roman885-85/moto_battery_reader/README.md

# 🔋 Motorola IMPRES Battery Reader / Programmer (ESP32)

Пристрій на **ESP32** для **зчитування, аналізу, редагування, відновлення та
програмування** чипів акумуляторів Motorola IMPRES — через веб-інтерфейс
Wi-Fi, USB-клієнт (браузер **або** нативний `.exe`) і OLED/LCD-дисплей з
кнопковим меню.

Інтерфейс українською, заставка з емблемою **Національної Гвардії України**.

Всередині акумулятора IMPRES два 1-Wire чипи:
- **DS2433** — EEPROM 512 байт: модель, крива розряду, історія ємності,
  лічильники, блок автентифікації.
- **DS2438** — монітор батареї: напруга, струм, температура, лічильники
  заряду/розряду (ICA/CCA/DCA), калібрування.

> ⚠️ **Family codes для ЦЬОГО заліза — `DS2433_ID = 0xA3`, `DS2438_ID = 0xA6`**
> (перевірено осцилографом, у `battery_reader.h`). Це **не** стандартні
> 0x23/0x26 з даташита. Заміна ламає зчитування — **не чіпати**.

---

## ✨ Можливості

- 📟 **Дисплей + меню-список** з кнопками: чотири сторінки показань (заряд,
  модель/серійний, дані DS2438, стан/цикли) і **список усіх функцій** із
  групами та стрибком по групах — замість плоского кільця дій.
- 🌐 **Веб-інтерфейс** (Wi-Fi AP) з captive-portal (сторінка відкривається сама).
- 🔌 **USB-клієнт** — той самий функціонал по COM-порту, працює **паралельно**
  з Wi-Fi. Три варіанти: браузер (Web Serial), **нативний `.exe` (Tkinter GUI,
  без браузера)** і веб-міст у будь-якому браузері.
- 🆕 **Новий акумулятор** — ініціалізація порожнього/стертого чипа «як новий»
  з вшитого genuine-еталона моделі + ручна ємність у мА·год.
- 🛠️ **Відновити еталон (verbatim)** — ремонт «з нуля» на порожній/битій
  мікросхемі: пише genuine-еталон **байт-у-байт** зі всією навченою калібровкою
  (нічого не обнуляє). Найнадійніший робочий результат, зокрема для **4409B**.
- 🧙 **Майстер відновлення** — автоматичне відновлення «однією кнопкою»:
  аналіз стану → перелік проблем → пропозиції → покрокове виконання. Кожна
  знайдена проблема або має крок, або **вголос каже, чому кроку не буде**.
  Уміє й **сам полагодити побитий лічильник розряду** в моніторі, узявши
  значення з історії того самого пакета. Спільний двигун (`recovery.h`) +
  чиста, перевірювана на хості база правил (`wizard_rules.h`) для **всіх**
  поверхонь (екран, веб-вкладка
  «🧙 Майстер», USB, GUI). Багатоетапні сценарії з IMPRES-ЗП не перериваються:
  стан зберігається в журналі ESP32 за серійником АКБ і продовжується після
  повернення з зарядки (Майстер порівнює знімок CCA/DCA/ICA/health «до/після»).
  Збережені відновлення можна **переглянути** (серійник, модель, прогрес,
  заплановані дії) і **видалити** — панель «🗂 Збережені відновлення».
- 🔋 **Керований ЗАРЯД** — силового заліза два, і обирає його `DEVICE_VARIANT`:
  **готова плата DC/DC на TL494** (enable + аналогова уставка, вимір із DS2438
  всередині пакета) або **власний понижувач** (ШІМ на свій ключ, свій шунт,
  свій подільник, контроль +14 В). Верхній рівень у них спільний: профіль
  струму за відсотком заряду, розумний CC/CV від ємності пакета, ціль у
  відсотках або мілівольтах. Аварійні відсічки за напругою, перегрівом, часом
  і зависанням циклу — в обох; пік струму, контроль живлення й свідок
  насичення клеми — там, де є власні давачі. ⚠️ Стелю струму задає силова
  частина: у понижувача — тепловий бюджет ЙОГО ключа (див. §8), у плати TL494
  ключ розпаяв виробник.
  На екземплярах, зібраних **без силової частини**, заряд вимикається на
  самому приладі — утриманням кнопки «OK» **п'ять секунд**. Разом із
  ним зникають група ЗАРЯД у меню та контроль живлення +14 В: там, де силової
  частини немає, немає й що міряти. Стан переживає перезавантаження.
- 🪫 **Керований РОЗРЯД** навантаженням (MOSFET + резистор) з обмеженням струму
  ШІМом: приймальний контроль після перепайки — рахує РЕАЛЬНУ ємність нових
  банок; заразом підштовхує ЗП у цикл калібрування, коли вона вперлась.
- 💾 Зчитування обох чипів, **резервні копії** `.bin`, запис/відновлення.
- ♻️ **Скидання** лічильників/зносу для рекалібрування на IMPRES-ЗП. Обнуляє
  **обидва боки** — монітор DS2438 і наробіток, записаний у самому пакеті
  (DS2433): станція вважає оригіналом пакет і після кожного сеансу
  пересинхронізовує з нього монітор, тож скидання «тільки монітора» першою ж
  зарядкою відкочувалось назад.
- 🛠 **Ремонт цілісності** (контрольні суми + дзеркало калібрування).
- 🧹 **Очистка** (стерти все, крім ідентичності/калібрування).
- 🔥 **Повне стирання DS2433** (крайній випадок).
- 🪪 **Ручний запис моделі** (part number) з перевіркою довжини/символів.
- ✏️ **Редактор байтів** із **лінійкою адрес і ASCII-колонкою** (як у HxD),
  зміна **ємності в мА·год** і **зносу %**.
- 🔁 **Перезавантаження ESP32** з веб/USB/меню дисплея.
- 🛡 **Модельно-залежна перевірка справжності** (формати 2017 та 2014/4409A).
- 🎨 Підтримка багатьох дисплеїв (I2C/SPI): 6 монохромних OLED/LCD **+
  кольорові TFT ST7789 будь-якої роздільності** (240×240, 240×280, 240×320,
  135×240, 170×320, 172×320, власна) з кольоровим меню й кастомною заставкою.
- 🖼️ **Плавні ефекти дисплея** (кольорові ST7789): плавна поява/згасання
  заставки через ШІМ підсвітки, **плавучий градієнт** заповнення батареї на
  головній сторінці (швидкість/плавність — у `settings.h`), і **без блимання**
  під час операцій (статус оновлюється лише в футері).
- 🟥 **Червоний «світлофільтр» при помилці** — увесь екран стає червоного
  відтінку на час оповіщення (замість блимання).
- 💡 Неблокуюча **індикація**: світлодіоди (окремі візерунки для читання,
  запису, заряду й розряду), **підсвітка кнопок** як індикатор роботи і
  **звуковий буззер** — усе необов'язкове. 🔊 Звук **увімкнено**: справжній
  синус через апаратний ЦАП на GPIO25 (вимикається одним рядком у
  `settings.h`).
- 🧠 **Розумний профіль CC/CV для 2S** — струми рахуються від паспортної
  ємності самого пакета (0.5C / 0.1C / 0.05C), заряд закінчується **за
  струмом**, а не за дотиком до цільової напруги; плюс **ручні уставки**
  (струм заряду, ціль у вольтах, струм розряду) і **оцінка «≈ лишилось»** — у
  меню пристрою і в усіх трьох клієнтах.
- 🔓 **Без пароля** — керування прямим фізичним/локальним доступом (пароль
  прибрано з веб-API та USB).
- 🔬 Задокументований **реверс формату IMPRES** (контрольні суми, дзеркало,
  прив'язка до моделі, а не до серійника).
- 📼 **Архів реальних дампів** — [`dumps/`](dumps/): **58** акумуляторів, 66 дампів
  (два зняті двічі — до і після зарядної станції): робочі,
  «невідомі» для рації, після заміни елементів, після рекалібрування, копія — з
  описом стану **словами власника**. На цих даних побудовані шаблони й правила
  Майстра; вони ж — база для звірки «робочий проти зіпсованого».

---

## Зміст

1. [Обладнання та підключення](#1-обладнання-та-підключення)
2. [Вибір дисплея](#2-вибір-дисплея)
3. [Збірка і прошивка](#3-збірка-і-прошивка)
4. [Веб-інтерфейс](#4-веб-інтерфейс)
5. [USB-клієнт (браузер / нативний .exe)](#5-usb-клієнт)
6. [Керування на пристрої](#6-керування-на-пристрої)
7. [Індикація (світлодіоди, звук, підсвітка кнопок)](#7-індикація-світлодіоди-звук-підсвітка-кнопок)
8. [Операції з АКБ](#8-операції-з-акб)
9. [Одиниці вимірювання](#9-одиниці-вимірювання)
10. [Формат прошивки IMPRES](#10-формат-прошивки-impres)
11. [Типові сценарії відновлення](#11-типові-сценарії-відновлення)
12. [Структура проєкту](#12-структура-проєкту)
13. [Застереження](#13-застереження)

---

## 1. Обладнання та підключення

**Плата:** будь-яка ESP32. **Бібліотеки** (Arduino Library Manager):
`U8g2`, `OneWire`, `ArduinoJson`.

| Сигнал | GPIO | Константа | Примітка |
|---|---|---|---|
| 1-Wire дані (DS2433/DS2438) | **13** | `DS_PIN` | до контакту даних АКБ |
| Керування підтяжкою 1-Wire | **12** | `PULLUP_PIN` | сильний pull-up + enable пакета |
| LED зелений | **14** | `LED_GREEN_PIN` | через ~330 Ом на GND |
| LED червоний | **27** | `LED_RED_PIN` | через ~330 Ом на GND |
| Три кнопки на одному піні | **33** | `MENU_BTN_ADC_PIN` | аналогова драбинка, **лише ADC1** (32–39) |

Дисплей **ST7789 240×240 (GMT130-V1.0)**, SPI: `SCK=18`, `MOSI=23`, `CS=5`
(`DISPLAY_CS_PIN`), `DC=17` (`DISPLAY_DC_PIN`), `RST=16` (`DISPLAY_RST_PIN`),
`BLK=4` (`DISPLAY_BLK_PIN`). Режим SPI **3**, частота **24 МГц**
(`DISPLAY_ST7789_SPI_MODE` / `DISPLAY_ST7789_SPI_HZ`) — ✅ перевірено на
залізі.

> ⚑ **Режим SPI 3, а не 0 — саме через відсутність CS. Це й був чорний
> екран** (підтверджено на цьому пристрої). CS припаяний до землі, контролер
> вибраний **завжди** і межу посилки визначає за станом тактового сигналу в
> спокої, а він у режимів 0 і 3 різний. З режимом 0 панель приймає біти зі
> зсувом, жодної команди не впізнає й не показує **нічого** — виглядає як
> несправність, хоча припаяно все правильно.
>
> Обидва параметри (`DISPLAY_ST7789_SPI_MODE`, `DISPLAY_ST7789_SPI_HZ`)
> раніше не налаштовувались узагалі: `tft.init()` кликався без них і мовчки
> брав зашите в бібліотеку. Через це причину довго шукали в проводці й у CS —
> а її там не було.

> ⚑ **На модулях 240×240 виводу CS фізично немає** — на гребінку виходять лише
> `GND / VCC / SCL / SDA / RES / DC / BLK`, контролер вибраний постійно, і
> GPIO5 нікуди не підключений. І попри це `DISPLAY_CS_PIN` **заданий**: так
> безпечніше. Прошивка просто смикає непід'єднаний пін — електрично це нічого
> не робить, — а от передати бібліотеці «CS немає» (`-1`) означає покластись
> на її внутрішню гілку для цього випадку, реалізовану в різних версіях
> `Adafruit_SPITFT` по-різному. Заданий реальний пін працює на будь-якій
> версії й на будь-якому модулі.
>
> Режим без CS підтримується й лишається: закоментуйте рядок — в Adafruit піде
> `-1`, в U8g2 `U8X8_PIN_NONE`. Має сенс, якщо GPIO5 потрібен під щось інше.
> Ціна — шину SPI більше не можна ділити ні з чим: без CS панель слухає її
> **завжди**, тож чужий трафік на `SCK/MOSI` піде їй як команди. Окрема
> перевірка стежить, щоб `GPIO18/23` не опинилися зайняті чимось іншим.

> 📐 **Уся схема одним аркушем** — [`SCHEMATIC.html`](SCHEMATIC.html): п'ять листів
> (структура, каскад заряду, вимірювальні кола, 1-Wire, розряд), карта пінів і
> перелік доопрацювань плати. Відкривається просто у браузері.

**Силова частина** (заряд і розряд — обидва необов'язкові, вимикаються
коментуванням пінів).

> ⚡ **ЗАРЯДНОГО ЗАЛІЗА ДВА, І ВОНО РІЗНЕ.** Один і той самий код обслуговує
> два пристрої, а вибір робиться однією константою `CHARGE_TOPOLOGY` у
> `settings.h`:
>
> | | `CHARGE_TOP_BUCK` | `CHARGE_TOP_TL494` |
> |---|---|---|
> | що це | понижувач, зібраний тут | готова плата DC/DC на TL494 |
> | чим керуємо | **шпаруватістю** ШІМ на власний ключ | **вихідною напругою**: enable + аналогова уставка |
> | звідки струм і напруга | **власні** шунт і подільник | **DS2438 усередині пакета** |
> | контроль +14 В | є (`CHARGE_PSU_PIN`) | немає — давача не існує |
> | пік струму, свідок насичення клеми | є | немає — міряти нічим |
> | примусове пробудження | є | **заборонено**: усі три його запобіжники — це власні виміри |
> | як обрати | `#define DEVICE_VARIANT DEVICE_BUCK` | `#define DEVICE_VARIANT DEVICE_TL494` |
>
> Верхній рівень (профілі, фази, відсічки, ETA) у них СПІЛЬНИЙ і написаний у
> термінах «шпаруватості». Для понижувача це відліки ШІМ; для TL494 один
> «відлік» — це **один мілівольт цільової вихідної напруги**, а переклад
> «мВ → напруга керування» робить калібрувальна таблиця в найнижчій точці.
> Так зроблено не заради краси: крива керування TL494 різко нелінійна, і крок
> регулятора в «сирих» одиницях мав би зовсім різний ефект на різних ділянках.

**Варіант 1 — власний понижувач** (`CHARGE_TOPOLOGY CHARGE_TOP_BUCK`):

| Сигнал | GPIO | Константа | Примітка |
|---|---|---|---|
| Затвор MOSFET розряду | **19** | `LOAD_PIN` | + резистор 10 кОм затвор→GND (обов'язково) |
| ШІМ заряду (на базу NPN) | **26** | `CHARGE_PWM_PIN` | **390 Ом** пін→база NPN + резистор 10 кОм база→GND (обов'язково) |
| Вимір струму заряду | **35** | `CHARGE_ISENSE_PIN` | шунт 0.5 Ом у мінусі → **1 кОм** → пін; **лише ADC1** |
| Вимір напруги заряду | **34** | `CHARGE_VSENSE_PIN` | подільник **20к/10к** → **1 кОм** → пін; **лише ADC1** |
| Контроль живлення +14 В | **39** | `CHARGE_PSU_PIN` | подільник **68к/10к** → **1 кОм** → пін; **лише ADC1**; поправка тракту — `CHARGE_PSU_CAL_X1000` |

**Варіант 2 — готова плата DC/DC на TL494** (`CHARGE_TOPOLOGY CHARGE_TOP_TL494`):

| Сигнал | GPIO | Константа | Примітка |
|---|---|---|---|
| Затвор MOSFET розряду | **19** | `LOAD_PIN` | той самий, що й у варіанті 1 |
| Enable силового каскаду | **32** | `CHARGE_TL_EN_PIN` | **LOW = безпечно.** Плата пропускає вхід на вихід (~14 В) БЕЗ керування, тож це єдиний запобіжник — і скетч опускає пін найпершим рядком `setup()` |
| Аналогове керування напругою | **26** | `CHARGE_TL_CTRL_PIN` | ШІМ 20 кГц / 11 біт → RC на платі; калібрування — `CHARGE_CAL_CTRL_MV` / `CHARGE_CAL_OUT_MV` |

> Вимірювальних пінів у варіанті 2 немає **жодного**, і це не прогалина: той
> самий струмовимірювальний резистор DS2438 стоїть усередині пакета
> послідовно з банками, тож вимірювач уже є — і він точніший за будь-який
> зовнішній. Звідси й повільний регулятор: показання приходять по 1-Wire раз
> на секунду, тож уставка йде маленьким сталим кроком `CHARGE_TL_STEP_MV`, а
> не ривками. Те, чого без власних давачів бути не може (контроль +14 В,
> пікова відсічка, свідок насичення клеми, пробудження), прошивка **чесно
> оголошує недоступним**, а не імітує.

> ⚠️ Резистор **1 кОм послідовно** перед КОЖНИМ вимірювальним піном (і струму, і напруги) — струмообмеження входу АЦП. На показання він **не впливає**: вхід АЦП високоомний, струму через резистор немає, отже немає й падіння на ньому. У жодну формулу перерахунку він тому й не входить — не «виправляйте» це.

**Необов'язкові** піни:

| Сигнал | Приклад | Константа | Примітка |
|---|---|---|---|
| Підсвітка кнопок | 15 | `BTN_LED_PIN` | індикатор роботи (+`BTN_LED_ACTIVE_LOW`) |
| Підсвітка дисплея (ST7789) | 4 | `DISPLAY_BLK_PIN` | плавні заставка/переходи |
| Буззер (синус на ЦАП) | 25 | `BUZZER_DAC_PIN` | **увімкнено**; ЦАП є лише на GPIO 25/26, а 26 зайнято ШІМ заряду |
| Буззер (пасивний п'єзо, резерв) | 32 | `BUZZER_PIN` | ШІМ замість ЦАП; **не** 34/35/36/39 |

> 🔊 **Звук увімкнено** — `BUZZER_DAC_PIN 25` у `settings.h`. З двох ЦАП-пінів
> ESP32 вільний рівно один: GPIO26 забрав ШІМ заряду, лишився GPIO25.
> ⚠️ Перед п'єзо потрібен **розділовий конденсатор 1–10 мкФ**: ЦАП видає
> 0…3.3 В із постійною складовою, а не змінний сигнал навколо нуля.
> Щоб вимкнути — закоментуйте рядок: `buzzer.h` має повноцінну «тиху» гілку,
> налаштування й перелік сигналів усе одно віддаються в API.
>
> ⚠️ **Виправлено давню неточність.** Тут (і в `settings.h`, і в
> `INSTRUCTION.md`) стояло, що GPIO25 «віддано заряду». Це було неправдою:
> заряд сидить на GPIO26, а 25-й просто лежав у резерві після того, як звук
> вимкнули. Заразом полагоджено вартового, який мав ловити збіг піна звуку з
> силовими: три його рядки порівнювались із макросами, визначеними НИЖЧЕ за
> сам вартовий, тож `defined()` давав 0 і перевірка не могла спрацювати
> ніколи. Порівняння перенесено в кінець `settings.h`, де всі піни вже є.

1-Wire потребує **двох** резисторів на +3.3 В, і обидва обов'язкові:

* **GPIO13 (дані) → 2.2…4.7 кОм.** DS2433 і DS2438 живляться паразитно з цієї
  ж лінії, і внутрішня підтяжка ESP32 (~45 кОм) їх не витягне — чипи просто не
  відповідають, і виглядає це як «акумулятор не зчитується».
* **GPIO12 (enable) → 4.7 кОм — НЕ обов'язковий.** Стоїть на платі, поставлений
  власником для попереднього налагодження; прошивка веде цю лінію активно в
  обидва боки, тож підтяжка тут не умова роботи. Раніше тут було написано
  «обов'язковий» — це виправлено. Не плутати з підтяжкою лінії даних вище: ота
  справді обов'язкова. Далі — про strapping, бо це стосується усі чотири
  функції: читання, запис, заряд і розряд. Цією лінією активується сам пакет, і
  рівень на ній має бути визначеним навіть тоді, коли пін не веде її активно.

> ⚠️ GPIO12 — strapping-пін MTDI: підтяжка вгору на ньому при скиданні вибирає
> флеш 1.8 В. Раз ця плата з резистором стартує — eFuse напруги флеша вже
> пропалено або флеш справді 1.8 В. На іншому модулі це перше, що треба
> перевірити. Усі піни
змінюються у `settings.h`. Конфлікти пінів і ВХІД-ТІЛЬКИ піни для виходів
ловляться на компіляції (`#error` з підказкою).

---

## 2. Вибір дисплея

У `settings.h`, **КРОК 1** — розкоментуйте **рівно один** рядок:

```c
#define DISPLAY_SSD1306_I2C        // 0.96" 128x64 I2C (GME12864) — за замовч.
// #define DISPLAY_SH1106_I2C      // 1.3"  128x64 I2C
// #define DISPLAY_SH1107_128_I2C  // GME128128-02, 128x128 I2C (SH1107)
// #define DISPLAY_SSD1327_128_I2C // GME128128-02, 128x128 I2C (SSD1327)
// #define DISPLAY_ST7567_SPI      // Open-Smart 1.8" 128x64 SPI
// #define DISPLAY_PCD8544_SPI     // Nokia 5110 (PCD8544) 84x48 SPI
// --- КОЛЬОРОВІ TFT на ST7789 (SPI) — кольорове меню + кольорова заставка ---
// #define DISPLAY_ST7789_SPI
//   #define DISPLAY_ST7789_240X240 // ST7789VW 240x240
//   #define DISPLAY_ST7789_240X280 // ST7789V3 240x280
```

Роздільність, розкладка меню і шрифти підставляються автоматично.

> ℹ️ У **поставленому** `settings.h` типово увімкнено кольоровий **ST7789
> 240×280** (з BLK=4, 3-ю кнопкою=33, буззером=2, підсвіткою кнопок=15). Під
> інше залізо просто перевиберіть дисплей і піни. Також при старті дисплей
> **чистий** — дані АКБ з'являються лише після зчитування (повернути показ
> останнього дампа: `#define LOAD_SAVED_DUMPS_ON_BOOT`).

- **I2C** (КРОК 2a): `SDA=21`, `SCL=22`, адреса `0x3C`.
  `#define DISPLAY_HW_I2C` — апаратний I2C. Якщо він не відповідає — прошивка
  **сама переходить** на програмний I2C (у Serial: `HW I2C OK` / `SW I2C
  fallback`). Часта причина відмови — слабкі підтяжки: зовнішні **4.7 кОм**.
  `DISPLAY_I2C_KHZ 0` = авто (SSD1327 тримає лише 100 кГц).
- **SPI** (КРОК 2b): `SCK=18`, `MOSI=23`, `CS=5`, `DC=17`, `RST=16`.
  ST7567: зсув `DISPLAY_ST7567_XOFF` (0…4); контраст `DISPLAY_CONTRAST`.

### 🎨 Кольорові TFT на ST7789 (будь-яка роздільність)

Розкоментуйте `DISPLAY_ST7789_SPI` **і один** пресет розміру. Меню, заставка й
індикатори — **кольорові** (заряд: зелений/жовтий/червоний; небезпечні дії —
червоним; заставка НГУ синьо-жовта). Уся кирилиця збережена, верстка й шрифти
підлаштовуються під роздільність.

**Пресети** (у `settings.h`):

| Макрос | Панель | Роздільність |
|---|---|---|
| `DISPLAY_ST7789_240X240` | 1.3"/1.54" ST7789VW | 240×240 |
| `DISPLAY_ST7789_240X280` | 1.69" ST7789V3 | 240×280 |
| `DISPLAY_ST7789_240X320` | 2.0"/2.4" | 240×320 |
| `DISPLAY_ST7789_135X240` | 1.14" | 135×240 |
| `DISPLAY_ST7789_170X320` | 1.9" | 170×320 |
| `DISPLAY_ST7789_172X320` | 1.47" | 172×320 |

**Власна панель:** `#define DISPLAY_ST7789_W 240` + `#define DISPLAY_ST7789_H 320`
(портретні розміри, макс. 240×320). За замовчуванням оффсети пам'яті бере
бібліотека Adafruit. Якщо **картинка зсунута** — увімкніть ручні оффсети:
`#define DISPLAY_ST7789_MANUAL_OFFSET` (візьме значення пресету) або задайте
свої `DISPLAY_ST7789_XOFF` / `DISPLAY_ST7789_YOFF`.

- **Потрібні бібліотеки** (Менеджер бібліотек Arduino): `Adafruit GFX Library`,
  `Adafruit ST7735 and ST7789 Library`, `Adafruit BusIO`, `U8g2_for_Adafruit_GFX`.
- **Піни SPI:** `SCK=18`, `MOSI(SDA)=23`, `CS=5`, `DC(RS)=17`, `RST=16`
  (спільні з КРОК 2b). Підсвітка — необов'язково: `#define DISPLAY_BLK_PIN 4`.
- **Орієнтація/інверсія:** `DISPLAY_ST7789_ROT 0…3` (0/2 — портрет, 1/3 —
  ландшафт), `DISPLAY_ST7789_INVERT` (для панелей-«негативів»).
- **Заокруглені кути** (ST7789V3 1.69" 240×280 зазвичай скруглений): увімкніть
  `#define DISPLAY_ST7789_ROUND` — інтерфейс додасть безпечний відступ від кутів
  (радіус — `#define DISPLAY_ST7789_CORNER 22`).
- **Підсвітка (BLK)** — необов'язково: `#define DISPLAY_BLK_PIN 4`. Якщо задано,
  заставка **плавно з'являється/згасає** через ШІМ підсвітки, а переходи між
  сторінками — з коротким «дипом» яскравості. Без BLK — миттєвий показ.

**🌊 Плавучий градієнт заповнення батареї** (головна сторінка). На головній —
великий **% ліворуч**, а праворуч — трохи коротша батарея, чиє заповнення
плавно «переливається» рухомим градієнтом. Тонке налаштування у `settings.h`
(усі під `#ifndef`, тож можна не чіпати):

| Параметр | Що робить | Типово |
|---|---|---|
| `ANIM_GRADIENT_SPEED` | швидкість течії (крок фази за кадр) | `1` |
| `ANIM_GRADIENT_MS` | період кадру, мс (плавність руху) | `90` |
| `ANIM_GRADIENT_WAVELEN` | довжина хвилі, px (плавність градієнта) | `96` |
| `ANIM_GRADIENT_MINLVL` | мін. яскравість смуги 0..255 (контраст) | `70` |

Вимкнути анімацію повністю — `#define DISABLE_BATTERY_ANIM`.

**Кастомна кольорова заставка.** Згенеруйте картинку у файл `custom_splash.h`
і покладіть у папку скетчу:

```bash
python tools/make_color_splash.py logo.png -W 240 -H 280   # під свою роздільність
# --fit cover    заповнити весь екран (з обрізанням); за замовч. contain
# --bg 001B3A     колір фону (HEX RRGGBB)
```

Потім у `settings.h` — `#define DISPLAY_SPLASH_CUSTOM`. Заставка малюється по
центру як RGB565 (≈ W×H×2 байт у флеші).

Реалізація — окремий файл `display_color.h`; монохромний u8g2-шлях не
зачіпається (обидва варіанти взаємовиключні).
- **SSD1327**: якщо екран пустий/спотворений — панелі бувають з різним
  контролером-remap: у `settings.h` спробуйте `SSD1327_WS` / `SSD1327_EA` /
  `SSD1327_ZJY` (за замовч. MIDAS).

Активний дисплей і частоту шини видно в Serial (115200) при старті.

---

## 3. Збірка і прошивка

1. Оберіть плату ESP32 і порт.
2. **Оберіть схему розділів: *Tools → Partition Scheme → Huge APP
   (3MB No OTA/1MB SPIFFS)*.** Це умова збірки, а не порада: у типовій
   «Default 4MB with spiffs» під програму лишається 1 310 720 байтів, а
   прошивка займає ~1.31 МБ і не влазить —
   `Sketch too big; text section exceeds available space in board`.
   З «Huge APP» вона займає ~42 % від 3 МБ, а SPIFFS у 1 МБ вистачає з запасом.
   ⚠️ Разом зі стеком **Bluetooth** (типово увімкнений; режим зв'язку
   перемикається в меню приладу, група «ЗВ'ЯЗОК») ця вимога стає жорсткішою:
   у «Default 4MB with spiffs» така прошивка не влізе точно. Не потрібен
   Bluetooth — закоментуйте `BT_ON` у `settings.h`, і звичайна схема розділів
   знову підійде.
3. Скомпілюйте та завантажте `motorola-battery-reader-web.ino`.
4. **Нічого більше заливати не треба.** Сторінка вшита в саму прошивку
   (`page_index.h`, стиснута gzip), тож веб-інтерфейс працює одразу.
   Раніше її возили окремим кроком у SPIFFS — і саме на цьому найчастіше
   спотикались: у Arduino IDE 2.x пункту *ESP32 Sketch Data Upload* немає
   зовсім, а зміна схеми розділів робить старий образ немонтовним, після чого
   він мовчки форматується.
   *(Для розробки сторінку все ще можна перекрити файлом `/index.html.gz` у
   SPIFFS — пристрій скаже про це в Serial при старті.)*
   - Помилка `No port specified` = не вибрано порт або відкритий Serial Monitor.

---

## 4. Веб-інтерфейс

Підключіться до Wi-Fi **`BatteryReader_moto`** (пароль `12345678`). **Captive-
portal** сам запропонує відкрити сторінку; інакше — `http://192.168.4.1`.
Пароль на операції **прибрано** — керування прямим локальним доступом.

- **Огляд** — заряд %, залишок мА·год, напруга, температура, модель, знос,
  цикли, справжність, цілісність.
- **Дані** — модель/серійний, DS2438 (струм, ICA/CCA/DCA в мА·год і циклах),
  повні hex-дампи.
- **🧙 Майстер** — автоматичне відновлення: аналіз → проблеми → план → крок;
  панель **🗂 Збережені відновлення** (перегляд/видалення журналів за серійником).
- **Прошивка** — згруповано за рівнем ризику: **Резервна копія** →
  **Обслуговування** (безпечно для ідентичності) → **Небезпечна зона**
  (незворотні операції). Тут же **ручний запис моделі**, **🆕 Новий акумулятор**,
  **📤 Відновити еталон**, **редактор байтів** із лінійкою адрес і ASCII-колонкою
  (як у HxD), а також **🔁 Перезавантаження**. Див. [розділ 8](#8-операції-з-акб).

Оформлення — військовий стиль (хакі/олива/«краповий») з емблемою НГУ.

> 🪪 **Серійний номер** — це апаратний лазерний ROM чипа DS2438: він унікальний,
> незмінний і **фізично не перезаписується**. Записується лише **модель**
> (part number). Для власного інвентарного ID використайте редактор байтів.

---

## 5. USB-клієнт

Той самий функціонал по кабелю, працює **паралельно** з Wi-Fi. Три варіанти —
оберіть зручний:

### 5.1. Браузерний (`client_usb.html`)

Відкрийте `client_usb.html` у **Chrome/Edge** (потрібен Web Serial API),
натисніть «Підключити», оберіть COM-порт ESP32.

> Якщо Web Serial недоступний з `file://` — запустіть `python -m http.server`
> у теці й відкрийте `http://localhost:8000/client_usb.html`.

### 5.2. Нативний `.exe` (GUI, без браузера) — рекомендовано

Тека **`usb_client/`**, файл **`moto_gui.py`** — самостійне вікно на Tkinter
(входить у стандартний Python), відкриває COM-порт напряму (`pyserial`), **не
потребує браузера/Web Serial**. Вкладки Огляд / **🧙 Майстер** / Дані / 🔧 Ремонт /
**Редактор (HxD-стиль: Offset │ HEX │ ASCII)** / Журнал. Оформлення — мілітарна
тема НГУ (оливково-хакі + акцент «краповий»), спільна для веб-клієнтів і `.exe`.

**Масштаб вмісту.** Вікно вільно тягнеться й розгортається на весь екран, і весь
вміст росте разом із ним — шрифти, кнопки, вкладки, поля й панель моніторингу
розряду. Типово стоїть **«авто»**: масштаб рахується з розміру вікна (по меншій
зі сторін, щоб широке й низьке вікно не роздувало текст) у межах 80–220 %.
Ручне керування — кнопки `−` / `+` на рядку стану, `Ctrl` + коліщатко,
`Ctrl` + `+` / `−`, `Ctrl` + `0` (рівно 100 %); `F11` — на весь екран, `Esc` —
назад. Будь-яке ручне налаштування вимикає «авто», прапорець вмикає його знову.
Якщо вміст не влазить — вкладки прокручуються, нічого не губиться.

```bat
cd usb_client
build.bat            REM -> dist\moto_usb.exe (з іконкою, без консолі)
```

Зібраний `moto_usb.exe` **не потребує** ні Python, ні браузера у користувача.
Запуск із коду: `python moto_gui.py`. Іконка — `icon.ico` (генерується
`make_icon.py`, потрібен Pillow).

### 5.3. Веб-міст (`moto_bridge.py`)

Показує той самий `client_usb.html` у **будь-якому** браузері, а COM-порт
обробляє Python (Web Serial не потрібен). Збірка — `build_bridge.bat`.

Деталі обох `.exe` — `usb_client/README.md`.

### Протокол (`serial_api.h`, 115200 бод, відповідь одним рядком `#R#{json}`)

| Команда | Дія |
|---|---|
| `PING` / `READ` / `INFO` | ідентифікація / зчитати / усі дані |
| `GET33` / `GET38` | сирий дамп (hex) |
| `WRITE33` / `WRITEFIX33` / `WRITE38` | запис дампа (raw / +автосуми / DS2438) |
| `RESET` / `REPAIR` / `CLEAN` | скидання / ремонт / очистка |
| `WIPE33` / `WIPE38` | повне стирання DS2433 / DS2438 |
| `RECAL` | підготовка до рекалібрування (перевірений рецепт після заміни елементів) |
| `DISCHARGE [мВ]` / `DISCHARGE STOP` / `DISCHARGE ?` | керований розряд / зупинити / стан |
| `DISCHARGE MA=<мА>` / `DISCHARGE SMART` / `DISCHARGE AUTO` | ручний струм розряду (0 = автомат) / розумний профіль 0.2C / заводський |
| `CHARGE [%]` / `CHARGE MA=<мА>` / `CHARGE STOP` / `CHARGE ?` | керований заряд до відсотка / ручний струм / зупинити / стан |
| `CHARGE MV=<мВ>` / `CHARGE SMART` / `CHARGE AUTO` | ручна ціль у вольтах (0 = ціль за відсотком) / розумний профіль CC/CV / заводський |
| `CHARGE WAKE` | **примусове пробудження** пакета, що не читається після заміни елементів (зупиняється тим самим `CHARGE STOP`) |
| `SETCAP <%>` / `SETMAH <мА·год>` | знос % / залишкова ємність |
| `SETCHG <%>` | заряд у % (ICA); при застряглому паливомірі — за напругою |
| `SETMODEL <NAME>` | ручний запис моделі (3..9 символів `A–Z 0–9`) |
| `SETETM <сек>` | ETM (наробіток) → «дата першого користування» у рації |
| `SETHEALTH <1..100>` | знос/здоров'я, % — пише `CTS` у зашифрований блок `RECOND` |
| `CLOCK [РРРРММДД]` | системна дата пристрою: без аргументу — прочитати, з аргументом — завести |
| `TEMPLATES` | список вшитих моделей для ініціалізації |
| `INITBAT <MODEL> <мАг>` | ініціалізувати порожній чип як новий АКБ моделі |
| `RESTORE <MODEL> [VERBATIM] [FIXES=…] [RATED=…] [RSENSE=…\|RSMODEL=…] [MFG=…] [HEALTH=…] [USE=…] [CAL=…] [CYC=…] [NONIMP=…] [TAIL=FRESH\|ERASE]` | відновити еталон (порожній/битий чіп → робочий); `FIXES` — які правки під цей пакет застосувати; `RSENSE`/`RSMODEL` — задати шунт вручну або з бібліотеки еталонів |
| `RESTOREPLAN <MODEL> [NOREAD] [FIXES=…]` | що саме буде виправлено в еталоні під цей пакет (нічого не пише) |
| `FIXES <MODEL> [FIXES=…] [RATED=…] [RSENSE=…\|RSMODEL=…] [MFG=…] [HEALTH=…] [USE=…] [CAL=…] [CYC=…] [NONIMP=…]` | записати **лише правки** до того, що вже в чипах; еталон і навчена калібровка не чіпаються |
| `WIZARD` | **Майстер відновлення**: зчитати + аналіз/проблеми/план (JSON) |
| `WIZSTEP <idx> [MODEL]` | Майстер: виконати крок плану (`MODEL` — лише для відновлення) |
| `WIZRESET` | Майстер: скинути журнал продовження |
| `WIZLIST` / `WIZDEL <serial>` | список / видалення збережених журналів відновлення |
| `SOUND` | налаштування звуку: поточні значення, межі повзунків, перелік сигналів |
| `SOUND SET k=v …` | `en` `clk` `vol` `tempo` `glide` `atk` `rel` `st` (+ `test=<сигнал>`); незгадані поля не чіпаються |
| `SOUND TEST <сигнал>` | прослухати `hello` / `click` / `start` / `ok` / `err` |
| `SOUND RESET` | повернути заводські значення звуку |
| `AUTH` | *(історична)* завжди «ОК» — пароль прибрано |
| `REBOOT` | перезавантаження ESP32 |

> 🔓 **Пароль прибрано** — і в USB, і у веб-API операції доступні напряму
> (керування локальним/фізичним доступом). `AUTH` лишено для сумісності — воно
> просто повертає «ОК».
>
> 📦 Великі команди запису (`WRITE33` ~1 КБ) клієнт надсилає **частинами по
> ~200 Б** із мікропаузами, тож типового UART-буфера ESP32 достатньо і жодного
> втручання в ініціалізацію прошивки не потрібно.

---

## 6. Керування на пристрої

### Два роди екранів, а не одне кільце з усього

Раніше всі вісім сторінок лежали в **одному кільці**: показання, потім два
hex-дампи, потім «Дії», потім «Майстер». Через це щоденні показання доводилось
шукати між сторінками, куди заглядають раз на місяць, а сама сторінка «Дії»
була **ще одним кільцем усередині першого** — на три десятки пунктів, які
гортались **лише вперед**: до останнього — 31 натискання, назад — ніяк.

Тепер:

**Кільце показань** — те, на що дивляться постійно. Чотири сторінки, гортаються
«‹»/«›» по колу: 1) головна (заряд, напруга, IP), 2) модель/серійний,
3) дані DS2438, 4) стан/цикли. Перехід — із плавним «дипом» яскравості.

**Меню** — один **список усього**, що пристрій уміє. Відкривається «OK» із
будь-якої сторінки показань. Пункти зібрані в **групи** за призначенням, групи
йдуть за ходом ремонту, а найнебезпечніше — в самому кінці, окремо:

| Група | Що всередині |
|---|---|
| *(без назви)* | **‹ Показання** — вихід із меню |
| **РЕМОНТ** | заміна елементів → глибока чистка → ремонт цілісності |
| **ЗАРЯД** | заряд, його ціль, ручна ціль у вольтах, ручний струм, профіль, пробудження |
| **РОЗРЯД** | розряд, його ціль, ручний струм, профіль |
| **ЛІЧИЛЬНИКИ** | заряд із напруги, скидання лічильників, очистка історії |
| **МОДЕЛЬ** | «Модель \<X\>» — по одній на вшитий шаблон |
| **НОВИЙ ЧІП** | «Новий \<X\>» — порожній чіп у робочий АКБ (незворотнє) |
| **ДАНІ** | дампи DS2438 / DS2433 (відкривають сторінку) |
| **СИСТЕМА** | Майстер відновлення, перезавантаження |
| **НЕБЕЗПЕЧНО** | СТЕРТИ 2433 / СТЕРТИ 2438 |

Перемикач цілі стоїть **одразу після своєї дії** («Заряд ШІМ 100%» →
«Ціль заряду 100%»), а за ними — ручні уставки й профіль тієї самої машини:
все, що стосується заряду, лежить підряд, і нічого чужого між ними немає. У рядку видно кілька сусідніх
пунктів, ліворуч — кольорова смужка небезпеки, праворуч — смужка прокрутки,
під списком — опис обраного, куди він пише (DS2433 / DS2438) і що зробить
натискання.

**Службові сторінки** (дампи, Майстер) у кільце показань **не входять** — їх
відкриває меню, а «‹» з них повертає назад у меню.

### Одне правило на всі екрани

Раніше «OK» означав п'ять різних речей залежно від сторінки, а на сторінці
«Дії» взагалі **не був вибором** — він гортав список. Тепер напрям і дія
розділені:

| | Кільце показань | Меню | Дампи / Майстер |
|---|---|---|---|
| **«›» коротко** | наступна сторінка | наступний пункт | інший дамп |
| **«›» довго** | — | **наступна група** | — |
| **«‹» коротко** | попередня сторінка | попередній пункт | назад у меню |
| **«‹» довго** | на головну | **попередня група** | до показань |
| **«OK» коротко** | **відкрити меню** | відкрити сторінку / перемкнути ціль | Майстер: аналіз |
| **«OK» довго** | перечитати АКБ | **ВИКОНАТИ** операцію | Майстер: наступний крок |

> ⚑ **Довге «OK» лишилось бар'єром рівно там, де є наслідок.** Операції, що
> пишуть у чип, і незворотні стирання виконуються тільки утриманням; а
> «Ціль заряду», яка нічого не пише й існує рівно для того, щоб її натискали по
> колу, тепер перемикається **коротким** натисканням. Раніше бар'єр був за
> родом сторінки, тепер — за рівнем небезпеки самої операції (`OPD_*`).

> ⚑ **Стрибок по групах — це і є швидка навігація.** Пунктів разом із
> шаблонами **41**, і гортати їх по одному було б не краще за старе кільце.
> Довге «‹»/«›» перестрибує на сусідню групу: до найдальшого пункту тепер **не
> більше 14 натискань замість 36**, і в обидва боки. Числа рахує
> `tools/menu_check.cpp` і друкує при кожному запуску — тобто вони не можуть
> тихо застаріти після додавання пунктів.

**Дві кнопки замість трьох** (`MENU_BTN3_PIN` закоментовано): те саме правило,
лише рух назад дістається довгому натисканню — «›» рухає, «‹» вибирає й
виконує. Підказка керування внизу списку підлаштовується під режим.

---

## 7. Індикація (світлодіоди, звук, підсвітка кнопок)

**Світлодіоди** (`LED_GREEN_PIN`, `LED_RED_PIN`):

| Стан | Сигнал |
|---|---|
| Очікування | короткий зелений пульс раз на 3 с |
| Читання | зелений блимає |
| Запис | зелений/червоний **почергово** (не відключати!) |
| Успіх / Помилка | зелений ~1.2 с / 4 червоних блимання |
| Фатальний збій старту | постійний червоний |

На **кольоровому** дисплеї помилка додатково вмикає **червоний «світлофільтр»** —
увесь екран стає червоного відтінку на час оповіщення (без блимання).

**Перша інформаційна панель** показує, крім заряду й показань DS2438, усе
потрібне для під'єднання: **IP-адресу, назву точки доступу і пароль** (беруться
з `AP_SSID`/`AP_PASSWORD`). Підказка по кнопках стоїть **унизу екрана й тим
самим шрифтом**, що показання.

> На вузьких і низьких панелях (320×170, 240×135) місця на все не вистачає. Там
> рядки не накладаються, як раніше, а **викидаються за пріоритетом**: IP, SSID і
> пароль лишаються завжди, далі йдуть заряд у мА·год і рядок напруги/струму (він
> має власну сторінку), а на найкоротших панелях місцем жертвує й підказка.
> Розкладку всіх шести підтримуваних панелей перевіряє окремий тест-рендер.

**🔊 Звук — справжній синус через апаратний ЦАП** (`BUZZER_DAC_PIN`, GPIO 25,
необов'язково):

> 🔊 **ЗВУК УВІМКНЕНО** — `BUZZER_DAC_PIN 25` у `settings.h`. Заряд GPIO25
> не займає (він на 26/34/35/39), тож із двох ЦАП-пінів ESP32 звуку лишається
> рівно один — 25-й. Щоб вимкнути — закоментуйте рядок: `buzzer.h` має
> повноцінну «тиху» гілку, налаштування й перелік сигналів усе одно
> віддаються в API, просто нічого не звучить.

> 🎵 **Перехід із ШІМ на ЦАП.** Раніше буззер вів меандр через LEDC-ШІМ
> (`ledcWriteTone`) — механічний, «плоский» писк. Тепер (коли GPIO 25/26
> звільнились після переходу кнопок меню на один ADC-пін, див. розділ нижче)
> вихідний каскад — DDS-синтез справжнього синуса: 256-крокова таблиця +
> фазовий акумулятор рахуються в ISR апаратного таймера на 16 кГц і йдуть на
> `dacWrite()`. Домішана тиха 2-а гармоніка (¼ гучності) дає «дзвіночковий»
> тембр замість голого тону, а повільне вібрато (~5 Гц, ±0.6 % частоти) —
> «живий», переливчастий характер, як в оповіщеннях побутової техніки. Уся
> логіка фраз/портаменто/огинаючої (нижче) не змінилась — новий лише
> останній каскад виводу.
>
> Стара схема (пасивний п'єзо на будь-якому вільному GPIO через ШІМ) лишилась
> як **резервний варіант** — розкоментуйте `BUZZER_PIN` замість
> `BUZZER_DAC_PIN` у `settings.h`, якщо GPIO 25/26 зайняті чимось іншим або
> ядро Arduino-ESP32 старіше за 3.x (нова таймерна API `timerBegin()` — лише
> в 3.x; на старішому ядрі збірка з `BUZZER_DAC_PIN` не пройде компіляцію,
> перевіряється `#error`).
>
> ⚠️ ЦАП ESP32 — **лише GPIO 25 і 26**, і видає сигнал 0…3.3 В відносно
> землі (не змінний струм навколо нуля), тож перед п'єзо/динаміком потрібен
> розділовий конденсатор (~1–10 мкФ) — без нього постійна складова просто
> зміщує робочу точку п'єзо, не шкодячи йому, але й не звучачи голосніше.

> 🐞 **Виправлена помилка.** Бліп при перегортанні меню не звучав узагалі:
> `displayFlip()` запускав фразу, а потім блокував `loop()` на весь час плавного
> переходу й перемальовки по SPI (~100 мс). Фразу веде `buzzTask()` із `loop()`,
> тож за цей час у ШІМ не йшло **жодного** оновлення, і перший тік після
> повернення просто гасив вихід. Тепер звук запускається **після** блокуючої
> роботи.

| Сигнал | Ключ в API | Мелодія |
|---|---|---|
| Вітання при вмиканні | `hello` | E5→B5 |
| Перегортання меню | `click` | короткий блiп B5→E6 (76 мс) |
| Початок операції | `start` | висхідна кварта E5→A5 |
| Успіх | `ok` | мажорне тризвуччя G5→B5→D6 |
| Помилка | `err` | повільне низхідне ковзання A4→E4 |

Звук навмисно **перетікаючий**, у стилі оповіщень побутової техніки. Різкість
дає не гучність, а **розриви**, і всі три їхні джерела прибрано: між нотами йде
**портаменто** (частота перетікає геометрично, `f = f₀·(f₁/f₀)^t`), гучність веде
**огинаюча всієї фрази** косинусом (плавний вхід і згасання), а пауз між нотами
немає взагалі. Відтворення неблокуюче — loop і веб не гальмуються.

**Налаштування звуку правляться на ходу** — у вебі, USB-клієнті та ехе-клієнті
(вкладка «Ремонт» → «🔊 Налаштування звуку»). Це налаштування **пристрою**, в
акумулятор воно нічого не пише; зберігається у SPIFFS (`/sound.cfg`) і переживає
перезавантаження:

| Ручка | Межі | Що робить |
|---|---|---|
| Звук увімкнено | так/ні | глушить усе, включно зі стартовим вітанням |
| Блiп меню | так/ні | глушить окремо найчастіший сигнал |
| Гучність | 0…255 | амплітуда синуса на ЦАП (шпаруватість ШІМ на резервній схемі) |
| Швидкість | 25…400 % | розтягує **і ноти, і перетікання** разом, тож повільна фраза лишається злитою |
| Перетікання нот | 0…300 % | 0 — ноти перемикаються стрибком, 300 % — довге ковзання |
| Наростання / Згасання | 0…200 / 0…400 мс | огинаюча фрази |
| Висота тону | −12…+12 півтонів | зсуває всю мелодію |

Останнє потрібне найчастіше: **у кожного п'єзо свій резонанс** (звичайно 2–4 кГц),
і те, що на одному екземплярі звучить м'яко, на іншому ледь чутно. Підніміть
висоту на кілька півтонів і знайдіть резонанс на слух — поруч із повзунками є
кнопки «прослухати» для кожного сигналу.

Заводські значення — `BUZZER_VOLUME`, `BUZZ_ATTACK_MS`, `BUZZ_RELEASE_MS` у
`settings.h`; кнопка «↩️ Заводські значення» повертає саме їх.

> ⚠️ Лише **пасивний п'єзо** можна вмикати прямо на GPIO. **Динамік** (4–8 Ом) —
> лише через транзистор + ~100 Ом. І не беріть **GPIO 34/35/36/39** — вони
> ВХІД-ТІЛЬКИ й не виводять сигнал (збірка це перевіряє й попереджає).

**💡 Підсвітка кнопок як індикатор роботи** (`BTN_LED_PIN`, необов'язково):
спокій/готовий — рівне світіння; читання — блимає в такт; запис — швидко блимає
(«не відключати»); успіх — рівне; помилка — тривожне блимання. `BTN_LED_ACTIVE_LOW`
— для модулів із загальним анодом. Якщо сумарний струм підсвіток > ~20 мА —
керуйте через транзистор.

---

## 8. Операції з АКБ

> Пароль прибрано (керування прямим доступом). Незворотні операції потребують
> **свідомого підтвердження** (довге утримання / вибір у меню). **Спочатку
> резервна копія.**

**Обслуговування (безпечно для ідентичності):**
- **♻️ Скидання** — обнуляє лічильники заряд/розряд і знос (→100 %),
  калібрування зберігається; далі — рекалібрування на IMPRES-ЗП.
- **🛠 Ремонт цілісності** — перерахунок контрольних сум (заголовок Σ≡0x41,
  записи Σ≡0x5A) + відновлення дзеркала з уцілілого DS2438.
- **🔋 Заряд у мА·год** — регістр ICA DS2438. **🩺 Знос %** — запис 0x17.
- **🪪 Запис моделі** — ручний запис part number у DS2433. Модель зберігається
  у **двох** місцях: запис `0x0B` (9 байт, Σ≡0x5A) **і** ASCII-заголовок `0x23`
  (формати 4488/4493, Σ≡0x41) — оновлюються **обидві копії**, інакше рація читає
  стару. Пишуться **лише зачеплені 32-байтові сторінки**, а не весь чіп. Перевірка
  довжини **3..9** і символів **`A–Z 0–9`**. Змінює модель лише там, де вже **є**
  запис; для порожнього чипа — «Новий акумулятор» нижче. Серійний номер
  (лазерний ROM DS2438) — **read-only**.

- **🆕 Новий акумулятор** — ініціалізація **порожнього/стертого/невідомого** чипа
  «як новий». Обираєте модель зі **списку вшитих еталонів** (`templates.h`), вводите
  **ємність у мА·год** — прошивка пише повний genuine-еталон (DS2433 **і** DS2438:
  ідентичність, калібрування, автентифікація, дзеркало), обнуляє історію/лічильники,
  ставить здоров'я 100%, а вказану ємність — у ICA (поточний заряд). Вшиті шаблони:
  **PMNN4488A**, **PMNN4493A**, **PMNN4409A**, **PMNN4409B**, а також **R7**:
  **PMNN4809A**, **APLI4810C** (формат 2021; у APLI4810C дамп DS2438 знято «порожнім»,
  тож після запису калібруйте на R7-ЗП). Додати модель — вставити
  genuine-дамп у `templates.h`). Ту саму дію продубльовано в **меню дисплея**
  («Дії» → «Новий <модель>») з паспортною ємністю за замовчуванням.
  Серійник не потрібен: прошивка прив'язана до моделі. ⚠️ ADC-калібрування DS2438
  береться від донора тієї ж моделі — тонке підстроювання робіть на IMPRES-ЗП.

**Небезпечна зона (незворотні):**
- **🧹 Очистка** — стирає ВСІ дані використання/історії/статистики,
  зберігаючи модель, серійний/ID, криву калібрування, автентифікацію, дзеркало.
- **📤 Відновлення DS2433** — запис завідомо справного дампа тієї ж моделі
  (оживляє стерту АКБ).
- **🔥 Повне стирання DS2433** — весь чіп у `0xFF` (модель/ID/калібрування теж).
  АКБ не працює до запису еталона. DS2438 не чіпається.
- **✏️ Редактор байтів** — правка будь-яких байт з автовиправленням сум.
  У вебі та в нативному GUI — **HxD-стиль**: колонка зсувів, HEX (16 байт, розбито
  по 8) і синхронна **ASCII-колонка**, зручно шукати ASCII-моделі та TLV-записи.

> 🛡 **Перевірка справжності — модельно-залежна.** Блок автентифікації
> `MOTOROLA` і калібрувальний підпис `0x1B-0x1E` є лише у формату 2017
> (4488A/4493A). У **4409A** (формат 2014) їх штатно немає — тому їх відсутність
> **не** вважається підробкою. Червоні прапори для будь-якої моделі: побитий
> заголовок (Σ≠0x41), відсутній запис моделі, переповнений CCA (0xFFFF).

---

## 9. Одиниці вимірювання

- **Лічильники заряду — у мА·год:** `мА·год = регістр × 0.4882 / Rsense`.
  `settings.h → DS2438_RSENSE_OHM` (за замовч. 0.025 Ом) — підберіть під АКБ.
- **Цикли:** 1 цикл = сумарний заряд (розряд) = одна повна ємність.
  `settings.h → BATTERY_RATED_MAH` (2500; PMNN4409 — 2500, PMNN4493 — 3000,
  R7/PMNN4808A — ~2450).
- **Заряд %:** пріоритет ICA (DS2438), інакше — оцінка за напругою.
- **Дата першого користування** НЕ зберігається в АКБ — рація рахує її як
  `поточний час рації − ETM`, де **ETM** = лічильник наробітку DS2438 (`[8..11]`,
  сек). Перевірено діффом однієї АКБ до/після калібрування: дата не змінилась, а
  ETM виріс рівно на тривалість циклу (~7 год). Тому дата **не впливає** на
  «оригінальність» (це похідне поле), а змінюється записом ETM = `сьогодні −
  бажана дата` (клієнт рахує це сам; поле «📅 Дата» у веб/USB/GUI). ESP32 без RTC
  показує лише **наробіток** (вік), а календарну дату обчислює клієнт.

---

## 10. Формат прошивки IMPRES

Розбір дампів (PMNN4488A / 4493A / 4409A / 4409B, PT-клон, стертий) встановив:

- **Заголовок DS2433:** `сума байт 0x00..0x1F ≡ 0x41` (байт 0x1F — контрольний).
- **TLV-записи:** сума байт запису разом з контрольним байтом `≡ 0x5A`
  (довжина запису = значення байта-тега: `0x0B`=11, `0x0D`=13, `0x16`=22, `0x17`=23).
- **Дзеркало калібрування:** `DS2438[24:50] == DS2433[1:27]` — однакове для
  всіх батарей однієї моделі (4488A і 4493A збігаються; 4409A інше).
- **Модель:** запис `0x0B` (`0x0B` + літера) у другій половині + ASCII-заголовок
  `0x23` (лише формати 4488/4493). CCA/DCA дзеркаляться у записі `0x0D`.

**Прошивка прив'язана до МОДЕЛІ, а не до серійного номера чипа** — перевірено
на дампах 3 незалежними тестами:
1. **Калібрувальний блок однаковий при різних серійниках.** Два PMNN4493A з
   різними ROM-серійниками (`A6964F…` / `A6CCB5…`) мають **побайтово ідентичний**
   блок `DS2433[0x01:0x1A]`. Прив'язки до серійника тут немає.
2. **Байтів серійника немає в пам'яті.** Унікальні 6 байт ROM (без family `A6`
   і CRC) **не зустрічаються** ні в DS2433, ні в DS2438 — ні прямо, ні реверсом.
3. **Емпірично:** повне стирання DS2433 + «Ремонт» — рація все одно опізнає
   модель (ROM DS2438 не чіпається). Отже перехресної перевірки «підпис DS2433 ↔
   серійник DS2438» немає.

Тому відновлення можливе з еталона тієї ж моделі, без підбору серійника.

> ⚠️ Автопідбір/«розлочка» без еталона неможливі: калібрувальні дані унікальні
> для моделі й не виводяться математично — потрібен заведомо робочий донор
> тієї ж моделі.

### Блокування після заміни елементів (IMPRES «обучення»)

IMPRES — **обучаєма** система. Крім моделі-калібрування, у DS2433 є **learned-
дані**: лічильники `0x0D` (CCA/DCA), крива `0x17`, телеметрія в кінці (запис
`0x0B` — виміряні за життя імпеданси/просадки; у двох 4493A вони починаються
однаково `6D 80 … 84 BD … 72` і різняться лише у виміряних байтах, тобто це НЕ
хеш серійника). Рація в реальному часі звіряє струм/напругу елементів із цими
learned-даними + кривою розряду.

Після **заміни елементів** нові банки мають іншу ємність/імпеданс, DS2438
рахує «поверх» старих даних → рассогласування → рація помічає пакет як
**«невідомий»** і вимикає гейдж. Це захист IMPRES, а не поломка прошивки.

- **Стирання** → рація не бачить IMPRES-даних, робить грубий вольтметр-гейдж;
  ЗП не опізнає пакет → калібрування не запускає.
- **Стирання + Ремонт** → структура валідна, модель опізнається, гейдж працює,
  рація просить «відновити» (стан **прийнято, але не відкалібровано**). Це
  найближчий досяжний прошивкою стан.
- **«Новий АКБ» з донора** → у чіп потрапляють learned-дані **донора**; на нових
  банках вони не сходяться → миттєвий reject («невідомий»). Гірше за чистий
  стан.

> 🔑 **Обійти фізичну калібрування неможливо:** зарядний пристрій IMPRES має сам
> провести цикл (повний розряд-заряд), виміряти **реальну** ємність нових банок
> і перезаписати learned-дані. Прошивка може лише привести пакет у стан
> «валідний, не відкалібрований», далі — калібрування на IMPRES-ЗП.

**Що саме пише ЗП (перевірено діффом однієї АКБ ДО/ПІСЛЯ калібрування):**
у стерту (0xFF) зону DS2433 з'являється запис **`0A` (learned-калібрування,
Σ≡0x5A)** — виміряні ємність/імпеданс РЕАЛЬНИХ банок — плюс запис статусу `0D`;
оновлюються кінець кривої розряду, лічильники `0x0D` CCA/DCA і кінцева
телеметрія. Тобто «learned» дані ЗП **вимірює** — підробити під нові банки не
можна. Але щоб пакет ПРИЙНЯВСЯ і ЗП ВЗЯВ його на калібрування, треба **стерти
старий запис `0A`** (він суперечить новим банкам) і обнулити лічильники — це й
робить «🔧 Ремонт після заміни елементів». Саме тому «Новий АКБ» раніше давав
«невідома»: лишав learned-`0A` донора; тепер він теж стирає його автоматично.

### 🩺 Пакет не читається ВЗАГАЛІ після заміни елементів — примусове пробудження

Усе вище стосується пакета, який **читається**. Але після заміни банок часто
трапляється інше: пристрій не бачить ні DS2438, ні DS2433, ніби пакета немає.
Пам'ять при цьому ціла — просто **контролер захисту всередині пакета
заблокований**. Глибокий розряд перед заміною або звичайне знеструмлення на час
паяння лишають його в стані, з якого він виходить лише за однією ознакою: коли
на клемах з'явиться **зовнішня зарядна напруга**. Поки він мовчить, він тримає
клеми розімкненими, тож мовчать і обидва чипи.

Виходить замкнене коло: **щоб зарядити — треба прочитати** (без DS2438 немає
температури, а заряд наосліп заборонено), **а щоб прочитати — треба подати
напругу**. Розриває його окремий режим — **примусове пробудження**.

**Що робить.** Коротко тримає на клемах напругу зарядника (`CHARGE_WAKE_MV`,
типово 8.00 В = 4.0 В на банку) з обмеженням струму (`CHARGE_WAKE_MA`, 150 мА) і
раз на кілька секунд закриває ключ і пробує гукнути монітор. Щойно той
відповів — режим **сам зупиняється** й каже, що пакет живий. Далі — звичайне
читання й звичайний заряд.

**Чому це безпечно без датчика температури.** Заборона заряджати наосліп
лишається чинною й нікуди не дівається; дозвіл тут спирається не на послаблення
правила, а на **енергію**. Режим фізично не здатен віддати більше за
`CHARGE_WAKE_MAH_MAX` (8 мА·год — 0.3 % ємності пакета) і живе не довше за
`CHARGE_WAKE_MAX_S` (120 с). Це менше, ніж пакет втрачає на власний саморозряд
за годину; нагріти його такою енергією неможливо в принципі. Заберіть будь-яку
з цих меж — і обґрунтування зникне разом із нею, тому **кожна перевіряється на
компіляції** (`#error` у `settings.h`), а не «мається на увазі».

**Головне інженерне рішення: це джерело НАПРУГИ, а не струму.** Штатний заряд
тримає струм, бо пакет у колі є й він цей струм бере. Тут пакет із кола
вимкнений власним ключем — струму немає й бути не може. Струмовий регулятор,
не бачачи струму, підіймав би шпаруватість, поки не впреться в заводську стелю
85 %, тобто виклав би на клеми **≈11.9 В**; і рівно тієї миті, коли контролер
прокинеться й замкне ключ, ці 11.9 В опинилися б на банках 2S. Тому режим
регулює напругу — через **стелю шпаруватості**, — а струм лишається верхнім
обмеженням. Стеля живе в `chargeSetDuty()`, у найнижчій точці, тож діє на
будь-який шлях; заводська межа `CHARGE_DUTY_MAX` лишається другим рядком
оборони. Це єдиний запобіжник, який працює навіть тоді, коли **вимір струму
бреше** (обрив шунта читається як «струму немає» — і струмовий контур на це
відповів би підняттям шпаруватості).

**Що ще лишається чинним:** контроль живлення +14 В, пікова відсічка струму,
апаратний сторож, заборона одночасного заряду/розряду.

**Дві мети режиму.** Контролер захисту буває заблокований по-різному, і ознака
успіху від цього залежить:

| мета | коли обирається | успіх | температура |
|---|---|---|---|
| `WAKE_GOAL_CHIP` | монітор **мовчить** | монітор заговорив | немає — режим сліпий |
| `WAKE_GOAL_RAIL` | монітор **говорить**, а на клемі нуль | на клемі з'явилась напруга | **є** — і режим за нею стежить |

> ⚑ **Друга мета — це заблокований пакет, який читається.** Захист розмикає
> **силовий** ключ, а 1-Wire сидить **до нього**: монітор говорить, поки клеми
> розімкнуті. Раніше це був глухий кут — штатний заряд відмовляв через нуль на
> клемі, пробудження відмовляло через те, що пакет читається (3.36).

> ⚑ **Мета визначається РАЗ на старті.** У меті RAIL монітор відповідає з
> першої ж проби, тож ознака успіху «монітор відповів» оголосила б перемогу,
> **не зробивши нічого**.

> ⚑ **Невдача в двох метах означає різне.** У меті CHIP — «монітор так і
> мовчить». У меті RAIL монітор говорив увесь сеанс, тож невдача означає **або
> захист не відпускає, або обірвано лінію `CHARGE_VSENSE_PIN`**. Відрізнити їх
> вимірюванням неможливо — картина однакова, — але дія в обох випадках та сама
> й обмежена, тож режим просто **розв'язує** неоднозначність: з'явилась напруга
> — був захист, не з'явилась — лінія.

**Коли режим ВІДМОВИТЬ (і це навмисно):**

| Відмова | Чому |
|---|---|
| **пакет читається І на клемі є напруга** | там доступний звичайний заряд, і він безпечніший. Це головна відмова: без неї режим тихо перетворився б на «заряд без датчика». Умова саме подвійна — сама лише читаність підставою не є |
| на клемі вже є напруга ≥ `CHARGE_WAKE_MV`, а монітор мовчить | контролер не заблокований; причину мовчання шукайте в лінії даних і підтяжці 4.7 кОм |
| на закритому ключі є струм або напруга живлення | ключ пробитий — спершу перевірте силову частину |
| живлення +14 В поза допуском | те саме, що й для звичайного заряду |
| іде заряд або розряд | один ключ на всіх |

**Як запустити:** веб — вкладка «Заряд», блок «🩺 Пакет не читається після
заміни елементів»; USB — команда `CHARGE WAKE` або кнопка в клієнті; на самому
пристрої — пункт меню «Пробудження».

> ⚠️ Режим **нічого не пише в пам'ять** і ні на що в ній не спирається — він
> взагалі для випадку, коли пам'яті не видно. Якщо після пробудження пакет
> почав читатись, далі йдіть звичайним шляхом: «🔧 Ремонт після заміни
> елементів» → калібрування на IMPRES-ЗП.

> ⚠️ Якщо пробудження не допомогло за відведений час, дивіться, ЩО саме воно
> написало. «Монітор так і мовчить» — причина не в блокуванні контролера:
> перевіряйте підтяжку 4.7 кОм на лінії даних, сигнал enable, контакт клем і
> цілісність внутрішньої плати пакета. «Клема так і лишилась мертвою» — або
> захист не відпускає, або обірвано лінію `CHARGE_VSENSE_PIN`: зміряйте
> напругу мультиметром просто на клемах пакета, і якщо вона там є, а подільник
> показує нуль — обрив у подільнику.

> 🔍 **«АВАРІЯ: піковий струм вище межі» під час пробудження — найімовірніше
> УСПІХ.** Найгостріша мить режиму — та, коли контролер замикає ключ і на місці
> розімкненого кола раптом з'являються розряджені банки. Струм тоді дорівнює
> (`CHARGE_WAKE_MV` − напруга банок) / опір контуру: **2.6 А з польовим ключем**
> і **3.3 А з біполярним** (у нього немає `RDS(on)`, тож опір контуру менший, а
> струм більший — цю різницю знайшов хостовий тест, коли його прогнали в обох
> конфігураціях `CHARGE_SWITCH_TYPE`). У другому випадку стрибок законно
> перевищує відсічку `CHARGE_PEAK_MA_MAX` = 3 А, і вона закриває ключ — тобто
> робить рівно те, для чого існує. Тому найгірший сценарій режиму — не «щось
> згорить», а «пробудження зупинилось із піковою аварією саме тієї миті, коли
> пакет ожив». Ціна — рівно один крок циклу, і саме тому крок дрібний:
> `CHARGE_WAKE_POLL_MS` = 25 мс проти секунди у штатного заряду, тобто в 40
> разів менша експозиція для шунта (5.6 Вт × 25 мс = 0.14 Дж на резисторі 2 Вт —
> у межах одиничного імпульсу). Повідомлення про цю аварію прямо каже перевірити,
> чи пакет тепер читається.

---

## 11. Типові сценарії відновлення

- **АКБ «невідома», але чіп читається** → «🛠 Ремонт цілісності». Якщо суми і
  дзеркало в нормі — проблема не в прошивці, а в елементах або треба
  калібрування на IMPRES-ЗП.
- **Порожній / стертий / зовсім новий чіп** → «🆕 Новий акумулятор»: оберіть
  модель + впишіть ємність — запишеться повний робочий еталон (DS2433+DS2438),
  але з обнуленою історією (health 100 %, лічильники 0).
- **Ремонт «з нуля» на порожній/битій мікросхемі, максимальна сумісність** →
  «🛠 Відновити еталон» (веб/USB/GUI) або `RESTORE <MODEL>`. Пише вшитий
  **genuine**-еталон **байт-у-байт**, зі всією навченою калібровкою (гістограма
  `0x17`, крива `0x16`, CCA/DCA/ETM/ICA) — **нічого не обнуляє**. Результат —
  бітово точна копія робочого АКБ, яку приймають і рація, і IMPRES-ЗП. Кожен
  чіп пишеться незалежно, тож навіть відсутній/битий DS2438 не блокує
  відновлення DS2433. Для **PMNN4409B** (найкраще вивчений еталон) — це
  найнадійніший шлях до робочого, каліброваного пакета.
  Звірити результат із еталоном: `python tools/decode_dump.py ref_33.bin ref_38.bin --diff clone33.bin clone38.bin`.
- **DS2433 пошкоджений/стертий** → «📤 Відновлення DS2433» (еталон тієї ж
  моделі) + «🛠 Ремонт» (синхронізація дзеркала з DS2438).
- **Чіп остаточно «зіпсований»** → «🔥 Повне стирання DS2433» → запис еталона.
- **Прибрати історію/знос, лишити робочою** → «🧹 Очистка».
- **Після заміни елементів** (рація пише «невідома» / не бере на калібрування) →
  **«🔧 Ремонт після заміни елементів»** (веб/USB/меню «Дії» → «Рекалібр.»).

  Причина відмови — **навчена калібровка від ІНШИХ банок** у блоці `0x18A–0x1FF`.
  Рація й ЗП відкидають **чужу** навчену калібровку, але приймають її
  **відсутність**: порожній блок читається як «пакет фірмовий, не калібрований».
  Повний розбір із доказами по 49 дампах — [`docs/FIRMWARE_ANALYSIS.md`](docs/FIRMWARE_ANALYSIS.md).

  - **DS2433**: **скидає** навчений хвіст **`0x18A–0x1FF`** у «чистий» вигляд —
    скелет записів і сталі моделі лишаються, навчені значення обнуляються, суми
    перераховуються. Ідентичність (`0x000–0x065`), розрядна крива, `COPYRIGHT`,
    заводська таблиця й **запис моделі** (`0x148`) не чіпаються.
    ⚠️ Хвіст саме **скидається, а не стирається в `0xFF`**: на стертому хвості ЗП
    не може записати навчену калібровку (вона пише за фіксованими адресами й
    структуру заново не створює), і цикл щоразу завершується помилкою.
  - **DS2438**: обнуляє лише **лічильники** (ETM/CCA/DCA). Конфіг (`0x0F`), поріг
    (`0x40`), апаратне калібрування АЦП струму (`0x0D–0x0E`) і дзеркало
    зберігаються; паливомір виставляється за напругою за шкалою
    `BATTERY_EMPTY_MV`..`BATTERY_FULL_MV` (див. §7).

  Результат: **фірмовий, рівень заряду адекватний, усі функції ЗП працюють, але
  потребує калібрування**. Далі — **повний цикл на IMPRES-ЗП**. Стирання хвоста
  виконується для всіх форматів, включно з 2021 (R7). Обійти фізичну калібровку
  прошивкою неможливо (див. розділ 10).

  **🧹 Глибока чистка** (`RECAL DEEP`, прапорець у вебі) додатково стирає навчені
  записи ємності `0x153–0x189` і журнал використання — якщо після звичайного
  ремонту ЗП тримається за стару ємність.

- **🪫 Розряд перед калібруванням** (потрібен MOSFET + резистор, див. `settings.h`).
  Зарядна станція **не бере АКБ на калібрування, поки бачить його зарядженим** —
  світить зеленим і просто тримає. Керований розряд до **7.20 В** знімає цю
  невизначеність: пакет свідомо не повний, і станція йде в повний цикл.
  Заразом рахується **реальна ємність** нових банок: струм проходить через
  вимірювальний резистор DS2438 **усередині пакета**, тож мА·год рахуються за
  фактом, без окремого шунта.

  Схема — N-канальний MOSFET у нижньому ключі, затвор на `LOAD_PIN` (типово
  GPIO 19), навантаження 5 Ом / 25 Вт із радіатором.
  **Резистор 10 кОм із затвора на землю обов'язковий**: під час скидання ESP32
  піни у високоімпедансному стані, і без підтяжки MOSFET може лишитися
  відкритим та посадити пакет у нуль — програмними засобами це не перекрити.
  Бажаний ще один — **100 Ом послідовно в затвор**: ключ керується ШІМом, і цей
  резистор бере на себе кидок струму перезаряду затвора.

  **Струм обмежується ШІМом** і веде за напругою лінійно:

  | напруга пакета | струм розряду |
  |---|---|
  | 8.25 В (`DISCHARGE_RAMP_HI_MV`, повний заряд) | 1000 мА |
  | 7.73 В (середина лінійки) | 650 мА |
  | 7.20 В (ціль за замовчуванням) | 300 мА |

  Без обмеження на 5 Ом текло б 1.4–1.7 А — це і 0.8C для пакета 2150 мА·год, і
  зайві 14 Вт на резисторі. Головне ж інше: під великим струмом просадка на
  внутрішньому опорі **передчасно продавлює напругу до цілі**, і розряд
  обривається, не добравши ємності, — тим сильніше, чим розрядженіший пакет.
  Малий струм у кінці прибирає цей ефект.

  Як тримається уставка: раз на 5 с ключ на 80 мс **повністю закривається** —
  знімаємо напругу без просадки, — потім на 80 мс **повністю відкривається** —
  знімаємо **пік** струму. DS2438 віддає миттєвий струм останнього перетворення
  і про ШІМ нічого не знає, тож міряти під шпаруватістю немає сенсу; а з піка
  все рахується однозначно: шпаруватість = уставка / пік, середній струм =
  пік × шпаруватість. Апаратний лічильник DCA самого DS2438 інтегрує розряд
  незалежно й лишається перехресною перевіркою. Якщо каналу LEDC не знайшлося,
  розряд іде **без обмеження** — це видно в усіх інтерфейсах як `БЕЗ ШІМ`.

  **Моніторинг** — у всіх трьох інтерфейсах (веб, USB-клієнт у браузері,
  десктопний клієнт) однакова панель процесу, яка **оновлюється сама**, без
  кнопок: пульсуючий індикатор стану, смуга прогресу з «течією» (єдина ознака,
  що процес живий — між опитуваннями пристрою числа стоять на місці), графік
  напруги **за весь сеанс** із пунктиром цільової напруги, коридор уставки
  струму, шпаруватість ключа й плитки показань зі спалахом на зміні. Стан
  тягнеться раз на 2–3 с під час розряду й раз на 20–30 с у спокої — щоб
  побачити розряд, **запущений кнопкою на самому пристрої**. Оцінка «лишилось ≈»
  рахується з фактичного темпу за сеанс.

  Запобіжники: аварійна зупинка за напругою нижче **6.00 В**, перегрівом
  (**45 °C** за DS2438), стелею часу (**6 год** — на малому струмі повний цикл
  пакета 3000 мА·год займає ~4 год) і кількома невдалими читаннями
  монітора поспіль — розряд «наосліп» заборонено. Під час розряду індикатор
  **плавно дихає помаранчевим** — згасанням керує сам ШІМ-контролер (`ledcFade`),
  тож хвиля не рветься, поки процесор зайнятий циклом вимірювання; дисплей
  переходить у **режим моніторингу**
  (напруга, струм, уставка й шпаруватість, віддані мА·год, температура, час,
  прогрес до цілі), показання оновлюються раз на 5 с. Довге натискання на
  пристрої — негайна зупинка.

- **🔋 Керований заряд** — силового заліза два, і обирає його `CHARGE_TOPOLOGY`
  (таблиця й піни — у розділі про підключення вище). Нижче описано **власний
  понижувач** (`CHARGE_TOP_BUCK`): біполярний PNP (B772M) у верхньому ключі,
  після нього діод на землю й дросель на вихід (потрібні `CHARGE_PWM_PIN`,
  `CHARGE_ISENSE_PIN`, `CHARGE_VSENSE_PIN`).
  Другий варіант — **готова плата DC/DC на TL494** (`CHARGE_TOP_TL494`,
  `CHARGE_TL_EN_PIN` + `CHARGE_TL_CTRL_PIN`): там немає ні цього ключа, ні
  дроселя, ні власних давачів, тож усе, що нижче сказано про шунт, подільник,
  пульсації дроселя й тепловий бюджет ключа, до неї **не стосується**. Спільними
  лишаються профіль струму, фази, завершення за ціллю, перегрів і стеля часу.

  ```
     +Uживл ─────┬────[ R_запір 1к ]──────┬─── E  PNP B772M
       (~14 В)   │                        │
                 └────────────────────────┴─── B ──┐
                                                   │
     CHARGE_PWM_PIN ──[ 390 ]── B  NPN             │
                                C ──[ R_бази 120 ]─┘
                                E ── GND
                       B ──[ 10к ]── GND   <-- ОБОВ'ЯЗКОВО

                       C ─┬────[ L 104мкГн ]────> +клема АКБ
                          │
                    (катод) VD Шотткі
                          │
                         GND

     +Uживл ──[ 68к ]──┬──[ 1к ]── CHARGE_PSU_PIN (39)
                       │
                     [ 10к ]
                       │
                      GND
  ```

  | Пін | Роль |
  |---|---|
  | `CHARGE_PWM_PIN` (26) | **ШІМ** на базу керуючого NPN, який уже відкриває силовий PNP |
  | `CHARGE_ISENSE_PIN` (35) | АЦП: спад на **шунті 0.5 Ом** у мінусовому проводі, через **1 кОм** |
  | `CHARGE_VSENSE_PIN` (34) | АЦП: напруга плюсової клеми через **подільник 20к/10к** і **1 кОм** |
  | `CHARGE_PSU_PIN` (39) | АЦП: напруга **живлення +14 В** через **подільник 68к/10к** і **1 кОм** |

  **Логіка не інвертована** — два інвертування взаємно скасовуються:
  GPIO HIGH → NPN відкритий → струм витікає з бази PNP → ключ **відкритий**;
  GPIO LOW → база підтягнута до емітера → **закритий**. Шпаруватість 0 % — безпечний
  стан, виставляється найпершим рядком `setup()`.

  > ⚠️ **Резистор 10 кОм із бази NPN на землю обов'язковий** — під час
  > скидання ESP32 піни у високоімпедансному стані, база «висить», і
  > програмно це не перекрити.

  ### Що змінює дросель (і чому це не «просто ключ»)

  **1. `Uвих ≈ D × Uживл`, і струм залежить від `D` НЕ лінійно.** Точка
  `D = Uпакета/Uживл` (≈0.59 при 8.25 В від 14 В) — це **межа режимів**, а не
  «нульовий струм»: наростання струму у відкритій фазі там рівно дорівнює
  спаду в закритій, тож середній струм дорівнює **половині розмаху
  пульсацій** — при 104 мкГн і 25 кГц це **652 мА**. Нижче цієї точки
  перетворювач у **переривчастому** режимі, де струм росте як `D²`; вище —
  у неперервному, де лінійно.

  Тому старт іде з `chargeStartDuty(Uпакета, уставка)`, яка цілиться саме в
  потрібний струм, рахуючи по тій гілці, у якій перетворювач зараз працює:

  | уставка | режим | duty (з 2047) |
  |---|---|---|
  | 100 мА | переривчастий | 472 |
  | 200 мА | переривчастий | 668 |
  | 400 мА | переривчастий | 945 |
  | 700 мА | неперервний | 1267 |
  | 1000 мА | неперервний | 1293 |

  Розгін «з нуля крок за кроком» тут безглуздий: до робочої точки — сотні
  відліків, тобто хвилини при секундному опитуванні.

  **2. Струм не рветься.** У простому ключі пік обмежували б лише різниця
  напруг і опір кола; тут наростання обмежене індуктивністю, і через шунт
  тече майже неперервний струм дроселя з трикутними пульсаціями. Тому «пік»
  на шунті — це **вершина пульсацій** (`Iсер + ΔI/2`), а не кидок. Відсічка
  `CHARGE_PEAK_MA_MAX` лишається, але стереже вона поломки, за яких дроселя
  фактично немає в колі (обрив, насичення, пробитий ключ, замкнений діод).

  **3. Частота ШІМ мусить бути високою.** `ΔI = (Uживл − Uвих) × D / (L × f)`:
  на 1 кГц зі 104 мкГн це десятки ампер, тобто глибоко переривчастий режим.
  Тому **25 кГц**, а не 1 кГц, як у розрядного ключа (той на резистор, йому
  дросель ні до чого). При 14 В → 8.25 В і L = 104 мкГн виходить
  ΔI ≈ 1.30 А при уставці 1.5 А — прийнятно, але **впритул**: більший
  дросель або вища частота дали б помітно чистіший струм.

  **4. Ключ БІПОЛЯРНИЙ (B772M), і це обмежує частоту зверху.** Біполярник —
  не «інша деталь у тій самій ролі», а інший принцип:

  - керується **струмом бази**, і насичення мусить триматись на **вершині
    пульсацій**, інакше ключ виходить із насичення на кожному горбі;
  - **вимикається повільно**: заряд бази треба розсмоктати, це мікросекунди
    проти наносекунд у MOSFET — тож перемикальні втрати домінують і ростуть
    прямо з частотою;
  - у насиченні на ньому лишається `Uке_нас ≈ 0.5 В`, а не мілівольти опору
    каналу — є ще й помітні провідні втрати.

  Тепловий бюджет при 25 кГц і Pc = 1.25 Вт:

  | Iк | провідні | перемикальні | разом | |
  |---|---|---|---|---|
  | 0.5 А | 0.15 Вт | 0.26 Вт | 0.41 Вт | ок |
  | 1.0 А | 0.29 Вт | 0.53 Вт | **0.82 Вт** | робоча точка |
  | 1.5 А | 0.44 Вт | 0.79 Вт | 1.23 Вт | на межі Pc |

  > ⚠️ **Тому стелю профілю струму задає НЕ пакет, а ключ.** `CHARGE_MA_80`
  > знижено з 1500 до **1000 мА**: 1500 мА дають 1.23 Вт при Pc 1.25 Вт, ще й
  > це паспортне значення для корпусу при 25 °C. **Радіатор потрібен у
  > будь-якому разі.**

  > ⚠️ **Струм бази й обв'язка.** Для насичення на піку 1651 мА потрібно
  > `Iб ≥ 83 мА` (β_форс = 20). Рахувати треба **не на номінальні 14 В, а на
  > нижню межу допуску живлення** (12.5 В): струм бази падає разом із
  > живленням, а пік струму дроселя від нього майже не залежить. Звідси
  > `R_бази = 120 Ом` (94 мА при 12.5 В, 106 мА при 14 В), а не 150 Ом —
  > ті дають при 12.5 В лише 75 мА, тобто **просілий, але ще допустимий блок
  > живлення виводив би ключ із насичення**.
  > Дві вимоги, яких у MOSFET немає взагалі: резистор розсіює
  > `Iб²·R·D ≈ 0.83 Вт` — брати **2 Вт**; і NPN мусить пропускати ці 106 мА
  > (при 16 В — 123 мА) — BC547 (100 мА максимум) **не годиться**, потрібен
  > **2N2222 / BC337 / S8050**.
  >
  > Якщо 120 Ом дістати важко — 150 Ом лишається придатним, якщо знизити
  > `CHARGE_MA_80` до **700 мА** (пік 1351 мА → потрібно 67 мА). Це на 40 %
  > довший заряд; перевірки приймуть обидва варіанти.

  > 🔴 **НА ПЛАТІ ЗАРАЗ 1 кОм — ЦЕ ТРЕБА ЗАМІНИТИ НА 120 Ом.** Причина не в
  > запасі: з 1 кОм струм бази лише **12 мА** (враховуючи 0.9 мА, які
  > відбирає запираюча підтяжка). При β_форс 20 це стеля колектора 240 мА, а
  > з пульсаціями дроселя середній струм заряду вийшов би **~22 мА** — пакет
  > 2150 мА·год заряджався б **чотири доби**. А якщо всупереч цьому виставити
  > більший струм, ключ не насититься й згорить. Збірка не пройде, доки
  > номінал не відповідає профілю.

  **Запираючий резистор база-емітер — 1 кОм.** Тримає ключ закритим у спокої
  й прискорює розсмоктування заряду при вимиканні. Він же відбирає частину
  струму драйвера (`Uбе/R` = 0.9 мА з 86 — 1 %), і це враховано у формулі
  струму бази; на дрібнішій підтяжці витік став би відчутним, тому є окрема
  перевірка «підтяжка не з'їдає понад 20 % драйвера».

  **5. Драйверний каскад: пін НЕ керує ключем напряму.** Між ними окремий
  керуючий NPN, і в нього свої вимоги — він теж біполярний, і відмова тут
  **каскадна**:

  `R_драйв` (пін → база NPN) задає струм бази самого NPN:
  `Iб = (3.3 − Uбе)/R`. Замалий струм → NPN не в насиченні → на ньому падає
  вольт замість 0.2 В → струм бази PNP просідає нижче потрібного →
  **з насичення виходить уже силовий ключ** і згорає.

  Найгірший випадок тут **дзеркальний** до силового ключа: не нижня межа
  живлення, а **верхня**. Чим вище напруга живлення, тим більший струм
  драйвера мусить пропустити колектор NPN — при 16 В і `R_бази` 120 Ом це
  124 мА, тобто 6.2 мА в базу при β_форс 20.

  | `R_драйв` | Iб NPN | β_форс на 124 мА | насичення |
  |---|---|---|---|
  | 20 кОм | 0.13 мА | 955 | **не насититься** ← *стоїть на платі* |
  | 2.2 кОм | 1.2 мА | 105 | не насититься |
  | 1 кОм | 2.6 мА | 48 | не насититься |
  | 470 Ом | 5.5 мА | 22 | вистачає лише до 14 В |
  | **390 Ом** | **6.7 мА** | **19** | **надійне на всьому діапазоні** |

  > 🔴 **НА ПЛАТІ ЗАРАЗ 20 кОм — ЦЕ ТРЕБА ЗАМІНИТИ НА 390 Ом.** 20 кОм —
  > типовий номінал, коли NPN просто вмикає світлодіод або реле; тут через
  > його колектор тече весь струм бази силового ключа. 0.13 мА дають стелю
  > колектора 2.6 мА — керуючий каскад не здатен віддати навіть тих 12.9 мА,
  > що тече через нинішній 1 кОм, не кажучи вже про 106 мА після заміни.
  >
  > **Це друга з двох замін, і поодинці жодна не працює:** замінити тільки
  > `R_бази` означає попросити в NPN 106 мА, яких він при 20 кОм віддати не
  > може, і ключ однаково лишиться поза насиченням.

  > 🐞 470 Ом, які тут стояли раніше, — теж не з плати, а мій розрахунок, і
  > він виявився **порахованим лише на номінальні 14 В**. Щойно з'явився
  > контроль живлення з допуском до 16 В, перевірка на компіляції це й
  > зловила. Струм із піна при 390 Ом — 6.7 мА, третина від рекомендованих
  > для ESP32 20 мА. Обидві межі діапазону живлення перевіряються на
  > компіляції.

  **6. Контроль напруги живлення +14 В.** Уся арифметика вище будується на
  `Uживл` — стартова шпаруватість `D ≈ Uпак/Uживл`, розмах пульсацій, струм
  бази ключа, стеля шпаруватості. Доки це була **константа** `CHARGE_SUPPLY_MV`,
  вона лишалась припущенням: прошивка не могла знати, що припущення хибне, і
  просто мовчки регулювала не туди.

  | Що сталось | Як це виглядало БЕЗ контролю | Що робить прошивка тепер |
  |---|---|---|
  | блок живлення не під'єднано | заряд «іде» зі шпаруватістю в стелю й нульовим струмом — схоже на несправний пакет | старт відхиляється, індикація несправності |
  | блок на 12 В замість 14 | струму бази менше, стелі `D` не вистачає дотягнутись до цілі → впирається в стелю часу через 6 годин | `⛔ напруга занижена — блок не той` |
  | блок на 19 В від ноутбука | ключ і пакет отримують більше, ніж закладено в усі перевірки | `⛔ напруга завищена — блок не той` |

  Тому напруга живлення тепер **вимірюється** на `CHARGE_PSU_PIN` (GPIO39,
  подільник 68к/10к і 1 кОм у пін), а константа лишилась тільки для
  компіляційних перевірок і як запасне значення для плат без подільника.
  Розрахунок іде на **живому вимірі**: із просілим блоком стартова оцінка за
  формулою на 14 В занижена на чверть, і контур витрачав би десятки опитувань,
  щоб це надолужити.

  > ⚖️ **Поправка тракту — `CHARGE_PSU_CAL_X1000`** (тисячні, `1000` вимикає).
  > Заміри на живій платі: блок 14.3 В показувався як 12.4 В, при цьому
  > мультиметр на самому GPIO39 давав 1.81 В при блоці 14.4 В — тобто
  > подільник справний і 1 кОм нічого не роняє, а губиться воно вже в АЦП.
  > Причина не в поломці: пряма модель «відлік × 3300/4095» не описує АЦП
  > ESP32 на 11 дБ — у нього і власна нелінійність, і розкид опорної напруги
  > між чипами. Множник (тут `1153` = 14300/12400) зводить показання з
  > дійсністю, **не чіпаючи номіналів подільника**: на них тримаються
  > перевірки діапазону й струму в захисний діод, і підганяти їх під
  > показання не можна.
  >
  > ⚠️ Виправлено **лише канал живлення**. Похибка АЦП майже напевно спільна
  > для всіх трьох каналів, але канал пакета працює в іншій точці шкали
  > (2.75 В проти 1.8 В), а крива гнеться — переносити той самий множник туди
  > навмання не можна: на ньому тримаються ціль заряду й аварійна відсічка за
  > перенапругою.
  >
  > Перерахувати під свою плату: подати відомий блок, подивитись `psuMv` у
  > `http://<адреса>/api/charge` (там мілівольти) і взяти
  > `CAL = 1000 × справжня / psuMv`. Значення поза 700…1400 відхиляє `#error`:
  > така поправка означає вже не калібрування, а несправність тракту.

  Пороги: `< 6 В` — живлення немає, `< 12.5 В` — занижено, `> 16 В` —
  завищено. Гістерезис 200 мВ (несправність піднімається за чистим порогом, а
  знімається лише при поверненні в діапазон із запасом) — інакше блок, що
  стоїть рівно на 12.5 В, блимав би «помилка/норма» кожні дві секунди.

  > ⚠️ Поріг «немає живлення» — **6 В, а не нуль**, і це не запас на око.
  > Якщо пакет під'єднано, а блок вимкнено, пакет підживлює шину живлення
  > **через перехід база-колектор силового PNP** (база притягнута до емітера
  > запираючим резистором, на колекторі — напруга пакета через дросель). На
  > шині опиняється `Uпак` мінус діодне падіння, і нуля там не буде.

  **Індикація** — чотири поверхні одночасно й скрізь із блиманням, бо
  несправність живлення треба помітити ще **до** натискання «заряд»:
  * **екран пристрою** — сторінка помилки з'являється **сама**: червоне тло,
    великий **блимаючий** напис, виміряна напруга, потрібний діапазон і що
    робити. Знімається будь-якою кнопкою — читати й правити пам'ять пакета
    можна й без блока живлення, тож тримати сторінку намертво означало б
    зробити непридатним увесь прилад. Після зняття лишаються «`!`» перед
    номером сторінки на **будь-якій** сторінці й код на світлодіоді; зміниться
    несправність на іншу — сторінка з'явиться знову;
  * **світлодіод** — окремий постійний код `LED_FAULT`: **два червоних спалахи
    й пауза**. Саме код несправності, а не рівне блимання: рівне вже означає
    невдалу операцію (`LED_ERROR`) і минає за 1.6 с;
  * **веб-інтерфейс** — блимаюча червона смуга вгорі **будь-якої** вкладки;
  * **USB-клієнт** (HTML і Python) — така сама блимаюча смуга над вкладками.

  Блимає **плашка** (тло й рамка), а текст усередині стоїть нерухомо й
  читається в обидві фази.

  > 🐞 Спершу було навпаки — блимав сам напис, і півперіоду на екрані висіла
  > порожня червона смуга. Тобто рівно тоді, коли користувач дивиться на
  > екран, він міг побачити «щось червоне» без жодного слова про причину.
  > Аварійне повідомлення, яке пів часу нічого не повідомляє, гірше за
  > статичне. На монохромному екрані те саме зроблено інверсією заливки:
  > у прямій фазі чорний текст на білій плашці, у зворотній — білий на чорній.

  Сам рух потрібен: статичну червону смугу за хвилину перестаєш помічати, а
  рухома лишається видимою боковим зором — це та сама причина, з якої аварійна
  індикація в техніці завжди рухома. Період — `DISPLAY_PSU_BLINK_MS` (типово
  500 мс); у браузері блимання вимикається системним «зменшити рух».

  Текст називає **саме причину**, а не просто «помилка»: «ЗАВИЩЕНА НАПРУГА
  БЛОКА ЖИВЛЕННЯ», «ЗАНИЖЕНА НАПРУГА БЛОКА ЖИВЛЕННЯ», «НЕМАЄ ЖИВЛЕННЯ».

  Поруч — **виміряно** і **треба**, причому «треба» — це **номінал** блока
  (`CHARGE_SUPPLY_MV`, тобто 14 В), а допуск 12.5…16.0 йде в дужках:

  ```
  виміряно 19.20 В — треба 14 В (допуск 12.5…16.0)
  ```

  Різниця не косметична. Допуск відповідає на питання «чому цей блок
  відхилено», а користувачеві потрібна відповідь на «який тоді під'єднати» —
  і «потрібно 12.5…16.0 В» на неї не відповідає. Номінал береться з
  налаштувань, а не зашитий у текст: поміняєте живлення — повідомлення
  зміниться саме.

  Усі чотири поверхні малюються з ОДНИХ І ТИХ САМИХ полів `/api/charge`
  (`psuSensed`, `psuOk`, `psuMv`, `psuMinMv`, `psuMaxMv`, `psuHead`, `psuText`),
  тож розійтись у показаннях вони не можуть.

  У спокої живлення опитується раз на 2 с (`chargePsuIdleTask()` у `loop()`),
  під час заряду — кожне опитування, на коротко закритому ключі разом із
  напругою пакета (під струмом на шині є просадка, і поріг довелося б
  розмазувати). Заряд зупиняється після `CHARGE_PSU_BAD_POLLS` = 3 поганих
  вимірів поспіль — одиничний провал це просадка на кидку струму, а не аварія.

  **7. Відсічка «ключ не тягне».** Дзеркало пікової відсічки й з тією ж метою
  — врятувати силовий ключ. Якщо шпаруватість уперлась у стелю, а струм усе
  одно нижчий за половину уставки, і так п'ять опитувань поспіль — заряд
  зупиняється (`CHGR_NODRIVE`).

  Навіщо зупинятись, коли струму **мало**, а не багато: реакція регулятора на
  брак струму — піднімати шпаруватість, тобто збільшувати час, який транзистор
  проводить під навантаженням. Якщо причина браку — замалий струм бази (ключ
  поза насиченням), це рівно те, що його й палить. Стеля часу спрацювала б
  через шість годин, коли палити вже нічого.

  Це і є запобіжник на випадок, якщо прошивку заллють на **не доопрацьовану**
  плату: з нинішніми 1 кОм і 20 кОм ключ насичується щонайбільше до ~34 мА
  проти уставки 200 мА, і заряд спиниться сам приблизно за 5 секунд. Ті самі
  симптоми дають обрив дроселя, поганий контакт і просілий блок живлення —
  всі вони теж заслуговують на зупинку, а не на шість годин удавання роботи.

  ### Власні вимірювання

  Раніше струм і напругу заряд брав із монітора пакета DS2438 по 1-Wire.
  Тепер у пристрою свої давачі, а DS2438 потрібен рівно для **температури**
  (свого датчика немає) і як незалежна перехресна перевірка за CCA.

  Три виміри рознесені в часі, бо кожен має свою причину:

  - **Струм** міряємо **не зупиняючи ключ**: через шунт і так тече неперервний
    струм дроселя. Серія `CHARGE_ADC_SAMPLES` (128) усереднює пульсації;
    заразом запам'ятовуємо найбільший відлік — вершину.
  - **Напругу** — на коротко закритому ключі (`CHARGE_VSENSE_SETTLE_MS`,
    10 мс). Сама напруга згладжена дроселем, але під струмом до неї додається
    падіння на дротах і внутрішньому опорі пакета; так вимір лишається
    однаковим від початку до кінця заряду.
  - **DS2438** — **рідко** (`CHARGE_TEMP_EVERY_N`, раз на 10 опитувань) і теж
    на закритому ключі. Шунт стоїть у **мінусовому** проводі, тож під струмом
    «мінус» пакета піднятий над землею ESP32 на `I × R_шунт` (при 1.5 А це
    750 мВ) — для 1-Wire це зсув опорної землі на чверть логічного рівня.
    Транзакція коштує сотні мілісекунд, і робити її щосекунди означало б
    віддавати п'яту частину часу заряду й щоразу перезапускати струм дроселя
    з нуля. Температура ж міняється хвилинами.

  **Подільник напруги — 20к / 10к**, коефіцієнт 1:3. У штатній роботі на
  клемі стоїть напруга ПАКЕТА, і вона лягає з великим запасом: 8.25 В →
  2.75 В при робочій стелі АЦП 3.1 В. Крок АЦП на боці пакета — **2.4 мВ**,
  точність надлишкова.

  > ⚠️ Є один **нештатний** випадок: якщо пакет від'єднати посеред заряду, на
  > клемі лишиться напруга живлення (дроселю нікуди віддавати струм), і
  > подільник дасть 14/3 ≈ 4.67 В — вище абсолютної межі входу 3.6 В. Пін це
  > переживає: власний опір подільника (20к∥10к = 6.7 кОм) плюс послідовний
  > 1 кОм обмежують струм у захисний діод до **139 мкА**. Саме тому
  > послідовний резистор тут не косметика.

  > 🐞 **Виправлена порада.** Раніше тут стояло «подільник 10к/10к небезпечний,
  > поставте знизу 2.7к». Це було **помилкою**: я виходив із того, що зверху
  > 10к (тоді коефіцієнт був би 1:2 і пакет 8.4 В дав би 4.2 В на піні). З
  > реальними **20к зверху** міняти нічого не треба — 20к/10к і точніші
  > (2.4 мВ проти 3.8), і безпечні.

  Подільник висить на пакеті **постійно** й тихо його розряджає: 8.25 В /
  30 кОм ≈ 275 мкА, тобто ~0.2 А·год за місяць. Прийнятно, але подільник на
  кілоомах садив би пакет за тижні — це теж перевіряється на компіляції.

  > ⚠️ **Потужність шунта:** `I²R` — при 1.5 А на 0.5 Ом це 1.1 Вт, потрібен
  > резистор від 2 Вт. Він же з'їдає 0.75 В із бюджету напруги, і це враховано
  > в розрахунку стелі шпаруватості.

  **Чому ADC1, а не будь-який пін.** `CHARGE_ISENSE_PIN`/`CHARGE_VSENSE_PIN`
  мусять бути GPIO32–39: ADC2 (0, 2, 4, 12–15, 25–27) не читається при
  увімкненому Wi-Fi, а точка доступу тут піднята завжди. Обрані 34 і 35 ще й
  **вхід-тільки** — вимірювальну лінію фізично неможливо продавити назовні.

  **Третій сигнал — enable САМОГО ПАКЕТА** (`PULLUP_PIN`): пакет фізично не
  прийме струм, доки не піднято той самий сигнал, що й для читання/запису
  пам'яті. `chargeStart()` піднімає його одразу й тримає весь час заряду.

  **Регулятор** — струмове регулювання прямо в шпаруватості: щоопитування
  порівнюємо виміряний середній струм з уставкою профілю й зсуваємо
  шпаруватість у потрібний бік кроком, **пропорційним похибці** (від
  `CHARGE_DUTY_STEP` = 2 до `CHARGE_DUTY_STEP_MAX` = 64). Пропорційність тут
  не заради швидкості: стартова оцінка спирається на індуктивність і сумарний
  опір, а обидва відомі приблизно — і саме змінний крок робить контур
  байдужим до цієї похибки (промах закривається за ~13 опитувань замість
  сотень).
  Стеля — `CHARGE_DUTY_MAX_PCT` (85 %), затиснута в найнижчій точці
  (`chargeSetDuty()`), тож навіть прямий виклик повз регулятор її не
  перевищить. Стеля розрахована так, щоб `D × Uживл` дотягувалось до цілі
  плюс падіння на шунті — це теж перевіряється на компіляції.

  **Профіль струму** — за відсотком заряду (шкала напруги `BATTERY_EMPTY_MV`
  `..BATTERY_FULL_MV`, та сама, що й скрізь у прошивці), при цілі **100 %**:

  | заряд | струм |
  |---|---|
  | 0 % | 200 мА |
  | 10 % | 400 мА (лінійно від 0 %) |
  | 50 % | 700 мА (лінійно від 10 %) |
  | 80 % | 1000 мА (лінійно від 50 %) |
  | 80–90 % | тримається на 1000 мА (плато) |
  | 90 % | **ступінчасто** (не лінійно) падає до 100 мА — дозаряд малим струмом до самої цілі |
  | 95–100 % | тримається на 100 мА до цілі |

  > ⚠️ **Стелю цієї таблиці задає КЛЮЧ, а не пакет.** Раніше тут стояло
  > 1500 мА — від схеми на MOSFET. Для B772M це 1.23 Вт при `Pc` 1.25 Вт, тобто
  > рівно на межі (див. тепловий бюджет вище). Змінюєте `CHARGE_MA_80` —
  > перевірка на компіляції перерахує розсіювання й не пропустить непосильне.

  **Ціль заряду обирається у відсотках** (50–100 %, крок 5) — не завжди
  повний пакет потрібен, а обривати струм на плато (1000 мА) замість
  плавного спаду шкідливо для банок. Тому точки перегину профілю (10/50/80/
  95 %) при обраній цілі T < 100 % масштабуються ПРОПОРЦІЙНО (`10·T/100`,
  `50·T/100`, `80·T/100`, `95·T/100` — з захистом від виродження, коли сусідні
  точки збігаються), зберігаючи форму кривої (розгін → плато → плавний
  спад): наприклад, ціль 80 % дає перегини на 8/40/64/76 % ЗАРЯДУ пакета, і
  заряд так само закінчується спадом струму перед самою ціллю, а не
  обривом. Мінімальна ціль — `CHARGE_TARGET_PCT_MIN` (типово 50 %) — нижче
  вже виродженим стає сам профіль. Логіка перерахунку —
  `chargeSetpointMaForPct(pct, targetPct)` у `charge.h`, перевірена на хості
  (`tools/charge_logic_check.cpp`) для декількох цілей окремо.

  Ціль сеансу переводиться у мілівольти лінійною шкалою (`impresMvFromPercent()`
  у `impres_format.h`, обернена до `impresPercentFromMv()`), не вище
  **8.2 В** (`CHARGE_TARGET_MV` — від верху шкали `BATTERY_FULL_MV` = 8.25 В
  віднині ВІДЧЕПЛЕНО навмисно; наприкінці заряду паливомір покаже ~97 %, і це
  норма, а не недозаряд — межа «100 %» на шкалі
  паливоміра). Аварійна зупинка — тепер відносна до ЦІЄЇ цілі, а не завжди
  до повного пакета: `targetMv + CHARGE_HARD_MAX_HEADROOM_MV` (типово
  +100 мВ понад обрану ціль) — заряд до 80 % зупиниться аварійно біля 80 %+
  100 мВ, а не десь під повним пакетом. Інші запобіжники — той самий набір,
  що й розряд: перегрів (45 °C), стеля часу (6 год), кілька невдалих читань
  монітора поспіль, сторожовий таймер (програмний + апаратний Task WDT),
  **піковий струм** (`CHARGE_PEAK_MA_MAX` — вершина пульсацій; злітає, коли
  дросель фактично випав із кола) і стеля шпаруватості `CHARGE_DUTY_MAX_PCT`, затиснута в
  найнижчій точці — `chargeSetDuty()`, тобто навіть прямий виклик повз
  регулятор її не перевищить. Заряд і розряд
  **не можуть іти одночасно** — старт одного перевіряє, що інший не
  виконується.

  **Якщо каналу LEDC не знайшлося** (`ledcAttachChannel()` не отримав
  вільний апаратний таймер) — заряд поводиться **інакше, ніж розряд**. Розряд
  у цьому разі відкочується на `digitalWrite`: ключ відкритий повністю,
  струм лише зростає, але розрядний резистор жорстко його обмежує, тож це
  безпечніше за мовчазну відмову. Для заряду такого відкату немає: понижувач
  без ШІМ вироджується у **пряме з'єднання живлення з пакетом** — 14 В на
  пакет 8 В через дросель, який на постійному струмі нічого не обмежує. Тому
  `chargeStart()` при `!chargePwmOk()` **відмовляє в старті** з чіткою
  помилкою. Діагноз видно
  одразу в `Serial`-логу при старті пристрою (`CHARGE: ... attach=OK` чи
  `FAIL`, з підказкою про ймовірну причину).

  Індикація: до `CHARGE_LED_TAPER_PCT` (типово 90 %) — плавне **зелене**
  дихання (`LED_CHARGE`, той самий механізм LEDC-дихання, що й розряд, лише
  без червоного — колір відрізняє процеси, а не малюнок); на фінальному
  відрізку — часте зелене блимання 2 Гц (`LED_CHARGE_TAPER`, «майже готово»).

  **Вибір цілі — на кожному клієнті окремо**, той самий принцип, що й ціль
  розряду: у вебі (`index.html`) і десктопному `.exe` (`usb_client/moto_gui.py`)
  — пресети 100/95/90/85/80 % кнопками + власне поле; на самому пристрої
  (де немає поля вводу) — окремий пункт меню «Ціль заряду», що йде по колу
  тими самими пресетами (`chargeCycleTarget()`, `OP_CHARGE_TGT` у
  `operations.h`) незалежно від клієнтських полів.

  API: `GET /api/charge` (стан, включно з `targetMv`/`targetPct`/
  `targetPctMin`/`hardMaxMv`), `POST /api/charge/start` (форм-поле `target`,
  0 або відсутнє = 100 %), `POST /api/charge/stop`; по USB — `CHARGE [%]`
  (старт, до обраного відсотка), `CHARGE STOP`, `CHARGE ?` (стан). Картка в
  вебі — «🔌 Калібрування» разом із розрядом.

  > ⚑ **Поточний обсяг.** Керування, запобіжники, API, картка в веб-інтерфейсі,
  > USB-сторінка, `.exe`-клієнт і сторінка на самому дисплеї — готові й
  > перевірені (`tools/charge_logic_check.cpp` — профіль струму, регулятор,
  > стартова точка понижувача, відсічки; `tools/session_guard_check.cpp` —
  > що виклики з `web_server.h` нікуди не поділись). Сам ESP32-код
  > (`web_server.h`/`charge.h`/`discharge.h`) на хості не компілюється, як і
  > решта Arduino-обв'язки, — реальною платою це підтверджує власник.

- **🧠 Два профілі й ручні уставки** — і в заряду, і в розряду. Перемикач стоїть
  у всіх трьох клієнтах і в меню пристрою.

  **Заводський** профіль — той, що описаний вище: струм за відсотком заряду,
  однаковий для будь-якого пакета.

  **Розумний (CC/CV для 2S)** рахує все від **паспортної ємності самого
  пакета** — вона береться з дампа монітора, а не задається наосліп:

  | фаза | коли | струм |
  |---|---|---|
  | **передзаряд** | нижче 6.00 В (`CHARGE_SMART_PRE_MV`) | 0.1C |
  | **CC** | до `ціль − 250 мВ` | 0.5C, але не вище стелі заліза |
  | **CV** | останні 250 мВ до цілі | лінійно спадає від 0.5C до 0.05C |
  | **готово** | струм ≤ 0.05C п'ять опитувань поспіль | — |

  Для пакета 2500 мА·год це 250 / 1000 / 125 мА, для 1300 — 130 / 650 / 65 мА.

  > ⚑ **Чому «постійна напруга» зроблена струмом.** Залізо керує **струмом**,
  > напруги воно не тримає. Тому в останніх 250 мВ уставка струму лінійно
  > спадає й **рівно на цілі дорівнює порогу завершення**: що ближче напруга до
  > цілі, то менший струм у неї йде — напруга сама впирається в ціль і стоїть.
  > Підлога уставки й поріг завершення — навмисно **одне й те саме число**:
  > якби підлога була вищою, струм ніколи не впав би нижче порога й режим не
  > завершився б **ніколи**.

  > ⚑ **Заряд закінчується за СТРУМОМ, а не за напругою.** «Напруга торкнулась
  > 8.2 В» — це не кінець заряду літію, а початок його останньої фази: у цю
  > мить у пакеті ~70…80 % ємності. Тому розумний профіль після дотику цілі
  > **не зупиняється**, а дозаряджає на постійній напрузі. На моделі пакета
  > 2500 мА·год повний цикл від 6.50 В: **2.5 год, 2175 мА·год**, ціль не
  > перевищена жодного разу.

  **Температура.** Вікно 0…45 °C, і рахується воно в **десятих градуса** — цілі
  ховають −0.1 °C, і заряд на морозі пішов би як штатний. Нижче +10 °C струм
  зменшується вдвічі: на холоді літій приймає заряд гірше.

  **Розумний розряд** — дзеркало того самого: 0.2C від паспортної ємності,
  плавний спад в останніх 300 мВ до цілі, своє температурне вікно
  (−10…45 °C).

  **Ручні уставки** — окремий шар **над** профілем, а не замість нього: струм
  заряду, ціль у вольтах і струм розряду. `0` завжди означає «віддати рішення
  автомату». Межі рахує `settings.h` (ручна ціль **не може** бути вищою за
  заводську — аварійна межа сеансу рахується від неї).

  > ⚑ **Ручне не може ПІДНЯТИ струм наприкінці.** У фазі дозаряду/спаду
  > береться **менше з двох** — ручного й автоматичного. Інакше ручні 1000 мА
  > тримали б повний струм рівно там, де його треба прибирати.

  API: `POST /api/charge/mv` (`mv`), `POST /api/charge/profile` (`p` = 0/1),
  `POST /api/discharge/ma` (`ma`), `POST /api/discharge/profile`; старт обох
  приймає `mv`/`ma`/`profile` полем. По USB — `CHARGE MV=<мВ>`,
  `CHARGE SMART|AUTO`, `DISCHARGE MA=<мА>`, `DISCHARGE SMART|AUTO`.
  Перевірено `tools/smart_check.cpp` (75 перевірок + повний цикл на моделі).

- **⏳ Скільки ще лишилось** — рахує **пристрій**, один раз, і віддає всім трьом
  клієнтам: інакше кожен рахував би по-своєму й показував інше число. Формула
  чесно проста — залишок ємності поділити на струм, який іде **зараз**; у фазі
  CV оцінка подвоюється, бо струм там спадає сам.

  > ⚑ **Нуль означає «не знаю», а не «зараз закінчиться».** Оцінка підписана
  > «≈», а неправдоподібно велика (більша за стелю часу сеансу) не показується
  > **взагалі**: вигадане число гірше за відсутнє — на нього почнуть
  > розраховувати.

  Заряд, розряд і пробудження показані **однаковим каркасом** — і на дисплеї
  (обидва драйвери), і у вебі, і на USB-сторінці, і в `.exe`: ті самі вісім
  величин на тих самих місцях, крива напруги за сеанс, коридор уставки струму
  з рискою, час однією парою «минуло / ≈ лишилось».

  У пробудженні три останні плитки **міняють підпис**, а не ховаються: DS2438
  там мовчить, тож замість лічильника, температури й паливоміра стоять «проб
  монітора», прочерк і «межа ШІМ».

  > ⚑ **Чому підпис, а не приховування.** Сітка, що перебудовується, змушує
  > щоразу шукати величину заново — а дивляться на неї годинами. З тієї ж
  > причини порожньої плитки немає ніде: порожнеча в спільній сітці читається
  > як «дані не дійшли», тому у слоті «фаза» під час пробудження стоїть слово
  > `ПРОБУДЖЕННЯ`.

  Каркас **спільний у коді**, а не «схожий на вигляд»: у вебі це
  `opTiles()`/`opTileHead()`/`opBand()`/`opSpark()`, в `.exe` — один клас
  `OpMonitor`. Склад і порядок плиток звіряє між **трьома** клієнтами
  `tools/client_audit.py`.

- **🩺 Примусове пробудження пакета, що НЕ ЧИТАЄТЬСЯ** — другий режим тієї ж
  машини заряду, для випадку «після заміни елементів пристрій не бачить ні
  DS2438, ні DS2433». Контролер захисту всередині пакета лишається
  заблокованим і не відпускає клеми, доки не побачить зовнішню зарядну
  напругу; поки він мовчить — мовчать і обидва чипи, а звичайний заряд
  відмовляє, бо без DS2438 немає температури. Повний опис — у §10,
  «Блокування після заміни елементів».

  **Це джерело НАПРУГИ, а не струму** — головна відмінність від штатного
  заряду. Пакет із кола вимкнений власним ключем, струму немає й бути не може,
  і струмовий регулятор, не бачачи струму, вигнав би шпаруватість у заводську
  стелю 85 % — тобто виклав би на клеми ≈11.9 В, які опинилися б на банках 2S
  тієї ж миті, коли контролер замкне ключ. Тому напругу задає **стеля
  шпаруватості** (`chargeSetDutyCap()` у `charge.h`), і живе вона в
  `chargeSetDuty()` — у найнижчій точці, тож діє на будь-який шлях, включно з
  прямим викликом повз регулятор. Заводська межа лишається другим рядком
  оборони. Це єдиний запобіжник, що працює навіть коли вимір струму бреше.

  **Дозвіл працювати без датчика температури тримається на енергії, а не на
  обережності**: `CHARGE_WAKE_MAH_MAX` (8 мА·год = 0.3 % ємності пакета) і
  `CHARGE_WAKE_MAX_S` (120 с). Обидві межі, а також співвідношення між ними,
  перевіряються `#error` у `settings.h`. Крок машини — `CHARGE_WAKE_POLL_MS`
  (50 мс, у 20 разів частіший за штатний): увесь ризик режиму зосереджений в
  одній миті, коли контролер замикає ключ і на місці розімкненого кола
  з'являється навантаження; найгірший стрибок (розряджені вщент банки під
  8.0 В через 0.78 Ом) — 2.6 А, і 50 мс лишають на шунті 0.16 Дж замість
  3.3 Дж на штатній секунді.

  **Режим відмовляється запускатись, якщо пакет ЧИТАЄТЬСЯ** — це головна
  відмова з усіх: без неї «пробудження» тихо перетворилося б на «заряд без
  контролю температури». Решта відмов — пробитий ключ (струм або напруга
  живлення на закритому ключі), несправне живлення, вже присутня напруга на
  клемі, зайнятий ключ.

  API: `POST /api/charge/wake` (без параметрів — усі межі задає `settings.h`),
  зупинка — тим самим `POST /api/charge/stop`; по USB — `CHARGE WAKE`; на
  пристрої — пункт меню «Пробудження». Стан їде в тому ж `/api/charge`
  (`wake`, `wakeMv`, `wakeMa`, `wakeMaxS`, `wakeMahMax`, `wakeProbes`,
  `dutyCap`), і всі три поверхні ховають поля, джерелом яких є мовчазний
  DS2438: «CCA 0» і «темп. 0.0 °C» — це не дані, а їхня відсутність.

- **🕹 Три кнопки на одному ADC-піні** — звільняє GPIO25/26 (наприклад, під
  DAC для схеми заряду вище). За замовчуванням (`MENU_BTN_ADC_PIN` у
  `settings.h`) — аналогова драбинка на GPIO33 (ADC1, безпечний з увімкненим
  Wi-Fi, на відміну від ADC2): підтяжка 10 кОм до +3.3В, кнопки на землю —
  «Ввід/OK» напряму (0 Ом), «Вліво» через 5 кОм, «Вправо» через **20 кОм**
  (немає такого номіналу під рукою — увімкніть два 10 кОм послідовно).
  Номінали підібрані так, щоб усі чотири рівні лягали РІВНОМІРНО (0 / 1100 /
  2200 / 3300 мВ) — це дає однаковий запас **±550 мВ на кожному порозі**,
  а не лише на крайніх. Пороги розпізнавання (`MENU_BTN_ADC_TH_*`) рахуються
  з номіналів автоматично.
  Стара схема (три окремі GPIO) лишається в коментарі в `settings.h` —
  розкоментуйте її замість драбинки, якщо повертаєтесь до дискретних кнопок.
  Уся логіка меню (навігація, довге/коротке натискання, режим розряду)
  працює **без змін** — драбинка лише підміняє, ЯК зчитується «натиснуто»
  (`btn1Raw/btn2Raw/btn3Raw` у `display.h`/`display_color.h`), а не саму
  поведінку кнопок.

  > 🐞 **Виправлена помилка.** На частині безіменних/клон-плат у eFuse не
  > прошита заводська калібровка ADC (ні Two-Point, ні Vref). Використаний
  > спершу `analogReadMilliVolts()` апаратно залежить від цієї калібровки:
  > без неї ESP-IDF на КОЖНОМУ виклику (тобто на кожен прохід `loop()`) валив
  > у Serial `adc_cali: adc_cali_create_scheme_line_fitting(): default vref
  > didn't set` і повертав невалідні мВ — саме це й давало «кнопки не
  > працюють» і самовільне перемикання сторінок одразу при старті. Замінено
  > на `analogRead()` (сирий 12-бітний відлік, без жодної апаратної
  > калібровки) з лінійним перерахунком у мВ самотужки (0..4095 → 0..3300):
  > при запасі ±550 мВ на кожному порозі похибка нелінійності ADC (десятки
  > мВ) не має значення.

- **🎵 Звук — квазі-меандр на ЦАП замість ШІМ** — використала звільнений
  GPIO25 під `BUZZER_DAC_PIN`. DDS-синтез
  (256-крокова таблиця + фазовий акумулятор в ISR апаратного таймера на
  16 кГц, `dacWrite()`) замість `ledcWriteTone()`. Повільне вібрато (~5 Гц,
  ±0.6 % частоти, «живий» перелив) рахується окремо в `buzzTask()`. Уся
  логіка фраз/портаменто/огинаючої (§7) лишилась без змін.

  > 🐞 **Виправлена помилка.** Перша версія грала чистий синус (+ тиха 2-а
  > гармоніка) — власник підтвердив залізом: звук ледь чутний на пасивному
  > п'єзо. Причина фізична: п'єзоелемент — механічний резонатор, і його
  > збуджує швидка ЗМІНА напруги (dV/dt), а не сама напруга; синус на
  > звукових частотах змінюється значно повільніше меандра, тож при тій
  > самій цифровій амплітуді звучить помітно тихіше. Таблицю замінено на
  > «квазі-меандр» — зрізаний ряд Фур'є (1-а + 1/3 3-ої + 1/5 5-ої
  > гармоніки, той самий принцип, яким зі синусоїд будують square-wave):
  > суттєво більше «крутих» фронтів і енергії саме в діапазоні типового
  > резонансу п'єзо (2–4 кГц), де сигнал і так найкраще перетворюється у
  > звук — але сигнал лишається безрозривним, не голим меандром (який і
  > був причиною різкості до переходу на ЦАП). Мало й далі — піднімайте
  > повзунком «Гучність» у веб-інтерфейсі (до 255): це живе налаштування,
  > заводський `BUZZER_VOLUME` (150) навмисно НЕ підняли — вищий дефолт
  > збільшує й абсолютний крок огинаючої що 5 мс (дрібні сходинки чутні на
  > ШІМ-варіанті).

  Стара ШІМ-схема на будь-якому вільному GPIO лишається резервним варіантом
  (`BUZZER_PIN` замість `BUZZER_DAC_PIN` у `settings.h`) — вона й лишається
  найгучнішою (справжній меандр на повний розмах), якщо квазі-меандра
  все одно не вистачає, а звільняти GPIO25/26 непринципово.

  Перевірено на хості (без апаратного ЦАП немає, тож перевіряється сама
  логіка): `tools/buzzer_dac_check.cpp` крутить СПРАВЖНІЙ `buzzTask()`+
  `buzzIsr()` у модельному часі, звіряє видану DDS-частоту з очікуваною
  (заміром переходів через центр шкали) і рендерить WAV, щоб послухати.
  `tools/buzzer_ledc_check.cpp` — той самий прогін для резервної ШІМ-схеми
  (примусово вмикає `BUZZER_PIN`, незалежно від того, що зараз обрано в
  `settings.h`), лишений для регресії старого шляху.

- **⚠️ «Відновлення еталона»**: за замовчуванням переносить **лише модельну
  частину** шаблону, лишаючи навчений хвіст стертим. Шаблони в `templates.h` —
  побайтові копії конкретних АКБ, і побайтовий запис віддає новому пакету **чужу**
  навчену калібровку (`dumps/08-nova-batareya` — саме такий випадок: рація сказала
  «невідомий акумулятор»). Побайтовий режим лишився для аналізу:
  `RESTORE <МОДЕЛЬ> VERBATIM` / `verbatim=1`.

### Правки еталона під конкретний пакет

Модельна частина шаблону однакова в усіх екземплярів моделі — її переносити
треба. Але разом із нею шаблон несе й числа **донора**, з якого знято копію:
його рівень заряду, його шунт, його калібрування нуля АЦП. Записати їх у чужий
пакет — значить збрехати рації й зарядній станції.

Тому перед записом пристрій складає **план правок** (`restore_plan.h`) і показує
його таблицею «еталон / цей пакет / буде записано» — у вебі, USB-клієнті та
`.exe`. Галочку з будь-якої правки можна зняти:

| Правка | Ключ | Типово | Звідки береться |
|---|---|---|---|
| Рівень заряду (паливомір) | `charge` | ✅ | з **виміряної зараз напруги** пакета |
| Шунт вимірювача струму | `rsense` | ✅ | `DS2438[56..57]` самого пакета — **або вручну / з бібліотеки еталонів** |
| OFFSET АЦП струму | `adcoff` | ✅ | `DS2438[0x0D..0x0E]` самого пакета |
| Наробіток (дата 1-го користування) | `etm` | ❌ | `DS2438[8..11]`; вимкнено — лічильник із нуля |
| Паспортна ємність | `rated` | ❌ | `DS2433[0x008]`, якщо пакет каже інше — **або вписана вручну** |
| Дати, лічильники й знос під ROM цього чипа | `crypt` | ✅ | перешифрування зашифрованих блоків DS2433; дату виготовлення, дату запуску, знос і калібрування можна вписати вручну |
| Лічильники циклів | `hist` | ❌ | цикли IMPRES (гістограма) і не-IMPRES — без шифрування |

> 🐞 **Виправлена помилка.** Раніше рівень заряду рахувався **після** того, як
> шаблон затирав буфер монітора, тож у пакет писалась напруга донора. На парі
> «еталон PMNN4409B + реальний пакет» це давало **100 % замість 77 %**: у
> розряджений акумулятор записувалось «повний».
>
> Заряд і шунт рахуються **узгоджено**: якщо галочку шунта зняти, паливомір
> перерахується під шунт еталона — інакше число записалось би за одним шунтом,
> а читалось за іншим.

**Поставили банки іншої ємності?** У рядку «Паспортна ємність» є поле для
ручного введення. Взяти нову ємність нізвідки — ні з монітора, ні з битого
DS2433, — тож її вписують. Число округлюється до кроку 25 мА·год (байт `0x008`
зберігає саме `мА·год / 25`) і затискається в 1000–6000. Головне: **за новою
ємністю одразу перераховується паливомір** — 77 % від 3000 мА·год це вже інший
ICA, ніж 77 % від 2150. Порожнє поле — лишити як є.

**У пакеті немає шунта?** Так буває, коли монітор «чистий»: `DS2438[56..57]`
нулі, і типовій правці «взяти зі свого пакета» брати нічого — а без шунта не
рахуються ні струм, ні залишок, ні знос. Тому в рядку «Шунт вимірювача струму»
є два способи задати його самому:

* **з бібліотеки еталонів** — список моделей із їхнім опором
  (`PMNN4488A — 24.90 мОм`, `PMNN4409B — 45.65 мОм`, …). Шунт розпаяний на
  платі й однаковий у всіх екземплярів моделі, тож це найточніше, що можна
  зробити без вимірювання;
* **вручну, у мОм** — коли опір зміряли міліомметром або він відомий із плати.
  Затискається в 1–200 мОм (у чипі це `Ом × 100000`).

Два поля **гасять одне одного**: обраний зі списку еталон стирає введене число
і навпаки — інакше на екрані було б одне, а в чип пішло б інше. Заданий шунт
вмикає правку одразу (це вже свідома дія) і **головніший за будь-який
запасний варіант**: якщо власник обрав опір сам, автоматичне доливання з
еталона моделі не спрацьовує.

> Заданий шунт одразу перераховує **паливомір**: ICA — це заряд, поділений на
> опір шунта, тож 77 % при 25 мОм і при 46 мОм — різні числа в чипі.

API: `&rsense=<мОм×100>` або `&rsmodel=<МОДЕЛЬ>`; по USB — `RSENSE=4565` /
`RSMODEL=PMNN4488A`. Бібліотеку клієнт отримує в плані полем `rsLib`.

### Перешифрування під ROM цього чипа

Частина полів DS2433 **зашифрована**, і ключ береться з ROM-ID самого чипа:
`key1 = ROM[1]`, `key2 = ROM[6]` (значущі лише нижній нібл першого й верхній
нібл другого). Зашифровані три блоки: `DATE` — дати виготовлення й першого
користування, `CYCLE` — лічильники й дні заряду, `RECOND` — калібрування,
потенційна ємність і знос.

Еталон у `templates.h` знято з **чужого** акумулятора, тож його зашифровані
поля зашифровані ROM'ом донора. Рація, читаючи такий пакет, розшифрує їх
**своїм** (правильним для неї) ключем і отримає сміття. На реальному пакеті
власника (`dumps/16-verbatim-4409a-chuzhyi-kliuch`, ROM DS2433 =
`A3427C17010050A6`) це виглядало так:

| Поле | Що читає рація | Що там насправді |
|---|---|---|
| Дата виготовлення | `2107-13-21` — **тринадцятий місяць** | `2014-05-22` |
| Перше користування | `0000-00-00` | `2014-11-11` |
| Цикли | 3548 | 725 |
| Знос | 76 % | 34 % |

Цикли з гістограми — **не шифровані** — 1097. Значення 3548 їх перевищує, тобто
фізично неможливе: це й є ознака чужого ключа.

Шифрування **повністю оборотне** (перевірено кругово: всі 256 ключів, цілі — 0
помилок, дати — 0 помилок із 2 146 560 комбінацій). Правка `crypt` розшифровує
поля ключем, яким вони зашифровані **зараз**, і шифрує назад ключем **цього**
чипа. Числа не міняються — міняється лише те, хто здатен їх прочитати.

* Ключ вмісту визначається підбором (`impresBmsFindKey`), і перевірки в ньому
  спираються **лише на незашифровані дані** — гістограму циклів, ETM, CCA,
  паспортну ємність. Підробити результат неможливо.
* Правка доступна **тільки на живому чипі**: для дампа з файлу ROM невідомий, а
  без нього перешифровувати нема під що.
* Якщо ключ вмісту вже збігається з ROM чипа — правку не пропонуємо.
* 🐞 **Виправлено.** Коли ключ вмісту не визначається взагалі — а саме так
  виглядають поламані пакети (`dumps/06,07,08,15`: блоки на місці, вміст ні з
  чим не узгоджений), — правка ставала недоступною **назавжди**, і вписана
  вручну дата теж нічого не міняла. Колонка «що бачить рація» при цьому мовчала,
  хоча для неї потрібен лише ROM чипа. Тепер: колонка рахується завжди, правка
  доступна, і в цьому режимі вона пише **лише вписану дату** — лічильники, яких
  ми не змогли розшифрувати, лишаються недоторканими.
* Поле **дати виготовлення** дозволяє вписати її вручну: на «свіжому» хвості
  (після звичайного відновлення блоки обнулені) взяти її нізвідки, а нулі
  розшифровуються у безглузде `1999-10-00`.
* Поле **зносу (здоров'я)** — те саме для стану банок.

#### Запис зносу / здоров'я

Знос лежить у тому ж зашифрованому блоці `RECOND` — це байт `CTS`, потенційна
ємність пакета в одиницях ICA. Рація рахує його так:

```
мА·год = 0.48828125 · CTS / шунт
знос %  = 100 · мА·год / паспортна ємність
```

Зворотне перетворення точне — звірено на реальному пакеті: знос 34 %, ємність
2150 мА·год, шунт 0.04517 Ом дають `CTS = 68`, і саме `68` лежало в чипі.
Кругова перевірка 5…100 % — **похибка округлення 0 %**.

> ⚠️ Знос залежить і від **шунта**, і від **паспортної ємності**. Тому `CTS`
> рахується тими значеннями, які РЕАЛЬНО опиняться в чипі після всіх правок —
> інакше вписані 80 % прочитались би як інше число. Перевірено: 80 % при шунті
> 45.17 мОм це `CTS 159`, при 24.98 мОм — `CTS 88`, і рація в обох випадках
> читає 80 %.

Після заміни елементів реальний знос знає лише той, хто ставив банки, — тому це
поле для ручного введення (1…100 %). Якщо блок `RECOND` прочитати не вдалося,
разом із `CTS` записується й «ємність при першому використанні» (та сама): пакет
із новими елементами саме такий і є.

API: `&health=80`; по USB — `HEALTH=80`.

#### Дата першого запуску й калібрування

У тому ж зашифрованому блоці лежать ще два поля:

* **Дата першого запуску** — у чипі це не дата, а **скільки діб минуло від
  виготовлення**. Тому вона рахується від тієї дати виготовлення, яка реально
  піде в чип: правити їх окремо не можна. Разом із нею пишеться й
  поле-близнюк за зсувом `+5..+6`: у 40 дампах із 43 воно побайтово дорівнює
  основному, тож лишати їх розбіжними було б неправдою.
* **Калібрувань пройдено** — блок `RECOND`. Нуль тут повноцінне значення
  («жодного»), саме воно й потрібне після заміни елементів.

API: `&use=20210901&cal=0`; по USB — `USE=20210901 CAL=0`.

#### ⚠️ Зарядна станція переписує наробіток

Правка наробітку тримається рівно до **першого циклу на ЗП**: станція пише в
`ETM` своє число. Це видно в корпусі:

| Дамп | Наробіток до | Наробіток після циклу на ЗП |
|---|---|---|
| `dumps/13-dozaryadka-na-stantsii` | 234 с (щойно обнулили) | 79 773 372 с = **923 доби** |
| `dumps/06-pislya-rekalibruvannya` | — | 1 575 798 054 с = **49 років** |

Тому **наробіток правлять ПІСЛЯ калібрування, а не до нього.** Попередження
про це стоїть просто в картці DS2438: воно спрацьовує, коли наробіток більший
за вік пакета, і називає обидві можливі причини — чужий монітор або цикл на ЗП.

Заодно тепер перевіряється й **сам запис**: сторінку 1 (`ETM`) читаємо назад із
допуском у 30 с (чіп крутить лічильник далі). Доти невдалий запис `ETM` не
помічав ніхто — він виявлявся аж на рації, неправильною «датою першого
користування».

#### Наробіток: автоматично з дати першого запуску

Записаної в `DS2433` дати мало. **Рація не читає її для рядка «дата першого
користування»** — вона показує `зараз − ETM`, де `ETM` — лічильник наробітку в
`DS2438[8..11]` (секунди). Тож поки наробіток лишається старим, рація показує
одну дату, а фірмове ПЗ (яке читає `DS2433`) — іншу, і два вікна суперечать
одне одному.

Тепер наробіток рахується сам:

```
ETM = (сьогодні − дата першого запуску) × 86400
```

Дата першого запуску береться вписана вручну, а якщо її не вписували — та, що
вже лежить у чипі. Вписана дата **одразу** переводить наробіток на себе:
інакше людина ввела б дату й нічого б не змінилось. Повернути власний
наробіток пакета можна списком «звідки брати» в рядку правки; зняти правку
зовсім — означає почати лічильник з нуля (пакет із новими елементами — новий).

##### Звідки береться «сьогодні»

Джерело один — **системний годинник пристрою** (`time()`), і саме з нього дату
бере вся прошивка: і веб, і USB, і меню самого приладу. Заводить його клієнт.

Інакше не виходить: RTC в ESP32 немає, а NTP тут недосяжний **за побудовою** —
пристрій сам є точкою доступу (`WiFi.softAP`), інтернету за ним немає. Зате
браузер і ПК дату знають завжди, тож кожен запит плану чи запису несе
`today=РРРРММДД`, і перший такий запит ставить годинник.

| Джерело (`todaySrc`) | Що це означає |
|---|---|
| `client` | дату щойно повідомив клієнт — точна |
| `saved` | відновлена з SPIFFS після перезавантаження — **відстає** рівно на час, поки пристрій був без живлення; перший клієнт її виправляє |
| `none` | годинник не заведено: клієнт ще не приходив, файлу немає. Наробіток із дати тоді не рахується взагалі — правка пропонує лише власний наробіток пакета |

Дата зберігається в `/clock.cfg` і піднімається при старті (`deviceClockLoad()`
у `setup()`), щоб пристрій не лишався зовсім без неї. Час ставимо на **полудень**,
а не на північ: тоді ані дрейф кварцу, ані різні часові пояси клієнта й
пристрою не здатні зсунути ДАТУ на добу — перевірено на ±11 годин.

> 🆘 Якщо сторінка не відкривається — відкрийте **`http://192.168.4.1/lite`**:
> це аварійна сторінка на 1.7 КБ, вона доходить майже завжди й одразу показує
> відбиток збірки (чи та прошивка в пристрої), стан пам'яті та головні
> показники АКБ.
>
> 🔍 Те саме числами — `http://192.168.4.1/api/fs`:
> там видно, що лежить у SPIFFS і скільки місця зайнято. Сама сторінка вшита в
> прошивку й від файлової системи не залежить; файл `/index.html.gz` у SPIFFS
> лише ПЕРЕКРИВАЄ її. Звідки взято сторінку, пристрій друкує в Serial при старті.

Прочитати чи виставити її окремо: `GET /api/clock`, `POST /api/clock?today=…`;
по USB — `CLOCK` і `CLOCK 20260803`.

> ⚑ «Кожен запит плану» — це справді кожен. Синхронізація дзеркала була
> винятком: дати вона не несла й тому мовчки лишалась без перевірки віку
> пакета — а «попередження немає» читається як «усе гаразд». Тепер `today=`
> приймають `/api/mirror`, `/api/mirror/edit`, `/api/mirror/apply` і команда
> `MIRROR … TODAY=`. Нова дата оновлює лише свідчення про наробіток, а план не
> перебудовує: галочки розставила людина, і настання нової доби не сміє їх
> скинути.

> Саме тому наробіток рахується й там, де клієнта немає взагалі: у **меню
> самого приладу** й у Майстрі, запущеному з екрана. Раніше такий шлях просто
> не мав що покласти в «сьогодні».
>
> Дата в майбутньому дає **нуль**, а не від'ємне число; наробіток понад 20
> років вважається сміттям і не рахується. Правка доступна лише тоді, коли
> `DS2438` прочитано: писати наробіток більше нікуди.

API: `&today=РРРРММДД&etmsrc=1` (`1` — рахувати з дати запуску, `0` — лишити
власний); по USB — `TODAY=20260803 ETMSRC=USE|PACK`.

#### Лічильники циклів (без шифрування)

Окрема правка `hist`, бо ці два числа **ключа не потребують** — саме тому
фірмове ПЗ показує їх завжди:

| Поле | Де лежить |
|---|---|
| Циклів заряду **IMPRES** | гістограма доданого заряду (блок `ADDED`): нульовий кошик несе саму суму, решта дев'ять — розподіл |
| Циклів **не-IMPRES** | блок `NONSMART`, зсув `+7`, звичайне 16-бітне число |

Читання гістограми: якщо нульовий кошик ≥ суми решти, він і є відповіддю. Отже
щоб записати N, досить покласти туди N — але поки решта не більша за N. Якщо
більша, розподіл **масштабується зі збереженням форми**, інакше формула
повернула б суму всіх кошиків замість N. Перевірено кругово: **0…3000 циклів
читаються назад точно**.

Нуль в обох полях — «пакет як новий». Правка вимкнена за замовчуванням:
скидати чи ні «вік» пакета — вибір власника.

API: `&cyc=0&nonimp=0`; по USB — `CYC=0 NONIMP=0`.

#### Знос окремою карткою

Правка зносу є і в плані «Ремонту», але після заміни елементів міняти доводиться
саме її, тож вона винесена й окремою карткою **«🩺 Знос / здоров'я»** поруч із
«Ємність» і «Дата». Рахунок і запис — **тим самим кодом** (`restore_plan.h`),
щоб два входи не розійшлися: знос залежить і від шунта, і від паспортної
ємності, і власна копія формули одного дня дала б інший `CTS`.

Старий байт заводської таблиці `0x129`, який раніше займав цю картку, згорнуто
в «для аналізу»: він однаковий у всіх екземплярів моделі, тож показань рації
не міняє — про що картка чесно й писала.

API: `POST /api/sethealth?pct=80`; по USB — `SETHEALTH 80`.

> 🐞 **Виправлена помилка: на здоровому пакеті знос не записувався.** Правка
> «дати й лічильники» пропонувалась лише коли ключ **чужий** або не
> визначається — тобто коли є що лагодити. Але записати знос теж можна лише
> через перешифрування, тож на пакеті зі СВОЇМ правильним ключем вписане число
> мовчки нікуди не йшло, хоча картка обіцяла «поля нижче все одно можна вписати
> вручну». Тепер правка доступна й тоді, коли лагодити нічого, а вписати —
> є що (`crypt_check`, розділ 12).

#### Підстановка з прочитаного акумулятора

Вводити наосліп те, що прилад уже прочитав, немає сенсу, тож під полями є дві
кнопки:

* **📥 Узяти з акумулятора** — заповнює всі шість полів тим, що ЗАРАЗ у пакеті:
  дата виготовлення, дата першого запуску, знос, калібрування, цикли IMPRES і
  не-IMPRES. Далі будь-яке з них можна виправити руками.
* **✖ Очистити поля** — повертає всі поля в «лишити як є».

> ⚠️ Підставляється **лише те, що справді відоме**. Якщо ключ вмісту не
> визначається, зашифровані числа — сміття: заповнити ними поля означало б
> записати це сміття назад, уже під ПРАВИЛЬНИМ ключем, і воно перестало б
> виглядати помилкою. Тому в цьому випадку підставляються тільки лічильники
> циклів (їм ключ не потрібен), а решта полів лишається порожньою — про це
> сказано просто в картці.

API: `&mfg=РРРРММДД`; по USB — `MFG=20140522`. Правка пише в DS2433 і йде
**останньою**: вона лагодить суми своїх блоків, і будь-яка правка після неї ці
суми знову зламала б.

> 🐞 **Виправлена помилка: рація не бачила АКБ після відновлення.** Еталон
> `DS2438` у `templates.h` — теж побайтова копія одного пакета. Відновлення
> заміняло ним монітор робочого акумулятора цілком і повертало назад лише шунт
> та OFFSET АЦП. Решта — байти `0x10–0x17`, `0x32–0x35`, `0x3A–0x3B`, значення
> яких ми не розбирали, — ставала донорською: на реальній парі **20 чужих байтів
> із 64**. Ідентичність при цьому правильна, а монітор — від іншого екземпляра;
> саме так і виглядала скарга «нова рація не бачить АКБ, стара бачить, але
> рівень заряду неадекватний».
>
> Тепер шаблон монітора беруть **лише** тоді, коли свого немає: чіп не
> читається або порожній (усе `0x00` чи все `0xFF`). Інакше
> монітор пакета лишається своїм, а операція робить рівно те, що обіцяє —
> обнуляє лічильники й виставляє паливомір. Після виправлення в моніторі
> змінюються тільки навмисні поля: ETM, ICA, CCA, DCA.
>
> ⚠️ **Перша спроба цього виправлення не спрацювала** саме на тому пакеті, з
> якого почалась скарга. «Свій монітор» тоді визначався як «є заводський шунт»,
> а в тому пакеті шунт був **занулений** — тож монітор вважався чужим і його
> знову заміняли еталоном цілком (`dumps/15-pislya-etalona-ne-vyznaietsya`).
> Тепер «свій» — це просто «не порожній», а відсутній шунт доливається
> **окремо**, одним полем, із гучним попередженням у Serial. І, головне,
> задати шунт можна самому (див. вище) — тоді ніякого доливання не буде.

### Станція сама починає добудову стертого DS2433

Скарга: «якщо вставити пакет зі стертим DS2433 у зарядний WPLN4226A —
прописується невелика частина пам'яті». Розбір наданого дампа:

```
DS2433[0x01..0x1A]  ==  DS2438[0x18..0x31]     26 із 26 байт — дзеркало на місці
DS2433[0x00]        =   0xFF                   не чіпано
Σ(0x00..0x1F)        =   0x00                   а треба 0x41 — суму станція НЕ виправила
DS2433[0x020..0x1FF] =   усе 0xFF                профілю, моделі, блоків немає
```

Тобто станція сама виконує **перший крок** нашого власного ремонту (дзеркало
→ заголовок) і на цьому зупиняється: сума лишається невірною, а решта чипа —
стертою. Це не «звичайний побитий заголовок» (там дзеркало або відсутнє, або
розходиться з DS2433) — тут дзеркало вже правильне.

Майстер тепер розрізняє цей стан окремо (`ISS_CHARGER_PARTIAL`, а не
загальний `ISS_HDR_BAD`) і пропонує **окремий перший крок «Добудувати
заголовок»**: копіює ті самі 26 байт (якщо ще не скопійовані) і виправляє
суму — не більше. Профіль і модель цим не відновлюються, тому крок чесно каже,
що робити далі: «Відновити еталон» (модель відома) або режим копії (ні).

Кнопка є і поза Майстром — у картці «🛠 Ремонт цілісності» всіх трьох
клієнтів. API: `POST /api/hdrfix`; по USB — `HDRFIX`.

Перевірено `tools/hdrfix_check.cpp` на дампі власника
(`dumps/19-stantsiya-dobudova`) і на всьому корпусі: детектор не плутає цей
стан ані зі звичайним побитим заголовком (дзеркало розійшлось, а не збіглось),
ані з повністю стертим чипом, і на 55 дампах корпусу спрацьовує **рівно
один раз** — на щойно доданому випадку.

### APLI4493C — сторонній аналог PMNN4493A

Модель додано у бібліотеку відновлення за дампом власника
(`dumps/18-apli4493c`). Розбір: заголовок Σ=0x41, профіль Σ=0x00, паспортна
ємність **3100 мА·год**, запис моделі `APLI4493C`, KIT-рядок у заголовку —
`PMNN4493A` (та сама платформа), 23 блоки, з них 19 із Σ=0x5A.

> ⚑ **Шунт свій — 22.12 мОм** проти 24.90 у PMNN4493A. Тому брати еталон
> 4493A для цієї моделі не можна: струм, залишок і знос вийшли б неправильні.
> Саме заради цього модель додано окремо, а не псевдонімом.

У `templates.h` лежить **очищена** версія: навчені значення донора в блоках
хвоста обнулені, суми перераховані (`TPL_APLI4493C_33` + `TPL_APLI4493C_FRESH`).
Чистить `tools/mktpl.cpp` — тим самим `impresBmsVector()`, яким блоки шукає
прошивка: наївний обчислювач адрес розходився з ним і чистив не ті блоки.
Сирий дамп «як прийшов» збережено в `dumps/`.

### Відновлення за зразком китайської копії — крайній засіб

Коли жодна інша спроба не вдалася, лишається шлях, яким ідуть самі копії.

**Чому це працює.** Сторінки 3–6 монітора — це **дзеркало заголовка DS2433**:
`DS2438[0x18..0x32]` побайтово дорівнює `DS2433[0x01..0x1B]` (звірено на рідній
парі 4409B — 27 із 27 байт; останні п'ять байтів заголовка в дзеркало не входять
і в кожного чипа свої). Серед збіжних — **байт паспортної ємності** `0x008`.
Тому копія з **порожнім DS2433** усе одно повідомляє рації свою ємність, а разом
із шунтом (`DS2438[56..57]`) і OFFSET це все, що їй потрібно.

Що робить операція:

1. пише монітор зі зразка копії;
2. обнуляє лічильники — наробіток, `CCA`, `DCA`;
3. паливомір бере з **реальної напруги** цього пакета, а не з чисел копії;
4. вписану вручну паспортну ємність кладе **в дзеркало** — саме звідти рація її й читає;
5. шунт бере з дампа або зі списку типових (45.65 / 24.90 / 25.00 мОм), якщо невідомий;
6. **DS2433 стирає** — як у копії.

> ⚗️ **Запис ідентичності в DS2433 — окремий, ЕКСПЕРИМЕНТАЛЬНИЙ крок** за
> бажанням власника: у справжньої копії цього немає взагалі. Каркас береться з
> еталона **родини 4409** (саме її шунт несуть монітори копій), а модель, дати
> й знос шифруються ключем із ROM-ID **цього** чипа.

> 🔎 **Уточнення про дзеркало.** Скільки байтів заголовка справді
> віддзеркалено — залежить від екземпляра: на рідній парі 4409B це 27 байт, на
> APLI4493C — 26, а на частині пакетів дзеркало взагалі не є копією заголовка.
> Тому код не покладається на довжину: несуче тут одне — **байт паспортної
> ємності** за зсувом +7, який збігається з `DS2433[0x008]` у **46 із 47** пар
> корпусу, де дзеркало є (виняток — `01-katalog-pershyi/10`, той самий
> екземпляр із нульовим заголовком, що його власник позначив як можливу копію).

**Вбудований зразок.** Дамп монітора реальної копії вшито в прошивку, щоб не
носити файл із собою: `CLONE_SAMPLES` в `impres_clone.h` — 8.02 В, шунт
45.65 мОм, OFFSET `0x0018`, дзеркало з ємністю 2150 мА·год. Свій файл або hex
теж можна: у клієнтах є і те, і те. Тест звіряє вшитий зразок із оригіналом
байт у байт — якщо він колись розійдеться, режим почне писати не те, що
перевірено.

**Скидання лічильників — окремим прапорцем.** Наробіток, `CCA` і `DCA` типово
обнуляються: числа копії до ваших банок стосунку не мають. Але це вибір
власника, тож прапорець є — інакше скидання було б прихованим побічним ефектом
запису, про який ніде не сказано.

**Корекція заряду після запису.** Паливомір рахується з напруги, виміряної
**до** запису — а вимірював її чіп, у якому ще стояли шунт і OFFSET копії.
Після запису шунт уже ваш, і той самий АЦП дає інше число. Тому монітор
перечитується, відсоток рахується ще раз за новими константами, і `ICA`
переписується, якщо змінився. Вимикається прапорцем.

API: `POST /api/clone?hex38=…&rated=…&rsense=…&model=…&mfg=…&use=…&health=…&id33=1&zero=0&recheck=0`,
`GET /api/clone/samples`; по USB — `CLONE <hex128> [RATED=] [RSENSE=] [MODEL=]
[MFG=] [USE=] [HEALTH=] [ID33=1] [ZERO=0] [RECHECK=0]` і `SAMPLES`.
Картка «🧬 Відновлення за зразком копії» — у «Небезпечній зоні» всіх трьох клієнтів.

Перевірено `tools/clone_check.cpp` на дампі копії власника й на рідній парі
4409B: зсув дзеркала 27/27, ємність із дзеркала збігається з ємністю з DS2433
(2150), лічильники обнуляються, ручні значення лягають куди слід, порожній
монітор чесно розпізнається як такий, що дзеркала не несе.

### 🐞 Вбудований зразок копії не з'являвся у списку (USB-міст)

Скарга: у картці «🧬 Відновлення за зразком копії» випадаючий список
«Вбудований зразок» лишався порожнім (лише «— свій файл або hex —») при
роботі через USB-міст (`moto_bridge.py` + `client_usb.html`).

Причина — `ReferenceError: esc is not defined`. `clLoadSamples()` у
`client_usb.html` викликала `esc(s.name)`, а функція екранування в цьому
файлі називається `wesc()` (`esc()` є лише в `index.html`) — копіпаст із
веб-клієнта без перейменування. Виняток кидався всередині `await
clLoadSamples()`, а той стоїть у ланцюжку `await refresh(); await
loadTemplates(); await sndLoad(); await clLoadSamples(); await disTick();`
одразу після підключення — тож обривався не лише список зразків, а й усе,
що йде за ним (`disTick()`).

Другий, окремий пропуск — саме в `moto_bridge.py`: інжектований `toggleConn`
(міст підмінює Web Serial на локальний HTTP, бо той працює лише в
Chrome/Edge) після вдалого підключення кликав тільки `refresh()` і
`loadTemplates()` — виклики `sndLoad()`, `clLoadSamples()`, `disTick()`, які
є в рідному обробнику `client_usb.html`, туди просто не потрапили при
написанні моста. Через первісну помилку `esc` це не було помітно — обидва
дефекти маскували один одного, поки `esc` не виправили.

Перевірено вручну: піднятий `moto_bridge.py` з підміненим (без реального
COM-порту) серійним шаром і Playwright-клієнтом, що клацає «Підключити» й
звіряє список `#clSample` — до фіксу підключення взагалі падало з тим самим
`esc is not defined`, після фіксу список наповнюється вбудованим зразком, а
вибір пункту показує примітку й ємність.

### Майстер перевіряє ЗМІСТ, а не лише структуру

Досі Майстер дивився на структуру: суми заголовка, запис моделі, дзеркало,
навчений хвіст. Але найчастіша скарга — «рація пише невідомий акумулятор» —
народжується не з поламаної структури, а зі **змісту**. Структурно бездоганний
дамп може бути повністю неробочим, і Майстер про нього мовчав.

Перевірка живе в `impres_audit.h` — чиста арифметика без вводу-виводу, щоб той
самий код ганявся і в прошивці, і в тестах на корпусі дампів.

| Знахідка | Що це означає | Що робить Майстер |
|---|---|---|
| `ISS_CRYPT_WRONG` | поля зашифровані ключем **чужого** чипа — рація читає сміття | крок «Перешифрувати під ROM чипа» |
| `ISS_CRYPT_UNKNOWN` | ключ не визначається взагалі: вміст ні з чим не узгоджений | вписати дату й знос вручну, далі перешифрувати |
| `ISS_BLOCK_SUM` | побита сума блока з датами чи лічильниками | «Ремонт цілісності» — тепер лагодить і блоки BMS |
| `ISS_DATE_INSANE` | неправдоподібна дата виготовлення | вписати вручну в «Ремонті» |
| `ISS_ETM_FOREIGN` | наробіток більший за вік пакета | перечитати монітор; після ЗП — правити наробіток **після** калібрування |
| `ISS_USE_BEFORE_CHG` | пакет «вмикали», але жодного разу не заряджали | перешифрування приводить поля до несуперечливого стану |
| `ISS_DCA_INSANE` | у моніторі розряду в рази більше, ніж заряду — побитий регістр | крок «Полагодити лічильник розряду»: значення береться з історії пакета |
| `ISS_MONITOR_ZEROED` | монітор обнулено, а історія в DS2433 ціла — DS2438 заміняли або скидали | синхронізація дзеркала (крок не нав'язується: обнулення могло бути свідомим) |

**Ремонт цілісності навчився бачити блоки BMS.** Він ішов ланцюгом записів від
`0x120`, а більшість блоків лежить **нижче** — до них ланцюг не доходив узагалі.
Тепер їхні суми правляться точково: адреса відома з таблиці векторів, довжина —
перший байт блока, тож угадувати нічого не треба.

Крок перешифрування ставиться **після** ремонту структури (він може полагодити
суми) і **до** калібрування: на станцію має їхати пакет, чиї поля рація вже
читає правильно. Після «Відновити еталон» окремий крок не потрібен — воно
робить це саме.

Перевірено `audit_check` на всьому корпусі: `dumps/16` дає «чужий ключ», після
перешифрування — чисто; побита сума виявляється й лагодиться; суперечність
«вмикали без заряду» виявляється й знімається перезаписом. На 53 дампах —
**5 знахідок побитих сум, і всі п'ять у теках, які власник позначив як
проблемні** (`09`, `10`, `11`, `13`×2); на робочих пакетах жодної хибної
тривоги.

### 🐞 Дата виготовлення ставала прочерком після запису

Скарга: у «Ремонті» записали знос 100 %, калібрувань 0, вигот. `2023-02-15`,
запуск `2026-07-27` — а після перечитування картка правок показує прочерк, хоча
на вкладці «Дані» все на місці. Дві незалежні причини, обидві виправлені.

**1. Ми писали внутрішньо неможливий стан.** Пакет, який уже вмикали, не міг
жодного разу заряджатися: `dayLastCharge` не може бути меншим за
`dayInitialUse`. А ми лишали його нульовим — і власний же підбір ключа згодом
вважав такий вміст сміттям. Тепер `impresCryptNormalize()` приводить поля до
несуперечливого стану **перед** записом, тож жоден писар такого стану не
створить. Заодно послаблено й сам фільтр: `dayLastCharge == 0` («ще не
заряджали») — законний стан, а не суперечність.

**2. Картка гадала ключ, хоча ROM чипа вже відомий.** Підбір вимагає, щоб
кандидат лишився **рівно один**, і відкидає варіанти за узгодженістю
лічильників. На щойно записаному пакеті лічильники нульові, а `CCA` монітора —
ні, тож не проходив жоден кандидат. Тепер, коли ROM відомий, його ключ
перевіряється **прямо**: питання ж не «який ключ підійде», а «чи не зашифровано
вміст чужим ключем», і його вирішує сама дата — правильний ключ дає
правдоподібну, чужий дає `2107-13-21`. Ремонт чужого ключа (`dumps/16`) від
цього не постраждав: там ROM дає безглузду дату, і код чесно переходить до
підбору.

Регресія закрита `crypt_check`, розділ 14: після запису картка правок і вкладка
«Дані» зобов'язані показувати те саме.

### 🐞 Кеш ROM переживав заміну пакета

`ROM-ID` — не просто серійник для показу: з нього беруться **ключі шифрування**.
Драйвер кешує ROM обох чипів, бо `Search ROM` на цій шині нестабільний, — але
кеш **ніколи не скидався**. Поставили інший пакет, його `DS2433` не знайшовся
пошуком, спрацював запасний варіант — і дані нового пакета зашифрувалися б
ключем **попереднього**.

Тепер кеш скидається у двох випадках: коли `ROM` знайденого чипа не збігається з
кешованим (обидва чипи живуть в одному пакеті, тож зміна будь-якого означає
інший пакет) і коли на шині немає presence-pulse (пакет зняли). Дзеркало на
рівні застосунку (`chipSN2433`) теж отримало гілку `else` — раніше серійник
лишався від попереднього пакета, якщо цей не визначився.

### Аудит клієнтів

`tools/client_audit.py` перевіряє те, що очима не вловиш: кожен `onclick` має
існуючу функцію, кожен `$('id')` — існуючий елемент, кожен виклик `/api/…` —
маршрут у прошивці, кожна USB-команда — гілку в `serial_api.h`. Так знайдено,
що `/api/clock` і команда `CLOCK` **не були доступні з жодного клієнта**: дата
пристрою заводилась неявно, але побачити чи виправити її було нічим. Тепер на
сторінці «Налаштування» кожного клієнта є картка **«🕐 Дата пристрою»** з
джерелом дати (`client` / `saved` / `none`) і кнопкою синхронізації.

### Новий АКБ: ідентичність генерується з ROM чипа

Вшитий еталон — побайтова копія **одного** реального пакета, і його зашифровані
блоки (дати, знос, калібрування) зашифровані ROM-ом **донора**. Записати їх на
порожній чип означає віддати новому пакету числа, які рація розшифрує **своїм**
ключем — і побачить безглуздя. Це рівно той збій, що в
`dumps/16-verbatim-4409a-chuzhyi-kliuch`: на еталоні 4409A рація читала дату
виготовлення `2107-13-21`.

Тому ідентичність тепер не копіюється, а **генерується**
(`impresIdentityWrite()` в `impres_crypt.h`):

| Що | Звідки береться |
|---|---|
| ключі шифрування | ROM-ID **цього** чипа: `key1 = ROM[1]`, `key2 = ROM[6]` |
| дата виготовлення | системний годинник пристрою (рік 0 — блок `DATE` не чіпаємо взагалі) |
| дата першого запуску | «ще не вмикали»: `dayInitialUse = 0` |
| знос | 100 % від паспортної ємності моделі (`CTS`) |
| калібрування, цикли, повернення | нулі |
| модель, крива, автентифікація | з еталона — це і є те єдине, що від моделі |

Окремого поля-серійника в пам'яті DS2433 немає: **ROM-ID і є серійним номером**
пакета, тож «згенерувати за номером» = вивести з нього ключі й підписати вміст.
Два різні чипи з одного еталона отримують **різну шифровку**, але кожен читає
своїм ключем ту саму дату — це й перевіряє `crypt_check`, розділ 13.

Спрацьовує у двох місцях: у «🆕 Новий акумулятор» і при «Відновити еталон»,
якщо чип **до того був порожній** (усе `0xFF` або все `0x00`). На пакеті з
даними так робити не можна — це знищило б його справжню історію, тож умова
строга.

> Якщо ROM-ID невідомий (чип не прочитано, дамп із файлу), генерувати нема з
> чого — і тоді операція **прямо про це каже**, а не мовчить: у пам'яті
> лишилась шифровка донора, і рація прочитає її як сміття.

### Перше читання показувало не все

Скарга: «при зчитуванні відображається не вся інформація, повне відображення
лише після повторного натискання». Причина — у шині, а не в інтерфейсі. Після
кожної операції підтяжка гаситься (`pullupOff`), тож обидва чипи
знеструмлюються і **кожен пошук — холодний старт**. `findDevices()` піднімав
підтяжку й одразу йшов у `Search ROM`: чип, який прокидається повільніше
(зазвичай DS2438 — у нього ще й аналогова частина), у пошук не потрапляв.
З другого натискання все працювало, бо його ROM уже лежав у кеші.

Тепер після підняття підтяжки є пауза `DS_BUS_SETTLE_MS` (5 мс), а сам пошук
повторюється до `DS_SEARCH_TRIES` (3) разів — поки не знайдено **обидва** чипи.
Спроба коштує одиниці мілісекунд; віддати нагору половину даних коштує дорожче.

### 🐞 Сильна розбалансировка банок: DS2433 читався не повністю

Скарга: якщо банки акумулятора сильно розбалансовані, він не заряджається й
видає помилку, а при зчитуванні `DS2433` вичитується лише **початок**
мікросхеми — решта дампа порожня чи сміттєва.

Причина — у живленні, а не в даних. `DS2433` (на відміну від `DS2438`) не має
окремого виводу живлення: він живиться **паразитно, від самого пакета**, через
ту саму 1-Wire шину. Стара `readBattery()` читала всі 512 байт **однією
безперервною транзакцією** й безумовно повертала `true`. Якщо пакет із сильно
розбалансованими банками просідав під навантаженням посеред цієї транзакції —
чіп втрачав живлення, і `read()` після цього моменту повертав не дані, а
плаваючу лінію (як правило суцільні `0xFF`). Функція про це не дізнавалась
узагалі: дірка в буфері йшла нагору як **успішне** читання — рівно те, що
виглядало як «вичитує тільки початок».

Тепер читання — постранкове (32 Б, як і при записі), і кожна сторінка — окрема
транзакція: `Reset` + `Match ROM` + `Read Memory` зі своєю адресою.
`reset()` заразом є перевіркою presence-pulse: якщо пакет просів і чіп не
відповів, це видно відразу на тій сторінці, де сталось, а не постфактум по
сотнях байтів сміття. Дається `DS_READ_RECOVER_MS` (30 мс) на відновлення
напруги, і сторінка повторюється до `DS_READ_PAGE_TRIES` (4) разів. Якщо й
після цього сторінка недоступна — `readBattery()` чесно повертає `false`
замість вдаваного успіху з діркою в даних; `readAllChips()` (`web_server.h`)
на `false` і так не комітить дамп у пам'ять, тож жодних правок клієнтів не
знадобилось.

Перевірено `tools/battery_read_check.cpp` на симульованій шині з керованим
«просіданням» (`tools/fake/OneWire.h`) — здорове читання, тимчасове просідання
з відновленням у межах ретраїв, непоправне просідання (має чесно провалитись),
просідання рівно на межі сторінки (сусідні сторінки не постраждали) і
просідання на другій сторінці (той самий сценарій «вичитано тільки початок»).

### Як влаштоване меню

Сторінка «🔧 Ремонт» була на 18 карток в один скрол (6868 px) — знайти потрібну
можна було лише прокруткою. Тепер вона розкладена на **під-вкладки**, а те, що
до ремонту не належить, винесено на окрему сторінку:

| Під-вкладка | Що всередині |
|---|---|
| 🩹 Ремонт | резервна копія, ремонт після заміни елементів, ремонт цілісності |
| 🔌 Калібрування | розряд перед калібруванням, процедура на IMPRES-ЗП, скидання для рекалібрування |
| 🎚 Значення | ємність, рівень заряду, дата першого використання, знос, очистка |
| 🪪 Еталон і модель | запис моделі, відновлення з еталона (з планом правок), новий АКБ |
| 🧪 Експерт | редактор байтів, запис DS2433 і DS2438 з файлу |
| ⛔ Небезпечно | повне стирання |

Окрема вкладка **⚙️ Налаштування** — звук і перезавантаження пристрою (у бріджі
там же журнал обміну). У акумулятор ці операції не пишуть узагалі, і в розділі
ремонту їм було не місце.

Перша під-вкладка тепер **1079 px** замість 6868. Так само розкладено брідж
(`client_usb.html`) і `.exe` — там це вкладений `ttk.Notebook` із тими самими
шістьма розділами плюс «Налаштування».

> Окремий тест `nav_check.js` стежить, щоб при перестановці **жодна картка не
> загубилась і не з'явилася у двох місцях одночасно**: він обходить усі
> під-вкладки, збирає видимі картки й звіряє зі списком того, що було до
> перебудови.

### Режим навченого хвоста

Хвіст `0x18A..0x1FF` — те, що зарядна станція вважає «історією» пакета. При
відновленні його можна залишити у двох формах, і вибір справді має значення:

| Режим | Що робить | Ціна |
|---|---|---|
| `fresh` (типово) | скелет записів на місці, навчені значення обнулені, суми правильні | ЗП бачить валідний навчений блок; саме в цій формі вона світила зеленим і не заряджала (`dumps/06,07,08,15`) |
| `erase` | `0x18A..0x1FF` лишається `0xFF` | єдина форма, у якій ЗП власника **починала заряджати** й переходити в калібрування — тричі незалежно (`dumps/11,12,13`). Але в `dumps/13` після повного циклу ЗП дописала лише два байти, а байт довжини лишився `0xFF` — навчений блок так і не став валідним, тож калібрування може не завершуватись |

API: `&tail=erase`; по USB — `TAIL=ERASE`. Модельна частина `0x000..0x189`,
заголовок і запис моделі в обох режимах не змінюються.

> Розбір симптому «ЗП світить зеленим і не заряджає» по всьому корпусу —
> `dumps/17-zelenyi-indykator-ne-zaryadzhaie`. Там же — дві гіпотези, які
> **не** підтвердились (прапорці ЗП і паливомір), щоб їх не перевіряли вдруге.

### Записати ЛИШЕ правки

Коли ідентичність пакета ціла, а збився тільки паливомір, шунт, OFFSET, дата чи
паспортна ємність, перезаписувати весь еталон немає за що. Кнопка **«💾 Записати
лише правки»** (поруч із «Перечитати акумулятор») міняє в чипах **рівно обрані
поля** й не чіпає ні модельну частину, ні навчену калібровку, ні лічильники
CCA/DCA. Вимкнена правка в цьому режимі лишає поле **як є** (а не обнуляє його —
тут нікому було б відновити).

API: `POST /api/restore/fixes?model=…&fixes=…[&rated=…][&rsense=…|&rsmodel=…][&mfg=…][&health=…][&use=…][&cal=…][&cyc=…][&nonimp=…][&today=…][&etmsrc=…]`,
команда `FIXES <MODEL> [FIXES=…] [RATED=…] [RSENSE=…|RSMODEL=…] [MFG=…] [HEALTH=…] [TODAY=…] [ETMSRC=USE|PACK]` по USB.

> Майстер відновлення бере **ті самі** правки: `/api/wizard/step` і `WIZSTEP`
> приймають `fixes`/`rated`/`rsense`/`rsmodel`/`mfg`/`today`/`etmsrc`, і всі три входи (веб, USB,
> Майстер) проходять через один `restorePlanOverride()` — щоб галочка означала
> те саме, звідки б її не натиснули. Раніше крок Майстра завжди йшов із типовим набором,
> тож поставлена в таблиці галочка (наприклад, наробіток) для нього нічого не
> значила.

Правки застосовуються **після** скидання монітора (воно обнуляє наробіток і
паливомір) і не чіпають модельну частину DS2433. У режимі `VERBATIM` правок
немає за визначенням. Той самий набір діє й тоді, коли відновлення запускають
з **меню пристрою** або з **Майстра** — просто без запитання, з типовими
галочками.

---

## 12. Структура проєкту

| Файл | Призначення |
|---|---|
| `motorola-battery-reader-web.ino` | головний скетч (setup/loop) |
| `settings.h` | усі налаштування (піни, дисплей, звук, підсвітка кнопок, анімація) |
| `impres_format.h` | **структура прошивки IMPRES** — записи, регіони, DS2438, ємності за моделлю |
| `operations.h` | **єдиний каталог операцій**: склад, порядок і тексти для екрана, веба, USB-клієнта |
| `discharge.h` | керований розряд навантаженням (MOSFET) із запобіжниками |
| `charge.h` | керований заряд, **обидві топології в одному файлі** (`CHARGE_TOPOLOGY`): понижувач на власному ключі з власними вимірами й тепловим бюджетом — або готова плата DC/DC на TL494 (enable + калібрувальна таблиця «мВ виходу → напруга керування», вимір із DS2438 пакета). Тут же **примусове пробудження** пакета, що не читається — і чесна відмова від нього там, де власних вимірів немає |
| `battery_reader.h/.cpp` | протокол 1-Wire, читання/запис DS2433/DS2438 |
| `display.h` | монохромні дисплеї (u8g2), меню, декодування, справжність |
| `display_color.h` | кольорові TFT ST7789: меню, заставка, градієнт, червоний фільтр помилки |
| `web_server.h` | веб-сервер, API, операції з АКБ, ініціалізація нового АКБ |
| `serial_api.h` | USB-Serial протокол для клієнтів |
| `recovery.h` | двигун **Майстра відновлення** + база правил + журнали за серійником |
| `templates.h` | вшиті genuine-еталони моделей для «Новий акумулятор» / «Відновити» |
| `device_clock.h` | системний годинник пристрою: єдине джерело «сьогодні» для всієї прошивки; RTC/NTP тут немає, дату приносить клієнт, вона живе в SPIFFS |
| `restore_plan.h` | правки еталона під конкретний пакет: заряд/шунт/OFFSET/наробіток замість чисел донора; шунт, ємність і дату можна задати вручну, а наробіток — порахувати з дати першого запуску |
| `edit_plan.h` | **ручний редактор**: усі значення пакета одним списком — назви, одиниці, межі й правила узгодженості в одному місці; сюди ж винесено заборону неможливих наборів (дата в майбутньому, запуск раніший за виготовлення, «вмикали, але не заряджали») |
| `snapshot_diff.h` | **знімок «до станції» і побайтова різниця з ним**: показує, які саме байти змінила зарядна станція, зокрема ті, про призначення яких ми нічого не знаємо |
| `impres_crypt.h` | перешифрування дат і лічильників під ROM цього чипа (ключ = `ROM[1]`/`ROM[6]`) |
| `leds.h` | неблокуюча індикація (світлодіоди + підсвітка кнопок) |
| `buzzer.h` | звуковий буззер: DDS-синус на ЦАП (або ШІМ резервно), фрази з портаменто + налаштування, що правляться на ходу |
| `index.html` | веб-інтерфейс (у `data/` для SPIFFS) |
| `client_usb.html` | USB-клієнт (Web Serial, Chrome/Edge) |
| `usb_client/moto_gui.py` | **нативний GUI-клієнт** (Tkinter) → `moto_usb.exe` |
| `usb_client/moto_bridge.py` | веб-міст (pyserial) → `client_usb.html` у будь-якому браузері |
| `usb_client/make_icon.py`, `icon.ico` | іконка застосунку (акумулятор) |
| `usb_client/build.bat`, `build_bridge.bat` | збірка `.exe` (PyInstaller) |
| `dumps/` | **архів реальних дампів** (робочі/несправні/експерименти) з описами власника |
| `tools/decode_dump.py` | анотований декодер дампа (+`--template`, `--diff` genuine/клон) |
| `tools/make_color_splash.py`, `make_splash.py` | генератор кастомної заставки |
| `page_index.h` | **веб-сторінка, вшита в прошивку** (gzip, ~89 КБ). Генерується з `index.html`: `python3 tools/mk_page_header.py`. Пристрій віддає її з `Content-Encoding: gzip` |
| `data/` | необов'язкова тека для SPIFFS. Сторінки там більше немає; файл `/index.html.gz`, покладений туди вручну, ПЕРЕКРИВАЄ вшиту — зручно правити без перепрошивки |
| `INSTRUCTION.md` | докладна інструкція (те саме, розгорнуто) |

---

## 13. Застереження

- 🔧 Інструмент для **обслуговування власних/довірених** акумуляторів
  (рекалібрування, відновлення прошивки після заміни елементів).
- 💾 **Перед будь-яким записом — резервна копія.** Невірний дамп або чуже
  калібрування можуть зробити АКБ невизначеною. Незворотні операції потребують
  свідомого підтвердження (довге утримання / вибір у меню).
- 🧪 Поведінку на реальному зарядному пристрої/рації перевіряйте на
  «жертовній» батареї.
- ⚠️ **Family codes `0xA3/0xA6` не чіпати** (див. вгорі).

---

<div align="center">

**Слава Україні! 🇺🇦**

</div>
