roman885-85/moto_battery_reader/battery_reader_china_chr/ЗМІНИ.md

# `battery_reader_china_chr` — робоча копія проєкту

Повна копія Motorola IMPRES Battery Reader з виправленими дефектами й
переробленою схемою заряду. Далі працюємо саме тут; коренева тека репозиторію
лишається такою, якою була до розгалуження.

Копія самодостатня: прошивка, веб-інтерфейс (`index.html`), USB-клієнт
(`client_usb.html`, `usb_client/`), файли SPIFFS (`data/`), архів дампів
(`dumps/`) і хостові тести (`tools/`).

```bash
mkdir -p build                       # запускати З КОРЕНЯ ЦІЄЇ ТЕКИ:
for f in tools/*_check.cpp; do       # тести читають dumps/ за відносним шляхом
  n=$(basename "$f" _check.cpp)
  g++ -std=c++17 -I. -Itools/fake -o "build/$n" "$f" && "./build/$n" || echo "ЗБІЙ: $n"
done
```

**Усі 8 тестів проходять.**

---

# Частина 1. ПОТОЧНИЙ СТАН ЗАЛІЗА

Це те, під що налаштована прошивка **зараз**. Історія змін — у частині 3;
якщо вам потрібно зібрати й запустити пристрій, читайте тільки цю частину.

## Розподіл пінів

| Сигнал | GPIO | Константа |
|---|---|---|
| 1-Wire дані | 13 | `DS_PIN` |
| Підтяжка 1-Wire + enable пакета | 12 | `PULLUP_PIN` |
| LED зелений / червоний | 14 / 27 | `LED_GREEN_PIN` / `LED_RED_PIN` |
| Три кнопки на аналоговій драбинці | 33 | `MENU_BTN_ADC_PIN` (лише ADC1) |
| Підсвітка кнопок | 15 | `BTN_LED_PIN` |
| Дисплей ST7789 240x240 (GMT130-V1.0), SPI | 18/23/5/17/16/4 | SCK/MOSI/CS/DC/RST/BLK — виводу CS на модулі немає, але пін заданий (див. нижче). Режим SPI 3, 24 МГц |
| Затвор MOSFET **розряду** | 19 | `LOAD_PIN` |
| ШІМ **заряду** → керуючий NPN → силовий ключ | 26 | `CHARGE_PWM_PIN` (тип ключа — `CHARGE_SWITCH_TYPE`) |
| Вимір струму заряду | 35 | `CHARGE_ISENSE_PIN` — шунт → 1 кОм → пін (лише ADC1) |
| Вимір напруги заряду | 34 | `CHARGE_VSENSE_PIN` — подільник 20к/10к → 1 кОм → пін (лише ADC1) |
| Контроль живлення +14 В | 39 | `CHARGE_PSU_PIN` — подільник 68к/10к → 1 кОм → пін (лише ADC1) |
| Звук | 25 | `BUZZER_DAC_PIN` — **вимкнено**, пін вільний |

> ⚠️ Резистор **1 кОм послідовно** перед КОЖНИМ вимірювальним піном (і струму, і напруги) — струмообмеження входу АЦП. На показання він **не впливає**: вхід АЦП високоомний, струму через резистор немає, отже немає й падіння на ньому. У жодну формулу перерахунку він тому й не входить — не «виправляйте» це.

34, 35 і 39 обрані не випадково: **вхід-тільки** (вимірювальну лінію фізично
неможливо продавити назовні) і **ADC1** — ADC2 не читається при увімкненому
Wi-Fi, а точка доступу тут піднята завжди.

Що лишилось вільного з ADC1: **GPIO36/VP** (вхід-тільки) — а от **GPIO32**
зайнятий умовно (див. нижче про спадковий enable) і
**GPIO36/VP** (теж вхід-тільки). GPIO37/38 на більшості модулів WROOM не
виведені на гребінку — на них розраховувати не можна. Для контролю живлення
взято 39, а не 32, саме тому, що 39 годиться **виключно** як аналоговий вхід:
витрачати на вимір єдиний універсальний пін, що лишився, нема сенсу.
GPIO25 (звільнений від звуку) у резерві.

**GPIO32 — спадковий enable старої схеми заряду, і його знову утримують.**
До переробки на ньому сидів `CHARGE_PIN` — enable силового каскаду готової
TL494-плати, і скетч найпершим рядком `setup()` опускав його в LOW. Переробка
пін прибрала — і разом із ним прибрала й те, що його хтось узагалі налаштовує:
він лишився висіти ВХОДОМ, тоді як на платі до нього цілком може бути
припаяний той самий ланцюг. Невизначений рівень на вході чужої схеми — це
рівно той клас несправності, що з'являється «після переробки» й виглядає як
щось стороннє. Тепер він знову опускається в LOW при старті
(`CHARGE_LEGACY_EN_PIN`): нічого не припаяно — дія безкоштовна, припаяно —
відновлено дореформений стан. Закоментувати, коли доріжку буде зрізано.

**GPIO5 міг би звільнитись, але лишається за дисплеєм.** Панель тут — GMT130
240x240: на гребінку виходять лише `GND/VCC/SCL/SDA/RES/DC/BLK`, виводу CS
немає фізично, і GPIO5 нікуди не підключений. Підтримку режиму «CS немає»
зроблено (`-1` в Adafruit, `U8X8_PIN_NONE` в U8g2 — див. `ST7789_CS_ARG`), але
ТИПОВО пін усе одно заданий: смикати непід'єднаний пін електрично безкоштовно,
а `-1` спирається на внутрішню гілку бібліотеки, реалізовану в різних версіях
`Adafruit_SPITFT` по-різному (де через `csPinMask=0`, де через
`digitalWrite(-1)`). Заданий реальний пін працює на будь-якій версії й на
будь-якому модулі — з виводом CS і без.
Закоментувати рядок можна, якщо GPIO5 знадобиться під щось інше; тоді єдина
умова — шина SPI має бути тільки під дисплеєм: без CS панель слухає її
постійно, і будь-який чужий трафік на SCK/MOSI піде їй як команди.
Заразом вимкнено `DISPLAY_ST7789_ROUND`: GMT130 квадратний, із гострими
кутами, і заокруглення з'їдало б по 22 px з кожного боку ні за що.

**Лінія enable/підтяжки (GPIO12) тепер перевіряється прошивкою.** На ESP32
вхідний буфер вихідного піна лишається увімкненим (`OUTPUT` там визначено як
`0x03`, тобто разом із бітом `INPUT`), тож `digitalRead()` на ньому дає
РЕАЛЬНИЙ стан виводу, а не те, що ми записали. Це й дозволяє відрізнити
несправну обв'язку від відсутнього пакета — раніше обидва випадки виглядали як
«нема чіпа», тобто прошивка звинувачувала пакет, не перевіривши себе.
**Між GPIO12 та +3.3 В стоїть резистор 4.7 кОм — але він НЕ обов'язковий.**
Власник поставив його для попереднього налагодження функцій; прошивка веде цю
лінію активно в обидва боки, тож підтяжка тут не умова роботи.
⚠️ Не плутати з підтяжкою **лінії даних** (GPIO13) — ОТА обов'язкова: чипи
DS2433/DS2438 живляться з неї паразитно, і внутрішніх ~45 кОм їм не вистачає.

Окремо варто знати, чому підтяжка вгору на цьому піні взагалі можлива: GPIO12 — strapping-пін MTDI,
рівнем на ньому при скиданні ESP32 вибирає напругу флеш-пам'яті (HIGH = 1.8 В),
і зазвичай зовнішню підтяжку вгору на ньому називають забороненою. Тут вона
працює, бо на цьому модулі напруга флеш зафіксована в eFuse
(`espefuse.py set_flash_voltage 3.3V`) або флеш справді 1.8-вольтова —
інакше пристрій не завантажувався б із уже припаяним резистором.
Раніше в цьому файлі стояло «підтяжки вгору бути не може взагалі» — це було
переписано з даташита, а не знято з ЦІЄЇ плати.

**Чорний екран був не через CS, а через РЕЖИМ SPI** — підтверджено на пристрої.
`tft.init()` кликався без режиму й частоти, тобто мовчки брав зашитий у
бібліотеку режим 0; панелі без виводу CS вимагають режим 3. Повчальна частина:
поки параметра немає в налаштуваннях, його «немає» і в голові — причину шукали
в проводці, у номіналі CS, у пресеті панелі, тобто скрізь, крім того місця, де
вона була. Тепер обидва числа задаються явно й друкуються в журналі при старті:
`SPI mode=3 24.0 МГц`.

## Силова частина заряду: понижувач (buck), ключ на вибір

**Верхній ключ можна зібрати на двох різних приладах**, і обв'язка в них
СПІЛЬНА. Вибір — однією константою в `settings.h`:

```c
#define CHARGE_SWITCH_TYPE CHARGE_SW_PMOS      // P-канальний MOSFET (NTD2955G) — ЗАРАЗ
// #define CHARGE_SWITCH_TYPE CHARGE_SW_BJT_PNP  // біполярний PNP (B772M)
```

Це не косметика. Прилади керуються **різними величинами**, і майже кожна
перевірка силової частини розгалужується за цією константою:

| | біполярний PNP (B772M) | P-MOSFET (NTD2955G) |
|---|---|---|
| керується | **струмом** бази | **напругою** на затворі |
| що задає `R_drive` | струм бази `Iб = (U−Uбе−Uке)/R` | верхнє плече **дільника**, який задає `Uзатв` |
| провідні втрати | `Uке_нас × I × D` — ростуть **лінійно** | `I² × RDS(on) × D` — ростуть **квадратично** |
| час перемикання | розсмоктування заряду бази, ~3000 нс | перезаряд `Qg` **нашим** драйвером, ~2100 нс |
| витрати драйвера | **1505 мВт** постійно | **172 мВт** (наскрізний струм дільника) |
| розсіювання на ключі | 819 мВт при `Pc` 1250 мВт — **тісно** | 473 мВт при `Pd` 55 000 мВт — **із запасом** |

```
   +Uживл (~14 В) ─┬────[ R_підт 1к ]───────┬─── E (витік)   PNP B772M
                   │                        │                або P-MOSFET
                   └────────────────────────┴─── B (затвор) ─┐   NTD2955G
                                                             │
   CHARGE_PWM_PIN ──[ 390 ]── B  NPN                         │
                              C ──[ R_drive 120 Ом ]─────────┘
                              E ── GND
                 B ──[ R_вниз 10к ]── GND       <-- ОБОВ'ЯЗКОВО

                              C ─┬───[ L 104 мкГн ]───> +клема АКБ
                                 │
                           (катод) VD  діод Шотткі
                                 │
                                GND

   −клема ──┬──[ R_шунт 0.5 Ом / 2 Вт ]── GND
            └──[ 1 кОм ]── CHARGE_ISENSE_PIN

   +клема ──[ 20к ]──┬──[ 1 кОм ]── CHARGE_VSENSE_PIN
                [ 10к ]
                     └── GND

   +Uживл ──[ 68к ]──┬──[ 1 кОм ]── CHARGE_PSU_PIN
                [ 10к ]
                     └── GND
```

Логіка **не інвертована**: два інвертування (NPN + PNP) взаємно скасовуються,
тож шпаруватість на піні = шпаруватість ключа, **0 % = безпечно**.

## ⚠️ Що обов'язково перевірити перед першим запуском

| Елемент | Вимога | Чому |
|---|---|---|
| `R_вниз` з бази NPN на землю | **10 кОм, обов'язково** | під час скидання ESP32 піни у високоімпедансному стані; програмно це не перекрити |
| `R_драйв` пін→база NPN | **390 Ом** 🔴 на платі **20 кОм** | 0.13 мА замість потрібних 0.7 — NPN не насититься. **Обов'язково для ОБОХ типів ключа** |
| `R_drive` колектор NPN→база/затвор | **120 Ом, 2 Вт** 🔴 на платі **1 кОм** | PNP: струм бази лише 12 мА → заряд ~22 мА, тобто 4 доби. **MOSFET: 1 кОм дає \|VGS\| 6.9 В — ключ уже відкривається**, але не до паспортної точки RDS(on) |
| NPN | **2N2222 / BC337 / S8050** | PNP: має пропускати 106 мА (при 16 В — 123 мА). MOSFET: лише 12.3 мА наскрізного струму дільника. BC547 годиться **тільки** з польовим ключем |
| `R_підт` затвор/база → +Uживл | **1 кОм** (як є) | PNP: запираюча підтяжка, відбирає 0.9 мА зі 106. **MOSFET: нижнє плече дільника — саме вона задає \|VGS\| і час запирання**, міняти не можна не перерахувавши |
| Подільник напруги пакета | **20к / 10к** (як є) | 8.25 В → 2.75 В на АЦП; міняти не треба |
| Подільник живлення | **68к / 10к** + 1 кОм — **новий** | 14 В → 1.79 В; діапазон до 20 В, щоб помилковий блок 19 В читався числом |
| Шунт | 0.5 Ом, **від 2 Вт** | при 1.5 А розсіює 1.1 Вт |
| Радіатор | PNP: **потрібен** (0.82 Вт при Pc 1.25 Вт) · MOSFET: **не потрібен** (0.47 Вт при Pd 55 Вт) | паспорт дано для корпусу при 25 °C |
| Блок живлення | **12.5…16 В** | PNP: нижче — струму бази не вистачить на насичення. MOSFET: нижче — просідає \|VGS\|, вище — наближається межа затвора (14.1 В при дозволених 20) |

### 🔴 Заміни, які треба зробити ДО першого заряду

**Із біполярним PNP їх дві, і поодинці жодна не працює**: замінити тільки
`R_drive` означає попросити в NPN 106 мА, яких він при 20 кОм у базі віддати
не може, і ключ однаково лишиться поза насиченням. Наслідок в обох випадках
однаковий — B772M у **лінійному режимі** під 14 В, тобто згорілий ключ за
секунди.

**Із польовим ключем обов'язкова лишається одна — 20 кОм → 390 Ом.** І це не
послаблення вимоги, а зміна її причини: керуючий NPN мусить пропустити
наскрізний струм дільника затвора (12.3 мА на номіналі, 14.1 мА при 16 В), а
при 20 кОм у базі він дає щонайбільше 2.6 мА. Затвор просто не притягується.

А ось `R_drive` 1 кОм → 120 Ом із польовим ключем **бажана, але не
смертельна**. Дільник 1 к/1 к дає |VGS| = 6.9 В при порозі 4 В — ключ
відкривається. Просто не до 10 В, при яких паспорт нормує RDS(on) 0.18 Ом,
тож опір каналу (а з ним і нагрів) буде вищий за розрахунковий. Прошивка це
знає й друкує обома числами при старті.

Чому саме 120 і 390, а не 150 і 470, як було в попередній редакції: рахувати
треба **на межі допуску живлення**, а не на номінальні 14 В. Для силового
ключа найгірша межа **нижня** (при 12.5 В струм бази падає до 75 мА при
потрібних 82), для керуючого NPN — **верхня** (при 16 В струм драйвера росте
до 124 мА, і 470 Ом уже не дають потрібних 6.2 мА в базу). Обидві помилки
знайшли не на столі, а `#error`-перевірки, щойно з'явився контроль живлення.

Номінали, що стоять на платі, записані в `settings.h` окремо
(`CHARGE_BASE_DRIVE_ASBUILT_OHM`, `CHARGE_NPN_BASE_ASBUILT_OHM`), тому
прошивка **збереться** й із ними — але при старті надрукує попередження з
числами, а заряд зупинить сама відсічкою «ключ не тягне» приблизно за
5 секунд. Це запобіжник, а не дозвіл працювати без заміни.

Прошивка **не збереться**, якщо подільники, струм бази на ОБОХ межах допуску
живлення, розсіювання ключа, пікові струми чи частота ШІМ виходять за межі:
`#error`-перевірки в `settings.h` рахують усе за вашими номіналами й
підказують, що саме поправити. Кожну з них перевірено на свідомо зламаній
конфігурації — тобто доведено, що вона справді спрацьовує, а не просто
написана.

## Робоча точка

| Величина | Значення |
|---|---|
| Частота ШІМ / роздільність | 25 кГц / 11 біт (2048 кроків) |
| Розмах пульсацій дроселя ΔI | ~1303 мА |
| Межа неперервного режиму (ΔI/2) | 651 мА |
| Крейсерський струм (`CHARGE_MA_80`) | 1000 мА |
| Піковий струм (крейсер + ΔI/2) | 1651 мА |

**Далі — те, що залежить від типу ключа:**

| Величина | PNP B772M | P-MOSFET NTD2955G |
|---|---|---|
| Паспортна межа струму | 3000 мА (`Ic`) | 12 000 мА (`Id`) |
| Керування | струм бази 106 мА (треба ≥ 82) | \|VGS\| 12 322 мВ (поріг 4000, паспорт RDS(on) при 10 000, межа 20 000) |
| \|VGS\| на краях допуску живлення | — | 10 983 мВ при 12.5 В … 14 108 мВ при 16 В |
| Час перемикання | 3000 нс (розсмоктування бази) | 2098 нс = 260 вмик + 1838 вимик (**5 % періоду**) |
| Провідні втрати | 294 мВт (`Uке_нас × I × D`) | 106 мВт (`I²R`) |
| Перемикальні втрати | 525 мВт | 367 мВт |
| **Разом на ключі** | **819 мВт** при `Pc` 1250 | **473 мВт** при `Pd` 55 000 |
| Втрати драйвера | 1505 мВт | 172 мВт |

Ці ж числа пристрій друкує в `Serial` при старті — рядки `CHARGE: buck L=…`,
`CHARGE: ключ P-MOSFET, RDS(on)…` і `CHARGE: перемикання… розсіювання…`.
Помітка «ПОТРІБЕН РАДІАТОР» з'являється, лише коли розсіювання переходить
половину паспортної межі — з польовим ключем вона не з'являється.

⚠️ **Вимикання повільніше за вмикання, і це властивість схеми, а не дефект.**
Униз затвор тягнуть обидва плеча дільника (107 Ом), а вгору — лише підтяжка
(1 кОм). Тому саме `R_підт` задає перемикальні втрати, і зменшувати її можна
лише разом із перерахунком нагріву: через неї тече весь наскрізний струм.

## Профіль струму заряду

| заряд | струм |
|---|---|
| 0 % | 200 мА |
| 10 % | 400 мА |
| 50 % | 700 мА |
| 80 % | 1000 мА |
| 80–90 % | плато 1000 мА |
| **90–100 %** | **100 мА — дозаряд малим струмом** (`CHARGE_TAPER_PCT`) |

Кінець повного заряду — **8.2 В** (`CHARGE_TARGET_MV`), а не 8.25.

Точки перегину масштабуються під обрану ціль, тож заряд завжди закінчується
дозарядом малим струмом, хай яку ціль обрано.

⚠️ **Наприкінці успішного заряду паливомір покаже ~97 %, а не 100 %** — 8200 мВ
на шкалі 6350…8250 це саме 97 %. Це не недозаряд і не збій: зупинка нижче
верхньої межі шкали зроблена навмисно (див. 3.6).

---

# Частина 2. ЧОМУ ЦЕ ПРАЦЮЄ САМЕ ТАК

Три нетривіальні наслідки топології, які легко порушити при правках.

## Дросель робить залежність струму від шпаруватості нелінійною

`Uвих ≈ D × Uживл`. Точка `D = Uпакета/Uживл` (≈0.59) — це **межа режимів**, а
не «нульовий струм»: середній струм у ній дорівнює половині розмаху пульсацій,
тобто ~650 мА. Нижче межі перетворювач у **переривчастому** режимі (струм
росте як `D²`), вище — у неперервному (лінійно).

Тому старт іде з `chargeStartDuty(Uпакета, уставка)`, яка цілиться в потрібний
струм по відповідній гілці:

| уставка | режим | duty (з 2047) |
|---|---|---|
| 100 мА | переривчастий | 472 |
| 200 мА | переривчастий | 668 |
| 400 мА | переривчастий | 945 |
| 700 мА | неперервний | 1267 |
| 1000 мА | неперервний | 1293 |

Розгін «з нуля крок за кроком» тут коштував би хвилин.

## Біполярний ключ обмежує частоту зверху, а дросель — знизу

Це не «інша деталь у тій самій ролі», а інший принцип:

* **керується струмом бази**, і насичення мусить триматись на **вершині
  пульсацій**, інакше ключ виходить із насичення на кожному горбі;
* **вимикається повільно** — розсмоктування заряду бази це мікросекунди проти
  наносекунд у MOSFET, тож перемикальні втрати домінують і ростуть прямо з
  частотою;
* **гріється**: у насиченні лишається `Uке_нас ≈ 0.5 В`, а не мілівольти опору
  каналу.

Тепловий бюджет при 25 кГц (Pc = 1.25 Вт):

| Iк | провідні | перемикальні | разом | |
|---|---|---|---|---|
| 0.5 А | 0.15 Вт | 0.26 Вт | 0.41 Вт | ок |
| **1.0 А** | 0.29 Вт | 0.53 Вт | **0.82 Вт** | робоча точка |
| 1.5 А | 0.44 Вт | 0.79 Вт | 1.23 Вт | на межі Pc |

Звідси й `CHARGE_MA_80 = 1000`: **стелю профілю задає ключ, а не пакет.**

## Три виміри рознесені в часі, і кожен зі своєї причини

| Що | Коли | Чому саме так |
|---|---|---|
| Струм | не зупиняючи ключ | через шунт тече неперервний струм дроселя; серія зі 128 відліків усереднює пульсації й окремо дає їх вершину |
| Напруга | ключ закрито на 10 мс | під струмом до напруги пакета додається падіння на дротах і внутрішньому опорі |
| Температура (DS2438) | раз на 10 опитувань, ключ закрито | шунт у **мінусовому** проводі підіймає «мінус» пакета над землею ESP32 на `I×R` (при 1.5 А — 750 мВ), і по зсунутій землі 1-Wire не відповідає. Транзакція коштує сотні мілісекунд — читати щосекунди означало б віддавати п'яту частину часу заряду |

DS2438 потрібен лише для **температури** й як незалежна перехресна перевірка за
лічильником CCA. Струм і напругу пристрій міряє власними давачами.

---

# Частина 3. ЩО БУЛО ВИПРАВЛЕНО

## 3.1. Дефекти, знайдені аудитом вихідного коду

Опис проєкту в `README.md` описував задум, а не поведінку коду. Усі сім
розбіжностей перевірені на корпусі `dumps/` і хостовими тестами.

**1. Заряд ніколи не оновлював екран.** `charge.h` справно виставляв прапорець
`chargeMarkDirty()`, `drawPageCharge()` була намальована в обох драйверах
дисплея — але **`chargeConsumeDirty()` не викликався ніде в проєкті**: у
`loop()` стояв лише рядок для розряду. Сторінка заряду не з'являлась, а коли
з'являлась — цифри стояли мертві до натискання кнопки.
*→ `motorola-battery-reader-web.ino`: додано симетричний блок.*

**2. Зупинка однієї операції ламала іншу, що саме йшла.** `dischargeStop()` і
`chargeStop()` згорталися повністю незалежно від того, чи їхня операція йшла, а
зупинку кличуть ззовні беззастережно (кнопка, `/api/*/stop`, USB). Два ресурси
спільні, тож «холоста» зупинка розряду під час заряду знімала з апаратного
сторожа таск `loop()` і опускала `PULLUP_PIN` — заряд лишався **без захисту від
зависання** і **переставав давати струм, продовжуючи звітувати «іде»**.
*→ `discharge.h`, `charge.h`: ключ гаситься завжди, решта згортання — лише коли
своя операція справді йшла.*

**3. Незнятий підсумок розряду перекривав сторінку заряду.** «Екран активний» ≠
«операція йде»: підсумок висить, доки його не приберуть кнопкою, і ламав
інваріант «активний екран рівно один».
*→ `web_server.h`: старт кожної операції знімає підсумок протилежної.*

**4. Перевірка в `settings.h`, яка не могла спрацювати.**
```c
#if (DISCHARGE_RAMP_HI_MV <= DISCHARGE_RAMP_LO_MV)
```
`DISCHARGE_RAMP_LO_MV` **у проєкті не існує** — низ лінійки поїхав за обрану
ціль, а старий `#define` прибрали. Невідомий ідентифікатор у `#if` препроцесор
мовчки вважає нулем, тож умова читалась як `8250 <= 0`.
*→ перевіряється справжній інваріант плюс дві сусідні межі.*

**5. `impres_clone.h` і `impres_audit.h` не збиралися окремо** — брали
`DS2438_MEM_SIZE` і `DUMP_SIZE` із заголовків, яких не включають, попри
заявлену в шапці самодостатність.
*→ перейшли на власні `IMPRES_38_SIZE` / `IMPRES_33_SIZE`.*

**6. `impresCyclesWrite()` міг зіпсувати гістограму циклів.** Вимагалася
довжина блока `ADDED` 21 байт замість 22, і на такому блоці контрольна сума
лягала б на молодший байт останнього кошика. У всіх 44 дампах, де блок є,
довжина рівно 22.

**7. `wizSerialHex()` — запис на байт за межу буфера.** `sprintf` кладе дві
цифри плюс нуль-термінатор, а умова резервувала лише дві.

## 3.2. Переробка заряду

Заряд переписано **тричі**, бо схему уточнювали поетапно. Нижче — лише те, що
кожне уточнення реально змінило; підсумковий стан описано в частині 1.

| Етап | Що було | Що змінилось |
|---|---|---|
| Вихідний | Готова плата DC/DC на TL494: цифровий enable + аналогове керування через ШІМ+RC, керування за калібрувальною таблицею | — |
| «Просто ключ» | ШІМ на P-MOSFET через NPN, власні вимір струму й напруги замість DS2438 | Прибрано калібрувальну таблицю й окремий enable; DS2438 лишився тільки для температури |
| «Є діод і дросель» | Це понижувач (buck), а не ключ | Частота 1 кГц → 25 кГц (пульсації дроселя); стеля скважності 60 % → 85 % (`Uвих ≈ D×Uживл`); «пік» переосмислено як вершину пульсацій; старт із розрахованої точки замість нуля |
| «Ключ — PNP B772M» | Не MOSFET, а біполярник | Модель ключа замінено на струмову (`R_бази`, β_форс, `Uке_нас`, час розсмоктування); профіль знижено 1500 → 1000 мА під тепловий бюджет |
| «У базі NPN 20 кОм» | Драйверний каскад узагалі не тягне | Записано фактичні номінали плати окремо від розрахункових; додано рантайм-відсічку «ключ не тягне» |
| «Контроль живлення» | `Uживл` була константою-припущенням | Напруга живлення вимірюється (GPIO39); розрахунок іде на живому вимірі; перевірки насичення переїхали з номіналу на **обидві межі допуску**, через що `R_бази` 150 → 120 Ом і `R_драйв` 470 → 390 Ом |
| «Між enable і +3.3 В треба резистор 4.7 кОм» | у документації й на схемі його не було; на GPIO12 узагалі стояла заборона підтяжки вгору через strapping | Резистор нанесено на схему й у документацію. ⚠️ **Спершу я записав його як ОБОВ'ЯЗКОВИЙ — це виправлено:** власник уточнив, що резистор поставлений для попереднього налагодження і обов'язковим не є. Помилка була в тому, що я вивів «обов'язковість» із самого факту наявності. Заборону підтяжки скасовано з поясненням: GPIO12 справді MTDI, але плата з резистором стартує — отже eFuse напруги флеша пропалено або флеш 1.8 В |
| «Заряд не вмикається; у програмі пишеться про плату на TL494» | **два дефекти.** (1) `CHARGE_LEDC_CH` = 7 — це ПАРА до `LOAD_LEDC_CH` = 6, тобто ТОЙ САМИЙ таймер LEDC, а частоти різні (1 кГц/10 біт проти 25 кГц/11 біт). Розряд займає таймер першим, `ledcAttachChannel()` для заряду повертає false, і старт відхиляється. Правило про попарні таймери записане в цьому ж файлі — за кількасот рядків вище. (2) Усі чотири клієнти й далі описували стару схему на TL494 | Канал заряду 7 → 4 (таймер 2, вільний). Додано `#error` на спільний таймер із розрядом і з ШІМ-зумером; `BUZZER_LEDC_CH` перенесено в `settings.h`, інакше вартовий його не бачив. Тексти в усіх клієнтах переписано під понижувач на PNP B772M |
| «Лінії без підтяжок, використовують функціонал самого контролера (D12, D13)» | внутрішню підтяжку не вмикав ніхто: конструктор OneWire робить `pinMode(pin, INPUT)`, що на ESP32 її ЗНІМАЄ | `dsIdle()` вмикає її ЯВНО після конструктора. Заразом виправлено щойно доданий `busLineCheck()`: він ставив `pinMode(INPUT)` і тим самим сам вимикав підтяжку |
| «Підтяжка в оригіналі потрібна була точно» | я зробив із цього хибний висновок, ніби внутрішньої ДОСИТЬ, і так і записав у документацію | Виправлено: зовнішній резистор 2.2…4.7 кОм **обов'язковий**, бо DS2433/DS2438 живляться ПАРАЗИТНО з лінії даних, а 45 кОм не дають їм струму. Внутрішня лишається другорядним запобіжником. `busLineCheck()` перероблено: перша редакція читала «лінія висока без нашої підтяжки» як НЕСПРАВНІСТЬ — тобто лаялась на правильну плату й мовчала на тій, де резистора немає |
| «До переробок заряду з D12/D13 усе працювало» | переробка прибрала `CHARGE_PIN` (GPIO32), і пін лишився ВИСІТИ ВХОДОМ, хоча раніше його опускали в LOW найпершим рядком | Повернуто утримання в LOW (`CHARGE_LEGACY_EN_PIN`). Плюс перевірка ЛІНІЇ ДАНИХ, а не лише керуючого піна: `busLineCheck()` бачить випадок «пін справний, а підтяжка до шини не доходить» — обрив резистора, немає контакту або **немає спільної землі з пакетом** (а її й зачіпає шунт у мінусовому проводі, доданий разом із зарядом) |
| «Перевір роботу D12: при читанні помилка, немає pull up» | лінія enable/підтяжки ніяк не перевірялась — прошивка піднімала пін і йшла далі | Додано `enableLineCheck()`: підняти, прочитати рівень назад, опустити, прочитати ще раз. Несправність тепер названа («ПОМИЛКА: підтяжка (GPIO12)») замість «нема чіпа», що звинувачувало пакет. Задокументовано, що GPIO12 — strapping-пін MTDI |
| «Виправити: треба 14 В» | у повідомленні стояв лише допуск «потрібно 12.5…16.0 В» | Головним числом став НОМІНАЛ: «треба 14 В (допуск 12.5…16.0)». Допуск пояснює, чому блок відхилено, але не каже, який під'єднати. Номінал береться з `CHARGE_SUPPLY_MV` (поле `psuNomMv` для клієнтів), а не зашитий у текст |
| «Блимати має плашка з текстом, а не текст» | блимав сам напис — півперіоду порожня червона смуга без причини | Блимає тло й рамка, текст стоїть нерухомо (на монохромному — інверсія заливки). Формулювання назвали причину: «ЗАВИЩЕНА/ЗАНИЖЕНА НАПРУГА БЛОКА ЖИВЛЕННЯ» окремим полем `psuHead` для всіх клієнтів |
| «Помилка живлення має бути на екрані й у клієнтах, із блиманням» | було лише «!» у шапці й рядок на сторінці заряду | Окрема сторінка помилки, що з'являється САМА (обидва екрани), із блимаючим написом; блимаючі смуги у вебі, HTML- і Python-клієнті. Сторінка знімається кнопкою — без блока живлення прилад лишається придатним для читання й правки пам'яті |
| «Зображення не з'явилось» ✅ **вирішено** | режим і частота SPI не налаштовувались: `tft.init()` кликався без них | Обидва винесено в `settings.h`. Для панелей без CS типово режим **3**: CS припаяний до землі, контролер вибраний завжди й межу посилки визначає за станом такту в спокої — з «не тим» режимом біти приймаються зі зсувом і екран лишається чорним. Частота теж явна (24 МГц) — типова бібліотечна на перемичках дає «сніг» або чорноту |
| «На дисплеї немає CS» | `DISPLAY_CS_PIN` вважався обов'язковим | CS став необов'язковим (`-1` / `U8X8_PIN_NONE`); вартові з ним обгорнуто в `defined()`, інакше його відсутність читалась би як GPIO0; додано перевірку, що шину SPI ніхто не ділить. Типовим лишили ЗАДАНИЙ пін: смикати непід'єднаний GPIO безкоштовно, а `-1` залежить від версії Adafruit_SPITFT |

## 3.3. Чотири помилки, яких я припустився по дорозі

Вони варті окремої згадки: усі чотири пройшли б непоміченими, якби кожну
`#error`-перевірку не прогнати на **навмисно порушеній** конфігурації.

**«Точка нульового струму».** Я написав, що `D = Uпакета/Uживл` дає нульовий
струм і з неї безпечно стартувати. Насправді це межа режимів, і середній струм
там — половина розмаху пульсацій, тобто ~650 мА. Виявив, підставляючи уточнену
індуктивність 104 мкГн.

**Критерій переривчастого режиму вдвічі суворіший.** Порівнював уставку з
**повним** розмахом пульсацій замість **половини**. Перевірка хибно спрацювала,
щойно профіль знизили під тепловий бюджет ключа.

**Той самий дефект №4 — власноруч.** Перевірка струму бази не спрацювала, хоча
умова була порушена: макрос `CHARGE_RIPPLE_MA_EST` визначався **нижче** за
`#if`, який його згадує. Виправлено: усі розрахункові макроси винесено на
початок блока перевірок, із коментарем, чому порядок тут не косметика.

**І він же — вдруге, тим самим способом.** Додаючи перевірки живлення, я
поставив їх у файлі **вище** за `CHARGE_NPN_IB_UA`, і препроцесор знову
прочитав макрос як нуль — перевірка спрацювала хибно на цілком справній
конфігурації. Тобто коментар «порядок тут не косметика» я написав сам і сам
же його порушив за кілька правок. `CHARGE_NPN_IB_UA` теж переїхав нагору.
Мораль та сама, але тепер із доказом: у C-препроцесорі невідомий ідентифікатор
у `#if` — це **мовчазний нуль**, і жодного попередження не буде.

**Резистори, пораховані на одну точку замість діапазону.** `R_бази` 150 Ом і
`R_драйв` 470 Ом я порахував на номінальні 14 В — і обидва не витримали, щойно
з'явився допуск живлення 12.5…16 В: перший не насичує ключ на нижній межі,
другий не насичує NPN на верхній. Знайшли це не вимірювання, а самі
`#error`-перевірки при першій же збірці. Звідси й правило, яке тепер записане
в `settings.h`: обв'язку рахують на **межах** допуску, а не в його середині.

---

## 3.4. Дві скарги з випробувань на залізі

Обидві виглядали як несправність заряду, а виявились дефектами прошивки —
причому такими, де прошивка **сама створювала аварію** або **сама ставила
неправильний діагноз**.

### «Під час заряду або розряду пристрій періодично перезавантажується»

Перезавантажував **сторожовий таймер**, і робив це на цілком справному
пристрої. У налаштуванні Task WDT стояло:

```c
esp_task_wdt_config_t cfg = { CHARGE_WDT_SEC * 1000U,
                              (uint32_t)(1 << portNUM_PROCESSORS) - 1, true };
//                             ^^^^^^^^^^^^^^^^^^^^^^^^^^^^^^^^^^^^^ = 0b11
```

Друге поле — `idle_core_mask`, перелік **бездіяльних** задач, які теж мусять
відмічатися у сторожа. `0b11` означає «обидва ядра». На вигляд — «хай стежить
за всім, гірше не буде».

Гірше стало. Скетч Arduino крутиться в задачі `loopTask` із пріоритетом 1,
прибитій до ядра 1. `IDLE1` має пріоритет 0 і отримує процесор **лише** тоді,
коли `loopTask` заблокується. А наш `loop()` не блокувався ніде — суцільне
неблокуюче опитування, чим цей проєкт, власне, й пишався. Отже `IDLE1` не
виконувалась, сторожа не годувала, і рівно через `CHARGE_WDT_SEC` (10 с) або
`DISCHARGE_WDT_SEC` (30 с) прошивка падала в паніку `Task watchdog got
triggered … IDLE1`.

Саме тому arduino-esp32 у своїй типовій конфігурації вмикає перевірку `IDLE0`
і **не** вмикає `IDLE1`: автори знають, що цикл Arduino окупує ядро 1. Наш
виклик `esp_task_wdt_init()` мовчки скасовував це рішення.

«Періодично», а не «завжди» — бо зрідка цикл усе ж блокувався: звернення
веб-клієнта, робота зі SPIFFS, `Serial.flush()`, плавні згасання підсвітки.
Кожна така пауза давала `IDLE1` шанс відмітитись і відсувала падіння. Тиха
зарядка без під'єднаного клієнта падала найшвидше.

Виправлено трьома правками:

1. **Маска — жорсткий нуль.** Сторож стежить за тією однією задачею, яка
   справді керує ключем. Це не послаблення: саме її зависання ми й ловимо.
2. **`loop()` віддає квант часу** — `delay(1)` наприкінці. Бездіяльна задача
   мусить виконуватись і без сторожа: саме вона звільняє пам'ять видалених
   задач FreeRTOS, а без цього купа повільно тане — інший клас «раптових
   перезавантажень».
3. **На зупинці більше не викликається `esp_task_wdt_deinit()`.** Сторожа на
   цьому пристрої створюємо не ми — arduino-esp32 піднімає його ще до
   `setup()`. Наш `deinit` зносив увесь механізм, і після першого ж заряду
   пристрій до кінця сеансу лишався взагалі без Task WDT, тобто **справжнє**
   зависання циклу вже ніхто не ловив. Тепер відновлюються завантажувальні
   налаштування.

Окремо: код сторожа був **скопійований** у `charge.h` і `discharge.h` двома
майже однаковими копіями, тож і помилка була однакова, і ловити її довелось
двічі. Механізм переїхав у спільний `wdt.h`; тест стежить, щоб копії не
з'явились знову.

### «При досягненні максимального заряду: напруга 9.9 В, аварійна зупинка, перенапруга»

Тут неправдою було **все повідомлення цілком**.

9.9 В — це не виміряна напруга. Це рівно те число, яке видає ланцюжок
перерахунку, коли АЦП уперся в стелю:

```
chargeAdcMv()  = 4095 × CHARGE_ADC_FULL_MV / CHARGE_ADC_MAX_RAW = 4095 × 3300 / 4095 = 3300 мВ
chargePackMv() = 3300 × (R_TOP + R_BOT) / R_BOT                 = 3300 × 30000 / 10000 = 9900 мВ
```

Тобто «9.9 В» — підпис відліку 4095, а не напруга на клемі. Про саме залипання
в `settings.h` написано прямо (біля `CHARGE_ADC_MAX_MV`), але прошивка все одно
брала залиплу цифру за напругу пакета. Перенапруги теж не було: 6-елементний
пакет IMPRES фізично не буває під 9.9 В — повний це 8.25 В.

Що впертий у стелю вхід означає насправді: на плюсовій клемі стоїть **напруга
живлення**, а не напруга пакета. Пакета в колі немає. Причини за спаданням
імовірності: втрачено контакт клем; знято `enable` (немає обов'язкового
рівень просів або обірвано лінію); пакет від'єднався власним
внутрішнім захистом.

Іронія в тому, що цей самий сценарій у `settings.h` уже описаний — перевіркою
(2) «якщо пакет від'єднати посеред заряду, на клемі лишиться напруга
живлення». Вона стежила, щоб **пін це пережив**, і нікому не спало на думку,
що прошивка при цьому **неправильно назве** побачене.

Виправлено:

* нова причина зупинки `CHGR_NOPACK` із чесним текстом і підказкою, що
  перевіряти;
* відсічка `chargeNoPackTrip()` перевіряється **раніше** за перенапругу —
  залипле показання підходить під обидві умови, і порядок вирішує діагноз;
* поріг `CHARGE_VSENSE_SAT_MV` **обчислюється** з номіналів подільника
  (9300 мВ), а не пишеться числом, і дві нові `#error`-перевірки тримають його
  між аварійною межею (8350) і максимально можливим показанням (9900): нижче —
  з'їдав би справжню перенапругу, вище — не спрацював би ніколи;
* напруга з монітора DS2438 **більше не викидається**. Раніше вона йшла у
  змінну на ім'я `dummy` — а це єдиний у прошивці незалежний вимір напруги,
  зроблений **ізсередини** пакета. Тепер вона зберігається, друкується в
  кожному рядку журналу поруч із виміром на клемі й входить в аварійне
  повідомлення: коли клема пішла в стелю, а чип показує 8 В, діагноз
  однозначний.

## 3.5. Заміна ключа на P-канальний MOSFET — і чому це не «просто інший корпус»

Власник поставив замість B772M польовий **NTD2955G**. У коді з'явився вибір
типу ключа (`CHARGE_SWITCH_TYPE`), і це не перейменування блока: обв'язка
СПІЛЬНА, а фізика різна настільки, що майже кожна перевірка силової частини
мусила розгалузитись.

**Ті самі резистори означають тепер зовсім інше.** У біполярника `R_drive`
задавав **струм бази**. У польового затвор струму не споживає, і `R_drive`
разом із запираючою підтяжкою утворює звичайний **дільник напруги**:

```
Uзатв = Uке_нас(npn) + (Uживл − Uке_нас) × R_drive/(R_drive + R_підт)
      = 0.2 + 13.8 × 120/1120 = 1.68 В   →   |VGS| = 14 − 1.68 = 12.3 В
```

Резистори ті самі, фізичний зміст — інший. Підставити в стару формулу нові
номінали означало б отримати зручне, але неправильне число саме там, де воно
вирішує долю ключа.

**Що змінилось у перевірках:**

| Було (біполярний) | Стало (польовий) |
|---|---|
| `Iб ≥ Iк/β_форс` на нижній межі живлення | `\|VGS\| ≥ 1.5×VGS(th)` на нижній межі живлення |
| — | `\|VGS\| ≤ 0.8×VGS(max)` на **верхній** межі (пробій затвора — відмова назавжди) |
| — | `Uживл ≤ 0.8×Vds(max)` |
| — | перемикання ≤ 10 % періоду ШІМ (інакше ключ — резистор під 14 В) |
| NPN пропускає струм **бази** | NPN пропускає наскрізний струм **дільника** |
| підтяжка не з'їдає понад 20 % драйвера | підтяжка не розсіює понад 0.25 Вт |
| `P = Uке_нас × I × D` (лінійно) | `P = I²×RDS(on) × D` (**квадратично**) |
| `tsw` з даташита | `tsw` з `Qg` і струму **нашого** драйвера |

Останній рядок варто прочитати двічі: у польового час перемикання задає не
паспорт приладу, а те, скільки струму дає в затвор наша обв'язка. Паспортні
45 нс — це те, що прилад показав би з нормальним драйвером; у нас вимикання
триває 1838 нс, бо вгору затвор тягне сама лише підтяжка 1 кОм.

**Що це дало по числах.** Розсіювання на ключі 473 мВт замість 819, і головне
— проти `Pd` 55 Вт замість `Pc` 1.25 Вт, тобто радіатор більше не потрібен.
Драйвер палить 172 мВт замість 1505: ват, який біполярник спалював просто на
відкривання, зник разом із струмом бази.

**І одна вимога до заліза ослабла, а одна — ні.** Заміна 20 кОм → 390 Ом у
базі NPN лишається обов'язковою (причина інша — тепер це наскрізний струм
дільника, а не струм бази). А `R_drive` 1 кОм → 120 Ом стала бажаною замість
смертельної: 1 кОм дає |VGS| 6.9 В при порозі 4 В, ключ відкривається — просто
з опором каналу вище паспортного. Прошивка друкує обидва числа при старті й
називає, яка заміна критична, а яка ні.

**Перевірено в обидва боки.** Увесь набір із 8 тестів зібрано й прогнано
двічі — з `CHARGE_SW_PMOS` і з `CHARGE_SW_BJT_PNP`:

```bash
# бойова конфігурація
for f in tools/*_check.cpp; do g++ -std=c++17 -I. -Itools/fake -o /tmp/t "$f" && /tmp/t; done
# і та сама з біполярним ключем — опція мусить лишатись робочою
mkdir -p /tmp/bjt && sed 's/CHARGE_SWITCH_TYPE CHARGE_SW_PMOS/CHARGE_SWITCH_TYPE CHARGE_SW_BJT_PNP/' \
  settings.h > /tmp/bjt/settings.h
for f in tools/*_check.cpp; do g++ -std=c++17 -I/tmp/bjt -I. -Itools/fake -o /tmp/t "$f" && /tmp/t; done
```

Усі сім нових `#error`-перевірок прогнано на навмисно зламаній конфігурації —
кожна спрацювала.

## 3.6. Дозаряд малим струмом від 90 % і кінець заряду на 8.2 В

Дві зміни на вимогу власника, обидві про ресурс пакета, а не про швидкість.

**Поріг переходу на малий струм: 95 % → 90 %** (`CHARGE_TAPER_PCT`). Останні
відсотки набираються при напрузі, близькій до кінцевої, і саме там струм
найшкідливіший: він піднімає напругу на внутрішньому опорі пакета, тож банки
бачать більше, ніж показує клема, і заряд фактично заходить за межу. Що раніше
перейти на 100 мА, то ближче виміряна напруга до справжньої напруги банок.
Ціна — час: відрізок 90…100 % тепер іде на 100 мА замість 1000.

Поріг перестав бути числом у коді: раніше `95` було зашите просто в
`chargeSetpointMaForPct()`, тепер це константа, яку читає ще й перевірка в
`settings.h`. Два джерела однієї величини рано чи пізно розходяться — у цьому
проєкті таке вже траплялось.

Заразом поріг збігся з `CHARGE_LED_TAPER_PCT`, і це чесніше, ніж було:
індикатор перемикається рівно тоді, коли режим справді змінюється. Раніше він
показував «майже готово» на 90 %, тоді як струм падав лише на 95 %. Нова
перевірка не дасть їм розійтись у ІНШИЙ бік (індикатор пізніше за спад) — це
означало б, що пристрій показує крейсерський заряд, уже дозаряджаючи.

**Кінець повного заряду: 8.25 В → 8.2 В** (`CHARGE_TARGET_MV`). Тут головне —
що саме розчеплено. Було `CHARGE_TARGET_MV = BATTERY_FULL_MV`, тобто одне
число служило двом різним ролям:

* `BATTERY_FULL_MV` (8250) — «100 %» **шкали паливоміра**. За нею рахуються
  відсотки скрізь: головний екран, розряд, записи в пам'ять пакета;
* `CHARGE_TARGET_MV` (8200) — те, **до чого ми заряджаємо**.

Змішувати їх не можна: опустити шкалу означало б переписати відсотки в усьому
пристрої, включно з уже збереженими даними.

⚠️ **Наслідок, який легко прийняти за дефект:** наприкінці успішного заряду
паливомір покаже **~97 %**. Це арифметика шкали (8200 на 6350…8250 = 97 %), а
не недозаряд. Тримати банки біля самої стелі — головна причина прискореної
деградації; 50 мВ недобору коштують кількох відсотків ємності й віддають
помітно більший ресурс. Тест фіксує це число явно, щоб воно не було
несподіванкою.

Якщо колись знадобиться рівно 100 % наприкінці заряду — міняти треба
`BATTERY_FULL_MV`, тобто всю шкалу разом із розрядом, а не ціль заряду.

**Нових `#error`-перевірок шість**, і всі прогнано на зламаній конфігурації:
поріг дозаряду всередині 80…100 %; індикатор не пізніший за спад струму;
дозарядний струм щонайменше втричі менший за крейсерський; ціль заряду не вище
верху шкали, не нижче порожнього пакета і вище за ціль розряду.

## 3.7. Заставка через SPIFFS, enable перед стартом заряду

### Кольорова заставка без перепрошивання

Раніше кастомна заставка означала повний цикл: `make_color_splash.py` робив
`custom_splash.h` із C-масивом, файл клався в теку скетчу, далі Arduino IDE,
компіляція, прошивання. Помінялась картинка — усе спочатку.

Тепер її можна просто **завантажити у SPIFFS** через веб («Заставка екрана»).
Прошивка лишається та сама.

**Підтримуються ДВА формати, і тип визначається за МАГІЄЮ файла**, а не за
розширенням (розширення бреше, перші байти — ні):

| | JPEG | сирий `.bin` |
|---|---|---|
| що вантажити | звичайний JPEG/JPG із телефона чи редактора | підготовлений RGB565 |
| місце у SPIFFS (240×240) | **10…30 КБ** | 113 КБ |
| перетворення | не потрібне — пристрій розкодує сам | браузер або `--bin` |
| залежність | бібліотека **TJpg_Decoder** | жодної |

⚑ **Спершу тут свідомо підтримувався лише сирий RGB565**, і аргумент був такий:
декодер тягне бібліотеку, пам'ять під розпакування і новий клас падінь на
кривому файлі — заради картинки, яку показують півтори секунди. Власник
попросив вантажити просто JPEG, і в аргументу виявився другий бік, який
переважує: у файловій системі вже лежить `index.html` на 226 КБ, і різниця в
сотню кілобайтів там відчутна. Обидва формати лишились; JPEG вимикається
одним рядком (`DISPLAY_SPLASH_JPEG`), і тоді залежностей немає взагалі.

**Формат сирого файла — RGB565 із 8-байтовим заголовком** (`splash.h`):

```
0..3  'M','B','S','1'
4..5  ширина, пікселів (LE)
6..7  висота,  пікселів (LE)
8..   w*h*2 байтів RGB565, СТАРШИЙ БАЙТ ПЕРШИМ, рядками зверху вниз
```

Чому не PNG: декодер у прошивці — це бібліотека, пам'ять під розпакування і
новий клас падінь на кривому файлі заради картинки, яку показують півтори
секунди. Сирий RGB565 не декодується взагалі. Перетворення робить **браузер**
(canvas і так уміє відкрити будь-що) або `make_color_splash.py --bin`.

Big-endian — не примха: саме в цьому порядку байти йдуть у шину ST7789, тож
`writePixels(..., bigEndian=true)` віддає буфер напряму, без перевертання
кожного пікселя.

Заголовок потрібен рівно для одного: **чужий файл ПОТРІБНОЇ довжини**. Без
магії будь-що завдовжки 115 208 байтів пройшло б як картинка й вивалилось на
екран шумом. Тест перевіряє саме цей випадок, і ще — що магія читається
**раніше** за розміри, інакше на PNG повідомлення було б «довжина не
збігається», тобто вело б шукати не туди.

Ще дві речі, які легко зробити неправильно:

* **Малюємо потоком**, а не цілим буфером: 240×240 RGB565 — це 115 200 байтів,
  і виділяти їх на старті (одночасно з підняттям Wi-Fi) заради півтори
  секунди — марно. Читаємо рядок і одразу віддаємо в шину, буфер — 480 байтів.
* **Приймаємо у тимчасовий файл.** Приймання може обірватись, і затерти робочу
  заставку недописаним шматком означало б зламати те, що працювало, — при
  спробі, яка навіть не дійшла до кінця. Бойовий файл підміняється лише після
  перевірки. Стелю розміру теж перевіряємо **на ходу**, інакше завеликий файл
  спершу заповнив би SPIFFS (витіснивши `index.html`) і лише потім був би
  відхилений.

Порядок джерел у `displaySplash()`: **JPEG → сирий `.bin` → `custom_splash.h`
→ типова НГУ**. Перевага JPEG не довільна: приймальник, зберігаючи один
формат, **видаляє інший**, тож два файли поруч не лежать, і «поточна заставка»
не залежить від порядку перевірок.
Загалом: Файл перекриває вкомпільовану картинку навмисно: це вибір,
зроблений пізніше за прошивання.

⚑ Приймальник і дисплей розбирають файл **тим самим** `splashParse()`. Два
окремі розбори рано чи пізно розійдуться, і приймальник почне пропускати те,
чого дисплей не покаже.

### Enable піднімається ПЕРШИМ, а не останнім

Пакет IMPRES під'єднує клеми до зовнішнього кола за сигналом enable. Поки він
не піднятий, на клемі немає напруги **пакета** — там або нічого, або напруга
нашого ж живлення через ключ.

А `chargeStart()` піднімав enable **у самому кінці** — після того, як зміряно
напругу, струм і температуру, і навіть після `chargeSetDuty()`, тобто струм
подавався раніше за під'єднання пакета. Коментар поруч при цьому стверджував
«enable ще ДО подачі струму»; порядок був зворотний.

Тепер enable піднімається найпершим, далі пауза `CHARGE_ENABLE_LEAD_MS`
(100 мс) — і лише потім усі виміри й перевірки. Це, серед іншого, прибирає
одне з джерел хибної «перенапруги 9.9 В» з розділу 3.4: вимір на розімкненій
клемі давав стелю подільника.

⚑ Тіло після підйому enable винесене в лямбду **не для краси**: у нього сім
різних виходів «не можна почати», і при кожному enable треба зняти назад. Сім
однакових рядків перед сімома `return` — це шість шансів забути один і лишити
пакет під'єднаним після невдалого старту. Тепер точка згортання одна.

### Заразом виправлено

Резистор 4.7 кОм між GPIO12 (enable) і +3.3 В **більше не називається
обов'язковим**. Власник уточнив: він стоїть на платі, але поставлений для
попереднього налагодження функцій. Я вивів «обов'язковість» із самого факту
наявності — це було припущення, а не факт із цієї плати. Виправлено в
`settings.h`, `README.md`, `INSTRUCTION.md`, `СХЕМА.html` і в тексті аварійного
повідомлення «пакет від'єднано», яке відправляло перевіряти саме цей резистор.
⚠️ Не плутати з підтяжкою **лінії даних** (GPIO13) — ота обов'язкова: чипи
живляться з неї паразитно.

## 3.8. Bluetooth: ті самі клієнти без кабелю

> 🔴 **ЗАРАЗ ВИМКНЕНО (`BT_ENABLED` закоментовано).** На залізі з увімкненим
> Bluetooth пристрій перестав під'єднуватись по Wi-Fi. Причина майже напевно в
> пам'яті: стек Bluedroid забирає десятки кілобайтів купи, а точці доступу
> разом із веб-сервером, SPIFFS і буферами дисплея й так лишалось небагато.
> Друга складова — спільне радіо: Wi-Fi і класичний BT діляться ефіром, і
> навіть коли обидва піднялись, з'єднання стає хитким.
>
> Wi-Fi тут **головний** канал (веб-інтерфейс, завантаження заставки,
> оновлення), а Bluetooth — зручність поверх нього; втрачати головне заради
> зручності не можна. Увесь код лишився на місці й перевірений — вмикається
> одним рядком. Рядок «Вільна купа: …» у журналі при старті показує, чи
> вистачає пам'яті на конкретній збірці.

Командний протокол (`serial_api.h`) віддається ще й по **Bluetooth SPP** —
послідовному порту поверх радіо.

**Вибір SPP, а не BLE, вирішує тут майже все.** На комп'ютері SPP виглядає
ЗВИЧАЙНИМ COM-портом, тож `moto_gui.py` (pyserial), `moto_bridge.py` і
`client_usb.html` (Web Serial) працюють **без жодних змін** — треба лише обрати
інший порт зі списку. BLE довелося б обгортати власним GATT-сервісом і
переписувати транспорт у кожному клієнті; Web Bluetooth уміє тільки BLE, зате
Web Serial уміє COM-порт — тобто браузерний клієнт і так дістає радіо через SPP.

Протокол виявився майже готовим до цього: у `serial_api.h` було рівно **п'ять**
згадок `Serial`. Тепер вивід іде через `Stream *`, і обидва канали обслуговує
спільний `serialPump()`.

Два місця, де легко зробити мовчазний дефект:

* **Відповідь мусить іти туди, звідки прийшла команда.** Якби `sResp()` і далі
  писав у `Serial`, клієнт по Bluetooth не бачив би ЖОДНОЇ відповіді, а чужі
  відповіді сипались би в USB-консоль. На столі це виглядає як «пристрій не
  відповідає». `g_serOut` перемикається на час виконання й повертається назад.
* **Накопичувачі входу окремі.** Один спільний означав би, що дві команди, які
  прийшли одночасно різними каналами, склеяться в одну — рідко,
  недетерміновано й дуже неприємно для пошуку.

### Чому по радіо запис вимагає пароль

По USB протокол відкритий повністю, і це виправдано: щоб щось надіслати, треба
фізично встромити кабель. `AUTH` там лише звіряє пароль і підсвічує статус —
команди запису працюють і без нього.

По Bluetooth такого захисту немає. У радіусі дії опиняється будь-хто, а серед
команд є `WIPE33`, `WRITE33`, `CLEAN` — повне стирання пам'яті акумулятора.
Мовчки винести цей перелік в ефір означало б зробити з «хтось поруч» справу
однієї команди.

Тому по BT читати можна вільно (щоб клієнт знайшов пристрій і показав стан), а
змінювати — лише після `AUTH <пароль>`. По USB поведінка **не змінилась**.

⚑ Перелік «безпечних» команд узято **закритим і білим**: усе, чого в ньому
немає, вважається записом. Забути дописати нову команду в перелік дозволених —
це відмова в бік «попросить пароль». Чорний перелік при тій самій
забудькуватості пустив би її в ефір без пароля.

### Що доведеться зробити при збірці

| | |
|---|---|
| Схема розділів | **Huge APP (3MB No OTA/1MB SPIFFS)** — інакше прошивка зі стеком BT не влізе |
| Плата | лише **звичайний ESP32**: на S3/C3/C6 класичного BT немає фізично |
| Пароль | змініть `ADMIN_PASSWORD` — стандартний «admin123» по радіо майже те саме, що без пароля |

Перевірити схему розділів на компіляції неможливо (вона задається в IDE), тому
пристрій друкує вільну купу при старті, а `BluetoothSerial` просто не
запуститься, якщо місця немає — і скаже про це прямо.

### Збірка на ядрі 3.3.11: `setPin()` змінив сигнатуру

Перша збірка на залізі впала:

```
error: no matching function for call to 'BluetoothSerial::setPin(const char [5])'
note: candidate: 'bool BluetoothSerial::setPin(const char*, uint8_t)'
```

У arduino-esp32 **2.x** метод був `setPin(const char *pin)`, у **3.x** став
`setPin(const char *pin, uint8_t pin_code_len)`. Виправлено гілкою за
`ESP_ARDUINO_VERSION_MAJOR` — тим самим способом, що вже застосований у
`wdt.h`, разом із захисним `#error` на випадок, коли макрос невідомий (інакше
препроцесор мовчки прочитав би його як нуль і пішов гілкою для 2.x, тобто
впав би на тій самій помилці).

Довжина береться з самого літерала — `sizeof(BT_PIN) - 1`, а не пишеться
числом: інакше зміна `BT_PIN` тихо розійшлася б із переданою довжиною, і PIN
або обрізався б, або читався за межами рядка.

Обидві гілки перевірено збіркою проти **змодельованих заголовків** обох ядер
(заглушка `BluetoothSerial` із відповідною сигнатурою), а не «на око».

Довжини імені й PIN перевіряються `static_assert`-ами, а не `#if`: препроцесор
не вміє `sizeof`, і спроба написати `#if (sizeof(BT_NAME) - 1) > 26` дає
«missing binary operator before token "("». Заразом `constexpr`-перевірка
ловить літери в PIN — legacy pairing їх не приймає, і виявилось би це аж на
спарюванні.

## 3.9. Завелику заставку тепер зменшують, а не відхиляють

Було: JPEG більший за екран відхилявся з проханням зменшити самому. Знімок із
телефона майже завжди більший, тож це означало похід у редактор заради того,
що можна зробити автоматично.

**Зменшення в ДВОХ місцях, і вони різні за призначенням:**

* **У браузері — основний шлях.** Картинку і так вписують у розмір панелі зі
  збереженням пропорцій (той самий `contain`/`cover`); тепер готовий кадр
  зберігається назад у JPEG. Якість підбирається згори вниз (0.92 → 0.45),
  поки файл не влізе у стелю: краще трохи гірша картинка, ніж відмова.
* **На пристрої — запобіжник** для файлів, що потрапили у SPIFFS іншим шляхом.
  `splashJpegScaleFor()` обирає коефіцієнт 1/2/4/8.

⚑ **Чому на пристрої лише кратно двом.** TJpgDec зменшує в 1, 2, 4 або 8 разів —
це властивість формату, а не обмеження бібліотеки: JPEG зберігається блоками
8×8, і кратне зменшення робиться прямо під час зворотного перетворення, майже
безкоштовно. Довільний коефіцієнт вимагав би повного розкодування в пам'ять і
власного ресемплера — тобто рівно тих витрат, яких ми уникали, обираючи JPEG.
Саме тому основне масштабування лишається за браузером: 400×300 він дає рівно
240×180, а пристрій дав би 200×150 — «майже влізло» із зайвими полями.

**Пропорції зберігаються самі собою**, бо коефіцієнт ОДИН на обидві осі. Тест
перевіряє це не «на око», а числом: `dw × h` проти `dh × w` із допуском на
заокруглення блоків.

⚠️ Заокруглення — **вгору**: декодер видає `ceil(w/n)` пікселів. Округливши
вниз, ми вирішили б, що картинка влізла, і останній стовпчик поїхав би за край.
Через це 481 px при `/2` дає 241 — на піксель більше за екран, — і береться
`/4`. Це теж у тесті.

Відмова лишилась там, де не рятує навіть `/8`: ширший за екран понад увосьмеро
(для 240 px це 1921 px і більше). Краще сказати прямо, ніж показати обрізок.

## 3.10. Анімація шкали батареї більше не «скидається» на кожному опитуванні

Скарга: під час заряду/розряду анімована шкала раз на секунду смикається —
видно спалах рівного кольору замість плавного градієнта, що біжить.

**Причина була не в анімації, а в тому, що її щоразу стирали.** Сторінка
заряду на кожному опитуванні робила так:

```c
tft.fillRect(0, by - 2, TFT_W, bh + 4, C_BG);   // затерти смугу у фон
drawBatteryBar(...);                            // намалювати РІВНУ заливку
```

Далі `displayAnimTick()` (~9 к/с) знову клав градієнт поверх. Тобто кожної
секунди картинка на мить поверталась до рівного кольору — рівно те, що
читається як «скинулось».

**І перемальовувати було ні до чого.** Напруга змінюється щосекунди, а
ГРАФІЧНИЙ рівень — ні. Тепер рішення «малювати чи ні» ухвалюється за тим, що
видно на екрані: ширина заповнення **в пікселях**, колір і геометрія.
Збіглося все — не чіпаємо жодного пікселя, і градієнт біжить безперервно.

Три речі, без яких це не працювало б:

* **Порівнюємо ширину в пікселях, а не відсоток.** Порівняння за відсотком
  лишило б той самий дефект, просто рідше.
* **Шкала чистить власний слід сама** — і лише коли справді малює. Затирання
  на боці сторінки прибрано; заразом воно звузилось із «смуга на всю ширину»
  до footprint самої шкали, інакше на головній сторінці з'їдало б цифри
  відсотка поруч.
* **«Покоління» екрана.** Після `fillScreen()` кеш «уже намальовано» брехав би:
  стан той самий, а пікселів немає. Тому кожне повне очищення (заставка,
  перемальовка, зміна червоного відтінку, очищення тіла сторінки) оголошує
  нове покоління, і шкала малюється заново.

Заразом прибрано **друге джерело тих самих чисел**: `displayAnimTick()` рахував
ширину заповнення власною формулою з `batteryPercent()`. Поки вона збігалася з
тим, що намалювала сторінка, все виглядало гаразд; варто було б їм розійтися на
піксель — і градієнт малювався б іншої довжини, ніж рамка. Тепер анімація бере
`fw` і колір із намальованого стану.

### Що це дало, числом

Тест проганяє реальний хід напруги 7.40 → 8.20 В по одному мілівольту:

```
801 опитування -> 43 перемальовки замість 801
```

⚠️ **Одне моє припущення тест спростував.** Я записав, що «сусідні відсотки
часто дають однакову ширину, тому й економія». На шкалі 200 px це неправда:
194 px на 101 значення — кожен відсоток рухає щонайменше піксель. Збіги
з'являються на вузькій шкалі (60 px — майже половина відсотків не рухає
нічого), а на широкій економія береться з іншого місця: із квантування
«мілівольти → відсоток». Твердження було вигадане, а не виміряне; у тесті тепер
перевіряються обидві ширини.

**Монохромний шлях (`display.h`) не чіпав:** там U8g2 із повним буфером кадру,
сторінка й так перемальовується цілком, а сама анімація перебудовує іконку
щокадру — це її спосіб працювати, а не дефект.

## 3.11. Перезавантаження під час заряду/розряду: чорний ящик і фрагментація

Скарга повернулась після виправлення сторожа (3.4). Отже причина інша — і
головна проблема була не в ній, а в тому, що **після скидання від події не
лишалось нічого**. Кожна спроба закрити скаргу була здогадкою: сторож,
пам'ять, живлення, ШІМ.

### Чорний ящик (`postmortem.h`)

Раз на опитування пристрій записує кілька чисел у **RTC-пам'ять, яка переживає
скидання** (`RTC_NOINIT_ATTR` — завантажувач її не чіпає). Після
перезавантаження вони друкуються в журнал **і показуються у веб-клієнті** на
картці заряду:

```
RESET REASON: TASK WDT — головний цикл (loop) завис (код 6)
ПЕРЕД СКИДАННЯМ: ЗАРЯД, 2847 с роботи, опитування 2841, duty 1180, 940 мА, 8104 мВ
ПЕРЕД СКИДАННЯМ: купа 41216 Б (найбільший блок 9472 Б), запас стека loop() 2104 Б
⚠ КУПА СИЛЬНО ФРАГМЕНТОВАНА — вільної пам'яті вистачає, а суцільного шматка вже немає.
```

Три записані числа — це **три різні підозрювані**, і кожен має свою підказку:

| Число | Що воно ловить |
|---|---|
| запас стека `loop()` | переповнення стека — ззовні не відрізнити від зависання |
| вільна купа vs найбільший блок | фрагментацію: пам'яті «вистачає», а суцільного шматка немає |
| режим, час, шпаруватість | чи прив'язана подія до конкретного місця профілю |

Показуємо лише **ненормальні** причини: подача живлення, кнопка RESET і
навмисний перезапуск — штатні події, і банер про них висів би завжди, а на
такий банер перестають зважати.

### Знайдена й усунена причина: фрагментація купи

`/api/charge` і `/api/discharge` будуються **десятками `j += ...`** і
викликаються **кожну секунду**, поки клієнт дивиться на операцію. Рядок Arduino
росте блоками по 16 байтів, тож кожна відповідь — це десятки
`realloc` (malloc + memcpy + free) плюс тимчасовий `String` на кожне число.

Само по собі це не помилка. Але за години заряду виходять **сотні тисяч
розподілів різного розміру**, а це фрагментація: вільної пам'яті начебто
вистачає, а суцільного шматка під буфер Wi-Fi/TCP уже немає — і черговий
розподіл падає. Виглядає це рівно як «під час заряду пристрій періодично
перезавантажується»: у спокої цього не відбувається, бо ніхто не опитує статус
щосекунди.

Виправлено `reserve()` — один розподіл замість десятків. Якщо не влізе, рядок
доростає як раніше, тобто гірше не стане.

⚠️ **І цю версію журнал спростував.** Чорний ящик спрацював із першого разу:

```
RESET REASON: ПАНІКА/виключення — крах прошивки (код 4)
ПЕРЕД СКИДАННЯМ: ЗАРЯД, 127 с роботи, опитування 10, duty 1387, 490 мА, 8043 мВ
ПЕРЕД СКИДАННЯМ: купа 184192 Б (найбільший блок 110580 Б), запас стека loop() 4304 Б
```

Купа **184 КБ вільно, найбільший блок 110 КБ** — фрагментації немає й близько.
Стек — 4304 байти запасу. Сторож не спрацьовував, живлення не просідало. Це
**справжнє виключення**, і три головні підозрювані відпали одразу.

`reserve()` лишається як розумна оптимізація (сотні тисяч зайвих розподілів —
це зайві розподіли), але **причиною скидань вона не була**. Записую це прямо,
щоб наступний, хто читатиме, не пішов хибним слідом.

### Що каже число «опитування 10»

`CHARGE_TEMP_EVERY_N` = **10**. Тобто саме на цьому опитуванні під час заряду
**вперше** виконується читання DS2438 по 1-Wire — найдовша й найскладніша
операція опитування, на шині, яка на цій платі читається нестабільно (у тому ж
журналі — «нестабільне читання» на кожній сторінці DS2433).

Збіг виключений, але «десь у читанні» — це ще не адреса. Тому додано **позначку
етапу**: опитування розмічене на кроки (вимір струму, напруга, живлення,
DS2438, регулятор, журнал), і номер поточного лежить у тій самій RTC-пам'яті.
Наступне скидання назве не «під час заряду», а:

```
ПЕРЕД СКИДАННЯМ: ЗАРЯД, ЕТАП «читання DS2438 по 1-Wire», ...
```

Що перевірено в цьому шляху й виявилось справним: `dischargeSample()` захищає
ділення на нуль (`rs <= 0` -> константа), `chargeCcaMah()` теж, `pullupOff()`
поважає `_holdEnable` — тобто читання під час заряду **не** знімає enable,
хоча спершу виглядало саме так. Кеш ROM у `findDevices()` перевіряє
presence-pulse перед підстановкою. Джерела паніки читанням коду поки не
знайдено — потрібен блок `Guru Meditation` із backtrace, який панічний
обробник друкує безпосередньо перед перезавантаженням.

### Ще одна ознака від власника: до заряду скидань не було

Це звужує пошук сильніше за все інше. Читання DS2438 по 1-Wire саме по собі
працювало роками — отже падає не воно, а **воно в обставинах заряду**. Що саме
тримає заряд у момент читання й чого немає при звичайному читанні:

| Що додає заряд | Стан під час читання DS2438 |
|---|---|
| ШІМ на GPIO26 через LEDC | канал прикріплений, шпаруватість 0 (ключ закритий) |
| `holdEnable(true)` | PULLUP_PIN тримається HIGH **постійно**, `pullupOff()` стає пустишкою |
| Task WDT | підписаний на задачу циклу, поріг 10 с |
| АЦП | 128 відліків струму + 16 живлення щосекунди |
| Екран | сторінка заряду перемальовується щосекунди + анімація ~9 к/с |

⚠️ **Другий рядок — найцікавіший.** При звичайному читанні кожна транзакція
закінчується `pullupOff()`, тобто обидва чипи знеструмлюються й наступний
пошук іде «з холодного старту» (це прямо описано в `findDevices()`). Під час
заряду цього не відбувається **жодного разу** — лінія тримається піднятою
годинами. Тобто читання під час заряду йде в режимі, у якому воно поза зарядом
не буває ніколи. Це не доказ, але це саме та відмінність, яку варто перевіряти
першою.

### Заразом

* `dischargeSettle()` годував **лише сторож розряду**, хоча його кличе й
  `chargeTask()` — витримка перед виміром напруги. Зараз пауза коротка (10 мс) і
  до порога не дотягує, але це збіг обставин, а не властивість коду: варто
  підняти `CHARGE_VSENSE_SETTLE_MS` — і пристрій почав би перезавантажуватись
  саме на вимірі. Тепер годуються обидва.
* У щосекундний рядок журналу заряду й розряду додано **купу й запас стека**.
  Разові числа нічого не кажуть; потрібен тренд — саме він показує витік і
  фрагментацію ще до падіння.

### Що перевірено й НЕ підтвердилось

Щоб не лишати хибних слідів у документації, перелічую те, що я перевірив і
відкинув:

* **`ledcWrite(канал)` замість `ledcWrite(пін)`.** В arduino-esp32 3.x цей
  виклик приймає ПІН, і помилка тут була б катастрофічною: `LOAD_LEDC_CH` = 6,
  а GPIO6 — це лінія SPI-флеша, звернення до неї валить чип миттєво. Перевірено:
  у проєкті **скрізь передається пін**, помилки немає.
* **Спільний таймер LEDC із зумером.** Заряд (канал 4) і зумер (канал 5) справді
  ділять таймер 2 — але звук вимкнено, `buzzTask()` порожній, конфлікту немає.
* **`LED_CHARGE_TAPER` не в переліку «дихаючих» режимів** у `ledSet()`. Виглядало
  як пропуск, який давав би відчеплення ШІМ посеред апаратного згасання. Ні:
  цей режим і не дихає, він блимає через `digitalWrite`, тож перелік правильний.

## 3.12. ПРИЧИНУ ЗНАЙДЕНО: відчеплення каналу LEDC посеред згасання

Другий журнал із пристрою містив те, чого бракувало — блок паніки:

```
E (64046) task_wdt: esp_task_wdt_init(517): TWDT already initialized
=== Charge started: 7944 mV (83%) -> ціль 8200 mV (100%) ...
charge: ... (89%) ... set 1000 ... 5s
charge: ... (91%) ... set 100  ... 6s
charge: ... (90%) ... set 100  ... 7s
charge: ... (89%) ... set 1000 ... 8s
charge: ... (90%) ... set 100  ... 9s
charge: ... (89%) ... set 1000 ... 10s
Guru Meditation Error: Core 1 panic'ed (LoadProhibited)
PC : 0x4008d029   EXCVADDR: 0x00000141   EXCCAUSE: 0x1c
Backtrace: 0x4008d026:0x3ffc0b2c |<-CORRUPTED
```

### Три факти, які разом дають відповідь

1. **`PC` у IRAM (`0x4008xxxx`), backtrace «CORRUPTED», `EXCVADDR` біля нуля.**
   Це підпис падіння **в обробнику переривання**, а не в звичайному коді.
2. **Відсоток гуляє 89–91–90–89–90–89.** Отже `ledSet()` перемикався між
   `LED_CHARGE` (дихає) і `LED_CHARGE_TAPER` (блимає) **щосекунди**.
3. **`ledSet()` на кожен «не дихаючий» режим кликав `ledPwmDetach()` →
   `ledcDetach()`.** А в «дихаючих» яскравість веде **апаратне згасання**
   `ledcFade()` тривалістю 1.5 с.

Тобто канал LEDC відчіплювався **посеред згасання, що триває**, — і так
десятки разів поспіль. Служба згасання лишалась із обірваним контекстом, і її
обробник переривання падав на читанні за майже нульовою адресою.

**Це пояснює й головну ознаку: «до впровадження заряду перезавантажень не
було».** Заряд — ЄДИНИЙ режим, який регулярно перемикається між дихаючим і
недихаючим станом. Розряд тримає `LED_DISCHARGE` рівно, читання не дихає
взагалі.

### Виправлено з двох боків

**Причина (leds.h): відчеплення прибрано як клас.** Канали LEDC лишаються
прикріпленими, а рівні 0/max виставляються через `ledcWrite()` — це дає ту
саму «цифрову» поведінку, що й `digitalWrite`, без жодного відчеплення.

**Привід (charge.h): гістерезис на порозі дозаряду.** Відсоток рахується з
напруги, а вона на межі природно гуляє на десятки мілівольт (пакет релаксує
після закриття ключа), тож 8046…8079 мВ дають то 89 %, то 91 %. Тепер у
дозаряд входимо на `CHARGE_TAPER_PCT`, а виходимо лише на
`CHARGE_TAPER_HYST_PCT` нижче. Тест на реальній послідовності зі скарги:
**5 перемикань було, 1 стало.**

Заразом це прибирає й самі гойдалки струму: уставка стрибала **1000 ↔ 100 мА
щосекунди**, а слідом метався регулятор шпаруватості (1455 → 1411 → 1360 →
1401 → 1353 → 1395). Десятикратні коливання струму на пакеті й на ключі — це
було погано саме по собі, незалежно від паніки.

Індикатор тепер теж іде за станом `g_chg.inTaper`, а не за власним порівнянням
із порогом: інакше він брязкав би окремо від струму.

### І ще один мій дефект, який журнал показав прямо

```
E (64046) task_wdt: esp_task_wdt_init(517): TWDT already initialized
```

`esp_task_wdt_init()` працює **лише один раз**. Сторож піднімає arduino-esp32
ще до `setup()`, тож наш виклик повертав `ESP_ERR_INVALID_STATE` і **нічого не
міняв**. Мовчки. Тобто вся настройка сторожа з розділу 3.4 — і поріг, і
нульова маска IDLE — **не застосовувалась жодного разу**; підписка
`esp_task_wdt_add()` далі відпрацьовувала успішно, і зовні все здавалось
налаштованим.

Для зміни налаштувань уже піднятого сторожа є окремий виклик —
`esp_task_wdt_reconfigure()`. Тепер пробуємо `init`, а на `INVALID_STATE`
переходимо на `reconfigure`, і про невдачу пишемо в журнал замість мовчання.

---

## 3.13. Пакет закривається сам на 8.2 В — це кінець заряду, а не аварія

Спостереження власника після того, як перезавантаження пішли:

> по досягненні напруги 8.2 вольта, акумулятор сам відключається від зарядки,
> а наше устройство цього не розуміє і намагається зарядити, а при відсутності
> навантаження підвищується напруга до 9.90 В, після чого спрацьовує захист
> по перенапрузі.

Опис точний до останньої деталі, і кожна з них указує на окрему помилку.

### Чому 9.90 В — знову не напруга

Це те саме число, що й у розділі 3.4: підпис відліку АЦП 4095, а не вимір.
Пакет розімкнув свій внутрішній ключ, навантаження зникло, на клемі лишилась
шина живлення — подільник уперся в стелю. Ніякої перенапруги не було.

### Чому «захист по перенапрузі» все одно спрацьовував

Відсічку «пакета немає» ще в 3.4 поставили ПЕРЕД перевіркою аварійної межі —
і цього виявилось замало. Річ у витримці:

| перевірка | витримка |
|---|---|
| «пакет від'єднано» | `CHARGE_NOPACK_POLLS` = **2** опитування |
| аварійна межа | спрацьовує з **першого** відліку |

На першому ж насиченому проході перша перевірка чесно поверталась «ще рано»,
керування спокійно проходило повз неї вниз — і 9900 мВ, формально «вище
8300 мВ», давало `CHGR_HARD_MAX`. Порядок перевірок такого не рятує в принципі.

Рятує інше правило, і воно тепер записане прямо в коді: **насичений відлік не
подається на порівняння з напругою взагалі** — він не є виміром напруги.

```c
if (satMv) return;      // до порівнянь із межами діло не доходить
```

### Чому це взагалі мало вважатися успіхом

Головна ж помилка була не в діагнозі, а в самій постановці питання. На «клема
в стелі» прошивка знала одну відповідь — «пакета немає, аварія». А відповідей
чотири, і розрізняє їх свідок, який у схемі вже був: **монітор DS2438 сидить
усередині пакета**, живиться від банок і має власну лінію даних, тож силовий
ключ пакета його не глушить.

| монітор каже | що це насправді | результат |
|---|---|---|
| мовчить | пакета в колі фізично немає | `CHGR_NOPACK` — аварія |
| ≈ ціль (±`CHARGE_PACKFULL_TOL_MV`) | пакет повний, закрив себе сам | **`CHGR_PACKFULL` — ЗАВЕРШЕНО** |
| помітно нижче цілі | захист спрацював не за напругою | `CHGR_PACKOPEN` — аварія |
| вище аварійної межі | справжня перенапруга, вперше зсередини | `CHGR_HARD_MAX` — аварія |

Свідчення збираються за ВЕСЬ епізод, а не за останній прохід: 1-Wire на цій
платі читається нестабільно, і якби рішення бралось за останньою транзакцією,
одна невдача перетворювала б «повний» на «пакета немає» через раз.

### І перегони, які ми програвали

Пакет вимикає себе за власним виміром банок, а ми зупинялись за своїм — через
подільник із його похибкою і через дроти з їхнім падінням. Досить було
занизити на пів відсотка, щоб пакет щоразу встигав першим — і штатне
завершення заряду приходило до нас у вигляді розімкненого кола.

Тому додано другий, незалежний критерій завершення: **`chipMv >= targetMv`**.
Монітор міряє ті самі банки, що й захист пакета, тож заряд закінчується ДО
того, як захисту буде що робити. Помилитись цей критерій може лише в
безпечний бік — зупинити зарано, не запізно. Щоб він устигав, у кінці заряду
(за `CHARGE_CHIP_WATCH_MV` до цілі) монітор читається КОЖНЕ опитування, а не
раз на `CHARGE_TEMP_EVERY_N`: інакше рішення бралось би за показом, зробленим
іще до події.

### Дрібниця, яка була б наступною скаргою

Поки триває витримка на з'ясування, регулятор бачив нульовий струм — і
відповідав на нього єдиним доступним йому способом: піднімав шпаруватість.
У розімкненому колі це безглуздо й шкідливо. Тепер при насиченні привід ключа
знімається того ж проходу, а регулятор мовчить.

### Перевірено

* `chargeSatVerdict()` — усі чотири результати й обидві межі допуску з
  точністю до мілівольта (`charge_logic_check`, розділ 18);
* збій 1-Wire посеред епізоду НЕ перетворює «повний» на «пакета немає»;
* `chargeReasonIsDone()` — «завершено» стало множиною з двох причин, і
  питається вона в одному місці, а не порівнянням у кожному;
* два нових `#error` у `settings.h` — обидва звірені на порушеній
  конфігурації;
* п'ять охоронців у `session_guard_check` (розділ 21), кожен звірений
  «від протилежного»;
* і окремо — **сценарій власника прогнаний через СПРАВЖНІЙ `chargeTask()`**.
  Функція вирізається з `web_server.h` і збирається проти заглушок; цим же
  прогоном перевірено, що вона взагалі компілюється (`-Wformat` увімкнено).
  Стенд лежить поза деревом проєкту — щоб не тримати в репозиторії копію
  функції, яка тихо застаріє. Відтворюється так:

  ```bash
  sed -n '/^inline void chargeTask/,/^}/p' web_server.h > /tmp/chargeTask_body.inc
  # + невелика обгортка із заглушками dischargeSample/pmStep/ESP (див. нижче)
  ```

  Результат: пакет, що закрився сам на 8.2 В, дає «заряд завершено»; вийнятий
  пакет — «пакета в колі немає»; пакет, що розімкнувся на 7.0 В, — «захист
  спрацював не за напругою»; заряд завершується за монітором ДО того, як
  пакет закриє себе сам; штатні 7.9 В не будять нічого з цього.

---

## 3.14. Індикатор поверх попередження і текст за межами банера

Дві скарги про той самий екран.

### Індикатор заряду малювався поверх попередження

Сторінка помилки живлення виводиться ПОВЗ звичайний перемикач сторінок:

```c
if (chargePsuScreenActive()) { drawPagePsuFault(); return; }
```

а `g_displayPage` при цьому лишається нулем — тобто «головна». Анімація шкали
батареї дивилась саме на нього, бачила «головна», брала ЗАПАМ'ЯТОВАНІ
координати шкали й ~9 разів на секунду клала градієнт просто поверх червоної
плашки з попередженням.

Перелічувати в анімації сторінки-перехоплювачі — програшна гра: наступна така
сторінка знову про це не знатиме. Тому питання ставиться інакше й однозначно:
**чи та шкала, координати якої ми пам'ятаємо, намальована на ЦЬОМУ екрані.**
Кожне очищення екрана піднімає лічильник поколінь, `drawBatteryBar()`
запам'ятовує покоління, у якому малював, і анімація працює лише поки вони
збігаються. Одна умова закриває всі сторінки-перехоплювачі одразу.

### Текст вилазив за межі банера

Причина арифметична й перевірна наперед:

| напис | гліфів | шрифтом 9x15 | плашка | панель |
|---|---|---|---|---|
| `блок живлення просів або не той` | 31 | **279 px** | 236 px | 240 px |

Напис не вміщався навіть в екран. А центрування `(TFT_W - ширина) / 2` при
задовгому рядку дає **від'ємний** x, тож текст їхав ще й за лівий край.

Такі речі не ловляться оглядом коду: у UTF-8 кирилична літера це два байти,
тож `strlen()` тут бреше рівно вдвічі, і «на око» ніхто не порахує.

Виправлено трьома незалежними речами, бо однієї мало:

1. **Механізм переносу** (`textwrap.h`) — рахує ГЛІФИ, ламає по словах, довге
   слово ріже. Усі шрифти проєкту моноширинні, тож гліфи × ширина комірки — це
   точна ширина в пікселях, однакова на хості й на ESP32.
2. **Центрування в межах ПЛАШКИ**, а не всього екрана, і ширина спершу
   обмежується, а вже потім центрується те, що точно влізе.
3. **Ширина комірки шрифту стоїть поруч із іменем шрифта** (`FONT_BODY_W` біля
   `FONT_BODY`) — інакше одного дня перемкнуть шрифт і забудуть про ширину.

Написи заодно скорочено: слово «живлення» вже стоїть і в шапці сторінки, і в
заголовку плашки, тож утретє нічого не додавало.

Тест знайшов і те, чого скарга не називала: рядок `треба 14 В (12.6…15.6)` — 22
гліфи — не вміщався на 135-піксельній панелі й на будь-якій зі скругленими
кутами. Розбито на номінал і допуск окремими рядками: 12 і 11 гліфів,
вміщається скрізь.

### Перевірено

* новий `display_fit_check`: механізм переносу + усі написи банера на **шести**
  підтримуваних панелях, зі скругленими кутами й без;
* резерв рядків рахується з реальної ширини плашки, а не вгадується за шириною
  панелі — на цьому вже провалилась перша спроба (240 зі скругленням дає 21
  гліф, а найдовше пояснення — 22);
* правлені функції `display_color.h` **зібрані проти заглушок**: плашка 114 px,
  усі три рядки пояснень під нею лишаються вище смуги статусу (168/185/202 при
  межі 208);
* охоронці в `session_guard_check` (розділи 22–23), кожен звірений «від
  протилежного».

---

## 3.15. Скидання лічильників робило пакет «невідомим». Доказ із корпусу

Скарга власника:

> повністю робочий акумулятор після обнулення лічильників, напрацювання,
> вироблення перестає бачитись як оригінальний акумулятор.

### Що робило скидання

Обнуляло лічильники **тільки в DS2438**: ETM, CCA, DCA. DS2433 лишався як був —
із датою першого користування, з гістограмою на сотні циклів, із лічильником
калібрувань. Пакет після цього розповідав про себе дві несумісні речі одночасно:

```
DS2433:  «мене вмикали тоді-то, я пройшов 1097 циклів»
DS2438:  «я не пропрацював жодної секунди й не прийняв жодного мА·год»
```

### Доказ, а не гіпотеза

Такого пакета не буває — і це видно на корпусі `dumps/`. Із **52** цілих
фірмових пакетів напрацювання дорівнює нулю рівно у **двох**:

| дамп | ETM | циклів | CCA |
|---|---|---|---|
| `08-nova-batareya/01_PMNN4409A` | **0** | 1097 | 0 |
| `08-nova-batareya/02` | **0** | 1097 | 0 |

У решти 50 напрацювання — сотні мільйонів секунд. А `08-nova-batareya` — це
рівно той випадок, про який у цьому ж файлі й у коді написано: **«невідомий
акумулятор», ЗП лише світить зеленим.**

Досі провал 08 списували на чужий навчений хвіст. Це теж правда, але дефекту
там **два**, і другий — оцей. Хвіст ми полагодили давно; обнулений монітор
проти повного історії DS2433 лишався, і його продовжувало створювати наше ж
скидання. На корпусі стара поведінка ламала **47 пакетів із 47**, у яких була
історія.

### Виправлено

**Скидання узгоджене між двома чипами.** `impresHistoryZero()` (impres_crypt.h)
обнуляє історію в DS2433 під ключем ЦЬОГО чипа: цикли, повернення, дозаряди,
калібрування, день першого користування, день останнього заряду. Далі
обнуляються лічильники монітора. Або обидва боки, або жоден.

**Дата виготовлення НЕ чіпається.** Різниця з «новим акумулятором»
принципова: там чип порожній і дату взяти нізвідки, тому пишеться сьогоднішня.
Тут пакет робочий, і його дата — справжня й одна-єдина. Затерти її означало б
знищити останній достовірний факт про походження пакета, ще й зробивши його
«виготовленим» пізніше за власні записи.

**Без ROM-ID не робимо нічого.** Історія в DS2433 зашифрована ключем із
ROM-ID чипа; без нього її не переписати. Тоді скидання **відмовляється** і не
чіпає навіть монітор — пакет зі старими лічильниками нікому не шкодить, а пакет
із розсинхронізованими чипами рація відкидає. Обидва обробники повертають
пояснення, а не мовчазний успіх.

**Звітуємо за результатом.** `impresCyclesWrite()` відмовляється працювати з
блоком гістограми не тієї довжини — на п'яти пакетах корпусу вона саме так і
робить. Тому `impresHistoryZero()` перечитує результат тим самим кодом, яким
його читатиме аудит, і повертає false, якщо гістограма лишилась ненульовою.

**Аудит навчився називати цей стан.** Нова знахідка `AUD_MONITOR_ZEROED` —
«монітор обнулено, а історія лишилась». Вона питає лише про НЕзашифровану
гістограму циклів і тому працює навіть там, де ключ не підібрано. Свіжий пакет
під неї не потрапляє: у нього нулі з обох боків.

### Перевірено

* новий `reset_consistency_check` на всьому корпусі `dumps/` (55 пар):
  дзеркало, суми заголовка й TLV-записів, оборотність перешифрування, запис
  нуля в гістограму;
* доказ із корпусу оформлено як перевірку: ETM = 0 буває **рівно** в
  `08-nova-batareya` і **рівно** там, де DS2433 суперечить монітору;
* стара поведінка створювала суперечність у 47 пакетах із 47 — нова в жодному;
* дата виготовлення переживає скидання незмінною на всьому корпусі;
* `resetBatteryData()` **зібрана проти заглушок** і перевірена поведінково: без
  ROM-ID відмовляється і не чіпає жодного байта монітора;
* охоронці в `session_guard_check` (розділ 24), звірені «від протилежного».

---

## 3.16. Ручне регулювання струму заряду

Побажання власника. Профіль за відсотком — це «як правильно за замовчуванням»,
але бувають випадки, коли струм треба задати руками: перевірка ключа на малому
струмі, щадний режим для пакета з підозрілими банками, однаковий струм для
порівняння двох пакетів між собою.

`0` — автомат, як було. Будь-яке інше значення — уставка користувача.

### Три рішення, які тут важать

**Дозаряд ручний режим НЕ скасовує.** Це головне. Дозаряд малим струмом від
`CHARGE_TAPER_PCT` — не зручність, а те, що не дає добивати майже повний пакет
великим струмом; через його межу ми нещодавно ловили і брязкіт уставки, і
паніку на світлодіоді (3.12). Тож у зоні дозаряду ручне значення бере участь
**лише якщо воно менше** за автоматичне: зменшити струм користувач має право
завжди, збільшити — не в кінці заряду.

**Стеля ручного режиму дорівнює стелі профілю.** Увесь тепловий розрахунок
силової частини в `settings.h` — розсіювання на ключі, запас шунта, вибір
дроселя — зроблено для `CHARGE_MA_80`. Дозволити руками більше означало б
одним полем у формі обійти всі теплові перевірки файлу. Окремий `#error`
стежить, щоб `CHARGE_MANUAL_MA_MAX` не переріс `CHARGE_MA_80`.

**Уставка живе окремо від стану сеансу.** `chargeStop()` обнуляє `ChargeState`
цілком; ручний струм — не стан сеансу, а налаштування користувача. Поклавши
його в структуру, ми отримали б поле, яке мовчки скидається в автомат на
кожній зупинці.

Врахована вже **на старті**, а не з другого опитування: інакше
`chargeStartDuty()` цілився б у автоматичний струм, і перший прохід ішов би
«сходинкою» — рівно те, задля усунення чого розрахунок стартової точки й
робився.

Доступно з усіх трьох поверхонь: веб (`/api/charge/ma`), USB-клієнт і програма
`.exe` (`CHARGE MA=<мА>`). Межі клієнти беруть **із відповіді пристрою**
(`manMinMa`/`manMaxMa`), а не з власних констант.

---

## 3.17. Клієнт .exe: прокрутка, залиплий зразок і копія сторінки

### Прокрутка у вкладці «Дані»

Скарга власника. Із шести вкладок скрол мали лише «Майстер», «Ремонт»,
«Редактор» і «Журнал». «Дані» й «Огляд» вкладались просто у фрейм вкладки:
поки вікно велике — непомітно, щойно менше за вміст — нижні рядки зникають, і
дістати їх нічим. Про «Огляд» не повідомляли лише тому, що вміст там менший.

Заодно виправлено сам механізм прокрутки. Обробник колеса вішався на полотно
через `<Enter>`/`<Leave>`, але вміст лежить у полотні через `create_window`,
тобто це його **дочірні** віджети — і щойно курсор заходив на них, полотно
отримувало `<Leave>` і колесо знімалось. Тобто прокрутка гасла рівно тоді,
коли курсор над тим, що треба крутити. Тепер обробник висить і на полотні, і
на внутрішньому фреймі.

### Залиплий зразок копії

```python
i = self.cbClSample.current() - 1     # 0 = «свій файл»
if i < 0 or i >= len(subs):
    return                            # ← _cloneHex лишається старим
```

Повернення до «свій файл» не скидало раніше обраний вбудований зразок.
Користувач бачив у списку «свій файл», натискав «Відновити» — і в пакет ішов
зовсім інший монітор. Ані повідомлення, ані сліду в журналі.

### Запис ЛИШЕ монітора

Дві операції, які легко сплутати, тепер стоять поруч і названі різно:

| дія | що робить із DS2433 |
|---|---|
| 🧬 Відновити за зразком копії | **СТИРАЄ** (або пише експериментальну ідентичність) |
| 🔬 Записати лише DS2438 | **не чіпає взагалі** |

Це має пряме відношення до скарги «китайський еталон 2438 після запису не
працює». Повний режим копії — не «запис монітора», а перехід пакета в стан
китайської копії, і DS2433 після нього порожній. Монітор при цьому записано
правильно, а рація пакет не впізнає. Тепер записати сам монітор, не чіпаючи
ідентичність, можна однією кнопкою.

> Чесно про решту цієї скарги: різниці **в коді** між `.exe` і мостом на шляху
> запису DS2438 знайти не вдалось. Команда однакова (`WRITE38 <128 hex>`),
> обидва клієнти ріжуть довгі команди на частини (міст по 200 Б, `.exe` по 96),
> обидва не роблять після запису нічого, крім читання `INFO`. Словник команд
> `.exe` звірено з прошивкою й веб-клієнтом — розбіжностей немає. Тож
> найімовірніше в мосту й у `.exe` виконувались **різні операції**, і кнопка
> вище прибирає саме цю пастку.

### Копія сторінки в SPIFFS

Знайдено попутно й варте окремої згадки. `index.html` лежить у проєкті **двічі**:
як вихідний файл і як `data/index.html`, який заливають у SPIFFS. Пристрій
віддає `/index.html` **із SPIFFS** — тобто працює копія. Правка в кореневому
файлі, не перенесена в `data/`, збирається, проходить усі тести й просто не
доїжджає до користувача.

До цієї сесії копії були побайтово однакові; поле ручного струму заряду мало
не стало першою розбіжністю. Тепер їхню тотожність перевіряє окремий охоронець.

### Перевірено

* усі 10 хостових тестів у конфігураціях PMOS і BJT_PNP;
* логіка ручного струму — розділ 19 `charge_logic_check`: накладання, затиск на
  обох межах, і те, що в дозаряді ручні 800 мА **не** піднімають струм;
* охоронці (розділи 25–27), кожен звірений «від протилежного» — зокрема один
  довелось посилити: перевірка «`chargeApplyManual` є у файлі» лишалась зеленою
  після прибирання виклику з регулятора, бо другий виклик є на старті;
* `pyflakes` по `moto_gui.py` і `moto_bridge.py` — чисто;
* `chargeTask()` вирізано з `web_server.h` і зібрано проти заглушок.

---

## 3.18. Відсоток заряду для 2S: крива замість прямої

Прохання власника — перерахувати показання заряду для 2S-пакета, **не
оглядаючись на початкові граничні значення**, і взяти межі з заводських
параметрів 2S li-ion.

### Що було

```c
p = (mv - 6350) * 100 / (8250 - 6350);
```

Пряма між двома підібраними числами. Для літію це неправильно не «на кілька
відсотків», а принципово: крива напруги спокою — полога сходинка з довгим
плато посередині й крутими краями.

| напруга | В/банку | було (пряма) | стало (крива) | різниця |
|---|---|---|---|---|
| 6.60 В | 3.30 | 13 % | **4 %** | −9 |
| 6.80 В | 3.40 | 23 % | **6 %** | −17 |
| 7.00 В | 3.50 | 34 % | **11 %** | −23 |
| 7.20 В | 3.60 | 44 % | **20 %** | −24 |
| 7.40 В | 3.70 | 55 % | **43 %** | −12 |
| 8.00 В | 4.00 | 86 % | **80 %** | −6 |
| 8.20 В | 4.10 | 97 % | **90 %** | −7 |

Помилка була найбільша саме там, де вона найдорожча: пристрій показував
«третину заряду» на пакеті, якому лишалось близько восьми відсотків. Причина
проста — 7.20…7.36 В це цілих 20 % заряду на 160 мВ, а пряма розтягувала ці
160 мВ на вісім відсотків.

### Що стало

Таблична крива напруги спокою **на банку** (`soc.h`), межі — з паспорта:

* **0 %** = 3.00 В/банку = **6.00 В** на пакеті (нижче працює захист пакета);
* **100 %** = 4.20 В/банку = **8.40 В** на пакеті.

Крива зберігається побанково й множиться на `SOC_CELLS`, тож та сама таблиця
годиться і для 3S. Межі — окремі літерали, а не `SOC_CURVE[0].cellMv`: їх
читає ще й препроцесор, а він не вміє індексувати масив. Розійтися з таблицею
їм не дає `static_assert`.

### Наслідок, про який треба сказати прямо

Заряд до 8.20 В — це 4.10 В на банку, а це за кривою **рівно 90 %**. Тобто
після «повного» заряду шкала показуватиме 90 %, і це не недозаряд, а чесне
число: зупинка на 4.10 В свідомо недобирає останню десяту частину заради
ресурсу банок. Раніше та сама зупинка показувала 97 % — тільки тому, що шкала
була лінійна, а верх у неї стояв на 8.25 В.

Щоб бачити 100 %, треба міняти не шкалу, а ціль: підняти `CHARGE_TARGET_MV`
до 8400 мВ.

### Що ще довелося поправити

**Дозаряд ледь не зник.** Ціль у відсотках вибирає користувач, а напруга цілі
затискається до `CHARGE_TARGET_MV`. Поки шкала була лінійна, 100 % і збігались
із 8.2 В. З правильною кривою 100 % — це 8.4 В, і якби `targetPct` лишався
100, поріг дозаряду (90 % від цілі) припав би рівно на кінець заряду:
дозарядна ділянка виродилась би в нуль, а пакет добивався б повним струмом до
самого кінця. Тепер `chargeStart()` **перераховує** `targetPct` із затиснутої
напруги, і всі точки перегину профілю стискаються під досяжну ціль. Ділянка
дозаряду вийшла 180 мВ (8.02…8.20 В).

**Друга копія шкали.** Екран мав власну лінійну формулу просто в
`batteryPercent()`. Поки обидві були прямими, вони випадково збігались; після
переходу на криву екран показував би зовсім інше число, ніж веб і USB-клієнт.
Копію прибрано, лишилась одна функція на всі поверхні.

**Верх розрядної лінійки** (`DISCHARGE_RAMP_HI_MV`) стояв окремим числом 8250
і після зміни шкали розійшовся б із нею мовчки — тепер це `SOC_FULL_MV`.
Запасні значення тієї ж лінійки у трьох клієнтах теж підтягнуто.

**Порядок підключення.** `soc.h` включається найпершим рядком `settings.h`:
на його константи спираються `#if`-перевірки, а невідомий ідентифікатор
препроцесор мовчки вважає нулем. Перевірено від протилежного — перенесення
включення нижче валить збірку на `DISCHARGE_RAMP_HI_MV`.

### Про що варто пам'ятати

OCV — це напруга **спокою**. Під навантаженням вона просідає, під зарядом
завищена, тож відсоток за напругою правдивий лише на відпочилому пакеті. Саме
тому і заряд, і розряд міряють напругу на закритому ключі з витримкою, а там,
де є справний лічильник ICA всередині пакета, показ береться з нього.

І окремо: на плато (7.20…7.60 В) кілька мілівольт шуму АЦП — це кілька
відсотків показу. Це властивість самої хімії, а не дефект; згладжує її саме
ICA.

### Перевірено

* новий `soc_curve_check`: паспортні межі, монотонність кривої **й самої
  функції** на всьому діапазоні з кроком 5 мВ, точність у всіх 21 вузлах,
  оборотність «% → В → %» без похибки, і числова таблиця «пряма проти кривої»;
* окремо перевірено, що дозаряд не виродився, паливомір у мА·год лишився
  лінійним за ємністю, а ціль розряду 7.20 В — це рівно 20 %;
* охоронці розділу 28 у `session_guard_check`, кожен звірений «від
  протилежного» — включно з поверненням старих меж, зламом монотонності,
  поверненням лінійної формули й перенесенням `#include` нижче за перевірки.

---

## 3.19. Синхронізація дзеркала DS2438 → DS2433 з правкою перед записом

Прохання власника: «є дані з 2438, які дублюються в 2433. Потрібна функція
синхронізації цих даних з 2438, а також правка даних перед синхронізацією.
Часткова правка вже реалізована в проєкті».

### Що дублюється

Рівно **26 байтів**: `DS2433[0x01–0x1A]` ≡ `DS2438[0x18–0x31]`. Це ідентичність
пакета — те, за чим рація й станція його впізнають. Копія в моніторі не
випадкова: завдяки їй пакет зі стертим DS2433 ще можна відновити, і саме це
робить станція WPLN4226A, переписуючи ці байти назад.

### Чому наявної синхронізації не вистачало

Вона в проєкті була (`impresSyncMirror`, «добудова заголовка»), але **сліпа**:
копіює всі 26 байтів і виправляє суму. Це правильно рівно в одному випадку —
коли монітор точно свій. А він буває чужий, і тоді сліпе копіювання не лікує,
а **закріплює чужу ідентичність**.

### Що зроблено

`mirror_plan.h` — план, а не дія:

* побайтова різниця «що зараз / що прийде / що буде записано»;
* галочка на кожен байт — зняти те, що треба лишити старим;
* окремо розібране поле, яке ми вміємо назвати, — **паспортна ємність**
  (`DS2433[0x008]`), з ручним введенням, округленням до кроку 25 мА·год і
  затиском у 1000…6000;
* типово переносяться **лише РІЗНІ** байти й лише з придатного джерела.
  Однакові не переписуються: це зайвий цикл запису EEPROM без користі;
* ручне значення ємності **сильніше** за монітор — його вписують саме тоді,
  коли монітору не довіряють (після заміни банок);
* сума заголовка виправляється **завжди**, навіть коли жоден байт не змінився:
  заради неї операцію часто й запускають після станції.

Доступно з усіх трьох поверхонь: `/api/mirror`, `/api/mirror/edit`,
`/api/mirror/apply` і команда `MIRROR [APPLY|TAKE=|BYTE=|RATED=]` по USB.

### Попутно прибрані дві копії

**Зсуви дзеркала.** «1 +» і «24 +» стояли літералами щонайменше в п'яти
місцях. Тепер це `IMPRES_MIRROR_D33_AT` / `IMPRES_MIRROR_D38_AT` /
`IMPRES_MIRROR_LEN`.

**Назва силового ключа.** Усі три клієнти тримали рядок «PNP B772M» у себе — і
після заміни на P-MOSFET дружно почали підписувати чуже залізо. Тепер назву
повідомляє пристрій (`swName` з `CHARGE_SW_NAME`), а клієнти її лише показують.

### Липка шапка

Прохання: «при скролінгу меню верхня шапка залишається зверху фіксовано для
швидкого переходу по закладках». Сторінки тут довгі — у «Ремонті» півтора
десятка карток, — і щоб перейти на сусідню вкладку, доводилось прокручувати
весь екран назад угору.

Смуга вкладок тепер `position:sticky` з непрозорим тлом і `z-index` (без нього
картки з власним тлом проїжджали б поверх). Підвкладки липнуть **під** нею, а
не за нею. У програмі `.exe` смуга вкладок і так поза областю прокрутки — там
нічого міняти не довелось.

### Перевірено

* новий `mirror_plan_check`: логіка плану на синтетиці (зняття байтів, ручна
  ємність, непридатне джерело) і прогін по всьому корпусу `dumps/` — жодному
  цілому пакету не стає гірше, заголовок після операції **завжди** цілий,
  повторна синхронізація нічого не змінює (ідемпотентність);
* охоронці 29–30, кожен звірений «від протилежного»: перенесення однакових
  байтів, скасування пріоритету ручної ємності, прибирання виправлення суми,
  зняття липкості, повернення жорсткої назви заліза й повернення чисел замість
  імен зсувів — усе валить тести.

---

## 3.20. «Sketch too big»: помилка була в нашій інструкції, а не в установці

Повідомлення власника:

```
Sketch uses 1313447 bytes (100%) of program storage space. Maximum is 1310720 bytes.
Sketch too big; text section exceeds available space in board
```

### Що це за число

**1 310 720** — це не «розмір флеша». Це розділ під програму у схемі
**Default 4MB with spiffs**. Тобто справа не в тому, що прошивка роздулась
непристойно, а в тому, що обрано схему розділів, у якій програмі виділено
1.25 МБ із чотирьох мегабайтів. Решта віддана під SPIFFS (1.5 МБ), якого нам
стільки не треба: уся тека `data/` — 670 КБ.

Перевищення при цьому мізерне: **2727 байтів, 0.21 %**.

### Чому це наша помилка

`INSTRUCTION.md` прямо казала:

> | **як зараз** (Bluetooth вимкнено) | за замовчуванням («Default 4MB with spiffs»), прошивка ~80 % флеша |

Це було правдою, коли писалось. Після кривої заряду 2S, ручного струму,
синхронізації дзеркала, переносу тексту й чорного ящика — уже ні. Власник
зробив рівно те, що написано в інструкції, і отримав помилку збірки.

### Виправлено

**Схема — «Huge APP (3MB No OTA/1MB SPIFFS)», завжди.** Той самий скетч у ній
займає **41.8 %** від 3 МБ. Перевірено, що «No OTA» нічого не ламає: оновлення
прошивки по повітрю в проєкті немає взагалі (ні `ArduinoOTA`, ні `Update.h`), а
SPIFFS у 1 МБ вистачає з запасом на 670 КБ теки `data/`.

Виправлено в трьох місцях, бо шукають у різних: `INSTRUCTION.md` (таблиця
схем), `README.md` (швидкий старт — тепер це окремий пункт 2, до компіляції) і
`settings.h` (там схема була подана як потрібна «лише під Bluetooth»).

**І пристрій тепер каже це вголос.** Після прошивки в журнал іде реальний
розмір розділу:

```
Флеш під програму: 1313447 з 3145728 байтів (41%), розділ «app0»
```

а при заповненні від 90 % — попередження з назвою потрібної схеми. Схема
задається в IDE, а не в коді, тож перевірити її на компіляції неможливо; але
мовчати про неї не варто. Наступний, хто впреться в стелю, побачить це
**заздалегідь**, а не у вигляді `text section exceeds available space`.

### Перевірено

* охоронці розділу 31: інструкція називає потрібну схему й **не** обіцяє, що
  типової досить; README теж; `settings.h` більше не подає її як «лише для BT»;
  пристрій друкує розмір розділу й попереджає завчасно;
* усі три звірені «від протилежного» — повернення старої обіцянки в таблицю,
  прибирання звіту й прибирання попередження валять тест;
* блок звіту вирізано зі скетча й **зібрано проти заглушок**: на 3 МБ дає
  «41 %, без попередження», на 1.25 МБ — «100 %, попередження».

> ⚑ Побічний висновок для перевірок. Для цієї перевірки довелось додати
> `fileHasText()`: наявний `fileCalls()` свідомо пропускає рядки, що
> починаються з «//», — і на документації в коментарях був сліпий. Помітили це
> одразу, бо перевірка «від протилежного» червоніла там, де мала зеленіти.

---

## 3.21. Синхронізація: «а цей монітор узагалі від цього пакета?»

Прохання власника — дослівно взяти попередження з картки даних і поставити його
в синхронізацію:

> Напрацювання ETM (6397 діб) більше за вік пакета (15 діб від 2026-08-03). Або
> монітор не від цього АКБ (перечитайте DS2438 — доти струм, залишок і знос
> неправильні), або пакет пройшов цикл на станції: ЗП переписує ETM своїм
> числом. Тому наробіток правлять ПІСЛЯ калібрування, а не до нього.

Прохання точне, і місце для нього обрано правильно. Синхронізація переносить
ідентичність **з монітора** в пам'ять пакета. Якщо монітор чужий, вона не
лікує пакет, а **приписує йому чужу особу** — і робить це «за планом», з
галочками, тобто впевнено. На картці даних це просто спостереження; тут — умова
операції.

### Правило одне на весь проєкт

Порівняння винесено в `impresEtmForeign(etmDays, ageDays)` (`impres_audit.h`) —
там, де вже жив допуск `AUD_ETM_SLACK_D` = 180 діб. Аудит і план тепер питають
**одну** функцію. Допуск потрібен тому, що лічильник стартує ДО того, як у чип
запишуть дату: на 31 рідній парі з `dumps/` перевищення не було більше за 44
доби.

План (`mirror_plan.h`) везе свідчення числами — `etmDays`, `ageDays`,
`haveAge`, `etmForeign`, — а текст лишається в клієнтах: довгі пояснення у
прошивці коштували б флеша, а він щойно закінчився (3.20). У кожному клієнті
формулювання **одне** на два місця (`etmForeignHtml` у браузерах,
`etm_foreign_text()` у `.exe`) — друга копія розійшлася б із першою рівно тоді,
коли людина за нею вирішує.

### Три зауваги з натури, які прийшли слідом

**«Шапка налазить на верхню панель статусу».** У `client_usb.html` шапка вже
була `position:sticky; top:0`, і смуга вкладок стала туди ж. Два елементи з
`top:0` **не діляться місцем**: у кого `z-index` більший, той просто закриває
іншого. Тепер висота шапки — змінна `--hdrH`, вкладки липнуть на `top:var(--hdrH)`,
підвкладки — ще на 54 px нижче, а `z-index` шапки найвищий.

**«Bridge/web — не вибираються пункти плану».** Причина не в клієнтах: галочка
жила лише в рядка, де байти **різні**. А на цілих пакетах дзеркало здебільшого
вже збігається — у корпусі `dumps/` це 46 із 52, — тож у натурі жодна галочка
не натискалась. Типовий вибір лишився звуженим до різних байтів (зайвий запис
EEPROM ні до чого), але коли людина вказує байт **пальцем**, заборона знята.
Єдина умова лишилась: щоб було звідки брати (`srcUsable`).

**«Відсутня синхронізація дати в планувальнику».** Годинника реального часу в
пристрої немає (`device_clock.h`): дату приносить клієнт, і за домовленістю
**кожен запит плану** несе `today=РРРРММДД`. Синхронізація дзеркала була єдиним
планом, який дати не ніс, — і мовчки лишалась без перевірки віку: свідчення
просто не рахувалось, а «попередження немає» читається як «усе гаразд».

Тепер `today=` приймають усі три обробники (`/api/mirror`, `/api/mirror/edit`,
`/api/mirror/apply`) і команда `MIRROR … TODAY=`, а всі три клієнти її шлють.

> ⚑ Дата оновлює **лише свідчення**, а не перебудовує план. Вона приходить уже
> після того, як людина розставила галочки; перебудова тихо скинула б їх —
> достатньо було б настання нової доби, — і записалось би не те, що показано.
> Для цього побудову плану й розрахунок свідчення розведено в дві функції
> (`mirrorPlanRefresh()` / `mirrorPlanEtmRefresh()`).

Коли перевірити вік не вдалося, картка каже це **окремим рядком**, а не замість
іншого пояснення: «нема чого переносити» й «не змогли перевірити монітор» —
різні речі, і жодна не скасовує другу.

### Перевірено

* `mirror_plan_check` секції 7–8: свідчення на числах зі скарги (6397 проти
  15), мовчання без дати, збіг із аудитом на сітці 25×13 пар «вік × наробіток»
  (а не на числі 180 — власна копія правила розійшлася б саме на межі), поява
  дати не скидає розставлених галочок, однаковий байт відмічається вручну й
  **не** відмічається без придатного джерела;
* охоронець 32 — 16 перевірок: одне правило, одне формулювання на клієнта,
  дата в усіх трьох обробниках і в усіх трьох клієнтах, галочки, липка шапка;
* усе звірено **від протилежного**: 20 навмисних поломок, кожна валить саме
  «свою» перевірку. Дві перевірки довелось на цьому підсилити — `fileCalls()`
  по імені лишався зеленим, коли ім'я є ще й у коментарі поруч із `#include`,
  а «дату приймає обробник» мовчав, коли її прибрали лише з показу плану
  (додано `fileCountText()` — рахує копії, а не наявність);
* один тест виявився **порожнім**: перед приходом дати в ньому не стояло жодної
  галочки, тож «нічого не скинулось» виходило саме по собі. Фікстуру
  виправлено — тепер поломка ловиться;
* розбір `TODAY=` у `MIRROR` прогнано окремою хостовою чернеткою на всіх формах
  команди (`APPLY`, `TAKE=`, `BYTE=… ON=…`, `RATED=`, дата спереду й ззаду,
  без дати, `TODAY=0`); у репозиторій вона не внесена навмисно — це була б
  друга копія розбору, а `serial_api.h` на хості не збирається.

---

## 3.22. Розходяться не байти, а ЧИСЛА — і винен був запис у монітор

Скарга власника: «дані розходяться, потрібна можливість синхронізувати і ці
розбіжності — саме через них синхронізація й задумувалась». Далі, після спроби
полагодити: «скинув наробіток, поставив у зарядку, і вона знову прописала дату
й лічильники. Може, ми не туди пишемо і не звідти читаємо?»

Питання виявилось точним, і відповідь на нього — головне в цьому розділі.

### Що показали дампи

Власник надіслав той самий пакет (PMNN4409B) двічі: до зарядної станції й
після. Розбір **нашим же кодом** (`impres_bms.h` + ROM-ID з чипа, ключ не
підбирався):

| | до станції | після станції |
|---|---|---|
| дата виготовлення | 2026-08-03 | **2025-11-04** |
| перше користування | 2026-08-18 | **2026-04-29** |
| цикли IMPRES | 1 | **31** |
| наробіток ETM | 6397 діб | 6397 діб (цокає далі) |
| CCA / DCA | 195 / 238 | **195 / 238 — байт-у-байт ті самі** |

Три висновки, кожен перевірений:

1. **Байтове дзеркало в цьому пакеті збігалося ПОВНІСТЮ.** Тобто синхронізація
   в старому вигляді сказала б «усе гаразд» і не полагодила нічого. Розходились
   не байти ідентичності, а числа.

2. **Станція не чіпає DS2438 узагалі** — CCA і DCA байт-у-байт ті самі. Зате
   лічильник циклів у DS2433 вона переписала числом **31**, а CCA=195 при
   ємності 2150 мА·год і шунті 45.65 мОм дає рівно **31** еквівалентний цикл.
   Тобто станція вважає монітор першоджерелом і відновлює лічильники пакета
   з нього. Правити самий лише DS2433 — марна праця.

3. **Наш запис у монітор до чипа не доїжджав.** ETM лишився 6397 діб і рівно
   цокав далі, лічильники не змінились. Причина — в даташиті DS2438: ICA, CCA
   і DCA це не пам'ять, а **регістри накопичувача заряду**; поки в статусі
   стоїть біт IAD, чіп оновлює їх сам приблизно кожні 27 мс і затирає щойно
   записане. Ми ж писали сторінку 0 (де цей біт) **першою**, з увімкненим
   IAD, а сторінку 7 (CCA/DCA) не звіряв ніхто — тож збій був **невидимий**.

### Чи правильно ми читаємо

Перевірено окремо, бо це половина питання власника:

* ключ береться з ROM-ID чипа (не підбирається), суми блоків сходяться, а
  дата, яку записала **станція**, розшифровується в осмислене 2025-11-04 —
  випадковий зсув давав би сміття, а не правдоподібну дату;
* у `dumps/` є пакети з записаним показом **рації**. На здорових пакетах
  (`03-do-kalibruvannya`) наша дата першого користування збігається з тим, що
  показала рація, з точністю до доби;
* а перебір **усіх 16** можливих обертань блока дат показав: жодне з них не
  дає дати рації для пакетів із роздутим ETM. Тобто рація бере не збережену
  дату, а рахує «сьогодні − ETM» — саме те, що записано в `impres_format.h`.
  Звідси й уся плутанина: **поки ETM бреше, рація показує чужий вік і чужий
  знос, хоч у пам'яті пакета дати правильні**.

### Що зроблено

**Запис у DS2438** (`battery_reader.cpp`):

* на час запису знімаються біти IAD і CA, а сторінка 0 (конфігурація)
  пишеться **останньою** — щоб вимір струму повертався вже після того, як
  лічильники лягли;
* додано звірку сторінки 7 (CCA/DCA) — раніше її не робив ніхто;
* додано звірку, що конфігурація **повернулась**: інакше монітор лишився б із
  вимкненим вимірюванням, а це мертвий паливомір до наступного запису;
* усе це перевіряє новий хостовий тест `ds2438_write_check` на моделі чипа з
  «живими» регістрами — зокрема сценарій від протилежного: та сама
  послідовність без зняття IAD лишає в чипі **старі** числа, як у дампі.

**Значеннєвий бік плану синхронізації** (`mirror_plan.h`) — три рядки, кожен
із власною галочкою й полем правки:

| рядок | пакет (DS2433) | монітор (DS2438) |
|---|---|---|
| наробіток ETM | від дати першого вмикання до сьогодні | лічильник секунд |
| заряджено (CCA) | цикли IMPRES + не-IMPRES | накопичені мА·год ÷ ємність |
| розряджено (DCA) | ті самі цикли (окремого лічильника пакет не веде) | накопичені мА·год ÷ ємність |

Напрямок тут **зворотний** до байтового: ідентичність беремо з монітора, а
лічильники — з пакета, бо саме монітор станція вважає першоджерелом. Типово
обрані лише ті рядки, що справді розходяться; для наробітку — з допуском в
одну добу (пакетна сторона рахується цілими добами, а лічильник іде
безперервно). Цикли перераховуються в сирі одиниці шунтом **із чипа**: якщо
шунта в чипі немає, рядки циклів не пропонуються взагалі — з чужим шунтом
число було б вигадкою.

### Порядок ремонту, який із цього випливає

1. спершу **монітор**: наробіток і лічильники заряду/розряду;
2. потім **DS2433**: дати, знос, лічильники циклів;
3. і аж тоді станція — вона перерахує пакет із монітора, а монітор уже каже правду.

### Перевірено

* `mirror_plan_check` секції 9–11: числа з дампа власника (ETM 6397 → 0,
  CCA 31 → 6, DCA 37 → 6 при raw 38/38), повторний прохід нічого не змінює,
  недоступність рядків без шунта/монітора/дати, затиски ручних чисел і
  **стійкість перерахунку циклів** на всіх 50 парах «ємність × шунт» із
  `dumps/` (20 050 перевірок «цикли → сирі → цикли»);
* `ds2438_write_check` — див. вище;
* охоронці 33–34, звірені від протилежного 12 навмисними поломками;
* усі 13 хостових тестів зелені в обох конфігураціях силового ключа.

---

# Частина 4. ПЕРЕВІРКИ

## `#error`-перевірки у `settings.h`

Кожна звірена на порушеній конфігурації — усі спрацьовують. Це не формальність:
дві з них (обидві межі допуску живлення) знайшли реальну помилку в номіналах,
які я перед тим записав у документацію як правильні.

| Перевірка | Ловить |
|---|---|
| `Iб` vs `Iпік/β_форс` | ключ не увійде в насичення й згорить |
| **`Iб` на `CHARGE_PSU_MIN_MV`** | просілий, але допустимий блок виводить ключ із насичення |
| **струм драйвера на `CHARGE_PSU_MAX_MV`** | на верхній межі живлення не насичується керуючий NPN |
| **струм драйвера vs `Ic max` NPN** | у драйвері стоїть завслабкий транзистор (BC547) |
| `Iб(NPN)` vs струм драйвера / β_форс | каскадна відмова драйвера |
| `Iб(NPN)` vs безпечний струм піна | перевантаження виходу ESP32 |
| розсіювання vs 80 % `Pc` | перегрів ключа |
| `Iпік` vs `Ic max` | перевищення струму ключа |
| `ΔI/2` vs крейсерська уставка | переривчастий режим на крейсері |
| вершина пульсацій vs `CHARGE_PEAK_MA_MAX` | відсічка ловила б штатний режим |
| `CHARGE_PWM_FREQ` vs `2^bits` | недосяжна для LEDC частота |
| `D×Uживл` vs ціль + падіння на шунті | стеля скважності не дотягується до цілі |
| подільник пакета vs робоча межа АЦП | вигорання входу ESP32 |
| **подільник живлення vs межа АЦП** | помилковий блок 19 В «залипав» би на 4095 замість числа |
| **струм у захисний діод `CHARGE_PSU_PIN`** | вигорання входу при вдвічі завищеному живленні |
| **порядок порогів живлення** | «немає» вище за «занижено», порожній робочий діапазон |
| **`CHARGE_SUPPLY_MV` у власному допуску** | прошивка відхиляла б штатний блок живлення |
| **`CHARGE_PSU_PIN`: ADC1 і не дублює зайняте** | вимір не читався б при увімкненому Wi-Fi |
| **`GPIO18`/`GPIO23` не зайняті нічим, крім SPI** | чужий трафік на шині дисплея; без CS панель слухає її постійно |
| **канали LEDC не діляться таймером** | заряд і розряд на одному таймері з різними частотами — ШІМ не прикріпиться, і ключ лишиться некерованим |

## Три рантайм-відсічки, яких не було

Компіляційні перевірки рахують **номінали**, а не те, що справді припаяне. Три
відсічки в самому циклі заряду закривають цю щілину:

| Відсічка | Умова | Що рятує |
|---|---|---|
| `CHGR_PSU` | живлення поза 12.5…16 В, 3 опитування поспіль | заряд «наосліп» на не тому блоці живлення |
| `CHGR_NODRIVE` | шпаруватість у стелі, струм < 50 % уставки, 5 опитувань поспіль | силовий ключ, який працює поза насиченням (саме це дає не доопрацьована плата) |
| `CHGR_NOPACK` | показання на клемі ≥ 9300 мВ, 2 опитування поспіль | правильний діагноз замість хибної «перенапруги»: на клемі стоїть живлення, тобто пакета в колі немає (див. 3.4) |

Логіка всіх трьох винесена в `charge.h` окремими функціями (`chargePsuTrip()`,
`chargeNoDriveTrip()`, `chargeNoPackTrip()`) **навмисно**: `web_server.h` на хості не збирається
взагалі (WebServer, SPIFFS, U8g2, ArduinoJson), тож усе написане всередині
`chargeTask()` не покриває жоден тест. Тепер рішення «зупинятись чи ні»
ухвалюють функції, які тест викликає напряму, а `chargeTask()` лишився тонким
викликачем. Окремо перевірено, що він їх **справді викликає** — сканером по
тексту `web_server.h`: «функція правильна» і «функцію хтось кличе» — різні
твердження, і саме на другому цей проєкт уже горів (дефект №1 нижче).

## Тринадцять хостових тестів

| Тест | Що перевіряє |
|---|---|
| `battery_read_check` | посторінкове читання DS2433 на справжньому `readBattery()` проти симульованої шини з просіданням і шумом |
| `audit_check` | аудит змісту (чужий ключ шифрування, побиті суми) на всьому корпусі `dumps/` |
| `hdrfix_check` | добудова заголовка з дзеркала DS2438, без хибних спрацювань на 55 дампах |
| `clone_check` | відновлення за зразком китайської копії |
| `charge_logic_check` | профіль струму, регулятор, стартова шпаруватість, вимір струму/напруги, тепловий бюджет ключа, **класифікація й гістерезис живлення, усі три рантайм-відсічки, нульова маска IDLE у сторожа** — на **справжньому** `charge.h`. Відсічку «пакет від'єднано» перевірено **наскрізь**: фальшивий АЦП ставиться у стелю (4095), і тест дивиться, що `chargePackMv()` видає рівно ті 9900 мВ зі скарги |
| `session_guard_check` | взаємний захист заряду й розряду на **справжніх** `charge.h`/`discharge.h`; **і те, що `chargeTask()` справді викликає всі три відсічки**; що маска IDLE у сторожа ніде не збирається з `portNUM_PROCESSORS`, а `loop()` віддає квант часу; а конструктори дисплеїв беруть CS через макрос, а не напряму |
| `buzzer_dac_check` / `buzzer_ledc_check` | синтез звуку (вмикають звук явно, незалежно від `settings.h`) |
| `reset_consistency_check` | скидання лічильників не ламає оригінальність — на всьому корпусі `dumps/` (3.15) |
| `soc_curve_check` | шкала заряду за напругою для 2S: паспортні межі, монотонність, оборотність «% → В → %» (3.18) |
| `display_fit_check` | текст не вилазить за плашку на жодній підтримуваній панелі (3.14) |
| `mirror_plan_check` | план синхронізації дзеркала з правкою, свідчення про наробіток, значеннєві рядки й прогін по `dumps/` (3.19, 3.21, 3.22) |
| `ds2438_write_check` | лічильники в DS2438 справді доїжджають до чипа: зняття IAD на час запису й звірка сторінки 7 (3.22) |

Докладний перелік того, що перевіряє кожен, — у `tools/README.md`; там же
команди запуску.

Два тести, що раніше тримали **власну копію** перевірюваної логіки, переписано
на справжні заголовки: копія лишалася б зеленою після зміни схеми, гоняючи код,
якого в проєкті вже немає. `session_guard_check` звірено в обидва боки — на
виправленому коді проходить, на коді до виправлень падає з 7 помилками.

---

# Частина 5. ЩО ВАРТО УТОЧНИТИ

Числа, які я взяв з обережної оцінки, а не з вимірювання. Усі винесені в
`settings.h` окремими константами — поправте, і перевірки перерахують решту.

| Константа | Зараз | Звідки взято |
|---|---|---|
| `CHARGE_BJT_TSW_NS` | 3000 | обережна оцінка часу розсмоктування; у даташиті B772M його немає. Від неї прямо залежить розрахунковий потолок струму |
| `CHARGE_SUPPLY_MV` | 14000 | ✅ **підтверджено власником**; і тепер це вже не єдине джерело — напруга живлення вимірюється на `CHARGE_PSU_PIN`, а константа лишилась для компіляційних перевірок і як запасне значення |
| `CHARGE_PSU_MAX_MV` | 16000 | ✅ **підтверджено власником**. Саме цей поріг вимагає 390 Ом замість 470: при 16 В струм драйвера росте до 124 мА (на 15 В вистачило б і 470 Ом, але вибір зроблено на користь ширшого допуску) |
| `CHARGE_L_UH` | 104 | «предположительно» |
| `CHARGE_SERIES_MOHM` | 600 | шунт 500 + оцінка дротів і внутрішнього опору пакета |
| `CHARGE_BJT_VCE_SAT_MV` | 500 | типове для B772M при робочому струмі |

Похибка в них **не ламає роботу**: стартова шпаруватість — це лише оцінка, далі
все веде замкнутий контур за реальним струмом, а крок регулятора пропорційний
похибці. Але від них залежать `#error`-межі, тож уточнені числа дадуть чесніший
тепловий бюджет.

**Окремо:** пульсації 1303 мА при уставці 1000 мА — це багато (ток гуляє від
349 до 1651 мА). Працювати буде, але чистіше було б підняти індуктивність.
Частоту піднімати не можна: перемикальні втрати біполярника ростуть прямо з
нею, і на 40 кГц перевірка розсіювання вже не проходить.
