roman885-85/moto_battery_reader/SCHEMATIC.html

Принципова схема · повна конфігурація

# IMPRES Tool

Читач і зарядний пристрій акумуляторів Motorola IMPRES на ESP32. Схема відповідає чинній конфігурації settings.h — усе, що тут намальовано, зібрано з констант прошивки, а не з пам'яті.

КонтролерESP32-WROOM

Живлення+14 В (12.5…16)

ЕкранST7789 GMT130

Ключ зарядуP-MOSFET NTD2955G

Листів5

силове коло вимірювання (АЦП) потребує заміни логіка / керування

ЛИСТ 1

## Загальна структура

Що до чого під'єднано і якими пінами. Деталі кожного вузла — на листах 2–5.

Один контролер, три силові кола: заряд, розряд і вимірювання — усі замикаються на спільну землю.

ЛИСТ 2

## Каскад заряду — понижувач, ключ на вибір

Головний лист. Верхній ключ — P-канальний MOSFET NTD2955G (обв'язка спільна з варіантом на біполярному PNP B772M; вибір — константою CHARGE_SWITCH_TYPE). Номінал, позначений червоним, на платі інший — 390 Ом у базі NPN обов'язкові для обох варіантів. Номінал, позначений жовтим, критичний лише для біполярного: з польовим ключем 1 кОм дає |VGS| 6.9 В при порозі 4 В, тобто ключ відкривається, просто з опором каналу вище паспортного. Логіка не інвертована: два інвертування взаємно скасовуються, тож 0 % на піні = ключ закритий = безпечно.

З польовим ключем ті самі два резистори означають інше. Затвор струму не споживає, тож R_drive 120 Ом і підтяжка 1 кОм — це дільник напруги: Uзатв = 0.2 + 13.8 × 120/1120 = 1.68 В, тобто |VGS| = 12.3 В. Вимикання повільніше за вмикання (вгору затвор тягне сама лише підтяжка): 1838 нс проти 260, разом 5 % періоду.

Пін не керує ключем напряму: між ними керуючий NPN, і насичення обох ланок мусить триматись на вершині пульсацій дроселя.

### Два резистори, які треба перепаяти

20 кОм → 390 Ом (пін 26 → база NPN) і 1 кОм → 120 Ом, 2 Вт (колектор NPN → база PNP). Поодинці жодна заміна не працює: замінити тільки другий означає попросити в NPN 106 мА, яких він при 20 кОм віддати не може.

Номінали пораховані на межі допуску живлення, а не на номінал: для силового ключа найгірша межа нижня (при 12.5 В струм бази падає), для керуючого NPN — верхня (при 16 В струм драйвера росте до 124 мА). Прошивка з нинішніми номіналами збереться, попередить у журналі й зупинить заряд сама відсічкою «ключ не тягне» приблизно за 5 секунд — але це запобіжник, а не дозвіл працювати без заміни.

ЛИСТ 3

## Вимірювальні кола

Три входи, усі на ADC1 — ADC2 не читається при увімкненому Wi-Fi, а точка доступу тут піднята завжди. Резистор 1 кОм перед кожним піном — струмообмеження входу; на показання він не впливає (вхід високоомний) і в перерахунок не входить.

Кожен вимір має власний подільник під свій діапазон: 20 В для живлення, 9 В для пакета, 1.5 В повної шкали для струму.

ЛИСТ 4

## 1-Wire і enable пакета

На лінії ДАНИХ резистор 2.2…4.7 кОм на +3.3 В обов'язковий і не є рекомендацією: чипи DS2433/DS2438 живляться з цієї лінії паразитно, і внутрішніх ~45 кОм ESP32 їм не вистачає. Резистор 4.7 кОм на лінії enable стоїть на платі, але обов'язковим не є — його поставив власник для попереднього налагодження функцій; прошивка веде цю лінію активно в обидва боки.

Шина живиться паразитно з лінії даних, а земля пакета відділена від землі ESP32 шунтом струму заряду.

### GPIO12: підтяжка потрібна, але це strapping-пін

Резистор 4.7 кОм із enable на +3.3 В обов'язковий: цією лінією активується сам пакет, і рівень на ній має бути визначеним навіть тоді, коли пін не веде її активно. Прошивка лише притискає лінію вниз, коли пакет має бути неактивним.

Водночас GPIO12 — це MTDI: рівнем на ньому в момент скидання ESP32 вибирає напругу флеш-пам'яті, і HIGH означає «флеш 1.8 В». Те, що ця плата з резистором стартує, означає, що eFuse напруги флеша вже пропалено (espefuse.py set_flash_voltage 3.3V) або флеш там справді 1.8 В. При переносі на інший модуль перше, що треба перевірити, — чи він узагалі завантажується.

### Внутрішня підтяжка зовнішню НЕ замінює

DS2433 і DS2438 живляться паразитно — струм на власну роботу беруть із тієї самої лінії даних у паузах між бітами. Внутрішня підтяжка ESP32 (~45 кОм) дає десятки мікроамперів: чипу не вистачає навіть утримати внутрішнє живлення, і він не відповідає взагалі. Виглядає це як «акумулятор не зчитується» при цілком справному коді.

Внутрішня все одно ввімкнена як другорядний запобіжник — від «лінія висить у повітрі» в паузах між операціями. Тут своя пастка: її знімає будь-який pinMode(pin, INPUT) (в arduino-esp32 INPUT = 0x01 без біта PULLUP = 0x04), а конструктор OneWire робить рівно це. Прошивка вмикає її явно після конструктора (dsIdle()).

GPIO12 — strapping-пін MTDI. Рівнем на ньому в момент скидання ESP32 вибирає напругу флеш-пам'яті: зовнішньої підтяжки вгору на ньому бути не може взагалі, інакше плата не завантажиться.

ЛИСТ 5

## Розряд і периферія

Резистор 10 кОм із затвора на землю не опційний: під час скидання ESP32 пін висить, і без нього ключ може лишитись відкритим.

ДОДАТОК A

## Карта пінів

GPIO | Призначення | Обв'язка | Примітка
4 | Підсвітка екрана (BLK) | — | ШІМ, плавна поява заставки
5 | Екран CS | — | На GMT130 виводу CS немає; пін заданий і нікуди не підключений
12 | 1-Wire enable пакета | 4.7к на 3.3 В | не обов'язковий — стоїть для налагодження. GPIO12 — strapping MTDI: підтяжка працює, бо eFuse флеша пропалено
13 | 1-Wire дані | 4.7к на 3.3 В | Зовнішня підтяжка обов'язкова — чипи живляться паразитно
14 | Світлодіод зелений | ~330 Ом | ШІМ для «дихання»
15 | Підсвітка кнопок | — | Необов'язково
16 | Екран RST | —
17 | Екран DC | —
18 | SPI SCK | — | Апаратний VSPI, ділити шину не можна
19 | Затвор MOSFET розряду | 100 Ом + 10к на GND | Він же VSPI MISO — порядок ініціалізації значущий
23 | SPI MOSI (SDA екрана) | —
25 | Звук: ЦАП → п'єзо | 1–10 мкФ послідовно | DAC1. Розділовий конденсатор обов'язковий: ЦАП видає 0…3.3 В із постійною складовою
26 | ШІМ заряду → база NPN | 390 Ом | на платі 20к
27 | Світлодіод червоний | ~330 Ом
32 | Спадковий enable | — | Утримується в LOW: колишній CHARGE_PIN
33 | Три кнопки (драбинка) | 10к / 5.28к / 10.37к | ADC1
34 | Напруга пакета | 20к/10к + 1к | ADC1, вхід-тільки
35 | Струм заряду | шунт 0.5 Ом + 1к | ADC1, вхід-тільки
39 | Напруга живлення | 68к/10к + 1к | ADC1, вхід-тільки

ДОДАТОК Б

## Робочі величини

Параметр | Значення | Звідки
Живлення, допуск | 12.5 … 16.0 В | Підтверджено власником
Немає живлення, поріг | < 6 В | Пакет підживлює шину через перехід ключа
Гістерезис порогів | 200 мВ | Проти блимання на межі
Частота ШІМ заряду | 25 кГц | Верх обмежений часом перезаряду затвора
Крейсерський струм заряду | 1000 мА | До 90 % заряду
Дозаряд малим струмом | 100 мА | Від 90 % і до самої цілі
Кінець повного заряду | 8.2 В | Паливомір покаже ~97 % — це норма
Напруга на затворі |VGS| | 12.3 В | Поріг 4 В · паспорт RDS(on) при 10 В · межа 20 В
Пульсації дроселя | 1303 мА | Пік 1651 мА при 104 мкГн
Розсіювання на ключі | 0.47 Вт з 55 | Радіатор не потрібен (з B772M було 0.82 з 1.25)
Стеля шпаруватості | 85 % | Повне відкриття = пряме з'єднання
Аварійна відсічка за піком | 3000 мА | Стереже «дросель випав із кола»
Відсічка «ключ не тягне» | < 50 % уставки, 5 опитувань | Рятує ключ поза насиченням
Опір навантаження розряду | 5 Ом / 25 Вт | Середня потужність 5…8 Вт
Екран, режим SPI | режим 3, 24 МГц | Панель без CS вимагає саме 3

ДОДАТОК В

## Перелік доопрацювань

Позиція | Стоїть | Треба | Стан
Пін 26 → база NPN | 20 кОм | 390 Ом | замінити
Колектор NPN → база PNP | 1 кОм | 120 Ом / 2 Вт | замінити
Керуючий NPN | — | 2N2222 / BC337 / S8050 | перевірити
Радіатор на B772M | — | потрібен | перевірити
10 кОм база NPN → GND | є | 10 кОм | на місці
Запираюча підтяжка бази PNP | 1 кОм | 1 кОм | на місці
Подільники вимірювання | 20к/10к, 1к | без змін | на місці
Подільник живлення | — | 68к/10к + 1к | новий вузол
Підтяжка даних (GPIO13 → 3.3 В) | ? | 2.2…4.7 кОм | перевірити
Підтяжка enable (GPIO12 → 3.3 В) | 4.7 кОм | не обов'язкова | стоїть для налагодження
Спільна земля з пакетом | ? | мінус пакета ↔ GND | перевірити
