roman885-85/moto_battery_reader/tools/README.md

# Заставка дисплея (splash)

Стартова заставка — монохромна битмапа **64×64** у `display.h`
(`static const unsigned char ngu_xbm[] = { ... };`, розмір `NGU_W`/`NGU_H`).

Для **кольорових TFT ST7789** — окремий генератор кольорової заставки нижче.

## Замінити на своє зображення (монохромні дисплеї)

Використайте **своє** зображення (на яке маєте права):

```bash
pip install pillow
python tools/make_splash.py моя_картинка.png            # темне -> світиться
python tools/make_splash.py моя_картинка.png --invert   # інверсія
python tools/make_splash.py моя_картинка.png --dither    # напівтони (дизеринг)
```

Скрипт надрукує готовий блок `#define NGU_W/H` + `ngu_xbm[]` — вставте його у
`display.h` замість наявного масиву. Розмір лишається 64×64.

> ⚠️ Не використовуйте захищені авторським правом персонажі/лого без прав на них.

## Кольорова заставка (TFT ST7789)

Для кольорових дисплеїв — `make_color_splash.py`: генерує `custom_splash.h`
з масивом **RGB565** під вашу роздільність.

```bash
pip install pillow
python tools/make_color_splash.py logo.png -W 240 -H 240     # ST7789VW 240x240
python tools/make_color_splash.py logo.png -W 240 -H 280     # ST7789V3 240x280
python tools/make_color_splash.py logo.png -W 240 -H 320 --fit cover
python tools/make_color_splash.py logo.png --bg 001B3A       # колір фону (HEX)
```

Покладіть згенерований `custom_splash.h` у папку скетчу і ввімкніть у
`settings.h`:  `#define DISPLAY_SPLASH_CUSTOM`. Заставка малюється по центру.

## Розбір і звірка дампів (`decode_dump.py`)

Анотований розбір дампа IMPRES-чіпа й побайтова звірка «еталон vs клон».
Перевіряє ті самі інваріанти, що й прошивка: заголовок DS2433 Σ≡0x41,
TLV-записи Σ≡0x5A, дзеркало DS2438[24:50]↔DS2433[1:27], ємність (запис 0x17+21),
ETM/ICA/CCA/DCA у DS2438.

```bash
# Розбір дампа (DS2438 — необов'язковий)
python tools/decode_dump.py dump33.bin dump38.bin

# Витягти вшитий еталон із templates.h у .bin (для звірки клонів)
python tools/decode_dump.py --template PMNN4409B --out ref
#   -> ref_33.bin (512) + ref_38.bin (64)

# Побайтова звірка: «●» — розбіжність в ідентичності/калібруванні (важливо),
#                   «○» — лічильники/живі виміри (норма після скидання)
python tools/decode_dump.py ref_33.bin ref_38.bin --diff clone33.bin clone38.bin
```

## Хостові тести (`*_check.cpp`)

Збираються звичайним `g++` і ганяються **на комп'ютері**, без ESP32. Запускати
з КОРЕНЯ проєкту — частина з них читає корпус дампів у `dumps/`:

```bash
mkdir -p build
for f in tools/*_check.cpp; do
  n=$(basename "$f" _check.cpp)
  g++ -std=c++17 -I. -Itools/fake -o "build/$n" "$f" && "./build/$n" || echo "ЗБІЙ: $n"
done
```

### ⚑ Матриця конфігурацій — одного прогону мало

Один код обслуговує **два пристрої** (`DEVICE_VARIANT`), а всередині того з
них, що має власний понижувач, є ще й **два силові ключі**
(`CHARGE_SWITCH_TYPE`). Обидва вибори міняють не оформлення, а самі числа й
самі гілки коду, тож зелений прогін в одній конфігурації нічого не доводить
про другу. Мінімальна чесна матриця — ТРИ прогони, плюс **четвертий: збірка
без Bluetooth**.

Четвертий доданий не для повноти. Правила режиму зв'язку живуть у ДВОХ
світах, і кожне має сенс лише в своєму: «збережений Bluetooth на прошивці без
Bluetooth не лишає прилад німим» перевіряється тільки там, де стека немає, а
«перемикач справді перемикає» — тільки там, де він є. Звірка «від
протилежного» це й показала: поломки в `radio_mode.h`, які не валили НІЧОГО в
одному світі, валили свої перевірки в другому.

Типово Bluetooth **увімкнено**, тож три основні прогони йдуть зі стеком,
четвертий збирає світ, де його немає, а п'ятий — світ, де запис по радіо
вимагає пароль.

```bash
mkdir -p build
for dev in 0 1; do                        # 0 = плата TL494, 1 = власний понижувач
  for sw in 0 1; do                       # тип ключа має сенс лише в понижувача
    [ "$dev" = 0 ] && [ "$sw" = 1 ] && continue
    for f in tools/*_check.cpp; do
      n=$(basename "$f" _check.cpp)
      g++ -std=c++17 -I. -Itools/fake \
          -DDEVICE_VARIANT=$dev -DCHARGE_SWITCH_TYPE=$sw \
          -o "build/$n" "$f" && "./build/$n" >/dev/null \
          || echo "ЗБІЙ: $n (пристрій $dev, ключ $sw)"
    done
  done
done
# ⚑ ЧЕТВЕРТИЙ ПРОГІН: збірка БЕЗ Bluetooth. Див. пояснення вище.
#  Типово Bluetooth увімкнено (див. settings.h), тож три прогони вище — це вже
#  світ зі стеком; окремо зібрати треба саме світ, де його немає.
for f in tools/*_check.cpp; do
  n=$(basename "$f" _check.cpp)
  g++ -std=c++17 -I. -Itools/fake -DBT_OFF -o "build/${n}_off" "$f" \
      && "./build/${n}_off" >/dev/null || echo "ЗБІЙ БЕЗ BT: $n"
  # ⚑ П'ЯТИЙ ПРОГІН: світ, де запис по радіо вимагає пароль. Типово його
  #  вимкнено (BT_REQUIRE_AUTH 0, рішення власника), тож без цього рядка
  #  правило доступу перевірялось би лише в одній зі своїх відповідей — і
  #  саме так перевірка вже одного разу впала на робочому рішенні.
  g++ -std=c++17 -I. -Itools/fake -DBT_REQUIRE_AUTH=1 -o "build/${n}_auth" "$f" \
      && "./build/${n}_auth" >/dev/null || echo "ЗБІЙ З ПАРОЛЕМ: $n"
done
python3 tools/topology_check.py          # чужі імена в живому коді — обидві топології
python3 tools/check_page_js.py           # цілісність вшитої сторінки
python3 tools/client_audit.py            # обробники й кнопки в усіх трьох клієнтах
python3 tools/templates_reply_check.py   # список моделей у клієнті-програмі
```

`tools/topology_check.py` стоїть окремо не для симетрії: `web_server.h` на
хості **не збирається взагалі**, тож жоден `*_check.cpp` не побачив би там
звертання до макроса, якого за обраної топології не існує. Препроцесувати
його при цьому цілком можна — на цьому перевірка й побудована (докладніше — у
шапці самого файлу). Вона ганяє саме `CHARGE_TOPOLOGY`, а не `DEVICE_VARIANT`:
питання там суто про заряд, і прив'язувати його до екрана не було б за що.

| Тест | Що перевіряє |
|---|---|
| `battery_read_check` | посторінкове читання DS2433 на СПРАВЖНЬОМУ `BatteryReader::readBattery()` проти симульованої шини з просіданням живлення й шумом; **плюс перевірка лінії enable/підтяжки** — пін тепер моделюється (записане читається назад), тож видно, що прошивка справді розрізняє коротке на землю, коротке на живлення й справну лінію, і повертає стан піна після перевірки |
| `audit_check` | аудит змісту (чужий ключ шифрування, побиті суми блоків) на всьому корпусі `dumps/`; **три стани лічильника не-IMPRES** — прочитаний, чесний нуль, нечитабельний (нечитабельне не сміє показуватись нулем); і **автоправка побитого лічильника розряду**: на 65 парах дампів вона спрацьовує рівно один раз — на тому, де регістр справді побитий, — чіпає **тільки** байти 62/63, а в разі відмови не змінює **жодного** байта; окремо звірені шість причин відмови |
| `hdrfix_check` | добудова заголовка з дзеркала DS2438 — і відсутність хибних спрацювань на 55 дампах |
| `clone_check` | відновлення за зразком китайської копії (шунт, паспортна ємність із дзеркала) |
| `charge_logic_check` | заряд на СПРАВЖНЬОМУ `charge.h`: профіль струму, регулятор шпаруватості, стартова точка понижувача, вимір струму/напруги, тепловий бюджет біполярного ключа, **контроль живлення +14 В** (класифікація, гістерезис, розрахунок на живому вимірі) і **обидві рантайм-відсічки** (`chargePsuTrip`, `chargeNoDriveTrip`); окремо — **примусове пробудження** (розділи 20–25): стеля НАПРУГИ через стелю шпаруватості на всьому діапазоні живлення, збіжність регулятора на моделі «пакет ожив», вироки й відмови режиму, і **порахована найгірша мить** — стрибок струму в секунду, коли контролер замикає ключ (число залежить від `CHARGE_SWITCH_TYPE` і друкується щоразу) |
| `session_guard_check` | **взаємний захист заряду й розряду** на справжніх `charge.h`/`discharge.h`: зупинка однієї операції не має знімати апаратного сторожа, сигнал enable та індикацію в ІНШОЇ, що саме йде; плюс те, що скетч справді споживає прапорець перемальовки заряду й опитує живлення в спокої, а `chargeTask()` **справді викликає** обидві відсічки; окремо — що **примусове пробудження** ввімкнене в роботу на всіх поверхнях: `chargeTask()` віддає йому керування, стеля напруги ставиться й на старті, і щопроходу, умови/вироки беруться з `charge.h`, а не переписані на місці, спільні запобіжники (пік, живлення, сторож) стоять в ОБОХ машинах, і кнопка з обробником є в кожному з трьох клієнтів; і, окремо, **пін звуку** — що перевірка його збігу з силовими стоїть ПІСЛЯ всіх пінів, з якими порівнюється (у ранньому блоці вона мовчала: макросів на той момент ще немає), і що клієнти рахують наявним буззером ЦАП-варіант, а не лише ШІМ. Плюс **комбінації кнопок** (`combo.h`): вони набираються навмисно й не набираються випадково — пауза довша за 600 мс рве ланцюжок, утримання рве, чужа клавіша відкочує лік за Кнутом-Моррісом-Праттом; **колір шкали заряду** — монотонний перехід червоне → зелене без стрибків і без провалу яскравості на середині; і те, що **вимикач заряду** справді ввімкнено в роботу на всіх поверхнях: обидва драйвери екрана, меню, диспетчер операцій у скетчі, КОЖНА веб-точка окремо, USB-протокол і всі три клієнти. І, окремо, **панель операції повертається в початковий стан**: JSON віддає ДВА різні поля («яким показати підсумок» і «чи зайняте залізо») з різних функцій прошивки; клієнти ховають уставки за другим, а не за першим; кінцеві точки «прибрати підсумок» існують, підключені й НЕ закриті гейтом вимкненого заряду; усі три клієнти мають і дію, і кнопку, і видимий показ недоступності. Перевіряються **визначення** функцій, а не згадки імені: кнопка з `onclick` лишає ім'я у файлі й тоді, коли функції вже немає |

> ⚑ Чому відсічки заряду перевіряються двома різними способами. `web_server.h`
> і `display_color.h` на хості не збираються взагалі (WebServer, SPIFFS, U8g2,
> ArduinoJson), тож усе написане всередині них не покриває жоден тест
> безпосередньо. Тому логіка рішення
> живе в `charge.h` (її викликає `charge_logic_check` напряму), а `session_guard_check`
> сканує текст `web_server.h` і перевіряє, що виклики звідти нікуди не поділись.
> «Функція правильна» і «функцію хтось кличе» — різні твердження: у цьому
> проєкті вже був випадок, коли `chargeMarkDirty()` працював бездоганно, а
> `chargeConsumeDirty()` у скетчі не викликав ніхто, і заряд ніколи не оновлював
> екран.
| `reset_consistency_check` | **скидання лічильників не ламає оригінальність**: на всьому корпусі `dumps/` перевіряє, що після скидання/очистки лишаються цілими заголовок, суми TLV, дзеркало й аудит; окремо доводить на корпусі, що обнулений монітор проти повного історії DS2433 — це стан рівно тих двох дампів, які рація відкинула. Плюс **наробіток, записаний у самому пакеті** (CCA/DCA у блоці NONSMART, звідки їх бере зарядна станція): він є в 58 пакетах, у всіх ненульовий, після скидання нульовий, сума блока ціла; скидання не починає відмовляти масово; правка лічильника розряду після скидання не має звідки брати число — і не бере; а блок, який читач розбирає, а писар ні, змушує скидання відмовитись, а не збрехати про успіх |
| `mirror_plan_check` | **синхронізація дзеркала DS2438 → DS2433 з правкою**: побайтова різниця, зняття окремих байтів, ручна паспортна ємність (округлення до кроку 25 і затиск), непридатне джерело; плюс прогін по всьому корпусу `dumps/` — цілим пакетам не стає гірше, операція ідемпотентна. Окремо — **свідчення «чи монітор від цього пакета»**: наробіток проти віку тим самим правилом, що й аудит (звірка на сітці пар, а не на числі допуску), мовчання без дати, і те, що поява дати не скидає розставлених галочок |
| `ds2438_write_check` | **лічильники в DS2438 справді доїжджають до чипа** — на справжньому `BatteryReader::writeDS2438()` проти моделі чипа з «живими» регістрами накопичувача: поки увімкнено вимір струму (біт IAD), DS2438 сам оновлює ICA/CCA/DCA і затирає щойно записане. Перевіряє, що прошивка знімає IAD на час запису, повертає конфігурацію останньою сторінкою і **помічає** невдалий запис; окремо — сценарій «від протилежного»: та сама послідовність без зняття IAD лишає в чипі старі числа |
| `soc_curve_check` | **шкала заряду за напругою для 2S**: паспортні межі (3.00/4.20 В на банку), монотонність кривої, точність у вузлах, оборотність «% → В → %», і окремо — наскільки стара ПРЯМА завищувала показ на розрядженому пакеті (до +24 %); плюс те, що від зміни шкали не виродився дозаряд і не поїхав паливомір |
| `display_fit_check` | **текст не вилазить за плашку**: механізм переносу (`textwrap.h`) і всі написи банера помилки живлення на кожній підтримуваній панелі, зі скругленими кутами й без |
| `menu_check` | **меню пристрою** на справжньому `operations.h`: кожна операція каталогу є в списку рівно один раз (порядок показу — окрема таблиця, тож операцію легко забути вписати), групи йдуть суцільно й у заданому порядку, перемикач цілі стоїть одразу після своєї дії, у щоденних групах немає незворотного, стрибок по групах обходить усі групи за один оберт, а назви влазять і в буфер (кирилиця — 2 байти на літеру), і в рядок списку на кожній із семи панелей. Окремо — **версія пристрою без заряду**: група ЗАРЯД зникає цілком разом із заголовком, `opNeedsCharge()` називає рівно її операції («Заряд з напруги» до них НЕ належить — він нічого не заряджає), решта каталогу лишається на місці, стрибок по групах не потрапляє в порожню групу, курсор затискається, а вмикання назад повертає список байт у байт |
| `smart_check` | **ручні уставки й розумний профіль 2S** на справжніх `charge.h`/`discharge.h`: струми рахуються від ПАСПОРТНОЇ ЄМНОСТІ пакета (0.5C / 0.1C / 0.05C) і затискаються стелею заліза, фази йдуть за напругою в правильному порядку, уставка в зоні CV спадає **всередині** зони (а не одним стрибком на цілі) й рівно на цілі дорівнює порогу завершення, температурне вікно рахується в **десятих** градуса (цілі ховають −0.1 °C), «повний» ставиться за СТРУМОМ і тільки у фазі CV, ручна уставка не може ПІДНЯТИ струм у дозаряді, оцінка залишку часу подвоюється в CV і мовчить, коли рахувати нема з чого. Окремо — **повний цикл на моделі пакета** 2500 мА·год від 6.50 В: мусить завершитись САМ, не перевищивши цілі, і пройти обидві фази |
| `wizard_check` | **правила Майстра відновлення** на справжньому `wizard_rules.h` (заради цього тесту чисту частину правил і винесено з `recovery.h`, який на хості не збирається): перелік проблем суцільний і без дірок; кожна проблема має і діагноз, і пропозицію; кожна потрапляє **або** в план робіт, **або** в перелік «кроку не буде — ось чому» (і «ні там, ні там», і «і там, і там» валять тест — саме так знайшлися п'ять проблем, які Майстер називав і мовчки лишав без ліків); кожен крок має назву, опис і **власний** машинний код; крок, що пише в чип, називає який; порядок плану — ремонт структури перед перешифруванням, станція після калібрування, правка лічильника **не** перед скиданням, яке її зітре, перевірка результату завжди остання, «чіпів немає» обриває план на читанні |
| `templates_reply_check` | **список моделей-еталонів у клієнті-програмі** (`usb_client/moto_models.py`): невдала відповідь на `TEMPLATES` не сміє затирати вже завантажений список; порожнеча ніколи не мовчить, а два її різні випадки («не приїхало» проти «у прошивці немає шаблонів») не плутаються, бо поради в них протилежні; напис-заглушку неможливо ВИБРАТИ й неможливо відправити в запис; і, окремо, що всі три поверхні (Майстер, «Новий акумулятор», «Відновити еталон») питають ОДНУ перевірку готовності, у Майстрі є кнопка «оновити список», а сам `TEMPLATES` більше не питається першим у пачці команд під'єднання |
| `radio_mode_check` | **режим зв'язку** на справжньому `radio_mode.h`: увімкнених радіо рівно одне на КОЖНОМУ з 256 значень (число приходить із файла, який могли побити, і з команди ззовні); те, що не підняти, не обирається — і в збірці з Bluetooth, і в збірці без нього (доступність передається параметром, а не читається з `#ifdef`, інакше половина правил перевірялась би лише в одному світі); коло режимів не заводить у недоступний і не просить перезавантаження дарма; файл налаштувань пишеться, читається й **розуміє старий формат** (у приладі власника в ньому записано, що силової частини немає); розбір каже, ЩО ЗАПИСАНО, і не вирішує за залізо — на це є окреме правило, і саме воно рятує від німого приладу |
| `buzzer_dac_check` / `buzzer_ledc_check` | синтез звуку (ЦАП і ШІМ); вмикають звук ЯВНО, незалежно від того, який вихід обрано в `settings.h` — тест на ШІМ мусить проходити й тоді, коли в пристрої стоїть ЦАП; побічно пишуть демо-`.wav` у поточну теку |

Кожен тест друкує підсумковий рядок і повертає ненульовий код при збої.

## Допоміжні скрипти

| Скрипт | Навіщо |
|---|---|
| `mk_page_header.py` | вшиває `index.html` у прошивку: робить `page_index.h` (gzip). **Запускати після кожної правки сторінки** — охоронець 27 звіряє їх за CRC32 і сам друкує цю команду |
| `check_page_js.py` | синтаксична перевірка всього вбудованого JavaScript (обидві сторінки й аварійна `PAGE_LITE`). Помилка в скрипті дає білий екран у браузері, і без цієї перевірки знайти її можна лише на пристрої. Потребує `node`; без нього чесно каже, що нічого не перевіряв |
| `client_audit.py` | аудит клієнтів: кожен `onclick` має існуючу функцію, кожен `$('id')` — елемент, кожен викликаний API/USB-командa є в прошивці; ключ шифрування береться з ROM цільового чипа. **Плюс єдиний вигляд панелей операцій**: склад і порядок плиток заряду / розряду / пробудження звіряються **між трьома клієнтами** (уміє розібрати і JS, і Python) — порядок порівнюється списком, бо однаковий набір у різному порядку і є «різні панелі»; кожна плитка мусить десь заповнюватись; панелі мусять малюватись спільним кодом (`opTiles`/`opBand`/`opSpark` у вебі, один клас `OpMonitor` в `.exe`) |

## Готовий нейтральний варіант

`tools/make_splash.py` можна нагодувати будь-якою картинкою. Приклад згенерованої
нейтральної новорічної заставки (сніжинка) — див. запит до асистента.

> ⚠️ Не використовуйте захищені авторським правом персонажі/лого без прав на них.
