roman885-85/moto_battery_reader/dumps/README.md

# 📼 Архів дампів акумуляторів Motorola IMPRES

Реальні дампи, зібрані під час розробки цього інструмента: **робочі** (рація приймає як
справні IMPRES) і **несправні** (визначаються як невідомі, не заряджаються, не вмикаються),
а також дампи з **експериментів** — до/після скидання, рекалібрування, заміни елементів,
часткового стирання та перепрошивки чужим шаблоном.

Це фактична доказова база, на якій побудовані `templates.h`, правила Майстра відновлення
(`recovery.h`) і рецепт підготовки до рекалібрування.

## Що всередині

Кожна тека = одне спостереження власника:

- **`notes.md`** — опис **дослівно словами власника**: стан АКБ, що показує рація або ЗП,
  що робили перед зняттям дампа. Змінено лише одне — довгі hex-блоки замінено посиланнями
  на файли, щоб текст лишався читабельним.
- **`files/*.bin`** — самі дампи: `NN_<модель>_2433.bin` (512 Б, EEPROM DS2433) і
  `NN_<модель>_2438.bin` (64 Б, монітор DS2438). Однаковий номер `NN` = той самий АКБ.

> ⚠️ **Прив'язка опису до АКБ.** У вихідних повідомленнях опис стану стоїть **перед**
> блоком «Модель / Серійний / дампи», якого він стосується. Саме тому поруч із бінарниками
> збережено `notes.md` **цілком** — щоб зв'язок «опис ↔ дамп» можна було перевірити за
> оригіналом, а не покладатися лише на назву файла.

## Як читати дамп

```bash
python tools/decode_dump.py dumps/02-katalog-osnovnyi/files/01_PMNN4493A_2433.bin \
       --ds2438 dumps/02-katalog-osnovnyi/files/01_PMNN4493A_2438.bin

# звірити з вшитим еталоном (genuine vs клон)
python tools/decode_dump.py --template PMNN4409B          # -> ref_33.bin / ref_38.bin
python tools/decode_dump.py dumps/.../XX_2433.bin --diff ref_33.bin
```

## Зведення

Усього **58** акумуляторів, **66 дампів** (два пакети зняті двічі — до і після
зарядної станції; 131 файл: DS2433 + DS2438).

| Формат прошивки | Шт. |
|---|---|
| 2014 | 9 |
| 2017 | 11 |
| 2021 | 3 |
| не визначено (стертий / нетиповий) | 26 |

Заголовок DS2433 валідний (Σ≡0x41) у **64** із **66** дампів. Невалідних два:

* `01-katalog-pershyi/10` (Σ=0x00) — той АКБ, який власник позначив як
  **можливу китайську копію** (PT4409A);
* `20-vymahaie-vidnovlennya/03` (Σ=0x8E) — робочий пакет (індикація заряду
  працює), у якого зіпсовано рівно два байти: сама сума `0x1F` і байт `0x20`.
  Саме на ньому знайшлася хибна діагностика «станція почала добудову»
  (див. `notes.md` тієї теки).

### `01-katalog-pershyi/` — Перший каталог

Робочі оригінали (PMNN4488A / PMNN4493A), далі — оригінали, які визначаються як **невідомі** або **не вмикаються** (PMNN4409A), підозра на **копію** (PT4409A) і оригінали **після заміни елементів**.

| # | Модель | Формат | Заголовок | Знос % | U, В | ICA | CCA | DCA |
|---|---|---|---|---|---|---|---|---|
| 01_PMNN4488A | PMNN4488A | 2017 | ✅ | — | 7.47 | 231 | 10240 | 8192 |
| 02_PMNN4488A | PMNN4488A | 2017 | ✅ | — | 7.37 | 152 | 25856 | 23808 |
| 03_PMNN4488A | PMNN4488A | 2017 | ✅ | — | 7.66 | 163 | 2816 | 1280 |
| 04_PMNN4488A | PMNN4488A | 2017 | ✅ | — | 6.97 | 150 | 8704 | 6400 |
| 05_PMNN4493A | PMNN4493A | 2017 | ✅ | — | 7.75 | 154 | 14594 | 3842 |
| 06_PMNN4409A | PMNN4409A | ? | ✅ | — | 7.93 | 175 | 65281 | 40449 |
| 07_PMNN4409A | PMNN4409A | ? | ✅ | — | 7.39 | 0 | 23306 | 48393 |
| 08_PMNN4409A | PMNN4409A | ? | ✅ | — | 7.42 | 0 | 38664 | 21256 |
| 09_PT4409A | PT4409A | ? | ✅ | — | 8.32 | 215 | 0 | 0 |
| 10 | — | ? | ❌ 0x00 | — | 7.99 | 13 | 36353 | 28161 |
| 11_PMNN4409A | PMNN4409A | ? | ✅ | — | 8.13 | 255 | 65535 | 45074 |
| 12_PMNN4409A | PMNN4409A | ? | ✅ | — | 7.87 | 216 | 60691 | 15635 |
| 13_PMNN4409A | PMNN4409A | ? | ✅ | — | 7.98 | 218 | 52491 | 23051 |

### `02-katalog-osnovnyi/` — Основний каталог (18 АКБ)

Кожен АКБ із **серійником DS2438** і **описом поведінки на рації**: «потребує відновлення», «невідома батарея» або «справний IMPRES(tm)» з датою першого користування та залишком ресурсу. Наприкінці — оригінали після заміни елементів.

| # | Модель | Формат | Заголовок | Знос % | U, В | ICA | CCA | DCA |
|---|---|---|---|---|---|---|---|---|
| 01_PMNN4493A | PMNN4493A | 2017 | ✅ | — | 8.13 | 149 | 11010 | 1794 |
| 02_PMNN4409B | PMNN4409B | 2014 | ✅ | — | 8.01 | 134 | 10761 | 25864 |
| 03_PMNN4493A | PMNN4493A | 2017 | ✅ | — | 8.31 | 163 | 30465 | 19201 |
| 04_PMNN4409B | PMNN4409B | 2014 | ✅ | — | 7.97 | 10 | 12295 | 57350 |
| 05_PMNN4409A | PMNN4409A | ? | ✅ | — | 7.90 | 17 | 24581 | 64772 |
| 06_PMNN4409A | PMNN4409A | ? | ✅ | — | 8.08 | 99 | 48395 | 22795 |
| 07_PMNN4409B | PMNN4409B | 2014 | ✅ | — | 8.04 | 197 | 21507 | 33282 |
| 08_APLI4810C | APLI4810C | ? | ✅ | — | 8.34 | 138 | 0 | 0 |
| 09_PMNN4809A | PMNN4809A | 2021 | ✅ | — | 8.70 | 142 | 17408 | 15360 |
| 10_PMNN4409A | PMNN4409A | ? | ✅ | — | 7.85 | 67 | 46857 | 33033 |
| 11_PMNN4488A | PMNN4488A | 2017 | ✅ | — | 7.69 | 163 | 2816 | 1280 |
| 12_PMNN4488A | PMNN4488A | 2017 | ✅ | — | 7.45 | 231 | 10240 | 8192 |
| 13_PMNN4488A | PMNN4488A | 2017 | ✅ | — | 7.41 | 152 | 25856 | 23808 |
| 14_PMNN4409A | PMNN4409A | ? | ✅ | — | 7.93 | 175 | 65281 | 40449 |
| 15_PMNN4488A | PMNN4488A | 2017 | ✅ | — | 7.01 | 150 | 8704 | 6400 |
| 16_PMNN4409A | PMNN4409A | ? | ✅ | — | 8.13 | 255 | 65535 | 45074 |
| 17_PMNN4409A | PMNN4409A | ? | ✅ | — | 7.87 | 216 | 60691 | 15635 |
| 18_PMNN4409A | PMNN4409A | ? | ✅ | — | 7.98 | 218 | 52491 | 23051 |

### `03-do-kalibruvannya/` — Стан до калібрування

Оригінальний робочий (рація показує повну інформацію IMPRES) проти проблемного.

| # | Модель | Формат | Заголовок | Знос % | U, В | ICA | CCA | DCA |
|---|---|---|---|---|---|---|---|---|
| 01_PMNN4409B | PMNN4409B | 2014 | ✅ | — | 7.42 | 205 | 49920 | 59136 |
| 02_PMNN4409B | PMNN4409B | 2014 | ✅ | — | 8.21 | 198 | 51712 | 59648 |

### `04-dodatkovyi-2438-a/` — Додатковий дамп

| # | Модель | Формат | Заголовок | Знос % | U, В | ICA | CCA | DCA |
|---|---|---|---|---|---|---|---|---|
| 01 | PMNN4409B | 2014 | ✅ | — | 7.47 | 206 | 49920 | 59136 |

### `05-dodatkovyi-2438-b/` — Додатковий дамп

| # | Модель | Формат | Заголовок | Знос % | U, В | ICA | CCA | DCA |
|---|---|---|---|---|---|---|---|---|
| 01 | PMNN4409A | ? | ✅ | — | 7.84 | 67 | 46857 | 33033 |

### `06-pislya-rekalibruvannya/` — Після рекалібрування

Перепрошитий АКБ пройшов цикл рекалібрування → рація: **невідомий акумулятор**. Через 15 днів спокою зросли цикли заряду, дата першого запуску — хибна.

| # | Модель | Формат | Заголовок | Знос % | U, В | ICA | CCA | DCA |
|---|---|---|---|---|---|---|---|---|
| 01_PMNN4409A | PMNN4409A | ? | ✅ | — | 7.97 | 144 | 1545 | 0 |

### `07-skydannya-vidnovlennya/` — Скидання / відновлення

Після скидання, відновлення й підготовки до калібрування оригінальна ЗП **не заряджає**, а показує як заряджений (зелений індикатор).

| # | Модель | Формат | Заголовок | Знос % | U, В | ICA | CCA | DCA |
|---|---|---|---|---|---|---|---|---|
| 01_PMNN4409A | PMNN4409A | ? | ✅ | — | 7.71 | 128 | 0 | 0 |

### `08-nova-batareya/` — «Нова батарея»

Стирання й запис запрацювали; створено нову батарею з вшитого шаблону.

| # | Модель | Формат | Заголовок | Знос % | U, В | ICA | CCA | DCA |
|---|---|---|---|---|---|---|---|---|
| 01_PMNN4409A | PMNN4409A | ? | ✅ | — | 7.84 | 128 | 0 | 0 |
| 02 | PMNN4409A | ? | ✅ | — | 7.91 | 126 | 0 | 0 |
| 03 | PMNN4409A | ? | ✅ | — | 7.91 | 0 | 0 | 0 |

### `09-4409a-z-proshyvkoyu-4809a/` — 4409A з прошивкою 4809A

На PMNN4409A залито прошивку PMNN4809A — **запрацювали** режим калібрування й заряджання.

| # | Модель | Формат | Заголовок | Знос % | U, В | ICA | CCA | DCA |
|---|---|---|---|---|---|---|---|---|
| 01 | PMNN4809A | 2021 | ✅ | — | 8.30 | 146 | 17408 | 15360 |

### `10-blymannya-pid-chas-kalibr/` — Блимання під час калібрування

Через 5–10 хв калібрування починає блимати червоний індикатор; після передергування — те саме.

| # | Модель | Формат | Заголовок | Знос % | U, В | ICA | CCA | DCA |
|---|---|---|---|---|---|---|---|---|
| 01 | PMNN4809A | 2021 | ✅ | — | 8.38 | 148 | 17408 | 15360 |

### `11-chastkove-stirannya/` — Часткове стирання

Якщо на «незаряджуваній» прошивці стерти частину даних — поведінка заряджання змінюється.

| # | Модель | Формат | Заголовок | Знос % | U, В | ICA | CCA | DCA |
|---|---|---|---|---|---|---|---|---|
| 01 | — | 2014 | ✅ | — | 8.12 | 38 | 1280 | 1024 |
| 02 | — | ? | ✅ | — | 8.08 | 37 | 1280 | 1024 |
| 03 | — | ? | ✅ | — | 8.08 | 0 | 0 | 0 |
| 04 | — | ? | ✅ | — | 8.12 | 0 | 0 | 0 |

### `12-eksperymentalnyi/` — Експериментальний АКБ

Після невеликої розрядки на рації заряджається і переходить у режим калібрування.

| # | Модель | Формат | Заголовок | Знос % | U, В | ICA | CCA | DCA |
|---|---|---|---|---|---|---|---|---|
| 01 | — | ? | ✅ | — | 8.07 | 2 | 0 | 0 |

### `13-dozaryadka-na-stantsii/` — Дозарядка на станції

Дамп після переходу в режим дозарядки на ЗП — для порівняння «до/після».

| # | Модель | Формат | Заголовок | Знос % | U, В | ICA | CCA | DCA |
|---|---|---|---|---|---|---|---|---|
| 01 | PMNN4409B | 2014 | ✅ | — | 7.49 | 126 | 0 | 0 |
| 02 | PMNN4409B | 2014 | ✅ | — | 7.58 | 127 | 49920 | 59136 |

---

## Призначення

- **Не** для клонування чужих акумуляторів: прошивка прив'язана до **моделі**, а не до
  серійника, і дампи викладені як матеріал для діагностики та ремонту **власних** АКБ.
- Порівняння «робочий проти зіпсованого» — основний спосіб перевіряти зміни у проєкті без
  деградації: саме так відлагоджено контрольні суми, дзеркало DS2438↔DS2433 і блок навченої
  калібровки `0x1B0–0x1FF`.
