roman885-85/moto_battery_reader/docs/RELEASE-v2.0.md

# v2.0 — прилад без дроту й пакет без прихованої історії

> **Тег:** `v2.0` · **Коміт:** гілка `main` на момент випуску
>
> Це текст для сторінки релізу на GitHub. Створити реліз: *Releases → Draft a
> new release → Choose a tag → створити `v2.0` → Target: `main`* — і вставити
> все, що нижче риски.

---

## Дві великі зміни й один довгий розбір

Від [v1.0](RELEASE-v1.0.md) додалось дві речі, які видно одразу, і одна, якої
не видно взагалі, — але саме вона найважливіша.

**Bluetooth став режимом роботи.** Прилад розмовляє з клієнтами або по Wi-Fi,
або по Bluetooth — за вибором у меню, п'ятим рядком списку.

**Редактор більше не лишає в пакеті прихованої історії.** Виправлення дати чи
лічильників доводилось до кінця, а не наполовину, — і саме через цю
«половину» зарядна станція роками повертала свої числа.

---

## Зв'язок: одне радіо за раз

Bluetooth у проєкті був давно (той самий командний протокол поверх SPP, тобто
звичайного COM-порту по ефіру), але лишався вимкненим із чесно записаною
причиною: **«на залізі з увімкненим Bluetooth пристрій перестав під'єднуватись
по Wi-Fi»**. Причина була названа правильно — стек Bluedroid бере близько
70 КБ купи одним шматком, а радіо в ESP32 одне на обидва протоколи, — але
лікували її вимиканням функції.

Тепер обидва стеки **не піднімаються разом**:

* режим обирається в меню приладу (група «ЗВ'ЯЗОК») і застосовується при
  старті — прилад перезавантажується сам;
* у режимі Bluetooth точка доступу, captive-portal і веб-сервер не
  піднімаються **взагалі** — не «піднімаються й простоюють»;
* прилад **не лишається німим**: Bluetooth піднімається ДО точки доступу, і
  якщо не піднявся (не та схема розділів, бракує пам'яті), вмикається Wi-Fi
  замість нього, з поясненням у журналі.

Клієнти ті самі — `moto_gui.py`, `client_usb.html`, `moto_bridge.py`. Прилад
по Bluetooth видно як звичайний COM-порт, тож міняти в них нічого не треба.

### Знайти прилад, не знаючи номера порту

У системі буває десяток COM-портів, і Windows підписує їх так, що вгадати наш
неможливо: усі Bluetooth-порти звуться однаково — «Standard Serial over
Bluetooth link». Вгадувати й не треба — **прилад представляється сам**.

Кнопка **«🔍 Знайти прилад»** обходить порти, питає кожен `PING` і
під'єднується до того, який назветься нашим. Однаково для USB і Bluetooth.

Заразом програма більше не плутає два порти однієї пари: вхідний канал
(яким під'єднатись неможливо в принципі, а його відкриття ще й виснуть на
кілька секунд) у пошук не потрапляє зовсім, а вихідний підписується **іменем
приладу** — його прилад теж називає сам, у відповідь `INFO`.

---

## Пам'ять IMPRES: одне питання — одна відповідь

Скарга власника: після ручного введення дати й циклів станція «знаходила
помилки» й повертала старі значення.

**Копії дати в чипі немає** — перебрали всі 512 байтів DS2433 на 41 дампі з
підібраним ключем. Станція її не копіює, а **перераховує**: дати зберігаються
зміщенням у добах від виготовлення, а стелю їм задає наробіток монітора з
ІНШОГО чипа. У 41 пакеті з 41 жодне зміщення не перевищує наробіток — стану
«подія пізніша за весь строк роботи» немає в жодному живому пакеті.

Саме такий стан і створювала наша правка: посунути дату виготовлення назад —
означає збільшити КОЖНЕ зміщення, не торкнувшись наробітку.

З циклами те саме, тільки місць **п'ять**: гістограма, внутрішній лічильник із
ревертами й дозарядами, калібрувальні цикли, CCA/DCA у пакеті та CCA/DCA
монітора. Редактор писав **одне** з них.

| після «цикли = 0», до виправлення | |
|---|---|
| внутрішній лічильник лишався ненульовим | **41 із 41** |
| CCA/DCA у пакеті недоторкані | **41 із 41** |
| власний підбір ключа втрачав однозначність | **41 із 41** |

Останній рядок найважчий: прошивка після власної ж правки переставала
розбирати пакет — і ніхто про це не питав.

Тепер стеля родини лічильників живе в одному місці й **притискає, але не
піднімає**; датам додано стелю за наробітком, і лагодиться вона опусканням
події, а не підняттям наробітку.

---

## Типовий пристрій — `DEVICE_BUCK`

Зводячи дві теки в одну (v1.0), типовим лишили `DEVICE_TL494` — просто тому,
що в корені сховища доти лежав саме той пристрій. Ціна виявилась не
косметичною: зібрана без ручної правки прошивка налаштовувала ST7789 як панель
240×280 зі скругленням, і на квадратній 240×240 малювання лягало **повз видиму
область** — підсвітка є, зображення немає.

Тепер типовий — `DEVICE_BUCK`. Для приладу на платі TL494 задайте
`DEVICE_TL494` явно.

---

## Як це перевіряється

**20 хостових тестів** збираються звичайним `g++` і ганяються без ESP32 — на
справжніх заголовках прошивки. Матриця виросла з трьох конфігурацій до
**п'яти**: обидва пристрої, обидва ключі, збірка без Bluetooth і збірка, де
запис по радіо вимагає пароль. Кожна додана не для симетрії — у кожній живуть
правила, яких в інших немає з чого перевірити.

`tools/topology_check.py` дістав розділ **«використано раніше, ніж
оголошено»**. Скетч не компілюється на хості жодним тестом, і помилка
«X was not declared in this scope» доходила не до нас, а до власника, просто в
Arduino IDE. Препроцесувати скетч при цьому можна завжди — а в готовому тексті
видно те саме, що бачить компілятор: порядок.

Головний метод лишився той самий — **звірка «від протилежного»**: кожну
перевірку навмисно ламають і дивляться, чи впаде саме вона. За цей цикл вона
знайшла з десяток перевірок, які не стерегли нічого, і двічі — перевірку, що
падала на **правильному** рішенні, бо стерегла одну з відповідей правила, а не
саме правило.

---

## Збірка

Arduino IDE, плата ESP32 (звичайний — на S3/C3/C6 класичного Bluetooth немає
фізично). Схема розділів **Huge APP (3MB No OTA/1MB SPIFFS)** тепер
обов'язкова: разом зі стеком Bluetooth прошивка в типову не влізе. Не потрібен
Bluetooth — закоментуйте `BT_ON` у `settings.h`, і звичайна схема знову
підійде.

Вибір пристрою — `DEVICE_VARIANT` у найпершому блоці `settings.h`. Схема одним
аркушем — `SCHEMATIC.html`, покрокова інструкція — `INSTRUCTION.md`, повна
історія змін із розборами дефектів — `CHANGES.md` (розділи 3.58–3.65).

## Застереження

Прилад пише в пам'ять акумуляторів і керує силовою частиною під напругою.
Перед першим зарядом перевірте мультиметром, що при нульовій уставці на клемі
~0 В. Робіть резервні копії `.bin` **до** будь-якого запису.

⚠️ **Запис по Bluetooth пароля не вимагає** (`BT_REQUIRE_AUTH 0`). Єдиний
бар'єр — PIN спарювання, тож стандартний «1234» варто змінити, якщо прилад
працює не лише на столі: спарований комп'ютер може віддати будь-яку команду,
включно з повним стиранням пам'яті пакета.
