roman885-85/moto_battery_reader/dumps/20-vymahaie-vidnovlennya/notes.md

# Партія з дев'яти пакетів: «в свойствах пишет восстановить аккумулятор»

> Джерело: повідомлення власника (сесія розробки). Дев'ять акумуляторів,
> знятих поспіль одним заходом; у двох із них дамп знято **двічі — до і після
> зарядної станції**. Нижче — опис стану **словами власника**, дослівно, у
> тому самому порядку, у якому вони йшли у вихідному повідомленні.

## Що в теці

Однаковий номер `NN` = той самий акумулятор. Суфікси `a`/`b` — **до** і
**після** втручання зарядної станції.

| Файли | Модель | Серійний DS2433 | Слова власника |
|---|---|---|---|
| `01_*` | PMNN4409A | `A394B916010050AF` | *(без скарги; знято для порівняння)* |
| `02_*` | PMNN4409A | `A37B481701005046` | *(без скарги; паливомір ICA = 0)* |
| `03_*` | PMNN4409A | `A362CF160100509E` | «ИНДИКАЦИЯ ЗАРЯДА РАБОТАЕТ» — а прошивка каже «РИЗИК (хибний заголовок)» |
| `04a_*` | PMNN4544A | `A30669DA020050E1` | «Радиостанцией определяется как полностью исправный… остаток емкости 97 процентов, первое использование 21 ноября 2022 г., срок службы 17 процентов» |
| `04b_*` | PMNN4544A | той самий | «После вставил этот аккумулятор в зарядку, она сразу что-то прописала и радиостанция сразу перестала писать приветствие аккумулятора impres, а в свойствах аккумулятора пишет требуется восстановить» |
| `05_*` | PMNN4409A | `A3161517010050B6` | «Радиостанция пишет неизвестный аккумулятор и не показывает уровень заряда» |
| `06_*` | PMNN4544A | `A364AEDA0200503F` | «индикация есть но пишет восстановить аккумулятор» |
| `07a_*` | PMNN4493A | `A3B52D0C02005041` | «Приветствие impres (tm), свойства аккумулятора в радиостанции остаток емкости 80 процентов, первое использование 23 ноября 2018 г., срок службы 91 процент» |
| `07b_*` | PMNN4493A | той самий | «После того как вставил и вынул с зарядки приветствие на радиостанции пропало, индикация заряда есть, в свойствах аккумулятора пишет восстановить аккумулятор» |
| `08_*` | PMNN4544A | `A320BE6F020050FA` | «Приветствия нет, индикация есть, в свойствах пишет восстановить аккумулятор» |
| `09_*` | PMNN4409B | `A3711DD7010050F7` | «Приветствия нет, индикация есть, в свойствах пишет восстановить аккумулятор» |

## Що ця партія знайшла в САМІЙ ПРОШИВЦІ

Пакети приїхали як скарга на рацію, а виявили пʼять місць, де брехали **ми**.
Кожне виправлення тепер має свою перевірку в тестах.

### 1. «Циклів не-IMPRES: 0» там, де їх 11 і 58

У `08` і `09` побитий блок `NONSMART` (запис `0x153`, Σ≠0x5A). Лічильник циклів
IMPRES у такому разі чесно віддавав `−1` («невідомо»), а сусідній лічильник
не-IMPRES тихо лишався **нулем** — тобто «блок не читається» виглядало як
«жодного разу не заряджали простою ЗП». Нуль там законний (у корпусі таких
дампів шість), тому й сплутати легко.

Наслідок був не лише косметичний: цей нуль ішов у суму «циклів пакета», з якої
рахується рядок CCA/DCA **плану синхронізації дзеркала** — тобто число, яке
пропонують записати в монітор.

### 2. Неможлива дата виготовлення як факт

У `07a`/`07b` блок `DATE` не розшифровується ключем із ROM: виходить
**«2072-14-22»** — місяць 14, день 22. Прошивка друкувала це значенням.
Перебір показує, що жоден із варіантів не дає дати, яку називає рація
(«23 ноября 2018»), тож блок справді побитий, а не ключ не той.

### 3. «Пакет ще не вмикався» — про пакет із 759 циклами

Друга половина тієї ж біди: дата першого користування рахується **від** дати
виготовлення. Побита дата → дати першого користування немає → клієнт писав
«— (пакет ще не вмикався)». Це інше твердження, і хибне.

### 4. «Розряджено 11465 циклів» при 191 циклі заряду

У `08` регістр `DCA` монітора містить `0x8268` = 33384 при `CCA` = 559. Тобто
«з пакета взято у 60 разів більше, ніж залито» — 26 мільйонів мА·год. Показували
як факт; жодна перевірка не заперечувала. Історія в самому DS2433 при цьому
ціла й правдоподібна (`CCA 440 / DCA 388`), тобто побитий саме монітор.

### 5. Справний пакет із втраченою сумою заголовка — «станція почала добудову»

`03` — робочий пакет (індикація заряду працює, модель, профіль і блоки цілі),
у якого зіпсовано два байти: сума заголовка `0x1F` і байт `0x20`. Майстер
ставив діагноз **ISS_CHARGER_PARTIAL** («станція дописала дзеркало й спинилась»)
і пропонував добудувати те, що давно побудоване.

Причина — неповна умова: перевірялось «сума хибна + дзеркало сходиться», а в
**справного** пакета дзеркало сходиться завжди, на те воно й дзеркало.
Справжня добудова (`19-stantsiya-dobudova`) відрізняється різко: там після
`0x020` рівно **0** непорожніх байтів, тут — **269**.

Заразом виявилось, що правило існувало у **двох копіях** — у `recovery.h` і
дослівно переписане в `tools/hdrfix_check.cpp`; копія пережила виправлення
оригіналу й лишила тест зеленим. Тепер правило одне (`impresChargerPartial()`
в `impres_format.h`), а обидва місця його кличуть.

### 6. `decode_dump.py` кричав «≠5A» на кожному справному пакеті

У хвості кожного дампа є 3-байтовий запис прапорців зарядної станції
(`03 04 80`, `03 10 20`, …) — контрольної суми він **не має**. Прошивка це знає
у трьох місцях (аудит, перерахунок сум, ремонт цілісності — усі пропускають
записи, коротші за 4 байти), а розбирач дампів — не знав і позначав такий запис
як побитий. У всіх 11 дампах цієї партії, зокрема в тих, які рація приймає без
зауважень.

## Чого ця партія НЕ пояснила

**Чому рація каже «невідомий акумулятор» на `05`.** Наш аудит на ньому не
знаходить нічого: заголовок, дзеркало, профіль, усі блоки BMS, ланцюг записів —
цілі, ключ сходиться з ROM, числа узгоджені. Помітна лише одна відмінність від
решти 4409A: у журналі використання (`0x0C0..0x11F`) у нього **три** записи
замість одного — усі з правильними сумами. Чи в цьому річ, з наявних даних
сказати не можна, тому нічого й не стверджуємо: дамп збережено, щоб було на
чому перевіряти гіпотези.

**Що саме зарядна станція зробила з `04` і `07`.** Побайтова різниця «до/після»
є (`python tools/decode_dump.py … --diff …`) і показує, що станція дописала
новий запис у журнал використання й оновила навчений хвіст — тобто зробила те,
що робить завжди. Чому після цього рація перестала вітатися — з дампів не
випливає.
