roman885-85/moto_battery_reader/docs/RELEASE-v0.5.md

# v0.5 — рідер і керований розряд (без зарядної частини)

> **Тег:** `v0.5` · **Коміт:** `bbec299` · **Дата:** 2026-08-07
>
> Це текст для сторінки релізу на GitHub. Створити реліз: *Releases → Draft a
> new release → Choose a tag → створити `v0.5` → Target: `bbec299`* — і вставити
> все, що нижче риски.

---

## Рання версія: рідер і керований розряд, ще без зарядної частини

Знімок проєкту **до появи заряду** — останній коміт перед «Керований заряд
через саморобний DC/DC». Силової частини заряду тут немає взагалі: ні плати
TL494, ні власного понижувача, ні жодного піна `CHARGE_*`. Пристрій читає й
лагодить пам'ять IMPRES-акумуляторів і вміє **керований розряд** через MOSFET
на GPIO19.

Викладено як точку відліку: усе, що з'явилось пізніше (заряд, чорний ящик,
редактор значень, знімок і побайтова різниця, комбінації кнопок), нарощувалось
поверх цієї основи.

### Що вміє

**Робота з пам'яттю акумулятора**

* зчитування обох чипів (DS2433 + DS2438), резервні копії `.bin`, запис;
* **Новий акумулятор** — ініціалізація порожнього чипа з вшитого еталона
  моделі плюс ручна ємність у мА·год;
* **Відновити еталон (verbatim)** — запис еталона байт-у-байт із усією
  навченою калібровкою, нічого не обнуляючи;
* **Майстер відновлення** — аналіз стану → перелік проблем → пропозиції →
  покрокове виконання. Багатоетапні сценарії з IMPRES-зарядною станцією
  переживають від'єднання: стан лежить у журналі ESP32 за серійником і
  продовжується після повернення АКБ (Майстер порівнює знімок
  CCA/DCA/ICA/health «до/після»);
* ремонт цілісності (контрольні суми + дзеркало калібрування), очистка,
  скидання лічильників, повне стирання DS2433, ручний запис моделі;
* редактор байтів із лінійкою адрес і ASCII-колонкою, зміна ємності та зносу.

**Розряд**

* керований розряд навантаженням через MOSFET (`LOAD_PIN` 19) з обмеженням
  струму ШІМом і уставкою за напругою;
* струм і температура — з вбудованого давача DS2438, опитування раз на 5 с;
* аварійні межі: нижня напруга, перегрів, стеля часу, втрата зв'язку з
  монітором. Розряд «наосліп» заборонено.

**Інтерфейси**

* дисплей із меню на кнопках — 6 монохромних панелей і кольорові TFT ST7789
  будь-якої роздільності, з кольоровим меню й заставкою;
* веб-інтерфейс через Wi-Fi AP із captive-portal;
* USB-клієнт у трьох варіантах: браузер (Web Serial), нативний `.exe` на
  Tkinter і веб-міст;
* світлодіоди, буззер і підсвітка кнопок — усе необов'язкове.

**Дослідження формату**

* задокументований реверс формату IMPRES: контрольні суми, дзеркало
  DS2438↔DS2433, прив'язка до моделі, а не до серійника;
* архів **49 реальних дампів** з описом стану словами власника — на них
  побудовані шаблони й правила Майстра.

### Чого тут ще немає

Заряду в будь-якому вигляді, розумного профілю CC/CV, примусового пробудження
заблокованого пакета, ручного редактора всіх значень одним списком, знімка
«до станції» з побайтовою різницею, чорного ящика й комбінацій кнопок.

### Збірка

Arduino IDE, плата ESP32. Піни й дисплей — у `settings.h`; розряд вимикається
коментуванням `LOAD_PIN`. Докладно — у `README.md` і `INSTRUCTION.md`.
