roman885-85/moto_battery_reader/docs/RELEASE-v1.0.md

# v1.0 — два пристрої, один код

> **Тег:** `v1.0` · **Коміт:** гілка `main` на момент випуску
>
> Це текст для сторінки релізу на GitHub. Створити реліз: *Releases → Draft a
> new release → Choose a tag → створити `v1.0` → Target: `main`* — і вставити
> все, що нижче риски.

---

## Перша повна версія: читає, лагодить, розряджає й заряджає

Від [v0.5](../docs/RELEASE-v0.5.md) проєкт виріс у закінчений прилад:
з'явився **керований заряд** — причому одразу для двох різних силових частин, —
а робота з пам'яттю IMPRES дійшла до того, що прилад бачить і виправляє речі,
про які немає документації.

Один код обслуговує **два пристрої**. Вибір — одна константа `DEVICE_VARIANT`
у найпершому блоці `settings.h`:

| `DEVICE_VARIANT` | Силова частина заряду | Екран | Профіль струму |
|---|---|---|---|
| `DEVICE_TL494` *(типово)* | готова плата DC/DC на TL494 | ST7789 1.69" 240×280, скруглений | 500/1000/1500 мА |
| `DEVICE_BUCK` | понижувач на власному ключі | ST7789 1.3" 240×240, квадратний | 400/700/1000 мА |

---

## Заряд

**Дві силові частини, один регулятор.** Верхній рівень (профілі, фази, аварійні
відсічки, оцінка часу) написаний у термінах «шпаруватості». Для власного
понижувача це відліки ШІМ; для плати TL494 один «відлік» — це **один мілівольт
цільової вихідної напруги**, а переклад «мВ → напруга керування» робить
калібрувальна таблиця в найнижчій точці. Крива керування TL494 різко нелінійна,
тож крок регулятора в «сирих» одиницях мав би зовсім різний ефект на різних
ділянках; у міліволтах виходу він означає одне й те саме скрізь.

**Два профілі.** Заводський — струм за відсотком заряду з плавним спадом перед
самою ціллю; **розумний CC/CV** — струми в частках ємності самого пакета
(0.5C / 0.1C / 0.05C), фази передзаряду, CC і CV, завершення **за струмом**, а
не за дотиком до напруги. Ціль вибирається у відсотках або мілівольтах, профіль
масштабується під неї.

**Аварійні відсічки.** Напруга вище межі, перегрів 45 °C, стеля часу 6 год,
зависання головного циклу, втрата зв'язку з монітором, «вихід у стелі, а струму
немає». Там, де є власні давачі, додаються пік струму, контроль живлення
12.5…16 В і свідок насичення клеми — той відрізняє **чотири** різні події, які
зовні виглядають однаково: пакет закрився сам на своїй межі (це завершення, а
не аварія), справжня перенапруга, розмикання не за напругою та зникнення
пакета з кола.

**Примусове пробудження** заблокованого пакета — обмеженим за енергією і часом
імпульсом, коли контролер захисту тримає клеми розімкненими й пакет не
читається взагалі. Доступне лише там, де є власні виміри: на платі TL494 режим
**заборонено**, і прошивка каже це прямим текстом, а не мовчить.

**Заряду може не бути.** На екземплярах без силової частини він вимикається на
самому приладі — утриманням «OK» п'ять секунд. Разом із ним зникають група
ЗАРЯД у меню й контроль живлення: там, де міряти нічого, прилад не вигадує
показань. Стан переживає перезавантаження.

## Розряд

Керований розряд навантаженням (MOSFET + резистор) з обмеженням струму ШІМом:
приймальний контроль після перепайки рахує **реальну** ємність нових банок, а
заразом підштовхує зарядну станцію в цикл калібрування, коли вона вперлась.

## Пам'ять IMPRES

* **Майстер відновлення** — аналіз → проблеми → пропозиції → покрокове
  виконання. Кожна знайдена проблема або має крок, або **вголос каже, чому
  кроку не буде**. Багатоетапні сценарії із зарядною станцією переживають
  від'єднання: стан лежить у журналі ESP32 за серійником АКБ.
* **Ручний редактор значень** — усі 16 величин пакета (дати, лічильники,
  наробіток, ємність, знос, рівень заряду) одним списком, з автовиправленням
  введеного й показом, що саме буде записано.
* **Знімок «до станції» й побайтова різниця** — зняти образ обох чипів, віддати
  пакет на зарядну станцію, повернути й побачити рівно ті байти, які вона
  змінила, з підписами полів. Невідомі байти лишаються **без назви**, а не
  дістають вигадану.
* **Скидання наробітку обнуляє чотири місця, а не одне.** Пакет тримає його в
  ETM монітора, у двох мітках подій у секундах, у лічильниках CCA/DCA всередині
  DS2433 і — знайдено на корпусі дампів — у **третій мітці, у добах**. Станція
  «лікує» неможливий стан «подія пізніша за наробіток», підтягуючи наробіток
  до мітки, тож скидання «тільки монітора» першою ж зарядкою відкочувалось.
* Ініціалізація порожнього чипа з еталона моделі, відновлення еталона
  байт-у-байт, ремонт цілісності, очистка, повне стирання, ручний запис
  моделі, редактор байтів із лінійкою адрес і ASCII-колонкою.

## Інтерфейси

Дисплей із меню-списком (групи, стрибок по групах), веб-інтерфейс через Wi-Fi
AP із captive-portal і USB-клієнт у трьох варіантах — браузер (Web Serial),
нативний `.exe` на Tkinter і веб-міст. Усі поверхні працюють **паралельно** й
беруть тексти, межі й описи заліза з **пристрою**, а не тримають власних копій.

**Чорний ящик** (`postmortem.h`) переживає скидання й перетворює «періодично
перезавантажується» на конкретні обставини: режим, крок, номер опитування,
шпаруватість, струм, напруга та причина скидання.

## Як це перевіряється

**20 хостових тестів** збираються звичайним `g++` і ганяються без ESP32 —
на справжніх заголовках прошивки, а не на копіях логіки. Прогін іде **матрицею
з трьох конфігурацій** (`DEVICE_VARIANT` × `CHARGE_SWITCH_TYPE`): зелений
результат в одній нічого не доводить про другу.

Окремо стоїть `tools/topology_check.py`. `web_server.h`, драйвери екрана й сам
скетч на хості **не збираються взагалі**, тож звертання до макроса, якого за
обраної топології не існує, було б видно лише в Arduino IDE. Препроцесувати їх
при цьому можна завжди — на цьому перевірка й побудована.

Головний метод — **звірка «від протилежного»**: кожну перевірку навмисно
ламають і дивляться, чи вона впаде. Перевірка, яку неможливо повалити, нічого
не стереже — і саме так у цьому проєкті знаходились «працюючі» перевірки, що
роками мовчали.

**131 реальний дамп** у 20 каталогах з описом стану словами власника — на них
побудовані шаблони, правила Майстра й доведення про четверте місце наробітку.

---

## Збірка

Arduino IDE, плата ESP32. Вибір пристрою — `DEVICE_VARIANT` у `settings.h`
(найперший блок файлу). Піни, дисплей і силова частина — там же; заряд і розряд
обидва необов'язкові й вимикаються коментуванням пінів. Схема одним аркушем —
`SCHEMATIC.html`, покрокова інструкція — `INSTRUCTION.md`, повна історія змін
із розборами дефектів — `CHANGES.md`.

## Застереження

Прилад пише в пам'ять акумуляторів і керує силовою частиною під напругою.
Перед першим зарядом перевірте мультиметром, що при нульовій уставці на клемі
~0 В. Робіть резервні копії `.bin` **до** будь-якого запису.
