roman885-85/moto_battery_reader/CHANGES.md

# Motorola IMPRES Battery Reader — журнал змін

Один і той самий код обслуговує **два пристрої**. Різниця між ними — зарядне
залізо й екран, і задає її **одна константа** `DEVICE_VARIANT` у найпершому
блоці `settings.h`:

| `DEVICE_VARIANT` | Силова частина заряду | Екран | Профіль струму |
|---|---|---|---|
| `DEVICE_TL494` *(типово)* | готова плата DC/DC на TL494 | ST7789 1.69" 240×280, скруглений | 500/1000/1500 мА |
| `DEVICE_BUCK` | понижувач на власному ключі | ST7789 1.3" 240×240, квадратний | 400/700/1000 мА |

Тека одна — коренева. Прошивка, веб-інтерфейс (`index.html`), USB-клієнт
(`client_usb.html`, `usb_client/`), файли SPIFFS (`data/`), архів дампів
(`dumps/`) і хостові тести (`tools/`) спільні для обох пристроїв.

> Історично це були ДВІ теки з майже однаковим вмістом: у корені — попередній
> пристрій, у `battery_reader_china_chr/` — новіший, і робота йшла тільки в
> копії. Спершу попередній пристрій адаптували під усі нові можливості
> (розділ 3.55), а потім теки звели в одну: різниця виявилась у чотирьох
> рядках, і тримати заради них 265 продубльованих файлів означало носити
> кожну правку руками (розділ 3.57).

```bash
mkdir -p build                       # запускати З КОРЕНЯ ЦІЄЇ ТЕКИ:
for f in tools/*_check.cpp; do       # тести читають dumps/ за відносним шляхом
  n=$(basename "$f" _check.cpp)
  g++ -std=c++17 -I. -Itools/fake -o "build/$n" "$f" && "./build/$n" || echo "ЗБІЙ: $n"
done
```

**Усі 20 тестів проходять** — у КОЖНІЙ конфігурації: обидві топології заряду
(`CHARGE_TOPOLOGY`) і обидва силові ключі понижувача (`CHARGE_SWITCH_TYPE`).
Матриця прогону й окрема перевірка `tools/topology_check.py` — у
[`tools/README.md`](tools/README.md).

---

# Частина 1. ПОТОЧНИЙ СТАН ЗАЛІЗА

Це те, під що налаштована прошивка **зараз**. Історія змін — у частині 3;
якщо вам потрібно зібрати й запустити пристрій, читайте тільки цю частину.

## Розподіл пінів

| Сигнал | GPIO | Константа |
|---|---|---|
| 1-Wire дані | 13 | `DS_PIN` |
| Підтяжка 1-Wire + enable пакета | 12 | `PULLUP_PIN` |
| LED зелений / червоний | 14 / 27 | `LED_GREEN_PIN` / `LED_RED_PIN` |
| Три кнопки на аналоговій драбинці | 33 | `MENU_BTN_ADC_PIN` (лише ADC1) |
| Підсвітка кнопок | 15 | `BTN_LED_PIN` |
| Дисплей ST7789, SPI | 18/23/5/17/16/4 | SCK/MOSI/CS/DC/RST/BLK — виводу CS на модулі немає, але пін заданий (див. нижче). Режим SPI 3, 24 МГц. Панель: **240×280 скруглена** (`DEVICE_TL494`) або **240×240 квадратна** (`DEVICE_BUCK`) |
| Затвор MOSFET **розряду** | 19 | `LOAD_PIN` |
| Звук | 25 | `BUZZER_DAC_PIN` — **увімкнено**, DAC1 → розділовий конденсатор 1–10 мкФ → п'єзо |

**Заряд — залежно від `CHARGE_TOPOLOGY`.** Рядки з різних варіантів не
поєднуються: піни одного заліза в іншому не існують, і прошивка не дасть себе
зібрати, якщо їх переплутати.

| `CHARGE_TOP_BUCK` — власний понижувач | GPIO | Константа |
|---|---|---|
| ШІМ заряду → керуючий NPN → силовий ключ | 26 | `CHARGE_PWM_PIN` (тип ключа — `CHARGE_SWITCH_TYPE`) |
| Вимір струму заряду | 35 | `CHARGE_ISENSE_PIN` — шунт → 1 кОм → пін (лише ADC1) |
| Вимір напруги заряду | 34 | `CHARGE_VSENSE_PIN` — подільник 20к/10к → 1 кОм → пін (лише ADC1) |
| Контроль живлення +14 В | 39 | `CHARGE_PSU_PIN` — подільник 68к/10к → 1 кОм → пін (лише ADC1) |

| `CHARGE_TOP_TL494` — готова плата DC/DC | GPIO | Константа |
|---|---|---|
| Enable силового каскаду | 32 | `CHARGE_TL_EN_PIN` — **LOW = безпечно**; єдиний запобіжник, бо плата пропускає ~14 В без керування |
| Аналогове керування напругою | 26 | `CHARGE_TL_CTRL_PIN` — ШІМ 20 кГц / 11 біт → RC на платі |

Вимірювальних пінів у другого варіанта немає жодного: струм, напругу й
температуру дає DS2438 усередині пакета.

> ⚠️ Резистор **1 кОм послідовно** перед КОЖНИМ вимірювальним піном (і струму, і напруги) — струмообмеження входу АЦП. На показання він **не впливає**: вхід АЦП високоомний, струму через резистор немає, отже немає й падіння на ньому. У жодну формулу перерахунку він тому й не входить — не «виправляйте» це.

34, 35 і 39 обрані не випадково: **вхід-тільки** (вимірювальну лінію фізично
неможливо продавити назовні) і **ADC1** — ADC2 не читається при увімкненому
Wi-Fi, а точка доступу тут піднята завжди.

Що лишилось вільного з ADC1: **GPIO36/VP** (вхід-тільки) — а от **GPIO32**
зайнятий умовно (див. нижче про спадковий enable) і
**GPIO36/VP** (теж вхід-тільки). GPIO37/38 на більшості модулів WROOM не
виведені на гребінку — на них розраховувати не можна. Для контролю живлення
взято 39, а не 32, саме тому, що 39 годиться **виключно** як аналоговий вхід:
витрачати на вимір єдиний універсальний пін, що лишився, нема сенсу.
GPIO25 (звільнений від звуку) у резерві.

**GPIO32 — спадковий enable старої схеми заряду, і його знову утримують.**
До переробки на ньому сидів `CHARGE_PIN` — enable силового каскаду готової
TL494-плати, і скетч найпершим рядком `setup()` опускав його в LOW. Переробка
пін прибрала — і разом із ним прибрала й те, що його хтось узагалі налаштовує:
він лишився висіти ВХОДОМ, тоді як на платі до нього цілком може бути
припаяний той самий ланцюг. Невизначений рівень на вході чужої схеми — це
рівно той клас несправності, що з'являється «після переробки» й виглядає як
щось стороннє. Тепер він знову опускається в LOW при старті
(`CHARGE_LEGACY_EN_PIN`): нічого не припаяно — дія безкоштовна, припаяно —
відновлено дореформений стан. Закоментувати, коли доріжку буде зрізано.

**GPIO5 міг би звільнитись, але лишається за дисплеєм.** Панель тут — GMT130
240x240: на гребінку виходять лише `GND/VCC/SCL/SDA/RES/DC/BLK`, виводу CS
немає фізично, і GPIO5 нікуди не підключений. Підтримку режиму «CS немає»
зроблено (`-1` в Adafruit, `U8X8_PIN_NONE` в U8g2 — див. `ST7789_CS_ARG`), але
ТИПОВО пін усе одно заданий: смикати непід'єднаний пін електрично безкоштовно,
а `-1` спирається на внутрішню гілку бібліотеки, реалізовану в різних версіях
`Adafruit_SPITFT` по-різному (де через `csPinMask=0`, де через
`digitalWrite(-1)`). Заданий реальний пін працює на будь-якій версії й на
будь-якому модулі — з виводом CS і без.
Закоментувати рядок можна, якщо GPIO5 знадобиться під щось інше; тоді єдина
умова — шина SPI має бути тільки під дисплеєм: без CS панель слухає її
постійно, і будь-який чужий трафік на SCK/MOSI піде їй як команди.
Заразом вимкнено `DISPLAY_ST7789_ROUND`: GMT130 квадратний, із гострими
кутами, і заокруглення з'їдало б по 22 px з кожного боку ні за що.

**Лінія enable/підтяжки (GPIO12) тепер перевіряється прошивкою.** На ESP32
вхідний буфер вихідного піна лишається увімкненим (`OUTPUT` там визначено як
`0x03`, тобто разом із бітом `INPUT`), тож `digitalRead()` на ньому дає
РЕАЛЬНИЙ стан виводу, а не те, що ми записали. Це й дозволяє відрізнити
несправну обв'язку від відсутнього пакета — раніше обидва випадки виглядали як
«нема чіпа», тобто прошивка звинувачувала пакет, не перевіривши себе.
**Між GPIO12 та +3.3 В стоїть резистор 4.7 кОм — але він НЕ обов'язковий.**
Власник поставив його для попереднього налагодження функцій; прошивка веде цю
лінію активно в обидва боки, тож підтяжка тут не умова роботи.
⚠️ Не плутати з підтяжкою **лінії даних** (GPIO13) — ОТА обов'язкова: чипи
DS2433/DS2438 живляться з неї паразитно, і внутрішніх ~45 кОм їм не вистачає.

Окремо варто знати, чому підтяжка вгору на цьому піні взагалі можлива: GPIO12 — strapping-пін MTDI,
рівнем на ньому при скиданні ESP32 вибирає напругу флеш-пам'яті (HIGH = 1.8 В),
і зазвичай зовнішню підтяжку вгору на ньому називають забороненою. Тут вона
працює, бо на цьому модулі напруга флеш зафіксована в eFuse
(`espefuse.py set_flash_voltage 3.3V`) або флеш справді 1.8-вольтова —
інакше пристрій не завантажувався б із уже припаяним резистором.
Раніше в цьому файлі стояло «підтяжки вгору бути не може взагалі» — це було
переписано з даташита, а не знято з ЦІЄЇ плати.

**Чорний екран був не через CS, а через РЕЖИМ SPI** — підтверджено на пристрої.
`tft.init()` кликався без режиму й частоти, тобто мовчки брав зашитий у
бібліотеку режим 0; панелі без виводу CS вимагають режим 3. Повчальна частина:
поки параметра немає в налаштуваннях, його «немає» і в голові — причину шукали
в проводці, у номіналі CS, у пресеті панелі, тобто скрізь, крім того місця, де
вона була. Тепер обидва числа задаються явно й друкуються в журналі при старті:
`SPI mode=3 24.0 МГц`.

## Силова частина заряду: понижувач (buck), ключ на вибір

**Верхній ключ можна зібрати на двох різних приладах**, і обв'язка в них
СПІЛЬНА. Вибір — однією константою в `settings.h`:

```c
#define CHARGE_SWITCH_TYPE CHARGE_SW_PMOS      // P-канальний MOSFET (NTD2955G) — ЗАРАЗ
// #define CHARGE_SWITCH_TYPE CHARGE_SW_BJT_PNP  // біполярний PNP (B772M)
```

Це не косметика. Прилади керуються **різними величинами**, і майже кожна
перевірка силової частини розгалужується за цією константою:

| | біполярний PNP (B772M) | P-MOSFET (NTD2955G) |
|---|---|---|
| керується | **струмом** бази | **напругою** на затворі |
| що задає `R_drive` | струм бази `Iб = (U−Uбе−Uке)/R` | верхнє плече **дільника**, який задає `Uзатв` |
| провідні втрати | `Uке_нас × I × D` — ростуть **лінійно** | `I² × RDS(on) × D` — ростуть **квадратично** |
| час перемикання | розсмоктування заряду бази, ~3000 нс | перезаряд `Qg` **нашим** драйвером, ~2100 нс |
| витрати драйвера | **1505 мВт** постійно | **172 мВт** (наскрізний струм дільника) |
| розсіювання на ключі | 819 мВт при `Pc` 1250 мВт — **тісно** | 473 мВт при `Pd` 55 000 мВт — **із запасом** |

```
   +Uживл (~14 В) ─┬────[ R_підт 1к ]───────┬─── E (витік)   PNP B772M
                   │                        │                або P-MOSFET
                   └────────────────────────┴─── B (затвор) ─┐   NTD2955G
                                                             │
   CHARGE_PWM_PIN ──[ 390 ]── B  NPN                         │
                              C ──[ R_drive 120 Ом ]─────────┘
                              E ── GND
                 B ──[ R_вниз 10к ]── GND       <-- ОБОВ'ЯЗКОВО

                              C ─┬───[ L 104 мкГн ]───> +клема АКБ
                                 │
                           (катод) VD  діод Шотткі
                                 │
                                GND

   −клема ──┬──[ R_шунт 0.5 Ом / 2 Вт ]── GND
            └──[ 1 кОм ]── CHARGE_ISENSE_PIN

   +клема ──[ 20к ]──┬──[ 1 кОм ]── CHARGE_VSENSE_PIN
                [ 10к ]
                     └── GND

   +Uживл ──[ 68к ]──┬──[ 1 кОм ]── CHARGE_PSU_PIN
                [ 10к ]
                     └── GND
```

Логіка **не інвертована**: два інвертування (NPN + PNP) взаємно скасовуються,
тож шпаруватість на піні = шпаруватість ключа, **0 % = безпечно**.

## ⚠️ Що обов'язково перевірити перед першим запуском

| Елемент | Вимога | Чому |
|---|---|---|
| `R_вниз` з бази NPN на землю | **10 кОм, обов'язково** | під час скидання ESP32 піни у високоімпедансному стані; програмно це не перекрити |
| `R_драйв` пін→база NPN | **390 Ом** 🔴 на платі **20 кОм** | 0.13 мА замість потрібних 0.7 — NPN не насититься. **Обов'язково для ОБОХ типів ключа** |
| `R_drive` колектор NPN→база/затвор | **120 Ом, 2 Вт** 🔴 на платі **1 кОм** | PNP: струм бази лише 12 мА → заряд ~22 мА, тобто 4 доби. **MOSFET: 1 кОм дає \|VGS\| 6.9 В — ключ уже відкривається**, але не до паспортної точки RDS(on) |
| NPN | **2N2222 / BC337 / S8050** | PNP: має пропускати 106 мА (при 16 В — 123 мА). MOSFET: лише 12.3 мА наскрізного струму дільника. BC547 годиться **тільки** з польовим ключем |
| `R_підт` затвор/база → +Uживл | **1 кОм** (як є) | PNP: запираюча підтяжка, відбирає 0.9 мА зі 106. **MOSFET: нижнє плече дільника — саме вона задає \|VGS\| і час запирання**, міняти не можна не перерахувавши |
| Подільник напруги пакета | **20к / 10к** (як є) | 8.25 В → 2.75 В на АЦП; міняти не треба |
| Подільник живлення | **68к / 10к** + 1 кОм — **новий** | 14 В → 1.79 В; діапазон до 20 В, щоб помилковий блок 19 В читався числом |
| Шунт | 0.5 Ом, **від 2 Вт** | при 1.5 А розсіює 1.1 Вт |
| Радіатор | PNP: **потрібен** (0.82 Вт при Pc 1.25 Вт) · MOSFET: **не потрібен** (0.47 Вт при Pd 55 Вт) | паспорт дано для корпусу при 25 °C |
| Блок живлення | **12.5…16 В** | PNP: нижче — струму бази не вистачить на насичення. MOSFET: нижче — просідає \|VGS\|, вище — наближається межа затвора (14.1 В при дозволених 20) |

### 🔴 Заміни, які треба зробити ДО першого заряду

**Із біполярним PNP їх дві, і поодинці жодна не працює**: замінити тільки
`R_drive` означає попросити в NPN 106 мА, яких він при 20 кОм у базі віддати
не може, і ключ однаково лишиться поза насиченням. Наслідок в обох випадках
однаковий — B772M у **лінійному режимі** під 14 В, тобто згорілий ключ за
секунди.

**Із польовим ключем обов'язкова лишається одна — 20 кОм → 390 Ом.** І це не
послаблення вимоги, а зміна її причини: керуючий NPN мусить пропустити
наскрізний струм дільника затвора (12.3 мА на номіналі, 14.1 мА при 16 В), а
при 20 кОм у базі він дає щонайбільше 2.6 мА. Затвор просто не притягується.

А ось `R_drive` 1 кОм → 120 Ом із польовим ключем **бажана, але не
смертельна**. Дільник 1 к/1 к дає |VGS| = 6.9 В при порозі 4 В — ключ
відкривається. Просто не до 10 В, при яких паспорт нормує RDS(on) 0.18 Ом,
тож опір каналу (а з ним і нагрів) буде вищий за розрахунковий. Прошивка це
знає й друкує обома числами при старті.

Чому саме 120 і 390, а не 150 і 470, як було в попередній редакції: рахувати
треба **на межі допуску живлення**, а не на номінальні 14 В. Для силового
ключа найгірша межа **нижня** (при 12.5 В струм бази падає до 75 мА при
потрібних 82), для керуючого NPN — **верхня** (при 16 В струм драйвера росте
до 124 мА, і 470 Ом уже не дають потрібних 6.2 мА в базу). Обидві помилки
знайшли не на столі, а `#error`-перевірки, щойно з'явився контроль живлення.

Номінали, що стоять на платі, записані в `settings.h` окремо
(`CHARGE_BASE_DRIVE_ASBUILT_OHM`, `CHARGE_NPN_BASE_ASBUILT_OHM`), тому
прошивка **збереться** й із ними — але при старті надрукує попередження з
числами, а заряд зупинить сама відсічкою «ключ не тягне» приблизно за
5 секунд. Це запобіжник, а не дозвіл працювати без заміни.

Прошивка **не збереться**, якщо подільники, струм бази на ОБОХ межах допуску
живлення, розсіювання ключа, пікові струми чи частота ШІМ виходять за межі:
`#error`-перевірки в `settings.h` рахують усе за вашими номіналами й
підказують, що саме поправити. Кожну з них перевірено на свідомо зламаній
конфігурації — тобто доведено, що вона справді спрацьовує, а не просто
написана.

## Робоча точка

| Величина | Значення |
|---|---|
| Частота ШІМ / роздільність | 25 кГц / 11 біт (2048 кроків) |
| Розмах пульсацій дроселя ΔI | ~1303 мА |
| Межа неперервного режиму (ΔI/2) | 651 мА |
| Крейсерський струм (`CHARGE_MA_80`) | 1000 мА |
| Піковий струм (крейсер + ΔI/2) | 1651 мА |

**Далі — те, що залежить від типу ключа:**

| Величина | PNP B772M | P-MOSFET NTD2955G |
|---|---|---|
| Паспортна межа струму | 3000 мА (`Ic`) | 12 000 мА (`Id`) |
| Керування | струм бази 106 мА (треба ≥ 82) | \|VGS\| 12 322 мВ (поріг 4000, паспорт RDS(on) при 10 000, межа 20 000) |
| \|VGS\| на краях допуску живлення | — | 10 983 мВ при 12.5 В … 14 108 мВ при 16 В |
| Час перемикання | 3000 нс (розсмоктування бази) | 2098 нс = 260 вмик + 1838 вимик (**5 % періоду**) |
| Провідні втрати | 294 мВт (`Uке_нас × I × D`) | 106 мВт (`I²R`) |
| Перемикальні втрати | 525 мВт | 367 мВт |
| **Разом на ключі** | **819 мВт** при `Pc` 1250 | **473 мВт** при `Pd` 55 000 |
| Втрати драйвера | 1505 мВт | 172 мВт |

Ці ж числа пристрій друкує в `Serial` при старті — рядки `CHARGE: buck L=…`,
`CHARGE: ключ P-MOSFET, RDS(on)…` і `CHARGE: перемикання… розсіювання…`.
Помітка «ПОТРІБЕН РАДІАТОР» з'являється, лише коли розсіювання переходить
половину паспортної межі — з польовим ключем вона не з'являється.

⚠️ **Вимикання повільніше за вмикання, і це властивість схеми, а не дефект.**
Униз затвор тягнуть обидва плеча дільника (107 Ом), а вгору — лише підтяжка
(1 кОм). Тому саме `R_підт` задає перемикальні втрати, і зменшувати її можна
лише разом із перерахунком нагріву: через неї тече весь наскрізний струм.

## Профіль струму заряду

| заряд | струм |
|---|---|
| 0 % | 200 мА |
| 10 % | 400 мА |
| 50 % | 700 мА |
| 80 % | 1000 мА |
| 80–90 % | плато 1000 мА |
| **90–100 %** | **100 мА — дозаряд малим струмом** (`CHARGE_TAPER_PCT`) |

Кінець повного заряду — **8.2 В** (`CHARGE_TARGET_MV`), а не 8.25.

Точки перегину масштабуються під обрану ціль, тож заряд завжди закінчується
дозарядом малим струмом, хай яку ціль обрано.

⚠️ **Наприкінці успішного заряду паливомір покаже ~97 %, а не 100 %** — 8200 мВ
на шкалі 6350…8250 це саме 97 %. Це не недозаряд і не збій: зупинка нижче
верхньої межі шкали зроблена навмисно (див. 3.6).

---

# Частина 2. ЧОМУ ЦЕ ПРАЦЮЄ САМЕ ТАК

Три нетривіальні наслідки топології, які легко порушити при правках.

## Дросель робить залежність струму від шпаруватості нелінійною

`Uвих ≈ D × Uживл`. Точка `D = Uпакета/Uживл` (≈0.59) — це **межа режимів**, а
не «нульовий струм»: середній струм у ній дорівнює половині розмаху пульсацій,
тобто ~650 мА. Нижче межі перетворювач у **переривчастому** режимі (струм
росте як `D²`), вище — у неперервному (лінійно).

Тому старт іде з `chargeStartDuty(Uпакета, уставка)`, яка цілиться в потрібний
струм по відповідній гілці:

| уставка | режим | duty (з 2047) |
|---|---|---|
| 100 мА | переривчастий | 472 |
| 200 мА | переривчастий | 668 |
| 400 мА | переривчастий | 945 |
| 700 мА | неперервний | 1267 |
| 1000 мА | неперервний | 1293 |

Розгін «з нуля крок за кроком» тут коштував би хвилин.

## Біполярний ключ обмежує частоту зверху, а дросель — знизу

Це не «інша деталь у тій самій ролі», а інший принцип:

* **керується струмом бази**, і насичення мусить триматись на **вершині
  пульсацій**, інакше ключ виходить із насичення на кожному горбі;
* **вимикається повільно** — розсмоктування заряду бази це мікросекунди проти
  наносекунд у MOSFET, тож перемикальні втрати домінують і ростуть прямо з
  частотою;
* **гріється**: у насиченні лишається `Uке_нас ≈ 0.5 В`, а не мілівольти опору
  каналу.

Тепловий бюджет при 25 кГц (Pc = 1.25 Вт):

| Iк | провідні | перемикальні | разом | |
|---|---|---|---|---|
| 0.5 А | 0.15 Вт | 0.26 Вт | 0.41 Вт | ок |
| **1.0 А** | 0.29 Вт | 0.53 Вт | **0.82 Вт** | робоча точка |
| 1.5 А | 0.44 Вт | 0.79 Вт | 1.23 Вт | на межі Pc |

Звідси й `CHARGE_MA_80 = 1000`: **стелю профілю задає ключ, а не пакет.**

## Три виміри рознесені в часі, і кожен зі своєї причини

| Що | Коли | Чому саме так |
|---|---|---|
| Струм | не зупиняючи ключ | через шунт тече неперервний струм дроселя; серія зі 128 відліків усереднює пульсації й окремо дає їх вершину |
| Напруга | ключ закрито на 10 мс | під струмом до напруги пакета додається падіння на дротах і внутрішньому опорі |
| Температура (DS2438) | раз на 10 опитувань, ключ закрито | шунт у **мінусовому** проводі підіймає «мінус» пакета над землею ESP32 на `I×R` (при 1.5 А — 750 мВ), і по зсунутій землі 1-Wire не відповідає. Транзакція коштує сотні мілісекунд — читати щосекунди означало б віддавати п'яту частину часу заряду |

DS2438 потрібен лише для **температури** й як незалежна перехресна перевірка за
лічильником CCA. Струм і напругу пристрій міряє власними давачами.

---

# Частина 3. ЩО БУЛО ВИПРАВЛЕНО

## 3.1. Дефекти, знайдені аудитом вихідного коду

Опис проєкту в `README.md` описував задум, а не поведінку коду. Усі сім
розбіжностей перевірені на корпусі `dumps/` і хостовими тестами.

**1. Заряд ніколи не оновлював екран.** `charge.h` справно виставляв прапорець
`chargeMarkDirty()`, `drawPageCharge()` була намальована в обох драйверах
дисплея — але **`chargeConsumeDirty()` не викликався ніде в проєкті**: у
`loop()` стояв лише рядок для розряду. Сторінка заряду не з'являлась, а коли
з'являлась — цифри стояли мертві до натискання кнопки.
*→ `motorola-battery-reader-web.ino`: додано симетричний блок.*

**2. Зупинка однієї операції ламала іншу, що саме йшла.** `dischargeStop()` і
`chargeStop()` згорталися повністю незалежно від того, чи їхня операція йшла, а
зупинку кличуть ззовні беззастережно (кнопка, `/api/*/stop`, USB). Два ресурси
спільні, тож «холоста» зупинка розряду під час заряду знімала з апаратного
сторожа таск `loop()` і опускала `PULLUP_PIN` — заряд лишався **без захисту від
зависання** і **переставав давати струм, продовжуючи звітувати «іде»**.
*→ `discharge.h`, `charge.h`: ключ гаситься завжди, решта згортання — лише коли
своя операція справді йшла.*

**3. Незнятий підсумок розряду перекривав сторінку заряду.** «Екран активний» ≠
«операція йде»: підсумок висить, доки його не приберуть кнопкою, і ламав
інваріант «активний екран рівно один».
*→ `web_server.h`: старт кожної операції знімає підсумок протилежної.*

**4. Перевірка в `settings.h`, яка не могла спрацювати.**
```c
#if (DISCHARGE_RAMP_HI_MV <= DISCHARGE_RAMP_LO_MV)
```
`DISCHARGE_RAMP_LO_MV` **у проєкті не існує** — низ лінійки поїхав за обрану
ціль, а старий `#define` прибрали. Невідомий ідентифікатор у `#if` препроцесор
мовчки вважає нулем, тож умова читалась як `8250 <= 0`.
*→ перевіряється справжній інваріант плюс дві сусідні межі.*

**5. `impres_clone.h` і `impres_audit.h` не збиралися окремо** — брали
`DS2438_MEM_SIZE` і `DUMP_SIZE` із заголовків, яких не включають, попри
заявлену в шапці самодостатність.
*→ перейшли на власні `IMPRES_38_SIZE` / `IMPRES_33_SIZE`.*

**6. `impresCyclesWrite()` міг зіпсувати гістограму циклів.** Вимагалася
довжина блока `ADDED` 21 байт замість 22, і на такому блоці контрольна сума
лягала б на молодший байт останнього кошика. У всіх 44 дампах, де блок є,
довжина рівно 22.

**7. `wizSerialHex()` — запис на байт за межу буфера.** `sprintf` кладе дві
цифри плюс нуль-термінатор, а умова резервувала лише дві.

## 3.2. Переробка заряду

Заряд переписано **тричі**, бо схему уточнювали поетапно. Нижче — лише те, що
кожне уточнення реально змінило; підсумковий стан описано в частині 1.

| Етап | Що було | Що змінилось |
|---|---|---|
| Вихідний | Готова плата DC/DC на TL494: цифровий enable + аналогове керування через ШІМ+RC, керування за калібрувальною таблицею | — |
| «Просто ключ» | ШІМ на P-MOSFET через NPN, власні вимір струму й напруги замість DS2438 | Прибрано калібрувальну таблицю й окремий enable; DS2438 лишився тільки для температури |
| «Є діод і дросель» | Це понижувач (buck), а не ключ | Частота 1 кГц → 25 кГц (пульсації дроселя); стеля скважності 60 % → 85 % (`Uвих ≈ D×Uживл`); «пік» переосмислено як вершину пульсацій; старт із розрахованої точки замість нуля |
| «Ключ — PNP B772M» | Не MOSFET, а біполярник | Модель ключа замінено на струмову (`R_бази`, β_форс, `Uке_нас`, час розсмоктування); профіль знижено 1500 → 1000 мА під тепловий бюджет |
| «У базі NPN 20 кОм» | Драйверний каскад узагалі не тягне | Записано фактичні номінали плати окремо від розрахункових; додано рантайм-відсічку «ключ не тягне» |
| «Контроль живлення» | `Uживл` була константою-припущенням | Напруга живлення вимірюється (GPIO39); розрахунок іде на живому вимірі; перевірки насичення переїхали з номіналу на **обидві межі допуску**, через що `R_бази` 150 → 120 Ом і `R_драйв` 470 → 390 Ом |
| «Між enable і +3.3 В треба резистор 4.7 кОм» | у документації й на схемі його не було; на GPIO12 узагалі стояла заборона підтяжки вгору через strapping | Резистор нанесено на схему й у документацію. ⚠️ **Спершу я записав його як ОБОВ'ЯЗКОВИЙ — це виправлено:** власник уточнив, що резистор поставлений для попереднього налагодження і обов'язковим не є. Помилка була в тому, що я вивів «обов'язковість» із самого факту наявності. Заборону підтяжки скасовано з поясненням: GPIO12 справді MTDI, але плата з резистором стартує — отже eFuse напруги флеша пропалено або флеш 1.8 В |
| «Заряд не вмикається; у програмі пишеться про плату на TL494» | **два дефекти.** (1) `CHARGE_LEDC_CH` = 7 — це ПАРА до `LOAD_LEDC_CH` = 6, тобто ТОЙ САМИЙ таймер LEDC, а частоти різні (1 кГц/10 біт проти 25 кГц/11 біт). Розряд займає таймер першим, `ledcAttachChannel()` для заряду повертає false, і старт відхиляється. Правило про попарні таймери записане в цьому ж файлі — за кількасот рядків вище. (2) Усі чотири клієнти й далі описували стару схему на TL494 | Канал заряду 7 → 4 (таймер 2, вільний). Додано `#error` на спільний таймер із розрядом і з ШІМ-зумером; `BUZZER_LEDC_CH` перенесено в `settings.h`, інакше вартовий його не бачив. Тексти в усіх клієнтах переписано під понижувач на PNP B772M |
| «Лінії без підтяжок, використовують функціонал самого контролера (D12, D13)» | внутрішню підтяжку не вмикав ніхто: конструктор OneWire робить `pinMode(pin, INPUT)`, що на ESP32 її ЗНІМАЄ | `dsIdle()` вмикає її ЯВНО після конструктора. Заразом виправлено щойно доданий `busLineCheck()`: він ставив `pinMode(INPUT)` і тим самим сам вимикав підтяжку |
| «Підтяжка в оригіналі потрібна була точно» | я зробив із цього хибний висновок, ніби внутрішньої ДОСИТЬ, і так і записав у документацію | Виправлено: зовнішній резистор 2.2…4.7 кОм **обов'язковий**, бо DS2433/DS2438 живляться ПАРАЗИТНО з лінії даних, а 45 кОм не дають їм струму. Внутрішня лишається другорядним запобіжником. `busLineCheck()` перероблено: перша редакція читала «лінія висока без нашої підтяжки» як НЕСПРАВНІСТЬ — тобто лаялась на правильну плату й мовчала на тій, де резистора немає |
| «До переробок заряду з D12/D13 усе працювало» | переробка прибрала `CHARGE_PIN` (GPIO32), і пін лишився ВИСІТИ ВХОДОМ, хоча раніше його опускали в LOW найпершим рядком | Повернуто утримання в LOW (`CHARGE_LEGACY_EN_PIN`). Плюс перевірка ЛІНІЇ ДАНИХ, а не лише керуючого піна: `busLineCheck()` бачить випадок «пін справний, а підтяжка до шини не доходить» — обрив резистора, немає контакту або **немає спільної землі з пакетом** (а її й зачіпає шунт у мінусовому проводі, доданий разом із зарядом) |
| «Перевір роботу D12: при читанні помилка, немає pull up» | лінія enable/підтяжки ніяк не перевірялась — прошивка піднімала пін і йшла далі | Додано `enableLineCheck()`: підняти, прочитати рівень назад, опустити, прочитати ще раз. Несправність тепер названа («ПОМИЛКА: підтяжка (GPIO12)») замість «нема чіпа», що звинувачувало пакет. Задокументовано, що GPIO12 — strapping-пін MTDI |
| «Виправити: треба 14 В» | у повідомленні стояв лише допуск «потрібно 12.5…16.0 В» | Головним числом став НОМІНАЛ: «треба 14 В (допуск 12.5…16.0)». Допуск пояснює, чому блок відхилено, але не каже, який під'єднати. Номінал береться з `CHARGE_SUPPLY_MV` (поле `psuNomMv` для клієнтів), а не зашитий у текст |
| «Блимати має плашка з текстом, а не текст» | блимав сам напис — півперіоду порожня червона смуга без причини | Блимає тло й рамка, текст стоїть нерухомо (на монохромному — інверсія заливки). Формулювання назвали причину: «ЗАВИЩЕНА/ЗАНИЖЕНА НАПРУГА БЛОКА ЖИВЛЕННЯ» окремим полем `psuHead` для всіх клієнтів |
| «Помилка живлення має бути на екрані й у клієнтах, із блиманням» | було лише «!» у шапці й рядок на сторінці заряду | Окрема сторінка помилки, що з'являється САМА (обидва екрани), із блимаючим написом; блимаючі смуги у вебі, HTML- і Python-клієнті. Сторінка знімається кнопкою — без блока живлення прилад лишається придатним для читання й правки пам'яті |
| «Зображення не з'явилось» ✅ **вирішено** | режим і частота SPI не налаштовувались: `tft.init()` кликався без них | Обидва винесено в `settings.h`. Для панелей без CS типово режим **3**: CS припаяний до землі, контролер вибраний завжди й межу посилки визначає за станом такту в спокої — з «не тим» режимом біти приймаються зі зсувом і екран лишається чорним. Частота теж явна (24 МГц) — типова бібліотечна на перемичках дає «сніг» або чорноту |
| «На дисплеї немає CS» | `DISPLAY_CS_PIN` вважався обов'язковим | CS став необов'язковим (`-1` / `U8X8_PIN_NONE`); вартові з ним обгорнуто в `defined()`, інакше його відсутність читалась би як GPIO0; додано перевірку, що шину SPI ніхто не ділить. Типовим лишили ЗАДАНИЙ пін: смикати непід'єднаний GPIO безкоштовно, а `-1` залежить від версії Adafruit_SPITFT |

## 3.3. Чотири помилки, яких я припустився по дорозі

Вони варті окремої згадки: усі чотири пройшли б непоміченими, якби кожну
`#error`-перевірку не прогнати на **навмисно порушеній** конфігурації.

**«Точка нульового струму».** Я написав, що `D = Uпакета/Uживл` дає нульовий
струм і з неї безпечно стартувати. Насправді це межа режимів, і середній струм
там — половина розмаху пульсацій, тобто ~650 мА. Виявив, підставляючи уточнену
індуктивність 104 мкГн.

**Критерій переривчастого режиму вдвічі суворіший.** Порівнював уставку з
**повним** розмахом пульсацій замість **половини**. Перевірка хибно спрацювала,
щойно профіль знизили під тепловий бюджет ключа.

**Той самий дефект №4 — власноруч.** Перевірка струму бази не спрацювала, хоча
умова була порушена: макрос `CHARGE_RIPPLE_MA_EST` визначався **нижче** за
`#if`, який його згадує. Виправлено: усі розрахункові макроси винесено на
початок блока перевірок, із коментарем, чому порядок тут не косметика.

**І він же — вдруге, тим самим способом.** Додаючи перевірки живлення, я
поставив їх у файлі **вище** за `CHARGE_NPN_IB_UA`, і препроцесор знову
прочитав макрос як нуль — перевірка спрацювала хибно на цілком справній
конфігурації. Тобто коментар «порядок тут не косметика» я написав сам і сам
же його порушив за кілька правок. `CHARGE_NPN_IB_UA` теж переїхав нагору.
Мораль та сама, але тепер із доказом: у C-препроцесорі невідомий ідентифікатор
у `#if` — це **мовчазний нуль**, і жодного попередження не буде.

**Резистори, пораховані на одну точку замість діапазону.** `R_бази` 150 Ом і
`R_драйв` 470 Ом я порахував на номінальні 14 В — і обидва не витримали, щойно
з'явився допуск живлення 12.5…16 В: перший не насичує ключ на нижній межі,
другий не насичує NPN на верхній. Знайшли це не вимірювання, а самі
`#error`-перевірки при першій же збірці. Звідси й правило, яке тепер записане
в `settings.h`: обв'язку рахують на **межах** допуску, а не в його середині.

---

## 3.4. Дві скарги з випробувань на залізі

Обидві виглядали як несправність заряду, а виявились дефектами прошивки —
причому такими, де прошивка **сама створювала аварію** або **сама ставила
неправильний діагноз**.

### «Під час заряду або розряду пристрій періодично перезавантажується»

Перезавантажував **сторожовий таймер**, і робив це на цілком справному
пристрої. У налаштуванні Task WDT стояло:

```c
esp_task_wdt_config_t cfg = { CHARGE_WDT_SEC * 1000U,
                              (uint32_t)(1 << portNUM_PROCESSORS) - 1, true };
//                             ^^^^^^^^^^^^^^^^^^^^^^^^^^^^^^^^^^^^^ = 0b11
```

Друге поле — `idle_core_mask`, перелік **бездіяльних** задач, які теж мусять
відмічатися у сторожа. `0b11` означає «обидва ядра». На вигляд — «хай стежить
за всім, гірше не буде».

Гірше стало. Скетч Arduino крутиться в задачі `loopTask` із пріоритетом 1,
прибитій до ядра 1. `IDLE1` має пріоритет 0 і отримує процесор **лише** тоді,
коли `loopTask` заблокується. А наш `loop()` не блокувався ніде — суцільне
неблокуюче опитування, чим цей проєкт, власне, й пишався. Отже `IDLE1` не
виконувалась, сторожа не годувала, і рівно через `CHARGE_WDT_SEC` (10 с) або
`DISCHARGE_WDT_SEC` (30 с) прошивка падала в паніку `Task watchdog got
triggered … IDLE1`.

Саме тому arduino-esp32 у своїй типовій конфігурації вмикає перевірку `IDLE0`
і **не** вмикає `IDLE1`: автори знають, що цикл Arduino окупує ядро 1. Наш
виклик `esp_task_wdt_init()` мовчки скасовував це рішення.

«Періодично», а не «завжди» — бо зрідка цикл усе ж блокувався: звернення
веб-клієнта, робота зі SPIFFS, `Serial.flush()`, плавні згасання підсвітки.
Кожна така пауза давала `IDLE1` шанс відмітитись і відсувала падіння. Тиха
зарядка без під'єднаного клієнта падала найшвидше.

Виправлено трьома правками:

1. **Маска — жорсткий нуль.** Сторож стежить за тією однією задачею, яка
   справді керує ключем. Це не послаблення: саме її зависання ми й ловимо.
2. **`loop()` віддає квант часу** — `delay(1)` наприкінці. Бездіяльна задача
   мусить виконуватись і без сторожа: саме вона звільняє пам'ять видалених
   задач FreeRTOS, а без цього купа повільно тане — інший клас «раптових
   перезавантажень».
3. **На зупинці більше не викликається `esp_task_wdt_deinit()`.** Сторожа на
   цьому пристрої створюємо не ми — arduino-esp32 піднімає його ще до
   `setup()`. Наш `deinit` зносив увесь механізм, і після першого ж заряду
   пристрій до кінця сеансу лишався взагалі без Task WDT, тобто **справжнє**
   зависання циклу вже ніхто не ловив. Тепер відновлюються завантажувальні
   налаштування.

Окремо: код сторожа був **скопійований** у `charge.h` і `discharge.h` двома
майже однаковими копіями, тож і помилка була однакова, і ловити її довелось
двічі. Механізм переїхав у спільний `wdt.h`; тест стежить, щоб копії не
з'явились знову.

### «При досягненні максимального заряду: напруга 9.9 В, аварійна зупинка, перенапруга»

Тут неправдою було **все повідомлення цілком**.

9.9 В — це не виміряна напруга. Це рівно те число, яке видає ланцюжок
перерахунку, коли АЦП уперся в стелю:

```
chargeAdcMv()  = 4095 × CHARGE_ADC_FULL_MV / CHARGE_ADC_MAX_RAW = 4095 × 3300 / 4095 = 3300 мВ
chargePackMv() = 3300 × (R_TOP + R_BOT) / R_BOT                 = 3300 × 30000 / 10000 = 9900 мВ
```

Тобто «9.9 В» — підпис відліку 4095, а не напруга на клемі. Про саме залипання
в `settings.h` написано прямо (біля `CHARGE_ADC_MAX_MV`), але прошивка все одно
брала залиплу цифру за напругу пакета. Перенапруги теж не було: 6-елементний
пакет IMPRES фізично не буває під 9.9 В — повний це 8.25 В.

Що впертий у стелю вхід означає насправді: на плюсовій клемі стоїть **напруга
живлення**, а не напруга пакета. Пакета в колі немає. Причини за спаданням
імовірності: втрачено контакт клем; знято `enable` (немає обов'язкового
рівень просів або обірвано лінію); пакет від'єднався власним
внутрішнім захистом.

Іронія в тому, що цей самий сценарій у `settings.h` уже описаний — перевіркою
(2) «якщо пакет від'єднати посеред заряду, на клемі лишиться напруга
живлення». Вона стежила, щоб **пін це пережив**, і нікому не спало на думку,
що прошивка при цьому **неправильно назве** побачене.

Виправлено:

* нова причина зупинки `CHGR_NOPACK` із чесним текстом і підказкою, що
  перевіряти;
* відсічка `chargeNoPackTrip()` перевіряється **раніше** за перенапругу —
  залипле показання підходить під обидві умови, і порядок вирішує діагноз;
* поріг `CHARGE_VSENSE_SAT_MV` **обчислюється** з номіналів подільника
  (9300 мВ), а не пишеться числом, і дві нові `#error`-перевірки тримають його
  між аварійною межею (8350) і максимально можливим показанням (9900): нижче —
  з'їдав би справжню перенапругу, вище — не спрацював би ніколи;
* напруга з монітора DS2438 **більше не викидається**. Раніше вона йшла у
  змінну на ім'я `dummy` — а це єдиний у прошивці незалежний вимір напруги,
  зроблений **ізсередини** пакета. Тепер вона зберігається, друкується в
  кожному рядку журналу поруч із виміром на клемі й входить в аварійне
  повідомлення: коли клема пішла в стелю, а чип показує 8 В, діагноз
  однозначний.

## 3.5. Заміна ключа на P-канальний MOSFET — і чому це не «просто інший корпус»

Власник поставив замість B772M польовий **NTD2955G**. У коді з'явився вибір
типу ключа (`CHARGE_SWITCH_TYPE`), і це не перейменування блока: обв'язка
СПІЛЬНА, а фізика різна настільки, що майже кожна перевірка силової частини
мусила розгалузитись.

**Ті самі резистори означають тепер зовсім інше.** У біполярника `R_drive`
задавав **струм бази**. У польового затвор струму не споживає, і `R_drive`
разом із запираючою підтяжкою утворює звичайний **дільник напруги**:

```
Uзатв = Uке_нас(npn) + (Uживл − Uке_нас) × R_drive/(R_drive + R_підт)
      = 0.2 + 13.8 × 120/1120 = 1.68 В   →   |VGS| = 14 − 1.68 = 12.3 В
```

Резистори ті самі, фізичний зміст — інший. Підставити в стару формулу нові
номінали означало б отримати зручне, але неправильне число саме там, де воно
вирішує долю ключа.

**Що змінилось у перевірках:**

| Було (біполярний) | Стало (польовий) |
|---|---|
| `Iб ≥ Iк/β_форс` на нижній межі живлення | `\|VGS\| ≥ 1.5×VGS(th)` на нижній межі живлення |
| — | `\|VGS\| ≤ 0.8×VGS(max)` на **верхній** межі (пробій затвора — відмова назавжди) |
| — | `Uживл ≤ 0.8×Vds(max)` |
| — | перемикання ≤ 10 % періоду ШІМ (інакше ключ — резистор під 14 В) |
| NPN пропускає струм **бази** | NPN пропускає наскрізний струм **дільника** |
| підтяжка не з'їдає понад 20 % драйвера | підтяжка не розсіює понад 0.25 Вт |
| `P = Uке_нас × I × D` (лінійно) | `P = I²×RDS(on) × D` (**квадратично**) |
| `tsw` з даташита | `tsw` з `Qg` і струму **нашого** драйвера |

Останній рядок варто прочитати двічі: у польового час перемикання задає не
паспорт приладу, а те, скільки струму дає в затвор наша обв'язка. Паспортні
45 нс — це те, що прилад показав би з нормальним драйвером; у нас вимикання
триває 1838 нс, бо вгору затвор тягне сама лише підтяжка 1 кОм.

**Що це дало по числах.** Розсіювання на ключі 473 мВт замість 819, і головне
— проти `Pd` 55 Вт замість `Pc` 1.25 Вт, тобто радіатор більше не потрібен.
Драйвер палить 172 мВт замість 1505: ват, який біполярник спалював просто на
відкривання, зник разом із струмом бази.

**І одна вимога до заліза ослабла, а одна — ні.** Заміна 20 кОм → 390 Ом у
базі NPN лишається обов'язковою (причина інша — тепер це наскрізний струм
дільника, а не струм бази). А `R_drive` 1 кОм → 120 Ом стала бажаною замість
смертельної: 1 кОм дає |VGS| 6.9 В при порозі 4 В, ключ відкривається — просто
з опором каналу вище паспортного. Прошивка друкує обидва числа при старті й
називає, яка заміна критична, а яка ні.

**Перевірено в обидва боки.** Увесь набір із 8 тестів зібрано й прогнано
двічі — з `CHARGE_SW_PMOS` і з `CHARGE_SW_BJT_PNP`:

```bash
# бойова конфігурація
for f in tools/*_check.cpp; do g++ -std=c++17 -I. -Itools/fake -o /tmp/t "$f" && /tmp/t; done
# і та сама з біполярним ключем — опція мусить лишатись робочою
mkdir -p /tmp/bjt && sed 's/CHARGE_SWITCH_TYPE CHARGE_SW_PMOS/CHARGE_SWITCH_TYPE CHARGE_SW_BJT_PNP/' \
  settings.h > /tmp/bjt/settings.h
for f in tools/*_check.cpp; do g++ -std=c++17 -I/tmp/bjt -I. -Itools/fake -o /tmp/t "$f" && /tmp/t; done
```

Усі сім нових `#error`-перевірок прогнано на навмисно зламаній конфігурації —
кожна спрацювала.

## 3.6. Дозаряд малим струмом від 90 % і кінець заряду на 8.2 В

Дві зміни на вимогу власника, обидві про ресурс пакета, а не про швидкість.

**Поріг переходу на малий струм: 95 % → 90 %** (`CHARGE_TAPER_PCT`). Останні
відсотки набираються при напрузі, близькій до кінцевої, і саме там струм
найшкідливіший: він піднімає напругу на внутрішньому опорі пакета, тож банки
бачать більше, ніж показує клема, і заряд фактично заходить за межу. Що раніше
перейти на 100 мА, то ближче виміряна напруга до справжньої напруги банок.
Ціна — час: відрізок 90…100 % тепер іде на 100 мА замість 1000.

Поріг перестав бути числом у коді: раніше `95` було зашите просто в
`chargeSetpointMaForPct()`, тепер це константа, яку читає ще й перевірка в
`settings.h`. Два джерела однієї величини рано чи пізно розходяться — у цьому
проєкті таке вже траплялось.

Заразом поріг збігся з `CHARGE_LED_TAPER_PCT`, і це чесніше, ніж було:
індикатор перемикається рівно тоді, коли режим справді змінюється. Раніше він
показував «майже готово» на 90 %, тоді як струм падав лише на 95 %. Нова
перевірка не дасть їм розійтись у ІНШИЙ бік (індикатор пізніше за спад) — це
означало б, що пристрій показує крейсерський заряд, уже дозаряджаючи.

**Кінець повного заряду: 8.25 В → 8.2 В** (`CHARGE_TARGET_MV`). Тут головне —
що саме розчеплено. Було `CHARGE_TARGET_MV = BATTERY_FULL_MV`, тобто одне
число служило двом різним ролям:

* `BATTERY_FULL_MV` (8250) — «100 %» **шкали паливоміра**. За нею рахуються
  відсотки скрізь: головний екран, розряд, записи в пам'ять пакета;
* `CHARGE_TARGET_MV` (8200) — те, **до чого ми заряджаємо**.

Змішувати їх не можна: опустити шкалу означало б переписати відсотки в усьому
пристрої, включно з уже збереженими даними.

⚠️ **Наслідок, який легко прийняти за дефект:** наприкінці успішного заряду
паливомір покаже **~97 %**. Це арифметика шкали (8200 на 6350…8250 = 97 %), а
не недозаряд. Тримати банки біля самої стелі — головна причина прискореної
деградації; 50 мВ недобору коштують кількох відсотків ємності й віддають
помітно більший ресурс. Тест фіксує це число явно, щоб воно не було
несподіванкою.

Якщо колись знадобиться рівно 100 % наприкінці заряду — міняти треба
`BATTERY_FULL_MV`, тобто всю шкалу разом із розрядом, а не ціль заряду.

**Нових `#error`-перевірок шість**, і всі прогнано на зламаній конфігурації:
поріг дозаряду всередині 80…100 %; індикатор не пізніший за спад струму;
дозарядний струм щонайменше втричі менший за крейсерський; ціль заряду не вище
верху шкали, не нижче порожнього пакета і вище за ціль розряду.

## 3.7. Заставка через SPIFFS, enable перед стартом заряду

### Кольорова заставка без перепрошивання

Раніше кастомна заставка означала повний цикл: `make_color_splash.py` робив
`custom_splash.h` із C-масивом, файл клався в теку скетчу, далі Arduino IDE,
компіляція, прошивання. Помінялась картинка — усе спочатку.

Тепер її можна просто **завантажити у SPIFFS** через веб («Заставка екрана»).
Прошивка лишається та сама.

**Підтримуються ДВА формати, і тип визначається за МАГІЄЮ файла**, а не за
розширенням (розширення бреше, перші байти — ні):

| | JPEG | сирий `.bin` |
|---|---|---|
| що вантажити | звичайний JPEG/JPG із телефона чи редактора | підготовлений RGB565 |
| місце у SPIFFS (240×240) | **10…30 КБ** | 113 КБ |
| перетворення | не потрібне — пристрій розкодує сам | браузер або `--bin` |
| залежність | бібліотека **TJpg_Decoder** | жодної |

⚑ **Спершу тут свідомо підтримувався лише сирий RGB565**, і аргумент був такий:
декодер тягне бібліотеку, пам'ять під розпакування і новий клас падінь на
кривому файлі — заради картинки, яку показують півтори секунди. Власник
попросив вантажити просто JPEG, і в аргументу виявився другий бік, який
переважує: у файловій системі вже лежить `index.html` на 226 КБ, і різниця в
сотню кілобайтів там відчутна. Обидва формати лишились; JPEG вимикається
одним рядком (`DISPLAY_SPLASH_JPEG`), і тоді залежностей немає взагалі.

**Формат сирого файла — RGB565 із 8-байтовим заголовком** (`splash.h`):

```
0..3  'M','B','S','1'
4..5  ширина, пікселів (LE)
6..7  висота,  пікселів (LE)
8..   w*h*2 байтів RGB565, СТАРШИЙ БАЙТ ПЕРШИМ, рядками зверху вниз
```

Чому не PNG: декодер у прошивці — це бібліотека, пам'ять під розпакування і
новий клас падінь на кривому файлі заради картинки, яку показують півтори
секунди. Сирий RGB565 не декодується взагалі. Перетворення робить **браузер**
(canvas і так уміє відкрити будь-що) або `make_color_splash.py --bin`.

Big-endian — не примха: саме в цьому порядку байти йдуть у шину ST7789, тож
`writePixels(..., bigEndian=true)` віддає буфер напряму, без перевертання
кожного пікселя.

Заголовок потрібен рівно для одного: **чужий файл ПОТРІБНОЇ довжини**. Без
магії будь-що завдовжки 115 208 байтів пройшло б як картинка й вивалилось на
екран шумом. Тест перевіряє саме цей випадок, і ще — що магія читається
**раніше** за розміри, інакше на PNG повідомлення було б «довжина не
збігається», тобто вело б шукати не туди.

Ще дві речі, які легко зробити неправильно:

* **Малюємо потоком**, а не цілим буфером: 240×240 RGB565 — це 115 200 байтів,
  і виділяти їх на старті (одночасно з підняттям Wi-Fi) заради півтори
  секунди — марно. Читаємо рядок і одразу віддаємо в шину, буфер — 480 байтів.
* **Приймаємо у тимчасовий файл.** Приймання може обірватись, і затерти робочу
  заставку недописаним шматком означало б зламати те, що працювало, — при
  спробі, яка навіть не дійшла до кінця. Бойовий файл підміняється лише після
  перевірки. Стелю розміру теж перевіряємо **на ходу**, інакше завеликий файл
  спершу заповнив би SPIFFS (витіснивши `index.html`) і лише потім був би
  відхилений.

Порядок джерел у `displaySplash()`: **JPEG → сирий `.bin` → `custom_splash.h`
→ типова НГУ**. Перевага JPEG не довільна: приймальник, зберігаючи один
формат, **видаляє інший**, тож два файли поруч не лежать, і «поточна заставка»
не залежить від порядку перевірок.
Загалом: Файл перекриває вкомпільовану картинку навмисно: це вибір,
зроблений пізніше за прошивання.

⚑ Приймальник і дисплей розбирають файл **тим самим** `splashParse()`. Два
окремі розбори рано чи пізно розійдуться, і приймальник почне пропускати те,
чого дисплей не покаже.

### Enable піднімається ПЕРШИМ, а не останнім

Пакет IMPRES під'єднує клеми до зовнішнього кола за сигналом enable. Поки він
не піднятий, на клемі немає напруги **пакета** — там або нічого, або напруга
нашого ж живлення через ключ.

А `chargeStart()` піднімав enable **у самому кінці** — після того, як зміряно
напругу, струм і температуру, і навіть після `chargeSetDuty()`, тобто струм
подавався раніше за під'єднання пакета. Коментар поруч при цьому стверджував
«enable ще ДО подачі струму»; порядок був зворотний.

Тепер enable піднімається найпершим, далі пауза `CHARGE_ENABLE_LEAD_MS`
(100 мс) — і лише потім усі виміри й перевірки. Це, серед іншого, прибирає
одне з джерел хибної «перенапруги 9.9 В» з розділу 3.4: вимір на розімкненій
клемі давав стелю подільника.

⚑ Тіло після підйому enable винесене в лямбду **не для краси**: у нього сім
різних виходів «не можна почати», і при кожному enable треба зняти назад. Сім
однакових рядків перед сімома `return` — це шість шансів забути один і лишити
пакет під'єднаним після невдалого старту. Тепер точка згортання одна.

### Заразом виправлено

Резистор 4.7 кОм між GPIO12 (enable) і +3.3 В **більше не називається
обов'язковим**. Власник уточнив: він стоїть на платі, але поставлений для
попереднього налагодження функцій. Я вивів «обов'язковість» із самого факту
наявності — це було припущення, а не факт із цієї плати. Виправлено в
`settings.h`, `README.md`, `INSTRUCTION.md`, `SCHEMATIC.html` і в тексті аварійного
повідомлення «пакет від'єднано», яке відправляло перевіряти саме цей резистор.
⚠️ Не плутати з підтяжкою **лінії даних** (GPIO13) — ота обов'язкова: чипи
живляться з неї паразитно.

## 3.8. Bluetooth: ті самі клієнти без кабелю

> 🔴 **ЗАРАЗ ВИМКНЕНО (`BT_ENABLED` закоментовано).** На залізі з увімкненим
> Bluetooth пристрій перестав під'єднуватись по Wi-Fi. Причина майже напевно в
> пам'яті: стек Bluedroid забирає десятки кілобайтів купи, а точці доступу
> разом із веб-сервером, SPIFFS і буферами дисплея й так лишалось небагато.
> Друга складова — спільне радіо: Wi-Fi і класичний BT діляться ефіром, і
> навіть коли обидва піднялись, з'єднання стає хитким.
>
> Wi-Fi тут **головний** канал (веб-інтерфейс, завантаження заставки,
> оновлення), а Bluetooth — зручність поверх нього; втрачати головне заради
> зручності не можна. Увесь код лишився на місці й перевірений — вмикається
> одним рядком. Рядок «Вільна купа: …» у журналі при старті показує, чи
> вистачає пам'яті на конкретній збірці.

Командний протокол (`serial_api.h`) віддається ще й по **Bluetooth SPP** —
послідовному порту поверх радіо.

**Вибір SPP, а не BLE, вирішує тут майже все.** На комп'ютері SPP виглядає
ЗВИЧАЙНИМ COM-портом, тож `moto_gui.py` (pyserial), `moto_bridge.py` і
`client_usb.html` (Web Serial) працюють **без жодних змін** — треба лише обрати
інший порт зі списку. BLE довелося б обгортати власним GATT-сервісом і
переписувати транспорт у кожному клієнті; Web Bluetooth уміє тільки BLE, зате
Web Serial уміє COM-порт — тобто браузерний клієнт і так дістає радіо через SPP.

Протокол виявився майже готовим до цього: у `serial_api.h` було рівно **п'ять**
згадок `Serial`. Тепер вивід іде через `Stream *`, і обидва канали обслуговує
спільний `serialPump()`.

Два місця, де легко зробити мовчазний дефект:

* **Відповідь мусить іти туди, звідки прийшла команда.** Якби `sResp()` і далі
  писав у `Serial`, клієнт по Bluetooth не бачив би ЖОДНОЇ відповіді, а чужі
  відповіді сипались би в USB-консоль. На столі це виглядає як «пристрій не
  відповідає». `g_serOut` перемикається на час виконання й повертається назад.
* **Накопичувачі входу окремі.** Один спільний означав би, що дві команди, які
  прийшли одночасно різними каналами, склеяться в одну — рідко,
  недетерміновано й дуже неприємно для пошуку.

### Чому по радіо запис вимагає пароль

По USB протокол відкритий повністю, і це виправдано: щоб щось надіслати, треба
фізично встромити кабель. `AUTH` там лише звіряє пароль і підсвічує статус —
команди запису працюють і без нього.

По Bluetooth такого захисту немає. У радіусі дії опиняється будь-хто, а серед
команд є `WIPE33`, `WRITE33`, `CLEAN` — повне стирання пам'яті акумулятора.
Мовчки винести цей перелік в ефір означало б зробити з «хтось поруч» справу
однієї команди.

Тому по BT читати можна вільно (щоб клієнт знайшов пристрій і показав стан), а
змінювати — лише після `AUTH <пароль>`. По USB поведінка **не змінилась**.

⚑ Перелік «безпечних» команд узято **закритим і білим**: усе, чого в ньому
немає, вважається записом. Забути дописати нову команду в перелік дозволених —
це відмова в бік «попросить пароль». Чорний перелік при тій самій
забудькуватості пустив би її в ефір без пароля.

### Що доведеться зробити при збірці

| | |
|---|---|
| Схема розділів | **Huge APP (3MB No OTA/1MB SPIFFS)** — інакше прошивка зі стеком BT не влізе |
| Плата | лише **звичайний ESP32**: на S3/C3/C6 класичного BT немає фізично |
| Пароль | змініть `ADMIN_PASSWORD` — стандартний «admin123» по радіо майже те саме, що без пароля |

Перевірити схему розділів на компіляції неможливо (вона задається в IDE), тому
пристрій друкує вільну купу при старті, а `BluetoothSerial` просто не
запуститься, якщо місця немає — і скаже про це прямо.

### Збірка на ядрі 3.3.11: `setPin()` змінив сигнатуру

Перша збірка на залізі впала:

```
error: no matching function for call to 'BluetoothSerial::setPin(const char [5])'
note: candidate: 'bool BluetoothSerial::setPin(const char*, uint8_t)'
```

У arduino-esp32 **2.x** метод був `setPin(const char *pin)`, у **3.x** став
`setPin(const char *pin, uint8_t pin_code_len)`. Виправлено гілкою за
`ESP_ARDUINO_VERSION_MAJOR` — тим самим способом, що вже застосований у
`wdt.h`, разом із захисним `#error` на випадок, коли макрос невідомий (інакше
препроцесор мовчки прочитав би його як нуль і пішов гілкою для 2.x, тобто
впав би на тій самій помилці).

Довжина береться з самого літерала — `sizeof(BT_PIN) - 1`, а не пишеться
числом: інакше зміна `BT_PIN` тихо розійшлася б із переданою довжиною, і PIN
або обрізався б, або читався за межами рядка.

Обидві гілки перевірено збіркою проти **змодельованих заголовків** обох ядер
(заглушка `BluetoothSerial` із відповідною сигнатурою), а не «на око».

Довжини імені й PIN перевіряються `static_assert`-ами, а не `#if`: препроцесор
не вміє `sizeof`, і спроба написати `#if (sizeof(BT_NAME) - 1) > 26` дає
«missing binary operator before token "("». Заразом `constexpr`-перевірка
ловить літери в PIN — legacy pairing їх не приймає, і виявилось би це аж на
спарюванні.

## 3.9. Завелику заставку тепер зменшують, а не відхиляють

Було: JPEG більший за екран відхилявся з проханням зменшити самому. Знімок із
телефона майже завжди більший, тож це означало похід у редактор заради того,
що можна зробити автоматично.

**Зменшення в ДВОХ місцях, і вони різні за призначенням:**

* **У браузері — основний шлях.** Картинку і так вписують у розмір панелі зі
  збереженням пропорцій (той самий `contain`/`cover`); тепер готовий кадр
  зберігається назад у JPEG. Якість підбирається згори вниз (0.92 → 0.45),
  поки файл не влізе у стелю: краще трохи гірша картинка, ніж відмова.
* **На пристрої — запобіжник** для файлів, що потрапили у SPIFFS іншим шляхом.
  `splashJpegScaleFor()` обирає коефіцієнт 1/2/4/8.

⚑ **Чому на пристрої лише кратно двом.** TJpgDec зменшує в 1, 2, 4 або 8 разів —
це властивість формату, а не обмеження бібліотеки: JPEG зберігається блоками
8×8, і кратне зменшення робиться прямо під час зворотного перетворення, майже
безкоштовно. Довільний коефіцієнт вимагав би повного розкодування в пам'ять і
власного ресемплера — тобто рівно тих витрат, яких ми уникали, обираючи JPEG.
Саме тому основне масштабування лишається за браузером: 400×300 він дає рівно
240×180, а пристрій дав би 200×150 — «майже влізло» із зайвими полями.

**Пропорції зберігаються самі собою**, бо коефіцієнт ОДИН на обидві осі. Тест
перевіряє це не «на око», а числом: `dw × h` проти `dh × w` із допуском на
заокруглення блоків.

⚠️ Заокруглення — **вгору**: декодер видає `ceil(w/n)` пікселів. Округливши
вниз, ми вирішили б, що картинка влізла, і останній стовпчик поїхав би за край.
Через це 481 px при `/2` дає 241 — на піксель більше за екран, — і береться
`/4`. Це теж у тесті.

Відмова лишилась там, де не рятує навіть `/8`: ширший за екран понад увосьмеро
(для 240 px це 1921 px і більше). Краще сказати прямо, ніж показати обрізок.

## 3.10. Анімація шкали батареї більше не «скидається» на кожному опитуванні

Скарга: під час заряду/розряду анімована шкала раз на секунду смикається —
видно спалах рівного кольору замість плавного градієнта, що біжить.

**Причина була не в анімації, а в тому, що її щоразу стирали.** Сторінка
заряду на кожному опитуванні робила так:

```c
tft.fillRect(0, by - 2, TFT_W, bh + 4, C_BG);   // затерти смугу у фон
drawBatteryBar(...);                            // намалювати РІВНУ заливку
```

Далі `displayAnimTick()` (~9 к/с) знову клав градієнт поверх. Тобто кожної
секунди картинка на мить поверталась до рівного кольору — рівно те, що
читається як «скинулось».

**І перемальовувати було ні до чого.** Напруга змінюється щосекунди, а
ГРАФІЧНИЙ рівень — ні. Тепер рішення «малювати чи ні» ухвалюється за тим, що
видно на екрані: ширина заповнення **в пікселях**, колір і геометрія.
Збіглося все — не чіпаємо жодного пікселя, і градієнт біжить безперервно.

Три речі, без яких це не працювало б:

* **Порівнюємо ширину в пікселях, а не відсоток.** Порівняння за відсотком
  лишило б той самий дефект, просто рідше.
* **Шкала чистить власний слід сама** — і лише коли справді малює. Затирання
  на боці сторінки прибрано; заразом воно звузилось із «смуга на всю ширину»
  до footprint самої шкали, інакше на головній сторінці з'їдало б цифри
  відсотка поруч.
* **«Покоління» екрана.** Після `fillScreen()` кеш «уже намальовано» брехав би:
  стан той самий, а пікселів немає. Тому кожне повне очищення (заставка,
  перемальовка, зміна червоного відтінку, очищення тіла сторінки) оголошує
  нове покоління, і шкала малюється заново.

Заразом прибрано **друге джерело тих самих чисел**: `displayAnimTick()` рахував
ширину заповнення власною формулою з `batteryPercent()`. Поки вона збігалася з
тим, що намалювала сторінка, все виглядало гаразд; варто було б їм розійтися на
піксель — і градієнт малювався б іншої довжини, ніж рамка. Тепер анімація бере
`fw` і колір із намальованого стану.

### Що це дало, числом

Тест проганяє реальний хід напруги 7.40 → 8.20 В по одному мілівольту:

```
801 опитування -> 43 перемальовки замість 801
```

⚠️ **Одне моє припущення тест спростував.** Я записав, що «сусідні відсотки
часто дають однакову ширину, тому й економія». На шкалі 200 px це неправда:
194 px на 101 значення — кожен відсоток рухає щонайменше піксель. Збіги
з'являються на вузькій шкалі (60 px — майже половина відсотків не рухає
нічого), а на широкій економія береться з іншого місця: із квантування
«мілівольти → відсоток». Твердження було вигадане, а не виміряне; у тесті тепер
перевіряються обидві ширини.

**Монохромний шлях (`display.h`) не чіпав:** там U8g2 із повним буфером кадру,
сторінка й так перемальовується цілком, а сама анімація перебудовує іконку
щокадру — це її спосіб працювати, а не дефект.

## 3.11. Перезавантаження під час заряду/розряду: чорний ящик і фрагментація

Скарга повернулась після виправлення сторожа (3.4). Отже причина інша — і
головна проблема була не в ній, а в тому, що **після скидання від події не
лишалось нічого**. Кожна спроба закрити скаргу була здогадкою: сторож,
пам'ять, живлення, ШІМ.

### Чорний ящик (`postmortem.h`)

Раз на опитування пристрій записує кілька чисел у **RTC-пам'ять, яка переживає
скидання** (`RTC_NOINIT_ATTR` — завантажувач її не чіпає). Після
перезавантаження вони друкуються в журнал **і показуються у веб-клієнті** на
картці заряду:

```
RESET REASON: TASK WDT — головний цикл (loop) завис (код 6)
ПЕРЕД СКИДАННЯМ: ЗАРЯД, 2847 с роботи, опитування 2841, duty 1180, 940 мА, 8104 мВ
ПЕРЕД СКИДАННЯМ: купа 41216 Б (найбільший блок 9472 Б), запас стека loop() 2104 Б
⚠ КУПА СИЛЬНО ФРАГМЕНТОВАНА — вільної пам'яті вистачає, а суцільного шматка вже немає.
```

Три записані числа — це **три різні підозрювані**, і кожен має свою підказку:

| Число | Що воно ловить |
|---|---|
| запас стека `loop()` | переповнення стека — ззовні не відрізнити від зависання |
| вільна купа vs найбільший блок | фрагментацію: пам'яті «вистачає», а суцільного шматка немає |
| режим, час, шпаруватість | чи прив'язана подія до конкретного місця профілю |

Показуємо лише **ненормальні** причини: подача живлення, кнопка RESET і
навмисний перезапуск — штатні події, і банер про них висів би завжди, а на
такий банер перестають зважати.

### Знайдена й усунена причина: фрагментація купи

`/api/charge` і `/api/discharge` будуються **десятками `j += ...`** і
викликаються **кожну секунду**, поки клієнт дивиться на операцію. Рядок Arduino
росте блоками по 16 байтів, тож кожна відповідь — це десятки
`realloc` (malloc + memcpy + free) плюс тимчасовий `String` на кожне число.

Само по собі це не помилка. Але за години заряду виходять **сотні тисяч
розподілів різного розміру**, а це фрагментація: вільної пам'яті начебто
вистачає, а суцільного шматка під буфер Wi-Fi/TCP уже немає — і черговий
розподіл падає. Виглядає це рівно як «під час заряду пристрій періодично
перезавантажується»: у спокої цього не відбувається, бо ніхто не опитує статус
щосекунди.

Виправлено `reserve()` — один розподіл замість десятків. Якщо не влізе, рядок
доростає як раніше, тобто гірше не стане.

⚠️ **І цю версію журнал спростував.** Чорний ящик спрацював із першого разу:

```
RESET REASON: ПАНІКА/виключення — крах прошивки (код 4)
ПЕРЕД СКИДАННЯМ: ЗАРЯД, 127 с роботи, опитування 10, duty 1387, 490 мА, 8043 мВ
ПЕРЕД СКИДАННЯМ: купа 184192 Б (найбільший блок 110580 Б), запас стека loop() 4304 Б
```

Купа **184 КБ вільно, найбільший блок 110 КБ** — фрагментації немає й близько.
Стек — 4304 байти запасу. Сторож не спрацьовував, живлення не просідало. Це
**справжнє виключення**, і три головні підозрювані відпали одразу.

`reserve()` лишається як розумна оптимізація (сотні тисяч зайвих розподілів —
це зайві розподіли), але **причиною скидань вона не була**. Записую це прямо,
щоб наступний, хто читатиме, не пішов хибним слідом.

### Що каже число «опитування 10»

`CHARGE_TEMP_EVERY_N` = **10**. Тобто саме на цьому опитуванні під час заряду
**вперше** виконується читання DS2438 по 1-Wire — найдовша й найскладніша
операція опитування, на шині, яка на цій платі читається нестабільно (у тому ж
журналі — «нестабільне читання» на кожній сторінці DS2433).

Збіг виключений, але «десь у читанні» — це ще не адреса. Тому додано **позначку
етапу**: опитування розмічене на кроки (вимір струму, напруга, живлення,
DS2438, регулятор, журнал), і номер поточного лежить у тій самій RTC-пам'яті.
Наступне скидання назве не «під час заряду», а:

```
ПЕРЕД СКИДАННЯМ: ЗАРЯД, ЕТАП «читання DS2438 по 1-Wire», ...
```

Що перевірено в цьому шляху й виявилось справним: `dischargeSample()` захищає
ділення на нуль (`rs <= 0` -> константа), `chargeCcaMah()` теж, `pullupOff()`
поважає `_holdEnable` — тобто читання під час заряду **не** знімає enable,
хоча спершу виглядало саме так. Кеш ROM у `findDevices()` перевіряє
presence-pulse перед підстановкою. Джерела паніки читанням коду поки не
знайдено — потрібен блок `Guru Meditation` із backtrace, який панічний
обробник друкує безпосередньо перед перезавантаженням.

### Ще одна ознака від власника: до заряду скидань не було

Це звужує пошук сильніше за все інше. Читання DS2438 по 1-Wire саме по собі
працювало роками — отже падає не воно, а **воно в обставинах заряду**. Що саме
тримає заряд у момент читання й чого немає при звичайному читанні:

| Що додає заряд | Стан під час читання DS2438 |
|---|---|
| ШІМ на GPIO26 через LEDC | канал прикріплений, шпаруватість 0 (ключ закритий) |
| `holdEnable(true)` | PULLUP_PIN тримається HIGH **постійно**, `pullupOff()` стає пустишкою |
| Task WDT | підписаний на задачу циклу, поріг 10 с |
| АЦП | 128 відліків струму + 16 живлення щосекунди |
| Екран | сторінка заряду перемальовується щосекунди + анімація ~9 к/с |

⚠️ **Другий рядок — найцікавіший.** При звичайному читанні кожна транзакція
закінчується `pullupOff()`, тобто обидва чипи знеструмлюються й наступний
пошук іде «з холодного старту» (це прямо описано в `findDevices()`). Під час
заряду цього не відбувається **жодного разу** — лінія тримається піднятою
годинами. Тобто читання під час заряду йде в режимі, у якому воно поза зарядом
не буває ніколи. Це не доказ, але це саме та відмінність, яку варто перевіряти
першою.

### Заразом

* `dischargeSettle()` годував **лише сторож розряду**, хоча його кличе й
  `chargeTask()` — витримка перед виміром напруги. Зараз пауза коротка (10 мс) і
  до порога не дотягує, але це збіг обставин, а не властивість коду: варто
  підняти `CHARGE_VSENSE_SETTLE_MS` — і пристрій почав би перезавантажуватись
  саме на вимірі. Тепер годуються обидва.
* У щосекундний рядок журналу заряду й розряду додано **купу й запас стека**.
  Разові числа нічого не кажуть; потрібен тренд — саме він показує витік і
  фрагментацію ще до падіння.

### Що перевірено й НЕ підтвердилось

Щоб не лишати хибних слідів у документації, перелічую те, що я перевірив і
відкинув:

* **`ledcWrite(канал)` замість `ledcWrite(пін)`.** В arduino-esp32 3.x цей
  виклик приймає ПІН, і помилка тут була б катастрофічною: `LOAD_LEDC_CH` = 6,
  а GPIO6 — це лінія SPI-флеша, звернення до неї валить чип миттєво. Перевірено:
  у проєкті **скрізь передається пін**, помилки немає.
* **Спільний таймер LEDC із зумером.** Заряд (канал 4) і зумер (канал 5) справді
  ділять таймер 2 — але канал 5 живий лише у ШІМ-варіанті звуку (`BUZZER_PIN`),
  а звук іде через ЦАП (`BUZZER_DAC_PIN`): там LEDC не задіяний узагалі, синус
  рахується в перериванні звичайного апаратного таймера й лягає в `dacWrite()`.
  Конфлікту немає, і його стереже окремий `#error` наприкінці `settings.h`,
  обмежений саме `defined(BUZZER_PIN)`.
  (На момент тієї перевірки звук був вимкнений, і в тексті стояло «`buzzTask()`
  порожній» — це вже не так, а висновок той самий і з увімкненим звуком.)
* **`LED_CHARGE_TAPER` не в переліку «дихаючих» режимів** у `ledSet()`. Виглядало
  як пропуск, який давав би відчеплення ШІМ посеред апаратного згасання. Ні:
  цей режим і не дихає, він блимає через `digitalWrite`, тож перелік правильний.

## 3.12. ПРИЧИНУ ЗНАЙДЕНО: відчеплення каналу LEDC посеред згасання

Другий журнал із пристрою містив те, чого бракувало — блок паніки:

```
E (64046) task_wdt: esp_task_wdt_init(517): TWDT already initialized
=== Charge started: 7944 mV (83%) -> ціль 8200 mV (100%) ...
charge: ... (89%) ... set 1000 ... 5s
charge: ... (91%) ... set 100  ... 6s
charge: ... (90%) ... set 100  ... 7s
charge: ... (89%) ... set 1000 ... 8s
charge: ... (90%) ... set 100  ... 9s
charge: ... (89%) ... set 1000 ... 10s
Guru Meditation Error: Core 1 panic'ed (LoadProhibited)
PC : 0x4008d029   EXCVADDR: 0x00000141   EXCCAUSE: 0x1c
Backtrace: 0x4008d026:0x3ffc0b2c |<-CORRUPTED
```

### Три факти, які разом дають відповідь

1. **`PC` у IRAM (`0x4008xxxx`), backtrace «CORRUPTED», `EXCVADDR` біля нуля.**
   Це підпис падіння **в обробнику переривання**, а не в звичайному коді.
2. **Відсоток гуляє 89–91–90–89–90–89.** Отже `ledSet()` перемикався між
   `LED_CHARGE` (дихає) і `LED_CHARGE_TAPER` (блимає) **щосекунди**.
3. **`ledSet()` на кожен «не дихаючий» режим кликав `ledPwmDetach()` →
   `ledcDetach()`.** А в «дихаючих» яскравість веде **апаратне згасання**
   `ledcFade()` тривалістю 1.5 с.

Тобто канал LEDC відчіплювався **посеред згасання, що триває**, — і так
десятки разів поспіль. Служба згасання лишалась із обірваним контекстом, і її
обробник переривання падав на читанні за майже нульовою адресою.

**Це пояснює й головну ознаку: «до впровадження заряду перезавантажень не
було».** Заряд — ЄДИНИЙ режим, який регулярно перемикається між дихаючим і
недихаючим станом. Розряд тримає `LED_DISCHARGE` рівно, читання не дихає
взагалі.

### Виправлено з двох боків

**Причина (leds.h): відчеплення прибрано як клас.** Канали LEDC лишаються
прикріпленими, а рівні 0/max виставляються через `ledcWrite()` — це дає ту
саму «цифрову» поведінку, що й `digitalWrite`, без жодного відчеплення.

**Привід (charge.h): гістерезис на порозі дозаряду.** Відсоток рахується з
напруги, а вона на межі природно гуляє на десятки мілівольт (пакет релаксує
після закриття ключа), тож 8046…8079 мВ дають то 89 %, то 91 %. Тепер у
дозаряд входимо на `CHARGE_TAPER_PCT`, а виходимо лише на
`CHARGE_TAPER_HYST_PCT` нижче. Тест на реальній послідовності зі скарги:
**5 перемикань було, 1 стало.**

Заразом це прибирає й самі гойдалки струму: уставка стрибала **1000 ↔ 100 мА
щосекунди**, а слідом метався регулятор шпаруватості (1455 → 1411 → 1360 →
1401 → 1353 → 1395). Десятикратні коливання струму на пакеті й на ключі — це
було погано саме по собі, незалежно від паніки.

Індикатор тепер теж іде за станом `g_chg.inTaper`, а не за власним порівнянням
із порогом: інакше він брязкав би окремо від струму.

### І ще один мій дефект, який журнал показав прямо

```
E (64046) task_wdt: esp_task_wdt_init(517): TWDT already initialized
```

`esp_task_wdt_init()` працює **лише один раз**. Сторож піднімає arduino-esp32
ще до `setup()`, тож наш виклик повертав `ESP_ERR_INVALID_STATE` і **нічого не
міняв**. Мовчки. Тобто вся настройка сторожа з розділу 3.4 — і поріг, і
нульова маска IDLE — **не застосовувалась жодного разу**; підписка
`esp_task_wdt_add()` далі відпрацьовувала успішно, і зовні все здавалось
налаштованим.

Для зміни налаштувань уже піднятого сторожа є окремий виклик —
`esp_task_wdt_reconfigure()`. Тепер пробуємо `init`, а на `INVALID_STATE`
переходимо на `reconfigure`, і про невдачу пишемо в журнал замість мовчання.

---

## 3.13. Пакет закривається сам на 8.2 В — це кінець заряду, а не аварія

Спостереження власника після того, як перезавантаження пішли:

> по досягненні напруги 8.2 вольта, акумулятор сам відключається від зарядки,
> а наше устройство цього не розуміє і намагається зарядити, а при відсутності
> навантаження підвищується напруга до 9.90 В, після чого спрацьовує захист
> по перенапрузі.

Опис точний до останньої деталі, і кожна з них указує на окрему помилку.

### Чому 9.90 В — знову не напруга

Це те саме число, що й у розділі 3.4: підпис відліку АЦП 4095, а не вимір.
Пакет розімкнув свій внутрішній ключ, навантаження зникло, на клемі лишилась
шина живлення — подільник уперся в стелю. Ніякої перенапруги не було.

### Чому «захист по перенапрузі» все одно спрацьовував

Відсічку «пакета немає» ще в 3.4 поставили ПЕРЕД перевіркою аварійної межі —
і цього виявилось замало. Річ у витримці:

| перевірка | витримка |
|---|---|
| «пакет від'єднано» | `CHARGE_NOPACK_POLLS` = **2** опитування |
| аварійна межа | спрацьовує з **першого** відліку |

На першому ж насиченому проході перша перевірка чесно поверталась «ще рано»,
керування спокійно проходило повз неї вниз — і 9900 мВ, формально «вище
8300 мВ», давало `CHGR_HARD_MAX`. Порядок перевірок такого не рятує в принципі.

Рятує інше правило, і воно тепер записане прямо в коді: **насичений відлік не
подається на порівняння з напругою взагалі** — він не є виміром напруги.

```c
if (satMv) return;      // до порівнянь із межами діло не доходить
```

### Чому це взагалі мало вважатися успіхом

Головна ж помилка була не в діагнозі, а в самій постановці питання. На «клема
в стелі» прошивка знала одну відповідь — «пакета немає, аварія». А відповідей
чотири, і розрізняє їх свідок, який у схемі вже був: **монітор DS2438 сидить
усередині пакета**, живиться від банок і має власну лінію даних, тож силовий
ключ пакета його не глушить.

| монітор каже | що це насправді | результат |
|---|---|---|
| мовчить | пакета в колі фізично немає | `CHGR_NOPACK` — аварія |
| ≈ ціль (±`CHARGE_PACKFULL_TOL_MV`) | пакет повний, закрив себе сам | **`CHGR_PACKFULL` — ЗАВЕРШЕНО** |
| помітно нижче цілі | захист спрацював не за напругою | `CHGR_PACKOPEN` — аварія |
| вище аварійної межі | справжня перенапруга, вперше зсередини | `CHGR_HARD_MAX` — аварія |

Свідчення збираються за ВЕСЬ епізод, а не за останній прохід: 1-Wire на цій
платі читається нестабільно, і якби рішення бралось за останньою транзакцією,
одна невдача перетворювала б «повний» на «пакета немає» через раз.

### І перегони, які ми програвали

Пакет вимикає себе за власним виміром банок, а ми зупинялись за своїм — через
подільник із його похибкою і через дроти з їхнім падінням. Досить було
занизити на пів відсотка, щоб пакет щоразу встигав першим — і штатне
завершення заряду приходило до нас у вигляді розімкненого кола.

Тому додано другий, незалежний критерій завершення: **`chipMv >= targetMv`**.
Монітор міряє ті самі банки, що й захист пакета, тож заряд закінчується ДО
того, як захисту буде що робити. Помилитись цей критерій може лише в
безпечний бік — зупинити зарано, не запізно. Щоб він устигав, у кінці заряду
(за `CHARGE_CHIP_WATCH_MV` до цілі) монітор читається КОЖНЕ опитування, а не
раз на `CHARGE_TEMP_EVERY_N`: інакше рішення бралось би за показом, зробленим
іще до події.

### Дрібниця, яка була б наступною скаргою

Поки триває витримка на з'ясування, регулятор бачив нульовий струм — і
відповідав на нього єдиним доступним йому способом: піднімав шпаруватість.
У розімкненому колі це безглуздо й шкідливо. Тепер при насиченні привід ключа
знімається того ж проходу, а регулятор мовчить.

### Перевірено

* `chargeSatVerdict()` — усі чотири результати й обидві межі допуску з
  точністю до мілівольта (`charge_logic_check`, розділ 18);
* збій 1-Wire посеред епізоду НЕ перетворює «повний» на «пакета немає»;
* `chargeReasonIsDone()` — «завершено» стало множиною з двох причин, і
  питається вона в одному місці, а не порівнянням у кожному;
* два нових `#error` у `settings.h` — обидва звірені на порушеній
  конфігурації;
* п'ять охоронців у `session_guard_check` (розділ 21), кожен звірений
  «від протилежного»;
* і окремо — **сценарій власника прогнаний через СПРАВЖНІЙ `chargeTask()`**.
  Функція вирізається з `web_server.h` і збирається проти заглушок; цим же
  прогоном перевірено, що вона взагалі компілюється (`-Wformat` увімкнено).
  Стенд лежить поза деревом проєкту — щоб не тримати в репозиторії копію
  функції, яка тихо застаріє. Відтворюється так:

  ```bash
  sed -n '/^inline void chargeTask/,/^}/p' web_server.h > /tmp/chargeTask_body.inc
  # + невелика обгортка із заглушками dischargeSample/pmStep/ESP (див. нижче)
  ```

  Результат: пакет, що закрився сам на 8.2 В, дає «заряд завершено»; вийнятий
  пакет — «пакета в колі немає»; пакет, що розімкнувся на 7.0 В, — «захист
  спрацював не за напругою»; заряд завершується за монітором ДО того, як
  пакет закриє себе сам; штатні 7.9 В не будять нічого з цього.

---

## 3.14. Індикатор поверх попередження і текст за межами банера

Дві скарги про той самий екран.

### Індикатор заряду малювався поверх попередження

Сторінка помилки живлення виводиться ПОВЗ звичайний перемикач сторінок:

```c
if (chargePsuScreenActive()) { drawPagePsuFault(); return; }
```

а `g_displayPage` при цьому лишається нулем — тобто «головна». Анімація шкали
батареї дивилась саме на нього, бачила «головна», брала ЗАПАМ'ЯТОВАНІ
координати шкали й ~9 разів на секунду клала градієнт просто поверх червоної
плашки з попередженням.

Перелічувати в анімації сторінки-перехоплювачі — програшна гра: наступна така
сторінка знову про це не знатиме. Тому питання ставиться інакше й однозначно:
**чи та шкала, координати якої ми пам'ятаємо, намальована на ЦЬОМУ екрані.**
Кожне очищення екрана піднімає лічильник поколінь, `drawBatteryBar()`
запам'ятовує покоління, у якому малював, і анімація працює лише поки вони
збігаються. Одна умова закриває всі сторінки-перехоплювачі одразу.

### Текст вилазив за межі банера

Причина арифметична й перевірна наперед:

| напис | гліфів | шрифтом 9x15 | плашка | панель |
|---|---|---|---|---|
| `блок живлення просів або не той` | 31 | **279 px** | 236 px | 240 px |

Напис не вміщався навіть в екран. А центрування `(TFT_W - ширина) / 2` при
задовгому рядку дає **від'ємний** x, тож текст їхав ще й за лівий край.

Такі речі не ловляться оглядом коду: у UTF-8 кирилична літера це два байти,
тож `strlen()` тут бреше рівно вдвічі, і «на око» ніхто не порахує.

Виправлено трьома незалежними речами, бо однієї мало:

1. **Механізм переносу** (`textwrap.h`) — рахує ГЛІФИ, ламає по словах, довге
   слово ріже. Усі шрифти проєкту моноширинні, тож гліфи × ширина комірки — це
   точна ширина в пікселях, однакова на хості й на ESP32.
2. **Центрування в межах ПЛАШКИ**, а не всього екрана, і ширина спершу
   обмежується, а вже потім центрується те, що точно влізе.
3. **Ширина комірки шрифту стоїть поруч із іменем шрифта** (`FONT_BODY_W` біля
   `FONT_BODY`) — інакше одного дня перемкнуть шрифт і забудуть про ширину.

Написи заодно скорочено: слово «живлення» вже стоїть і в шапці сторінки, і в
заголовку плашки, тож утретє нічого не додавало.

Тест знайшов і те, чого скарга не називала: рядок `треба 14 В (12.6…15.6)` — 22
гліфи — не вміщався на 135-піксельній панелі й на будь-якій зі скругленими
кутами. Розбито на номінал і допуск окремими рядками: 12 і 11 гліфів,
вміщається скрізь.

### Перевірено

* новий `display_fit_check`: механізм переносу + усі написи банера на **шести**
  підтримуваних панелях, зі скругленими кутами й без;
* резерв рядків рахується з реальної ширини плашки, а не вгадується за шириною
  панелі — на цьому вже провалилась перша спроба (240 зі скругленням дає 21
  гліф, а найдовше пояснення — 22);
* правлені функції `display_color.h` **зібрані проти заглушок**: плашка 114 px,
  усі три рядки пояснень під нею лишаються вище смуги статусу (168/185/202 при
  межі 208);
* охоронці в `session_guard_check` (розділи 22–23), кожен звірений «від
  протилежного».

---

## 3.15. Скидання лічильників робило пакет «невідомим». Доказ із корпусу

Скарга власника:

> повністю робочий акумулятор після обнулення лічильників, напрацювання,
> вироблення перестає бачитись як оригінальний акумулятор.

### Що робило скидання

Обнуляло лічильники **тільки в DS2438**: ETM, CCA, DCA. DS2433 лишався як був —
із датою першого користування, з гістограмою на сотні циклів, із лічильником
калібрувань. Пакет після цього розповідав про себе дві несумісні речі одночасно:

```
DS2433:  «мене вмикали тоді-то, я пройшов 1097 циклів»
DS2438:  «я не пропрацював жодної секунди й не прийняв жодного мА·год»
```

### Доказ, а не гіпотеза

Такого пакета не буває — і це видно на корпусі `dumps/`. Із **52** цілих
фірмових пакетів напрацювання дорівнює нулю рівно у **двох**:

| дамп | ETM | циклів | CCA |
|---|---|---|---|
| `08-nova-batareya/01_PMNN4409A` | **0** | 1097 | 0 |
| `08-nova-batareya/02` | **0** | 1097 | 0 |

У решти 50 напрацювання — сотні мільйонів секунд. А `08-nova-batareya` — це
рівно той випадок, про який у цьому ж файлі й у коді написано: **«невідомий
акумулятор», ЗП лише світить зеленим.**

Досі провал 08 списували на чужий навчений хвіст. Це теж правда, але дефекту
там **два**, і другий — оцей. Хвіст ми полагодили давно; обнулений монітор
проти повного історії DS2433 лишався, і його продовжувало створювати наше ж
скидання. На корпусі стара поведінка ламала **47 пакетів із 47**, у яких була
історія.

### Виправлено

**Скидання узгоджене між двома чипами.** `impresHistoryZero()` (impres_crypt.h)
обнуляє історію в DS2433 під ключем ЦЬОГО чипа: цикли, повернення, дозаряди,
калібрування, день першого користування, день останнього заряду. Далі
обнуляються лічильники монітора. Або обидва боки, або жоден.

**Дата виготовлення НЕ чіпається.** Різниця з «новим акумулятором»
принципова: там чип порожній і дату взяти нізвідки, тому пишеться сьогоднішня.
Тут пакет робочий, і його дата — справжня й одна-єдина. Затерти її означало б
знищити останній достовірний факт про походження пакета, ще й зробивши його
«виготовленим» пізніше за власні записи.

**Без ROM-ID не робимо нічого.** Історія в DS2433 зашифрована ключем із
ROM-ID чипа; без нього її не переписати. Тоді скидання **відмовляється** і не
чіпає навіть монітор — пакет зі старими лічильниками нікому не шкодить, а пакет
із розсинхронізованими чипами рація відкидає. Обидва обробники повертають
пояснення, а не мовчазний успіх.

**Звітуємо за результатом.** `impresCyclesWrite()` відмовляється працювати з
блоком гістограми не тієї довжини — на п'яти пакетах корпусу вона саме так і
робить. Тому `impresHistoryZero()` перечитує результат тим самим кодом, яким
його читатиме аудит, і повертає false, якщо гістограма лишилась ненульовою.

**Аудит навчився називати цей стан.** Нова знахідка `AUD_MONITOR_ZEROED` —
«монітор обнулено, а історія лишилась». Вона питає лише про НЕзашифровану
гістограму циклів і тому працює навіть там, де ключ не підібрано. Свіжий пакет
під неї не потрапляє: у нього нулі з обох боків.

### Перевірено

* новий `reset_consistency_check` на всьому корпусі `dumps/` (55 пар):
  дзеркало, суми заголовка й TLV-записів, оборотність перешифрування, запис
  нуля в гістограму;
* доказ із корпусу оформлено як перевірку: ETM = 0 буває **рівно** в
  `08-nova-batareya` і **рівно** там, де DS2433 суперечить монітору;
* стара поведінка створювала суперечність у 47 пакетах із 47 — нова в жодному;
* дата виготовлення переживає скидання незмінною на всьому корпусі;
* `resetBatteryData()` **зібрана проти заглушок** і перевірена поведінково: без
  ROM-ID відмовляється і не чіпає жодного байта монітора;
* охоронці в `session_guard_check` (розділ 24), звірені «від протилежного».

---

## 3.16. Ручне регулювання струму заряду

Побажання власника. Профіль за відсотком — це «як правильно за замовчуванням»,
але бувають випадки, коли струм треба задати руками: перевірка ключа на малому
струмі, щадний режим для пакета з підозрілими банками, однаковий струм для
порівняння двох пакетів між собою.

`0` — автомат, як було. Будь-яке інше значення — уставка користувача.

### Три рішення, які тут важать

**Дозаряд ручний режим НЕ скасовує.** Це головне. Дозаряд малим струмом від
`CHARGE_TAPER_PCT` — не зручність, а те, що не дає добивати майже повний пакет
великим струмом; через його межу ми нещодавно ловили і брязкіт уставки, і
паніку на світлодіоді (3.12). Тож у зоні дозаряду ручне значення бере участь
**лише якщо воно менше** за автоматичне: зменшити струм користувач має право
завжди, збільшити — не в кінці заряду.

**Стеля ручного режиму дорівнює стелі профілю.** Увесь тепловий розрахунок
силової частини в `settings.h` — розсіювання на ключі, запас шунта, вибір
дроселя — зроблено для `CHARGE_MA_80`. Дозволити руками більше означало б
одним полем у формі обійти всі теплові перевірки файлу. Окремий `#error`
стежить, щоб `CHARGE_MANUAL_MA_MAX` не переріс `CHARGE_MA_80`.

**Уставка живе окремо від стану сеансу.** `chargeStop()` обнуляє `ChargeState`
цілком; ручний струм — не стан сеансу, а налаштування користувача. Поклавши
його в структуру, ми отримали б поле, яке мовчки скидається в автомат на
кожній зупинці.

Врахована вже **на старті**, а не з другого опитування: інакше
`chargeStartDuty()` цілився б у автоматичний струм, і перший прохід ішов би
«сходинкою» — рівно те, задля усунення чого розрахунок стартової точки й
робився.

Доступно з усіх трьох поверхонь: веб (`/api/charge/ma`), USB-клієнт і програма
`.exe` (`CHARGE MA=<мА>`). Межі клієнти беруть **із відповіді пристрою**
(`manMinMa`/`manMaxMa`), а не з власних констант.

---

## 3.17. Клієнт .exe: прокрутка, залиплий зразок і копія сторінки

### Прокрутка у вкладці «Дані»

Скарга власника. Із шести вкладок скрол мали лише «Майстер», «Ремонт»,
«Редактор» і «Журнал». «Дані» й «Огляд» вкладались просто у фрейм вкладки:
поки вікно велике — непомітно, щойно менше за вміст — нижні рядки зникають, і
дістати їх нічим. Про «Огляд» не повідомляли лише тому, що вміст там менший.

Заодно виправлено сам механізм прокрутки. Обробник колеса вішався на полотно
через `<Enter>`/`<Leave>`, але вміст лежить у полотні через `create_window`,
тобто це його **дочірні** віджети — і щойно курсор заходив на них, полотно
отримувало `<Leave>` і колесо знімалось. Тобто прокрутка гасла рівно тоді,
коли курсор над тим, що треба крутити. Тепер обробник висить і на полотні, і
на внутрішньому фреймі.

### Залиплий зразок копії

```python
i = self.cbClSample.current() - 1     # 0 = «свій файл»
if i < 0 or i >= len(subs):
    return                            # ← _cloneHex лишається старим
```

Повернення до «свій файл» не скидало раніше обраний вбудований зразок.
Користувач бачив у списку «свій файл», натискав «Відновити» — і в пакет ішов
зовсім інший монітор. Ані повідомлення, ані сліду в журналі.

### Запис ЛИШЕ монітора

Дві операції, які легко сплутати, тепер стоять поруч і названі різно:

| дія | що робить із DS2433 |
|---|---|
| 🧬 Відновити за зразком копії | **СТИРАЄ** (або пише експериментальну ідентичність) |
| 🔬 Записати лише DS2438 | **не чіпає взагалі** |

Це має пряме відношення до скарги «китайський еталон 2438 після запису не
працює». Повний режим копії — не «запис монітора», а перехід пакета в стан
китайської копії, і DS2433 після нього порожній. Монітор при цьому записано
правильно, а рація пакет не впізнає. Тепер записати сам монітор, не чіпаючи
ідентичність, можна однією кнопкою.

> Чесно про решту цієї скарги: різниці **в коді** між `.exe` і мостом на шляху
> запису DS2438 знайти не вдалось. Команда однакова (`WRITE38 <128 hex>`),
> обидва клієнти ріжуть довгі команди на частини (міст по 200 Б, `.exe` по 96),
> обидва не роблять після запису нічого, крім читання `INFO`. Словник команд
> `.exe` звірено з прошивкою й веб-клієнтом — розбіжностей немає. Тож
> найімовірніше в мосту й у `.exe` виконувались **різні операції**, і кнопка
> вище прибирає саме цю пастку.

### Копія сторінки в SPIFFS

Знайдено попутно й варте окремої згадки. `index.html` лежить у проєкті **двічі**:
як вихідний файл і як `data/index.html`, який заливають у SPIFFS. Пристрій
віддає `/index.html` **із SPIFFS** — тобто працює копія. Правка в кореневому
файлі, не перенесена в `data/`, збирається, проходить усі тести й просто не
доїжджає до користувача.

До цієї сесії копії були побайтово однакові; поле ручного струму заряду мало
не стало першою розбіжністю. Тепер їхню тотожність перевіряє окремий охоронець.

### Перевірено

* усі 10 хостових тестів у конфігураціях PMOS і BJT_PNP;
* логіка ручного струму — розділ 19 `charge_logic_check`: накладання, затиск на
  обох межах, і те, що в дозаряді ручні 800 мА **не** піднімають струм;
* охоронці (розділи 25–27), кожен звірений «від протилежного» — зокрема один
  довелось посилити: перевірка «`chargeApplyManual` є у файлі» лишалась зеленою
  після прибирання виклику з регулятора, бо другий виклик є на старті;
* `pyflakes` по `moto_gui.py` і `moto_bridge.py` — чисто;
* `chargeTask()` вирізано з `web_server.h` і зібрано проти заглушок.

---

## 3.18. Відсоток заряду для 2S: крива замість прямої

Прохання власника — перерахувати показання заряду для 2S-пакета, **не
оглядаючись на початкові граничні значення**, і взяти межі з заводських
параметрів 2S li-ion.

### Що було

```c
p = (mv - 6350) * 100 / (8250 - 6350);
```

Пряма між двома підібраними числами. Для літію це неправильно не «на кілька
відсотків», а принципово: крива напруги спокою — полога сходинка з довгим
плато посередині й крутими краями.

| напруга | В/банку | було (пряма) | стало (крива) | різниця |
|---|---|---|---|---|
| 6.60 В | 3.30 | 13 % | **4 %** | −9 |
| 6.80 В | 3.40 | 23 % | **6 %** | −17 |
| 7.00 В | 3.50 | 34 % | **11 %** | −23 |
| 7.20 В | 3.60 | 44 % | **20 %** | −24 |
| 7.40 В | 3.70 | 55 % | **43 %** | −12 |
| 8.00 В | 4.00 | 86 % | **80 %** | −6 |
| 8.20 В | 4.10 | 97 % | **90 %** | −7 |

Помилка була найбільша саме там, де вона найдорожча: пристрій показував
«третину заряду» на пакеті, якому лишалось близько восьми відсотків. Причина
проста — 7.20…7.36 В це цілих 20 % заряду на 160 мВ, а пряма розтягувала ці
160 мВ на вісім відсотків.

### Що стало

Таблична крива напруги спокою **на банку** (`soc.h`), межі — з паспорта:

* **0 %** = 3.00 В/банку = **6.00 В** на пакеті (нижче працює захист пакета);
* **100 %** = 4.20 В/банку = **8.40 В** на пакеті.

Крива зберігається побанково й множиться на `SOC_CELLS`, тож та сама таблиця
годиться і для 3S. Межі — окремі літерали, а не `SOC_CURVE[0].cellMv`: їх
читає ще й препроцесор, а він не вміє індексувати масив. Розійтися з таблицею
їм не дає `static_assert`.

### Наслідок, про який треба сказати прямо

Заряд до 8.20 В — це 4.10 В на банку, а це за кривою **рівно 90 %**. Тобто
після «повного» заряду шкала показуватиме 90 %, і це не недозаряд, а чесне
число: зупинка на 4.10 В свідомо недобирає останню десяту частину заради
ресурсу банок. Раніше та сама зупинка показувала 97 % — тільки тому, що шкала
була лінійна, а верх у неї стояв на 8.25 В.

Щоб бачити 100 %, треба міняти не шкалу, а ціль: підняти `CHARGE_TARGET_MV`
до 8400 мВ.

### Що ще довелося поправити

**Дозаряд ледь не зник.** Ціль у відсотках вибирає користувач, а напруга цілі
затискається до `CHARGE_TARGET_MV`. Поки шкала була лінійна, 100 % і збігались
із 8.2 В. З правильною кривою 100 % — це 8.4 В, і якби `targetPct` лишався
100, поріг дозаряду (90 % від цілі) припав би рівно на кінець заряду:
дозарядна ділянка виродилась би в нуль, а пакет добивався б повним струмом до
самого кінця. Тепер `chargeStart()` **перераховує** `targetPct` із затиснутої
напруги, і всі точки перегину профілю стискаються під досяжну ціль. Ділянка
дозаряду вийшла 180 мВ (8.02…8.20 В).

**Друга копія шкали.** Екран мав власну лінійну формулу просто в
`batteryPercent()`. Поки обидві були прямими, вони випадково збігались; після
переходу на криву екран показував би зовсім інше число, ніж веб і USB-клієнт.
Копію прибрано, лишилась одна функція на всі поверхні.

**Верх розрядної лінійки** (`DISCHARGE_RAMP_HI_MV`) стояв окремим числом 8250
і після зміни шкали розійшовся б із нею мовчки — тепер це `SOC_FULL_MV`.
Запасні значення тієї ж лінійки у трьох клієнтах теж підтягнуто.

**Порядок підключення.** `soc.h` включається найпершим рядком `settings.h`:
на його константи спираються `#if`-перевірки, а невідомий ідентифікатор
препроцесор мовчки вважає нулем. Перевірено від протилежного — перенесення
включення нижче валить збірку на `DISCHARGE_RAMP_HI_MV`.

### Про що варто пам'ятати

OCV — це напруга **спокою**. Під навантаженням вона просідає, під зарядом
завищена, тож відсоток за напругою правдивий лише на відпочилому пакеті. Саме
тому і заряд, і розряд міряють напругу на закритому ключі з витримкою, а там,
де є справний лічильник ICA всередині пакета, показ береться з нього.

І окремо: на плато (7.20…7.60 В) кілька мілівольт шуму АЦП — це кілька
відсотків показу. Це властивість самої хімії, а не дефект; згладжує її саме
ICA.

### Перевірено

* новий `soc_curve_check`: паспортні межі, монотонність кривої **й самої
  функції** на всьому діапазоні з кроком 5 мВ, точність у всіх 21 вузлах,
  оборотність «% → В → %» без похибки, і числова таблиця «пряма проти кривої»;
* окремо перевірено, що дозаряд не виродився, паливомір у мА·год лишився
  лінійним за ємністю, а ціль розряду 7.20 В — це рівно 20 %;
* охоронці розділу 28 у `session_guard_check`, кожен звірений «від
  протилежного» — включно з поверненням старих меж, зламом монотонності,
  поверненням лінійної формули й перенесенням `#include` нижче за перевірки.

---

## 3.19. Синхронізація дзеркала DS2438 → DS2433 з правкою перед записом

Прохання власника: «є дані з 2438, які дублюються в 2433. Потрібна функція
синхронізації цих даних з 2438, а також правка даних перед синхронізацією.
Часткова правка вже реалізована в проєкті».

### Що дублюється

Рівно **26 байтів**: `DS2433[0x01–0x1A]` ≡ `DS2438[0x18–0x31]`. Це ідентичність
пакета — те, за чим рація й станція його впізнають. Копія в моніторі не
випадкова: завдяки їй пакет зі стертим DS2433 ще можна відновити, і саме це
робить станція WPLN4226A, переписуючи ці байти назад.

### Чому наявної синхронізації не вистачало

Вона в проєкті була (`impresSyncMirror`, «добудова заголовка»), але **сліпа**:
копіює всі 26 байтів і виправляє суму. Це правильно рівно в одному випадку —
коли монітор точно свій. А він буває чужий, і тоді сліпе копіювання не лікує,
а **закріплює чужу ідентичність**.

### Що зроблено

`mirror_plan.h` — план, а не дія:

* побайтова різниця «що зараз / що прийде / що буде записано»;
* галочка на кожен байт — зняти те, що треба лишити старим;
* окремо розібране поле, яке ми вміємо назвати, — **паспортна ємність**
  (`DS2433[0x008]`), з ручним введенням, округленням до кроку 25 мА·год і
  затиском у 1000…6000;
* типово переносяться **лише РІЗНІ** байти й лише з придатного джерела.
  Однакові не переписуються: це зайвий цикл запису EEPROM без користі;
* ручне значення ємності **сильніше** за монітор — його вписують саме тоді,
  коли монітору не довіряють (після заміни банок);
* сума заголовка виправляється **завжди**, навіть коли жоден байт не змінився:
  заради неї операцію часто й запускають після станції.

Доступно з усіх трьох поверхонь: `/api/mirror`, `/api/mirror/edit`,
`/api/mirror/apply` і команда `MIRROR [APPLY|TAKE=|BYTE=|RATED=]` по USB.

### Попутно прибрані дві копії

**Зсуви дзеркала.** «1 +» і «24 +» стояли літералами щонайменше в п'яти
місцях. Тепер це `IMPRES_MIRROR_D33_AT` / `IMPRES_MIRROR_D38_AT` /
`IMPRES_MIRROR_LEN`.

**Назва силового ключа.** Усі три клієнти тримали рядок «PNP B772M» у себе — і
після заміни на P-MOSFET дружно почали підписувати чуже залізо. Тепер назву
повідомляє пристрій (`swName` з `CHARGE_SW_NAME`), а клієнти її лише показують.

### Липка шапка

Прохання: «при скролінгу меню верхня шапка залишається зверху фіксовано для
швидкого переходу по закладках». Сторінки тут довгі — у «Ремонті» півтора
десятка карток, — і щоб перейти на сусідню вкладку, доводилось прокручувати
весь екран назад угору.

Смуга вкладок тепер `position:sticky` з непрозорим тлом і `z-index` (без нього
картки з власним тлом проїжджали б поверх). Підвкладки липнуть **під** нею, а
не за нею. У програмі `.exe` смуга вкладок і так поза областю прокрутки — там
нічого міняти не довелось.

### Перевірено

* новий `mirror_plan_check`: логіка плану на синтетиці (зняття байтів, ручна
  ємність, непридатне джерело) і прогін по всьому корпусу `dumps/` — жодному
  цілому пакету не стає гірше, заголовок після операції **завжди** цілий,
  повторна синхронізація нічого не змінює (ідемпотентність);
* охоронці 29–30, кожен звірений «від протилежного»: перенесення однакових
  байтів, скасування пріоритету ручної ємності, прибирання виправлення суми,
  зняття липкості, повернення жорсткої назви заліза й повернення чисел замість
  імен зсувів — усе валить тести.

---

## 3.20. «Sketch too big»: помилка була в нашій інструкції, а не в установці

Повідомлення власника:

```
Sketch uses 1313447 bytes (100%) of program storage space. Maximum is 1310720 bytes.
Sketch too big; text section exceeds available space in board
```

### Що це за число

**1 310 720** — це не «розмір флеша». Це розділ під програму у схемі
**Default 4MB with spiffs**. Тобто справа не в тому, що прошивка роздулась
непристойно, а в тому, що обрано схему розділів, у якій програмі виділено
1.25 МБ із чотирьох мегабайтів. Решта віддана під SPIFFS (1.5 МБ), якого нам
стільки не треба: уся тека `data/` — 670 КБ.

Перевищення при цьому мізерне: **2727 байтів, 0.21 %**.

### Чому це наша помилка

`INSTRUCTION.md` прямо казала:

> | **як зараз** (Bluetooth вимкнено) | за замовчуванням («Default 4MB with spiffs»), прошивка ~80 % флеша |

Це було правдою, коли писалось. Після кривої заряду 2S, ручного струму,
синхронізації дзеркала, переносу тексту й чорного ящика — уже ні. Власник
зробив рівно те, що написано в інструкції, і отримав помилку збірки.

### Виправлено

**Схема — «Huge APP (3MB No OTA/1MB SPIFFS)», завжди.** Той самий скетч у ній
займає **41.8 %** від 3 МБ. Перевірено, що «No OTA» нічого не ламає: оновлення
прошивки по повітрю в проєкті немає взагалі (ні `ArduinoOTA`, ні `Update.h`), а
SPIFFS у 1 МБ вистачає з запасом на 670 КБ теки `data/`.

Виправлено в трьох місцях, бо шукають у різних: `INSTRUCTION.md` (таблиця
схем), `README.md` (швидкий старт — тепер це окремий пункт 2, до компіляції) і
`settings.h` (там схема була подана як потрібна «лише під Bluetooth»).

**І пристрій тепер каже це вголос.** Після прошивки в журнал іде реальний
розмір розділу:

```
Флеш під програму: 1313447 з 3145728 байтів (41%), розділ «app0»
```

а при заповненні від 90 % — попередження з назвою потрібної схеми. Схема
задається в IDE, а не в коді, тож перевірити її на компіляції неможливо; але
мовчати про неї не варто. Наступний, хто впреться в стелю, побачить це
**заздалегідь**, а не у вигляді `text section exceeds available space`.

### Перевірено

* охоронці розділу 31: інструкція називає потрібну схему й **не** обіцяє, що
  типової досить; README теж; `settings.h` більше не подає її як «лише для BT»;
  пристрій друкує розмір розділу й попереджає завчасно;
* усі три звірені «від протилежного» — повернення старої обіцянки в таблицю,
  прибирання звіту й прибирання попередження валять тест;
* блок звіту вирізано зі скетча й **зібрано проти заглушок**: на 3 МБ дає
  «41 %, без попередження», на 1.25 МБ — «100 %, попередження».

> ⚑ Побічний висновок для перевірок. Для цієї перевірки довелось додати
> `fileHasText()`: наявний `fileCalls()` свідомо пропускає рядки, що
> починаються з «//», — і на документації в коментарях був сліпий. Помітили це
> одразу, бо перевірка «від протилежного» червоніла там, де мала зеленіти.

---

## 3.21. Синхронізація: «а цей монітор узагалі від цього пакета?»

Прохання власника — дослівно взяти попередження з картки даних і поставити його
в синхронізацію:

> Напрацювання ETM (6397 діб) більше за вік пакета (15 діб від 2026-08-03). Або
> монітор не від цього АКБ (перечитайте DS2438 — доти струм, залишок і знос
> неправильні), або пакет пройшов цикл на станції: ЗП переписує ETM своїм
> числом. Тому наробіток правлять ПІСЛЯ калібрування, а не до нього.

Прохання точне, і місце для нього обрано правильно. Синхронізація переносить
ідентичність **з монітора** в пам'ять пакета. Якщо монітор чужий, вона не
лікує пакет, а **приписує йому чужу особу** — і робить це «за планом», з
галочками, тобто впевнено. На картці даних це просто спостереження; тут — умова
операції.

### Правило одне на весь проєкт

Порівняння винесено в `impresEtmForeign(etmDays, ageDays)` (`impres_audit.h`) —
там, де вже жив допуск `AUD_ETM_SLACK_D` = 180 діб. Аудит і план тепер питають
**одну** функцію. Допуск потрібен тому, що лічильник стартує ДО того, як у чип
запишуть дату: на 31 рідній парі з `dumps/` перевищення не було більше за 44
доби.

План (`mirror_plan.h`) везе свідчення числами — `etmDays`, `ageDays`,
`haveAge`, `etmForeign`, — а текст лишається в клієнтах: довгі пояснення у
прошивці коштували б флеша, а він щойно закінчився (3.20). У кожному клієнті
формулювання **одне** на два місця (`etmForeignHtml` у браузерах,
`etm_foreign_text()` у `.exe`) — друга копія розійшлася б із першою рівно тоді,
коли людина за нею вирішує.

### Три зауваги з натури, які прийшли слідом

**«Шапка налазить на верхню панель статусу».** У `client_usb.html` шапка вже
була `position:sticky; top:0`, і смуга вкладок стала туди ж. Два елементи з
`top:0` **не діляться місцем**: у кого `z-index` більший, той просто закриває
іншого. Тепер висота шапки — змінна `--hdrH`, вкладки липнуть на `top:var(--hdrH)`,
підвкладки — ще на 54 px нижче, а `z-index` шапки найвищий.

**«Bridge/web — не вибираються пункти плану».** Причина не в клієнтах: галочка
жила лише в рядка, де байти **різні**. А на цілих пакетах дзеркало здебільшого
вже збігається — у корпусі `dumps/` це 46 із 52, — тож у натурі жодна галочка
не натискалась. Типовий вибір лишився звуженим до різних байтів (зайвий запис
EEPROM ні до чого), але коли людина вказує байт **пальцем**, заборона знята.
Єдина умова лишилась: щоб було звідки брати (`srcUsable`).

**«Відсутня синхронізація дати в планувальнику».** Годинника реального часу в
пристрої немає (`device_clock.h`): дату приносить клієнт, і за домовленістю
**кожен запит плану** несе `today=РРРРММДД`. Синхронізація дзеркала була єдиним
планом, який дати не ніс, — і мовчки лишалась без перевірки віку: свідчення
просто не рахувалось, а «попередження немає» читається як «усе гаразд».

Тепер `today=` приймають усі три обробники (`/api/mirror`, `/api/mirror/edit`,
`/api/mirror/apply`) і команда `MIRROR … TODAY=`, а всі три клієнти її шлють.

> ⚑ Дата оновлює **лише свідчення**, а не перебудовує план. Вона приходить уже
> після того, як людина розставила галочки; перебудова тихо скинула б їх —
> достатньо було б настання нової доби, — і записалось би не те, що показано.
> Для цього побудову плану й розрахунок свідчення розведено в дві функції
> (`mirrorPlanRefresh()` / `mirrorPlanEtmRefresh()`).

Коли перевірити вік не вдалося, картка каже це **окремим рядком**, а не замість
іншого пояснення: «нема чого переносити» й «не змогли перевірити монітор» —
різні речі, і жодна не скасовує другу.

### Перевірено

* `mirror_plan_check` секції 7–8: свідчення на числах зі скарги (6397 проти
  15), мовчання без дати, збіг із аудитом на сітці 25×13 пар «вік × наробіток»
  (а не на числі 180 — власна копія правила розійшлася б саме на межі), поява
  дати не скидає розставлених галочок, однаковий байт відмічається вручну й
  **не** відмічається без придатного джерела;
* охоронець 32 — 16 перевірок: одне правило, одне формулювання на клієнта,
  дата в усіх трьох обробниках і в усіх трьох клієнтах, галочки, липка шапка;
* усе звірено **від протилежного**: 20 навмисних поломок, кожна валить саме
  «свою» перевірку. Дві перевірки довелось на цьому підсилити — `fileCalls()`
  по імені лишався зеленим, коли ім'я є ще й у коментарі поруч із `#include`,
  а «дату приймає обробник» мовчав, коли її прибрали лише з показу плану
  (додано `fileCountText()` — рахує копії, а не наявність);
* один тест виявився **порожнім**: перед приходом дати в ньому не стояло жодної
  галочки, тож «нічого не скинулось» виходило саме по собі. Фікстуру
  виправлено — тепер поломка ловиться;
* розбір `TODAY=` у `MIRROR` прогнано окремою хостовою чернеткою на всіх формах
  команди (`APPLY`, `TAKE=`, `BYTE=… ON=…`, `RATED=`, дата спереду й ззаду,
  без дати, `TODAY=0`); у репозиторій вона не внесена навмисно — це була б
  друга копія розбору, а `serial_api.h` на хості не збирається.

---

## 3.22. Розходяться не байти, а ЧИСЛА — і винен був запис у монітор

Скарга власника: «дані розходяться, потрібна можливість синхронізувати і ці
розбіжності — саме через них синхронізація й задумувалась». Далі, після спроби
полагодити: «скинув наробіток, поставив у зарядку, і вона знову прописала дату
й лічильники. Може, ми не туди пишемо і не звідти читаємо?»

Питання виявилось точним, і відповідь на нього — головне в цьому розділі.

### Що показали дампи

Власник надіслав той самий пакет (PMNN4409B) двічі: до зарядної станції й
після. Розбір **нашим же кодом** (`impres_bms.h` + ROM-ID з чипа, ключ не
підбирався):

| | до станції | після станції |
|---|---|---|
| дата виготовлення | 2026-08-03 | **2025-11-04** |
| перше користування | 2026-08-18 | **2026-04-29** |
| цикли IMPRES | 1 | **31** |
| наробіток ETM | 6397 діб | 6397 діб (цокає далі) |
| CCA / DCA | 195 / 238 | **195 / 238 — байт-у-байт ті самі** |

Три висновки, кожен перевірений:

1. **Байтове дзеркало в цьому пакеті збігалося ПОВНІСТЮ.** Тобто синхронізація
   в старому вигляді сказала б «усе гаразд» і не полагодила нічого. Розходились
   не байти ідентичності, а числа.

2. **Станція не чіпає DS2438 узагалі** — CCA і DCA байт-у-байт ті самі. Зате
   лічильник циклів у DS2433 вона переписала числом **31**, а CCA=195 при
   ємності 2150 мА·год і шунті 45.65 мОм дає рівно **31** еквівалентний цикл.
   Тобто станція вважає монітор першоджерелом і відновлює лічильники пакета
   з нього. Правити самий лише DS2433 — марна праця.

3. **Наш запис у монітор до чипа не доїжджав.** ETM лишився 6397 діб і рівно
   цокав далі, лічильники не змінились. Причина — в даташиті DS2438: ICA, CCA
   і DCA це не пам'ять, а **регістри накопичувача заряду**; поки в статусі
   стоїть біт IAD, чіп оновлює їх сам приблизно кожні 27 мс і затирає щойно
   записане. Ми ж писали сторінку 0 (де цей біт) **першою**, з увімкненим
   IAD, а сторінку 7 (CCA/DCA) не звіряв ніхто — тож збій був **невидимий**.

### Чи правильно ми читаємо

Перевірено окремо, бо це половина питання власника:

* ключ береться з ROM-ID чипа (не підбирається), суми блоків сходяться, а
  дата, яку записала **станція**, розшифровується в осмислене 2025-11-04 —
  випадковий зсув давав би сміття, а не правдоподібну дату;
* у `dumps/` є пакети з записаним показом **рації**. На здорових пакетах
  (`03-do-kalibruvannya`) наша дата першого користування збігається з тим, що
  показала рація, з точністю до доби;
* а перебір **усіх 16** можливих обертань блока дат показав: жодне з них не
  дає дати рації для пакетів із роздутим ETM. Тобто рація бере не збережену
  дату, а рахує «сьогодні − ETM» — саме те, що записано в `impres_format.h`.
  Звідси й уся плутанина: **поки ETM бреше, рація показує чужий вік і чужий
  знос, хоч у пам'яті пакета дати правильні**.

### Що зроблено

**Запис у DS2438** (`battery_reader.cpp`):

* на час запису знімаються біти IAD і CA, а сторінка 0 (конфігурація)
  пишеться **останньою** — щоб вимір струму повертався вже після того, як
  лічильники лягли;
* додано звірку сторінки 7 (CCA/DCA) — раніше її не робив ніхто;
* додано звірку, що конфігурація **повернулась**: інакше монітор лишився б із
  вимкненим вимірюванням, а це мертвий паливомір до наступного запису;
* усе це перевіряє новий хостовий тест `ds2438_write_check` на моделі чипа з
  «живими» регістрами — зокрема сценарій від протилежного: та сама
  послідовність без зняття IAD лишає в чипі **старі** числа, як у дампі.

**Значеннєвий бік плану синхронізації** (`mirror_plan.h`) — три рядки, кожен
із власною галочкою й полем правки:

| рядок | пакет (DS2433) | монітор (DS2438) |
|---|---|---|
| наробіток ETM | від дати першого вмикання до сьогодні | лічильник секунд |
| заряджено (CCA) | цикли IMPRES + не-IMPRES | накопичені мА·год ÷ ємність |
| розряджено (DCA) | ті самі цикли (окремого лічильника пакет не веде) | накопичені мА·год ÷ ємність |

Напрямок тут **зворотний** до байтового: ідентичність беремо з монітора, а
лічильники — з пакета, бо саме монітор станція вважає першоджерелом. Типово
обрані лише ті рядки, що справді розходяться; для наробітку — з допуском в
одну добу (пакетна сторона рахується цілими добами, а лічильник іде
безперервно). Цикли перераховуються в сирі одиниці шунтом **із чипа**: якщо
шунта в чипі немає, рядки циклів не пропонуються взагалі — з чужим шунтом
число було б вигадкою.

### Порядок ремонту, який із цього випливає

1. спершу **монітор**: наробіток і лічильники заряду/розряду;
2. потім **DS2433**: дати, знос, лічильники циклів;
3. і аж тоді станція — вона перерахує пакет із монітора, а монітор уже каже правду.

### Перевірено

* `mirror_plan_check` секції 9–11: числа з дампа власника (ETM 6397 → 0,
  CCA 31 → 6, DCA 37 → 6 при raw 38/38), повторний прохід нічого не змінює,
  недоступність рядків без шунта/монітора/дати, затиски ручних чисел і
  **стійкість перерахунку циклів** на всіх 50 парах «ємність × шунт» із
  `dumps/` (20 050 перевірок «цикли → сирі → цикли»);
* `ds2438_write_check` — див. вище;
* охоронці 33–34, звірені від протилежного 12 навмисними поломками;
* усі 13 хостових тестів зелені в обох конфігураціях силового ключа.

---

## 3.23. «invalid UTF-8»: збірка пройшла, а IDE показала помилку

Повідомлення власника:

```
Sketch uses 1277479 bytes (40%) of program storage space. Maximum is 3145728 bytes.
Global variables use 53100 bytes (16%) of dynamic memory…
grpc: error while marshaling: string field contains invalid UTF-8
Compilation error: grpc: error while marshaling: string field contains invalid UTF-8
```

### Що це насправді

Прошивка **зібралась** — звіт про розмір друкується лише після успішної збірки,
і 40 % замість 100 % показують, що схема розділів тепер правильна (див. 3.20).
Впало вже наступне: Arduino IDE 2.x спілкується з `arduino-cli` по gRPC, і
**кожен рядок** у відповіді — шлях, ім'я файла, текст діагностики, метадані
бібліотек — мусить бути коректним UTF-8. Один некоректний байт — і готовий
результат не доїжджає до IDE, а користувач бачить «Compilation error».

Тобто це не помилка нашого коду. Але частину пасток ми таки тримали в себе.

### Що виправлено у нас

Три файли в папці скетча звалися кирилицею:

| було | стало |
|---|---|
| `ЗМІНИ.md` | `CHANGES.md` |
| `СХЕМА.html` | `SCHEMATIC.html` |
| `Емблема_НГУ_т.svg` | `ngu-emblem.svg` |

На Windows такі імена доходять до інструментів у системному кодуванні
(CP1251), а не в UTF-8 — тобто папка скетча з ними готова зламати саме те
місце, де впав власник. Зміст документів лишився українським, змінились лише
імена; усі посилання в `README.md`, `INSTRUCTION.md` і `settings.h` оновлені.

Перевірено, що інших пасток у нас немає: **жодного** файла з не-ASCII іменем,
**жодного** текстового файла з некоректним UTF-8, ні BOM, ні CRLF.

### Що перевірити на своєму боці

Якщо помилка лишиться, її джерело — поза нашою папкою. Найчастіші два:

1. **Кирилиця у шляху** до скетча або до даних Arduino
   (`C:\Users\Роман\…`). Перевірка: перекласти папку в `C:\moto\` і зібрати.
2. **Метадані встановленої бібліотеки** не в UTF-8 — `library.properties` з
   іменем автора в Latin-1 трапляється часто, і `arduino-cli` кладе ці байти
   в рядкове поле відповіді як є. Знайти винуватця (PowerShell):

```powershell
$enc = New-Object System.Text.UTF8Encoding($false, $true)
foreach ($r in @("$env:LOCALAPPDATA\Arduino15", "$env:USERPROFILE\Documents\Arduino")) {
  if (-not (Test-Path $r)) { continue }
  Get-ChildItem -LiteralPath $r -Recurse -File -Include *.properties,*.txt,*.json -EA SilentlyContinue |
    ForEach-Object { $f = $_.FullName
      try { [void]$enc.GetString([IO.File]::ReadAllBytes($f)) } catch { "НЕ UTF-8: $f" } }
}
```

Знайдений файл досить перезберегти в UTF-8 (Блокнот → «Зберегти як» →
кодування UTF-8).

### Перевірено

* охоронець 35 обходить усю папку скетча: жодного не-ASCII імені, кожен
  текстовий файл — коректний UTF-8, посилання ведуть на нові імена;
* звірено від протилежного: повернення кириличного імені й дописування
  CP1251-байтів у `README.md` валять перевірку кожне своє.

---

## 3.24. Чому наробіток повертався: мітки подій у моніторі

Скарга власника: «виставляю дату, ставлю в зарядку — і вона прописує наробіток
17 років». І окремо: «немає синхронізації з кількістю по циклах зарядки IMPRES
і не-IMPRES».

### Знайдено причину, і доказ лежав у нашому ж корпусі

Сторінка 2 монітора (`DS2438[0x10..0x17]`) — це **два 32-бітні числа в
одиницях наробітку**: «коли востаннє щось сталося». На 51 дампі корпусу з
ненульовим ETM обидва лежать **не вище** за ETM, а перше — у межах секунд від
нього. Ми ж роками зануляли ETM, **не чіпаючи міток**, і лишали монітор у
неможливому стані: «подія сталася в майбутньому».

Зарядна станція такий стан лікує очевидним чином — підтягує наробіток до
мітки. Це видно побайтово:

| `dumps/13-dozaryadka-na-stantsii` | ETM | мітка 2 |
|---|---|---|
| `01_2438.bin` — після нашого скидання | 234 с | 79 773 064 |
| `02_2438.bin` — після станції | **79 773 372** | 79 773 368 |

Тобто станція взяла число не «зі стелі» й не зі своєї пам'яті: воно лежало в
самому моніторі, у полі, якого ми не бачили. Той самий слід є і в
`dumps/08-nova-batareya/01`: ETM = 0 при мітках 384 523 795 і 379 637 468 — і
саме цей пакет рація відкинула як «невідомий».

### Що зроблено

Наробіток тепер пишеться **одним способом на весь проєкт** —
`impresSetEtm(d38, sec)`, — і разом із ним підтягуються обидві мітки: та, що
опинилась попереду наробітку, стає рівною йому; та, що в минулому, лишається
як є. Через нього тепер ідуть усі чотири шляхи, які раніше писали ETM
байтами: скидання лічильників, режим копії, майстер відновлення й план
синхронізації.

### Лічильники циклів пакета — теж рядки плану

Раніше значеннєвий бік плану (3.22) писав лише в монітор. Тепер у ньому п'ять
рядків, і кожен знає, у який чип іде:

| рядок | «зараз» | «звідки брати» | пише |
|---|---|---|---|
| наробіток ETM | DS2438 | дата в DS2433 | DS2438 |
| заряджено (CCA) | DS2438 | цикли пакета | DS2438 |
| розряджено (DCA) | DS2438 | цикли пакета | DS2438 |
| **цикли IMPRES** | DS2433 | еквівалентні цикли монітора | **DS2433** |
| **цикли не-IMPRES** | DS2433 | лише вручну | **DS2433** |

Для циклів IMPRES джерелом свідомо обрано монітор: станція однаково перерахує
цей лічильник із накопиченого заряду (доведено в 3.22), тож саме його число і
є ціллю. У не-IMPRES відповідника в моніторі немає взагалі — рядок працює
лише від руки, і сам собою не вмикається. Клієнти показують колонку «Куди»,
щоб не доводилось пам'ятати, який рядок у який чип пише.

### Перевірено

* `mirror_plan_check` секції 12–13: числа з `dumps/13` (мітка 79 773 064 при
  ETM 234 с), обнулення разом із мітками, підтягування лише тих міток, що
  попереду; на корпусі — мітки не вище за наробіток у 47 із 51 монітора;
  рядки циклів пакета не плутаються з рядками монітора й не губляться;
* охоронець 36, звірений від протилежного 10 навмисними поломками — зокрема
  поверненням запису ETM «байтами повз мітки» в кожен із трьох шляхів;
* усі 13 хостових тестів зелені в обох конфігураціях силового ключа.

---

## 3.25. Зависання при відкритті веб-інтерфейсу: сторінка на чверть мегабайта

Скарга власника: «зависання при підключенні до точки доступу зі спробою
відкрити внутрішній веб-інтерфейс».

### Що вимірялось

`index.html` виріс до **266 105 байтів**, і віддавався він одним викликом
`server.streamFile()`. Це блокуючий виклик: поки сторінка йде по радіо,
головний цикл **стоїть цілком** — екран не оновлюється, кнопки не
опитуються, заряд і розряд не рухаються.

Три обставини складаються в те, що видно як зависання:

1. **Сторінку відкриває не лише людина.** У пристрою є captive-portal: DNS
   відповідає своєю адресою на будь-який домен, а невідомі URL отримують
   302 на головну. Телефон, під'єднавшись до точки доступу, САМ показує
   «вхід у мережу» — тобто вантажить ті самі 266 КБ одразу після підключення.
2. **Під час заряду ввімкнений Task WDT** із порогом `CHARGE_WDT_SEC` = 10 с
   (`wdt.h`). Годує його `chargeTask()` із головного циклу — того самого,
   який на час передачі стоїть. Достатньо повільного каналу, і сторож
   скидає пристрій **посеред заряду**.
3. У `data/` лежав ще й **`logo.png` на 431 КБ**, якого жодна сторінка не
   просить: у вебі логотип вбудований як SVG. На розділі SPIFFS у 1 МБ
   (схема «Huge APP», див. 3.20) це майже половина місця даремно.

### Що зроблено

**Сторінка стиснута gzip: 266 105 → 89 050 байтів (утричі).** Пристрій віддає
`/index.html.gz` із заголовком `Content-Encoding: gzip`; розпаковування
вбудоване в HTTP, тож для браузера нічого не змінилось. Нестиснута копія зі
SPIFFS прибрана — лишився лише запасний шлях у коді, якщо хтось залив свою.

**Передача йде шматками по кілобайту**, і між ними головний цикл віддає квант
іншим задачам і **годує сторожа** (`wdtFeed()` діє лише коли сторож
увімкнений, тобто під час заряду/розряду). Швидкість від цього не падає:
вузьке місце — радіо, а не пам'ять.

**`logo.png` прибрано з `data/`.** Разом зі стисненням тека даних схудла з
697 КБ до 89 КБ — на розділі в 1 МБ це різниця між «майже повно» і «вільно».

### Як тепер звіряються дві копії сторінки

Раніше охоронець вимагав `index.html` і `data/index.html` побайтово
однаковими. Тепер у SPIFFS лежить архів — і звірити його з оригіналом можна
**не розпаковуючи**: у хвості gzip записані довжина вихідних даних і їхня
CRC32. Обидва числа мусять збігтися з `index.html`. Це точна перевірка, а не
«схоже за розміром», і вона замінила собою перелік окремих ознак, який
доводилось дублювати для копії.

> Після правки `index.html` архів треба перезібрати:
> `gzip -9 -n -c index.html > data/index.html.gz`
> (охоронець 27 не пропустить забуте — і сам друкує цю команду).

### ⚠️ Помилка, якої я тут припустився, і чого вона навчила

Першу редакцію цієї правки я зробив «розумно»: замість `server.streamFile()`
написав свій цикл, який шле файл шматками й між ними годує сторожа. Виглядало
акуратно, зібралось, усі перевірки були зелені — а на пристрої вийшов **білий
екран**.

Причина не видно з боку виклику. `_streamFileCore()` в ядрі ESP32 наприкінці
**розбирає за собою стан**:

```cpp
setContentLength(fileSize);
… send(code, contentType, "");
setContentLength(CONTENT_LENGTH_NOT_SET);   // ← ось цього я не зробив
```

Мій цикл виставляв `_contentLength` і не повертав його. Тому після першої ж
відданої сторінки **кожна наступна відповідь** — усі `/api/*` — ішла із
заголовком `Content-Length` від сторінки. Браузер слухняно чекав на дані,
яких не буде: сторінка приходила, але жоден запит даних не завершувався, і
вона лишалась порожньою.

Тому тепер сторінку віддає штатний `streamFile()`. Він же сам додає
`Content-Encoding: gzip` за розширенням `.gz` — і ставити цей заголовок
вручну НЕ МОЖНА: два однакові браузер прочитає як подвійне стиснення.
Годування сторожа лишилось до й після передачі; після стиснення вона триває
частку секунди, тобто заради чого городився цикл — уже не потрібно.

Охоронець тепер вимагає саме `streamFile()` і **забороняє** ручний
`setContentLength()` у цьому файлі: якщо колись знадобиться свій цикл, це буде
свідоме рішення, а не випадковість.

### Щоб таке було видно одразу

* `GET /api/fs` — що насправді лежить у SPIFFS (імена, розміри, зайнято/всього);
* при старті пристрій друкує той самий список у Serial, а якщо сторінки немає
  зовсім — прямо каже «залийте теку data/».

Порожній екран у браузері не пояснює нічого; ці два додатки перетворюють
«не працює» на «не залито».

### І ще один білий екран — уже не через код

Після виправлення сторінка все одно не відкрилась, зате новий `/api/fs`
відповів одразу й вичерпно:

```json
{"total":836081,"used":0,"files":[]}
```

**Файлової системи з даними в пристрої не було зовсім.** Тека `data/` туди
ніколи не доїжджала, і зрозуміло чому: заливають її окремим кроком
*Tools → ESP32 Sketch Data Upload*, а в Arduino IDE 2.x такого пункту **немає**
(власник саме на ній — це видно зі скарги про gRPC у 3.23). Додатково зміна
схеми розділів на «Huge APP» (3.20) зсунула розділ SPIFFS: старий образ став
немонтовним, і `SPIFFS.begin(true)` мовчки відформатував його.

Тобто окремий крок «залити сторінку» був конструктивною слабкістю: він
обов'язковий, його легко пропустити, і його провал ніяк не видно.

### Сторінка тепер вшита в прошивку

`page_index.h` — та сама сторінка, стиснута gzip (266 105 → 90 795 Б),
генерується з `index.html` командою `python3 tools/mk_page_header.py`.
Пристрій віддає її через `send_P` із заголовком `Content-Encoding: gzip`.

* веб-інтерфейс працює **одразу після прошивки**, без другого кроку й без
  файлової системи;
* на розділі 3 МБ, зайнятому на 40 %, це коштує ~3 % флеша;
* файл `/index.html.gz` у SPIFFS, покладений туди вручну, все ще **перекриває**
  вшиту копію — зручно правити сторінку без перепрошивки. Що саме віддається,
  пристрій каже в Serial при старті.

Охоронець 27 звіряє вшиту копію з `index.html` **за самим масивом**, а не за
рядками в заголовку: у хвості gzip лежать довжина вихідних даних і їхня CRC32,
і обидві мусять збігтися. Перевірка вшита в тест на компіляції, тож забути
перегенерувати не вийде.

### Перевірено

* охоронці 27 і 37, звірені **від протилежного** дев'ятьма поломками:
  зникла вшита сторінка, зник шлях перекриття зі SPIFFS, повернення власного
  циклу замість `streamFile`, продубльований `Content-Encoding`, прибраний
  список SPIFFS, мовчання про джерело сторінки, відстала вшита копія, заглушка
  замість gzip і дубль сторінки в `data/`;
* усі 13 хостових тестів зелені в обох конфігураціях силового ключа.

## 3.26. Куди тепер класти сторінку — і як розрізнити «не працює» від «не прошито»

Питання власника після попередньої правки: «якщо SPIFFS більше не потрібен, то
куди й як закидати index?»

**Нікуди.** Сторінка компілюється всередину прошивки: `tools/mk_page_header.py`
робить із `index.html` файл `page_index.h`, і той збирається разом зі скетчем.
Прошили — сторінка вже в пристрої. Заливати окремо нема чого.

### Чого бракувало, щоб це побачити

Кілька кіл листування пішло на те, що з боку користувача «білий екран» і
«стара прошивка» виглядають ОДНАКОВО. Тому додано три речі, які відповідають
на це без послідовного порту:

* **`/api/fs` тепер віддає відбиток збірки** — дату й час компіляції, які
  підставляє компілятор. Збігтися випадково вони не можуть, тож питання «чи та
  прошивка в пристрої» закривається одним запитом. Поруч — розмір вшитої
  сторінки й ознака, чи перекриває її файл зі SPIFFS.
* **`/lite` — аварійна сторінка на 1.7 КБ.** Основна важить 90 КБ, і коли вона
  не доходить, у браузері порожньо. Півтори кілобайти доходять майже завжди —
  і показують відбиток збірки, стан файлової системи, модель, відсоток і
  оригінальність, а також дають кнопку «зчитати». Тобто це і діагностика, і
  робочий мінімум, поки велика сторінка не їде.
* **`tools/check_page_js.py`** — синтаксична перевірка всього вбудованого
  JavaScript (обидві сторінки й `PAGE_LITE`). Помилка в скрипті дає рівно той
  самий білий екран: розмітка прийшла, а не намальовано нічого. Перевірка
  потребує `node`; якщо його немає, вона чесно каже, що нічого не перевіряла.

### Перевірено

* охоронець 37 доповнено: відбиток збірки, наявність `/lite`;
* звірка від протилежного — одинадцять поломок, кожна валить свою перевірку;
* `check_page_js.py` перевірено від протилежного: зіпсована дужка в `PAGE_LITE`
  ловиться;
* усі 13 хостових тестів зелені в обох конфігураціях силового ключа.

## 3.27. Чому вшита сторінка все одно не доїжджала

Спостереження власника, яке все й вирішило: **`/lite` (1.7 КБ) відкривається,
а основна (90 КБ) — ні.** Тобто прошивка та, сервер живий, малі відповіді
ходять — не доходить саме велика.

### Різниця, якої не видно з боку виклику

У ядрі ESP32 великий буфер і файл ідуть **різними шляхами**:

| виклик | як пише | запас повторів |
|---|---|---|
| `NetworkClient::write(buf, size)` | один цикл `select`/`send` на всю передачу | `WIFI_CLIENT_MAX_WRITE_RETRY` = 10 **на всю передачу** |
| `NetworkClient::write(Stream&)` | ріже на шматки по 1360 Б | повний запас **на кожен шматок** |

`send_P()` бере перший шлях і **не перевіряє, скільки реально пішло**: функція
повертає `totalBytesSent`, а він може бути меншим за розмір. На слабкому каналі
десять поспіль «сокет не готовий» вичерпують запас — браузер отримує обрізане
тіло при чесному `Content-Length`, чекає решти й показує порожню сторінку.

Файли зі SPIFFS завжди йшли другим шляхом (`streamFile` → `write(Stream&)`) —
тому вони й доїжджали роками, а перша ж спроба віддати той самий вміст із
флеша одним викликом провалилась.

### Виправлення

Вшитий масив загорнуто в маленький `Stream` (`PgmPageStream`) і віддається тим
самим `streamFile()`, що й файл. Ім'я потоку — `/index.html.gz`, тож ядро само
додає `Content-Encoding: gzip`; вручну цей заголовок тепер не ставиться ніде.

### Самоперевірка вшитого блока

Генератор кладе в `page_index.h` ще й CRC32 самого стиснутого масиву, а
пристрій рахує його у флеші й показує в `/api/fs` (`gzCrcOk`) та на `/lite`.
Це розділяє два зовсім різні випадки, які зовні однакові: «блок у флеші
побитий» і «блок цілий, але не доїжджає по мережі».

### Перевірено

* охоронці 27 і 37: вшита сторінка йде через `Stream`, а не одним `send_P`;
  заголовок стиснення не дописується вручну; CRC масиву збігається з тим, що
  перевіряє пристрій;
* звірка **від протилежного** — тринадцять поломок, кожна валить свою
  перевірку (зокрема повернення `send_P` на 90 КБ і зіпсований CRC масиву);
* усі 13 хостових тестів зелені в обох конфігураціях силового ключа.

## 3.28. Схема розділів і веб: що з чим пов'язано насправді

Питання власника: «чому не можна використовувати поточний Huge APP 1 МБ для
веба?»

**Можна, і саме так воно тепер і працює.** Схема розділів до сторінки більше
не має стосунку взагалі:

| що | де живе | від схеми залежить? |
|---|---|---|
| веб-сторінка | у прошивці (`page_index.h`), розділ програми 3 МБ | ні |
| дампи, годинник, чорний ящик, заставка | SPIFFS, 1 МБ | так, але це не сторінка |

Зв'язок був лише історичний: доки сторінка лежала у SPIFFS, зміна схеми
зробила старий образ немонтовним, і він відформатувався (звідси `used: 0`).
Тому «Huge APP зламав веб» — правда про причину, але не про наслідок: лікувати
треба було не схему, а залежність сторінки від файлової системи. Її й
прибрано.

## 3.29. Дослід замість здогадів: що саме не доїжджає

Після всіх виправлень екран лишався білим, і стало зрозуміло, що вгадувати далі
марно. Тому пристрій навчено перевіряти себе сам.

**`/lite` отримала дві кнопки:**

* **«Перевірити основну»** — робить `fetch('/')` і показує три числа: що обіцяв
  заголовок `content-length`, скільки байтів **реально дійшло** і яке
  кодування. Обрив на передачі, зламане стиснення й цілком успішна доставка
  виглядають тут по-різному й не сплутуються.
* **«Перевірити великий обсяг»** — `/bigtest`: рівно такий самий за розміром
  потік звичайного тексту **без стиснення**, згенерований на льоту (нуль байтів
  у флеші). Це і є дослід, який розділяє дві змінні, що досі йшли разом:

  | результат | висновок |
  |---|---|
  | `/bigtest` проходить, `/` — ні | винне **стиснення** |
  | не проходить і `/bigtest` | винен **розмір** передачі |
  | проходять обидва | доставка ціла, дивитись треба на сторінку в браузері |

**Плюс одна дірка, знайдена по дорозі:** порожній (нульового розміру) файл у
SPIFFS перекривав вшиту сторінку — той самий білий екран, лише з іншого боку.
Тепер перекриття вимагає ненульового розміру.

### Перевірено

* охоронець 37: наявність `/bigtest`, уміння `/lite` провести дослід, заборона
  перекриття порожнім файлом;
* звірка **від протилежного** — шістнадцять поломок, кожна валить свою
  перевірку;
* окремо доведено, що масив у `page_index.h` **справді розпаковується** рівно в
  поточний `index.html` (не лише збігається за CRC у хвості);
* усі 13 хостових тестів зелені в обох конфігураціях силового ключа.

## 3.30. Примусове пробудження пакета, який не читається після заміни елементів

**Побажання власника:** «додай функцію примусової, безпечної зарядки для
випадків, коли акумулятор не читається після заміни елементів і потрібен
примусовий старт заряду для запуску контролера».

### Замкнене коло, яке треба було розірвати

Після заміни банок пристрій часто не бачить ні DS2438, ні DS2433 — ніби пакета
немає. Пам'ять при цьому ціла: заблокований **контролер захисту всередині
пакета**. Глибокий розряд перед заміною або звичайне знеструмлення на час
паяння лишають його в стані, з якого він виходить лише за однією ознакою —
коли на клемах з'явиться зовнішня зарядна напруга. Поки він мовчить, він тримає
клеми розімкненими, а обидва чипи живляться саме звідти.

Звідси коло: **щоб зарядити — треба прочитати** (без DS2438 немає температури, а
заряд наосліп заборонено), **щоб прочитати — треба подати напругу**. Штатний
`chargeStart()` упирався саме в це:

```cpp
if (!dischargeSample(&dummyMv, &ma, &t)) {
    chargeOff();
    return "DS2438 не читається — заряд наосліп заборонено ...";
}
```

### Головне рішення: це джерело НАПРУГИ, а не струму

Перше, що спадає на думку, — «дозволити заряд без температури, тільки малим
струмом». Це було б помилкою, і ось чому.

Штатний заряд тримає **струм**, бо пакет у колі є й він цей струм бере. Тут
пакет із кола вимкнений власним ключем: струму немає й бути не може. Струмовий
регулятор, не бачачи струму, відповідає єдиним доступним йому способом —
піднімає шпаруватість. І підіймає доти, доки не впреться в заводську стелю
`CHARGE_DUTY_MAX` (85 %), тобто виклав би на клеми **≈11.9 В**. Рівно тієї миті,
коли контролер прокинеться й замкне ключ, ці 11.9 В опинилися б на банках 2S.

Тому режим регулює **напругу** — через стелю шпаруватості:

```cpp
static uint16_t g_chgDutyCap = CHARGE_DUTY_MAX;
inline void chargeSetDuty(uint16_t duty) {
    if (duty > g_chgDutyCap)    duty = g_chgDutyCap;   // стеля СЕАНСУ
    if (duty > CHARGE_DUTY_MAX) duty = CHARGE_DUTY_MAX; // заводська межа ключа
    if (g_chgPwmOk) ledcWrite(CHARGE_PWM_PIN, duty);
}
```

Затиск живе в найнижчій точці — тож діє на будь-який шлях, включно з прямим
викликом повз регулятор. Це **єдиний запобіжник, який працює навіть коли вимір
струму бреше**: обрив шунта читається як «струму немає», і струмовий контур на
це відповів би підняттям шпаруватості.

Стеля рахується з ВИМІРЯНОГО живлення й перераховується щопроходу — блок
живлення просідає під струмом і плаває від екземпляра до екземпляра:

```cpp
inline uint16_t chargeWakeDutyCapFor(uint16_t supplyMv) {
    uint32_t d = (uint32_t)CHARGE_WAKE_MV * CHARGE_DUTY_FULL / supplyMv;
    return (uint16_t)(d > CHARGE_DUTY_MAX ? CHARGE_DUTY_MAX : d);
}
```

Перевірено на всьому діапазоні допуску (12.5…16 В): розрахункова напруга на
клемі — 7994…7999 мВ, тобто ніде не вище `CHARGE_WAKE_MV` і ніде не занижена
більш ніж на один відлік ШІМ.

### Чому напругу не міряють, а рахують

Після дроселя в цій схемі немає ні навантаження, ні згладжувальної ємності —
її роль грає сам пакет. Вимкнений пакет = розімкнене коло = на подільнику дзвін,
а не напруга. Тому напругу задають наперед стелею, а **міряють** лише на
закритому ключі — раз на `CHARGE_WAKE_PROBE_S`, разом зі спробою докликатись
монітора. Робити це щокроку означало б рубати ту саму напругу, заради якої
режим і існує.

### На чому тримається дозвіл працювати без датчика температури

Не на обережності, а на **енергії**. Режим фізично не здатен віддати більше за
`CHARGE_WAKE_MAH_MAX` (8 мА·год — 0.32 % ємності пакета) і живе не довше за
`CHARGE_WAKE_MAX_S` (120 с). Це менше, ніж пакет втрачає на власний саморозряд
за годину. Заберіть будь-яку межу — обґрунтування зникне разом із нею, тому
кожна перевіряється `#error`-ом, а не «мається на увазі»:

| Перевірка | Що не дасть зробити |
|---|---|
| `CHARGE_WAKE_MV > CHARGE_TARGET_MV` | показати банкам напругу, до якої не доводить навіть повний заряд під наглядом температури |
| `CHARGE_WAKE_MV <= BATTERY_EMPTY_MV` | «сигнал зарядника», який не розблокує жоден контролер |
| `CHARGE_WAKE_MA > CHARGE_MA_START` | віддавати більше за найобережніший режим із контролем |
| `CHARGE_WAKE_MA < 2 × CHARGE_DEADBAND_MA` | уставку, якої регулятор не розрізнить |
| `CHARGE_WAKE_MA_ABORT <= CHARGE_WAKE_MA` | відсічку, що спрацьовує на штатному режимі |
| `CHARGE_WAKE_MA_ABORT >= CHARGE_PEAK_MA_MAX` | детектор відмови, який спрацьовує ПІЗНІШЕ за запобіжник заліза |
| `CHARGE_WAKE_MAH_MAX <= штатної віддачі` | режим, що обривається сам на собі, не дійшовши до своєї ж стелі часу |
| `CHARGE_WAKE_MAH_MAX × 100 > BATTERY_RATED_MAH` | віддачу понад 1 % ємності — межу, нижче якої нагрів неможливий у принципі |
| `CHARGE_WAKE_POLL_MS >= CHARGE_POLL_MS` | довгий крок там, де весь ризик — одна мить |
| `CHARGE_WAKE_PROBE_S × 1000 <= CHARGE_WAKE_POLL_MS` | пробу монітора частішу за крок: напруга рубалась би щокроку |
| `CHARGE_WAKE_MAX_S <= CHARGE_WAKE_PROBE_S` | стелю часу, якої не вистачає навіть на одну пробу |

Усі одинадцять звірені **від протилежного**: кожна порушена конфігурація
справді не збирається.

### Найгостріша мить — і як тест знайшов різницю між двома ключами

Ризик режиму зосереджений в **одній миті**: контролер замикає ключ, і на місці
розімкненого кола раптом з'являються розряджені банки. Струм тоді дорівнює
`(CHARGE_WAKE_MV − напруга банок) / опір контуру`, і дросель виводить його на
цей рівень за `L/R ≈ 0.13 мс`, тобто в межах одного кроку.

Тест друкує це число щоразу — і саме він знайшов, що воно **залежить від типу
ключа**:

```
ключ P-MOSFET: найгірший стрибок 2564 мА протягом 25 мс = 0.0178 мА·год;
на шунті 3.3 Вт (паспорт 2.0 Вт) -> 0.082 Дж за крок

ключ PNP BJT:  найгірший стрибок 3333 мА протягом 25 мс = 0.0231 мА·год;
на шунті 5.6 Вт (паспорт 2.0 Вт) -> 0.139 Дж за крок
⚑ стрибок вище відсічки 3000 мА — пробудження зупиниться за піком
```

У польового `RDS(on)` додає до опору контуру 180 мОм і **стримує** струм; у
біполярного цього доданка немає, опір менший, а стрибок більший — і законно
перевищує `CHARGE_PEAK_MA_MAX`.

Спокуса була написати в тесті «відсічка не спрацює» й піти далі. Це була б
неправда для половини конфігурацій. Правда інша: **відсічка спрацює, і це її
робота** — наступний крок закриє ключ. Тобто найгірший сценарій режиму не
«щось згорить», а «пробудження зупинилось із піковою аварією саме тієї миті,
коли пакет ожив». Тому:

* крок скорочено до `CHARGE_WAKE_POLL_MS = 25 мс` — у 40 разів менша експозиція
  для шунта й ключа, ніж дала б штатна секунда;
* до `settings.h` додано `CHARGE_SHUNT_MW` (паспортна потужність шунта): досі
  «потрібен резистор від 2 Вт» жило лише в README, і перевірити його не могло
  ніщо. Тепер тест звіряє імпульс саме з цим числом (правило «одиничний імпульс
  до 5× паспортної потужності, до 100 мс»);
* повідомлення про пікову аварію в пробудженні **називає ймовірнішу причину**:

```
=== Wake ABORT: peak 3333 mA > 3000 mA. Найімовірніше пакет САМЕ ОЖИВ
і замкнув свій ключ — перевірте, чи він тепер читається; якщо ні,
дивіться дросель, ключ і контакти ===
```

### Порядок вироків: успіх іде першим

```cpp
inline uint8_t chargeWakeVerdict(const ChargeWakeIn &in) {
    if (in.chipOk) return WAKEV_WOKE;
    if (in.avgMa > CHARGE_WAKE_MA_ABORT) return WAKEV_OVERI;
    ...
}
```

Будь-який вирок, крім `WAKEV_GO`, однаково гасить ключ, а запобіжник заліза
стоїть окремо й спрацьовує ще до цієї функції. Тобто порядок вирішує лише
**назву** події. Тому «монітор відповів» іде першим: стрибок струму в мить
пробудження — очікувана подія, і поставити відсічку вище означало б із високою
ймовірністю назвати аварією саме те, заради чого режим запускали.

### Насичений відлік тут означає протилежне тому, що у штатному заряді

У штатному заряді клема в стелі АЦП = «коло розімкнулось» = аварія. У
пробудженні розімкнене коло — це **вихідний стан**, з якого режим і починається.
Пропустити насичення в порівняння з порогом означало б обривати пробудження на
першій же пробі, тобто зробити режим непрацездатним рівно в тому випадку, для
якого він написаний:

```cpp
if (in.mvFresh && !chargeSenseSaturated(in.mv) &&
    (uint32_t)in.mv >= (uint32_t)CHARGE_WAKE_MV + CHARGE_HARD_MAX_HEADROOM_MV)
    return WAKEV_OVERV;
```

Пробитий ключ — єдина справжня біда, що теж дає стелю, — ловиться **до старту**:
`chargeWakeRefuse()` бачить і напругу, і струм на закритому ключі, коли через
дросель ще нічого не текло.

### Головна відмова режиму

```cpp
if (chipReads) return WAKENO_READS;
```

Пробудження працює без контролю температури, і **єдине, що не дає перетворити
його на «заряд без датчика», — це відмова запускатись, коли датчик доступний**.
Пакет читається → є температура → є штатний заряд, і жодних підстав обходити
його немає. Щоб цю відмову можна було поставити, `chargeWakeStart()` спершу
**справді пробує прочитати пакет** — інакше умова завжди хибна, і режим тихо
став би обхідним шляхом.

Решта відмов: пробитий ключ (напруга живлення або струм на закритому ключі),
несправне живлення, вже присутня на клемі напруга, зайнятий ключ, невдалий ШІМ.

### Що збережено від штатного заряду

Пікова відсічка, контроль живлення `chargePsuTrip()`, апаратний сторож,
enable-найпершим із паузою `CHARGE_ENABLE_LEAD_MS`, зняття enable після
невдалого старту, заборона одночасності із зарядом і розрядом. Охоронець
перевіряє це **рахунком**, а не наявністю: обидві відсічки мусять зустрічатись
у файлі рівно двічі — по разу на машину. Саме на цьому попалися дві перевірки,
які спершу лишались зеленими після поломки.

### Три поверхні й одна функція показу

Панель заряду в усіх трьох клієнтах перемикається в режим пробудження за
`chargeWakeShown()`. Питання виявилось третім, і воно не збігається з двома
сусідніми:

* `chargeRunning()` — «ключ зайнятий»: правда для обох режимів (розряд, меню й
  читання пам'яті мусять бачити саме це);
* `chargeWaking()` — «пробудження саме йде»;
* `chargeWakeShown()` — «показувати панель пробудження»: підсумок лишається
  видимим після зупинки, але в **спокої** панель повертається до заряду —
  інакше після пробудження запустити звичайний заряд не було б звідки.

Поля, джерелом яких є мовчазний DS2438 (CCA, температура, ICA), у режимі
пробудження **ховаються**: «CCA 0» і «темп. 0.0 °C» — це не дані, а їхня
відсутність. Замість них — проби монітора, межа ШІМ і залишок часу.

### Запуск

| Поверхня | Як |
|---|---|
| веб | вкладка «Заряд», блок «🩺 Пакет не читається після заміни елементів» → `POST /api/charge/wake` (без параметрів) |
| USB | кнопка в клієнті або команда `CHARGE WAKE` |
| пристрій | сторінка «Дії», пункт «Пробудження» (`OP_CHARGE_WAKE`) |

Зупинка — тим самим `CHARGE STOP` / `POST /api/charge/stop`: одна кнопка на
обидва режими, бо друга «зупинити пробудження» лише плодила б стан, у якому
натиснуто не ту.

Скидання під час пробудження чорний ящик записує окремим режимом
(`PM_MODE_WAKE`): саме цей режим працює на пакеті, про який нічого не відомо,
тож саме тут скидання найімовірніше й найцікавіше — записане в заряд, воно
розчинилось би серед сотень штатних рядків шестигодинного сеансу.

### Дві пастки, знайдені вже при розборі готового коду

Обидві — наслідок того, що крок машини у **40 разів** коротший за штатний, і
обидві невидимі на секундному кроці.

**1. Програмний сторож позичав чужий поріг.** `CHARGE_STALL_MS` = 5 с — це
п'ять кроків секундного заряду, тобто рівно те, що написано. Але для кроку
25 мс це **двісті кроків**: ключ мав право стояти без нагляду п'ять секунд.
Якби контролер пакета замкнув ключ саме під час такого зависання, 2.6…3.3 А
текли б усі ці секунди — тобто дрібність кроку, заради якої все й робилось,
скасувалася б разом із наглядом. Додано власний `CHARGE_WAKE_STALL_MS` = 1 с
(один крок штатного заряду — експозиція, яку конструкція й так витримує) із
двома `#error`: не нижче за чотири кроки машини, щоб його не зривала власна
проба монітора, і не вище за штатний поріг.

```
штатний поріг 5000 мс = 200 кроків пробудження; власний 1000 мс = 40 кроків
при зависанні віддасться 0.712 мА·год замість 3.561 із запозиченим порогом
```

**2. Інтеграл ємності мовчки округлювався в нуль.** Доданок за прохід дорівнює
`мА × мс / 3600`, і при 25 мс він менший за одиницю **на будь-якому струмі до
144 мА**. Цілочисельне ділення з'їдало б його повністю — тобто ДРУГА з двох
меж, на яких тримається дозвіл працювати без датчика температури, ніколи б не
спрацювала. На секундному кроці цього не видно, там доданок завжди цілий.
Виправлено спільною функцією із залишком:

```cpp
inline void chargeAccumMah(uint32_t *mahX1000, uint32_t *rem, int32_t ma, uint32_t dtMs) {
    if (ma < 0) ma = -ma;
    uint32_t num = (uint32_t)ma * dtMs + *rem;
    *mahX1000 += num / 3600UL;
    *rem       = num % 3600UL;
}
```

```
4800 кроків по 25 мс на 150 мА -> 5.000 мА·год (точно 5.000)
без залишку вийшло б 4.800 мА·год
на 30 мА: із залишком 1.000 мА·год, без нього 0.000
```

### Перевірено

* `charge_logic_check`, розділи 20–25 — стеля напруги на всьому діапазоні
  живлення, затиск у найнижчій точці, збіжність регулятора на моделі «пакет
  ожив на 7.40 В» (5 проходів до 166 мА при стелі 150), усі вироки й усі
  відмови, межі режиму з порахованою найгіршою миттю;
* `session_guard_check`, розділ 38 — що вся ця логіка **справді ввімкнена в
  роботу**: `chargeTask()` віддає керування, стеля ставиться й на старті, і
  щопроходу, умови/вироки беруться з `charge.h`, спільні запобіжники стоять в
  обох машинах, кнопка з обробником є в кожному клієнті, а межі їдуть у клієнта
  з прошивки, а не з власних констант;
* звірка **від протилежного** — 60 поломок (13 меж, 16 місць у логіці, 31 у
  ввімкненні в роботу), кожна валить свою перевірку. Три з них спершу лишались
  зеленими й змусили підсилити охоронців: два — рахунком замість наявності
  (обидва потрібні виклики є у файлі ДВІЧІ, по разу на машину, тож проста
  наявність нічого не доводила), один — окремою перевіркою кнопки й обробника
  (голе ім'я функції є на сторінці двічі: в `onclick` і в оголошенні, тож
  прибрана кнопка при живому обробнику лишалась непоміченою);
* усі 13 хостових тестів зелені в **обох** конфігураціях силового ключа.

---

## 3.31. Звук увімкнено — і разом із ним знайшовся вартовий, який не працював

Прохання власника було коротким: «є вільний ЦАП-пін під звук? — тоді вмикай».
Відповідь на саме питання теж коротка: **так, GPIO25**. ЦАП на ESP32 є рівно на
двох пінах — 25 і 26, — і 26-й у цьому пристрої давно зайнятий ШІМ заряду. Тобто
вільний рівно один, і саме він потрібен.

### Чому це не було очевидно з документації

Бо документація стверджувала протилежне. І в `settings.h`, і в `README.md`, і в
`INSTRUCTION.md` поруч із закоментованим `BUZZER_DAC_PIN` стояло пояснення: «звук
вимкнено, **пін віддано керованому заряду**». Це неправда: заряд сидить на
GPIO26 (`CHARGE_PWM_PIN`), а 25-й після вимкнення звуку просто лежав у резерві —
що чесно й написано двома сотнями рядків нижче, у блоці «⚑ ЧОМУ САМЕ ЦІ ПІНИ».
Два твердження в одному файлі суперечили одне одному, і те з них, яке читають
першим, відмовляло у вільному піні, якого ніхто не займав.

Виправлено в усіх чотирьох місцях (плюс карта пінів у `SCHEMATIC.html`, де
GPIO25 значився як «вільний»), причому не мовчки: у кожному стоїть, що саме
було не так. Мовчазна правка тут гірша за помилку — рівно ця фраза вже один раз
пішла по файлах копіюванням.

### Що знайшлось під час перевірки — вартовий, який не міг спрацювати

Перед тим як умикати звук, я звірив «від протилежного» перевірки, які мали б
ловити помилку у виборі піна. Одна з них не ловила нічого:

```c
  #if ...
      (defined(CHARGE_PWM_PIN) && BUZZER_DAC_PIN == CHARGE_PWM_PIN) || \
      (defined(LOAD_PIN)       && BUZZER_DAC_PIN == LOAD_PIN) || \
      (defined(BTN_LED_PIN)    && BUZZER_DAC_PIN == BTN_LED_PIN)
    #error "BUZZER_DAC_PIN конфліктує з уже зайнятим піном!"
  #endif
```

Блок буззера стоїть у `settings.h` рано (~600-й рядок), а всі три макроси, з
якими він порівнюється, визначені **нижче**: `BTN_LED_PIN` — на 710-му,
`LOAD_PIN` — на 772-му, `CHARGE_PWM_PIN` — аж на 1207-му. На момент перевірки їх
ще не існує, `defined(...)` чесно повертає 0, і вся умова згортається в
«конфлікту немає». Перевірка була, захисту не було — той самий клас дефекту, що
вже ловили тут на `DISCHARGE_RAMP_LO_MV` (див. коментар у блоці `LOAD_PIN`).

Поки звук стояв вимкнений, це нічого не важило. З увімкненим — важить
максимально: вибір є лише між 25 і 26, тож **єдина помилка, яку тут узагалі
можна зробити, веде рівно в силовий ключ**. Буззер писав би в той самий вивід,
яким регулюється струм у пакет; ціна помилки — не тиша, а некерований заряд.

Порівняння з «пізніми» пінами винесено в кінець `settings.h`, поряд із уже
наявною перевіркою шини SPI, зробленою там із тієї ж причини — «коли ВСІ піни
вже визначені». Заразом додано те, чого не було ніде: збіг піна звуку з
вимірювальними входами заряду (`ISENSE`/`VSENSE`/`PSU`) і зі спадковим
`CHARGE_LEGACY_EN_PIN`.

> Частину випадків ловили «дзеркальні» перевірки — блок `CHARGE_PWM_PIN`
> порівнює себе з буззером і робить це вже після його визначення. Саме тому
> дефект і не виявився раніше: найнебезпечніший випадок (звук на 26) падав, хоч
> і чужим повідомленням. Але `LOAD_PIN` і `BTN_LED_PIN` про `BUZZER_DAC_PIN` не
> знали взагалі — ці збіги проходили мовчки, і це підтверджено окремим
> контрольним прогоном на **старому** тексті файлу.

### Другий перекіс: клієнти вважали, що буззера немає

`/api/sound` віддає полем `hasBuzzer`, чи є в цій збірці вихід звуку. Рахувався
там **лише** `BUZZER_PIN` (ШІМ) — ЦАП-варіанта на момент написання ще не
існувало, а потім звук вимкнули, і перекіс нічим себе не виявляв. Щойно звук
увімкнули на `BUZZER_DAC_PIN`, усі три клієнти (веб, USB-сторінка, exe) почали б
малювати «⚠️ у цій збірці буззер не підключено» просто над повзунками, які
насправді працюють. Питання ж не «чи заданий `BUZZER_PIN`», а «чи є вихід
звуку взагалі»: тепер перевіряються обидва, а який саме — їде окремим полем
`out` (`dac`/`pwm`/`none`). Текст попередження у трьох клієнтах виправлено так,
щоб він називав обидві константи.

### Чого міняти НЕ довелось

* **ЦАП і LEDC не діляться нічим.** Перевірка «канал заряду не ділить таймер
  LEDC із буззером» стосується тільки ШІМ-варіанта й обмежена
  `defined(BUZZER_PIN)`; ЦАП-шлях LEDC не займає взагалі — синус рахується в
  перериванні звичайного апаратного таймера й лягає в `dacWrite()`. Запис у
  3.11, де стояло «конфлікту немає, бо звук вимкнено», уточнено: висновок той
  самий і з увімкненим звуком, але з іншої причини.
* **ADC2 тут ні до чого.** GPIO25 — це ще й ADC2_CH8, який не читається при
  активному Wi-Fi, але потрібен він як **вихід** ЦАП, а всі вимірювання заряду
  сидять на ADC1.
* **Обв'язка.** Пасивний п'єзо вмикається прямо на GPIO **через розділовий
  конденсатор 1–10 мкФ**: ЦАП видає 0…3.3 В із постійною складовою, а не змінний
  сигнал навколо нуля. Динамік 4–8 Ом напряму — ні, тільки через підсилювач.

### Перевірено

* `session_guard_check`, **новий розділ 39** — що перевірка «пін звуку проти
  силових» існує й стоїть ПІСЛЯ всіх шести пінів, з якими порівнюється; що
  мертві порівняння не повернулись у ранній блок; що передумова цього
  («блок звуку у файлі вище за силові піни») усе ще правдива; що `/api/sound`
  доповідає про ЦАП-вихід; що всі три клієнти пояснюють тишу обома
  константами; що `buzzInit()`/`buzzTask()`/`buzzSelfTest()` хтось справді
  кличе. Сам факт «звук увімкнено» навмисно НЕ перевіряється — це вибір
  власника, а не інваріант коду;
* звірка **від протилежного** — 12 поломок розділу 39, кожна валить свою
  перевірку, і **11 поломок самих `#error`** у `settings.h`: ЦАП на не-ЦАП-піні,
  обидва варіанти звуку разом, збіг із раннім піном, збіг із ШІМ заряду, збіг із
  `LOAD_PIN`, `BTN_LED_PIN`, `CHARGE_LEGACY_EN_PIN` і вимірювальним входом. Два
  останні випадки прогнано ще й на **старому** тексті `settings.h` — там вони,
  як і очікувалось, збираються мовчки: це і є доказ, що правка щось лікує, а не
  просто переставляє рядки;
* усі 13 хостових тестів зелені в **обох** конфігураціях силового ключа;
  `page_index.h` перегенеровано, `check_page_js.py` і `client_audit.py` чисті.

---

## 3.32. Живлення 14.3 В читалось як 12.4 — і винен не подільник

Скарга власника: блок живлення стоїть на 14.3 В, прошивка показує 12.4 В і
виводить «⛔ напруга занижена — блок не той». Заряд від цього не стартує.

### Де саме губиться

Ланцюг від ноги до числа лінійний, тож його можна обернути точно:

| | мало бути при 14.3 В | прошивка бачила |
|---|---|---|
| напруга у вузлі подільника | 1.833 В | **1.590 В** |
| відлік АЦП | ~2275 | **~1973** |

Показання — 88 % від істини. Далі — один замір мультиметром на живій платі:
при блоці **14.4 В** на самому **GPIO39** виявилось **1.81 В** (ідеал для
68к/10к — 1.85 В, розбіжність у межах допуску резисторів). Це знімає одразу
дві версії: **подільник справний**, і **1 кОм нічого не роняє** — напруга
доходить до ноги цілою.

Отже губиться воно вже всередині АЦП, у єдиному рядку, що лишився між ногою і
числом:

```c
return (uint16_t)(raw * CHARGE_ADC_FULL_MV / CHARGE_ADC_MAX_RAW);   // 3300 / 4095
```

Ця пряма — модель, а не факт. У АЦП ESP32 на аттенюації 11 дБ і власна
нелінійність, і розкид опорної напруги між екземплярами (саме заради нього
існує калібрування в eFuse, яке проєкт свідомо не бере — `analogReadMilliVolts()`
колись підвела на драбинці кнопок, і це задокументовано над `chargeAdcMv()`).
На цьому чипі ефективна шкала в робочій точці — близько **3.73 В**, а не 3300 мВ.

### Що зроблено

Додано `CHARGE_PSU_CAL_X1000` — поправку тракту в тисячних, `1000` вимикає.
Значення `1153` = 14300/12400 вбирає обидві похибки одразу: і АЦП, і допуск
резисторів.

Ключове рішення — **де** її застосувати. Спокуса була підправити
`CHARGE_PSU_R_TOP` (80к замість 68к дає точно той самий результат), і це
неправильно: номінали — фізичні резистори, на них тримаються перевірка
діапазону й розрахунок струму в захисний діод при вдвічі завищеному живленні.
Підігнати їх під показання означало б зіпсувати ці розрахунки заради
косметики. Тому поправка стоїть **в кінці `chargePsuReadMv()`**, окремою
названою величиною, а номінали лишились правдою.

Ділення там із **округленням**, а не відкиданням: поправка додає в ланцюг ще
одну точку цілочисельної втрати, а один загублений мілівольт у вузлі
подільника коштує вже дев'ять на боці живлення (7.8 × сама поправка). Без
округлення похибка перерахунку виходила за допуск квантування.

Перевірка діапазону подільника тепер рахується **через поправку**: питання
там — чи не впреться сирий відлік у 4095, а прошивка судить про це за
ПЕРЕРАХОВАНИМИ мілівольтами. Стара форма помилялась в обидва боки — при
`CAL > 1000` була надто сувора, при `CAL < 1000` надто поблажлива, і друге вже
небезпечно. Окремим `#error` обмежено й саму поправку: поза 700…1400 це вже не
калібрування, а несправність тракту (не той номінал, обірваний чи пробитий
вхід), і ховати її за правдоподібним числом не можна.

### Чого це НЕ лікує — і це важливо

Похибка живе в АЦП, а `chargeAdcMv()` спільна для всіх трьох каналів. Тобто
**канал напруги пакета майже напевно теж занижує** — а на ньому тримаються
ціль заряду, поріг «пакет повний» і аварійна відсічка за перенапругою.

Виправлено при цьому лише живлення — на пряме прохання власника («просто
поправ значення, щоб не було помилки по живленню») і тому, що вимірів для
інших каналів поки немає. Переносити той самий множник на пакет навмання не
можна: він виміряний у точці 1.8 В, а пакет працює на 2.75 В, де крива АЦП уже
інша, і помилка тут дорожча за незручність. Коли з'являться заміри клем
мультиметром проти показань — з'явиться й поправка для цього каналу.

### Перевірено

* `charge_logic_check`, розділ 12 — модель тракту в тесті тепер **занижує рівно
  настільки, наскільки виправляє поправка**: до цієї правки тест ганяв прошивку
  по бездоганному АЦП, де поправці нічого виправляти, і мовчав би саме тоді,
  коли її переплутали. Плюс окрема перевірка на **живих числах плати**: відлік
  1973 (той самий, що давав 12.4 В) з поправкою дає 14.29 В, без неї — 12.39 В,
  тобто нижче порога, і саме це власник і бачив;
* звірка **від протилежного** — 9 поломок: обидві межі поправки, вихід вузла за
  стелю АЦП при `CAL = 700` (із контролем, що стара формула той самий випадок
  пропускала мовчки), прибраний множник, поправка вимкнена (1000), поправка в
  межах, але не та (1050), і повернення тестової моделі до ідеального тракту;
* усі 13 хостових тестів зелені в **обох** конфігураціях силового ключа.

---

## 3.33. Меню пристрою: список із групами замість плоского кільця

Прохання власника: «переділай меню дисплея в логічнішому розташуванні й
сортуванні пунктів, переосмисли вигляд меню, зроби перемикання функцій
зручнішим — можливо, списком».

### Що було не так — числами

Усі вісім сторінок лежали в **одному кільці**: показання, потім два hex-дампи,
потім «Дії», потім «Майстер». Тобто щоденні показання доводилось шукати між
сторінками, куди заглядають раз на місяць.

А сама сторінка «Дії» була **ще одним кільцем усередині першого**, і гортала
його та сама кнопка «OK»:

* пунктів у ньому — **32** (11 базових + по два на кожен із 9 шаблонів + 3
  крайні), і рухалось воно **лише вперед**: до «Перезавантаження» — 31
  натискання, назад — **ніяк**, тільки по колу;
* поруч, в одному кільці, лежали щоденний «Заряд ШІМ» і незворотнє
  «СТЕРТИ 2433»;
* «Ціль заряду» стояла через півсписку від «Заряд ШІМ», хоч це одна пара
  «що зробити» + «до чого»;
* «OK» означав **п'ять різних речей** залежно від сторінки — і на «Діях» він
  узагалі **не був вибором**, він гортав.

### Що зроблено

**Два роди екранів замість одного кільця.** Кільце показань — рівно чотири
сторінки, на які дивляться постійно. Усе інше — **меню-список**, яке
відкривається «OK» і містить і операції, і переходи на службові сторінки
(дампи, Майстер). Службові сторінки з кільця прибрані: їх відкриває меню, а
«‹» з них повертає назад.

**Порядок показу — окремою таблицею.** Коди `OP_*` міняти не можна (вони їдуть
у `/api/ops` і в команди USB), тому в `operations.h` з'явився окремий шар:
групи, сегменти й розбір позиції списку. Пункти зібрані в дев'ять груп за
призначенням, групи йдуть за ходом ремонту, найнебезпечніше — окремою групою в
кінці, а перемикач цілі стоїть **одразу після своєї дії**.

**Стрибок по групах — це і є швидка навігація.** Пунктів разом із шаблонами
36, і гортати їх по одному було б не краще за старе кільце. Довге «‹»/«›»
перестрибує на сусідню групу: до найдальшого пункту — **не більше 13 натискань
замість 31**, і в обидва боки. Саме заради цього «еталони» розбито надвоє
(«МОДЕЛЬ» і «НОВИЙ ЧІП»): однією групою вони давали б 18 пунктів, і стрибок у
ній нічого б не пришвидшив. Заразом це розводить операцію запису й операцію,
що стирає ідентичність, — в одній групі вони відрізнялись би лише першим
словом назви.

**Одне правило на всі екрани.** «‹»/«›» — рух (сторінка або пункт), довге —
стрибок; «OK» — увійти чи виконати, і більше нічого.

**Бар'єр — за наслідком, а не за родом сторінки.** Довге натискання лишилось
там, де є що втрачати: запис у чип і незворотні стирання. А «Ціль заряду», яка
нічого не пише й існує рівно для того, щоб її натискали по колу, тепер
перемикається **коротким** натисканням — тримати кнопку заради зміни числа
безглуздо. Рішення ухвалює одна функція `menuActivate()` за рівнем `OPD_*`
самого пункту.

### Знайдене принагідно

* **Назви обрізались буфером.** `opInfo()` збирала назви з ціллю в буфер на
  26 байт, а «Ціль заряду 100%» — це 16 літер, але **26 байт плюс нуль**:
  кирилиця в UTF-8 по два байти на літеру. На екрані стояло «Ціль заряду 100»
  без відсотка, і так само різалась «Очистка історії» (29 байт). Буфер
  винесено в `OP_NAME_BUF` = 48, а довжину найдовшої назви тепер рахує тест.
* **Дві назви груп не влазили у вузьку панель.** Тест на ширину впіймав
  «РЕМОНТ ПАКЕТА» і «ЕТАЛОН МОДЕЛІ» (13 гліфів проти 11 доступних на 135 px) —
  скорочено до «РЕМОНТ» і «МОДЕЛЬ» ще до того, як це побачив би користувач.
* **`txtFit()`** (у `textwrap.h`) обрізає назву **по гліфах** і позначає
  обрізане крапкою. Позначка не косметична: «Модель PMNN4409B» і
  «Модель PMNN4409A» на вузькій панелі обріжуться в один і той самий текст, і
  без позначки це читалось би як повна назва.

### Перевірено

* **новий хостовий тест `menu_check`** — модель меню повністю: кожна операція
  каталогу є в списку рівно один раз, групи йдуть суцільно й у заданому
  порядку, перемикач цілі стоїть одразу після своєї дії, у щоденних групах
  немає незворотного, а в групі «НЕБЕЗПЕЧНО» немає нічого іншого, стрибок по
  групах обходить усі групи за один оберт, назви влазять і в буфер, і в рядок
  на **кожній** із семи панелей (кольорових і монохромних);
* `session_guard_check`, **новий розділ 40** — що список справді ввімкнено в
  ОБИДВА драйвери екрана: сторінка стоїть у диспетчері, вхід у неї є з кільця
  показань, «OK» веде в `menuActivate()` в обох схемах кнопок (3 і 2), довге
  натискання справді стрибає по групах, склад береться з `operations.h`, а
  старого курсора кільця дій більше немає. Перевіряються саме **місця
  виклику**, а не наявність імені у файлі: `drawPageMenu()` є у файлі вже тому,
  що вона там оголошена;
* **синтаксична збірка нових функцій екрана** проти заглушок: драйвери на хості
  не збираються (u8g2, Adafruit GFX), але друкарську помилку й неіснуючий
  ідентифікатор це ловить;
* звірка **від протилежного** — 17 поломок, кожна валить свою перевірку:
  забута в меню операція, подвоєна операція, переставлені групи, розірвана
  група, відірваний від дії перемикач цілі, незворотнє в щоденній групі,
  прибраний вихід із меню, повернутий буфер 26 байт, задовга назва групи,
  `txtFit` без позначки обрізання, викинута з диспетчера сторінка, «OK» без
  `menuActivate()`, прибраний стрибок по групах, повернутий курсор старого
  кільця, кільце гортання зі службовими сторінками, порядок пунктів у драйвері
  й видалений тест моделі;
* усі **14 хостових тестів** зелені.

---

## 3.34. Ручні уставки, розумний профіль 2S і залишок часу

Прохання власника, дві поспіль: «на заряд і розряд зроби ручний режим вибору
напруги й струму, і створи розумний інтелектуальний автоматичний режим заряду
та розряду для літій-іонної батареї 2S»; далі — «додати статус залишку часу,
переосмислити меню цих функцій, зробити для заряду, розряду й оживлення
однотипний вигляд».

### Що було не так

**Уставку не можна було вибрати взагалі.** Струм заряду задавав жорсткий
профіль за відсотком (`chargeSetpointMaForPct`), напругу — тільки ціль у
відсотках через криву SoC. Пакет на 1300 мА·год і пакет на 2500 мА·год
отримували **однакову** уставку 1000 мА: для першого це 0.77C, для другого
0.4C. Обидва числа взяті не з пакета, а зі стелі заліза.

**Заряд закінчувався за напругою.** Штатний профіль доводив пакет до цілі й
переходив у дозаряд за **відсотком**. Але «напруга торкнулась 8.2 В» — це не
кінець заряду літію, це **початок його останньої фази**: у цю мить у пакеті
близько 70…80 % ємності, решта заходить саме на постійній напрузі.

**Скільки ще чекати — ніде.** Ні на екрані, ні у вебі, ні в exe: був лише час
від початку. На процедурі, що йде **дві з половиною години**, це головне
питання, і відповіді на нього не було.

**Три екрани операцій виглядали по-різному.** Заряд, розряд і пробудження
писались у різний час, кожен своїм набором рядків: різний порядок, різні
підписи тих самих величин, у пробудження — свій лічильник. Порівняти два
сеанси очима було неможливо.

### Що зроблено

**Ручні уставки — окремим шаром над автоматом.** Струм заряду, ціль у вольтах
і струм розряду тепер можна задати вручну: у вебі й exe — полем, на пристрої —
кільцем із чотирьох значень плюс «Авто» (`0` завжди означає «віддати рішення
автомату», а не «затиснутий мінімум»). Межі рахує `settings.h`, а не клієнт.

**Ручне не може ПІДНЯТИ струм наприкінці.** Ключове обмеження шару: у фазі
дозаряду/спаду береться **менше з двох** — ручного й автоматичного. Інакше
ручні 1000 мА тримали б повний струм рівно там, де його треба прибирати, і
ручний режим став би способом перезарядити пакет, а не способом його
підлаштувати.

**Розумний профіль рахує від ЄМНОСТІ ПАКЕТА, а не від стелі заліза.**
Паспортна ємність береться з дампа монітора (`impresRatedFromDump`) і доїжджає
в профіль. Звідси всі струми:

| | частка | пакет 2500 | пакет 1300 |
|---|---|---|---|
| фаза CC | 0.5C | 1000 мА (затиснуто стелею з 1250) | 650 мА |
| передзаряд (нижче 6.0 В) | 0.1C | 250 мА | 130 мА |
| поріг завершення | 0.05C | 125 мА | 65 мА |

**«Постійна напруга» на струмовому регуляторі.** Залізо керує **струмом**, а
не напругою, тож фаза CV зроблена так: в останніх 250 мВ до цілі уставка
**лінійно спадає** від струму CC до струму завершення — рівно на цілі вона
дорівнює порогу. Що ближче напруга до цілі, то менший струм у неї йде, тобто
напруга сама впирається в ціль і стоїть. Заміряно на моделі: 996 → 562 → 160 мА
по зоні.

> ⚑ **Головний інваріант режиму:** підлога уставки в CV і поріг завершення —
> це **одне й те саме число**. Якби підлога стояла хоч трохи вище порога,
> регулятор тримав би підлогу, струм ніколи не впав би нижче порога, і
> «розумний» заряд не завершився б **ніколи** — ішов би до стелі часу. Тому
> для крихітних пакетів обидва впираються в спільний `CHARGE_SMART_MA_MIN`, і
> це стереже і `#error`, і окрема перевірка в тесті.

**Завершення — за СТРУМОМ, п'ять відліків поспіль.** І тільки у фазі CV:
нульовий струм у фазі CC — це несправність (обрив, не той ключ), а не повний
пакет. Сплеск струму скидає лічильник, щоб «повний» не ставився за випадковий
провал одного виміру.

**Температурне вікно — у десятих градуса.** Не тому, що потрібна така
точність, а тому, що ділення на 10 **ховає мінус**: при −0.1 °C цілі градуси
дають нуль, і заряд на морозі пішов би як штатний. Нижче +10 °C струм
зменшується вдвічі — на холоді літій приймає заряд гірше, і повний струм жене
його в металізацію.

**Розумний розряд** — дзеркало того самого: 0.2C від паспортної ємності
(швидше вимірювати нічого, повільніше — доба на сеанс), плавний спад в
останніх 300 мВ до цілі, своє температурне вікно.

**Залишок часу рахує ПРИСТРІЙ.** Один раз, у `chargeEtaS()`/`dischargeEtaS()`,
і віддає всім трьом клієнтам — інакше кожен рахував би по-своєму і показував
різні числа. Формула чесно проста: залишок ємності поділити на струм, який іде
**зараз**. У фазі CV оцінка **подвоюється**, бо струм там спадає сам. Оцінка
підписана «≈», а неправдоподібно велика (більша за стелю часу сеансу) не
показується **взагалі**: нуль тут означає «не знаю», і це чесніше за вигадане
число, на яке почнуть розраховувати.

**Однотипний вигляд трьох екранів.** Заряд, розряд і пробудження зібрані
**спільним каркасом** (`opMonHead` / `opMonRow` / `opMonTime` / `opMonFoot`) в
обох драйверах — монохромному й кольоровому. Ті самі величини стоять на тих
самих місцях, час іде однією парою «минуло / ≈ лишилось», підвал однаковий.

> **Це зроблено на ПРИСТРОЇ.** У клієнтах з'явились ті самі величини й ті самі
> ручні уставки, але спільного каркаса панелей там ще не було — його зробили
> наступним заходом, див. 3.35.

**Група «ЖИВЛЕННЯ» розділена на «ЗАРЯД» і «РОЗРЯД»** (груп стало десять). Разом
із новими перемикачами в спільній групі опинилось би десять пунктів двох різних
машин — стрибок по групах у ній перестав би щось пришвидшувати, а це і є
головний спосіб навігації в списку.

**У меню — по два перемикачі на машину**, кожен одразу після своєї дії:
`OP_CHARGE_MANUAL_MV`, `OP_CHARGE_MANUAL_MA`, `OP_CHARGE_PROFILE` у групі
«ЗАРЯД»; `OP_DIS_MANUAL_MA`, `OP_DIS_PROFILE` у групі «РОЗРЯД». Коди нових
операцій дописані **в кінець** каталогу (11…15): старі номери їдуть у
`/api/ops` і в команди USB, і перенумерувати їх не можна.

### Знайдене принагідно

* **Позиційний ініціалізатор і нове поле.** Додавання `phase` у
  `DischargeState` зсунуло позиційний список так, що `0.0f` лягло на
  `uint8_t` — збірка впала на звуженні. Замінено на `= {}`: позиційна
  ініціалізація структури, яка ще ростиме, — це відкладена помилка.
* **Перевірки розряду довелось ставити ПІЗНО.** `DISCHARGE_SMART_*`
  визначаються поруч із розумним зарядом (кінець файлу), а константи розряду —
  на рядку ~820. Поставити перевірки в блок розряду означало б порівнювати
  макроси, яких там ще немає: `#if` мовчки вважає невідомий ідентифікатор
  нулем. Цей проєкт на такому горів **двічі** (`DISCHARGE_RAMP_LO_MV` і пін
  звуку), тому блок винесено в кінець, а звірка від протилежного відтворює
  обидва стани: пізня перевірка ловить завищений ручний струм розряду, та сама
  перевірка «рано» — мовчить.

### Перевірено

* **новий хостовий тест `smart_check`** — 75 перевірок на **справжніх**
  `charge.h`/`discharge.h`: струми від ємності й затискання стелею, порядок
  фаз за напругою, спад уставки **всередині** зони CV і збіг із порогом на
  цілі, температурне вікно в десятих градуса, завершення за струмом і скидання
  лічильника, межі ручних уставок і те, що ручне не піднімає струм у кінці,
  перемикання профілю в єдиній точці уставки, розумний розряд, оцінка часу;
* **повний цикл на моделі пакета** (2500 мА·год від 6.50 В): завершується
  **сам** за 9100 с (2.5 год), заливає 2175 мА·год, напругу цілі **не
  перевищує жодного разу**, проходить обидві фази — CC 6750 с, CV 2351 с;
* `session_guard_check`, **новий розділ 41** — що цим справді користуються:
  завершення за струмом стоїть у циклі заряду, паспортна ємність доїжджає в
  профіль, маршрути HTTP і команди USB на місці, усі **три** клієнти мають і
  ручні уставки, і перемикачі профілю, і показ залишку часу, а екрани операцій
  в обох драйверах зібрані спільним каркасом;
* **22 нові `#error`** у `settings.h` — межі всіх нових констант і їхні
  співвідношення;
* звірка **від протилежного** — 27 поломок, кожна валить свою перевірку:
  12 на логіку профілів (знята стеля, плоска CV, немає передзаряду,
  температура в цілих градусах, немає холодного обмеження, завершення з
  першого відліку, нульовий струм у CC як «повний», ручне піднімає струм у
  дозаряді, розряд не від ємності, ETA без подвоєння в CV, ETA без відсічки
  неправдоподібного, вимкнений перемикач профілю), 7 на ввімкнення в роботу,
  6 на компіляційні межі й 2 контрольні на розташування блоку перевірок;
* усі **15 хостових тестів** зелені — в обох конфігураціях ключа
  (`CHARGE_SW_PMOS` і `CHARGE_SW_BJT_PNP`).

**Три перевірки виявились сліпими — і це знайшла саме звірка від
протилежного:**

* перевірка спаду в CV порівнювала **початок зони з ціллю**, а уставку рівно
  на цілі віддає **окрема гілка** коду. Тобто плоска уставка всередині зони —
  тобто відсутність фази CV як такої — проходила перевірку. Тепер спад
  міряється всередині зони, у трьох точках;
* перевірка «нульовий струм у CC — не завершення» трималась не на фазі, а на
  тому, що в пакета 2500 мА·год уставка CC далеко вища за поріг. Викидання
  фази з умови лишалось непоміченим. Додано випадок із **дрібним** пакетом
  (50 мА·год), де уставка CC і поріг лежать на спільній підлозі, і фаза —
  єдине, що їх розрізняє;
* у вартовому `def charge_set_mv` лишається **підрядком** у
  `def charge_set_mv_disabled`, тож перейменований (тобто вимкнений) метод
  exe-клієнта проходив перевірку. У шаблон додано дужку `(self`, і окремо
  перевіряється, що кнопки на ці методи справді заведені.

---

## 3.35. Єдиний вигляд заряду, розряду й пробудження в усіх трьох клієнтах

Прохання власника: «єдиний стиль меню для застосунків і веба — в заряді,
розряді й оживленні». Це продовження 3.34: на дисплеї спільний каркас уже
з'явився, у клієнтах — ще ні.

### Що було не так — по пунктах

Три операції того самого пристрою читались як три різні програми.

| | розряд | заряд | пробудження |
|---|---|---|---|
| крива напруги за сеанс | є | **немає** | **немає** |
| коридор уставки струму | є | **немає** (проста смуга) | **немає** |
| плитка «фаза» | **немає** | є | є |
| плитка «лишилось ≈» | є | є (у вебі) | є (у вебі) |
| порядок плиток | свій | свій | свій |
| у `.exe` збудовано на | полотні | **ttk-віджетах** | тих самих ttk |

* **На USB-сторінці «фаза» й «лишилось ≈» не мали плиток узагалі** — вони були
  дописані рядком у примітку під панеллю, хоча пристрій обидва числа віддавав.
  Побачити це можна було, лише відкривши три клієнти поруч.
* **В `.exe` заряд і розряд були РІЗНИМИ КЛАСАМИ на різних механізмах:**
  `DischargeMonitor(tk.Canvas)` малював себе сам (графік, коридор, плитки), а
  `ChargeMonitor(ttk.Frame)` складався з віджетів — без графіка, без коридору,
  плитки в іншому порядку й на три менше.
* **Пробудження ховало сусідні плитки** класом `wakeonly`/`chgonly`: сітка
  перебудовувалась, і те саме число після зміни режиму опинялось на іншому
  місці.
* **Ряди уставок розповзались**: відступ ставили інлайновим `style`, а підпис
  у кожному ряду мав свою ширину — кнопки двох карток не стояли на одній
  вертикалі.

### Що зроблено

**Одна таблиця плиток на три операції й на всі три клієнти.** Вісім слотів:

| # | 1 | 2 | 3 | 4 | 5 | 6 | 7 | 8 |
|---|---|---|---|---|---|---|---|---|
| | мА·год | струм | потужність | **фаза** | **лишилось ≈** | лічильник чипа | температура | паливомір |

Перші п'ять підписані однаково завжди. Три останні **міняють лише підпис** —
у пробудженні там «проб монітора», прочерк і «межа ШІМ», бо DS2438 у цьому
режимі мовчить.

> ⚑ **Плитки більше не ховаються — вони перепідписуються.** Це не косметика:
> сітка, що перебудовується, змушує щоразу шукати величину заново. А порожня
> плитка в спільній сітці читалась би як «дані не дійшли», тому у слоті «фаза»
> під час пробудження стоїть слово `ПРОБУДЖЕННЯ`, а не порожнеча.

**У вебі — спільні функції, а не спільний вигляд.** `opTiles()` будує сітку з
таблиці, `opTileHead()` перемикає підписи, `opTileSet()` пише значення зі
спалахом, `opBand()` малює коридор уставки, `opPush()`/`opSpark()` ведуть криву
напруги за сеанс. Заряд і розряд — два застосування того самого коду.

**В `.exe` два класи панелі стали одним** — `OpMonitor(tk.Canvas)`. Заряд
отримав те, чого в нього не було ніколи: криву напруги, коридор уставки з
рискою й вісім плиток замість шести.

> ⚑ **Заразом полагодилось те, про що ніхто не знав.** Масштабування вікна
> застосовувалось лише до `monDis` — заряд у той код просто не потрапляв, бо
> був іншим класом. Тепер обидві панелі того самого класу й масштабуються
> разом.

**Коридор уставки в заряді малюється навколо уставки шириною в мертву зону
регулятора**, і саме число приходить із пристрою (`deadbandMa`): клієнт, який
вписав би 30 від себе, збрехав би в ту саму мить, коли константу змінять.

**Ряди уставок — один клас `.oprow`** із фіксованою колонкою підпису, у всіх
картках обох сторінок. Кнопки трьох операцій — у трьох однакових рядах `.btns`.
Пробудження стало підблоком `.opsub` з таблицею своїх твердих меж угорі, а не
приписом дрібним шрифтом.

### Перевірено

* **`client_audit.py`, новий розділ** — звіряє склад і порядок плиток **між
  трьома клієнтами** (уміє розібрати і JS, і Python): порядок порівнюється
  **списком**, а не множиною, бо однаковий набір у різному порядку — це і є
  «різні панелі»; кожна плитка мусить десь **заповнюватись**; пробудження
  мусить перепідписувати **рівно ті** плитки, що й заряд; у вебі всі п'ять
  спільних функцій мусять справді викликатись для **обох** панелей, а в `.exe`
  не має лишитись жодного зі старих класів;
* `session_guard_check`, **новий розділ 42** — те, що видно лише з боку
  прошивки: чи є їй чим ці панелі годувати (`deadbandMa`, обидві межі коридору
  розряду, фаза **обох** машин) і що клас `wakeonly` зник із обох сторінок;
* звірка **від протилежного** — **16 поломок**, кожна валить свою перевірку:
  переставлені плитки, викинута плитка в одному клієнті, викинута в усіх трьох
  одразу, неповний перепідпис у пробудженні, підпис для неіснуючої плитки,
  зникла крива, зниклий коридор, панель повз спільну таблицю, повернутий
  окремий клас у `.exe`, одна панель на дві операції, прибраний `deadbandMa`,
  прибрана фаза розряду, повернутий `wakeonly`, прибране перемикання підписів,
  нуль замість прочерку;
* усі **15 хостових тестів** зелені в обох конфігураціях ключа.

**Три перевірки знову виявились сліпими — і знову це знайшла звірка від
протилежного:**

* звірка режимів підписів робилась **лише на зразковому клієнті**: неповний
  перепідпис у решті двох проходив непоміченим. Тепер перевіряється в кожному;
* `dischargePhaseText` лишається **підрядком** у `dischargePhaseTextUnused` —
  та сама підрядкова діра, що торік у `def charge_set_mv`. Додано дужку;
* `opTileHead('chg'` стоїть **іще й у початковому налаштуванні** панелі, тож
  перевірка лишалась зеленою навіть тоді, коли перемикання по режиму
  прибирали зовсім. Тепер шукається саме `opTileHead('chg', wake`.

---

## 3.36. Заблокований пакет, який читається: глухий кут між двома відмовами

Скарга власника: «при блокуванні батареї спроба заряду видає *Подільник
напруги показує майже нуль — перевірте CHARGE_VSENSE_PIN і клеми* і заряджати
не пробує; пробудження теж не працює, бо акумулятор зчитується».

### Що сталося насправді

Захист усередині пакета розмикає **силовий** ключ. А DS2438 сидить **до
нього** — і говорить далі. Виходить стан, якого жоден із двох режимів не
передбачав:

| | клема | монітор |
|---|---|---|
| звичайний робочий пакет | 7…8 В | відповідає |
| пакет після заміни банок | 0 (або ~7.4 В крізь тіло ключа) | **мовчить** |
| **заблокований пакет** | **0** | **відповідає** |

І обидві двері виявились зачинені:

* **штатний заряд** відмовляв, бо `mv < BATTERY_EMPTY_MV/2` — «подільник
  показує майже нуль»;
* **пробудження** відмовляло, бо `chipReads == true` — «пакет читається,
  користуйтесь звичайним зарядом».

Кожна відмова окремо була розумна. Разом вони не лишали **жодного** шляху — і
це при тому, що потрібна дія в обох випадках та сама й пристрій її вміє.

> ⚑ **Помилка була в ПРЕДИКАТІ, а не в порозі.** Умова пробудження звучала
> «пакет читається», а мала б звучати «штатний заряд ДОСТУПНИЙ». Це не те
> саме: «читається» — лише половина умови, друга половина — «і на клемі є
> напруга». Без неї перевірка відсилала користувача до режиму, який сам себе
> відхиляє.

### Що зроблено

**У пробудження стало дві мети**, і ознака успіху в них різна:

| мета | коли обирається | успіх |
|---|---|---|
| `WAKE_GOAL_CHIP` | монітор мовчить | монітор заговорив |
| `WAKE_GOAL_RAIL` | монітор говорить, клема мертва | на клемі з'явилась напруга |

Мета визначається **раз на старті**. Це не дрібниця: у меті RAIL монітор
відповідає з першої ж проби, тож стара умова успіху (`chipOk`) оголосила б
перемогу, **не зробивши нічого** — і виглядало б це як робота.

**Один поріг «клема жива» на обидва рішення** — `chargeRailAlive()`. Два різні
пороги дали б стан, у якому заряд каже «нуль», а пробудження каже «вже є
напруга», і не запустився б жоден.

**У новій меті працює контроль температури.** Монітор говорить — отже датчик
є, і не скористатись ним означало б лишити режим сліпим там, де він може бути
зрячим. Тобто нова мета **безпечніша** за первісну, а не навпаки.

> ⚑ **Нижньої температурної межі тут навмисно немає.** 8 мА·год у пакет на
> кілька тисяч — це не заряд, а сигнал контролеру; холоду він не шкодить. А
> відмова на морозі просто лишила б людину без єдиного способу оживити пакет.
> Гріти ж гарячий пакет підстав немає ніколи — верхня межа діє.

**Дві мети — дві різні невдачі.** «Час вичерпано» в меті CHIP означає «монітор
так і мовчить», а в меті RAIL монітор говорив увесь сеанс, і невдача означає
зовсім інше: **або захист не відпускає, або обірвано лінію
`CHARGE_VSENSE_PIN`**. Один текст на два випадки відправив би людину шукати не
там, тому причин теж дві (`CHGR_WAKE_FAIL` / `CHGR_WAKE_NORAIL`).

> ⚑ **Режим РОЗВ'ЯЗУЄ неоднозначність, а не вгадує її.** Відрізнити «захист
> розімкнув клеми» від «обірвано вимірювальну лінію» **вимірюванням
> неможливо** — картина однакова. Але дія в обох випадках та сама й обмежена:
> подати імпульс і подивитись, чи з'явиться напруга. З'явилась — це був
> захист; не з'явилась — це лінія, і режим так і каже.

**Відмова штатного заряду тепер веде до виходу**, а не лише називає біду. Вона
друкує обидва числа — скільки бачить наш подільник і скільки бачить монітор
усередині пакета, — пояснює найімовірнішу причину й прямо відсилає до
пробудження.

**Тексти в клієнтах виправлені.** «Якщо пакет читається — пробудження буде
відхилено» стало неправдою; тепер там написано, що відхилять лише пакет, який
**і читається, і має напругу на клемі**. Рядок проб підписує сам пристрій
(`wakeGoalText`): у меті RAIL напис «монітор мовчить» був би просто неправдою
— причому саме там, куди людина й дивиться.

### Знайдене принагідно

* **Доданок, який не міг спрацювати.** Спершу я написав у `WAKENO_FULL` умову
  `!chipReads && mv >= CHARGE_WAKE_MV`. Звірка від протилежного показала, що
  прибрати `!chipReads` **нічого не змінює**: до цього рядка з живим монітором
  доходять лише з мертвою клемою (< 3000 мВ), а поріг там 8000 мВ — умови
  несумісні. Тобто це був би четвертий у цьому проєкті доданок, у який усі
  вірять і який ніколи не виконується. Доданок прибрано, а міркування, на
  якому це тримається, стало **перевіркою**: «усе, що дотягує до напруги
  пробудження, уже вважається живою клемою».
* **Ознаки пробитого ключа при живому моніторі раніше не дивились узагалі** —
  `chipReads` відхиляв режим першим. Тепер `WAKENO_LEAK` і `WAKENO_RAIL`
  перевіряються й у новій меті, і це закріплено тестом.

### Перевірено

* `charge_logic_check`, **новий розділ 22а** — уся нова мета: дозвіл на
  заблокований пакет, вибір мети, успіх саме за клемою (а не за відповіддю
  монітора), відкидання насиченого й несвіжого відліку, температурне вікно
  зверху й дозвіл на морозі, незмінність меж енергії та часу, чесність рядка
  стану; плюс сам поріг «клема жива» — на нулі, на залишкових сотнях мВ, на
  порожньому пакеті й рівно на межі;
* **вираз із драйверів екрана** зібрано в тесті окремо: самі драйвери на хості
  не збираються, тож нове поле стану більше ніде не перевірялось би;
* `session_guard_check` — що мета рахується на старті, доїжджає у вирок разом
  із температурою, що штатний заряд питає **той самий** поріг і що його
  відмова називає вихід;
* звірка **від протилежного** — **25 поломок**, кожна валить свою перевірку:
  повернута стара умова, роз'їхані пороги, успіх за `chipOk`, зарахований
  насичений і несвіжий відлік, знята температура, температура в сліпій меті,
  заборона на морозі, зняті межі енергії й часу, не помічений витік, і вісім
  поломок ввімкнення в роботу;
* усі **15 хостових тестів** зелені в обох конфігураціях ключа.

---

## 3.37. Дев'ять нових дампів — і п'ять місць, де брехали МИ

Власник надіслав дев'ять акумуляторів зі скаргами на рацію («в свойствах пишет
восстановить», «неизвестный аккумулятор»), два з них — знятими **двічі**, до і
після зарядної станції. Партія лягла в корпус як
`dumps/20-vymahaie-vidnovlennya/`. Скарги були на рацію, а знайшлися помилки в
нашій діагностиці.

### 1. «Циклів не-IMPRES: 0» там, де їх 11 і 58

Два пакети з побитим блоком `NONSMART`. Лічильник циклів IMPRES у такому разі
чесно віддавав `−1`, а сусідній тихо лишався **нулем** — «блок не читається»
виглядало як «жодного разу не заряджали простою ЗП».

> ⚑ **Нуль тут ЗАКОННИЙ**, і саме тому сплутати легко: у корпусі шість дампів,
> де не-IMPRES справді нуль. Тест тепер вимагає, щоб у корпусі трапились **усі
> три** стани — прочитано (51), рівно нуль (6), не читається (3): без
> останнього перевірка нічого не значила б, без середнього її можна було б
> «полагодити» позначкою нуля.

Це не косметика: той нуль ішов у суму «циклів пакета», з якої рахується рядок
CCA/DCA **плану синхронізації дзеркала** — тобто число, яке пропонують записати
в монітор.

### 2. Неможлива дата виготовлення — як факт

У пакета `PMNN4493A` блок `DATE` не розшифровується ключем із ROM: виходить
**«2072-14-22»**. Функція `impresBmsDateSane()` у проєкті є **давно** — Майстер
навіть ставить діагноз «неправдоподібна дата», — але панель показань її не
питала й друкувала сміття значенням.

### 3. «Пакет ще не вмикався» — про пакет із 759 циклами

Друга половина тієї ж біди: дата першого користування рахується **від** дати
виготовлення, тож при побитій даті її просто немає. Клієнт писав «— (пакет ще
не вмикався)» — інше твердження, і хибне. Тепер прапорець `mfgDateOk`
розрізняє «немає» і «не обчислити».

### 4. «Розряджено 11465 циклів» при 191 циклі заряду

Регістр `DCA` монітора містить 33384 при `CCA` = 559 — «з пакета взято у 60
разів більше, ніж залито», 26 мільйонів мА·год. Показували як факт. Історія в
самому DS2433 при цьому ціла (`CCA 440 / DCA 388`), тобто побитий саме монітор.

Додано `impresBmsDcaSane()` і прапорець `AUD_DCA_INSANE`. Запас навмисно
щедрий — півтора рази плюс 200 одиниць: мета ловити **побитий регістр**, а не
сперечатися з експлуатацією. На всьому корпусі з 65 пар спрацьовує **рівно
один** раз — і тест вимагає саме одного: більше означало б з'їдений запас,
менше — що перевірка перестала ловити те, заради чого написана.

### 5. Справний пакет — «станція почала добудову»

Робочий 4409A (індикація заряду працює, модель, профіль і блоки цілі) з двома
зіпсованими байтами отримував діагноз **ISS_CHARGER_PARTIAL** і пораду
добудувати давно побудоване.

> ⚑ **Умова була половинною.** Перевірялось «сума заголовка хибна + дзеркало
> сходиться». Але в **справного** пакета дзеркало сходиться завжди — на те воно
> й дзеркало. Бракувало третьої умови: **решта чипа ще порожня**. Різниця різка
> й не потребує порогів: у справжньому випадку (`19-stantsiya-dobudova`) після
> `0x020` рівно **0** непорожніх байтів, у хибному — **269**.

**І правило існувало у двох копіях.** `recovery.h` на хості не збирається, тож
тест `hdrfix_check` тримав його дослівно переписаним — і копія пережила
виправлення оригіналу, лишивши тест зеленим на зламаній логіці. Правило
винесено в `impres_format.h` (`impresChargerPartial()`), обидва місця кличуть
його, а охоронець стежить, щоб копія не повернулась.

### 6. `decode_dump.py` кричав «≠5A» на кожному справному пакеті

У хвості кожного дампа є 3-байтовий запис прапорців зарядної станції
(`03 04 80`, `03 10 20`, …) — контрольної суми він не має. Прошивка знає це у
**трьох** місцях (аудит, перерахунок сум, ремонт цілісності — усі пропускають
записи, коротші за 4 байти), а розбирач дампів не знав.

> ⚑ **Хибна тривога на кожному пакеті гірша за відсутність перевірки.** Її
> перестають читати — і разом із нею перестають помічати справжню. А справжня
> в цій партії була: у двох дампах запис `0x153` (лічильники CCA/DCA і
> не-IMPRES) справді побитий, і саме він стоїть за пунктом 1.

### Чого партія НЕ пояснила

Чесно записано в `notes.md`: **чому рація каже «невідомий акумулятор»** на
одному з пакетів — наш аудит на ньому не знаходить нічого, усі перевірки
проходять, ключ сходиться з ROM. Єдина помітна відмінність від решти 4409A —
три записи в журналі використання замість одного, усі з правильними сумами. Чи
в цьому річ, з наявних даних сказати не можна, тож нічого й не стверджуємо.

Так само не випливає з дампів, **чому після зарядної станції зникає
привітання**: побайтова різниця «до/після» показує, що станція дописала запис у
журнал і оновила навчений хвіст, тобто зробила те, що робить завжди.

### Перевірено

* корпус виріс до **58 акумуляторів / 66 дампів**, і всі наявні тести ганяються
  по ньому цілком — саме так знайшлися пункти 1, 4 і 5;
* `audit_check`, **новий розділ 5** — три стани лічильника не-IMPRES у корпусі;
  плюс вимога «побитий DCA рівно в одного дампа»;
* `hdrfix_check`, **новий розділ 2а** — реальний дамп зі скарги не сміє
  діагностуватись як добудова; і дзеркально: один непорожній байт після `0x020`
  знімає діагноз у справжньому випадку;
* `session_guard_check`, **новий розділ 43** — те, чого на хості немає: JSON
  пристрою й три клієнти. Перевіряються **вирази**, а не фрази: звірка від
  протилежного показала, що «чи є у файлі слова „не обчислити“» лишається
  зеленою після того, як ці слова прибрали з коду — вони й далі стоять у
  коментарі поруч;
* звірка **від протилежного** — **18 поломок**, кожна валить свою перевірку;
* усі **15 хостових тестів** зелені в обох конфігураціях ключа.

---

## 3.38. Майстер навчився лагодити сам — і показав, що половина його правил не перевірялась ніяк

Розділ 3.37 закінчився списком знахідок. Одна з них — побитий лічильник
розряду в моніторі — так і лишилась знахідкою: Майстер її називав, а що з нею
робити, не казав. Звідси й завдання: **додати автоматичне виправлення, а заразом
перевірити, чи всі функції роблять те, що обіцяють їхні назви**.

### 1. Правка, яку можна обґрунтувати

У моніторі DS2438 два лічильники наробітку: заряду (CCA) і розряду (DCA). В
одному дампі корпусу DCA більший за CCA у сотні разів — розрядили більше, ніж
колись зарядили, чого не буває. Ламається зазвичай **один** регістр, і другий
лишається якорем.

Джерело правильного значення є в самому пакеті: блок `NONSMART` у DS2433 тримає
ті самі два лічильники **в тих самих сирих одиницях**. Це не здогад — на корпусі
в 47 із 56 пакетів із цілим блоком монітор іде поруч з історією, трохи попереду
(він рахує безперервно, станція дописує історію лише на калібруванні).

Новий крок Майстра — **«Полагодити лічильник розряду»** — бере DCA з історії й
пише **рівно два байти** монітора. Умови, без яких він відмовляється:

| Умова | Навіщо |
|---|---|
| історія читається, блок не куций | нема джерела — нема правки |
| заряд в історії не нульовий | нуль означає, що станція цього пакета ще не бачила |
| історія узгоджена сама з собою | розряду не більше, ніж заряду (з запасом 50 % + 200) |
| CCA монітора не `0xFFFF` | якір ненадійний — порівнювати нема з чим |
| історія **не попереду** монітора | так виглядає свідомо обнулений або замінений монітор — чуже рішення не скасовуємо |
| монітор **справді** зламаний | інакше функція стала б способом тихо переписати справний лічильник |

> ⚑ **Цілої суми блока ми навмисно НЕ вимагаємо.** Саме в тих пакетах, де біда й
> трапилась, сума не сходиться (байт довжини `0x0F` замість `0x0D`) — а дані в
> ньому демонстровано цілі: у сусідньому пакеті з тією самою аномалією історія
> 3014/2967 проти монітора 3025/2978, тобто рівно **+11 по обох** лічильниках.
> Формальна сума тут відхилила б справні числа.

При невдалому записі в чип значення **в пам'яті повертається назад**: інакше
екран показував би полагоджений лічильник, якого в пакеті немає.

### 2. Умова, яка ніколи б не спрацювала — п'ятий випадок

Перша редакція правки починалась рядком «жодне зі значень не `0xFFFF`». Звірка
від протилежного цей рядок **не змогла зламати**: прибираєш — усі тести
лишаються зеленими. Розбір показав, чому — і це не недогляд тесту, а мертвий
код:

* стертий **заряд** (65535) більший за будь-який справний монітор, отже впаде на
  умові «історія не попереду»;
* стертий **розряд** пройшов би правдоподібність лише при заряді від 43557 — а
  монітор із таким самим заряджанням уже неможливо визнати зламаним
  (65535 < 43557·1,5), тобто до запису справа не дійде.

Умову прибрано, арифметику записано в коментар — щоб її не «відновили».
Натомість перевіряється те, що справді вирішує долю правки. Це **п'ятий**
випадок «умови, яка не може спрацювати» в проєкті; попередні чотири —
`DISCHARGE_RAMP_LO_MV`, пін зумера, розумні сталі розряду і `!chipReads` у
пробудженні.

### 3. Знахідка без ліків тепер неможлива

Ревізія Майстра показала три різні діри, і всі три — одного роду: **щось
рахується, але нікуди не доїжджає**.

1. `AUD_MONITOR_ZEROED` аудит обчислював — і на цьому все закінчувалось: у
   переліку проблем Майстра відповідного біта не існувало. Тепер є
   `ISS_MONITOR_ZEROED` з діагнозом і пропозицією.
2. **П'ять** проблем не давали жодного кроку й не пояснювали, чому. Тепер є
   таблиця `WIZ_INFO_ONLY` — «кроку не буде, і ось причина». Тест вимагає, щоб
   кожна проблема була **або** в плані, **або** в цій таблиці; «ні там, ні там»
   і «і там, і там» однаково валять збірку.
3. Формат дампа визначався **двічі**: власною копією в `recovery.h` і спільною
   `impresFormatYear()`. Копію прибрано — цей проєкт уже горів на двох копіях
   однієї умови (`chargerPartial`).

### 4. Правила винесено туди, де їх видно тестові

`recovery.h` не збирається на хості (тягне за собою дисплей і веб), тому його
правила не перевіряло **ніщо**. Чиста їх частина — перелік проблем, таблиця
кроків і сам планувальник — переїхала в новий `wizard_rules.h`, який збирається
де завгодно. `recovery.h` лишився тонким викликачем:

```c
g_wizActN = wizPlanIssues(d.issues, g_wizActs, WIZ_MAX_STEPS);
```

Заразом `wizActionName()` перейменовано на **`wizActionId()`**: функція повертає
машинний код кроку для JSON, а «назву» для людини віддає `wizActionMeta()`.
Однакові імена для різних речей — це те, з чого починається наступний дефект.

### 5. Прибрано зайве

Одинадцять функцій, яких ніхто не кликав: третя (і найслабша) копія
перешифрування `impresCryptRekey()`, дві обгортки паливоміра без шунта,
`adminOk()`, `decodeFactoryHealthTable()`, `fillRectExcept()`, `lighten565()`,
двійка розмірів заставки та інше. Дві **живі, але не ввімкнені** —
`chargeWakeGoalText()` і `chargeReasonIsDone()` — навпаки, під'єднані до
кольорового екрана: рядок пробудження там показував ціль сирим числом.

### Перевірено

* новий **16-й тест** `wizard_check` — вісім розділів: повнота переліку проблем,
  «кожна проблема має діагноз і пропозицію», «або крок, або пояснена
  відсутність», унікальність кодів кроків, «крок, що пише в чип, каже в який»,
  порядок плану (ремонт → шифрування → станція, перевірка завжди остання,
  «чіпів немає» обриває план) і сам план правки;
* `audit_check`, **новий розділ 6** — постійна перевірка автоправки: на 65 парах
  дампів вона спрацьовує **рівно один раз**, чіпає **тільки** байти 62/63, а в
  разі відмови не змінює **жодного** байта; окремо звірені **п'ять** причин
  відмови;
* `session_guard_check`, **новий розділ 44** — що правила справді винесено, що
  крок справді викликає `performDcaFix()`, що відкат при невдалому записі на
  місці й що прибрані функції не повернулись;
* звірка **від протилежного** — **24 поломки**, кожна валить свою перевірку.
  Саме вона знайшла і мертву умову (пункт 2), і те, що **всю автоправку не
  перевіряло ніщо**: ламай будь-яку її умову — усі тести лишались зеленими;
* усі **16 хостових тестів** зелені в обох конфігураціях ключа.

---

## 3.39. Версія пристрою без заряду — і шкала, що перестала стрибати кольором

Дві скарги, не пов'язані між собою, але обидві про те, що пристрій показує не те.

### 1. Прилад скаржився на блок живлення, якого в ньому не передбачено

Є екземпляри, зібрані **без силової частини**: ключа, дроселя, шунта немає, а
піни `CHARGE_*` нікуди не підключені. Прошивка в них та сама — переписувати її
під кожен варіант плати означало б тримати дві прошивки й лагодити кожну
знахідку двічі. Але на непід'єднаному `CHARGE_PSU_PIN` АЦП ловить наводку, і
пристрій сумлінно доповідав про несправний блок живлення.

Тепер заряд **вимикається на самому приладі**: чотири швидкі короткі натискання
кнопки зчитування (на трикнопковому складанні це «OK»). Ними ж і вмикається
назад. Стан лежить у `/device.cfg` і переживає перезавантаження — це
комплектація, а не настрій.

Вимкнений заряд означає **все відразу**:

* група **ЗАРЯД** зникає з меню пристрою **цілком**, разом із заголовком — не
  «сірі пункти»: сіре меню на пів-екрана в приладі, де заряду не передбачено, це
  не інформація, а перешкода;
* контроль живлення знято: не міряємо, отже й не судимо. Ні «!» у шапці, ні
  сторінки помилки, ні коду на світлодіоді;
* веб, USB-протокол і `.exe` відмовляють у старті заряду, ручних уставках,
  профілі й пробудженні;
* усі три клієнти показують **причину, що прийшла з пристрою**.

> ⚑ **ОДНЕ МІСЦЕ НА ВСЮ ПРОШИВКУ.** Прапорець не перевіряють по всьому коду —
> його враховує `chargeAvailable()`, а решта питає саме її. Тому вимикач і
> вийшов маленьким: меню, старт, пробудження й JSON уже вміли питати «а заряд
> узагалі доступний?» — їм просто почали чесно відповідати.

Тонких місць виявилось три, і кожне окремо перевіряється:

1. **Старий вимір не сміє просочитись.** Якби гейт стояв у місці вимикання, а
   не в читачів, останній вимір лишився б у пам'яті й далі означав
   «несправність» — а переміряти вже нікому: опитування в спокої теж вимкнене.
   Тому «не знаю» повертають самі `chargePsuState()`/`chargePsuMv()`.
2. **Заряд, що ЙДЕ, вимикач зупиняє.** Прапорець сам по собі нічого не гасить:
   машина заряду дивиться на свій СТАН. Без цього пристрій показував би «заряду
   немає», тримаючи ключ відкритим.
3. **Меню — не єдиний вхід.** Той самий код операції приходить із веба, з USB і
   зі збереженого сценарію Майстра. Сховати пункт і лишити дію робочою означало
   б вимкнути напис, а не функцію.

Заразом причина відсутності заряду стала **однією на всіх** (`chargeUnavailText()`
у прошивці). Причин дві, і вони вимагають різних дій: «не налаштовано» правлять
у `settings.h` і перепрошивають, а «версія без заряду» вмикається назад чотирма
натисканнями. Три власні копії цієї пари в клієнтах неминуче розійшлися б — веб
уже пояснював відсутність заряду **тільки першою** причиною.

### 2. Кнопки: один опит замість чотирьох

Щоб комбінацію взагалі можна було набрати, довелось прибрати давню дрібницю:
кожен режим (розряд, заряд, помилка живлення, меню) опитував кнопки **сам**,
своїм набором станів. Поки подія просто розгалужувалась, це працювало. Але
комбінація — це **ланцюжок**, і зібрати його з чотирьох незалежних детекторів
неможливо: перехід між сторінками починав би лік заново, бо рахував його вже
інший детектор. Тепер опит один на всі гілки.

Сама логіка комбінацій — у новому `combo.h`, окремо від обох драйверів екрана
(вони на хості не збираються). «Швидко» — частина умови, а не зручність: пауза
довша за 600 мс рве ланцюжок, і саме це робить комбінацію навмисною. Друге й
третє натискання ланцюжка звичайної дії **не виконують** — інакше дорога до
вимикача проходила б через «відкрити меню, натиснути пункт».

### 3. Шкала заряду: колір тече, а не стрибає

Було три сходинки: до 30 % червоний, до 60 % жовтий, далі зелений. На межі колір
стрибав, і два сусідніх показання — 29 і 30 % — виглядали як різні стани пакета,
хоча різниці між ними немає. Тепер колір заливки — **неперервна** функція
заряду: 0 % чистий червоний, 100 % чистий зелений.

> ⚑ **ЧЕРЕЗ ЖОВТИЙ, А НЕ НАВПРОСТЕЦЬ.** Пряма інтерполяція між червоним
> (255,0,0) і зеленим (0,255,0) на половині дає (128,128,0) — темну оливу,
> удвічі тьмянішу за обидва кінці. Шкала на 50 % світилася б слабше, ніж на 0 %
> і на 100 %, тобто «майже порожньо» читалось би яскравіше за «половина». Два
> відрізки через жовтий тримають яскравість сталою на всій довжині.

Написи, що фарбуються станом, лишились ступінчастими: дрібні гліфи проміжного
відтінку на чорному видно гірше, а колір **тексту** тут означає вирок
(«мало / середньо / добре»), а не рівень.

### 4. Дрібне: «©—» на USB-сторінці

Запис COPYRIGHT є не в усіх моделей — 4409A й APLI4810C його штатно не мають, і
рація такі пакети приймає. Веб і `.exe` писали це словами
(«— немає (норма для цієї моделі)»), а USB-сторінка — одним прочерком упритул до
«©». Тепер скрізь однаково.

### Перевірено

* `charge_logic_check`, **новий розділ 26** — вимикач знімає й функцію, і
  контроль живлення; підкинутий «несправний блок» крізь вимкнений заряд не
  проходить ні станом, ні вироком; заряд, що йде, зупиняється; причина відмови
  саме про версію пристрою, а не про `settings.h`; збереження просять рівно на
  зміну і рівно один раз;
* `menu_check`, **новий розділ 12** — `opNeedsCharge()` називає рівно операції
  групи ЗАРЯД (і «Заряд з напруги» до них НЕ належить: він нічого не заряджає й
  лишається робочим); група зникає цілком; решта каталогу на місці; стрибок по
  групах не потрапляє в порожню; курсор затискається; увімкнули назад — список
  той самий;
* `session_guard_check`, **нові розділи 45–47** — комбінації набираються
  навмисно й не набираються випадково (пауза рве ланцюжок, утримання рве,
  чужа клавіша відкочує); колір шкали монотонний, без стрибків і без провалу
  яскравості; і те, що вимикач справді ввімкнено в роботу на всіх поверхнях;
* звірка **від протилежного** — **28 поломок**, кожна валить свою перевірку.
  Вона ж знайшла **чотири** дірки в самих перевірках: відкат візерунка був
  половинчастим і ламався на зайвому натисканні; яскравість міряли сумою
  каналів, яка в обох варіантів однакова; затиск шкали «сходився» на 150 % через
  випадковість маски; а гейт веб-точок перевірявся «хоч десь у файлі», тобто
  лишався зеленим, якщо прибрати його з одного обробника;
* усі **16 хостових тестів** зелені в обох конфігураціях ключа.

---

## 3.40. Скинули лічильники — станція повернула їх назад. І вона мала звідки

Скарга власника, підкріплена трьома дампами поспіль одного пакета PMNN4409A —
**до скидання / після скидання / після зарядної станції**. Скидання спрацювало:
монітор обнулився, цикли обнулились, дату вписали. Пакет побував у зарядці — і в
моніторі знову **4797 / 4659**.

Питання власника було поставлене точно: *«може, ми не ті значення міняємо, або
станція запам'ятовує акумулятор — тоді чому різні станції не псують дані?»*
Обидві половини важливі, і відповідь на другу пояснює першу.

### Звідки числа

Байт-у-байт із самого пакета. У блоці `NONSMART` DS2433 — тому, з якого
читається лічильник не-IMPRES, — за зсувами **+3 і +5** лежить ще одна пара:
CCA і DCA **у тих самих сирих одиницях, що й монітор**. У дампах власника це
`0x156: 12 BD` і `0x158: 12 33`, тобто 4797 і 4659.

Ці поля ми **знали** — саме на них тримається правка побитого лічильника
розряду (3.38). Але жоден шлях скидання їх не чіпав: `impresNonImpresWrite()`
пише за зсувом **+7** і про сусідів не знає. Тобто «скидання лічильників»
лишало в пакеті повну історію — і чесно дивувалось, чому вона повертається.

> ⚑ **ДОКАЗ, ЩО ЦЕ САМЕ ВОНИ, А НЕ ПАМ'ЯТЬ СТАНЦІЇ.** До скидання в моніторі
> було CCA = **4798**, а в DS2433 — **4797**. Після станції в моніторі опинилось
> **4797** — не колишнє монітірне число, а рівно те, що весь цей час лежало в
> пакеті. І паливомір (ICA = 53), який ми теж переписали, станція **не чіпала**:
> отже вона не відновлює знімок, а бере конкретні поля.

### Чому різні станції не псують пакет

Бо станція **не джерело правди й нічого не вигадує**: усе, що вона повертає в
монітор, вона за хвилину до того прочитала з DS2433 **того самого пакета**.
DS2433 — оригінал, DS2438 — робоча копія, яку станція час від часу
пересинхронізовує. Тому будь-яка станція дає той самий результат, а станція, яка
цього пакета ніколи не бачила, просто бере його числа як є.

Єдиний виняток — **наробіток ETM**, і він поводиться інакше: у дампах власника
після станції ETM = 394 102 703, тобто старе значення **плюс реальний час, що
минув** (16 463 с ≈ 4 год 34 хв). Це вже пам'ять станції за годинником, і
сперечатися з нею безглуздо — саме тому прошивка й каже: **наробіток правлять
ПІСЛЯ калібрування, а не до нього**.

### Що виправлено

`impresHistoryZero()` тепер обнуляє й цю пару (`impresHistCountersWrite()`), і
**звіряє результат тим самим читачем**, яким його читатиме станція. Якщо поля
переписати не вдалось — скидання чесно відмовляється, і монітор лишається
недоторканим: обнулений монітор проти живої історії гірший за пакет зі старими
лічильниками (це той самий стан, через який рація каже «невідомий акумулятор» —
3.15).

### Перевірено

* `reset_consistency_check`, **новий розділ 9** — на корпусі: поля є в **58**
  пакетах, у всіх 58 вони ненульові (тобто є що обнуляти — інакше перевірка була
  б порожньою), після скидання нульові в усіх, сума блока лишається цілою;
* окремо — що після скидання **правка лічильника розряду відмовляється**: джерела
  більше немає, і нуль за значення вона не бере. Монітор у цій перевірці
  ставиться завідомо побитим, а не нульовим: на нульовому правка відмовиться
  сама, і перевірка нічого не довела б;
* окремо — блок, який **читач розбирає, а писар ні** (довжина 40: читачеві досить
  8, писар вимагає не більше за 32). Саме в цю щілину скидання й провалилось би,
  якби не звіряло результат;
* звірка **від протилежного** — **6 поломок**, кожна валить свою перевірку. Вона
  ж показала, що три перші перевірки були написані не на той рядок: якщо
  скидання перестає обнуляти ці поля, воно не «лишає історію», а **відмовляється**
  — і цикл просто пропускає такий пакет, лишаючись зеленим. Додано окрему умову
  «скидання не почало відмовляти масово»;
* усі **16 хостових тестів** зелені в обох конфігураціях ключа.

---

## 3.41. Панель операції не поверталась у початковий стан — і одне поле відповідало на два питання

Дві скарги власника, і причина в них спільна: **у клієнтів не було дороги
«закрити підсумок»**. На пристрої його знімає будь-яка кнопка — так і задумано,
щоб результат устиг прочитати живий чоловік. А у вебі, на USB-сторінці й у
`.exe` такої дії не існувало **взагалі**: панель назавжди лишалась у стані
«завершено» / «аварія».

### 1. «Кнопка початку не повертається, панель показує попередній режим»

Прошивка розрізняє три різні питання про той самий сеанс, і в `charge.h` про це
написано прямо:

| Питання | Функція |
|---|---|
| чи зайняте залізо | `chargeWaking()` |
| яким показати **підсумок** | `chargeWakeShown()` |
| чи тримати панель на екрані | `chargeScreenActive()` |

Назовні ж віддавалось **одне** поле `wake` = `chargeWakeShown()`. Клієнти
використовували його для двох різних речей: і щоб намалювати вигляд панелі, і
щоб **сховати уставки разом із кнопкою «ПОЧАТИ ЗАРЯД»**. А `chargeWakeShown()`
лишається правдою **після** зупинки — інакше результат пробудження читався б під
заголовком «ЗАРЯД». Виходило:

> сеанс пробудження скінчився → підсумок висить → `wake = true` → кнопка старту
> заряду схована → закрити підсумок нічим → **кнопка не повернеться ніколи**.

Тепер JSON віддає **обидва** поля, і клієнти ховають уставки за `wakeRun`
(«режим ЙДЕ»), а вигляд підсумку малюють за `wake`.

### 2. «Оповіщення про обмеження функціоналу не працює»

Формально працювало: причина писалась у рядок стану панелі. Практично — ні:
один рядок дрібним серед показань, а всі кнопки лишались живими. Людина тиснула
«ПОЧАТИ ЗАРЯД» і діставала помилку замість пояснення.

Тепер це **видима плашка** з причиною, що прийшла з пристрою, а дії заряду —
старт, зупинка, пробудження — **вимкнені**. В усіх трьох клієнтах однаково.

### 3. Підсумок є чим закрити

Нові `POST /api/charge/dismiss` і `POST /api/discharge/dismiss`, команди
`CHARGE DISMISS` / `DISCHARGE DISMISS` по USB і кнопка **«✓ ЗАКРИТИ ПІДСУМОК»**
у всіх трьох клієнтах — вона з'являється саме тоді, коли підсумок є.

> ⚑ **Гейта «версії без заряду» на цій точці немає навмисно.** Вимикач заряду
> сам зупиняє заряд, що йшов, — тобто саме він і створює підсумок. Закрити
> гейтом дорогу до його прибирання означало б лишити на панелі напис, який уже
> нічим не прибрати.

### Перевірено

* `charge_logic_check`, **новий розділ 27** — на справжньому `charge.h`: поки
  режим іде, зайняті обидва питання; після зупинки залізо вільне, а підсумок
  лишається підписаним своїм режимом; `chargeDismiss()` знімає підсумок і режим
  перестає показуватись; на операції, що ЙДЕ, прибирання не діє;
* `session_guard_check`, **новий розділ 48** — що JSON віддає обидва поля з
  РІЗНИХ функцій прошивки; що обидві веб-панелі ховають уставки за `wakeRun` і
  **більше не** за `wake`; що кінцеві точки існують, підключені й не закриті
  гейтом; що всі три клієнти мають і дію, і кнопку, і показ недоступності;
* звірка **від протилежного** — **13 поломок**, кожна валить свою перевірку.
  Вона ж показала, що чотири перевірки шукали **згадку імені**, а не його
  **визначення**: кнопка з `onclick` лишає ім'я у файлі й тоді, коли самої
  функції вже немає, — тобто перевірка була зеленою на клієнті, де натискання
  валиться в порожнечу;
* усі **16 хостових тестів** зелені в обох конфігураціях ключа.

---

## 3.42. Темп комбінацій — 0.3 с на натискання

Власник задав темп: **0.3 с на натискання, допуск 0.1 с**. Тобто сусідні
натискання ланцюжка не сміють розходитись більш ніж на **0.4 с** — було 0.6 с.

Число розкладено на дві сталі (`COMBO_TAP_MS` і `COMBO_TAP_TOL_MS`), бо це два
різні рішення: бажаний темп і допуск до нього. Пауза, що рве ланцюжок, — їхня
сума, і в перевірках вона береться саме звідти: тест, який тримає власну копію
темпу, лишився б зеленим після його зміни.

Додано дві `#error`-межі. Знизу темп обмежує **антидребезг** кнопки: подія
народжується не раніше ніж через 25 мс після стійкої зміни рівня, і вікно,
зіставне з цим числом, зробило б комбінацію ненабиральною на живій руці. Зверху
— сам сенс комбінації: пауза в секунду й довша це вже звичайне гортання меню, і
таку комбінацію людина набере випадково. Обидві звірені на порушеній
конфігурації (`-DCOMBO_GAP_MS=90u` і `=1100u`) — спрацьовують.

`session_guard_check` розділ 45 доповнено: числа темпу закріплені прямо, а
поруч — прогін, що на заданому темпі комбінація набирається, а щойно вийшли за
допуск — уже ні.

---

## 3.43. Заряд, розряд і пробудження — одне вікно з вибором режиму

Три операції ніколи не йдуть разом: прошивка їх взаємно блокує, і кожен старт
перевіряє стан іншої машини. Але в клієнтах вони жили **трьома окремими
картками** поспіль, тож цей факт доводилось тримати в голові, а сторінку —
гортати, щоб знайти ту, що зараз працює.

Тепер це **одне вікно «Операція з пакетом»**, а режим обирається **випадаючим
списком**: Заряд / Розряд / Пробудження. На екрані рівно те, що стосується
обраного, — і так однаково у вебі, на USB-сторінці й у `.exe` (там список —
`ttk.Combobox`, а три рамки показуються тією ж логікою).

### Правило, на якому все тримається

> **Поки операція ЙДЕ — режим задає залізо, і список замкнений. Щойно
> скінчилась — список знову слухається людини.**

Обидві половини важливі, і саме на другій ми вже горіли (3.41): показувати
уставки заряду, коли працює розряд, означало б обіцяти керування, якого зараз
немає; але й замикати вибір **незакритим підсумком** не можна — так кнопка
«ПОЧАТИ ЗАРЯД» і зникала назавжди після сеансу пробудження.

Окремо: коли операція починається або закінчується, вікно **один раз**
перемикається на неї само. Інакше результат лишився б у прихованому блоці, і
людина шукала б, куди він подівся. Далі вибір знову вільний.

Заряд і пробудження ділять **спільний монітор**, але мають різні керування, тож
у режимі пробудження блок заряду лишається видимим, а його уставки — ні. Це те
саме розділення, що й у прошивці: `chargeWaking()` (зайняте залізо) проти
`chargeWakeShown()` (яким показати підсумок).

### Перевірено

* `session_guard_check` **розділ 48** переписано під нову будову: у клієнті один
  список режимів; три блоки, по одному на режим; показом відає ОДНА функція
  (друга копія цього рішення в опитувальнику розійшлася б із нею); вона бере
  поточний режим із того, що ЙДЕ на залізі, а уставки показує за ОБРАНИМ
  режимом; замикає вибір лише поки операція йде, і **не** замикає його
  підсумком; обидва опитування годують її станом; старого правила «ховати за
  підсумком» не лишилось ніде;
* звірка **від протилежного** — **8 поломок**, кожна валить свою перевірку;
* усі **16 хостових тестів** зелені в обох конфігураціях ключа, `check_page_js.py`
  і `client_audit.py` чисті.

---

## 3.44. Наробіток, записаний у пакеті, видно очима; допуск комбінацій — 0.4 с

### Чому знадобилось показати ці два числа

Скарга власника: «обнулив усе вручну, передернув у зарядку — цикли з датами
повернулись». Числа, з яких зарядна станція їх відновлює, лежать у DS2433
(блок `NONSMART`, зсуви +3 і +5) — і доти не показувались **ніде**. Щоб
перевірити, чи скидання до них дійшло, доводилось читати hex-дамп і рахувати
зсуви руками.

Тепер вони в картці лічильників окремим рядком **«Наробіток у пакеті
(DS2433)»** — у вебі, на USB-сторінці й у `.exe`. Читається це просто:

* **після скидання** там мусять бути нулі. Якщо ні — скидання до них не дійшло
  (стара прошивка або шлях повз `impresHistoryZero()`, наприклад ручна правка
  байтів);
* якщо після зарядки там **знову числа** — станція взяла їх саме тут.

Це не косметика: питання «звідки повернулись лічильники» більше не потребує
розбору дампа — відповідь видно на екрані до й після.

### Допуск комбінацій

Розширено з 0.1 до **0.4 с** на вимогу власника: на живій руці 0.1 с виявилось
замало. Темп лишився 0.3 с, тож найбільша пауза між сусідніми натисканнями
тепер **0.7 с**. Верхньої межі (1 с, за якою комбінація почала б набиратись
випадково під час гортання) це не перетинає.

---

## 3.45. Лічильники повертав не зарядний пристрій, а ЕТАЛОН

Власник описав кроки цілком: «Ремонт → Ремонт», усі значення в нуль, потім
**еталон і модель**, дати поточні, лічильники в нуль, знос 100 — зберіг,
передернув у зарядку, і все повернулось.

Скидання тут ні до чого: воно відпрацювало чесно (3.40, перевірено на корпусі
з 58 пакетів). У власника це видно прямо в таблиці синхронізації — стовпчик
**«У пакеті»** показував `CCA 0 / DCA 0`. Числа повернув наступний крок.

### Що знайшлось

Еталон — це **байт-у-байт знімок ЧУЖОГО, донорського пакета**. Панель правок
чесно перелічує, що з донорського буде замінено на реальне: паливомір, шунт,
`OFFSET` АЦП, наробіток, паспортна ємність, зашифровані дати й лічильники,
цикли. **Але в цьому переліку не було блока `NONSMART`** — а він несе ту саму
пару CCA/DCA, з якої зарядна станція відновлює монітор (3.40).

Тобто: скидання обнуляло пару, еталон одразу писав туди числа донора, і станція
робила те, що робить завжди, — переносила їх у монітор. Виглядало як «скидання
не працює».

На корпусі еталонів це видно однозначно: **із 9 еталонів, що мають цей блок,
ненульові числа несуть усі 9**.

> ⚑ **ТА САМА ПОМИЛКА, ЩО Й У 3.40, ПОВЕРХОМ ВИЩЕ.** Там «обнулити лічильники»
> знало не про всі поля; тут «замінити донорське на своє» знало не про всі
> поля. Обидва рази бракувало саме цієї пари — і обидва рази наслідок був
> однаковий: станція повертала числа, які ми вважали прибраними.

### Що виправлено

`restorePlanApply()` тепер **завжди** пише в блок `NONSMART` наробіток **самого
пакета** (а якщо взяти нема звідки — чистий чи стертий чип — нулі). Це не
вибіркова правка: числа донора описують ІНШІ банки, і вони не «інша думка», а
просто неправда про цей пакет — так само, як його шунт чи калібрування нуля
АЦП, які панель заміняє беззастережно.

> **Дослівне відновлення (`verbatim`) свідомо лишилось як було.** Його
> контракт — «байт-у-байт, нічого не міняємо», і саме тому воно найнадійніше на
> порожньому чипі. Хто обирає його, обирає й донорські числа.

### Перевірено

* `audit_check`, **новий розділ 7** — на справжніх еталонах і корпусі дампів:
  еталони цей блок мають (9 із 9 несуть ненульові числа — інакше перевірка була
  б порожньою); після відновлення в пакеті лишається **його** наробіток, а не
  донорський; сума блока ціла; на чистому чипі там нуль, а не донор;
* звірка **від протилежного** — **5 поломок**, кожна валить свою перевірку:
  прибрати правку, писати числа еталона, зробити правку необов'язковою,
  лишити донорське на чистому чипі, не перерахувати суму;
* усі **16 хостових тестів** зелені в обох конфігураціях ключа.

---

## 3.46. Майстер сам узгоджує наробіток із датою пакета

Повідомлення, з яким власник прийшов: «Напрацювання ETM (3859 діб) більше за
вік пакета (1 діб від 2026-08-20)». Прошивка це бачила давно й пояснювала
правильно — але **нічого не пропонувала**: `ISS_ETM_FOREIGN` свідомо стояв у
переліку «кроку не буде», з причиною «що саме писати — вирішує людина».

Власник попросив автоматизувати. Виявилось, що число тут **виводиться
однозначно**, і вирішувати нема чого.

### Звідки береться правильне число

Рація не питає DS2433 про «дату першого користування» — вона рахує її як
«зараз мінус наробіток» із монітора. Тому пакет, який щойно повернувся зі
станції, показує чужу дату: ЗП переписує наробіток своїм числом.

Узгоджений наробіток — це рівно стільки секунд, скільки минуло **від дати
першого запуску, записаної в самому пакеті**, до сьогодні. Це вже рахує
`restorePlanRecalc()`; новий крок лише вирішує, чи можна й чи варто застосувати.

### Новий крок «Узгодити наробіток із датою»

Пише наробіток **разом із мітками подій** (сторінка 2 монітора): станція вміє
відновити старе число з них, і правка одного регістра була б марною.

Стоїть **ПІСЛЯ калібрування** — до нього правити безглуздо, ЗП однаково
перепише. Порядок перевіряється тестом, а не наміром.

Відмовляється, а не вгадує, коли: пристрій не знає сьогоднішньої дати; у пакеті
немає дати першого запуску; наробіток уже узгоджений (допуск — доба: різниця в
години це округлення, а не розходження).

> ⚑ **ПІДІЙМАТИ НАРОБІТОК КРОК НЕ БЕРЕТЬСЯ.** Біда, заради якої він існує, —
> наробіток БІЛЬШИЙ за вік. Менший не поломка: пакет міг просто мало
> працювати, і «дорахувати» йому зношення означало б вигадати роботу, якої не
> було.

### Шоста мертва умова — і як її прибрано

Перша редакція вироку перевіряла вхідні дані по черзі: «є сьогодні?», «є
дата?», «порахувалось?». Звірка від протилежного показала, що **дві перші
умови мертві**: `restorePlanRecalc()` і так лишає нуль, коли бракує будь-чого з
них, тож до окремих перевірок справа не доходить.

Прибирати їх було б неправильно — тоді зникли б і різні ПРИЧИНИ відмови, а
мовчазна «щось не так» тут найгірша. Тому питання перевернуто: спершу
результат, а розбір «чому саме» — **всередині** відмови, де кожна гілка
досяжна й кожна дає свій текст. Тест тепер звіряє саме причину, а не лише факт
відмови.

### Перевірено

* `mirror_plan_check`, **новий розділ** — вирок на чистій функції: розходження
  бачить і ставить рівно вік пакета; наробіток менший за вік не чіпає; різниця
  в години — не розходження, а в кілька діб — розходження; кожна відмова
  називає свою причину; вписана вручну дата теж годиться як джерело;
* `wizard_check`, **новий розділ 9** — проблема тепер має крок, більше не
  значиться «залишеною без кроку», і крок стоїть ПІСЛЯ станції;
* `session_guard_check` **розділ 44** — крок справді виконується, бере вирок зі
  спільної функції, пише разом із мітками подій і відкочує при невдалому записі;
* звірка **від протилежного** — **11 поломок**, кожна валить свою перевірку;
* усі **16 хостових тестів** зелені в обох конфігураціях ключа.

## 3.47. Прилад називає свою збірку — бо двічі шукали правку там, де її немає

Двічі за цю роботу відбувалось одне й те саме, і обидва рази це коштувало дня
розбору: правку заливали, вона не з'являлась, робився висновок «не працює» — а
насправді в приладі лишалась стара прошивка. Один раз це визнав сам власник
(«була виконана помилка при прошивці»), другий раз — не з'ясовано досі.

Питання «а чи та прошивка взагалі в приладі?» — **перше** в будь-якому розборі,
і доти на нього не міг відповісти жоден клієнт. Дата збірки в проєкті була, але
лежала в `/api/fs`: веб-клієнт показував її на вкладці діагностики, куди
заглядають раз на місяць, а обидва USB-клієнти в ту кінцеву точку не ходять
взагалі — вони говорять із приладом по серійному порту.

### Куди відбиток покладено

Не в нову кінцеву точку, а **в потік, яким клієнт і так живиться**: інакше він
знову опиниться там, куди не заглядають.

* **веб** — у стан заряду (`chargeJson()`). Його опитують незалежно від
  вкладки: цим же потоком живиться аварія живлення, видима звідусіль;
* **USB** — у відповідь на `PING`. Це рукостискання виконується першим і
  завжди, тож збірку видно ще до читання пакета.

Показ — теж на видноті, а не в картці: у вебі та в `client_usb.html` це шапка,
що є на **кожній** вкладці, у `.exe` — заголовок вікна, видимий навіть із
панелі задач. Дату й час підставляє компілятор (`__DATE__`, `__TIME__`), тож
випадково збігтися вони не можуть.

### Сьома мертва умова — тут же, поруч

`client_usb.html` брав ім'я силового ключа з відповіді на `PING`:
`if(p.swName&&…)`. Але `swName` дає `INFO`, а не `PING` — умова **не могла
спрацювати жодного разу**, і підпис «силовий ключ» довічно лишався прочерком.
Перенесено в `refresh()`, до відповіді `INFO`, де поле справді є.

### Вартовий, який спершу стеріг порожнечу

Перша редакція розділу 50 шукала в `web_server.h` просто згадку `"build"` з
`__DATE__` — і **проходила навіть тоді, коли відбиток лишався тільки в
`/api/fs`**, тобто рівно в тому стані, заради виправлення якого розділ і
писався. Так само перевірка для `.exe` вимагала лише наявності функції та її
виклику: порожнє тіло лишало обидві згадки на місці.

Обидві знайдені звіркою від протилежного, обидві переписані на конкретне
місце: дописування саме до стану заряду (`j += ",\"build\"…`) і саме той рядок,
що пише заголовок вікна.

### Перевірено

* `session_guard_check` **новий розділ 50** — прошивка називає збірку в обох
  потоках, кожен із трьох клієнтів має де її показати і справді заповнює це
  місце з відповіді пристрою; мертву умову з `p.swName` не повернули назад;
* звірка **від протилежного** — **11 поломок**, кожна валить свою перевірку
  (дві з них спершу не валили нічого — див. вище);
* усі **16 хостових тестів** зелені в обох конфігураціях ключа,
  `check_page_js.py` і `client_audit.py` — теж.

## 3.48. «Узгодити неможливо» — бо нуль сплутали з «не знаю»

Власник: «Майстер — саме там і пробував. Повідомлення про неможливість
узгодити». Крок був на місці, кнопка натискалась — і відмовляла. Причина
виявилась не в кроці, а в тому, що **нуль діб** у двох різних місцях читався
як «порахувати не вдалося».

### Що робить власник під час ремонту

Ставить **поточні дати** («даты текущие, счетчики в ноль»). Після цього:

* вік пакета = сьогодні − дата виготовлення = **0 діб**;
* узгоджений наробіток = сьогодні − дата першого запуску = **0 діб**.

Обидва нулі **правильні**. А в моніторі після станції — тисячі діб. Це
найгрубіше розходження, яке взагалі буває, і саме воно не оброблялось.

### Дві умови, які плутали нуль із невідомим

**Перша — вирок кроку.** `restoreEtmFixPlan()` питав `p.etmCalc <= 0` і йшов у
розбір причин відмови. Але нуль тут — законна відповідь: пакетові рівно нуль
діб. Крок відмовляв рівно тому пакетові, заради якого писався.

Поле, яке відрізняє одне від одного, **вже існувало**: `p.etmUseDate`, і в
коментарі до нього так і написано — «ознака "порахувалось", бо 0 діб теж
число». Вирок його просто не питав. Тепер питає.

Заодно виправлено сусіднє: дата **в майбутньому** тихо перетворювалась на нуль
(`if (days < 0) days = 0;`), і зіпсоване ставало невідрізненним від законного
«запущено сьогодні». Тепер така дата не вважається порахованою взагалі.

**Друга — правило «монітор чужий».** `impresEtmForeign()` вимагав `ageDays > 0`.
Пакет із сьогоднішньою датою виготовлення діставав вердикт «нема з чим
порівнювати», проблема не позначалась, і Майстер **не пропонував кроку
взагалі**. При цьому три клієнти рахують те саме правило **без** цієї умови —
і попередження на картці даних показували. Виходило «прилад скаржиться, а
полагодити не пропонує».

«Невідомо» тепер позначається **від'ємним** віком, а не нулем — і в правилі, і
в плані дзеркала (`haveAge`), і в місці, де вік рахують.

### Відмова тепер називає свої числа

Текст «узгодити неможливо» коштував доби листування: з нього не було видно, яку
дату прилад узяв за сьогодні, яку прочитав у пакеті й скільки діб побачив у
моніторі. Тепер числа в самому повідомленні:

> наробіток уже узгоджений із датою пакета: у моніторі 1 діб, за датою
> 2026-08-20 — 1 діб

### Перевірено

* `mirror_plan_check` — пакет, запущений СЬОГОДНІ, крок узгоджує й ставить
  нуль; **новий розділ** про те, що саме вважається «порахувалось» (перевіряє
  живий `restorePlanRecalc()`, а не вручну виставлені числа); нульовий вік із
  тисячами діб у моніторі — підозра, десяток діб — ні;
* `audit_check`, **новий розділ 8** — наскрізно на корпусі: **41 пара** з
  наробітком понад допуск, і при віці 0 діб помічені **всі 41**. Тест валиться
  й тоді, коли жодна пара не підійшла: інакше він доводив би порожнечу;
* `session_guard_check` розділ 44 — обидві умови стережуться поіменно, щоб їх
  не «спростили» назад;
* звірка **від протилежного** — **11 поломок**, кожна валить свою перевірку;
* усі **16 хостових тестів** зелені в обох конфігураціях ключа.

## 3.49. Вимикач заряду переїхав на утримання — і драйвер екрана нарешті збирається

Власник замінив жест: замість чотирьох швидких натискань — **утримання «OK»
п'ять секунд**. Причина видна із самої заміни: ланцюжок треба набрати в темпі
й нічим при цьому не керуватись, а утримання — просто тримати й дивитись на
екран, який сам каже, що буде далі.

### Головне в цій правці — не сам жест, а колізія

На «OK» уже висіло **довге натискання = ВИКОНАТИ операцію** (скидання, ремонт,
очистка) з порогом 0.8 с. Якби до нього просто додали поріг 5 с, дорога до
вимикача проходила б через **уже виконану** операцію: на 0.8 с зробилось би
скидання, і аж потім, на 5 с, перемкнувся б заряд.

Тому «довге» на цій кнопці тепер вирішується **на відпусканні**, а не на
порозі. Щоб ніхто не тримав наосліп, на кожній сходинці екран пише, що буде,
якщо відпустити зараз:

| Тримаєте | На екрані | Якщо відпустити |
|---|---|---|
| до 0.8 с | — | звичайне коротке |
| від 0.8 с | «відпустіть = ПУСК» / «= ВИКОНАТИ» / «= ЗЧИТАТИ» | звичайна дія |
| від 5 с | «відпустіть = ЗАРЯД ВИМК/УВІМК» | заряд перемикається |

Підказка на 0.8 с з'являється **лише там, де довге натискання справді щось
робить**. Обіцяти «відпустіть = ПУСК» на пункті-сторінці або безпечній
операції гірше, ніж мовчати: людина відпускає, нічого не стається, і наступного
разу вона вже не вірить жодній підказці.

⚠️ **На екранах заряду й розряду жестів немає взагалі.** Там утримання — це
аварійна зупинка, і вона мусить спрацювати на порозі: «відпустіть, і тоді
зупиниться» — це вже не зупинка.

### Що видалено

Уся механіка ланцюжків: лік натискань, відкат Кнута—Морріса—Пратта, допуск
темпу з обома його межами, таблиця візерунка. Тримати її «про запас» було б
гірше, ніж не мати: мертвий код, який виглядає продуманим, не викликає підозр
і живе роками.

### Драйвер екрана вперше збирається на хості

Це найдорожча частина правки, і зроблена вона не заради краси. `display_color.h`
був **єдиним великим файлом проєкту без жодної збірки**: усі перевірки для
нього текстові («чи є в файлі такий виклик»), а текст не бачить ні описки в
імені поля, ні зайвої дужки. Знаходилось це в Arduino IDE — тобто вже після
того, як прошивку залили в прилад. Один раз саме так і вийшло: власник побачив
чорний екран, і день пішов на розбір, чи винна правка.

Заглушки (`tools/fake/`: SPI, Adafruit_GFX, Adafruit_ST7789, U8g2, FS, SPIFFS,
TJpg_Decoder, ядро ESP32) малюють у нікуди — питання, на яке відповідає ця
збірка, рівно одне: **чи компілюється драйвер**. Складання перевіряється те,
що стоїть у власника (ST7789 240×240); монохромний шлях (u8g2) туди не входить
— у нього десяток класів на кожну модель екрана, і заглушки коштували б
більше, ніж дають. Це сказано й у виводі тесту, щоб «зелено» не читалось як
«усе покрито».

> ⚑ **Функції треба ще й КЛИКНУТИ.** `inline`-функція, яку ніхто не викликає, у
> C++ не інстанціюється повністю — тіло лишилось би неперевіреним, і
> «зібралось» нічого б не значило. Тому тест справді викликає
> `displayHandleButton()`, `holdLongHint()` і решту.

### Перевірено

* `display_build_check` — **новий тест**, драйвер ST7789 збирається й
  зв'язується; звірка від протилежного валить його одним переплутаним символом
  у назві поля, зайвою дужкою й описки в імені функції;
* `session_guard_check` **розділ 45 переписано** — сходинки не плутаються між
  собою: коротке лишається коротким, «довге» вирішується на відпусканні, 5 с
  дають попередження і перемикають заряд на відпусканні, кожна сходинка
  оголошується рівно один раз, скидання забирає натискання цілком, а вісім
  неповних утримань нічого не накопичують;
* `session_guard_check` **розділ 47** — обидва драйвери справді питають
  детектор, передають кнопці жестів `holdLongMs` (а не `BTN_LONG_MS`) і
  вимикають жести на екранах операцій;
* `#error`-межі між сходинками — звірені на порушеній конфігурації, всі три
  спрацьовують;
* звірка **від протилежного** — **16 поломок**, кожна валить свою перевірку;
* усі **17 хостових тестів** зелені в обох конфігураціях ключа.

## 3.50. «Заряд недоступний» — вікном із «ОК», а не підказкою, що зникає сама

Власник: «Помилка: Ця версія пристрою — без заряду… — потрібно виводити у
вигляді вікна повідомлення з кнопкою ОК унизу вікна».

Скарга по суті. Ця відмова пояснює, чому **зникла ціла група меню** — а
показувалась спливаючою підказкою, яка живе три секунди. Людина встигала
прочитати «Помилка:» і лишалась із питанням «а що це було?».

### Пристрій позначає відмову КОДОМ, а не тільки текстом

Клієнт мусить відрізнити цю відмову від будь-якої іншої. Робити це за рядком
означало б, що перше ж переформулювання тихо поверне спливаючу підказку. Тому
обидва гейти — веб (`chargeGateClosed()`) і USB (`CHARGE …`) — додають
`"code":"nocharge"`, і клієнти дивляться саме на нього.

### Одне місце на клієнта, а не одне на кнопку

Перехоплення стоїть там, де відповідь приходить: у вебі — в `postForm()`, у
`client_usb.html` — у `finish()` черги команд, у `.exe` — у `_poll()`.
Кінцевих точок заряду **п'ять**, і шоста, дописана завтра, поведеться так
само без жодної правки.

### Плашка лишається — вікно її не замінює

У них різні задачі: вікно відповідає на питання «чому не працює» тоді, коли
його ставлять, а плашка тримає відповідь на видноті потім. Прибрати плашку
означало б, що людина, яка натиснула «ОК» і повернулась за хвилину, знову
нічого не розуміє. Плашка тепер **клікабельна** — відкриває те саме вікно.

Вікно показується **один раз на причину**, а не на кожне опитування: стан
заряду опитується щосекунди, і вікно, прив'язане до самого факту
недоступності, неможливо було б закрити. Закривається кнопкою «ОК», клавішею
**Esc** або кліком повз вікно — вікно, яке закривається лише мишею, це пастка
для того, хто працює з приладом однією рукою.

У `.exe` це **рідне вікно системи** (`messagebox`), а не намальоване своє: там
воно вже модальне, вже з «ОК» і вже зрозуміле користувачеві Windows.

### Перевірка клієнтів упіймала першу ж редакцію

Закриття кліком повз вікно спершу було написане умовою прямо в розмітці:
`onclick="if(event.target===this)msgClose()"`. `client_audit.py` це завалив —
він читає розмітку й імені функції в такому виразі не бачить. Правильна
відповідь тут не «послабити перевірку», а назвати функцію: `msgBackdrop(event)`.

### Перевірено

* `session_guard_check` **розділ 47** — пристрій позначає відмову кодом в
  обох гейтах; кожен із трьох клієнтів має вікно, кнопку «ОК» унизу, упізнає
  відмову **кодом** і закривається не лише мишею;
* `client_audit.py` — розмітка лишається придатною для розбору;
* звірка **від протилежного** — **13 поломок**, кожна валить свою перевірку;
* усі **17 хостових тестів** зелені в обох конфігураціях ключа.

## 3.51. Один список замість дванадцяти карток: ручний редактор значень

Власник: «виконати в окремій закладці ручне редагування всіх змінних, з якими
зараз працюємо: усі лічильники, дати, наробітки, виробітки, рівень заряду.
Якщо десь вони дублюються в інших вкладках — видалити звідти».

### Чому це не «ще одна вкладка»

Кожне з цих значень **уже** мало свою кнопку, свій пароль і свою підказку — і
жило в іншому місці: ємність в одній підвкладці, знос у другій, дата в третій,
а цикли взагалі правились лише **всередині планів синхронізації**. Через це не
було жодного місця, де видно ВЕСЬ стан пакета одразу, — а саме він і потрібен,
коли розбираєш, чому пакет поводиться дивно.

Тепер список один — **15 полів**, згрупованих за чипом:

| DS2433 — памʼять самого пакета | DS2438 — монітор |
|---|---|
| дата виготовлення, дата першого запуску, дата останнього заряду, дата останнього кондиціювання | наробіток (доби) |
| цикли IMPRES, цикли не-IMPRES, калібрувальні цикли | лічильник заряду, лічильник розряду |
| наробіток у пакеті: заряд і розряд | залишок (паливомір ICA) |
| паспортна ємність, знос | |

Назви, одиниці, межі й правила узгодженості живуть **в одному файлі**
(`edit_plan.h`), а всі три клієнти лише показують те, що назвав пристрій. Своя
копія списку в кожному клієнті розійшлася б на першій же правці — у цьому
проєкті так уже було з іменем силового ключа й із причиною недоступності
заряду.

### Дати живуть ЗМІЩЕННЯМИ, і це змінює все

У зашифрованому блоці лежить дата **виготовлення**, а «перший запуск»,
«останній заряд» і «останнє кондиціювання» — це кількість діб **від неї**.
Тому:

* посунути дату виготовлення й не зачепити решту **неможливо** — похідні дати
  перераховуються завжди, інакше незаймана «дата останнього заряду» тихо
  поїхала б слідом;
* нуль у похідній даті означає **«події не було»**, а не «сталась у день
  виготовлення», — і лишається законним значенням;
* дату виготовлення нулем **не прибрати**: без неї решта не має від чого
  рахуватись.

### Головне тут — не запис, а ВІДМОВА

Суперечливий набір — «вмикали, але жодного разу не заряджали», «запуск раніший
за виготовлення» — це рівно те, що станція потім «лікує», повертаючи свої
числа. Редактор, який дозволяє такий набір скласти, працював би проти всієї
решти проєкту. Тому:

* межі кожного поля називає пристрій, і відмова каже, які саме («4321 — поза
  межами 0…255»);
* **набір звіряється ЦІЛКОМ, а не поле за полем**: людина може посунути дату
  виготовлення й дату запуску одним заходом, і кожна з них окремо виглядає
  безглуздою рівно доти, доки не побачиш другу;
* дата в майбутньому не приймається взагалі.

### Що прибрано з інших вкладок

Із «Ремонт → Значення» у вебі, USB-клієнті й `.exe` пішли чотири картки:
залишок у мА·год, рівень заряду у відсотках, дата (ETM) і знос. Лишились дві —
і обидві **не дублі**:

* **«Заряд за напругою»** нічого не вписує, а **міряє**: бере напругу на
  клемах, рахує за нею відсоток і кладе в паливомір;
* **заводський байт 0x129** лежить у таблиці моделі, однаковій у всіх
  екземплярів, — правка там не змінює показань рації, і в Редакторі його немає
  навмисно.

У `.exe` заодно перейменовано стару вкладку «Редактор» на **«HEX»**: вона
правит сирі байти, і два «Редактори» поруч читались би як помилка.

### Перевірено

* `edit_plan_check`, **новий тест** — не «функція повертає true», а результат
  на **66 справжніх дампах**: прочитали → змінили → прочитали ще раз і
  звірили. Дев'ять полів туди-назад; правка не чіпає ані сусідні значення, ані
  суму заголовка; знос ходить у відсотках, а не сирим CTS; похідні дати не
  їдуть за виготовленням; шість різних неможливих наборів відхиляються, кожен
  зі своєю причиною; порожній план не змінює жодного байта;
* `session_guard_check` **новий розділ 51** — список доходить до всіх трьох
  клієнтів, кожен бере назви й межі **з пристрою**, звірка набору стоїть після
  всіх полів, а старі дубльовані картки прибрані й не повертаються;
* звірка **від протилежного** — **18 поломок**, кожна валить свою перевірку
  (чотири з них спершу не валили нічого: дві перевірки були заслабкі, і два
  вартові стерегли згадку імені замість його вживання);
* усі **18 хостових тестів** зелені в обох конфігураціях ключа,
  `check_page_js.py` і `client_audit.py` — теж.

## 3.52. Помилку введення в редакторі виправляють, а не відхиляють

Власник: «у редакторі при помилці внесення даних додати автовиправлення».

Прохання по суті. У кожної тутешньої помилки є **одна очевидна правильна
відповідь**, і відмова змушувала гадати, яка саме: вписали 6000 туди, де стеля
255, — малось на увазі 255; вписали дату наступного року — малось на увазі
«сьогодні»; вписали 45-те число — малось на увазі останнє в місяці.

### Що саме виправляється

| Ввели | Стане | Чому |
|---|---|---|
| число поза межами | найближча межа | межі називає прилад, вони видні в самому рядку |
| дата в майбутньому | сьогодні | пакета, який почав працювати завтра, не буває |
| 13-й місяць, 45-те число | 12-й, останнє в місяці | покомпонентно, з урахуванням високосного року |
| нуль у даті виготовлення | та, що вже стоїть | без неї решті нема від чого рахуватись |
| запуск (заряд, кондиціювання) раніший за виготовлення | підтягується до виготовлення | дати живуть **зміщенням** від нього |
| «вмикали, але жодного разу не заряджали» | заряд у день першого запуску | найменша правда, яка це розв'язує |

### Але ніколи мовчки

«Виправлено» без пояснення нічим не краще за «не можна»: і те, і те лишає
людину без розуміння, куди поділось її число. Тому кожна правка називається —
`Знос: 140 → 100 (межі поля 1…100)` — і доїжджає до клієнта окремим полем
відповіді.

Показується це двічі, і по-різному навмисно:

* **при введенні** — підказкою, одразу, щойно ви виходите з поля;
* **після запису** — вікном із «ОК»: там ідеться про те, що вже лягло в пакет,
  і зникати саме через три секунди воно не має права.

### Хто що виправляє

Клієнт притискає до `lo`/`hi` й до «сьогодні» — це **дані**, що прийшли разом
зі списком полів. Складніші правила (13-й місяць, 30 лютого, суперечливий
набір дат) лишаються **на приладі**: тримати їхню копію в кожному клієнті
означало б, що після першої ж правки прошивки клієнт виправляє інакше, ніж
прилад, — а це гірше, ніж не виправляти зовсім.

Виправляє клієнт **на виході з поля**, а не на кожному натисканні: у полі з
нижньою межею 1000 перша ж набрана «1» стрибнула б у 1000, і дописати число
стало б нічим.

### Де відмова лишилась

Там, де виправляти нема чого: поля з такою назвою немає; блок, у якому воно
живе, не читається; суперечність є, а полагодити її нічим (наприклад, дата
останнього заряду не читається взагалі). Вигадувати значення в таких випадках
було б гірше за чесне «не можу».

### Починка йде в цикл, і це не перестраховка

Одна правка створює наступну. Посуньте виготовлення вперед і скажіть «не
заряджали жодного разу»: перший прохід підтягне запуск до виготовлення, а
заряд — до **старого** запуску; після цього заряд знову раніший за
виготовлення, і виправляє це лише другий прохід. Верхня межа (три проходи)
стоїть, щоб помилка в правилах дала відповідь, а не вічний цикл.

### Перевірено

* `edit_plan_check`, **розділи 7 і 7б переписані** — перебір притискається до
  потрібної межі; 20251345 стає 2025-12-31, а 30 лютого високосного року —
  29-м; майбутнє стає сьогоднішнім, але **без годинника майбутнє не
  вигадується**; нуль у даті виготовлення лишає ту, що стоїть, а в похідній
  даті лишається законним; **правильне число не виправляється** (без цього
  рядка розділ доводив би, що правиться все підряд); суперечливий набір
  лагодиться мінімально й завжди в один бік; ланцюжок із двох проходів
  сходиться; несуперечливий набір не чіпається;
* `session_guard_check` **розділ 51** — обидва гейти лагодять набір, пристрій
  каже, що саме виправив, **у відповіді на запис**, і всі три клієнти
  виправляють при введенні та показують правки приладу;
* звірка **від протилежного** — **20 поломок**, кожна валить свою перевірку;
* усі **18 хостових тестів** зелені в обох конфігураціях ключа.

## 3.53. Четверте місце, де пакет тримав наробіток: третя мітка, у добах

Власник поставив рішучий дослід — той самий, якого бракувало весь цей час:

> «У редакторі при чистому DS2433 обнулив лічильник наробітку монітора, після
> вставив у зарядку, витягнув і перечитав — дані наробітку змінились і стали
> **4545**.»

DS2433 чистий. ETM обнулений. Обидві 32-бітні мітки подій — теж (їх обнуляє
`impresSetEtm`). Узятись числу не було звідки. Отже, ми чогось не знали.

### Що знайшлось

Двобайтове поле за **0x32** DS2438. Це **та сама подія, що й мітка2, але
записана в ДОБАХ**. Знайдено так само, як і дві перші мітки, — перебором по
корпусу з 62 моніторів із ненульовим наробітком:

| Гіпотеза | Точних збігів | ≤1 доби | Медіана різниці |
|---|---|---|---|
| ETM у добах | 15 | 17 | 14 |
| мітка1 у добах | 19 | 22 | 7 |
| **мітка2 у добах** | **46** | **51** | **0** |

Сусідні 0x34..0x37 і 0x3A..0x3B такої відповідності не дають **жодній**
величині (медіана різниці — тисячі), тож їх не чіпаємо: писати в поле,
призначення якого не встановлене, — це той самий ризик, від якого ми лікуємо
пакет.

### Доказ, а не здогад

У корпусі лежить дамп, який показує це прямо:

> `dumps/19-stantsiya-dobudova/01_2438` — ETM 0, мітка1 0, мітка2 0, CCA 0 —
> **і 4015 діб у 0x32**

Тобто скидання зроблене бездоганно за всім, що ми знали, а пам'ять про
наробіток лишилась. Із 65 моніторів корпусу мітка є у **63**.

Механізм — той самий, що вже описаний для двох перших міток (3.30): станція
бачить неможливий стан «подія сталася пізніше, ніж пакет працював», і лікує
його очевидним чином — **підтягує наробіток до мітки**. Різниця лише в тому,
що цю мітку ми лишали недоторканою.

### Що зроблено

`impresSetEtm()` тепер притискає й третю мітку — у добах, бо саме в добах вона
й міряється. Правило лишається в одному місці, тож обнуляється вона скрізь, де
обнуляється наробіток: скидання лічильників, ремонт, Майстер, редактор.

**Притискає, але не піднімає**: подія не могла статись пізніше, ніж була.

Заодно мітка стала **видимою в редакторі** окремим рядком «Мітка останньої
події». Доти побачити її можна було лише в hex-дампі — і власник не мав чим
показати, звідки взялось число. Задати мітку пізнішу за наробіток редактор не
дасть: це рівно той стан, який станція лікує.

### Перевірено

* `reset_consistency_check`, **новий розділ 10** — на корпусі: мітка є в 63
  моніторах із 65, після скидання не лишається **в жодному**, і в корпусі
  справді є дамп, де вона пережила бездоганне скидання (без цього рядка
  перевірка доводила б порожнечу); правка наробітку її притискає й **не**
  піднімає;
* `edit_plan_check`, **новий розділ 7в** — мітка видима в списку й належить
  моніторові; задана пізнішою за наробіток — суперечність, яку виправляє
  починка; задана коректно — доїжджає до чипа й не затирається наробітком
  (для цього її й пишуть ПІСЛЯ нього);
* `session_guard_check` **розділ 51** — мітка описана в карті монітора,
  притискається правкою наробітку й читається редактором;
* звірка **від протилежного** — **10 поломок**, кожна валить свою перевірку.
  Найкорисніша: підміна адреси 0x32 на 0x34 валить саме «є дамп, де вона
  пережила бездоганне скидання» — тобто адресу тримає доказ, а не наша віра;
* усі **18 хостових тестів** зелені в обох конфігураціях ключа.

## 3.54. Досить перебирати корпус: знімок «до станції» і побайтова різниця

Після 3.53 власник повторив дослід — і дістав **інше** число: **3844** замість
4545. Це саме по собі корисно: якби число просто відновлювалось із одного
місця, воно б повторилось. Але далі знову починався б той самий шлях.

### Шлях, який більше не годиться

Чотири рази поспіль розбір «звідки повернулось число» йшов однаково: власник
називає число — ми перебираємо корпус — шукаємо поле, яке його дає.

| Знайдено | Де |
|---|---|
| 3.30 | дві мітки подій у секундах, DS2438 0x10 / 0x14 |
| 3.40 | CCA/DCA у блоці NONSMART, DS2433 |
| 3.53 | третя мітка, у добах, DS2438 0x32 |

Кожного разу це коштувало днів. І, головне, воно працює **лише тоді, коли
потрібне поле вже є в чиємусь дампі**. Поля, якого в корпусі немає, цим
способом не знайти взагалі.

### Пряме вимірювання замість перебору

Зняли знімок обох чипів **до** станції, зняли **після** — і подивились, які
саме байти вона змінила. У вкладці «✍️ Редактор» з'явилась картка **«📸 Знімок
і різниця»**:

> зчитайте АКБ → **«Зняти знімок»** → у зарядку → назад → «Зчитати АКБ» →
> **«Порівняти»**

Знімок живе в SPIFFS (576 байтів) і переживає перезавантаження.

### Чому побайтово, а не «по полях»

Поля ми показуємо теж — але саме вони й є те, що ми **вже знаємо**. Поле,
якого ми не знаємо, у список полів не потрапить за визначенням, і різниця по
полях його не покаже. Тому основа — сирі байти, а імена підписують лише ті з
них, які нам відомі.

> ⚑ **Байт без імені — це не прогалина, а знахідка.** Рядок «невідоме поле»
> означає рівно одне: станція пише туди, куди ми не дивимось. Тому вигадувати
> назви невідомим байтам не можна — це заховало б саме те, заради чого все й
> написано.

### Прогін рветься на межі поля

Перша редакція збирала сусідні змінені байти в один прогін і брала ім'я з його
початку. На живій парі з корпусу це дало рядок `0x32..0x35 МІТКА 3 (доби)` —
хоча мітка це лише `0x32..0x33`, а `0x34` ми не знаємо взагалі. Тобто знахідка
приїхала б **під чужим, заспокійливим іменем**. Тепер там, де змінюється
підпис, починається новий прогін, і та сама пара дає два рядки:
`0x32..0x33 МІТКА 3` і `0x34..0x35 (невідоме поле)`.

### Перевірено

* `snapshot_diff_check`, **новий тест** — різниця знаходить зміну в **кожному**
  з 64 байтів монітора (перебором, а не на одному прикладі); сусідні байти
  збираються в одну ділянку, але прогін **рветься на межі поля**; переповнення
  переліку не ховається, а лічильник байтів рахує всі, не лише показані;
  невідомі байти лишаються без назви; на живій парі з корпусу видно 12 ділянок
  зміни, серед них дві — невідомі поля;
* `session_guard_check` **розділ 51** — знімок і різниця віддані клієнтові,
  різниця підписує ділянки з розривом на межі поля, а клієнт показує
  невідомі байти окремим кольором;
* звірка **від протилежного** — **12 поломок**, кожна валить свою перевірку;
* усі **19 хостових тестів** зелені в обох конфігураціях ключа.

## 3.55. Два пристрої — один код: топологія заряду стала опцією

**Задача.** У сховищі жили дві прошивки: у корені — попередній пристрій на
готовій платі DC/DC (TL494), у `battery_reader_china_chr/` — новий, із власним
понижувачем. Півсотні змін останніх місяців (редактор значень, знімок і
побайтова різниця, майстер відновлення, комбінації кнопок, чорний ящик,
кольоровий екран, третя мітка наробітку) дісталися лише другому. Треба було
віддати їх і першому — **зберігши його підключення**.

**Чому не можна було просто скопіювати.** Зарядне залізо в них різне не
номіналами, а способом керувати й вимірювати:

| | понижувач | плата TL494 |
|---|---|---|
| чим керуємо | шпаруватістю ШІМ на власний ключ | вихідною напругою: enable + аналогова уставка |
| звідки струм і напруга | власні шунт і подільник | DS2438 **усередині пакета** |
| темп зворотного зв'язку | АЦП, мілісекунди | 1-Wire, раз на секунду |
| контроль +14 В, пік струму, свідок насичення клеми | є | нема чим міряти |

**Рішення — одна шкала на дві топології.** Увесь верхній рівень (профілі,
фази, аварійні відсічки, ETA, ручні уставки) написаний у термінах
«шпаруватості» — числа, яке регулятор підкручує, женучись за струмом. Для
понижувача це відліки ШІМ. Для TL494 один «відлік» тепер означає **один
мілівольт цільової вихідної напруги**, а перекладом «мВ → напруга керування»
займається калібрувальна таблиця в найнижчій точці (`chargeSetDuty`).

Так зроблено не заради краси. Крива керування TL494 різко нелінійна — унизу
діапазону 20 мВ керування дають кілька вольтів на виході, — і крок регулятора
в «сирих» одиницях мав би зовсім різний ефект на різних ділянках. У
міліволтах виходу крок означає одне й те саме скрізь, а верхній рівень
узагалі не мусить знати, яке залізо під ним.

**Що на платі TL494 стало НЕДОСТУПНИМ — і сказано про це прямо.** Контроль
живлення +14 В, пікова відсічка, свідок насичення клеми й **примусове
пробудження**. Останнє — окремо: режим подає напругу на пакет, який мовчить, і
все, що стоїть між ним і зіпсованим пакетом, — це три ВЛАСНІ виміри (струм на
закритому ключі, напруга на закритому ключі, струм під час розгону). На цій
платі всі три приходять із DS2438, тобто саме звідти, звідки заблокований
пакет не віддає нічого. Тож запобіжники не стали б «менш точними» — вони
стали б сліпими й завжди відповідали б «усе гаразд». Відповідь чесна:
`WAKENO_TOPO`, з поясненням у тексті відмови.

**Що знайшлося по дорозі — дефекти, а не косметика.**

* **`chargePsuPoll()` відповідав інакше, ніж усі інші читачі живлення.** Гейт
  «немає давача → PSU_UNKNOWN» стояв УСЕРЕДИНІ `#ifdef CHARGE_PSU_PIN`, тож
  без подільника функція віддавала сире `g_psuState`, тоді як
  `chargePsuState/Mv/Fault` віддавали «не знаю». Дев'ятий випадок родини «одне
  поле, два питання». Стосувалось не лише нової плати: те саме було в збірці
  понижувача з закоментованим `CHARGE_PSU_PIN` — а це документований,
  підтримуваний варіант.
* **Скетч перестав гасити enable найпершим рядком.** Стара прошивка кореня
  опускала GPIO32 у `setup()` до всього іншого; у новій той блок був написаний
  під піни понижувача, і на платі TL494 не робив нічого. `chargeInit()`
  кличеться на сотню рядків нижче — після дисплея, SPI й Wi-Fi. А плата
  пропускає вхід на вихід (~14 В) БЕЗ керування, тож поки пін висить входом,
  після скидання сторожем посеред заряду каскад цілком міг лишитись
  увімкненим. Рядок повернено, і тепер його стереже окрема перевірка.
* **`serial_api.h` не зібрався б для TL494 узагалі** — віддавав клієнтам
  `CHARGE_SW_NAME`, ім'я ключа, якого на тій платі не існує.
* **Канал LEDC заряду ділив таймер із розрядом** (7 і 6 — одна пара) при
  різних частотах: 20 кГц проти 1 кГц. Прикріплення одного з двох
  провалювалось МОВЧКИ. Тепер це `#error` на компіляції, а канал узято 4.
* **Опис заліза жив трьома копіями в клієнтах.** «ШІМ 25 кГц → керуючий NPN →
  дросель 104 мкГн, шунт 0.5 Ом, подільник 20к/10к» стояло рядком у
  `index.html`, `client_usb.html` і `moto_gui.py`. Після заміни ключа на
  польовий усі троє довго називали чуже залізо; для плати TL494 в тому абзаці
  неправдою є кожне слово. Тепер опис віддає **пристрій** (`CHARGE_STAGE_TXT`,
  поле `chgHwTxt` — і по Wi-Fi, і по USB), а клієнти його просто показують.
* **`smart_check` вимагав помилки.** Перевірка «великий пакет затиснуто
  апаратною стелею» була написана як `chargeSmartCMa(2500, 50%) ==
  CHARGE_MA_80` — тобто мовчки припускала, що 0.5C від 2500 мА·год більше за
  стелю. На платі TL494 стеля вища (1500 мА), і перевірка почала вимагати
  зарядити пакет струмом 1500 замість чесних 1250. Тепер перевіряється
  ПРАВИЛО «менше з двох», а сам затиск доводиться на пакеті, якому 0.5C
  завідомо більший за будь-яку зі стель.
* **Прапорець «показання свіже» стеріг ніщо.** `chargeReadingFresh()` міг
  відповісти лише «так»: єдиний, хто читав ці числа, клав їх туди сам у тому ж
  проході. Прибрано разом із прапорцем; замість нього діє правило, яке не
  обійти мовчки — невдале читання ОДРАЗУ опускає вихід у нуль **і зводить
  чинний струм у нуль**, щоб інтеграл ємності не домальовував мА·год, яких
  пакет не отримував.

**Нова перевірка: `tools/topology_check.py`.** `web_server.h`, драйвери екрана
й скетч на хості **не збираються взагалі**, тож звертання до макроса, якого за
обраної топології не існує, було б видно лише в Arduino IDE — тобто вже після
релізу. А гірша половина взагалі не є помилкою збірки: невідомий ідентифікатор
у `#if` препроцесор мовчки вважає нулем, і перевірка, яка на нього
посилається, просто перестає щось перевіряти. **Препроцесувати** прошивку при
цьому можна завжди — на цьому й побудовано: женемо скетч через `cpp` за кожної
топології й дивимось, які імена з `settings.h` ВИЖИЛИ у виводі. Вижити може
лише те, що не було визначене. Саме так знайшлися `serial_api.h` і залишок
`CHARGE_SW_NAME` у JSON.

**Перенесення в корінь.** Уся збірка скопійована поверх попередньої;
`settings.h` зібрано з нового, а назад повернуто рівно те, що є
**конфігурацією цього пристрою**, і кожен такий рядок помічено «⚑ У ЦЬОГО
ПРИСТРОЮ»: панель екрана 240×280 зі скругленими кутами, топологія
`CHARGE_TOP_TL494` і профіль струму 500/1000/1500 мА (стелю тут задає ключ,
розпаяний виробником плати, а не наш тепловий бюджет — опустити профіль «за
компанію» означало б без причини зробити заряд повільнішим за той, що вже
перевірено на живих пакетах). Канал LEDC — виняток: сімка лишилась би
несправністю, тож узято 4, як у другій збірці.

**Перевірено.**

* Матриця з **трьох конфігурацій** (понижувач × два ключі, плата TL494) —
  усі **19 хостових тестів** зелені в кожній;
* новий розділ 28 у `charge_logic_check`: калібрувальна крива (монотонність,
  влучання у вузли, затиск замість екстраполяції), шкала в мілівольтах,
  порядок «уставка → enable», сталий крок регулятора, збіжність на моделі
  пакета, і окремо — що недоступне названо недоступним;
* `tools/topology_check.py` — обидві топології без чужих імен у живому коді;
* звірка **від протилежного** — **23 поломки**, кожна валить свою перевірку
  (і дві з них знайшли дефекти в самому тесті: підмінник `digitalWrite`, що
  не розрізняв піни, і прапорець порядку, який протікав між викликами).

---

## 3.56. Порожній список еталонів у Майстрі: одна невдала відповідь — і на весь сеанс

**Скарга.** «У клієнті exe при відновленні з еталона в Майстрі у випадному
списку не показуються еталони для вибору відновлення.»

**Причина була не в Майстрі.** Список моделей клієнт питає командою `TEMPLATES`
**рівно один раз** — у мить під'єднання. Відповідь оброблялась так:

```python
models = r.get("models", []) if r.get("ok") else []
for cb in (self.cbInit, self.cbRest, self.cbWiz):
    cb["values"] = models
```

Тобто **будь-яка** невдала відповідь — таймаут, зайнята шина, обірваний
кабель — мовчки затирала вже завантажений список **порожнім**. Другого шляху
до `TEMPLATES` в інтерфейсі не існувало: вийти з цього стану можна було лише
перепідключенням, про яке ніде не сказано. Людина бачила порожній випадний
список і напис «Оберіть модель для відновлення» — вимогу, яку **неможливо
виконати**.

**Чому саме програма, а не веб-клієнти.** Ті мали дві переваги, про які ніхто
не думав як про запобіжники:

* вони питають моделі **після** повного оновлення (`await refresh(); await
  loadTemplates()`), а програма слала п'ять команд пачкою — і `TEMPLATES` стояв
  **першим**, тобто саме тоді, коли ESP щойно перезавантажився від відкриття
  порту й ще досипає стартовий звіт у той самий UART;
* коли список порожній, вони показують «(немає шаблонів)» — а програма
  показувала нічого, і відрізнити «не приїхало» від «нема чого» було ніяк.

**Що зроблено.**

1. **Невдала відповідь більше не затирає добрий список.** Уже завантажений
   список — це єдине, що ми про моделі знаємо; він не застарів, він просто не
   підтвердився. У смузі стану з'являється причина: «Список моделей не
   оновився (таймаут) — лишили попередній».
2. **Порожнеча ніколи не мовчить**, і двох її випадків не сплутати: «(список
   не завантажено — натисніть 🔄)» проти «(у прошивці немає шаблонів)». Поради
   в них протилежні: перше лікується повтором, друге — тільки прошивкою.
3. **З'явився ДРУГИЙ шлях до списку.** Кнопка 🔄 просто біля списку в Майстрі,
   плюс автоматичний дозапит саме там, де список потрібен (`ensure_templates`).
4. **Заглушку неможливо вибрати** — і неможливо відправити в запис. Заразом
   виправлено сусіднє: `Combobox` не стежить сам, щоб вибране значення лишалось
   у списку, тож після затирання в полі так і лишався старий `PMNN4488A`,
   якого в жодному пункті вже не було — і Майстер спокійно відправив би його.
5. **Спусковий гачок прибрано, а не лише наслідок**: `TEMPLATES` більше не
   стоїть першим у пачці команд під'єднання, а таймаут піднято з 5 до 12 с.
6. Усі три поверхні (Майстер, «Новий акумулятор», «Відновити еталон») питають
   **одну** перевірку готовності `_models_ready()`: три копії цієї умови
   неминуче розійшлися б, і десь лишилось би «оберіть модель» над порожнім
   списком.

**Де тепер живе рішення — і чому це головне в цій правці.** Логіка винесена в
`usb_client/moto_models.py` — модуль **без жодного віджета**. `moto_gui.py`
імпортує `tkinter` уже в заголовку й будує на ньому класи, тож на збірковій
машині його неможливо навіть імпортувати (у контейнері немає ні вікон, ні
самого `tkinter`). Усе, написане прямо в обробниках, там не покриває **жоден**
тест — і саме тому дефект дожив до скарги власника. Тепер рішення відокремлене
від віджетів, і його ганяє `tools/templates_reply_check.py` напряму. Той самий
прийом, що й із `charge.h` проти `web_server.h`: логіка живе там, куди тест
дістає.

**Перевірено.**

* новий хостовий тест `templates_reply_check` (20-й у наборі) — і він працює
  БЕЗ `tkinter`, тобто справді ганяється, а не мовчки пропускається;
* справжнє вікно на віртуальному екрані: одна невдала відповідь лишає всі
  9 моделей на місці, порожній стан показує напис і причину, кнопка 🔄 на
  місці;
* звірка **від протилежного** — **12 поломок**, кожна валить свою перевірку.
  Три з них знайшли дефекти в самому тесті: перевірка про заглушку порівнювала
  списки замість причини й тому мовчала; `"def ensure_templates"` лишалось
  підрядком у `"def ensure_templates_DISABLED"`; а перевірка порядку падала з
  `ValueError` замість того, щоб чесно показати збій.

---

## 3.57. Дві теки — одна: різниця пристроїв виявилась у чотирьох рядках

**Що було.** Після розділу 3.55 у сховищі лежали дві майже однакові теки:
корінь (попередній пристрій на платі TL494) і `battery_reader_china_chr/`
(новіший, із власним понижувачем). Код у них уже був спільний — але
**фізично продубльований**: 265 файлів, кожну правку доводилось носити руками
в обидві.

Це не теоретична незручність. Рівно в тому самому релізі, де теки зрівняли,
правку клієнта (розділ 3.56) довелось копіювати в чотири файли по обидва боки,
і кожна така копія — це шанс, що наступного разу її забудуть. Проєкт уже має
цілий розділ про те, чим закінчуються копії, що розходяться.

**Що виявилось.** Порівняння дало **48 рядків різниці, і всі — в одному
файлі** (`settings.h`), а по суті це **чотири** рішення:

| | плата TL494 | власний понижувач |
|---|---|---|
| екран | 1.69" 240×280, скруглений | 1.3" 240×240, квадратний |
| топологія заряду | `CHARGE_TOP_TL494` | `CHARGE_TOP_BUCK` |
| профіль струму | 500/1000/1500 мА | 400/700/1000 мА |
| канал LEDC | 4 | 4 *(вже однаковий)* |

**Що зроблено.** З'явився `DEVICE_VARIANT` — **найпершим блоком** `settings.h`,
одразу за `soc.h`. Місце не випадкове й не косметичне: невідомий ідентифікатор
у `#if` препроцесор МОВЧКИ вважає нулем, тож вибір, оголошений нижче за першу
ж умову, яка його читає, не дав би помилки збірки — він просто перетворив би
умову на «0 == щось» і спрацював би навпаки. Тепер порядок стереже окрема
перевірка (`fileOffset` у `session_guard_check`), і ламається вона саме на
цьому: варто підняти умову вище за вибір — і обидва пристрої тихо дістануть
екран 240×240.

Теку `battery_reader_china_chr/` прибрано. Нічого не втрачено — перед
видаленням обидва варіанти звірено препроцесором проти старих файлів:

```
DEVICE_VARIANT=0  ->  240x280, ROUND, TL494, 500/1000/1500, LEDC 4   ≡ старий корінь
DEVICE_VARIANT=1  ->  240x240,  —,    BUCK,  400/700/1000,  LEDC 4   ≡ стара china_chr
```

**Два знання про залізо, і вони РІЗНІ.** `DEVICE_VARIANT` відповідає на
питання «який пристрій збираємо», `CHARGE_TOPOLOGY` — «яке в нього зарядне
залізо». Друге виводиться з першого, але лишається окремим і його можна
задати ззовні: хостові тести саме так і ганяють обидві топології, не чіпаючи
екран. Для ЗБІРКИ ПРИСТРОЮ правильний шлях один — `DEVICE_VARIANT`, інакше
легко зібрати химеру на кшталт «екран 240×280 з власним понижувачем».

**Перевірено.**

* матриця з трьох конфігурацій (`DEVICE_VARIANT` × `CHARGE_SWITCH_TYPE`) —
  усі **20 хостових тестів** зелені в кожній;
* новий розділ 10г у `session_guard_check`: обидва пристрої оголошені, вибір
  задається ззовні, стоїть ДО першої умови, що його читає, і кожен із чотирьох
  наслідків справді від нього залежить;
* звірка **від протилежного** — **7 поломок**, кожна валить свою перевірку.
  Найцікавіша з них тиха: вибір лишається на місці, а вгору переїжджає УМОВА,
  яка його читає. Помилки збірки немає — саме тому перевірка на порядок і
  потрібна.

---

## 3.58. Станція повертала дату й цикли — бо ми правили одне число з шести

**Скарга.** «Після ручного введення дати й циклів та встановлення на зарядну
станцію, станція знаходила якісь помилки в даних і сама автоматично виправляла
дату на стару. Те саме з циклами.»

Власник поставив і діагноз: десь у прошивці дублювання, і станція бере за
основу не те, що ми правили. Діагноз виявився правильним по суті й неточним у
деталі — **другої копії дати немає**, і це варто було перевірити перш ніж
шукати її.

### Спочатку — чого в чипі НЕМАЄ

Перебрали всі 512 байтів DS2433 на 41 дампі з підібраним ключем: шукали
зашифроване слово дати виготовлення там, де воно могло б лежати другим разом.

| Що шукали | Скільки копій у чипі |
|---|---|
| дата виготовлення | **рівно одна** в усіх 41 |
| день першого запуску | дві — і обидві ми пишемо (поле-близнюк, 3.51) |
| день останнього заряду | одна |

Тобто копії, з якої станція «відновлює стару дату», не існує. А дату вона
однаково повертала — отже вона її не КОПІЮЄ, а **перераховує**.

### Що станція насправді робить — і чому це та сама історія, що й у 3.30/3.53

Дати в IMPRES зберігаються **зміщенням у добах від дати виготовлення**, а
скільки пакет узагалі прожив — каже наробіток монітора (ETM) у DS2438, тобто в
**іншому чипі**. Між ними є правило, і воно виміряне, а не припущене:

> у **41 дампі з 41** жодне зміщення події не перевищує наробіток.

Стану «подія сталася пізніше, ніж пакет узагалі працював» немає в жодному
живому пакеті — і це рівно той неможливий стан, який станція «лікує». Механізм
той самий, що вже описаний двічі (3.30 — мітки в секундах, 3.53 — мітка в
добах); нового тут лише те, з чого цей стан виникає.

**А виникає він із нашої власної правки.** Посунути дату виготовлення НАЗАД
означає збільшити КОЖНЕ зміщення, не торкнувшись наробітку: абсолютні дати
подій ми зберігаємо (це правильно, 3.51), але відстань від них до виготовлення
росте. Редактор при цьому мовчав — звірка набору питала лише про взаємний
порядок дат і про мітку, а про наробіток не питала взагалі.

Виміряно на корпусі, зсув на один рік назад:

| | до правки | після |
|---|---|---|
| редактор прийняв правку | — | **41 із 41** |
| подія пізніша за наробіток | 0 із 41 | **28 із 41** |
| наш власний підбір ключа перестав давати однозначну відповідь | 0 | **6** |

На два роки назад — 35 із 41 і 30 відповідно. Останній рядок тут найважчий:
`impresBmsFindKey()` відкидає варіанти, які САМ вважає неможливими, і серед
його умов є «дні подій не більші за наробіток». Тобто пакет після нашої правки
переставала розбирати **наша ж прошивка** — а ми цього не помічали, бо ніхто
не питав.

### Цикли — те саме, тільки місць п'ять

«Цикли IMPRES» ми читаємо й пишемо в **одному** місці — гістограмі доданого
заряду (блок ADDED). Але на питання «скільки цей пакет відпрацював» у чипі
відповідає не одне число:

| Де | Що | Хто його писав |
|---|---|---|
| гістограма ADDED | цикли IMPRES | **редактор** |
| блок CYCLE, зашифрований | внутрішній лічильник, реверти, дозаряди | ніхто |
| блок RECOND | калібрувальні цикли | окреме поле редактора |
| блок NONSMART, DS2433 | CCA/DCA — наробіток у самому пакеті | окремі поля |
| DS2438 | CCA/DCA монітора | окремі поля |

Співвідношення між ними теж виміряне: у **41 дампі з 41** кожен із них не
більший за цикли з гістограми. Тобто гістограма — **стеля родини**, а не ще
один її член.

Що з цього виходило, знову на корпусі («виставили цикли = 0»):

| | до правки |
|---|---|
| редактор прийняв без єдиного заперечення | 41 із 41 |
| внутрішній лічильник лишився ненульовим | **41 із 41** |
| калібрувальні цикли лишились більшими за цикли | 38 із 41 |
| CCA/DCA в пакеті лишились недоторканими | **41 із 41** |
| наш підбір ключа перестав давати однозначну відповідь | **41 із 41** |

Останній рядок — знову той самий: ми віддавали станції набір, який наша ж
прошивка вважає неможливим. Станція його бачить так само й чинить очевидним
чином — бере число, яке лишилось цілим.

**Це дев'ятий і десятий випадки родини «одне поле, два питання»**, і найбільші
з усіх: тут на одне питання відповідали шість полів, а правили ми одне.

### Що зроблено

**Стеля родини живе в одному місці** — `impresCryptCapByCycles()` у
`impres_crypt.h`, поруч із самими полями, а не в редакторі: обнуляти цикли
вміє не лише він. **Притискає, але не піднімає** — те саме правило, що й у
`impresSetEtm()` для міток: брат, менший за стелю, це законна історія пакета
(ревертів може не бути жодного), а брат, більший за неї, — стан, якого немає
в жодному живому пакеті.

**Перелік родини — один на звірку й на починку** (`editCycleFamily()`).
Спершу було написано п'ять майже однакових умов у звірці й такий самий цикл
у починці — і звірка «від протилежного» це відразу впіймала: прибери одну
умову, і **не падає нічого**, бо сусідні чотири однаково доводять набір до
починки, а та однаково притискає всіх п'ятьох. Умова, яку неможливо повалити,
не стереже нічого.

**Дати дістали стелю, якої їм бракувало**: подія не може бути пізнішою за
наробіток. Полагодити це можна двома способами, і вони протилежні — підняти
наробіток або опустити подію. Піднімати наробіток означало б зробити руками
рівно те, проти чого написано пів проєкту, тому **опускається подія**, а
наробіток лишається тим, що виставила людина.

Обидві правки йдуть через **починку**, а не відмову (3.52): у кожної тутешньої
суперечності є одна очевидна відповідь, і людина бачить у примітці, що саме
зсунулось і чому.

### Перевірено

* `edit_plan_check`, **новий розділ 11** — на всьому корпусі, і в два кроки:
  спершу доводиться, що обидва співвідношення справді тримаються в живих
  пакетах (41 із 41 для кожного), і лише потім — що редактор їх не ламає.
  Без першої половини друга доводила б, що ми стережемо власну вигадку.
  Після «цикли = 0» брати йдуть слідом у 41 із 41, після зсуву дати на рік
  назад події лишаються в межах наробітку в 41 із 41, і **підбір ключа
  лишається однозначним** в обох випадках — найсуворіша з можливих перевірок,
  бо він відкидає зміст, який сам вважає неможливим;
* `edit_plan_check`, **новий розділ 11б** — кожного члена родини піднімаємо
  ПООДИНЦІ: звірка мусить назвати саме його, починка притиснути саме його, і
  сказати про це людині. Перша редакція цього розділу брала 5 циклів — і
  тоді стелю перевищували ще й ті лічильники, що вже лежали в пакеті, тож
  звірка чесно називала першого з них; перевірка впала й показала це;
* окремо — що правило **вміє відповісти «ні»**: законний набір проходить
  недоторканим. Стеля, яка мовчки переписує введене людиною, була б гіршою за
  її відсутність;
* `session_guard_check`, **новий розділ 52** — правило одне й лежить поруч із
  полями, другої копії в редакторі немає, перелік родини читають рівно двоє;
* три перевірки в старих розділах довелось **виправити, а не підганяти**: вони
  вимагали записати стан, якого немає в жодному з 41 живого пакета (4321 сирої
  одиниці при 24 циклах — це ~860 циклів заряду), тобто доводили, що редактор
  такий стан пропускає;
* звірка **від протилежного** — **18 поломок**, кожна валить свою перевірку.
  Три з них знайшли дефекти в самих перевірках: п'ять умов, з яких жодну не
  можна було прибрати поодинці; вартовий на ім'я функції, який проходив і на
  `impresCryptCapByCyclesRENAMED` (та сама пастка, що з `ensure_templates`);
  і «чи є хоч десь» замість «рівно у двох місцях» — підміна одного з двох
  викликів не валила нічого;
* усі **19 хостових тестів** зелені в трьох конфігураціях, чотири перевірки
  на Python — теж.

### Що це, найімовірніше, означає для наробітку 3844

Незакрите питання про 3844 (див. початок журналу) тепер має нового
підозрюваного, і його варто перевірити ПЕРШИМ. Станція лікує «подію пізнішу за
наробіток», підтягуючи наробіток до події, — а зміщення подій міряються в
добах від дати виготовлення й цілком лежать у діапазоні тисяч. Пакет 2014 року
дає близько 4400 діб; 4545 і 3844 — числа саме цього порядку.

Це **здогад, а не висновок**: доказом буде таблиця побайтової різниці
(«Зняти знімок» → станція → «Порівняти»). Але тепер зрозуміло, куди в ній
дивитись першим — у блок DATE і в наробіток одночасно.

---

## 3.59. Bluetooth як РЕЖИМ, а не як доважок: одне радіо за раз

**Завдання власника.** «Додати функцію роботи через Bluetooth. Через обмеження
ресурсів, при роботі з Bluetooth вимикати Wi-Fi. Режим вибору додати в головне
меню п'ятим пунктом.»

### Bluetooth у проєкті БУВ — і був вимкнений не випадково

Увесь транспорт написано ще в 3.8: той самий командний протокол поверх SPP,
тобто звичайного COM-порту по ефіру, тож `moto_gui.py`, `client_usb.html` і
`moto_bridge.py` працюють без жодних змін — треба лише обрати інший порт.
Написано було й правило доступу: читання вільне, будь-який запис — тільки
після `AUTH`.

А в `settings.h` над ним стояв червоний абзац:

> 🔴 ЗАРАЗ ВИМКНЕНО — І ЦЕ НЕ «ЗАБУЛИ ВВІМКНУТИ». На залізі з увімкненим
> Bluetooth пристрій перестав під'єднуватись по Wi-Fi.

Причина там названа правильно: стек Bluedroid забирає десятки кілобайтів купи,
а радіо в ESP32 одне на обидва протоколи. Неправильним було лікування —
**вимкнули функцію разом із симптомом**. Прохання власника і є тим лікуванням,
якого бракувало: не тримати обидва стеки разом.

### Тому це не «додати Bluetooth», а «розвести два радіо в часі»

Режим один за раз, і вибирається він у меню приладу. У режимі Bluetooth точка
доступу, captive-portal DNS і веб-сервер **не піднімаються взагалі** — не
«піднімаються й простоюють», а не піднімаються: інакше пам'ять і ефір знову
ділилися б надвоє, тобто ми відтворили б ту саму несправність, від якої
лікуємось.

### Три рішення, які тут насправді ухвалено

**Перше: правило живе в окремому файлі.** `radio_mode.h` не має жодного
`#include <WiFi.h>` і жодного рядка про залізо — тільки правила. Причина та
сама, що з `charge.h` проти `web_server.h` і з `moto_models.py` проти
`moto_gui.py`: скетч і `web_server.h` на хості не збираються, а перевіряти тут
треба саме те, що всередині них написали б «по дорозі».

**Друге: доступність Bluetooth — параметр, а не `#ifdef`.** Ядро правил
приймає «чи є стек» числом, а тонка обгортка підставляє відповідь цієї збірки.
Написане через `#ifdef`, правило перевірялось би лише в тому світі, який
зібрали, — а вирішальний тут саме другий: у файлі записано «Bluetooth», а
підняти його нічим, бо прошивку перезібрали без стека. Прилад мусить підняти
Wi-Fi, а не змовкнути в обох ефірах.

**Третє: перемикання застосовується при СТАРТІ, а не на льоту.** Bluedroid
бере ~70 КБ одним шматком; піднімати його на купі, по якій уже походили
веб-сервер, SPIFFS і драйвер екрана, — це той самий клас відмов, що
розбирався в 3.11, тільки цього разу він давав би «Bluetooth не запустився»
без жодної видимої причини. Ціни тут майже немає: перемикання й так рве
поточного клієнта — Wi-Fi гасне. Прилад просто доводить це до кінця й
перезавантажується сам.

### Що знайшлося по дорозі — дефекти, а не косметика

* **`OP_DOC` заповнюється ЗА ІНДЕКСОМ, і бракуючий рядок C++ занулює мовчки.**
  Додавши операцію, ми дістали б `OP_DOC[16].key == nullptr` — і клієнт
  отримав би не опис, а падіння на `String(nullptr)` у побудові JSON. Помилки
  збірки при цьому немає жодної. Тепер довжини обох таблиць звіряє
  `static_assert`.
* **Вартовий, який тримається на пробілах.** Перша редакція розділу 53 мала
  `fileHasText("OP_RADIO            = 16")`. Звірка «від протилежного»
  показала, що він не валиться ні від правки коментаря поруч, ні від
  перенесення пункту в інше місце меню. Позицію доводить `menu_check`,
  дивлячись на справжній список; вартовий, який дублює це за виглядом тексту,
  дає хибну впевненість і хибні падіння. Прибраний.
* **Дві перевірки, які не спрацьовували в жодній із трьох конфігурацій.**
  «Рестарт не просять дарма» і «розбір не вирішує за залізо» — обидві живуть
  у світі, де Bluetooth немає. Через це в матриці з'явився **четвертий
  прогін**.

### Місце в меню

П'ятий рядок списку — власна група «ЗВ'ЯЗОК» одразу за «РЕМОНТОМ». Місце
задав власник, і воно не косметичне: до перемикача радіо доводиться діставатись
саме тоді, коли зв'язку немає, — тобто не через клієнта, а кнопками, і кожен
зайвий рядок тут це зайве натискання наосліп. Група власна ще й тому, що групи
в цьому меню мусять бути суцільними (3.33), а окремого заголовка пункт вимагає,
щоб не читатись як продовження ремонту.

Окремо перевірено, що ця група **не зникає разом із зарядом**: група ЗАРЯД на
версії без силової частини зникає цілком, і якби «Зв'язок» поїхав із нею, то
саме на приладі без заряду перемкнути радіо було б нічим.

### Прилад не лишається німим — це головне

Обидва канали зв'язку з приладом — радіо. Помилка тут коштує не даних, а
доступності: до приладу лишиться достукатись тільки кабелем. Тому:

* невідоме число в режимі — це Wi-Fi (точка доступу є в будь-якій збірці);
* збережений Bluetooth на прошивці без Bluetooth — теж Wi-Fi;
* **Bluetooth піднімається ДО точки доступу**, і якщо не піднявся, прилад
  свідомо вмикає Wi-Fi замість нього й каже про це в журналі та на екрані.
  Порядок тут — умова правильності: підніми ми точку доступу першою, відмові
  Bluetooth уже нічим було б зарадити (пам'ять забрана), і прилад лишився б
  без обох.

### Ціна, яку треба знати до першої збірки

Разом із `BT_ENABLED` у прошивку входить увесь Bluedroid, і в типову схему
розділів вона вже не влізе — потрібен **Huge APP (3MB No OTA/1MB SPIFFS)**.
Вимога була й раніше (3.20), тепер вона стала жорсткішою. Не потрібен
Bluetooth — закоментуйте `BT_ENABLED`: пункт меню лишиться видимим і чесно
скаже, що перемикати нема на що, а прошивка знову влізе у звичайну схему.

### Перевірено

* `radio_mode_check`, **новий тест** (20-й у наборі) — не «функція повертає
  щось», а три властивості: увімкнених радіо рівно одне на **кожному з 256
  значень** (число приходить із файла, який могли побити, і з команди ззовні);
  недоступний режим не обирається **в обох світах** одночасно, у одному
  прогоні; файл пишеться, читається й **розуміє старий формат** — у приладі
  власника в ньому записано, що силової частини немає, і перестати його
  розуміти означало б, що оновлення виглядає як поломка;
* `menu_check`, **новий розділ 13** — «Зв'язок» стоїть саме п'ятим рядком, у
  власній групі з заголовком, лишається на місці на версії без заряду й не
  вимагає заряду;
* `session_guard_check`, **новий розділ 53** — того, чого хостовий тест не
  бачить: Bluetooth піднімається до точки доступу й рівно один раз, відмова
  помічається й веде до Wi-Fi, гейт стоїть **у двох місцях** (у `setup()` і в
  `loop()` — друге легко забути, і тоді `handleClient()` поліз би в сокет,
  якому не робили `begin()`), запис іде перед рестартом, а не навпаки;
* матриця тепер **із чотирьох конфігурацій** — три колишні плюс збірка без
  Bluetooth; усі **20 хостових тестів** зелені в кожній, чотири перевірки на
  Python — теж;
* звірка **від протилежного** — **14 поломок**, кожна валить свою перевірку.
  Три знайшли дефекти в самій роботі: `static_assert`, якого бракувало на
  `OP_DOC`; вартовий на пробілах; і дві перевірки, які мовчали в трьох
  конфігураціях із трьох.

---

## 3.60. Зникло зображення: Bluetooth вимкнено назад, поки причина не названа

**Скарга власника після 3.59.** «Немає зображення. На релізі 1.0 все
працювало.» Уточнення: підсвітка є, картинки немає.

### Що це звужує

Підсвітку піднімає `displayIntro()` — і робить це ПІСЛЯ того, як заставка вже
намальована. Отже прилад доходить до ініціалізації панелі й далі; код екрана
виконується, а зображення на панель не потрапляє.

Коду екрана правка не торкалась **жодним рядком**: у різниці від v1.0 немає ні
`display.h`, ні `display_color.h`, ні `splash.h`. Єдина функціональна зміна в
усій збірці — один рядок у `settings.h`:

```
#define BT_ENABLED
```

Решта (стеля лічильників, дати, пункт меню) у шлях завантаження екрана не
входить узагалі.

### Чому вимкнено назад, а не «полагоджено»

Причина ще **не встановлена**. Правдоподібних механізмів щонайменше три —
пам'ять, схема розділів, порядок ініціалізації, — і кожен лікується
по-різному. Обрати один навмання й оголосити це виправленням означало б
зробити рівно те, від чого цей журнал застерігає в кожному другому розділі.

Тому зроблено дві речі, і обидві чесні:

1. **Bluetooth став опційним** (`#define BT_ON`), а типова збірка знову така
   сама, як v1.0, де все працювало. Виправлення лічильників і дат (3.58) при
   цьому лишаються — вони до екрана відношення не мають.
2. **Це заразом і вирішальний дослід.** Прошивка з головної гілки тепер і є
   тим прогоном «без Bluetooth», якого бракувало: повернулось зображення —
   винен той рядок, і шукаємо серед трьох механізмів; не повернулось — винен
   не він, і шукати треба зовсім в іншому місці.

Перемикач режиму зв'язку лишається в меню й нікуди не дівається: у збірці без
стека він чесно каже, що перемикати нема на що. Уся машинерія режиму
(`radio_mode.h`, гейти Wi-Fi, відкат на Wi-Fi при відмові Bluetooth)
лишається на місці й перевіряється — вимкнено саме вкомпільовування стека.

### ⚑ Прореха у власних перевірках, яку це відкрило

**Скетч не компілюється ЖОДНИМ тестом.** `topology_check.py` його лише
препроцесує, а 20 хостових тестів збирають заголовки — `.ino` серед них немає.
Тобто помилка, що живе саме у скетчі, доходить до заліза непоміченою; так
сталося й тут, хоч конкретна причина поки й не названа.

Це не «на майбутнє»: половина розділів цього журналу починається з того, що
перевірка існувала, але дивилась не туди. Закривати цю прогалину треба
окремою правкою — і почати варто саме з неї, а не з нової функції.

### Що записано в `settings.h`

Замість колишнього червоного абзацу «вимкнено, бо з ним ламається Wi-Fi»,
який роками стояв без розбору, тепер стоїть запис про **незакрите питання**:
що саме спостерігалось, чого це не торкалось, і що рядок повернеться разом із
поясненням причини. Другого абзацу без розбору в цьому місці бути не повинно.

### Перевірено

* матриця з **чотирьох конфігурацій** — три основні (тепер це світ БЕЗ
  Bluetooth, як і типова збірка) плюс окремий прогін `-DBT_ON`, де живуть
  правила, що мають сенс лише зі стеком; усі **20 хостових тестів** зелені в
  кожній, чотири перевірки на Python — теж;
* ⚠️ **на залізі не перевірено** — саме це й лишається зробити власникові:
  прошити збірку з головної гілки й сказати, чи повернулось зображення. Від
  цієї відповіді залежить, де шукати далі.

---

## 3.61. Зникле зображення: винен був не Bluetooth, а типовий пристрій

**Що сталось.** Після 3.59 власник повідомив: «Немає зображення. На релізі 1.0
все працювало», підсвітка є, картинки немає. У 3.60 підозра впала на єдину
функціональну правку тієї збірки — `#define BT_ENABLED`, — і Bluetooth
вимкнули назад «поки причина не названа».

**Діагноз був хибний.** Причину знайшов сам власник, надіславши архів тієї
збірки, яка в нього працює: `battery_reader_china_chr` — теку, зведену в
корінь у 3.57.

### Доказ — препроцесор, а не міркування

Порівняли макроси його робочої збірки з тим, що дає нинішній корінь:

| Збірка | Панель | Скруглення | Топологія |
|---|---|---|---|
| робоча в власника (`china_chr`) | **240×240** | немає | понижувач |
| корінь, типово (`DEVICE_TL494`) | **240×280** | є | плата TL494 |
| корінь із `DEVICE_VARIANT=DEVICE_BUCK` | **240×240** | немає | понижувач |

А повна звірка всіх макросів дала **рівно один** рядок різниці — сам
`DEVICE_VARIANT`. Решта 940, включно з пінами, зміщеннями панелі, профілем
струму й каналом LEDC, збігається побайтово. Тобто корінь із `DEVICE_BUCK` —
це та сама прошивка, яка в власника працює.

### Чому саме порожній екран

Прошивка налаштовувала ST7789 як панель 240×280 зі скругленням: інше вікно,
інші зміщення рядків і стовпців. Підсвітка піднімається, ініціалізація
проходить, малювання йде — просто лягає повз видиму область квадратної
панелі 240×240. Симптом рівно такий, як його описав власник.

**Звідки взялась помилка.** У 3.57, зводячи дві теки в одну, типовим лишили
`DEVICE_TL494` — просто тому, що в КОРЕНІ сховища доти лежав саме той пристрій.
Рішення виглядало як формальність: «типове значення хай буде те, що було
тут». Але прилад, яким користуються, — інший, і кожна збірка без ручної
правки тепер налаштовувала чужу панель.

### Що зроблено

* **Типовим став `DEVICE_BUCK`** — той прилад, що в роботі. Складаючи
  прошивку для приладу на платі TL494, треба задати `DEVICE_TL494` явно; про
  це сказано і в `settings.h`, і в `INSTRUCTION.md`.
* **Bluetooth повернено** (`BT_ON`). Тримати функцію вимкненою через діагноз,
  який виявився хибним, означало б залишити в коді ще один абзац «вимкнено,
  бо…», якого ніхто не перевіряв, — а такий абзац тут уже стояв роками
  (див. 3.59).

### ⚑ Чому жодна перевірка цього не впіймала — і не впіймає

Яка панель припаяна фізично, код знати не може. Обидві конфігурації
**однаково правильні** — просто одна не для цього приладу. Це не той дефект,
що ловиться тестом; це дефект замовчування.

Єдине, що тут працює, — щоб помилку було ВИДНО. Прилад друкує при старті
рядок `DISPLAY: ST7789 240x280 (panel 240x280) …` ще до того, як стане ясно,
що екран порожній, і саме він назвав би причину за секунду. Урок не в новій
перевірці, а в тому, що на скаргу «немає зображення» першим питанням має бути
журнал, а не гіпотеза: у 3.60 гіпотезу висунули раніше, ніж подивились у
надрукований рядок, і вона коштувала релізу.

### Перевірено

* препроцесорна звірка: корінь із типовими налаштуваннями тепер дає той самий
  набір макросів, що й робоча збірка власника, — різниця нульова;
* усі **20 хостових тестів** зелені в чотирьох конфігураціях (обидва пристрої,
  обидва ключі, плюс окремий прогін без Bluetooth);
* ⚠️ **на залізі не перевірено** — це лишається за власником.

---

## 3.62. Пара створена, а під'єднатись нічим: два однакові рядки в списку портів

**Скарга.** «Вмикаю Bluetooth, тисну під'єднатись на комп'ютері — під'єднується
й далі пише "не підключено". У налаштуваннях пише, що пару створено. Але
під'єднатись через програму не виходить.»

### Половина цього — не несправність

«Не підключено» у налаштуваннях Windows для послідовного профілю (SPP) —
**норма**. Windows не тримає з'єднання постійно: воно встановлюється в мить,
коли якась програма ВІДКРИВАЄ порт, і рветься, коли закриває. Доки порт ніхто
не відкрив, у налаштуваннях чесно написано «не підключено» — і саме так воно й
має виглядати.

### А от друга половина — наша

Спарувавши прилад, Windows заводить **ДВА** послідовні порти на одне
з'єднання: **вихідний** (ним під'єднуються ДО приладу) і **вхідний** (ним
прилад під'єднувався б до комп'ютера — нам він не потрібен ніколи). Опис у
системи в обох однаковий, слово в слово: «Standard Serial over Bluetooth
link». У випадному списку програми вони й виглядали як два невідрізнимі рядки:

```
COM5 — Standard Serial over Bluetoo
COM6 — Standard Serial over Bluetoo
```

Вибір між ними був підкиданням монетки, а обравши вхідний, людина діставала
відмову відкриття й жодної підказки, ЧОМУ саме. Тобто функція, зроблена в
3.59, доїжджала до користувача рівно наполовину.

### Що зроблено

* **Рядки списку тепер розрізняються**: Bluetooth-порт підписаний як
  Bluetooth, а вихідний — із адресою приладу.
* **Вихідний обирається сам**, якщо він у списку є: ставити першим-ліпшим
  означало б наперед обрати не той.
* **Відмова відкриття називає причину**, а не переказує системну помилку:
  «схоже, це ВХІДНИЙ порт — під'єднуватись треба вихідним», із дорогою до
  того місця, де Windows показує напрямок.

### ⚑ Що тут відомо точно, а що — лише схоже

Ознака «це Bluetooth» надійна: префікс `BTHENUM` в апаратному ідентифікаторі
є в обох портів пари й у жодного USB-перехідника. А «вихідний чи вхідний» ми
читаємо з адреси всередині того ж ідентифікатора: у вихідного там адреса
ПРИЛАДУ, у вхідного — нулі. Це **спостереження, а не документований формат**,
тому підпис і каже «схоже на», а не стверджує; остаточну відповідь дає сама
Windows у вкладці «COM-порти». Написати тут упевнене «це вихідний» і
помилитись означало б відправити людину не туди — гірше, ніж не гадати.

### Перевірено

* логіка живе в `usb_client/moto_models.py` — модулі **без жодного віджета**,
  бо `moto_gui.py` імпортує tkinter у заголовку й на збірковій машині не
  імпортується взагалі; написане всередині `refresh_ports()` не покривав би
  жоден тест (та сама історія, що з порожнім списком еталонів у 3.56);
* `templates_reply_check`, **новий розділ 6** — на справжніх ідентифікаторах
  обох портів пари: обидва впізнаються як Bluetooth, USB-перехідник за них не
  видається, вихідний і вхідний розрізняються, рядки списку виходять РІЗНІ, а
  для не-Bluetooth відповідь — «не знаю», а не «ні»;
* звірка **від протилежного** — **5 поломок**, кожна валить свою перевірку.
  Найкорисніша перша: адресу спершу шукали як «12 шістнадцяткових цифр
  підряд» — і знаходили хвіст GUID послідовного сервісу
  (`00805F9B34FB`), однаковий геть в усіх портів. Обидва виглядали
  «вихідними», тобто перевірка підказувала те саме, що й до неї. Впіймалось це
  тільки тому, що функцію одразу прогнали на ДВОХ справжніх ідентифікаторах, а
  не на одному;
* ⚠️ **на Windows не перевірено** — тут немає ні Bluetooth, ні COM-портів.

---

## 3.63. Порт без назви: ім'я приладу знає лише сам прилад

**Скарга.** «Є з'єднання і робота, але порт без назви. Додай ім'я COM-порту.»

Зв'язок по Bluetooth запрацював (3.62), але в списку портів прилад лишався
безіменним: Windows підписує **всі** послідовні порти Bluetooth однаково —
«Standard Serial over Bluetooth link», — і серед кількох спарених пристроїв
наш нічим не вирізнявся.

### Чому це не можна полагодити на боці клієнта

Спокуса очевидна: у прошивці ім'я складається як `BT_NAME` плюс чотири
шістнадцяткові цифри з MAC (`btName()` у `bt_link.h`), а адресу приладу
клієнт бачить у списку портів завжди. Тобто назву можна було б **скласти
самому**, не питаючи ні в кого.

Це була б **друга копія константи по інший бік дроту** — рівно той клас
дефектів, за яким тут стежать окремо. Перейменувавши прилад у `settings.h`,
ми дістали б клієнта, який упевнено показує стару назву; і дізнатись про це
можна було б лише випадково. У цьому проєкті так уже розходились ім'я
силового ключа й опис зарядного заліза — обидва довелось віддати ПРИЛАДУ
(3.55).

### Тому ім'я каже прилад

* у відповідь `INFO` додано поле `btName` — **обома каналами**, і по USB, і по
  Wi-Fi, по одному на кожну гілку `#ifdef`: зі стеком ім'я справжнє, без
  стека — порожнє (поле є завжди, інакше в якійсь зі збірок клієнт мовчки
  лишався б без назви);
* клієнт запам'ятовує ім'я **за адресою** приладу в невеликому довіднику
  (`~/.moto_bt_names.json`) і підписує ним порт починаючи з наступного разу.

Доки прилад не назвався, у рядку стоїть його адреса — не порожнє місце.
«Поки не знаю» тут чесніше за вигадану назву.

### Довідник, без якого все працює, не сміє нічого ламати

Немає файла, він побитий, немає прав на запис — жоден із цих випадків не
помилка й не привід падати: єдиний наслідок незнання в тому, що порт
підпишеться адресою. Обидва читання й запис це враховують, і перевірка це
доводить окремо.

### Перевірено

* `templates_reply_check`, **розділ 6 доповнено** — поки ім'я невідоме, у
  рядку адреса; щойно прилад назвався — ім'я; **чужий прилад чужого імені не
  дістає**; порожня адреса чи порожнє ім'я в пам'ять не потрапляють;
  перейменований прилад ПЕРЕЗАПИСУЄ стару назву, а не додає другу; побитий
  файл довідника не валить програму, а просто мовчить;
* `session_guard_check` **розділ 53 доповнено** — ім'я віддають обидва канали
  (рівно по два поля на файл: по одному на гілку `#ifdef`), **а клієнт своєї
  копії назви не тримає** (перевірка падає, щойно в модулі клієнта з'явиться
  рядок «MotoBattery»);
* звірка **від протилежного** — **6 поломок**, кожна валить свою перевірку;
* усі **20 хостових тестів** зелені в чотирьох конфігураціях;
* ⚠️ **на Windows не перевірено** — тут немає ні Bluetooth, ні COM-портів.

---

## 3.64. «btName was not declared in this scope» — і чому це не ловилось нічим

**Скарга.** Збірка в Arduino IDE впала:

```
web_server.h:954: error: 'btName' was not declared in this scope
```

Помилка з'явилась разом із 3.63: `web_server.h` почав віддавати ім'я приладу,
а сам заголовок `bt_link.h` включав **лише** `serial_api.h` — і той стоїть у
скетчі рядком НИЖЧЕ за `web_server.h`. Тобто все складалось рівно доти, доки
звідти ніхто по цьому імені не звертався.

Виправлення просте — `web_server.h` включає `bt_link.h` сам. Цікаве тут інше.

### Чому жодна з 24 перевірок цього не побачила

**Скетч не компілюється на хості ЖОДНИМ тестом** — за ним увесь Arduino-світ.
Про цю прогалину сказано ще в 3.60; тепер вона вистрелила вдруге й уже прямо в
власника.

Але препроцесувати скетч можна завжди — на цьому побудовано
`tools/topology_check.py`. І в препроцесованому тексті видно рівно те, що
бачить компілятор: **порядок**. Якщо перше звертання до функції стоїть раніше
за її оголошення, C++ такий текст не прийме, хай які заголовки включені.

Тож перевірка написалась одразу. І **не впіймала нічого** — а ось це вже було
цікаво.

### Друга помилка, яка ховала першу

`bt_link.h` оголошував свій API під умовою `defined(BT_ENABLED) &&
defined(ARDUINO)`, а запасна гілка (там, де Arduino немає) мала лише три
функції з чотирьох: `btName()` у ній не було взагалі.

Наслідок: у хостовому проході функції не існувало — і перевірці не було чого
звіряти. А в Arduino IDE вона існувала: просто пізніше за того, хто її кличе.
Тобто **рівно те місце, де помилка живе, було й тим місцем, де її неможливо
побачити**.

Полагоджено обидва:

* запасна гілка `bt_link.h` тепер оголошує те саме, що й основна (тип
  повернення там `const char*` замість `String` — навмисно: `String` це
  Arduino, а ця гілка живе саме там, де Arduino немає);
* `topology_check.py` дістав розділ «використано раніше, ніж оголошено».

Перелік імен для нього **не ведеться руками**: беруться всі inline-функції
наших власних заголовків, тож нова функція потрапляє під нагляд сама.

### Перевірено

* звірка **від протилежного** — прибрали `#include "bt_link.h"` із
  `web_server.h`, тобто відтворили точнісінько ту збірку, що впала в власника:

```
   ЗБІЙ  топологія 0: звертання РАНІШЕ за оголошення — btName
   ЗБІЙ  топологія 1: звертання РАНІШЕ за оголошення — btName
```

  до правки цей самий дослід не давав жодної помилки;
* усі **20 хостових тестів** зелені в чотирьох конфігураціях, чотири перевірки
  на Python — теж.

### Що з цього лишається незакритим

Перевірка ловить **порядок оголошень** — той клас, що впав зараз. Вона НЕ
замінює компіляцію скетча: помилку типів, зайвий аргумент чи невідповідність
сигнатури вона не побачить. Повне покриття дав би прогін `arduino-cli` у
збірці, і це варто зробити окремою правкою — але тепер принаймні найчастіший
випадок відсікається до того, як дійде до IDE.

---

## 3.65. «Куди підключатись?» — хай програма спитає прилад сама

**Скарга.** «Імені порту немає, а в системі безліч COM-портів, незрозуміло
куди підключатись. Може створити своє внутрішнє підключення, яке бачитиме
програма?»

### Свого транспорту вигадувати не треба

Прилад **уже представляється сам**: у відповідь на `PING` він каже своє ім'я в
полі `"dev"` — це є в протоколі від самого початку. Отже правильне питання не
«як підписати порт», а «спитати кожен порт, хто він».

З'явилась кнопка **«🔍 Знайти прилад»**: програма обходить порти, шле `PING` і
під'єднується до того, який назветься нашим. Працює однаково для USB і для
Bluetooth — знати номер порту не треба взагалі.

**Порядок опитування важливіший, ніж здається:**

* **вхідні Bluetooth-канали не питаються ВЗАГАЛІ.** Їх відкриття не просто
  марне — воно ВИСНЕ на кілька секунд, а таких портів у системі стільки ж,
  скільки спарених пристроїв. Пошук, який упирається в них усі, людина
  вважатиме зависанням програми;
* далі — Bluetooth, чиє ім'я ми вже знаємо (майже напевно наш прилад), потім
  інший Bluetooth, потім звичайні порти.

Єдине, що клієнт знає про прилад наперед, — рядок `"MotoBatteryReader"`. Це
**частина протоколу**, як заголовок пакета, а не копія налаштування.

### Пароль по радіо — вимкнено за рішенням власника

Скарга друга: «ця команда потребує auth пароль, треба без пароля, тим більше
вводити його нікуди».

Бар'єрів було два: PIN на спарюванні й пароль на кожній команді запису.
Лишається **перший**: `BT_REQUIRE_AUTH 0`. Що це означає — записано просто в
`settings.h`, без прикрас: спарований комп'ютер тепер може віддати будь-яку
команду, включно з `WIPE33`, і безпека тримається рівно на PIN. Складання «0 і
без PIN» прошивка не дасть узагалі (`#error` там стояв і раніше).

**А от «вводити нікуди» виявилось моєю помилкою в діагнозі.** Поле пароля у
вікні є, і `maybe_auth()` шле `AUTH` перед КОЖНОЮ командою запису — я спершу
шукав його під іншим ім'ям і поспішив оголосити контрол мертвим. Насправді
його просто не помічали: підпис «Пароль (опц.)» губився в рядку між портом і
кнопками. Тепер він зветься «Пароль запису».

### ⚑ Перевірка, яка впала на ПРАВИЛЬНОМУ рішенні

Щойно пароль вимкнули, `session_guard_check` завалився:

```
ЗБІЙ  по BT стирання БЕЗ пароля заборонене
```

Сторож спрацював чесно — але стеріг він **одну з відповідей правила**, а не
саме правило. Тому його переписано: якщо пароль увімкнено — запис без нього не
проходить; якщо вимкнено — проходить, **і тоді перевіряється, що лишився
PIN**. Обидва світи тепер прогоняються (`-DBT_REQUIRE_AUTH=1` став п'ятою
конфігурацією матриці), а прибрати ОБИДВА бар'єри не дає `#error` у самій
прошивці.

Друга перевірка теж виявилась заслабкою: вартовий «клієнт не тримає копії
назви приладу» шукав підрядок `MotoBattery` — і завалився на
`MotoBatteryReader`, тобто на ідентифікаторі протоколу, який клієнт
зобов'язаний знати. Це різні константи: ім'я в ефірі власник може змінити,
формат обміну — ні. Голка тепер із лапками.

### Перевірено

* `templates_reply_check`, **розділ 6 доповнено** — вхідний канал у пошук не
  потрапляє; жоден інший порт не загублено; Bluetooth питається раніше за
  звичайні; знайомий прилад — першим; чужий пристрій за наш не видається;
  відповідь без імені, порожня чи не-словник — це «ні», а не виняток;
* `session_guard_check` **розділ 14 переписано** під обидва світи правила
  доступу;
* звірка **від протилежного** — **7 поломок**, кожна валить свою перевірку,
  включно з «прибрали обидва бар'єри» (там прошивка просто не збирається) і
  «клієнт завів копію імені в ефірі»;
* матриця тепер із **п'яти конфігурацій**; усі **20 хостових тестів** зелені в
  кожній;
* ⚠️ **на Windows не перевірено**: сам пошук портів тут прогнати нема на чому.

---

## 3.66. «Сирі одиниці» — це не дані: лічильники в мА·год і пояснення до кожного поля

**Скарга.** «Лічильник розряду/заряду монітора — в незрозумілих одиницях сирих
даних. Потрібні зрозумілі значення для редагування… по сирих значеннях —
ясні дані з поясненням значення й результатом змін.»

### Чому «40» не каже нічого

Чотири лічильники накопиченого заряду (два в пакеті, два в моніторі) лежать у
пам'яті не в мА·год, а в одиницях накопичувача: `мА·год = 15.625 × сире /
шунт`. **Шунт у кожного пакета свій** — і саме тому сире число неможливо
прочитати очима: одна й та сама одиниця це від **339 до 790 мА·год** залежно
від екземпляра (виміряно на 62 моніторах корпусу з 65).

Тобто «40» — це і не заряд, і не знос, і не цикли. Редактор показував людині
число, з якого нічого не випливає.

Тепер усі чотири поля міряються в **мА·год**, а переклад робить сам прилад —
за шунтом ЦЬОГО пакета.

### Ціна — грубий крок, і його не сховати

Одиниця чипа велика, тож записуване **не кожне** число. Введене значення
притягується до найближчого можливого — і про це кажуть уголос:

> `Лічильник заряду монітора: 12 000 → 11 932 (крок лічильника 628 мА·год)`

Мовчазне округлення тут було б гіршим за сирі одиниці: людина побачила б у полі
не те, що ввела, і не мала б жодної підказки чому.

### Без шунта поле недоступне, а не «сире»

Шунт не читається в 3 моніторах корпусу з 65. Підставити спільну константу
означало б показати неправильне число з упевненим виглядом — у цьому проєкті
таке вже було, і саме на шунті (сімейство 4409 занижувалось майже вдвічі).
Мовчки відкотитись назад у сирі одиниці теж не можна: тоді те саме поле
міряється то в одному, то в іншому.

### Пояснення до кожного поля — з приладу

У кожного з 16 полів тепер є текст, який відповідає на два питання **саме в
такому порядку**: що це число означає — і що станеться, коли його змінити.
Друге важливіше: редактор пише в пам'ять живого пакета, і «я не знав, що воно
на це впливає» тут коштує дорожче за зайвий рядок на екрані.

Текст дає **прилад** (поле `help`), а всі три клієнти його лише показують —
своя копія пояснень у кожному розійшлася б на першій же правці, як уже
розходились ім'я силового ключа й опис зарядного заліза.

### Міст навчився шукати прилад

Скарга: «в мосту немає пошуку Bluetooth-пристрою». Кнопка «🔍 Знайти прилад»
була лише в програмі. Тепер вона є й у мосту — і, головне, **логіка спільна**:
міст бере підпис портів, порядок опитування й ознаку «це наш прилад» із того
самого `moto_models.py`. Своєї копії він не тримає, і перевірка це стереже:
міст — та поверхня, де розходження помічають останнім.

### Перевірено

* `edit_plan_check`, **новий розділ 11в** — крок лічильника ненульовий;
  значення НА сітці проходить **недоторканим** (правило вміє відповісти «ні»);
  значення між вузлами притягується, і людині сказано, що саме сталося;
* `edit_plan_check`, **розділ 1 доповнено** — у кожного поля є пояснення, і це
  саме пояснення, а не два слова; лічильники міряються в мА·год, і сирих
  одиниць людині більше не показують;
* `templates_reply_check` — міст бере логіку портів із спільного модуля, має
  `/find` і **не тримає власної копії** ознаки Bluetooth;
* звірка **від протилежного** — **9 поломок**, кожна валить свою перевірку.
  Дві з них спершу не валили нічого: одиниці полів і мовчазне притягування не
  стерегла жодна перевірка, хоч саме з них скарга й почалась;
* усі **20 хостових тестів** зелені в п'яти конфігураціях.

---

# Частина 4. ПЕРЕВІРКИ

## `#error`-перевірки у `settings.h`

Кожна звірена на порушеній конфігурації — усі спрацьовують. Це не формальність:
дві з них (обидві межі допуску живлення) знайшли реальну помилку в номіналах,
які я перед тим записав у документацію як правильні.

> Із появою **примусового пробудження** (3.30) до них додались ще **тринадцять**:
> напруга й струм режиму, обидві межі енергії з їхнім співвідношенням, крок
> машини, період проби, поріг зависання і крок шпаруватості. Кожна теж звірена
> на порушеній конфігурації. Для цього режиму це не педантизм, а єдина опора:
> він працює **без контролю температури**, і саме ці числа роблять його
> безпечним — заберіть будь-яке, і обґрунтування зникне разом із ним.

| Перевірка | Ловить |
|---|---|
| `Iб` vs `Iпік/β_форс` | ключ не увійде в насичення й згорить |
| **`Iб` на `CHARGE_PSU_MIN_MV`** | просілий, але допустимий блок виводить ключ із насичення |
| **струм драйвера на `CHARGE_PSU_MAX_MV`** | на верхній межі живлення не насичується керуючий NPN |
| **струм драйвера vs `Ic max` NPN** | у драйвері стоїть завслабкий транзистор (BC547) |
| `Iб(NPN)` vs струм драйвера / β_форс | каскадна відмова драйвера |
| `Iб(NPN)` vs безпечний струм піна | перевантаження виходу ESP32 |
| розсіювання vs 80 % `Pc` | перегрів ключа |
| `Iпік` vs `Ic max` | перевищення струму ключа |
| `ΔI/2` vs крейсерська уставка | переривчастий режим на крейсері |
| вершина пульсацій vs `CHARGE_PEAK_MA_MAX` | відсічка ловила б штатний режим |
| `CHARGE_PWM_FREQ` vs `2^bits` | недосяжна для LEDC частота |
| `D×Uживл` vs ціль + падіння на шунті | стеля скважності не дотягується до цілі |
| подільник пакета vs робоча межа АЦП | вигорання входу ESP32 |
| **подільник живлення vs межа АЦП** (рахується через `CHARGE_PSU_CAL_X1000`) | помилковий блок 19 В «залипав» би на 4095 замість числа; без поправки перевірка помилялась в обидва боки (3.32) |
| **`CHARGE_PSU_CAL_X1000` у межах 700…1400** | поправкою ховають несправність тракту — не той номінал подільника, обірваний чи пробитий вхід (3.32) |
| **струм у захисний діод `CHARGE_PSU_PIN`** | вигорання входу при вдвічі завищеному живленні |
| **порядок порогів живлення** | «немає» вище за «занижено», порожній робочий діапазон |
| **`CHARGE_SUPPLY_MV` у власному допуску** | прошивка відхиляла б штатний блок живлення |
| **`CHARGE_PSU_PIN`: ADC1 і не дублює зайняте** | вимір не читався б при увімкненому Wi-Fi |
| **`GPIO18`/`GPIO23` не зайняті нічим, крім SPI** | чужий трафік на шині дисплея; без CS панель слухає її постійно |
| **пін звуку не збігається з силовими й вимірювальними** | звук на GPIO26 — це ШІМ заряду: буззер писав би у вивід, яким регулюється струм у пакет (3.31) |
| **канали LEDC не діляться таймером** | заряд і розряд на одному таймері з різними частотами — ШІМ не прикріпиться, і ключ лишиться некерованим |
| **підлога уставки CV vs струм заводського дозаряду** | на дрібних пакетах 0.05C ліг би під підлогу, і розумний заряд «завершувався» б передчасно (3.34) |
| **підлога уставки CV vs мертва зона регулятора** | контур не відпрацював би таку уставку — фаза CV перетворилась би на брязкіт |
| **струм передзаряду vs струм фази CC** | сенс передзаряду саме в тому, що глибоко розряджений літій беруть МЕНШИМ струмом |
| **зона CV vs поріг передзаряду** | між ними не лишається фази CC узагалі |
| **ручна ціль у вольтах vs заводська ціль** | аварійна межа сеансу рахується як ціль + запас, тож ручний режим дістав би ширший дозвіл, ніж автоматичний |
| **температурні вікна обох розумних режимів vs аварійні відсічки** | режим вів би пакет рівно в аварійну відсічку |
| **`DISCHARGE_SMART_C_PCT` у межах 5…100 %** | нижче 0.05C вимір ємності триває добу, вище 1C він занижений просадкою на внутрішньому опорі |
| **межі ручних уставок vs лінійки автоматів** | ручний режим виводив би силову частину за тепловий бюджет ключа, шунта й дроселя |

## Три рантайм-відсічки, яких не було

Компіляційні перевірки рахують **номінали**, а не те, що справді припаяне. Три
відсічки в самому циклі заряду закривають цю щілину:

| Відсічка | Умова | Що рятує |
|---|---|---|
| `CHGR_PSU` | живлення поза 12.5…16 В, 3 опитування поспіль | заряд «наосліп» на не тому блоці живлення |
| `CHGR_NODRIVE` | шпаруватість у стелі, струм < 50 % уставки, 5 опитувань поспіль | силовий ключ, який працює поза насиченням (саме це дає не доопрацьована плата) |
| `CHGR_NOPACK` | показання на клемі ≥ 9300 мВ, 2 опитування поспіль | правильний діагноз замість хибної «перенапруги»: на клемі стоїть живлення, тобто пакета в колі немає (див. 3.4) |
| `CHGR_WOKE` / `CHGR_WAKE_FAIL` / `CHGR_WAKE_MAH` / `CHGR_WAKE_OVERI` | вироки **пробудження** (див. 3.30): монітор відповів / вичерпано час / вичерпано віддану ємність / струм пішов угору | режим без контролю температури, обмежений енергією, а не обережністю |

Логіка всіх трьох винесена в `charge.h` окремими функціями (`chargePsuTrip()`,
`chargeNoDriveTrip()`, `chargeNoPackTrip()`) **навмисно**: `web_server.h` на хості не збирається
взагалі (WebServer, SPIFFS, U8g2, ArduinoJson), тож усе написане всередині
`chargeTask()` не покриває жоден тест. Тепер рішення «зупинятись чи ні»
ухвалюють функції, які тест викликає напряму, а `chargeTask()` лишився тонким
викликачем. Окремо перевірено, що він їх **справді викликає** — сканером по
тексту `web_server.h`: «функція правильна» і «функцію хтось кличе» — різні
твердження, і саме на другому цей проєкт уже горів (дефект №1 нижче).

## Шістнадцять хостових тестів

| Тест | Що перевіряє |
|---|---|
| `battery_read_check` | посторінкове читання DS2433 на справжньому `readBattery()` проти симульованої шини з просіданням і шумом |
| `audit_check` | аудит змісту (чужий ключ шифрування, побиті суми) на всьому корпусі `dumps/` |
| `hdrfix_check` | добудова заголовка з дзеркала DS2438, без хибних спрацювань на 55 дампах |
| `clone_check` | відновлення за зразком китайської копії |
| `charge_logic_check` | профіль струму, регулятор, стартова шпаруватість, вимір струму/напруги, тепловий бюджет ключа, **класифікація й гістерезис живлення, усі три рантайм-відсічки, нульова маска IDLE у сторожа** — на **справжньому** `charge.h`. Відсічку «пакет від'єднано» перевірено **наскрізь**: фальшивий АЦП ставиться у стелю (4095), і тест дивиться, що `chargePackMv()` видає рівно ті 9900 мВ зі скарги |
| `session_guard_check` | взаємний захист заряду й розряду на **справжніх** `charge.h`/`discharge.h`; **і те, що `chargeTask()` справді викликає всі три відсічки**; що маска IDLE у сторожа ніде не збирається з `portNUM_PROCESSORS`, а `loop()` віддає квант часу; а конструктори дисплеїв беруть CS через макрос, а не напряму |
| `buzzer_dac_check` / `buzzer_ledc_check` | синтез звуку (вмикають звук явно, незалежно від `settings.h`) |
| `reset_consistency_check` | скидання лічильників не ламає оригінальність — на всьому корпусі `dumps/` (3.15) |
| `soc_curve_check` | шкала заряду за напругою для 2S: паспортні межі, монотонність, оборотність «% → В → %» (3.18) |
| `display_fit_check` | текст не вилазить за плашку на жодній підтримуваній панелі (3.14) |
| `menu_check` | **меню пристрою** (3.33): кожна операція каталогу є в списку рівно один раз, групи суцільні й у заданому порядку, перемикач цілі одразу після своєї дії, незворотнє винесене окремо, стрибок по групах обходить усі групи, назви влазять і в буфер, і в рядок на кожній із семи панелей |
| `smart_check` | **ручні уставки й розумний профіль 2S** (3.34): струми від паспортної ємності пакета, порядок фаз за напругою, спад уставки всередині зони CV і збіг із порогом завершення на цілі, температурне вікно в десятих градуса, завершення за струмом (і тільки у фазі CV), межі ручних уставок і те, що ручне не піднімає струм у кінці, оцінка залишку часу — плюс **повний цикл на моделі пакета**, який мусить завершитись сам, не перевищивши цілі |
| `mirror_plan_check` | план синхронізації дзеркала з правкою, свідчення про наробіток, значеннєві рядки й прогін по `dumps/` (3.19, 3.21, 3.22) |
| `ds2438_write_check` | лічильники в DS2438 справді доїжджають до чипа: зняття IAD на час запису й звірка сторінки 7 (3.22) |
| `wizard_check` | **правила Майстра** (3.38) на справжньому `wizard_rules.h`: кожна проблема має діагноз і пропозицію та потрапляє **або** в план, **або** в перелік «кроку не буде — ось чому»; кожен крок має назву, опис і власний код; крок, що пише в чип, називає чип; порядок плану й те, що перевірка результату завжди остання |

Докладний перелік того, що перевіряє кожен, — у `tools/README.md`; там же
команди запуску.

Два тести, що раніше тримали **власну копію** перевірюваної логіки, переписано
на справжні заголовки: копія лишалася б зеленою після зміни схеми, гоняючи код,
якого в проєкті вже немає. `session_guard_check` звірено в обидва боки — на
виправленому коді проходить, на коді до виправлень падає з 7 помилками.

---

# Частина 5. ЩО ВАРТО УТОЧНИТИ

Числа, які я взяв з обережної оцінки, а не з вимірювання. Усі винесені в
`settings.h` окремими константами — поправте, і перевірки перерахують решту.

| Константа | Зараз | Звідки взято |
|---|---|---|
| `CHARGE_BJT_TSW_NS` | 3000 | обережна оцінка часу розсмоктування; у даташиті B772M його немає. Від неї прямо залежить розрахунковий потолок струму |
| `CHARGE_SUPPLY_MV` | 14000 | ✅ **підтверджено власником**; і тепер це вже не єдине джерело — напруга живлення вимірюється на `CHARGE_PSU_PIN`, а константа лишилась для компіляційних перевірок і як запасне значення |
| `CHARGE_PSU_MAX_MV` | 16000 | ✅ **підтверджено власником**. Саме цей поріг вимагає 390 Ом замість 470: при 16 В струм драйвера росте до 124 мА (на 15 В вистачило б і 470 Ом, але вибір зроблено на користь ширшого допуску) |
| `CHARGE_L_UH` | 104 | «предположительно» |
| `CHARGE_SERIES_MOHM` | 600 | шунт 500 + оцінка дротів і внутрішнього опору пакета |
| `CHARGE_BJT_VCE_SAT_MV` | 500 | типове для B772M при робочому струмі |

Похибка в них **не ламає роботу**: стартова шпаруватість — це лише оцінка, далі
все веде замкнутий контур за реальним струмом, а крок регулятора пропорційний
похибці. Але від них залежать `#error`-межі, тож уточнені числа дадуть чесніший
тепловий бюджет.

**Окремо:** пульсації 1303 мА при уставці 1000 мА — це багато (ток гуляє від
349 до 1651 мА). Працювати буде, але чистіше було б підняти індуктивність.
Частоту піднімати не можна: перемикальні втрати біполярника ростуть прямо з
нею, і на 40 кГц перевірка розсіювання вже не проходить.

---

## 3.67. «Кнопки нема»: греп бачив її, а браузер не бачив нічого

**Скарга.** «В moto_bridge.py додано кнопку "🔍 Знайти прилад", маршрут — кнопки
нема.»

### Кнопки не було не тому, що її не додали

Кнопку додали. І маршрут `/find` додали. І перевірка це підтверджувала — вона
шукала обидва рядки у вихідному тексті мосту й знаходила.

Не віддавалась **сторінка цілком**. Міст падав на першому ж запиті:

```
File "usb_client/moto_bridge.py", line 223, in _send
    body = body.encode("utf-8")
UnicodeEncodeError: 'utf-8' codec can't encode characters in position 169793-169794:
                    surrogates not allowed
```

Причина в одному символі. Шар, який міст впорскує у сторінку, — це звичайний
(не `r"""`) рядок Python, і весь текст у ньому доти писався екранованим:
`'\\uD83D\\uDD0C'` — з ПОДВІЙНИМ слешем, щоб Python лишив запис як є, а
розібрав його вже JavaScript. Новий рядок написали з ОДИНАРНИМ:

```python
fb.textContent='🔍 Знайти прилад';    # ← розбирає Python, а не JS
```

`\uD83D` і `\uDD0D` — це половинки емодзі 🔍 (сурогатна пара). JavaScript із
них складає символ; Python же розібрав їх сам і поклав у рядок **дві
половинки, яких у UTF-8 не існує**. Далі `.encode("utf-8")` відмовляється — і
відмовляється до першого байта відповіді, тож браузер отримує обірване
з'єднання, а не сторінку.

**Виправлення — не подвоїти слеш, а перестати екранувати взагалі.** Файл у
UTF-8, сторінка віддається в UTF-8, `client_usb.html` поруч тримає ті самі
емодзі текстом. Екранування тут не захищало ні від чого — воно лише створювало
другий спосіб записати те саме, і другий спосіб виявився зламаним.

### Другий дефект, знайдений заразом: кнопка залежала від списку портів

Кнопка створювалась **усередині** обробника відповіді `/ports`, після рядка
`if(!ps.length) return;`. Тобто зникала разом із портами: не відповів міст,
віддав порожній список, не встановлено pyserial — і кнопки нема. А потрібна
вона рівно тоді, коли зі списком портів щось не так.

Тепер кнопка ставиться одразу, до будь-яких запитів, а список портів
під'їжджає окремо й лише якщо є що показати. Знайдений пошуком порт додається
в список, навіть якщо перерахування його не дало.

### Чому перевірка мовчала — і що з нею зробили

Перевірка мосту стерегла **написане**, а скарга була про **віддане**:

```python
check('u.path == "/find"' in src, "…а сторінка має до чого звертатись (/find)")
```

Такий греп не міг упасти в принципі: текст у файлі був. Це той самий клас, що
й «одне поле, два питання», тільки збоку перевірки — вона відповідала на
питання «чи написано», вдаючи, що відповідає на «чи працює».

Тепер у `templates_reply_check.py` піднімається **справжній обробник мосту на
справжньому сокеті**, і сторінка читається по HTTP — так само, як її читає
браузер. Кнопку шукають у тому, що прийшло по мережі. `pyserial` для цього не
потрібен: заглушка потрібна лише щоб модуль зібрався, портів у ній немає — а
це саме той випадок, у якому кнопка й зникала.

До `client_audit.py` додано перевірку класу, а не випадку: **жоден рядковий
літерал у жодному `.py` проєкту не сміє містити половинки символу**. Розбір
через `ast`, тож знаходить і те, що написали б завтра.

### Звірка «від протилежного»

П'ять диверсій, кожна валить рівно свою перевірку:

| зламали | впало |
|---|---|
| повернули сурогатну пару в емодзі | сторінка мосту взагалі віддається браузеру |
| кнопка знову народжується у відповіді `/ports` | вставляється ДО того, як питають про порти |
| прибрали кнопку зовсім | кнопка пошуку приладу в ній є |
| прибрали маршрут `/find` зі сторінки | вона має куди звертатись |
| `/ports` падає замість відповіді | перелік портів віддається у JSON |

Окремо, поза сховищем: впорскуваний JavaScript **виконано** в Node із
підставним DOM — у трьох станах (`/ports` не відповів, віддав порожньо, віддав
порт). Кнопка є в усіх трьох; із поверненою диверсією «кнопка всередині
`/ports`» при непрацюючому мосту її нема. Це та перевірка, яку сховище не
тримає (Node у збірці не потрібен), але саме вона показує, що виправлено не
текст, а поведінку.

### Що це означає для власника

Оновити треба **лише `usb_client/`** — прошивки зміна не торкається. Міст
після оновлення відкриває сторінку, і кнопка «🔍 Знайти прилад» стоїть ліворуч
від «Підключити» незалежно від того, що там зі списком портів.

---

## 3.68. «Сторінка мосту померла»: три способи вмерти до першого слова

**Скарга.** «Bridge сторінка померла, взагалі не відкривається.»

### Спершу — чесно про межі перевірки

Виправлення 3.67 (сурогатна пара) зроблене правильно: на збірковій машині
сторінка віддається і через обробник, і через справжній `main()`. Але скарга
повторилась — отже, причина була не одна. Шукали не здогадками, а відтворенням:
запускали міст рівно так, як його запускає власник, і по одному відбирали в
нього те, що на збірковій машині є, а на його — ні.

Знайшлось **два незалежні способи вмерти**, обидва відтворені, обидва — до
того, як міст устигне надрукувати перший рядок. Плюс третій, який перетворював
будь-яку іншу помилку на те саме «не відкривається».

### 1. Привітання вбивало сервер

```python
srv = ThreadingHTTPServer(("127.0.0.1", a.http), Handler)
print(" Інтерфейс:  " + url)
print(" Натисніть «Підключити» у браузері. Ctrl+C — вихід.")
...
srv.serve_forever()
```

Консоль Windows на російській/українській локалі — **cp866**. У ній немає ні
довгого тире, ні лапок-ялинок. Поки вивід іде в справжнє консольне вікно,
Python пише через WriteConsoleW і все гаразд; щойно вивід **перенаправлено**
(ярлик, запуск із іншої програми, деякі режими PyInstaller) — береться
кодування системи, і `print()` кидає `UnicodeEncodeError`.

Стоїть він **між** `bind()` і `serve_forever()`. Тобто напис, якого ніхто не
читає, не давав серверу початись: вікно блимало й зникало, браузер отримував
«connection refused».

Відтворено: `main()` з `stdout` у cp866 → сторінка не відкривається; те саме в
cp1251 → відкривається (cp1251 українські літери має, cp866 — ні). Це й пояснює,
чому дефект не бачили роками: він залежить від того, куди дивиться вивід.

Тепер увесь вивід іде через `say()`, який не вміє падати: не вліз символ — напис
втрачає розкіш (`—` стає `-`), а не роботу. Немає консолі взагалі — теж не
привід падати.

### 2. Другий запуск помирав на зайнятому порту

Міст закрили хрестиком, а процес лишився. Або не закривали зовсім. Наступний
запуск падав на `bind()` з «Address already in use» — знову **до** першого
надрукованого рядка, — а браузер відкривався на ту саму адресу, де його
зустрічав **старий примірник**.

Саме тому оновлення могло виглядати як «нічого не змінилось» (старий міст
здоровий) або як «сторінка померла» (старий міст — та сама зламана збірка
3.66). Оновлений файл при цьому лежав на диску й не запускався.

Тепер зайнятий порт — це питання, а не смерть: питаємо, **хто** там. Відповів
наш міст — кажемо, що він уже працює, і відкриваємо його. Хтось чужий — беремо
наступний вільний порт і **називаємо новий номер уголос**.

### 3. Будь-яка інша помилка виглядала так само

Виняток у обробнику `BaseHTTPRequestHandler` друкує слід у консоль (яку в
`.exe` ніхто не бачить) і мовчки закриває сокет. Для людини це те саме
«сторінка не відкривається» — з нульовою підказкою, де шукати. Саме так
виглядав і дефект 3.67.

Тепер будь-який виняток стає сторінкою з причиною й слідом. Кодування там
навмисно поблажливе (`replace`) — це остання відповідь, краще показати текст із
зіпсованим символом, ніж не показати нічого. У `_send()` кодування лишається
**суворим**: інакше сурогатна пара з 3.67 перетворилась би на «????» і дефект
знову ніхто б не помітив.

### Правило, яке з цього виросло

**Між `bind()` і `serve_forever()` не сміє стояти нічого, що вміє падати.** Три
різні причини дали один симптом рівно тому, що всі троє встигали спрацювати в
цьому проміжку.

### Звірка «від протилежного»

П'ять диверсій, кожна валить рівно свою перевірку:

| зламали | впало |
|---|---|
| привітання знову звичайним `print()` | консоль, яка не вміє українських лапок, не заважає мосту |
| `say()` тихо ковтає текст | (та сама, плюс перевірка зайнятого порту) |
| зайнятий порт знову валить `bind()` | міст бере наступний вільний і називає адресу |
| про підміну порту мовчать | каже, ЧОМУ адреса не та, яку чекали |
| виняток у обробнику знову рве з'єднання | виняток стає сторінкою з причиною |

### Що це означає для власника

Оновити треба **лише `usb_client/`**. Якщо міст після оновлення поводиться не
так, як описано, — тепер є що показати: у консольному вікні або на самій
сторінці стоїть причина. «Нічого не відкривається» без жодного тексту більше
не мусить траплятись; якщо трапиться — значить, є четвертий спосіб, і його теж
шукатимемо відтворенням, а не здогадками.

---

## 3.69. Кнопки: найчастіше — коротким, найрідше — довгим

**Завдання власника.** «Коротке натискання — зчитування, довге — меню.
Прихований жест — комбінація клавіш вліво-вправо-вправо-вліво-ввід, увід
команди протягом 5 секунд; якщо за цей час комбінація не набрана, лічильник
обнуляється.» І окремо: **вибір Wi-Fi/Bluetooth — першим пунктом меню.**

### Що було не так із попереднім розподілом

На кільці показань «OK» працював навпаки: коротке відкривало меню, довге (0.8 с)
зчитувало пакет. Ціна видна з частот: зчитування роблять десятки разів за сеанс
— поклав пакет, подивився; меню відкривають кілька разів. Тримати кнопку заради
найчастішої дії — це плата, яку сплачують щоразу.

Тепер навпаки, в обох драйверах екрана й в обох режимах (три кнопки та дві).
Підказка на порозі 0.8 с змінилась разом із дією: замість «відпустіть =
ЗЧИТАТИ» — «відпустіть = МЕНЮ». Підказка, яка обіцяє не те, гірша за відсутню.

### Прихований жест: з утримання назад у ланцюжок

Сходинка на 10 секунд утримання прибрана цілком — разом зі станом `CHS_FLASH`,
подією `CHOLD_FLASH` і порогом `COMBO_HOLD_FLASH_MS`. Верхньою лишилась
сходинка заряду (5 с), і тримати довше тепер просто нема за чим.

Замість неї — послідовність клавіш із вікном у 5 секунд.

**Вікно рахується від ПЕРШОЇ клавіші, а не від попередньої.** Це рішення
власника («ввід команди протягом 5 секунд»), і різниця не косметична: допуск
темпу між сусідніми натисканнями карав би за одну паузу посеред правильно
набраного жесту, і людина не розуміла б, чому «те саме» то працює, то ні. Вікно
на весь жест пояснюється одним реченням: почав — маєш 5 секунд.

**Лічильник гасне сам, а не «на наступному натисканні».** Без цього половина
жесту лежала б у пам'яті приладу до наступної кнопки — хоч і через годину, — і
три випадкові натискання зранку складались би з двома ввечері. Виглядало б це
як самочинне спрацювання.

**Незбіг не просто обнуляє, а пробує почати заново цією ж клавішею.** Без цього
найзвичайніша обмовка — зайва перша клавіша — не давала б набрати жест ніколи:
лічильник обнулявся б саме на тому натисканні, яке мало стати початком.

### Зв'язок — перший пункт

Група «ЗВ'ЯЗОК» переїхала з п'ятого рядка на перший. Причина та сама, що й при
її появі, тільки доведена до кінця: до перемикача радіо доводиться діставатись
саме тоді, коли зв'язку НЕМАЄ, — тобто не через клієнта, а кнопками, наосліп.
Кожен рядок над ним — натискання навпомацки.

«Першим» тут означає першим **серед пунктів**: рядок «‹ Показання» — не пункт, а
вихід із меню, і курсор навмисно починається після нього. Тепер, увійшовши в
меню, людина одразу стоїть на перемикачі.

> ⚠️ Побічний наслідок, який варто знати: курсор при вході в меню тепер стоїть
> саме на «Зв'язок». Випадковий «OK» перемкне радіо й перезавантажить прилад.
> Це оборотно тими самими двома натисканнями, але перший раз здивує.

### Як це перевірено — і чому цього разу по-справжньому

Драйвер екрана збирається на хості (`display_build_check`), а кнопки приладу
висять на одному аналоговому вході. Тож замість «чи є у файлі такий рядок» тест
тепер **натискає кнопки**: підставляє напругу кожної, крутить `millis()` і
дивиться, що зробив драйвер.

Різниця виявилась не теоретичною одразу двічі:

* Перша редакція помічника `tap()` подавала «натиснуто» двома проходами — і
  довге натискання не спрацьовувало взагалі: антидребезг визнає кнопку
  натиснутою лише на другому проході, тобто відлік утримання починався в мить
  відпускання. У приладі `loop()` крутиться безперервно; помічник, який цього
  не відтворює, перевіряє себе, а не прошивку.
* Диверсія проти монохромного драйвера **нічого не зламала** — і це виявилось
  правдою: `display.h` для кольорового екрана лише підключає `display_color.h`,
  тож збірка на хості монохромного шляху не бачить. Для нього лишився текстовий
  страж, і він перевіряє ОБИДВА боки правила: що потрібне є **і** що зворотнього
  немає ніде.

Окремо перебрано те, чого текстом не перевірити взагалі: **жест не набирається
звичайною роботою**. Гортання вперед, назад, туди-сюди, вхід-вихід по пунктах —
по двадцять повторів кожного; і тисяча випадкових натискань із тих самих трьох
клавіш.

Десять диверсій, кожна валить рівно свою перевірку — від «кнопки навпаки» в
кожному з драйверів окремо до «ланцюжок став коротшим».

### Що це означає для власника

Оновити треба **прошивку**. Клієнтів зміна не торкається.

---

## 3.70. Довший ланцюжок вимагає розумнішого відкату

**Завдання власника.** Замінити комбінацію на «вліво вліво вправо вправо вправо
вправо вліво вліво вправо» — дев'ять клавіш замість п'яти, і **без «OK»**.

### Одна зміна, яка потягла за собою правило

Ланцюжок замінили в одному рядку. А от відкат після обмовки — правило «скільки
клавіш лишається зарахованими, коли натиснули не ту» — довелось переписати, і
це не перестраховка.

Попередній жест («‹ › › ‹ OK») мав просту властивість: **жоден його власний
хвіст, крім однієї клавіші, не був його ж початком**. Тому вистачало відкату
«почати заново цією клавішею».

У нового це не так. Порахували:

| набрано клавіш | хвіст, який теж є початком |
|---|---|
| 2 | «‹» |
| 7 | «‹» |
| 8 | **«‹ ‹»** |
| 9 (весь) | «‹ ‹ ›» |

Рядок «8» і ламає старе правило. Набрано вісім («‹ ‹ › › › › ‹ ‹»), дев'ятою
мало бути «›», а натиснули «‹». Правильна відповідь — **дві** зараховані
клавіші, і жест добирається рештою. Старе правило лишило б одну, і набір
«‹ ‹ › › › › ‹ ‹ **‹** › › › › ‹ ‹ ›» не спрацював би **ніколи**.

Тепер відкат шукає найдовший суфікс «набране + клавіша», який є початком
ланцюжка. Це те саме, що робить таблиця Кнута—Морріса—Пратта, тільки без
таблиці: для дев'яти клавіш прямий перебір коштує десятки порівнянь раз на
натискання, а таблиця, яку ніхто не читає очима, коштувала б помилки в ній.

### Після спрацювання — чистий аркуш, а не відкат

Останній рядок таблиці («‹ ‹ ›» — теж початок) дає ще один наслідок: якби після
спрацювання лічильник відкочувався, як після звичайної обмовки, напис вискочив
би **вдруге** вже за шість клавіш. Двічі поспіль — це вигляд несправності, а не
жарт. Тому після спрацювання лічильник обнуляється.

### Обмовка не дарує нових п'яти секунд

Клавіші, які лишились зарахованими після обмовки, натиснуто **раніше** — відлік
для них уже йде. Інакше жест, набраний за півхвилини з помилками, усе одно
зарахувався б, і «п'ять секунд на ввід» перестало б щось означати.

А от повний провал (не лишилось нічого) — це вже новий набір, і своє вікно він
дістає законно.

### Чесно про два наслідки

**Дев'ять клавіш за 5 секунд — це ~0,55 с на клавішу.** Вкладеність перевірено
(дев'ять по півсекунди зараховуються, по 0,7 с — уже ні), але темп бадьорий.
Якщо на приладі не виходитиме — вікно розширюється одним числом
(`COMBO_SEQ_WINDOW_MS`).

**У жесті лише дві різні клавіші, і саме ними гортають меню.** Це не міркування,
а виміряне число: **20 000 випадкових натискань «‹/›» дали жест 24 рази —
приблизно раз на 830 натискань**. На справжньому гортанні рідше (воно йде
пробігами в один бік, а не випадково: пробіги по одній, три й п'ять клавіш не
дають жесту жодного разу за 60 повторів), але нулем це не буде. Попередній
жест закінчувався на «OK» і тому не міг набратись рухом узагалі.

Якщо вискакуватиме — найдешевше повернути «OK» останньою клавішею: це вбиває
випадкове спрацювання повністю, бо гортання «OK» не містить.

### Перевірка

Ланцюжок у тесті записаний **окремо** від `COMBO_SEQ` — інакше перевірка
проходила б на будь-якій зміні, тобто не перевіряла б нічого. До поведінкових
перевірок драйвера (тест справді натискає кнопки) додано вісім нових про сам
ланцюжок, зокрема три про відкат числом і два — поведінкою.

Дев'ять диверсій, кожна валить рівно свою перевірку: спрощений відкат,
вимкнений відкат, відкат після спрацювання, продовжене вікно, укорочений
ланцюжок, переставлений ланцюжок, повернутий «OK», вимкнене вікно й остання
клавіша, що гортає сторінку ще й сама.

### Що це означає для власника

Оновити треба **прошивку**. Клієнтів зміна не торкається.
