roman885-85/moto_battery_reader/motorola-battery-reader-web.ino

#include <Arduino.h>
#include <WiFi.h>
#include <WebServer.h>
#include <DNSServer.h>
#include <SPIFFS.h>
#include <esp_system.h>
#include "postmortem.h"          // чорний ящик: що робив пристрій перед скиданням

// ⚑ RTC_NOINIT_ATTR — пам'ять, яку НЕ чіпає завантажувач. Саме тому запис
//  переживає і паніку, і сторожа, і просадку живлення: після скидання дані
//  лишаються на місці, і ми можемо сказати, ЩО САМЕ робив пристрій.
RTC_NOINIT_ATTR PmTrace g_pmTrace;
static PmTrace g_pmPrev;              // копія ДО того, як почнемо перезаписувати
static bool    g_pmPrevOk = false;
static int     g_pmResetReason = 0;

// Записати слід. Кличеться раз на опитування — дешево (кілька присвоєнь).
void pmNote(uint8_t mode, uint16_t polls, uint16_t duty, int16_t ma, uint16_t mv) {
    g_pmTrace.magic     = PM_MAGIC;
    g_pmTrace.ms        = millis();
    g_pmTrace.freeHeap  = ESP.getFreeHeap();
    g_pmTrace.maxBlock  = ESP.getMaxAllocHeap();
    g_pmTrace.stackLeft = uxTaskGetStackHighWaterMark(NULL);
    g_pmTrace.polls     = polls;
    g_pmTrace.duty      = duty;
    g_pmTrace.ma        = ma;
    g_pmTrace.mv        = mv;
    g_pmTrace.mode      = mode;
}

// Позначити етап усередині опитування. Один запис у пам'ять — навмисно дешево,
// щоб можна було ставити позначку на кожному кроці без роздумів про вартість.
void pmStep(uint8_t step) { g_pmTrace.step = step; }
#include "settings.h"
#include "leds.h"
#include "battery_reader.h"
#include <esp_ota_ops.h>   // esp_ota_get_running_partition() — звіт про флеш
#include "display.h"
#include "web_server.h"
#include "serial_api.h"

// Глобальні об'єкти
WebServer server(HTTP_PORT);
DNSServer dnsServer;                 // captive-portal: авто-відкриття сторінки
BatteryReader battery(DS_PIN, PULLUP_PIN);

uint8_t batteryDump[DUMP_SIZE];
bool hasDump = false;

uint8_t batteryDump2438[DS2438_MEM_SIZE];
bool hasDump2438 = false;

// Серійний номер (лазерний 1-Wire ROM-ID) чипа DS2438 з останнього читання
uint8_t chipSN2438[8] = {0};
bool hasSN2438 = false;

// ROM-ID чипа DS2433. Потрібен НЕ лише для показу: з нього беруться ключі
// шифрування лічильників і дат у прошивці АКБ (key1 = ROM[1], key2 = ROM[6]) —
// див. impres_bms.h. Без нього ключ доводиться підбирати перебором.
uint8_t chipSN2433[8] = {0};
bool hasSN2433 = false;

// Людський опис причини останнього скидання ESP32 (esp_reset_reason()) —
// друкується найпершим повідомленням у setup(), щоб «перезавантажується під
// час заряду/розряду» одразу було видно як BROWNOUT/WDT/PANIC, а не
// доводилось здогадуватись за непрямими ознаками.
const char *resetReasonText(esp_reset_reason_t r) {
    switch (r) {
        case ESP_RST_POWERON:   return "подача живлення";
        case ESP_RST_EXT:       return "зовнішній сигнал RESET";
        case ESP_RST_SW:        return "програмний esp_restart()";
        case ESP_RST_PANIC:     return "ПАНІКА/виключення — крах прошивки";
        case ESP_RST_INT_WDT:   return "апаратний WDT переривань (ISR завис)";
        case ESP_RST_TASK_WDT:  return "TASK WDT — головний цикл (loop) завис";
        case ESP_RST_WDT:       return "інший сторожовий таймер";
        case ESP_RST_DEEPSLEEP: return "вихід з глибокого сну";
        case ESP_RST_BROWNOUT:  return "BROWNOUT — просадка живлення нижче порогу";
        case ESP_RST_SDIO:      return "SDIO";
        default:                return "невідома причина";
    }
}

// ── ЯКЕ РАДІО СПРАВДІ ПІДНЯЛОСЬ ───────────────────────────────────────────
//  ⚑ ЦЕ НЕ ДУБЛЬ radioMode(), І РІЗНИЦЯ ТУТ ІСТОТНА. radioMode() відповідає на
//  питання «що обрав власник», а цей прапорець — «що зараз працює». У нормі
//  вони збігаються, але Bluetooth може не піднятись (не та схема розділів,
//  бракує пам'яті), і тоді прилад свідомо вмикає Wi-Fi, щоб не лишитись німим
//  в обох ефірах. Питання різні — отже й відповіді дві, і жодна з них не зайва.
static bool g_wifiUp = false;

void setup() {
    // ПРИМІТКА: setRxBufferSize() тут НЕ викликаємо. Великі команди запису по USB
    // (WRITE33 ~1 КБ) надсилаються КЛІЄНТОМ частинами по ~200 Б із мікропаузами
    // (client_usb.html / moto_gui.py / moto_bridge.py), тож типового 256-байтного
    // UART-буфера достатньо і жодного втручання в ініціалізацію не потрібно.
    //
    // TX-буфер, навпаки, ЗБІЛЬШУЄМО. Заряд/розряд логують у Serial щосекунди
    // ГОДИНАМИ (chargeTask()/dischargeTask()) — при заповненому TX-буфері
    // (закритий монітор порту, повільний/відсутній читач на іншому кінці)
    // Serial.print() на ESP32 БЛОКУЄ виклик, доки не звільниться місце; якщо
    // ніхто й ніколи не читає — блокує головний цикл НАЗАВЖДИ, доки не
    // втрутиться сторожовий таймер і не перезавантажить пристрій. Саме це,
    // найімовірніше, стоїть за скаргою «зависання й самовільні
    // перезавантаження». Викликати ДО begin() — інакше не подіє.
    Serial.setTxBufferSize(2048);
    Serial.begin(115200);

    // ⚑ ПЕРШЕ, ЩО РОБИМО — ГАСИМО СИЛОВИЙ КЛЮЧ І ENABLE.
    // Якщо пристрій перезавантажився сторожем посеред розряду (див.
    // dischargeWatchdog у discharge.h), пакет усе ще підключений до резистора.
    // Поки не виконано жодного рядка ініціалізації, піни — входи, і затвор
    // тримає лише підтяжка. Опускаємо обидва явно й одразу, до дисплея, Wi-Fi
    // і всього іншого, що може зайняти секунди або впасти.
#ifdef LOAD_PIN
    pinMode(LOAD_PIN, OUTPUT);   digitalWrite(LOAD_PIN, LOW);
#endif
#ifdef CHARGE_PWM_PIN
    // CHARGE_PWM_PIN — ШІМ на базу NPN, що прочиняє P-MOSFET. LOW = NPN
    // закритий, затвор підтягнуто до +, ключ ЗАКРИТИЙ (див. схему в
    // settings.h). Ставимо це найпершим, ще до дисплея/Wi-Fi: якщо пристрій
    // перезавантажився сторожем посеред заряду, ключ усе ще може бути
    // прочинений наведенням, поки піни — входи.
    pinMode(CHARGE_PWM_PIN, OUTPUT);
    digitalWrite(CHARGE_PWM_PIN, LOW);
#endif
#ifdef CHARGE_TL_EN_PIN
    // ⚑ ГОТОВА ПЛАТА DC/DC НА TL494: ТУТ ЦЕ НАЙВАЖЛИВІШИЙ РЯДОК УСЬОГО setup().
    //  Плата пропускає вхід на вихід (~14 В) БЕЗ жодного керування — єдине, що
    //  стоїть між пакетом і цією напругою, — enable. Поки пін висить входом,
    //  рівень на ньому невизначений, і після скидання сторожем посеред заряду
    //  каскад цілком може лишитись увімкненим.
    //  Тому опускаємо його ТУТ, а не в chargeInit(): той кличеться на сотню
    //  рядків нижче, після дисплея, SPI й Wi-Fi — тобто після всього, що вміє
    //  зайняти секунди або впасти. chargeInit() зробить те саме ще раз, і це
    //  не дублювання: там воно частина штатної послідовності «уставка в нуль,
    //  потім enable», а тут — аварійне гасіння до будь-якої ініціалізації.
    pinMode(CHARGE_TL_EN_PIN, OUTPUT);
    digitalWrite(CHARGE_TL_EN_PIN, LOW);
#endif
#ifdef CHARGE_LEGACY_EN_PIN
    // Пін попередньої схеми заряду (enable TL494-плати). Переробка його
    // прибрала, і він лишився висіти ВХОДОМ — а на платі до нього може бути
    // припаяний той самий ланцюг. Невизначений рівень на вході чужої схеми
    // з'являється саме «після переробки» й виглядає як стороння несправність.
    // Опускаємо в LOW, як робив попередній скетч: нічого не припаяно — дія
    // безкоштовна, припаяно — відновлено дореформений стан.
    pinMode(CHARGE_LEGACY_EN_PIN, OUTPUT);
    digitalWrite(CHARGE_LEGACY_EN_PIN, LOW);
#endif
    pinMode(PULLUP_PIN, OUTPUT); digitalWrite(PULLUP_PIN, LOW);

    Serial.println("\n\nMotorola Battery Reader Web Server (AP Mode)");
    Serial.println("==============================================");
    // Причина ЦЬОГО старту — щоб відрізнити подачу живлення від несподіваного
    // скидання (BROWNOUT — просадка живлення під час вмикання силового
    // каскаду заряду/розряду, TASK_WDT — завис головний цикл, PANIC — крах
    // прошивки). Особливо важливо для скарг «перезавантажується під час
    // заряду/розряду» — сама ця причина одразу відсікає половину гіпотез.
    g_pmResetReason = (int)esp_reset_reason();
    Serial.printf("RESET REASON: %s (код %d)\n",
                  resetReasonText((esp_reset_reason_t)g_pmResetReason), g_pmResetReason);

    // ── ЧОРНИЙ ЯЩИК ────────────────────────────────────────────────────────
    //  Знімаємо копію ДО того, як почнемо перезаписувати слід, і друкуємо її.
    //  Без цього «періодично перезавантажується» лишається здогадкою: причина
    //  скидання каже ЩО сталося, а ці числа — за яких обставин.
    g_pmPrev   = g_pmTrace;
    g_pmPrevOk = pmTraceValid(g_pmPrev, g_pmResetReason);
    if (g_pmPrevOk) {
        Serial.printf("ПЕРЕД СКИДАННЯМ: %s, ЕТАП «%s», %lu с роботи, опитування %u, "
                      "duty %u, %d мА, %u мВ\n",
                      pmModeName(g_pmPrev.mode), pmStepName(g_pmPrev.step),
                      (unsigned long)(g_pmPrev.ms / 1000),
                      g_pmPrev.polls, g_pmPrev.duty, g_pmPrev.ma, g_pmPrev.mv);
        Serial.printf("ПЕРЕД СКИДАННЯМ: купа %lu Б (найбільший блок %lu Б), "
                      "запас стека loop() %lu Б\n",
                      (unsigned long)g_pmPrev.freeHeap, (unsigned long)g_pmPrev.maxBlock,
                      (unsigned long)g_pmPrev.stackLeft);
        // Три підозрюваних — і одразу вказівка, куди дивитись.
        if (g_pmPrev.stackLeft < 512)
            Serial.println("⚠ ЗАПАС СТЕКА БУВ МІЗЕРНИЙ — схоже на переповнення стека.");
        if (g_pmPrev.maxBlock < 20000 && g_pmPrev.freeHeap > g_pmPrev.maxBlock * 2)
            Serial.println("⚠ КУПА СИЛЬНО ФРАГМЕНТОВАНА — вільної пам'яті вистачає, "
                           "а суцільного шматка вже немає.");
        if (g_pmResetReason == PM_RST_BROWNOUT)
            Serial.println("⚠ ПРОСАДКА ЖИВЛЕННЯ — дивіться живлення 3.3 В і силовий каскад, "
                           "а не прошивку.");
    } else if (pmIsAbnormal(g_pmResetReason)) {
        Serial.println("ПЕРЕД СКИДАННЯМ: слід недоступний (перше вмикання після "
                       "подачі живлення або новий запис прошивки).");
    }
    // Далі слід перезаписується поточною роботою.
    g_pmTrace.magic = PM_MAGIC;

    // Ініціалізація дисплея і кнопок меню + стартова заставка.
    //
    // ⚠️ ПОРЯДОК ТУТ ЗНАЧУЩИЙ: displayInit() мусить іти РАНІШЕ за
    // dischargeInit(). Причина неочевидна — SPI.begin() без аргументів чіпляє
    // не лише SCK/MOSI, а й MISO, а для VSPI це GPIO19, тобто рівно той пін,
    // на якому в цьому проєкті сидить затвор ключа розряду (LOAD_PIN).
    // Дисплею читання не потрібне взагалі, але бібліотека про це не знає.
    // Працює воно тому, що пізніший ledcAttach() у dischargeInit()
    // перепризначає пін через матрицю GPIO й перекриває MISO, а SPI.begin()
    // кличеться один раз і назад уже не відіграє.
    // Переставите виклики місцями — розряд МОВЧКИ перестане керуватись:
    // прошивка збереться, ключ просто не відкриється.
    displayInit();
    displayButtonSetup();
    displayIntro();                 // чорний екран -> плавна поява/зникнення заставки
    displaySetStatus("ЗАПУСК...");

    // Налаштування світлодіодів (неблокуюча індикація)
    ledInit();
    // Налаштування звуку читаємо ДО стартового «привіту»: інакше пристрій із
    // вимкненим звуком однаково писнув би при кожному вмиканні. SPIFFS нижче
    // монтується ще раз — повторний begin() на вже змонтованій ФС нешкідливий.
    // Разом зі звуком піднімаємо й системну дату: вона потрібна вже в меню
    // пристрою (наробіток рахується від дати першого запуску), а клієнт може
    // не прийти взагалі.
    if (SPIFFS.begin(true)) { soundCfgLoad(); deviceClockLoad(); chargeModeLoad(); }
    buzzSelfTest();     // стартовий «чирп» самоперевірки динаміка (+ діагностика в Serial)

    // Ініціалізація батареї
    if (!battery.begin()) {
        Serial.println("ERROR: Failed to initialize battery reader");
        ledWrite(false, true);   // постійний червоний — фатальна помилка
        while(1) delay(1000);
    }
    Serial.println("Battery reader initialized");
    
    // ── ЗВ'ЯЗОК ІЗ КЛІЄНТАМИ: ОДНЕ РАДІО ЗА РАЗ ───────────────────────────
    //  Радіо в ESP32 одне, стеків два, і вирішує тут пам'ять: Bluedroid бере
    //  ~70 КБ одним шматком. Правила («що з чого випливає») живуть у
    //  radio_mode.h — там їх дістає хостовий тест; тут лишається виконання.
    //
    //  ⚑ BLUETOOTH ПІДНІМАЄМО ПЕРШИМ, і це не косметика. Раніше він стояв
    //  останнім у setup() — щоб рядок про вільну купу показував чесний
    //  залишок. Тепер режими взаємовиключні, а от відмова Bluetooth мусить
    //  лишити час підняти Wi-Fi замість нього: підніматись йому вже НЕМА КОЛИ,
    //  якщо точка доступу піднялась раніше й зайняла пам'ять.
    g_wifiUp = radioWantsWifi(radioMode());
    if (radioWantsBt(radioMode())) {
        btBegin();
        if (!btUp()) {
            // Німий в обох ефірах — найгірший результат перемикача зв'язку:
            // достукатись до приладу лишиться тільки кабелем, а причина
            // («не та схема розділів») з екрана не видна.
            Serial.println("BT: не піднявся — вмикаємо Wi-Fi, щоб прилад "
                           "не лишився без зв'язку взагалі.");
            displaySetStatus("BT НЕ ЗАПУСТИВСЯ");
            g_wifiUp = true;
        }
    }

    // Створюємо точку доступу
    if (g_wifiUp) {
    Serial.printf("Creating Access Point: %s\n", AP_SSID);
    WiFi.softAP(AP_SSID, AP_PASSWORD);
    // Вимикаємо WiFi modem-sleep: періодичні цикли «сон/пробудження» радіо
    // додають переривання саме там, де 1-Wire (бітбенг у battery_reader.cpp)
    // критично залежить від точності delayMicroseconds() — це задокументована
    // причина нестабільних/«сміттєвих» читань DS2433/DS2438 САМЕ під час
    // активного WiFi-трафіку (arduino-esp32#755 та інші). Скарга власника
    // «помилка лише у веб-версії» це й підтверджує: веб-інтерфейс тримає
    // радіо значно активнішим (постійні HTTP-запити/опитування), ніж USB
    // або меню пристрою, де WiFi лише простоює в фоні. Пристрій живиться не
    // від батарейки, тож постійно активне радіо — прийнятна ціна.
    WiFi.setSleep(false);

    IPAddress IP = WiFi.softAPIP();
    Serial.print("AP IP Address: ");
    Serial.println(IP);

    // Captive-portal DNS: відповідаємо адресою ESP на будь-який домен, щоб телефон/ПК
    // при підключенні до Wi-Fi одразу запропонував відкрити нашу сторінку.
    dnsServer.start(53, "*", IP);
    Serial.println("Captive-portal DNS started");
    } else {
        // Точку доступу свідомо НЕ піднімаємо: увесь сенс режиму Bluetooth у
        // тому, щоб радіо й пам'ять дісталися одному стеку.
        Serial.println("Wi-Fi: точку доступу не піднімаємо — обрано зв'язок "
                       "через Bluetooth (меню «ЗВ'ЯЗОК»).");
    }

    // Короткий зелений сигнал успішного старта AP
    ledSet(LED_OK);
    
    // SPIFFS монтуємо (потрібен для журналів Майстра відновлення й збереження
    // дампів під час сесії). Але збережений останній дамп при старті НЕ
    // завантажуємо: дисплей/веб/USB лишаються ЧИСТИМИ (без даних), поки не
    // зчитають акумулятор. Щоб повернути показ останнього дампа після
    // перезавантаження — додайте у settings.h: #define LOAD_SAVED_DUMPS_ON_BOOT
    if (SPIFFS.begin(true)) {
#ifdef LOAD_SAVED_DUMPS_ON_BOOT
        File file = SPIFFS.open("/dump.bin", "r");
        if (file) {
            size_t size = file.read(batteryDump, DUMP_SIZE);
            if (size == DUMP_SIZE) {
                hasDump = true;
                Serial.println("Loaded saved DS2433 dump from SPIFFS");
            }
            file.close();
        }

        File file2438 = SPIFFS.open("/dump2438.bin", "r");
        if (file2438) {
            size_t size = file2438.read(batteryDump2438, DS2438_MEM_SIZE);
            if (size == DS2438_MEM_SIZE) {
                hasDump2438 = true;
                Serial.println("Loaded saved DS2438 dump from SPIFFS");
            }
            file2438.close();
        }
#else
        Serial.println("Clean start: saved battery dump NOT loaded (read a battery to populate)");
#endif
    } else {
        Serial.println("SPIFFS mount failed!");
    }
    
    // Розрядне навантаження — у безпечний стан ДО всього іншого.
    dischargeInit();
    // Силовий ключ заряду — так само, у безпечний стан ДО всього іншого.
    chargeInit();

    // Запускаємо веб-сервер — лише там, де є кому відповідати. У режимі
    // Bluetooth сокет нікуди не під'єднати, а пам'ять він забере.
    if (g_wifiUp) setupWebServer();

    Serial.println("\n==============================================");
    Serial.println("READY!");
    Serial.printf("Зв'язок: %s%s\n", radioModeName(radioMode()),
                  (radioWantsBt(radioMode()) && g_wifiUp) ? " (не піднявся, працює Wi-Fi)" : "");
    if (g_wifiUp) {
        Serial.printf("Connect to Wi-Fi: %s\n", AP_SSID);
        Serial.printf("Password: %s\n", AP_PASSWORD);
        Serial.printf("Open browser: http://%s\n", ESP_IP);
    }
#ifdef BT_ENABLED
    Serial.printf("Bluetooth: %s (SPP — у системі з'явиться COM-порт)\n",
                  btUp() ? btName().c_str() : "НЕ ЗАПУСТИВСЯ");
    // ⚑ ПАРОЛЬ ЗА ЗАМОВЧУВАННЯМ + РАДІО = поганий збіг. По USB це не мало
    //  значення (перепустка — кабель), по Bluetooth має: у радіусі дії
    //  опиняється будь-хто, а пароль зі стандартної збірки відомий усім.
    //  Не блокуємо збірку — це вибір власника, — але мовчати теж не можна.
    if (String(ADMIN_PASSWORD) == "admin123")
        Serial.println("⚠ BT: ADMIN_PASSWORD стандартний («admin123»). По радіо це майже "
                       "те саме, що без пароля — змініть його в settings.h.");
#endif
    // Вільна купа — головний обмежувач, коли ввімкнено і Wi-Fi, і Bluetooth.
    Serial.printf("Вільна купа: %u байтів (найбільший суцільний блок %u)\n",
                  (unsigned)ESP.getFreeHeap(), (unsigned)ESP.getMaxAllocHeap());

    // ── СКІЛЬКИ ЛИШИЛОСЬ ФЛЕША ПІД ПРОГРАМУ ───────────────────────────────
    //  ⚑ Навіщо друкувати те, що видно в IDE. Бо в IDE це видно ЛИШЕ тому, хто
    //  щойно збирав, і лише доти, доки не закрив вікно. А впирається в стелю
    //  той, хто через півроку додасть одну функцію й отримає «Sketch too big»
    //  без жодної підказки, ЯКА схема розділів у нього обрана.
    //
    //  Схема задається в IDE, а не в коді, тож перевірити її на компіляції
    //  неможливо — залишається сказати вголос після прошивки. Поріг 90 %
    //  попереджає ЗАЗДАЛЕГІДЬ: між «тісно» і «не збирається» тут буває одна
    //  невелика правка.
    {
        const esp_partition_t *app = esp_ota_get_running_partition();
        if (app) {
            uint32_t used = ESP.getSketchSize(), cap = app->size;
            unsigned pct = cap ? (unsigned)((uint64_t)used * 100 / cap) : 0;
            Serial.printf("Флеш під програму: %u з %u байтів (%u%%), розділ «%s»\n",
                          (unsigned)used, (unsigned)cap, pct, app->label);
            if (pct >= 90)
                Serial.println("⚠ ФЛЕШ МАЙЖЕ ЗАПОВНЕНО. Наступна правка може не зібратись. "
                               "Оберіть в Arduino IDE: Інструменти -> Partition Scheme -> "
                               "«Huge APP (3MB No OTA/1MB SPIFFS)» — програмі стане 3 МБ, "
                               "SPIFFS лишиться 1 МБ (вистачає з запасом).");
        }
    }
    Serial.println("==============================================");
    
    // Переходимо в режим очікування (зелений «пульс» раз на 3 с)
    ledSet(LED_IDLE);

    // Готовність на дисплеї — плавний вхід у головне меню.
    displaySetStatus("ГОТОВО");
    displayFadeInMain();
}

void loop() {
    // Captive-portal і веб — тільки коли точка доступу справді піднята.
    //
    //  ⚑ ГЕЙТ, А НЕ «ВОНО САМО НІЧОГО НЕ ЗРОБИТЬ». handleClient() на сервері,
    //  якому не робили begin(), лізе в неініціалізований сокет; те саме з DNS.
    //  У режимі Bluetooth їх просто немає кому обслуговувати.
    if (g_wifiUp) {
        dnsServer.processNextRequest();
        // WebServer автоматично обробляє multipart upload в handleClient()
        server.handleClient();
    }

    // Командний протокол по USB-Serial (Windows-клієнт). Працює паралельно з Wi-Fi.
    serialTask();

    // Керований розряд: опитування монітора й запобіжники (реальна робота раз
    // на DISCHARGE_POLL_MS). Викликаємо ДО обробки кнопок, щоб аварійні
    // відсічки спрацьовували з мінімальною затримкою.
    dischargeTask();

    // Керований заряд: та сама логіка опитування й запобіжників, окремий стан
    // (charge.h). Заряд і розряд не можуть іти одночасно — обидва старти
    // взаємно перевіряють стан одне одного (chargeStart()/dischargeStart()).
    chargeTask();

    // Контроль живлення +14 В У СПОКОЇ. Під час заряду живлення міряє сам
    // chargeTask() (на закритому ключі, разом із напругою пакета), а тут — коли
    // заряд не йде: несправний блок треба показати ДО того, як користувач
    // натисне «заряд», а не після невдалого старту. Індикація постійна
    // (LED_FAULT — два червоних спалахи з паузою), тож помилку видно й без
    // екрана та веба.
    chargePsuIdleTask();

    // Блимання напису на сторінці помилки живлення. Окремим завданням, а не
    // всередині chargePsuIdleTask(), бо періоди різні: живлення міряємо раз на
    // 2 с, а блимати треба двічі на секунду. Поза сторінкою помилки функція
    // виходить одразу.
    displayPsuBlinkTask();

    // Повноекранне повідомлення по комбінації кнопок гасне САМЕ, за часом.
    displayFlashTask();

    // Перемикач «версія без заряду» правлять кнопками, тобто з display*.h, а
    // файлова система живе тут. Прапорець ставить chargeSetOffByUser(), запис
    // робимо в циклі — той самий прийом, що й зі зняттям сигналу enable.
    if (chargeConsumeModeSave()) chargeModeSave();

    // Режим зв'язку — тим самим шляхом і в той самий файл: обидва значення
    // пише chargeModeSave(), тож зберігати їх окремо не можна (затерли б
    // сусіда). Перезавантаження — ПІСЛЯ запису й з паузою на дописування
    // Serial: рестарт із недописаним файлом означав би, що обраний режим
    // мовчки не застосувався.
    if (radioConsumeSave()) chargeModeSave();
    if (radioConsumeReboot()) {
        displayShow("ПЕРЕЗАВАНТАЖ.");
        Serial.flush();
        delay(600);
        ESP.restart();
    }

    // Зняти утримання сигналу enable після зупинки розряду/заряду. Робиться
    // тут, а не в dischargeStop()/chargeStop(), щоб ці файли не залежали від
    // драйвера 1-Wire: зупинку викликають і з веба, і з USB, і з кнопки на
    // пристрої.
    if (dischargeConsumeReleaseEnable()) battery.holdEnable(false);
    if (chargeConsumeReleaseEnable())    battery.holdEnable(false);

    // Дисплей у цьому проєкті перемальовується ПО ПОДІЯХ, а розряд — процес
    // фоновий: без цього рядка показання лишалися б статичними до наступного
    // натискання кнопки. Рівень 2 (вхід у режим / вихід із нього) вимагає ПОВНОЇ
    // перемальовки, інакше поверх моніторингу видно попередню сторінку;
    // рівень 1 (нові показання раз на 5 с) оновлює лише рядки, без блимання.
    { uint8_t dirty = dischargeConsumeDirty();
      if (dirty) displayDischargeRefresh(dirty >= 2); }

    // ⚑ ТЕ САМЕ ДЛЯ ЗАРЯДУ. Цього рядка тут не було взагалі: charge.h справно
    // виставляв прапорець (chargeMarkDirty) на вхід у режим і на кожне нове
    // показання, drawPageCharge() був намальований — але consume нікому було
    // викликати, тож заряд НІКОЛИ не оновлював екран сам. На вигляд це рівно
    // те, на що скарга: запустив заряд — сторінка заряду не з'явилась, а коли
    // з'являлась (після сторонньої перемальовки), цифри стояли мертві до
    // натискання кнопки. Розряд працював лише тому, що рядок вище є.
    { uint8_t dirty = chargeConsumeDirty();
      if (dirty) displayChargeRefresh(dirty >= 2); }

    // Опитування кнопки перегортання меню
    displayHandleButton();

    // Після повного циклу перегортання (повернення на 1-ю сторінку) —
    // перечитуємо акумулятор, щоб оновити дані.
    if (displayConsumeReadRequest()) {
        bool ok2433, ok2438;
        readAllChips(ok2433, ok2438);      // наприкінці сам робить 1 повний перемальовок
    }

    // Підтверджена в меню дисплея дія. Порядок і склад операцій задає
    // operations.h — той самий каталог, що малюють екран, веб і USB-клієнт.
    // Раніше номери дій були «зашиті» тут числами 0..6 і розходилися з тим,
    // що показував екран; тепер розбір іде через opTemplateOf*/opExpert().
    int act = displayConsumeActionRequest();
    if (act >= 0) {
        // Версія пристрою без заряду. Меню таких пунктів не показує, але меню —
        // не єдиний вхід: той самий код приходить із веба, з USB і зі
        // збереженого сценарію Майстра. Прибрати напис і лишити дію робочою
        // означало б вимкнути тільки напис.
        if (opNeedsCharge(act) && !chargeAvailable()) {
            Serial.println(chargeUnavailText());
            displayShow("БЕЗ ЗАРЯДУ"); ledSet(LED_IDLE);
            act = -1;
        }
        int tm = opTemplateOfModel(act);
        int tn = opTemplateOfNew(act);
        int ex = opExpert(act);
        if      (act == OP_CELLSWAP)      performRecalPrepare(false);
        else if (act == OP_CELLSWAP_DEEP) performRecalPrepare(true);
        else if (act == OP_REPAIR)        performRepair();
        else if (act == OP_SETCHARGE)     { int p = chargePctFromVoltage();
                                            if (p >= 0) performSetChargePct(p); }
        else if (act == OP_RESET)         performReset();
        else if (act == OP_CLEAN)         performFactoryClean();
        // Розряд із меню пристрою — до цілі, обраної сусіднім пунктом.
        else if (act == OP_DISCHARGE)     { const char *e = dischargeStart(dischargeTargetMv());
                                            if (e) { Serial.println(e); displayShow("РОЗРЯД: ЗБІЙ");
                                                     ledSet(LED_ERROR); } }
        // «Ціль розряду» нічого не пише — лише перемикає напругу по колу.
        else if (act == OP_DISCHARGE_TGT) { char m[24];
                                            snprintf(m, sizeof(m), "ЦІЛЬ %.2f В",
                                                     dischargeCycleTarget() / 1000.0);
                                            displayShow(m); ledSet(LED_IDLE); }
        // Керований заряд — до цілі, обраної сусіднім пунктом (у %).
        else if (act == OP_CHARGE_DCDC)   { const char *e = chargeStart(chargeTargetPct());
                                            if (e) { Serial.println(e); displayShow("ЗАРЯД: ЗБІЙ");
                                                     ledSet(LED_ERROR); } }
        // «Ціль заряду» нічого не пише — лише перемикає відсоток по колу.
        // Зв'язок: перемикач по колу, як і цілі. Сам рестарт робить цикл вище —
        // тут лише кажемо людині, що саме буде після нього.
        else if (act == OP_RADIO)         { uint8_t nm = radioCycleMode(); char m[28];
                                            if (radioSwitchable()) {
                                                snprintf(m, sizeof(m), "ЗВ'ЯЗОК: %s", radioModeShort(nm));
                                                displayShow(m); ledSet(LED_IDLE); buzzOk();
                                            } else {
                                                // Чесніше за мовчазне «нічого не сталось»:
                                                // пункт видно, а перемкнути нема на що.
                                                displayShow("BT НЕ ВКОМПІЛЬОВАНО");
                                                ledSet(LED_IDLE); buzzErr();
                                            } }
        else if (act == OP_CHARGE_TGT)    { char m[24];
                                            snprintf(m, sizeof(m), "ЦІЛЬ %u%%", chargeCycleTarget());
                                            displayShow(m); ledSet(LED_IDLE); }
        // Профілі й ручні уставки нічого не пишуть у чипи — це налаштування
        // самого пристрою. На екрані поля для чисел немає, тож кожен пункт
        // перемикає своє значення ПО КОЛУ з готового набору (той самий прийом,
        // що й у цілей), а нуль у наборі означає «повернутись до автомата».
        else if (act == OP_CHARGE_PROFILE) { char m[28];
                                            snprintf(m, sizeof(m), "ЗАРЯД: %s",
                                                     chargeProfileText(chargeCycleProfile()));
                                            displayShow(m); ledSet(LED_IDLE); }
        else if (act == OP_CHARGE_MANUAL_MA) { uint16_t v = chargeCycleManualMa(); char m[28];
                                            if (v) snprintf(m, sizeof(m), "СТРУМ %u мА", v);
                                            else   snprintf(m, sizeof(m), "СТРУМ АВТО");
                                            displayShow(m); ledSet(LED_IDLE); }
        else if (act == OP_CHARGE_MANUAL_MV) { uint16_t v = chargeCycleManualMv(); char m[28];
                                            if (v) snprintf(m, sizeof(m), "ЦІЛЬ %.2f В", v / 1000.0);
                                            else   snprintf(m, sizeof(m), "ЦІЛЬ ЗА %%");
                                            displayShow(m); ledSet(LED_IDLE); }
        else if (act == OP_DIS_PROFILE)   { char m[28];
                                            snprintf(m, sizeof(m), "РОЗРЯД: %s",
                                                     dischargeProfileText(dischargeCycleProfile()));
                                            displayShow(m); ledSet(LED_IDLE); }
        else if (act == OP_DIS_MANUAL_MA) { uint16_t v = dischargeCycleManualMa(); char m[28];
                                            if (v) snprintf(m, sizeof(m), "СТРУМ %u мА", v);
                                            else   snprintf(m, sizeof(m), "СТРУМ АВТО");
                                            displayShow(m); ledSet(LED_IDLE); }
        // Примусове пробудження — параметрів не має взагалі: усі межі задає
        // settings.h, і саме тому режим і безпечний (див. charge.h).
        else if (act == OP_CHARGE_WAKE)   { const char *e = chargeWakeStart();
                                            if (e) { Serial.println(e); displayShow("ПРОБУДЖ.: ЗБІЙ");
                                                     ledSet(LED_ERROR); } }
        // «Модель <X>» — модельна частина еталона, БЕЗ навченого хвоста донора.
        else if (tm >= 0)                 performRestoreTemplate(BATTERY_TEMPLATES[tm].name);
        // «Новий <X>» — порожній чіп -> робочий АКБ; заряд 50 % ємності моделі.
        else if (tn >= 0)                 { const char *nm = BATTERY_TEMPLATES[tn].name;
                                            performInitBattery(nm, impresRatedMah(nm) / 2); }
        else if (ex == OP_WIPE33_REL)     performWipe2433();
        else if (ex == OP_WIPE38_REL)     performWipe2438();
        else if (ex == OP_REBOOT_REL)     { displayShow("ПЕРЕЗАВАНТАЖ."); Serial.flush();
                                            delay(300); ESP.restart(); }
    }

    // Екранний Майстер відновлення: 1 = аналіз (зчитати + оновити діагноз),
    // 2 = виконати наступний крок плану. Логіку тримає recovery.h; кнопки —
    // display.h/display_color.h; тут лише зв'язуємо (двигун доступний після
    // include web_server.h -> recovery.h).
    int wizReq = displayConsumeWizRequest();
    if (wizReq == 1) {
        bool a2433, a2438; readAllChips(a2433, a2438);
        wizDeviceRefresh();
        displayRender();
    } else if (wizReq == 2) {
        wizDeviceRunNext();
        displayRender();
    }

    // Дисплей перемальовується по подіям (натискання кнопки, читання/запис),
    // тому цикл не блокується повільним рендером і кнопки чутливі.

    // Неблокуюча індикація світлодіодами (пульс очікування / читання / запис
    // / успіх / помилка — режим задають обробники через ledSet()).
    ledTask();

    // Червоний «світлофільтр» на екрані на час оповіщення про помилку: увесь
    // вміст стає червоним відтінком (без блимання), поки активний LED_ERROR,
    // і повертається до норми, коли індикатор виходить із режиму помилки.
    {
        static LedMode prevLed = LED_BOOT;
        if (g_ledMode != prevLed) {
            if (g_ledMode == LED_ERROR)      displaySetErrorTint(true);
            else if (prevLed == LED_ERROR)   displaySetErrorTint(false);
            prevLed = g_ledMode;
        }
    }

    // Анімація батареї на головній сторінці ТА на сторінці розряду (~9 к/с).
    // Оновлює лише область шкали батареї, не чіпаючи цифри %. Під час розряду
    // це ще й ознака «процес живий»: статична шкала на довгій операції читалась
    // би як зависання. УВІМКНЕНА типово;
    // за потреби вимикається через #define DISABLE_BATTERY_ANIM у settings.h.
#ifndef DISABLE_BATTERY_ANIM
    static unsigned long lastAnim = 0;
    if (millis() - lastAnim > ANIM_GRADIENT_MS) { lastAnim = millis(); displayAnimTick(); }
#endif

    // ⚑ ОДИН КВАНТ ЧАСУ — БЕЗДІЯЛЬНІЙ ЗАДАЧІ FreeRTOS. НЕ ПРИБИРАТИ.
    //  Увесь цикл вище — суцільне неблокуюче опитування: жодного delay(),
    //  жодного очікування. Це добре для чутливості кнопок, але має наслідок,
    //  про який легко не здогадатись: задача loop() має пріоритет 1 і прибита
    //  до ядра 1, а бездіяльна задача IDLE1 має пріоритет 0. Поки цикл не
    //  блокується ЖОДНОГО разу, IDLE1 не отримує процесор узагалі.
    //
    //  Чим це погано:
    //   • саме IDLE звільняє пам'ять видалених задач FreeRTOS — без неї купа
    //     повільно тане, а це вже інший клас «раптових перезавантажень»;
    //   • будь-яке налаштування Task WDT, що стежить за IDLE1, гарантовано
    //     спрацює — рівно це й було причиною перезавантажень під час заряду
    //     та розряду (докладно у wdt.h).
    //
    //  delay(1) — це vTaskDelay(1 такт): цикл засинає на одну мілісекунду й
    //  віддає ядро. Для опитування кнопок, анімації (~9 к/с) і USB (11 байт/мс
    //  проти 256-байтного буфера) ця міліcекунда непомітна.
    delay(1);
}
