roman885-85/moto_battery_reader/settings.h

#ifndef SETTINGS_H
#define SETTINGS_H

// ⚑ КРИВА ЗАРЯДУ ЗА НАПРУГОЮ — НАЙПЕРШИМ РЯДКОМ, І ЦЕ НЕ СТИЛЬ.
//  Із soc.h беруться SOC_EMPTY_MV/SOC_FULL_MV, а на них спираються і межі
//  шкали, і верх розрядної лінійки, і кілька #if-перевірок нижче. Невідомий
//  ідентифікатор у #if препроцесор МОВЧКИ вважає нулем — тобто підключення
//  нижче за першу ж перевірку не викликало б помилки компіляції, а тихо
//  перетворило б умову на «0 <= щось» і спрацювало б навпаки. Цей проєкт уже
//  мав такий дефект (порівняння з неіснуючим DISCHARGE_RAMP_LO_MV), тож
//  порядок тут — умова правильності.
#include "soc.h"

// ═══ ЯКИЙ САМЕ ПРИСТРІЙ ЗБИРАЄМО ════════════════════════════════════════
//  Пристроїв два, і код у них ОДИН. Донедавна їх було дві теки з майже
//  однаковим вмістом, і це вже почало коштувати: правки доводилось носити
//  руками, а чотири рядки конфігурації розповзались непомітно. Тепер різниця
//  живе тут — у чотирьох умовах, а не в 265 продубльованих файлах.
//
//  Пристрої відрізняються рівно двома речами:
//    • ЗАРЯДНЕ ЗАЛІЗО. Готова плата DC/DC на TL494 (enable + аналогова
//      уставка, вимір із DS2438 пакета) або власний понижувач (ШІМ на свій
//      ключ, свій шунт, свій подільник, контроль +14 В). Докладно — у блоці
//      про CHARGE_TOPOLOGY нижче за текстом.
//    • ЕКРАН. 1.69" 240×280 зі скругленими кутами або 1.3" 240×240 із
//      гострими.
//  Плюс наслідок першого: стеля профілю струму. На платі TL494 силовий ключ
//  розпаяв виробник, і наш тепловий бюджет до нього не застосовний.
//
//  ⚑ СТОЇТЬ ЦЕ НАЙПЕРШИМ, і з тієї ж причини, що й soc.h вище: невідомий
//  ідентифікатор у #if препроцесор МОВЧКИ вважає нулем. Оголоси ми вибір
//  нижче за першу ж умову, яка його читає, — і та умова тихо працювала б
//  навпаки, не викликавши жодної помилки збірки.
#define DEVICE_TL494   0    // попередній пристрій: плата DC/DC, екран 240×280
#define DEVICE_BUCK    1    // новіший: власний понижувач, екран 240×240

//  🔴 ТИПОВО — DEVICE_BUCK, І ЦЕ ВИПРАВЛЕННЯ, А НЕ ВПОДОБАННЯ.
//  Коли дві теки зводили в одну (3.57), типовим лишили DEVICE_TL494 — просто
//  тому, що в КОРЕНІ сховища доти лежав саме той пристрій. Але прилад, яким
//  користуються, — це той, що жив у теці `battery_reader_china_chr`: власний
//  понижувач і КВАДРАТНА панель 240×240.
//
//  Ціна тієї дрібниці виявилась не косметичною. Зібрана без правки прошивка
//  налаштовує ST7789 як 240×280 зі скругленням, тобто задає вікно й зміщення
//  ЧУЖОЇ панелі: підсвітка піднімається, ініціалізація проходить, малювання
//  йде — а на 240×240 воно лягає повз видиму область. Симптом рівно такий,
//  яким його й описав власник: «немає зображення, підсвітка є».
//
//  ⚑ І ЖОДНА ПЕРЕВІРКА ЦЬОГО НЕ ЛОВИЛА Б. Яка панель припаяна фізично, код
//  знати не може; обидві конфігурації однаково правильні — просто одна не для
//  цього приладу. Тому єдиний спосіб побачити помилку — рядок «DISPLAY: ST7789
//  …» у журналі при старті: він друкує геометрію ДО того, як стане видно, що
//  екран порожній. Складаючи прошивку для ІНШОГО приладу, задайте
//  DEVICE_TL494 тут або зберіть із -DDEVICE_VARIANT=0.
#ifndef DEVICE_VARIANT
  #define DEVICE_VARIANT DEVICE_BUCK
#endif

#define DEVICE_IS_TL494 ((DEVICE_VARIANT) == (DEVICE_TL494))
#define DEVICE_IS_BUCK  ((DEVICE_VARIANT) == (DEVICE_BUCK))

#if !(DEVICE_IS_TL494) && !(DEVICE_IS_BUCK)
  #error "DEVICE_VARIANT мусить бути DEVICE_TL494 або DEVICE_BUCK."
#endif

// Налаштування точки доступу ESP32
#define AP_SSID "BatteryReader_moto"
#define AP_PASSWORD "12345678"

// Піни ESP32
// ⚑ НА ЦЬОМУ ПІНІ СТОЇТЬ РЕЗИСТОР 4.7 кОм НА +3.3 В — але він НЕ обов'язковий.
//  Власник поставив його для попереднього налагодження функцій; прошивка
//  керує цією лінією активно (і вгору, і вниз), тож зовнішня підтяжка тут не
//  умова роботи, а зручність під час перевірок.
//
//  ⚠️ Раніше в цьому файлі стояло «обов'язково, без нього некоректно
//  працюють усі чотири функції». Це було моє припущення, а не факт із цієї
//  плати, — власник його виправив. Різниця не косметична: «обов'язково»
//  відправляє шукати несправність у ненайденому резисторі, якого може й не
//  бути в схемі, і при цьому не бути жодної проблеми.
//
//  ⚠️ НЕ ПЛУТАТИ з підтяжкою ЛІНІЇ ДАНИХ (DS_PIN нижче) — ОТА обов'язкова:
//  чипи DS2433/DS2438 живляться з неї паразитно.
//
//  ⚠️ І ОДРАЗУ ПРО STRAPPING. GPIO12 — це MTDI: рівнем на ньому В МОМЕНТ
//  СКИДАННЯ ESP32 вибирає напругу живлення флеш-пам'яті, і HIGH означає
//  «флеш 1.8 В». На модулях із флешем 3.3 В підтягнутий угору GPIO12
//  зазвичай означає, що плата взагалі не завантажиться.
//  Те, що ЦЕЙ пристрій із припаяним резистором 4.7 кОм завантажується, означає одне з
//  двох: або на модулі вже пропалено eFuse напруги флеша (тоді рівень на
//  GPIO12 при старті просто ігнорується — саме для цього Espressif і дає
//  `espefuse.py set_flash_voltage 3.3V`), або флеш там і справді 1.8 В
//  (WROVER та подібні).
//  Практичний висновок: на ЦІЙ платі резистор стоїть і не заважає, але при
//  переносі на інший модуль перше, що варто перевірити, — чи вона стартує.
//  Якщо не стартує — резистор можна просто зняти: він тут не обов'язковий.
//  Якщо ні — пропалити eFuse або перенести enable на вільний GPIO32
//  (ADC1_CH4, повноцінний вхід/вихід, без strapping-обмежень).
#define PULLUP_PIN 12      // Керування підтяжкою 1-Wire + enable пакета
                           // + резистор 4.7 кОм на +3.3 В (стоїть на платі,
                           //   поставлений для налагодження; НЕ обов'язковий)
#define DS_PIN 13          // Пін даних 1-Wire

// ── ПІДТЯЖКА ЛІНІЇ ДАНИХ 1-Wire ───────────────────────────────────────────
//  ⚠️⚠️ ЗОВНІШНІЙ РЕЗИСТОР 2.2…4.7 кОм З ЛІНІЇ ДАНИХ НА 3.3 В ОБОВ'ЯЗКОВИЙ.
//  Внутрішня підтяжка ESP32 (~45 кОм) його НЕ ЗАМІНЮЄ, і це не питання запасу.
//  DS2433 і DS2438 живляться ПАРАЗИТНО — струм на власну роботу вони беруть із
//  тієї самої лінії даних у паузах між бітами. 45 кОм від 3.3 В дають десятки
//  мікроамперів; чипу цього не вистачає навіть щоб утримати внутрішнє
//  живлення, тож він не відповідає взагалі. Симптом — «акумулятор не
//  зчитується» при цілком справному коді.
//  У попередній редакції тут було написано, що внутрішньої досить. Це
//  неправильно: вона рятує лише від «лінія висить у повітрі», але не годиться
//  як джерело живлення для чипів.
//
//  DS_INTERNAL_PULLUP лишається УВІМКНЕНОЮ як другорядний запобіжник (паралельно
//  зовнішньому резистору вона нічого не змінює), і має неочевидну пастку, яку
//  варто знати.
//
//  ⚠️ ПАСТКА. Внутрішня підтяжка — це окреме налаштування піна, і воно
//  ВИМИКАЄТЬСЯ будь-яким pinMode(pin, INPUT): у arduino-esp32 INPUT (0x01) не
//  містить біта PULLUP (0x04), тож виклик явно знімає підтяжку. А конструктор
//  бібліотеки OneWire робить рівно це — pinMode(pin, INPUT). Далі бібліотека
//  чіпає лише регістр дозволу виходу (щоб «відпустити» лінію), налаштування
//  підтяжки не відновлює ніколи — і лінія просто висить у повітрі.
//  Тому прошивка вмикає внутрішню підтяжку ЯВНО, ПІСЛЯ конструктора OneWire
//  (BatteryReader::dsIdle()), і повертає її після кожної діагностики.
//
//  Значення 0 вимикає внутрішню підтяжку. Робити це немає причин: паралельно
//  зовнішньому резистору вона нічого не псує, а без неї лінія в паузах між
//  операціями лишається зовсім без опори.
#ifndef DS_INTERNAL_PULLUP
  #define DS_INTERNAL_PULLUP 1
#endif
#define LED_GREEN_PIN 14   // Зелений LED
#define LED_RED_PIN 27     // Червоний LED

// Веб-сервер
#define HTTP_PORT 80

// Пароль для записи прошивки
#define ADMIN_PASSWORD "admin123"

// Розмір дампа
#define DUMP_SIZE 512

// IP адреса ESP32 в режимі AP
#define ESP_IP "192.168.4.1"

// ======================= ДИСПЛЕЙ =======================
// Крок 1. Виберіть модель дисплея — розкоментуйте Рівно Одну рядок.
// (інтерфейс/роздільність підставляться автоматично)
// #define DISPLAY_SSD1306_I2C        // 0.96" OLED 128x64 I2C (GME12864) — за замовчуванням
// #define DISPLAY_SH1106_I2C      // 1.3"  OLED 128x64 I2C (SH1106)
// #define DISPLAY_SH1107_128_I2C  // 1.5"  OLED 128x128 I2C (GME128128-02, варіант SH1107)
// #define DISPLAY_SSD1327_128_I2C // 1.5"  OLED 128x128 I2C (GME128128-02, варіант SSD1327)
// #define DISPLAY_ST7567_SPI      // Open-Smart 1.8" ST7567, 128x64, SPI
// #define DISPLAY_PCD8544_SPI     // Nokia 5110 (PCD8544), 84x48, SPI
// --- КОЛЬОРОВІ TFT на ST7789 (SPI) — кольорове меню + кольорова заставка ---
// Розкоментуйте DISPLAY_ST7789_SPI + РІВНО ОДИН пресет розміру (або власний).
// Потрібні бібліотеки: Adafruit GFX, Adafruit ST7735/ST7789, Adafruit BusIO,
// U8g2_for_Adafruit_GFX (кириличні шрифти на кольоровому екрані).
#define DISPLAY_ST7789_SPI
#if DEVICE_IS_TL494
#define DISPLAY_ST7789_240X280   // 1.69"  ST7789V3 — 240x280 ← цей пристрій
#else
#define DISPLAY_ST7789_240X240   // 1.3"  ST7789V — 240x240 (GMT130-V1.0) ← цей пристрій
#endif
//   #define DISPLAY_ST7789_240X320   // 2.0"/2.4" — 240x320
//   #define DISPLAY_ST7789_135X240   // 1.14"  — 135x240
//   #define DISPLAY_ST7789_170X320   // 1.9"   — 170x320
//   #define DISPLAY_ST7789_172X320   // 1.47"  — 172x320
// Власний розмір (будь-яка панель ST7789, макс. 240x320) — портретні розміри:
//   #define DISPLAY_ST7789_W       240
//   #define DISPLAY_ST7789_H       320
// Оффсети пам'яті. За замовчуванням покладаємось на бібліотеку Adafruit (вона
// знає стандартні панелі). Якщо картинка ЗСУНУТА — увімкніть ручні оффсети:
//   #define DISPLAY_ST7789_MANUAL_OFFSET   // брати значення з пресету (нижче)
// або задайте власні (вони ж вмикають ручний режим):
//   #define DISPLAY_ST7789_XOFF    0
//   #define DISPLAY_ST7789_YOFF    0
// Орієнтація 0..3 (0/2 — портрет, 1/3 — ландшафт). Інверсія — «негатив».
#define DISPLAY_ST7789_ROT     1
// #define DISPLAY_ST7789_INVERT
// Заокруглені кути (ST7789V3 1.69" 240x280 зазвичай скруглений) — вмикає
// безпечний відступ, щоб текст у кутах (заголовок/статус/hex) не обрізало.
// Радіус можна підправити DISPLAY_ST7789_CORNER (типово 22 px).
//  ⚑ ЙДЕ В ПАРІ З ПРЕСЕТОМ, і саме тому обидва під однією умовою. У 1.69"
//  240×280 кути СКРУГЛЕНІ — без відступу текст заголовка й статусу обрізало
//  б; у GMT130 240×240 панель квадратна, і заокруглення там лише з'їдало б
//  по 22 px з кожного боку ні за що. Розводити ці два рішення по різних
//  місцях означало б рано чи пізно ввімкнути відступ на квадратному екрані.
#if DEVICE_IS_TL494
#define DISPLAY_ST7789_ROUND
#endif
#define DISPLAY_ST7789_CORNER  22
// ── РЕЖИМ І ЧАСТОТА SPI ДЛЯ ST7789 ────────────────────────────────────────
//  Дві найчастіші причини ПОВНІСТЮ ЧОРНОГО екрана на цих панелях — і обидві
//  раніше не налаштовувались узагалі: tft.init() кликався без них, тобто
//  мовчки брав те, що зашито в бібліотеку.
//
//  1. РЕЖИМ SPI. ✅ ПІДТВЕРДЖЕНО НА ЦЬОМУ ПРИСТРОЇ: саме це й був чорний
//     екран. Модулі БЕЗ виводу CS (тут — GMT130-V1.0) вимагають режим 3, а
//     не 0, і з режимом 0 панель не показує НІЧОГО, хоч припаяно все
//     правильно. Причина в тому, що CS у них припаяний
//     до землі: контролер вибраний завжди й не має по чому визначити початок
//     посилки. Межу транзакції йому задає стан тактового сигналу в спокої, а
//     він у режимів 0 і 3 різний (низький проти високого). З «не тим» режимом
//     панель приймає біти зі зсувом, жодної команди не впізнає — і лишається
//     чорною. Виглядає це рівно як несправність, хоча все припаяно правильно.
//     0..3 — номер режиму (перетворюється на SPI_MODEx у display_color.h:
//     самі константи SPI_MODE0..3 на різних платформах мають РІЗНІ значення,
//     тож передавати сюди голе число не можна).
#ifndef DISPLAY_ST7789_SPI_MODE
  #if defined(DISPLAY_ST7789_240X240)
    #define DISPLAY_ST7789_SPI_MODE 3   // панелі без CS — типово потрібен 3
  #else
    #define DISPLAY_ST7789_SPI_MODE 0   // решта — звичайний 0
  #endif
#endif
//  2. ЧАСТОТА SPI, Гц. Бібліотека типово ставить десятки МГц — і на коротких
//     доріжках це працює, а на дротах-перемичках дає або «сніг», або той
//     самий чорний екран. 24 МГц — надійний компроміс. Якщо екран чорний або
//     блимає сміттям, знижуйте: 10 000 000, потім 8 000 000. Повільніше
//     перемальовується, зате видно.
#ifndef DISPLAY_ST7789_SPI_HZ
  #define DISPLAY_ST7789_SPI_HZ  24000000
#endif

// ⚑ ДІАГНОСТИКА «ЧОРНИЙ ЕКРАН». Розкоментуйте — і одразу після ініціалізації
//  дисплей на 3 секунди заллється чистими кольорами (червоний/зелений/синій/
//  білий) при ПОВНІЙ підсвітці. Сама по собі чорнота нічого не каже: однаково
//  виглядають згасла підсвітка й мовчазна шина SPI. Тест їх розрізняє:
//    • бачите кольори -> підсвітка й обмін справні (причина у верстці,
//      орієнтації чи оффсетах — шукайте там);
//    • екран світлий, але без кольорів -> підсвітка є, обміну немає
//      (перевірте SDA/SCL/DC/RST, живлення панелі, CS);
//    • екран лишається темним -> не працює підсвітка (BLK і її живлення).
//  Кожен крок дублюється в Serial, тож результат видно й без очей на екрані.
// #define DISPLAY_ST7789_SELFTEST

// Кастомна КОЛЬОРОВА заставка: згенеруйте custom_splash.h у папку скетчу
// (python tools/make_color_splash.py logo.png -W 240 -H 240) і увімкніть:
// #define DISPLAY_SPLASH_CUSTOM

// ═══ BLUETOOTH: ті самі клієнтські програми, тільки без кабелю ════════════
//  Командний протокол (serial_api.h) віддається ще й по Bluetooth SPP —
//  послідовному порту поверх радіо. Саме SPP, а не BLE, і це вирішує все:
//  на комп'ютері SPP виглядає ЗВИЧАЙНИМ COM-портом, тож moto_gui.py,
//  moto_bridge.py і client_usb.html (Web Serial) працюють БЕЗ ЗМІН — треба
//  лише обрати в списку інший порт.
//
//  ⚠️⚠️ СХЕМА РОЗДІЛІВ «Huge APP» ПОТРІБНА ЗАВЖДИ, А НЕ ЛИШЕ ПІД BLUETOOTH.
//  Прошивка переросла типову «Default 4MB with spiffs» і без BT: під програму
//  там 1 310 720 байтів, а збірка займає ~1.31 МБ. З Bluetooth не влазить тим
//  паче — стек Bluedroid додає ще сотні кілобайтів. Оберіть
//  **Huge APP (3MB No OTA/1MB SPIFFS)**:
//  Arduino IDE -> Інструменти -> Partition Scheme. SPIFFS зменшиться до 1 МБ,
//  чого вистачає з запасом (index.html ~242 КБ + логотип і заставка).
//  Перевірити це на компіляції неможливо — розділи задаються в IDE, а не в
//  коді, — тому пристрій друкує вільне місце при старті, а BluetoothSerial
//  просто не запуститься, якщо місця немає.
//
//  ⚠️ Радіо одне на Wi-Fi і Bluetooth: вони працюють разом, але діляться
//  ефіром і пам'яттю. Не потрібен Wi-Fi — вимкніть точку доступу, обом стане
//  помітно легше.
//
//  ⚑ ЛИШЕ ЗВИЧАЙНИЙ ESP32. На S3/C3/C6 класичного Bluetooth НЕМАЄ ФІЗИЧНО —
//  там тільки BLE. Перевірка в bt_link.h це ловить.
//
//  ⚑ УВІМКНЕНО. Абзац про «вимкнено після регресії» тут стояв рівно один
//  реліз — і був знятий, щойно причину знайшли: зникле зображення давав НЕ
//  Bluetooth, а типовий DEVICE_VARIANT, який після зведення двох тек лишився
//  від ІНШОГО приладу (див. блок про DEVICE_VARIANT на початку файлу й 3.61).
//  Тримати функцію вимкненою через діагноз, що виявився хибним, означало б
//  залишити в коді ще один абзац «вимкнено, бо…», який ніхто не перевіряв.
//
//  Те, чому Bluetooth був вимкнений ДО цього («з ним пристрій перестав
//  під'єднуватись по Wi-Fi»), виправлено по суті: обидва стеки більше не
//  піднімаються разом — режим обирається в меню приладу (група «ЗВ'ЯЗОК»,
//  перший пункт списку) і застосовується при старті.
//
//  🔴 ЦІНА, ЯКУ ТРЕБА ЗНАТИ ДО ЗБІРКИ: разом із цим рядком у прошивку входить
//  увесь Bluedroid, і схема розділів «Huge APP (3MB No OTA/1MB SPIFFS)» стає
//  ОБОВ'ЯЗКОВОЮ — у типову вона не влізе (3.20). Не потрібен Bluetooth —
//  закоментуйте рядок нижче: прошивка знову влізе у звичайну схему, а пункт
//  меню чесно скаже, що перемикати нема на що.
//
//  ⚑ ОБИДВА СВІТИ ЗАДАЮТЬСЯ ЗЗОВНІ (-DBT_ON / -DBT_OFF) — так само, як
//  CHARGE_TOPOLOGY, і не заради зручності збірки: правило «збережений
//  Bluetooth на прошивці без Bluetooth не лишає прилад німим» має сенс лише
//  там, де Bluetooth немає, а правило «перемикач справді перемикає» — лише
//  там, де він є. Перевірити кожне можна тільки зібравши саме такий світ.
#define BT_ON
#if defined(BT_ON) && !defined(BT_OFF)
  #define BT_ENABLED
#endif

// Ім'я в ефірі. До нього додаються чотири шістнадцяткові цифри з MAC, інакше
// два прилади поруч виглядали б однаково. Потрібне точне ім'я без суфікса —
// задайте BT_NAME_EXACT.
#define BT_NAME "MotoBattery"
// #define BT_NAME_EXACT "MotoBattery"

// PIN спарювання (рядок із цифр). Перший бар'єр: без нього спарується будь-хто
// в радіусі дії. Закоментуйте, якщо пара має йти без коду.
#define BT_PIN "1234"

// ── ЧОМУ ПО РАДІО ЗАПИС ВИМАГАЄ ПАРОЛЬ ────────────────────────────────────
//  По USB командний протокол відкритий повністю, і це виправдано: щоб щось
//  надіслати, треба фізично встромити кабель. По Bluetooth такого захисту
//  немає — у радіусі дії опиняється будь-хто, а серед команд є WIPE33,
//  WRITE33 і CLEAN, тобто повне стирання пам'яті акумулятора.
//
//  Тому по BT читання вільне (щоб клієнт міг знайти пристрій і показати стан),
//  а будь-яка зміна — лише після «AUTH <пароль>» (той самий ADMIN_PASSWORD).
//  По USB поведінка НЕ змінюється.
//
//  0 — вимкнути перевірку (ваш ризик; має сенс хіба що на столі).
//  ⚑ ЗАРАЗ 0 — ЗА ПРЯМИМ РІШЕННЯМ ВЛАСНИКА, І ОСЬ ЩО ЦЕ ОЗНАЧАЄ.
//  Бар'єрів було два: PIN на спарюванні й пароль на кожній команді запису.
//  Лишається ПЕРШИЙ: щоб узагалі дістатись до приладу по радіо, треба знати
//  BT_PIN і завести пару в системі. Другого немає: спарований комп'ютер може
//  віддати будь-яку команду, включно з WIPE33.
//
//  Тобто безпека тепер тримається рівно на PIN — і саме тому його НЕ МОЖНА
//  лишати стандартним «1234», якщо прилад бере участь у чомусь, крім столу.
//  Складання «0 без PIN» прошивка не дасть узагалі (#error нижче).
//
//  Повернути пароль — поставити 1. Тоді клієнт мусить надіслати
//  «AUTH <пароль>» перед першим записом; поле пароля для цього у вікні є.
//  ⚑ ЗАДАЄТЬСЯ Й ЗЗОВНІ (-DBT_REQUIRE_AUTH=1) — інакше світ «із паролем»
//  неможливо було б прогнати тестом узагалі, і правило перевірялось би рівно в
//  тій конфігурації, яку зібрали.
#ifndef BT_REQUIRE_AUTH
  #define BT_REQUIRE_AUTH 0
#endif

#ifdef BT_ENABLED
  #if !defined(BT_NAME) && !defined(BT_NAME_EXACT)
    #error "BT_ENABLED увімкнено, але імені немає: задайте BT_NAME (до нього додасться суфікс із MAC) або BT_NAME_EXACT."
  #endif
  //  ⚑ ДОВЖИНИ ІМЕНІ Й PIN перевіряються НЕ ТУТ, а в bt_link.h через
  //  static_assert. Причина проста: препроцесор не вміє sizeof, і спроба
  //  написати `#if (sizeof(BT_NAME) - 1) > 26` дає «missing binary operator
  //  before token "("» — я на цьому щойно й спіймався. static_assert бачить
  //  справжню довжину рядка й працює ще й у хостових тестах.
  //
  //  Ключове поєднання, яке МОЖНА перевірити тут (це чиста макро-арифметика):
  //  радіо без PIN І без пароля на записі означає, що будь-хто в радіусі дії
  //  зможе стерти пам'ять пакета однією командою. Одне з двох — на розсуд
  //  власника; обидва одразу — ні.
  #if defined(BT_REQUIRE_AUTH) && (BT_REQUIRE_AUTH == 0) && !defined(BT_PIN)
    #error "BT без PIN І без пароля на записі: будь-хто в радіусі дії зможе стерти пам'ять пакета командою WIPE33. Увімкніть BT_REQUIRE_AUTH або задайте BT_PIN."
  #endif
#endif

// ── ЗАСТАВКА, ЗАВАНТАЖЕНА У SPIFFS (без перепрошивання) ───────────────────
//  Той самий результат, що й DISPLAY_SPLASH_CUSTOM вище, але картинку не
//  треба вкомпільовувати: вона завантажується через веб-інтерфейс
//  («Прошивка» -> «Заставка екрана») і лежить у файловій системі поруч із
//  index.html. Помінялась картинка — просто завантажте іншу.
//
//  Порядок джерел у displaySplash(): файл зі SPIFFS -> custom_splash.h ->
//  типова НГУ. Файл ПЕРЕКРИВАЄ вкомпільовану картинку навмисно: це вибір,
//  зроблений пізніше за прошивання.
//
//  ⚑ ЛИШЕ ДЛЯ КОЛЬОРОВИХ ПАНЕЛЕЙ. На монохромному OLED формат інший (XBM), і
//  перевірка нижче не дасть увімкнути це для нього.
//  Формат файла й розбір заголовка — у splash.h.
#define DISPLAY_SPLASH_SPIFFS
#define DISPLAY_SPLASH_PATH  "/splash.bin"

// ── JPEG ПРЯМО У SPIFFS ───────────────────────────────────────────────────
//  Вантажити можна не лише підготовлений .bin, а й звичайний JPEG — пристрій
//  розкодує його сам. Різниця в місці істотна: 240×240 RGB565 займає 113 КБ,
//  той самий кадр у JPEG — 10…30 КБ, а у файловій системі вже лежить
//  index.html на 226 КБ.
//
//  Тип файла визначається за МАГІЄЮ (splashSniff у splash.h), а не за
//  розширенням: розширення бреше, перші байти — ні. Обидва формати живуть
//  одночасно, JPEG має перевагу при показі.
//
//  ⚠️ ПОТРІБНА БІБЛІОТЕКА TJpg_Decoder (Bodmer) — Arduino IDE -> Менеджер
//  бібліотек -> «TJpg_Decoder». Вона розбирає JPEG блоками MCU й віддає їх у
//  callback, тобто цілий кадр у пам'яті не тримає. Перевірка нижче не дасть
//  зібратись мовчки без неї.
//  Не потрібен JPEG — закоментуйте рядок, лишиться сирий .bin (він не тягне
//  жодних залежностей).
#define DISPLAY_SPLASH_JPEG
#define DISPLAY_SPLASH_JPG_PATH "/splash.jpg"

// Стеля розміру JPEG-файла, байтів. Окрема від стелі сирого формату й НАБАГАТО
// менша: JPEG на весь екран важить десятки кілобайтів, а файл на сотні — це
// або фотографія в повній роздільності (яку однаково відхилить перевірка
// розмірів), або взагалі не те, що мали на увазі.
#ifndef DISPLAY_SPLASH_JPG_MAX_BYTES
  #define DISPLAY_SPLASH_JPG_MAX_BYTES 65536UL
#endif

// Найбільша ширина картинки, пікселів. Задає розмір ЄДИНОГО статичного
// буфера рядка в display_color.h (2 байти на піксель), тож це не «про всяк
// випадок побільше»: 240 -> 480 байтів, 320 -> 640.
//  240 покриває УСІ пресети зі списку вище: найширші панелі тут 240 (240x240,
//  240x280, 240x320), решта вужчі (135, 170, 172). Спершу я поставив 320 «із
//  запасом» — і власна ж перевірка нижче це впіймала: стеля розміру
//  рахувалась для панелі 320x320, якої в переліку немає, і відхиляла цілком
//  законну повноекранну картинку.
#ifndef DISPLAY_SPLASH_MAX_W
  #define DISPLAY_SPLASH_MAX_W 240
#endif

// Стеля розміру файла, байтів — приймальник відхилить більший ДО запису у
// SPIFFS. 240×320×2 + 8 = 153 608; беремо з невеликим запасом.
#ifndef DISPLAY_SPLASH_MAX_BYTES
  #define DISPLAY_SPLASH_MAX_BYTES 160000UL
#endif

#ifdef DISPLAY_SPLASH_SPIFFS
  // ⚑ ТІЛЬКИ ДЛЯ КОЛЬОРОВОЇ ПАНЕЛІ. Той самий перелік пресетів, за яким
  //  display.h вирішує, який драйвер підключати. Без цієї перевірки вмикання
  //  на монохромній збірці дало б помилку компіляції десь усередині
  //  display_color.h, який туди навіть не включається, — тобто повідомлення
  //  зовсім не про те.
  #if !(defined(DISPLAY_ST7789_SPI)    || defined(DISPLAY_ST7789_240X240) || \
        defined(DISPLAY_ST7789_240X280) || defined(DISPLAY_ST7789_240X320) || \
        defined(DISPLAY_ST7789_135X240) || defined(DISPLAY_ST7789_170X320) || \
        defined(DISPLAY_ST7789_172X320) || (defined(DISPLAY_ST7789_W) && defined(DISPLAY_ST7789_H)))
    #error "DISPLAY_SPLASH_SPIFFS працює лише з кольоровою панеллю ST7789: формат заставки — RGB565. Для монохромного OLED використовуйте XBM-заставку в display.h."
  #endif

  // Буфер рядка мусить вміщати найширшу панель із підтримуваних. Якщо
  //  DISPLAY_SPLASH_MAX_W менший за реальну ширину, splashDrawFromFs()
  //  писав би за межі масиву — тихо й з випадковими наслідками.
  #if defined(DISPLAY_ST7789_240X320) || defined(DISPLAY_ST7789_240X280) || \
      defined(DISPLAY_ST7789_240X240)
    #if (DISPLAY_SPLASH_MAX_W) < 240
      #error "DISPLAY_SPLASH_MAX_W менший за ширину обраної панелі — буфер рядка заставки переповниться."
    #endif
  #endif
  #if defined(DISPLAY_ST7789_170X320)
    #if (DISPLAY_SPLASH_MAX_W) < 170
      #error "DISPLAY_SPLASH_MAX_W менший за ширину обраної панелі (170)."
    #endif
  #endif
  #if defined(DISPLAY_ST7789_172X320)
    #if (DISPLAY_SPLASH_MAX_W) < 172
      #error "DISPLAY_SPLASH_MAX_W менший за ширину обраної панелі (172)."
    #endif
  #endif
  #if defined(DISPLAY_ST7789_135X240)
    #if (DISPLAY_SPLASH_MAX_W) < 135
      #error "DISPLAY_SPLASH_MAX_W менший за ширину обраної панелі (135)."
    #endif
  #endif
  #if defined(DISPLAY_ST7789_W)
    #if (DISPLAY_SPLASH_MAX_W) < (DISPLAY_ST7789_W)
      #error "DISPLAY_SPLASH_MAX_W менший за DISPLAY_ST7789_W — буфер рядка заставки переповниться."
    #endif
  #endif

  // Стеля розміру мусить бути такою, щоб НАЙБІЛЬША припустима картинка
  //  проходила. Інакше приймальник відхиляв би цілком коректний файл на
  //  повний екран — і виглядало б це як «не підтримується формат».
  #if (DISPLAY_SPLASH_MAX_BYTES) < ((DISPLAY_SPLASH_MAX_W) * 320UL * 2UL + 8UL)
    #error "DISPLAY_SPLASH_MAX_BYTES замалий: заставка на весь екран не пройде перевірку розміру при завантаженні."
  #endif

  #ifdef DISPLAY_SPLASH_JPEG
    // Бібліотеку перевіряємо ТУТ, а не там, де вона вперше знадобиться.
    //  Інакше збірка впала б десь усередині display_color.h із приводу
    //  невідомого класу — тобто повідомленням, з якого не видно, що саме
    //  треба поставити.
    //  ⚑ ЛИШЕ ДЛЯ ЗБІРКИ ПІД ARDUINO. Хостові тести (tools/*_check.cpp)
    //   включають settings.h, щоб перевіряти чисту логіку splash.h, і
    //   бібліотеки для ESP32 у них немає й бути не може. Без цієї умови
    //   перевірка валила б увесь набір тестів — я на цьому щойно й спіймався.
    #if defined(ARDUINO) && defined(__has_include)
      #if !__has_include(<TJpg_Decoder.h>)
        #error "DISPLAY_SPLASH_JPEG увімкнено, але бібліотеки TJpg_Decoder немає. Arduino IDE -> Менеджер бібліотек -> «TJpg_Decoder» (Bodmer). Або закоментуйте DISPLAY_SPLASH_JPEG — лишиться сирий .bin без залежностей."
      #endif
    #endif
    // JPEG має сенс лише як ЕКОНОМІЯ місця. Якщо стелю для нього підняли до
    // розміру сирого формату, сенс зник, а ризик (декодер на великому чужому
    // файлі) лишився.
    #if (DISPLAY_SPLASH_JPG_MAX_BYTES) >= (DISPLAY_SPLASH_MAX_BYTES)
      #error "DISPLAY_SPLASH_JPG_MAX_BYTES не менший за стелю сирого формату — JPEG втрачає сенс як економія місця."
    #endif
    // І він мусить лишатись достатнім для нормальної повноекранної картинки:
    // 240x240 у пристойній якості — це 15…40 КБ.
    #if (DISPLAY_SPLASH_JPG_MAX_BYTES) < 49152UL
      #error "DISPLAY_SPLASH_JPG_MAX_BYTES замалий: повноекранний JPEG у пристойній якості важить до ~48 КБ."
    #endif
  #endif
#endif
// Підсвітка (BLK/BL) — необов'язково; вкажіть GPIO, куди підключено.
// Якщо задано — заставка ПЛАВНО з'являється/згасає через ШІМ підсвітки, а екран
// лишається чорним без артефактів до появи (інакше — миттєвий показ):
#define DISPLAY_BLK_PIN        4
// Піни SPI ST7789: SCK=GPIO18, MOSI(SDA)=GPIO23 (апаратний SPI ESP32);
// CS/DC(RS)/RST — з блоку «Крок 2b» нижче (DISPLAY_CS/DC/RST_PIN).

// Якщо обраний SSD1327 і він НЕ працює/порожній екран — панелі GME128128-02
// бувають з різною "розводкою" контролера. Розкоментуйте один варіант:
// #define SSD1327_WS     // Waveshare-сумісний remap
// #define SSD1327_EA     // EA W128128
// #define SSD1327_ZJY    // ZJY 128x128
// (за замовчуванням — MIDAS, як було). Також допомагає задати контраст нижче.

// Крок 2a. Піни I2C (для I2C-дисплеїв). Працюють на Будь-яких GPIO — і
// програмний (SW), і апаратний (HW) I2C: ESP32 розводить їх матрицею.
#define DISPLAY_SDA_PIN   21     // I2C SDA
#define DISPLAY_SCL_PIN   22     // I2C SCL
#define DISPLAY_I2C_ADDR  0x3C   // адреса (зазвичай 0x3C, рідше 0x3D)
// Апаратний I2C — рендер в ~10 раз швидше. Безпечно: якщо апаратна
// шина не відповідає (немає ACK), прошивка при старте сама перейде на
// програмний I2C на тех же пінах (в Serial: "SW I2C fallback").
// Частая апаратна причина відмови HW I2C — слабкі підтяжки: поставте
// зовнішні резистори 4.7к з SDA і SCL на 3.3V.
#define DISPLAY_HW_I2C
// Частота шини I2C, кГц. 0 = АВТО: безпечний максимум з драйвера дисплея
// (SSD1306/SH1106/SH1107 — 400 кГц, SSD1327 — лише 100 кГц: 400 він НЕ
// тримає, і на апаратному I2C зависає уся шина!). Змінюйте лише свідомо.
#define DISPLAY_I2C_KHZ   600

// Крок 2b. Піни SPI (для ST7567 / Nokia 5110 / ST7789). Апаратний SPI ESP32:
// SCK=GPIO18, MOSI=GPIO23 (підключаються до CLK/DIN/SDA дисплея). Керуючі:
//
// ⚑ ПРО CS НА МОДУЛЯХ 240x240 (тут — GMT130-V1.0).
//  Виводу CS у них ФІЗИЧНО НЕМАЄ: на гребінку виходять лише
//  GND / VCC / SCL / SDA / RES / DC / BLK — сім контактів. Контролер вибраний
//  постійно, і GPIO5 нікуди не підключений.
//
//  І попри це рядок нижче ЗАДАНИЙ — так безпечніше. Прошивка просто смикає
//  непід'єднаний пін: електрично це нічого не робить (нічого до нього не
//  припаяно), а от протилежний варіант коштує дорожче. Передати бібліотеці
//  «CS немає» (-1) означає покластись на її внутрішню гілку для цього
//  випадку — а вона у різних версіях Adafruit_SPITFT реалізована по-різному
//  (де через csPinMask=0, де через digitalWrite(-1)). Заданий реальний пін
//  працює на БУДЬ-ЯКІЙ версії й на будь-якому модулі — з виводом CS і без.
//
//  Підтримка режиму «CS немає» лишається: закоментуйте рядок — і в
//  Adafruit піде -1, в U8g2 — U8X8_PIN_NONE (див. ST7789_CS_ARG у
//  display_color.h). Це має сенс, якщо GPIO5 потрібен вам під щось інше.
//
//  ⚠️ ЦІНА РЕЖИМУ БЕЗ CS: шину SPI більше НЕ МОЖНА ділити ні з чим. Поки
//  дисплей — єдиний пристрій на SCK/MOSI, це нічого не змінює (саме так у
//  цьому проєкті). Але додасте на ту саму шину, скажімо, SD-картку — дисплей
//  прийматиме її трафік за свої команди, і картинка розсиплеться. Перевірка
//  наприкінці файлу стежить, щоб піни SPI не з'явились у ролі чогось іншого.
#define DISPLAY_CS_PIN    5      // CS. Закоментуйте, щоб звільнити GPIO5
#define DISPLAY_DC_PIN    17     // DC  (Data/Command; у Nokia — «D/C»)
#define DISPLAY_RST_PIN   16     // RST (Reset)
// Зсув картинки вправо для ST7567, пікселів (у панелі Open-Smart RAM на
// 132 колонки, видно 4..131). Якщо картинка зсунута — підберіть 0..4.
//#define DISPLAY_ST7567_XOFF 4
// Контраст дисплея 0..255 (розкоментуйте, щоб задати вручну;
// для ST7567 більше = темніше, типово 30..90).
// #define DISPLAY_CONTRAST 128

// Анімація батареї на головній сторінці (плавучий градієнт заповнення).
// УВІМКНЕНА типово. Щоб ВИМКНУТИ — розкоментуйте (решта дисплея працює однаково):
// #define DISABLE_BATTERY_ANIM

// Налаштування плавучого градієнта (кольорові панелі). Змінюйте числа під смак:
//   SPEED   — ШВИДКІСТЬ течії: крок фази за кадр. Більше = швидше пливе (1..6).
//   MS      — ПЛАВНІСТЬ руху: період кадру в мс. Менше = плавніше (частіше
//             перемальовки, трохи більше SPI). 60..140. Разом зі SPEED задають темп.
//   WAVELEN — ПЛАВНІСТЬ градієнта: довжина хвилі в px. Більше = плавніший,
//             «розтягнутіший» перехід світло↔темно (48..160).
//   MINLVL  — КОНТРАСТ: мін. яскравість смуги 0..255. Менше = контрастніше (40..160).
#ifndef ANIM_GRADIENT_SPEED
  #define ANIM_GRADIENT_SPEED   1
#endif
#ifndef ANIM_GRADIENT_MS
  #define ANIM_GRADIENT_MS      130
#endif
#ifndef ANIM_GRADIENT_WAVELEN
  #define ANIM_GRADIENT_WAVELEN 120
#endif
#ifndef ANIM_GRADIENT_MINLVL
  #define ANIM_GRADIENT_MINLVL  150
#endif

// Дані АКБ при старті: ТИПОВО чистий екран (останній збережений дамп НЕ
// завантажується — усе порожнє, поки не зчитають акумулятор). Щоб повернути
// показ останнього дампа після перезавантаження — розкоментуйте:
// #define LOAD_SAVED_DUMPS_ON_BOOT

// --- Кнопки меню ------------------------------------------------------------
// ДВА варіанти. За замовчуванням — аналогова драбинка на ОДНОМУ ADC-піні
// (звільняє GPIO25/26, наприклад під DAC для заряду). Хочете три окремі GPIO,
// як було раніше, — закоментуйте блок MENU_BTN_ADC_* нижче й розкоментуйте
// блок «три окремі GPIO».
//
// ── Аналогова драбинка (за замовчуванням) ───────────────────────────────
//  Підтяжка MENU_BTN_ADC_PULLUP_OHM від MENU_BTN_ADC_PIN до +3.3В; кнопки
//  тягнуть на землю: «Ввід/OK» напряму (0 Ом), «Вліво» через
//  MENU_BTN_ADC_LEFT_OHM, «Вправо» через MENU_BTN_ADC_RIGHT_OHM. Пороги
//  нижче рахуються з цих трьох номіналів автоматично — зміните резистори
//  на платі, поправте лише ці три #define.
//
//  ⚠️ MENU_BTN_ADC_PIN МАЄ бути входом ADC1 (GPIO32..39) — ADC2 (0,2,4,
//  12-15,25-27) ненадійний, поки активний Wi-Fi (а точка доступу в цьому
//  проєкті активна завжди). GPIO33 = ADC1_CH5, підходить.
//
//  pinMode — INPUT (БЕЗ внутрішньої підтяжки: вона зіб'є розрахунок
//  драбинки, підтяжка тут зовнішня, резистором на платі).
//
//  ⚖️ ІДЕАЛЬНИЙ підбір — щоб усі чотири рівні (Ввід=0, Вліво, Вправо, не
//  натиснуто=3300) лягали РІВНОМІРНО через 1100 мВ (0/1100/2200/3300),
//  найбільший можливий запас між сусідами при такій драбинці (0 і 3300 мВ —
//  крайні точки, зафіксовані самою схемою, не підбираються): резистори
//  5к/20к дають ±550 мВ на КОЖНОМУ порозі — з різницею опору контактів
//  кнопки (окислення, дребезг) чи похибкою резисторів ±5% такий запас не
//  з'їсти. Якщо ставите «Вправо» рівним пулл-апу (10к) — різниця між
//  «Вліво» (5к) і «Вправо» (10к) дає лише ±270 мВ, найслабшу ланку; менше за
//  ідеал, але досі з великим запасом над шумом ADC (десятки мВ). Немає
//  резистора 20к під рукою — увімкніть ДВА 10к послідовно.
//
//  Номінали НИЖЧЕ — не заводські 5к/20к, а підібрані під РЕАЛЬНО виміряні
//  напруги на конкретній платі (BTN_ADC-лог показав ~1140/~1680 мВ, тобто
//  фактично ~5.3к/~10.4к) — якщо міняєте резистори на платі, виміряйте
//  BTN_ADC-лог заново і підставте нові номінали сюди.
#define MENU_BTN_ADC_PIN        33
#define MENU_BTN_ADC_PULLUP_OHM 10000
// ⚠️ Номінали нижче підібрані під РЕАЛЬНІ виміряні напруги на конкретній
// платі (BTN_ADC-лог: «вліво» ~1140 мВ, «вправо» ~1680 мВ — не заводські
// 5к/20к, а фактичні ~5.3к/~10.4к резистори на кнопках). Запас на межі
// «вліво»/«вправо» виходить ~270 мВ — менше за ідеальні ±550 мВ заводського
// номіналу, але з великим запасом над шумом ADC (десятки мВ). Якщо колись
// поставите на «вправо» другий резистор 10к ПОСЛІДОВНО (сумарно ~20к, як у
// заводському розрахунку) — поверніть RIGHT_OHM до 20000 і запас зросте
// до ±550 мВ.
#define MENU_BTN_ADC_LEFT_OHM   5280
#define MENU_BTN_ADC_RIGHT_OHM  10370

// Розрахункові рівні (мВ, від 3300 мВ живлення АЦП) і пороги розпізнавання
// (рівно посередині між сусідніми рівнями). З номіналами вище — 0 / 1100 /
// 2200 / 3300 мВ, тобто ±550 мВ запасу на кожному порозі.
#define MENU_BTN_ADC_MV_NONE  3300
#define MENU_BTN_ADC_MV_LEFT  (3300 * MENU_BTN_ADC_LEFT_OHM  / (MENU_BTN_ADC_LEFT_OHM  + MENU_BTN_ADC_PULLUP_OHM))
#define MENU_BTN_ADC_MV_RIGHT (3300 * MENU_BTN_ADC_RIGHT_OHM / (MENU_BTN_ADC_RIGHT_OHM + MENU_BTN_ADC_PULLUP_OHM))
#define MENU_BTN_ADC_TH_ENTER (MENU_BTN_ADC_MV_LEFT / 2)                          // нижче -> «Ввід» (0 Ом)
#define MENU_BTN_ADC_TH_LEFT  ((MENU_BTN_ADC_MV_LEFT + MENU_BTN_ADC_MV_RIGHT) / 2) // нижче -> «Вліво»
#define MENU_BTN_ADC_TH_RIGHT ((MENU_BTN_ADC_MV_RIGHT + MENU_BTN_ADC_MV_NONE) / 2) // нижче -> «Вправо», вище -> не натиснуто

// «3-кнопковий режим» — прапорець для решти коду (той самий, що вмикав
// окрему третю кнопку раніше). GPIO тепер спільний із MENU_BTN_ADC_PIN, тож
// значення — те саме: і сам факт #ifdef MENU_BTN3_PIN лишається робочим
// усюди в display.h/display_color.h, і числові порівняння (BUZZER_PIN ==
// MENU_BTN3_PIN тощо) нижче не ламаються об порожній макрос.
#define MENU_BTN3_PIN MENU_BTN_ADC_PIN

#ifdef MENU_BTN_ADC_PIN
  #if (MENU_BTN_ADC_PIN == LED_RED_PIN)     || (MENU_BTN_ADC_PIN == LED_GREEN_PIN)  || \
      (MENU_BTN_ADC_PIN == DS_PIN)          || (MENU_BTN_ADC_PIN == PULLUP_PIN)     || \
      (MENU_BTN_ADC_PIN == DISPLAY_SDA_PIN) || (MENU_BTN_ADC_PIN == DISPLAY_SCL_PIN) || \
      (defined(DISPLAY_CS_PIN) && MENU_BTN_ADC_PIN == DISPLAY_CS_PIN) || (MENU_BTN_ADC_PIN == DISPLAY_DC_PIN)  || \
      (MENU_BTN_ADC_PIN == DISPLAY_RST_PIN)
    #error "MENU_BTN_ADC_PIN конфліктує з уже зайнятим піном!"
  #endif
  #if (MENU_BTN_ADC_PIN < 32) || (MENU_BTN_ADC_PIN > 39)
    #error "MENU_BTN_ADC_PIN має бути ADC1 (GPIO32..39) — ADC2 ненадійний з увімкненим Wi-Fi."
  #endif
#endif

// ── Три окремі GPIO (стара схема; закоментовано на користь драбинки вище) ──
// #define MENU_BTN_PIN  25   // "Вперед": наступна сторінка
// #define MENU_BTN2_PIN 26   // "Назад": попередня сторінка
// #define MENU_BTN3_PIN 33   // "OK / Дія" — необов'язкова, закоментуйте й цей рядок для 2 кнопок
//
// #ifdef MENU_BTN3_PIN
//   #if (MENU_BTN3_PIN == MENU_BTN_PIN)    || (MENU_BTN3_PIN == MENU_BTN2_PIN)  || \
//       (MENU_BTN3_PIN == LED_RED_PIN)     || (MENU_BTN3_PIN == LED_GREEN_PIN)  || \
//       (MENU_BTN3_PIN == DS_PIN)          || (MENU_BTN3_PIN == PULLUP_PIN)     || \
//       (MENU_BTN3_PIN == DISPLAY_SDA_PIN) || (MENU_BTN3_PIN == DISPLAY_SCL_PIN) || \
//       (defined(DISPLAY_CS_PIN) && MENU_BTN3_PIN == DISPLAY_CS_PIN) || (MENU_BTN3_PIN == DISPLAY_DC_PIN)  || \
//       (MENU_BTN3_PIN == DISPLAY_RST_PIN)
//     #error "MENU_BTN3_PIN конфліктує з уже зайнятим піном! Оберіть вільний GPIO (напр. 32 або 33)."
//   #endif
// #endif

// --- Звукове оповіщення — НЕОБОВ'ЯЗКОВЕ ---
// Клік при перемиканні меню, звук на початку/успіху/помилці операції.
// ДВА варіанти виходу — оберіть ОДИН:
//
//  1) BUZZER_DAC_PIN (за замовчуванням) — апаратний ЦАП ESP32 (лише GPIO25
//     або GPIO26), звук — СПРАВЖНЯ синусоїда через таймерне переривання, а
//     не прямокутний ШІМ. Тембр помітно м'якший і «музикальніший» — ближче
//     до плавних переливчастих сигналів побутової техніки, ніж однотонне
//     гудіння п'єзо на ШІМ. Раніше GPIO25/26 були зайняті кнопками меню;
//     тепер, коли кнопки на аналоговій драбинці (GPIO33, див. вище), один із
//     двох ЦАП-пінів вільний під звук — саме ОДИН: GPIO26 забрав ШІМ
//     керованого заряду (CHARGE_PWM_PIN), лишився GPIO25.
//  2) BUZZER_PIN (закоментовано) — старий варіант: пасивний п'єзо-буззер на
//     БУДЬ-ЯКОМУ вихідному GPIO через апаратний ШІМ (LEDC). Простіше апаратно
//     (не потребує розв'язувального конденсатора), але тембр — прямокутна
//     хвиля, як би плавно не рахувалась огинаюча гучності/частоти.
//
// ⚠️ В ОБОХ випадках — БЕЗПОСЕРЕДНЬО на GPIO МОЖНА підключати ЛИШЕ пасивний
// п'єзо-буззер (споживає мкА)! ДИНАМІК (котушка 4–8 Ом) напряму НЕ
// підключати: перевантаження струмом -> brownout-reset. Динамік — лише через
// підсилювач/транзистор.
// ⚠️ ЦАП-вихід (варіант 1) — це постійна складова 0..3.3 В навколо середини
// (~1.65 В), а не змінний сигнал навколо нуля: перед п'єзо/підсилювачем
// поставте розв'язувальний КОНДЕНСАТОР (напр. 1–10 мкФ) послідовно, інакше
// на буззер постійно подається половина живлення й з'являється помітний
// щиглик/гудіння на межах фрази.
#define BUZZER_DAC_PIN 25   // ⚑ ЗВУК УВІМКНЕНО.
//  ⚠️ ТУТ ДОВГО СТОЯВ ХИБНИЙ КОМЕНТАР: «звук вимкнено, GPIO25 віддано
//  керованому заряду». Заряд GPIO25 НЕ ЗАЙМАВ І НЕ ЗАЙМАЄ — його ШІМ сидить
//  на GPIO26 (CHARGE_PWM_PIN), а 25-й просто лежав у резерві. Той самий
//  хибний привід був переписаний у README й INSTRUCTION; виправлено разом
//  із цим рядком.
//  Що зайнято з двох ЦАП-пінів ESP32: 26 — заряд, 25 — звук. Вільних ЦАП-
//  пінів після цього не лишається (перевірка «пізніх» конфліктів — у кінці
//  файлу, поруч із перевіркою шини SPI).
//  Щоб вимкнути звук — закоментуйте рядок: buzzer.h має повноцінну «тиху»
//  гілку, налаштування й перелік сигналів усе одно віддаються в API, просто
//  нічого не звучить.
// Частота дискретизації синтезу, Гц. 16 кГц — з великим запасом над чутним
// діапазоном мелодій (ноти до ~1.5 кГц, огинаюча — одиниці Гц), і легко
// встигає таймерне переривання на 240 МГц.
#define BUZZ_SAMPLE_HZ 16000

// #define BUZZER_PIN 2   // старий варіант (ШІМ) — розкоментуйте замість DAC_PIN вище

// ⚠️ Усе нижче — ЗАВОДСЬКІ значення. Характер звуку правиться НА ХОДУ (веб/USB/
// ехе-клієнт -> «Ремонт» -> «🔊 Налаштування звуку», або команда SOUND) і живе в
// SPIFFS у /sound.cfg. Перепрошивати заради гучності чи темпу не треба; сюди
// лізьте, лише якщо хочете змінити те, до чого повертає кнопка «Заводські».
//
// Гучність 0..255 (255 = максимум). Сигнали й так із плавною огинаючою фрази.
// Типово 150; хочете тихіше — 90..120. Мало на ЦАП — краще піднімати
// повзунком «Гучність» у веб-інтерфейсі (до 255), ніж цей заводський
// дефолт: вищий дефолт збільшує й АБСОЛЮТНИЙ крок огинаючої що 5 мс, а це
// вже чутно як дрібні сходинки (регресійний тест на ШІМ-шляху це ловить).
#define BUZZER_VOLUME 150
// Огинаюча фрази: за скільки мс звук наростає на початку й згасає в кінці.
// Занадто коротка атака чується як клац, занадто довга «з'їдає» короткі сигнали
// (buzzer.h стискає її автоматично, якщо фраза коротша за огинаючу).
// Згасання довше атаки навмисно — «тане», а не обривається, як дзвіночок.
#define BUZZ_ATTACK_MS  28
#define BUZZ_RELEASE_MS 180

#if defined(BUZZER_PIN) && defined(BUZZER_DAC_PIN)
  #error "Оберіть ЛИШЕ ОДИН варіант звуку: BUZZER_PIN (ШІМ) або BUZZER_DAC_PIN (ЦАП), не обидва."
#endif

#ifdef BUZZER_DAC_PIN
  #if (BUZZER_DAC_PIN != 25) && (BUZZER_DAC_PIN != 26)
    #error "BUZZER_DAC_PIN має бути 25 або 26 — це єдині GPIO зі справжнім ЦАП на ESP32."
  #endif
  #if (defined(MENU_BTN_PIN) && BUZZER_DAC_PIN == MENU_BTN_PIN) || \
      (defined(MENU_BTN2_PIN) && BUZZER_DAC_PIN == MENU_BTN2_PIN) || \
      (defined(MENU_BTN3_PIN) && BUZZER_DAC_PIN == MENU_BTN3_PIN) || \
      (BUZZER_DAC_PIN == LED_RED_PIN) || (BUZZER_DAC_PIN == LED_GREEN_PIN) || \
      (BUZZER_DAC_PIN == DS_PIN) || (BUZZER_DAC_PIN == PULLUP_PIN) || \
      (BUZZER_DAC_PIN == DISPLAY_SDA_PIN) || (BUZZER_DAC_PIN == DISPLAY_SCL_PIN) || \
      (defined(DISPLAY_CS_PIN) && BUZZER_DAC_PIN == DISPLAY_CS_PIN) || (BUZZER_DAC_PIN == DISPLAY_DC_PIN) || \
      (BUZZER_DAC_PIN == DISPLAY_RST_PIN) || \
      (defined(DISPLAY_BLK_PIN) && BUZZER_DAC_PIN == DISPLAY_BLK_PIN)
    #error "BUZZER_DAC_PIN конфліктує з уже зайнятим піном! Вільні ЦАП-піни — 25 і 26."
  #endif
  // ⚠️ ТУТ БУЛО ЩЕ ТРИ РЯДКИ — порівняння з CHARGE_PWM_PIN, LOAD_PIN і
  //  BTN_LED_PIN. Вони НЕ ПРАЦЮВАЛИ: усі три макроси визначені НИЖЧЕ за цей
  //  блок, тож на момент перевірки їх ще не існує, `defined(...)` дає 0, і
  //  вся умова мовчки згортається в «конфлікту немає». Це той самий клас
  //  дефекту, що вже ловили на LOAD_PIN (див. коментар про
  //  DISCHARGE_RAMP_LO_MV нижче): перевірка є, захисту немає — і саме там,
  //  де ціна помилки найвища, бо BUZZER_DAC_PIN 26 — це ШІМ заряду.
  //  Порівняння з пізніми пінами перенесено в кінець файлу, до блока
  //  «ЗВУК ПРОТИ ПІЗНІХ ПІНІВ», де всі вони вже визначені.
#endif

#ifdef BUZZER_PIN
  // ⚠️ GPIO34/35/36/39 — ВХІД-ТІЛЬКИ (input-only): без вихідного драйвера, тож
  // tone()/LEDC на них НЕ виводять сигнал (у логах: "ledc: gpio_num argument is
  // invalid", звуку немає, навіть якщо attach=OK). Оберіть вихідний GPIO (напр. 32).
  #if (BUZZER_PIN == 34) || (BUZZER_PIN == 35) || (BUZZER_PIN == 36) || (BUZZER_PIN == 39)
    #error "BUZZER_PIN на GPIO34/35/36/39 неможливий: ці піни ВХІД-ТІЛЬКИ і не виводять звук. Оберіть вихідний GPIO, напр. 32."
  #endif
  #if (defined(MENU_BTN_PIN) && BUZZER_PIN == MENU_BTN_PIN) || \
      (defined(MENU_BTN2_PIN) && BUZZER_PIN == MENU_BTN2_PIN) || \
      (BUZZER_PIN == LED_RED_PIN)    || (BUZZER_PIN == LED_GREEN_PIN)  || \
      (BUZZER_PIN == DS_PIN)         || (BUZZER_PIN == PULLUP_PIN)     || \
      (BUZZER_PIN == DISPLAY_SDA_PIN)|| (BUZZER_PIN == DISPLAY_SCL_PIN)|| \
      (defined(DISPLAY_CS_PIN) && BUZZER_PIN == DISPLAY_CS_PIN) || (BUZZER_PIN == DISPLAY_DC_PIN) || \
      (BUZZER_PIN == DISPLAY_RST_PIN)|| (defined(MENU_BTN3_PIN) && BUZZER_PIN == MENU_BTN3_PIN) || \
      (defined(DISPLAY_BLK_PIN) && BUZZER_PIN == DISPLAY_BLK_PIN)
    // ⚠️ Якщо BUZZER_PIN збігається з піном підсвітки (DISPLAY_BLK_PIN) — ШІМ
    // підсвітки (analogWrite) заглушить тон: attach=OK, «чирп» у логах є, а звуку
    // немає. Оберіть для буззера ІНШИЙ вільний GPIO.
    #error "BUZZER_PIN конфліктує з уже зайнятим піном (кнопки/дисплей/підсвітка)! Оберіть вільний GPIO (напр. 33)."
  #endif
#endif

// --- Підсвітка кнопок як ІНДИКАТОР РОБОТИ — НЕОБОВ'ЯЗКОВЕ ---
// Багато кнопок мають вбудований світлодіод підсвітки. Заведіть його на вільний
// GPIO — і він не лише світитиметься, а й показуватиме стан:
//   • спокій/готовий  -> рівне світіння (зручно намацати кнопки в темряві);
//   • читання         -> блимає в такт читанню;
//   • запис           -> швидко блимає (》увага: не відключати《);
//   • успіх           -> рівне світіння; помилка -> тривожне швидке блимання.
// Підключення: анод світлодіода(ів) -> струмообмежувальний резистор -> GPIO,
// катод -> GND (активний рівень HIGH). Якщо модуль із загальним анодом (катод
// керується) — розкоментуйте BTN_LED_ACTIVE_LOW. ⚠️ Якщо сумарний струм усіх
// підсвіток > ~20 мА — керуйте через транзистор (GPIO->база, світлодіоди на
// колекторі), інакше просадка/перегрів піна.
#define BTN_LED_PIN 15          // вільний вихідний GPIO (напр. 15 або 2)
// #define BTN_LED_ACTIVE_LOW      // якщо підсвітка вмикається низьким рівнем
#ifdef BTN_LED_PIN
  #if (BTN_LED_PIN == 34) || (BTN_LED_PIN == 35) || (BTN_LED_PIN == 36) || (BTN_LED_PIN == 39)
    #error "BTN_LED_PIN на GPIO34/35/36/39 неможливий: ці піни ВХІД-ТІЛЬКИ і не виводять сигнал. Оберіть вихідний GPIO."
  #endif
  #if (defined(MENU_BTN_PIN) && BTN_LED_PIN == MENU_BTN_PIN) || \
      (defined(MENU_BTN2_PIN) && BTN_LED_PIN == MENU_BTN2_PIN) || \
      (BTN_LED_PIN == LED_RED_PIN)    || (BTN_LED_PIN == LED_GREEN_PIN)  || \
      (BTN_LED_PIN == DS_PIN)         || (BTN_LED_PIN == PULLUP_PIN)     || \
      (BTN_LED_PIN == DISPLAY_SDA_PIN)|| (BTN_LED_PIN == DISPLAY_SCL_PIN)|| \
      (defined(DISPLAY_CS_PIN) && BTN_LED_PIN == DISPLAY_CS_PIN) || (BTN_LED_PIN == DISPLAY_DC_PIN) || \
      (BTN_LED_PIN == DISPLAY_RST_PIN)|| (defined(MENU_BTN3_PIN) && BTN_LED_PIN == MENU_BTN3_PIN) || \
      (defined(DISPLAY_BLK_PIN) && BTN_LED_PIN == DISPLAY_BLK_PIN) || \
      (defined(BUZZER_PIN) && BTN_LED_PIN == BUZZER_PIN)
    #error "BTN_LED_PIN конфліктує з уже зайнятим піном! Оберіть вільний вихідний GPIO."
  #endif
#endif

// ===========================================================================
//  РОЗРЯДНА НАВАНТАГА (MOSFET + резистор) — керований розряд пакета.
// ===========================================================================
//  ДЛЯ ЧОГО. Після ремонту зарядна станція не бере АКБ на калібрування, якщо
//  бачить його зарядженим: світить зеленим і просто тримає. Контрольований
//  розряд до ~7.2 В прибирає цю невизначеність — станція зобов'язана піти в
//  повний цикл. Другий зиск: за час розряду рахуємо РЕАЛЬНУ ємність нових
//  банок (приймальний контроль після перепайки).
//
//  СХЕМА. N-канальний MOSFET у НИЖНЬОМУ ключі (логічний рівень, відкривається
//  позитивним потенціалом на затворі):
//
//      +АКБ --[ R_load 5 Ом / 25 Вт ]-- D
//                                       |
//                                    MOSFET (N-ch, logic level)
//                                       |
//      -АКБ --------------------------- S -- спільна земля з ESP32
//                          G -- LOAD_PIN
//                          +--[ 10 кОм ]-- GND     <-- ОБОВ'ЯЗКОВО
//
//  !! РЕЗИСТОР 10 кОм ІЗ ЗАТВОРА НА ЗЕМЛЮ ОБОВ'ЯЗКОВИЙ. Під час скидання й
//  завантаження ESP32 піни у високоімпедансному стані: без підтяжки затвор
//  «висить», MOSFET може лишитися відкритим і посадити пакет у нуль. Програмних
//  запобіжників тут НЕ досить — потрібен саме апаратний резистор.
//
//  ПОТУЖНІСТЬ. «Голий» струм на 5 Ом: 8.4 В -> 1.68 А -> 14.1 Вт; 7.0 В ->
//  1.40 А -> 9.8 Вт. Стільки ми НЕ беремо: струм обмежується ШІМом (нижче), тож
//  середня потужність на резисторі ~5..8 Вт. Запас усе одно потрібен — резистор
//  на 25 Вт із радіатором: під час вимірювання піка (див. нижче) ключ на
//  короткий час відкривається повністю.
//
//  MOSFET працює КЛЮЧЕМ: або повністю відкритий, або повністю закритий. ШІМ це
//  не порушує — між станами ключ проскакує за мікросекунди, у лінійному режимі
//  (де вихід за SOA) він не затримується. Через це затвор бажано підключати
//  через резистор 100 Ом послідовно: він гасить дзвін і бере на себе кидок
//  струму перезаряду затвора, який інакше йде з піна ESP32.
//
//  ВИМІР СТРУМУ. Свій шунт не потрібен: струмовимірювальний резистор DS2438
//  стоїть УСЕРЕДИНІ пакета послідовно з банками, тож увесь наш струм проходить
//  через нього й видно у регістрі струму та в лічильнику DCA.
//
//  Розряд ВИМКНЕНО, доки не задано LOAD_PIN.
// ---------------------------------------------------------------------------
#define LOAD_PIN 19        // затвор MOSFET. GPIO18/23 зайняті SPI дисплея,
                           // 34..39 — лише вхід, GPIO0 — strapping (підтяжка
                           // затвора не дала б завантажитись). Лишається 19.
                           // Закоментуйте рядок, щоб вимкнути функцію розряду.

// Опір навантаження, Ом — для оцінки струму «на повністю відкритому ключі»
// (початкове наближення ШІМ до першого виміру). На облік мА*год не впливає:
// він рахується з РЕАЛЬНОГО струму DS2438.
#define LOAD_OHM            5.0f

// ---------------------------------------------------------------------------
//  ОБМЕЖЕННЯ СТРУМУ ШІМом
// ---------------------------------------------------------------------------
//  Навіщо. На 5 Ом «голий» струм — 1.4..1.7 А. Це і забагато для резистора, і
//  забагато для щойно перепаяних банок: 1.7 А на пакеті 2.15 А*год — це 0.8C,
//  на такому струмі просадка напруги велика, вимір ємності занижується, а банки
//  й контакти гріються дарма. Тому ключ керується ШІМом, а не просто «увімк.».
//
//  Яку уставку тримаємо. Не одну — струм веде за напругою ЛІНІЙНО:
//
//      DISCHARGE_RAMP_HI_MV -> DISCHARGE_MA_HI (1000 мА)   ← повний заряд
//         ...          лінійно          ...
//      ЦІЛЬОВА напруга      -> DISCHARGE_MA_LO (300 мА)    ← кінець розряду
//
//  Так зроблено тому, що просадка під навантаженням найбільше спотворює саме
//  кінець розряду: на розрядженому пакеті внутрішній опір вищий, і великий
//  струм передчасно «продавлює» напругу до цілі — розряд обірветься раніше, ніж
//  банки насправді віддадуть ємність. Малий струм у кінці дає чесніший вимір і
//  щадить банки. Поза відрізком уставка тримається на межах (не екстраполюємо).
//
//  ⚑ НИЗ ЛІНІЙКИ ЇДЕ ЗА ЦІЛЛЮ. Ціль розряду задається користувачем, і лінійка
//  будується під неї: 300 мА досягаються РІВНО на обраній цілі, хоч 7.2 В, хоч
//  7.6 В. Інакше при цілі 7.8 В розряд закінчувався б на 550 мА, тобто якраз на
//  тому струмі, який і спотворює вимір.
#define DISCHARGE_MA_HI     1000   // уставка струму при DISCHARGE_RAMP_HI_MV, мА
#define DISCHARGE_MA_LO     300    // уставка струму НА ЦІЛЬОВІЙ напрузі, мА
// Верх лінійки — це «повний пакет», тобто верх шкали заряду. Число тут стояло
// окремо (8250) і після переходу на криву OCV розійшлося б із нею мовчки.
#define DISCHARGE_RAMP_HI_MV (SOC_FULL_MV)

// Допустимий діапазон цілі розряду, мВ. Нижня межа — з запасом над аварійною
// (DISCHARGE_HARD_MIN_MV), верхня — трохи нижче «повного» стану, інакше розряд
// не мав би сенсу.
#define DISCHARGE_TARGET_MIN_MV 6800
#define DISCHARGE_TARGET_MAX_MV 8000

// Допуск навколо уставки, % — тільки для показу «в межах / поза межами».
// 80..110 % від 1000 мА = ті самі 800..1100 мА. Регулятор цілиться в уставку,
// а не в край коридору: коридор — це діагностика, а не гістерезис.
#define DISCHARGE_BAND_LO_PCT 80
#define DISCHARGE_BAND_HI_PCT 110

// Частота ШІМ, Гц, і розрядність. 1 кГц: період 1 мс — на два порядки менший за
// теплову сталу резистора (пульсацій нагріву немає) і на порядки більший за час
// перемикання ключа (втрати на перемиканні мізерні). 10 біт (0..1023) дає крок
// шпаруватості ~0.1 %, чого з головою: ESP32 на 1 кГц/10 біт працює штатно.
#define DISCHARGE_PWM_FREQ  1000
#define DISCHARGE_PWM_BITS  10

// Канал LEDC зумера. Значення те саме, що в buzzer.h (там свій #ifndef, тож
// вони не сперечаються), але оголошене ТУТ — інакше перевірка «канали не
// діляться таймером» наприкінці файлу його не побачить: buzzer.h включається
// ПІЗНІШЕ за settings.h, і в #if він був би мовчазним нулем.
#ifndef BUZZER_LEDC_CH
  #define BUZZER_LEDC_CH 5
#endif

// Канал LEDC для ключа — задаємо ЯВНО, як і зумеру, а не покладаємось на
// автопідбір: світлодіоди беруть канали динамічно (ledPwmAttach/Detach під час
// «дихання» помаранчевим), і мовчазний перетин з ними змінив би шпаруватість
// ключа. Зумер сидить на BUZZER_LEDC_CH (5), тож беремо 6 — інший таймер
// (канали діляться таймерами попарно), інша частота нікому не заважає.
#ifndef LOAD_LEDC_CH
  #define LOAD_LEDC_CH 6
#endif

// Нижня межа шпаруватості, %. Нижче — вважаємо, що навантаження не потрібне
// взагалі (захист від «майже закритого» ключа, де він працює лінійно).
#define DISCHARGE_DUTY_MIN_PCT 3

// Скільки тримати ключ ПОВНІСТЮ відкритим перед зняттям показань, мс.
//  Навіщо. DS2438 віддає миттєвий струм останнього перетворення (~27 мс). На
//  ШІМі невідомо, у яку фазу — увімкнено чи вимкнено — те перетворення попало,
//  тож пряме читання під ШІМом непридатне ні для регулятора, ні для обліку.
//  Тому раз на цикл опитування ключ на 80 мс (>2 перетворення) відкривається
//  повністю, і ми міряємо ПІК — струм при шпаруватості 100 %. Далі все
//  однозначно: середній струм = пік * шпаруватість, потрібна шпаруватість =
//  уставка / пік. 80 мс раз на 5 с — це 1.6 % часу, на нагрів і на ємність
//  не впливає.
#define DISCHARGE_PEAK_SETTLE_MS 80

// Цільова напруга розряду за замовчуванням, мВ. 7200 мВ = 3.6 В/банку —
// пакет свідомо «не повний», станція піде в повний цикл, банки не в стресі.
#define DISCHARGE_TARGET_MV 7200

// АВАРІЙНА відсічка, мВ. Нижче не розряджаємо НІКОЛИ (3.0 В/банку — межа, за
// якою Li-Ion деградує). Спрацювання = аварійна зупинка, а не успіх.
#define DISCHARGE_HARD_MIN_MV 6000

// Відсічка за температурою пакета (DS2438), °C.
#define DISCHARGE_MAX_TEMP_C 45

// Період моніторингу, мс: раз на 5 с знімаємо напругу, СТРУМ, температуру та
// лічильники вбудованого датчика струму DS2438 (ICA/DCA). Частіше сенсу мало:
// DS2438 оновлює вимір напруги/струму приблизно раз на 27 мс, але шина 1-Wire
// й перемальовка екрана — теж робота, а процес триває десятки хвилин.
#define DISCHARGE_POLL_MS 5000UL

// Стеля тривалості, хв. Захист від «розряд не йде» (обрив навантаження,
// залиплий MOSFET, хибний контакт): довше — аварійна зупинка.
//
// Було 240 хв — під постійні 1.4 А. З обмеженням струму (уставка спадає до
// 300 мА) розряд закономірно довший: за розрахунком пакет 2150 мА*год іде
// ~2 год 50 хв, а 3000 мА*год (PMNN4493A) — ~3 год 55 хв, тобто впритул до
// старої стелі. Ставимо 6 год: це і далі надійно ловить «розряд не йде»
// (там струм нульовий і напруга не рухається зовсім), але вже не обриває
// чесний повний цикл на великому пакеті.
#define DISCHARGE_MAX_MIN 360

// Скільки поспіль невдалих читань DS2438 -> аварійна зупинка. Розряд наосліп
// неприпустимий: без контролю напруги пакет можна посадити в нуль.
#define DISCHARGE_MAX_READ_FAILS 3

// ── СТОРОЖОВИЙ ТАЙМЕР РОЗРЯДУ ──────────────────────────────────────────────
//  Розряд — єдиний режим, де пристрій тримає замкнутим силовий ключ І сигнал
//  enable без участі людини. Якщо головний цикл зависне (збій Wi-Fi-стека,
//  нескінченне очікування на шині, будь-що), ключ так і лишиться відкритим, а
//  пакет саджатиметься в нуль. Тому на час розряду вмикається сторож:
//
//   • ПРОГРАМНИЙ. Якщо між опитуваннями минуло більше DISCHARGE_STALL_MS —
//     цикл десь застряг, але ще живий: розряд аварійно зупиняється, ключ
//     закривається, enable знімається. Поріг — із запасом на найдовшу штатну
//     затримку (запис DS2433 — 16 сторінок по 10 мс + службові операції).
//   • АПАРАТНИЙ. Якщо цикл не живий узагалі, програмний сторож не спрацює.
//     Тоді ESP32 перезавантажується за Task WDT. Після скидання піни — входи,
//     затвор притягнутий до землі підтяжкою (див. блок «РОЗРЯДНА НАВАНТАГА»),
//     а enable знято, тож пакет від'єднується сам собою.
//     WDT вмикається ЛИШЕ на час розряду: в інших режимах довгі операції
//     (запис прошивки, форматування SPIFFS) законно тривають довше.
#define DISCHARGE_STALL_MS   (DISCHARGE_POLL_MS * 4)   // 20 с
#define DISCHARGE_WDT_SEC    30                        // апаратний, > STALL_MS

#ifdef LOAD_PIN
  #if (LOAD_PIN == DS_PIN) || (LOAD_PIN == PULLUP_PIN) || (LOAD_PIN == LED_GREEN_PIN) || \
      (LOAD_PIN == LED_RED_PIN) || \
      (defined(MENU_BTN_PIN) && LOAD_PIN == MENU_BTN_PIN) || \
      (defined(MENU_BTN2_PIN) && LOAD_PIN == MENU_BTN2_PIN) || \
      (defined(MENU_BTN3_PIN) && LOAD_PIN == MENU_BTN3_PIN) || \
      (defined(BUZZER_PIN) && LOAD_PIN == BUZZER_PIN) || \
      (defined(BTN_LED_PIN) && LOAD_PIN == BTN_LED_PIN)
    #error "LOAD_PIN конфліктує з уже зайнятим піном! Оберіть вільний вихідний GPIO."
  #endif
  #if (LOAD_PIN >= 34)
    #error "LOAD_PIN на GPIO34..39 неможливий: ці піни ВХІД-ТІЛЬКИ і не відкриють MOSFET."
  #endif
  #if (LOAD_PIN == 0)
    #error "LOAD_PIN на GPIO0 неможливий: strapping-пін, підтяжка затвора на землю заблокує завантаження."
  #endif
  // ⚑ Тут стояло порівняння з DISCHARGE_RAMP_LO_MV — макросом, якого В ПРОЄКТІ
  // НЕМАЄ (низ лінійки поїхав за ЦІЛЬ, див. блок «НИЗ ЛІНІЙКИ ЇДЕ ЗА ЦІЛЛЮ»
  // вище, а старий #define прибрали й забули). Невідомий ідентифікатор у #if
  // препроцесор МОВЧКИ вважає нулем, тож умова читалась як «8250 <= 0» і не
  // спрацювала б ніколи: перевірка була, а захисту не було.
  // Справжній інваріант тепер такий: верх лінійки мусить бути вище за
  // НАЙВИЩУ ДОЗВОЛЕНУ ЦІЛЬ — інакше при цілі, що дотягується до верху,
  // dischargeSetpointMa() вироджується (span <= 0) і струм застигає на межі.
  #if (DISCHARGE_RAMP_HI_MV <= DISCHARGE_TARGET_MAX_MV)
    #error "DISCHARGE_RAMP_HI_MV має бути вище за DISCHARGE_TARGET_MAX_MV — інакше лінійка струму вироджується на найвищій цілі."
  #endif
  #if (DISCHARGE_TARGET_MIN_MV >= DISCHARGE_TARGET_MAX_MV)
    #error "DISCHARGE_TARGET_MIN_MV має бути нижче за DISCHARGE_TARGET_MAX_MV."
  #endif
  #if (DISCHARGE_TARGET_MIN_MV <= DISCHARGE_HARD_MIN_MV)
    #error "DISCHARGE_TARGET_MIN_MV має бути вище за аварійну відсічку DISCHARGE_HARD_MIN_MV."
  #endif
  #if (DISCHARGE_MA_LO < 50) || (DISCHARGE_MA_HI < DISCHARGE_MA_LO)
    #error "Уставки струму: потрібно 50 <= DISCHARGE_MA_LO <= DISCHARGE_MA_HI."
  #endif
  #if (DISCHARGE_PEAK_SETTLE_MS < 60)
    #error "DISCHARGE_PEAK_SETTLE_MS < 60 мс: DS2438 не встигне зробити нове перетворення струму (~27 мс)."
  #endif
#endif

// --- Индикатор заряду ---
// Пріоритет ICA (DS2438). При вимкненому обліку струму (IAD=0) — по напрузі.
// ⚑ Живого коду за цим макросом уже немає. Шкала паливоміра ICA — АПАРАТНА
// (одиниця = 0.4882 мВ·год / шунт цього пакета), і 100 % там майже ніколи не
// 255: для PMNN4409A повний пакет — це 202 одиниці. Див. impres_format.h.
#define ICA_FULL_SCALE    255      // застаріле; лишено для сумісності
// ── ШКАЛА «ЗАРЯД ЗА НАПРУГОЮ» ─────────────────────────────────────────────
//  ⚑ БІЛЬШЕ НЕ ЛІНІЙКА МІЖ ДВОМА ЧИСЛАМИ. Раніше тут стояли 6350 і 8250, а
//  відсоток рахувався прямою між ними. Для літію це неправильно принципово:
//  крива напруги спокою — полога сходинка з довгим плато посередині, і пряма
//  завищувала показ на 25 % саме там, де ціна помилки найвища (7.0…7.2 В).
//  Тепер шкала — таблична крива OCV на банку (soc.h), а межі виводяться з
//  хімії, а не підбираються:
//
//      0 %   = 3.00 В/банку × 2 = 6.00 В
//      100 % = 4.20 В/банку × 2 = 8.40 В
//
//  Обидві константи ОБЧИСЛЮЮТЬСЯ з кривої — вписати сюди інше число й лишити
//  криву старою не можна: за цим стежить #error нижче.
#define BATTERY_EMPTY_MV  (SOC_EMPTY_MV)   // 0 % — 3.00 В на банку
#define BATTERY_FULL_MV   (SOC_FULL_MV)    // 100 % — 4.20 В на банку
// Ті самі межі для impres_format.h (спільна логіка для всіх поверхонь).
#define IMPRES_EMPTY_MV   BATTERY_EMPTY_MV
#define IMPRES_FULL_MV    BATTERY_FULL_MV

// ⚠️ ТЕКСТ шкали — ПОРУЧ із числами, і більше ніде.
//
// Раніше нижня точка шкали стояла літералами в десятку місць: у меню пристрою, у
// підказках веба, USB-клієнта, ехе-клієнта, у Майстрі й у коментарях. Варто
// було раз змінити число — і частина написів лишалась брехати: у діалозі
// ехе-клієнта до останнього висіли 7.0/8.4 В від ще давнішої шкали. Тепер усі
// поверхні беруть рядок звідси, а окремий тест звіряє його з
// числами вище.
#define BATTERY_SCALE_TXT       "крива 2S: 6.00 В = 0 %, 8.40 В = 100 %"
#define BATTERY_SCALE_TXT_SHORT "2S 6.00В=0% 8.40В=100%"
// Струмовимірювальний резистор DS2438, Ом — ⚑ ЛИШЕ ЗАПАСНЕ ЗНАЧЕННЯ.
//
// Кожен пакет носить СВІЙ відкалібрований шунт прямо в чипі: DS2438[56..57],
// два байти LE, значення/100000 = Ом (impres_bms.h, розділ 4a.2 документа).
// Прошивка тепер читає його звідти, а сюди падає лише коли поле порожнє —
// наприклад, на занулених чипах.
//
// Чому це важливо. У наших дампах шунт у PMNN4409A/B — 0.045..0.046 Ом, а в
// 4488A/4493A/4809A — 0.025..0.026 Ом. Тобто стара єдина константа 0.025
// занижувала опір на родині 4409 майже вдвічі, а отже завищувала і струм, і
// мА·год у 1.8 раза. Для керованого розряду це не косметика: уставка ШІМ
// тримає саме ВИМІРЯНИЙ струм.
#define DS2438_RSENSE_OHM 0.025f
// Ціна молодшого розряду ICA в мА·год (даташит DS2438): 0.4882/Rsense.
// ⚠️ Це крок ЛИШЕ для ICA. У CCA/DCA крок 15.625 мВ·год — у 32 рази більший;
// для них рахунок ведеться в impres_bms.h / discharge.h, не тут.
// Живого коду за цими двома макросами вже немає (шунт беруть із чипа) —
// лишені для сумісності з зовнішніми скриптами.
#define DS2438_MAH_PER_LSB (0.4882f / DS2438_RSENSE_OHM)
// Паспортна ємність АКБ, мА·ч — для підрахунку циклів заряду/розряду:
// 1 цикл = сумарний заряд (розряд), рівний однієї повної ємності.
// Вкажіть ємність вашої батареї (PMNN4409 — 2500, PMNN4493 — 3000 і т.п.).
#define BATTERY_RATED_MAH 2500
// Повна шкала ICA (залишкової ємності DS2438), мА·ч: ICA=255 -> стільки мА·ч.
// Використовується для показу/редагування залишкової ємності в мА·ч (замість відсотків).
#define ICA_FULL_MAH (255.0f * DS2438_MAH_PER_LSB)

// ---------------------------------------------------------------------------
//  КЕРОВАНИЙ ЗАРЯД — ПОНИЖУВАЛЬНИЙ ПЕРЕТВОРЮВАЧ (buck) на біполярному PNP
// ---------------------------------------------------------------------------
//  ⚑ ЦЕ НЕ ПРОСТО КЛЮЧ. Після ключа стоїть діод на землю й дросель на вихід —
//  тобто класичний понижувач (step-down) із верхнім ключем. Дросель і діод
//  змінюють ФІЗИКУ настільки, що більшість «очевидних» рішень простого ключа
//  тут неправильні (див. «ЩО ЗМІНЮЄ ДРОСЕЛЬ» нижче).
//
//  ── СИЛОВА ЧАСТИНА ────────────────────────────────────────────────────────
//
//     +Uживл ─────┬──────[ R_підт ]──────┬─── E(емітер) PNP (B772M)
//                 │                      │
//                 └──────────────────────┴─── B(база) ──┐
//                                                        │
//     CHARGE_PWM_PIN ──[ R_драйв 470 ]── B(база)        │
//                                     NPN  C ────[ R_бази ]┘
//                                          E ── GND
//                       B ──[ R_вниз 10к ]── GND   <-- ОБОВ'ЯЗКОВО
//
//                     C(колектор) ─┬─────[ L дросель ]─────> +клема АКБ
//                                  │
//                            (катод) VD  діод Шотткі
//                                  │
//                                 GND
//
//  ⚑ КЛЮЧ — БІПОЛЯРНИЙ (B772M), А НЕ MOSFET. Це не «інша деталь у тій самій
//  ролі», а інший принцип: біполярник керується СТРУМОМ БАЗИ, а не напругою
//  на затворі. Наслідки, яких у MOSFET немає взагалі:
//
//   • R_бази (між колектором NPN і базою PNP) не «швидкодію налаштовує», а
//     ЗАДАЄ СТРУМ БАЗИ, від якого залежить, чи ключ узагалі насититься:
//     Iб = (Uживл − Uбе − Uке_нас_npn) / R_бази, і потрібно Iб >= Iк / β_форс
//     (β_форс ~20 для надійного насичення). Для 1 А це 50 мА бази й R ≈ 260 Ом,
//     причому НА САМОМУ РЕЗИСТОРІ розсіюється ~0.4 Вт — його треба брати на 1 Вт.
//     У MOSFET цей резистор струму не несе взагалі.
//
//   • Ключ ГРІЄТЬСЯ. У насиченні на ньому лишається Uке_нас ≈ 0.3…0.6 В (а не
//     мілівольти опору каналу), тож провідні втрати = Uке_нас × Iк × D. Плюс
//     біполярник вимикається ПОВІЛЬНО: заряд бази треба розсмоктати, і з
//     резистивним вимиканням це мікросекунди (у MOSFET — наносекунди).
//     Перевірка наприкінці блока рахує обидві складові й не дасть зібрати
//     прошивку з профілем струму, за якого B772M вийде за Pc.
//
//   • R_підт (база->емітер) тепер не «підтяжка затвора», а ЗАПИРАЮЧИЙ
//     резистор: він шунтує перехід база-емітер і прискорює розсмоктування.
//     Без нього вимикання ще повільніше. Типово 1…3 кОм.
//
//  ── ДРАЙВЕРНИЙ КАСКАД: КЕРУЮЧИЙ NPN ──────────────────────────────────────
//  Пін ESP32 НЕ керує силовим ключем напряму — між ними стоїть окремий
//  керуючий NPN, і в нього СВОЇ вимоги, бо він теж біполярний:
//
//   • Через його колектор тече ВЕСЬ струм бази PNP (86 мА). Це не «логічний
//     сигнал»: маленький сигнальний транзистор тут не підходить — BC547 із
//     його 100 мА максимуму працював би впритул. Потрібен 2N2222 / BC337 /
//     S8050.
//
//   • R_драйв (пін -> база NPN) задає струм бази САМОГО NPN:
//     Iб = (3.3 В − Uбе) / R_драйв. І тут та сама пастка, що з силовим
//     ключем: замалий струм -> NPN не в насиченні -> на ньому падає не
//     0.2 В, а вольт і більше -> струм бази PNP просідає -> З НАСИЧЕННЯ
//     ВИХОДИТЬ УЖЕ СИЛОВИЙ КЛЮЧ і згорає. Каскадний відмов.
//     Порахуємо: при 1 кОм струм бази NPN лише 2.6 мА, тобто β_форс = 33 —
//     межове насичення. При 470 Ом це 5.5 мА і β_форс = 16 — надійно.
//     Тому тут 470 Ом, а не «десь кілоом», і є перевірка наприкінці блока.
//
//   • Струм із піна (5.5 мА) з великим запасом уміщається в межі ESP32
//     (рекомендовані 20 мА на пін) — це теж перевіряється.
//
//  ЛОГІКА НЕ ІНВЕРТОВАНА — два інвертування взаємно скасовуються:
//    GPIO HIGH -> NPN відкритий -> струм витікає з бази PNP -> PNP ВІДКРИТИЙ;
//    GPIO LOW  -> NPN закритий  -> база підтягнута до емітера -> PNP ЗАКРИТИЙ.
//  Шпаруватість 0 % — безпечний стан.
//
//  !! РЕЗИСТОР 10 кОм З БАЗИ NPN НА ЗЕМЛЮ ОБОВ'ЯЗКОВИЙ — під час скидання й
//  завантаження ESP32 піни у високоімпедансному стані, база «висить», і без
//  нього наведення здатне прочинити ключ. Програмно це не перекрити.
//
//  ── ЩО ЗМІНЮЄ ДРОСЕЛЬ (і чому це не «просто ключ») ───────────────────────
//
//  1. ВИХІДНА НАПРУГА ЗАДАЄТЬСЯ ШПАРУВАТІСТЮ: Uвих ≈ D × Uживл. Це означає,
//     що струм у пакет з'являється ЛИШЕ коли D перевищить Uпакета/Uживл —
//     приблизно 0.6 при 8.4 В від 14 В. Нижче цього порога струму немає
//     взагалі. Тому soft-start «з нуля крок за кроком» тут не працює: до
//     робочої точки довелося б повзти сотні кроків. Регулятор стартує з
//     РОЗРАХОВАНОЇ шпаруватості, за якої вихід дорівнює напрузі пакета, —
//     це точка НУЛЬОВОГО струму, тобто так само безпечно, але одразу.
//
//  2. СТРУМ НЕ РВЕТЬСЯ. Дросель не дає струму стрибнути: у простому ключі
//     пік обмежували б лише різниця напруг і опір кола, а тут наростання
//     обмежене індуктивністю, і через шунт тече майже неперервний струм
//     дроселя з трикутними пульсаціями. Тому «пік» на шунті — це вершина
//     ПУЛЬСАЦІЙ (Iсер + ΔI/2), а не небезпечний кидок. Відсічка за піком
//     лишається як запобіжник (обрив дроселя, пробій ключа, насичення), але
//     її сенс саме такий.
//
//  3. ЧАСТОТА ШІМ МУСИТЬ БУТИ ВИСОКОЮ. Розмах пульсацій
//        ΔI = (Uживл − Uвих) × D / (L × f).
//     На 1 кГц зі 104 мкГн це десятки ампер — перетворювач працював би в
//     глибоко переривчастому режимі. Тому тут десятки кілогерц, а не 1 кГц,
//     як у розрядного ключа (той на резистор, йому дросель ні до чого).
//
//  4. ⚠️ АЛЕ ЗВЕРХУ ЧАСТОТУ ОБМЕЖУЄ САМ КЛЮЧ. Він БІПОЛЯРНИЙ (B772M), і
//     вимикається розсмоктуванням заряду бази — мікросекунди проти
//     наносекунд у MOSFET. Перемикальні втрати ½×Uживл×Iк×tsw×f ростуть
//     прямо з частотою й на 25 кГц уже переважають провідні (525 мВт проти
//     294 при 1 А). Тобто дросель тисне частоту вгору, ключ — униз, і 25 кГц
//     є компромісом. Перевірки наприкінці блока рахують і струм бази, і
//     розсіювання, і не дадуть зібрати прошивку з непосильною парою
//     «частота + профіль струму».
//
//  ── ВИМІРЮВАННЯ СТРУМУ ────────────────────────────────────────────────────
//
//     −клема АКБ ──┬──[ R_шунт 0.5 Ом ]── GND
//                  │
//                  └──[ 1 кОм ]── CHARGE_ISENSE_PIN
//
//  Спад на шунті нічого не ділить (нижнього резистора немає): 1 кОм — лише
//  струмообмеження входу АЦП на випадок кидка. Вхід високоомний, струму через
//  цей резистор практично немає, отже немає й падіння на ньому: на пін
//  приходить РІВНО напруга шунта, I × R_шунт (1 А -> 500 мВ).
//  ⚑ Саме тому 1 кОм не входить у жодну формулу перерахунку (chargeAdcMv()
//  у charge.h) — це не забутий доданок, і «виправляти» його не треба.
//
//  ⚑ Через шунт тече струм ДРОСЕЛЯ в ОБИДВІ фази (у відкритій — від живлення,
//  у закритій — по колу «дросель -> пакет -> шунт -> діод»), тож сигнал тут
//  майже неперервний. Серія відліків усереднює пульсації, а не «рубанину».
//
//  ⚠️ ШУНТ У МІНУСОВОМУ ПРОВОДІ. Під струмом «мінус» пакета піднімається над
//  землею ESP32 на I × 0.5 Ом — при 1.5 А це 750 мВ. Для 1-Wire (DS2433/
//  DS2438) це зсув опорної землі на чверть логічного рівня: читати монітор
//  ПІД СТРУМОМ не можна. Тому DS2438 читається лише на закритому ключі.
//
//  ⚠️ ПОТУЖНІСТЬ ШУНТА: I²R. При 1.5 А це 1.1 Вт — резистор потрібен від 2 Вт.
//  Він же з'їдає 0.75 В із бюджету напруги — це врахуйте, обираючи стелю
//  шпаруватості.
//
//  ── ВИМІРЮВАННЯ НАПРУГИ ───────────────────────────────────────────────────
//
//     +клема ──[ R_верх ]──┬──[ 1 кОм ]── CHARGE_VSENSE_PIN
//                          │
//                    [ R_низ ]
//                          │
//                         GND
//
//  1 кОм і тут лише струмообмеження входу — ділить пара R_верх/R_низ, а на
//  високоомному вході падіння на послідовному резисторі немає (див. вище).
//
//  Точка виміру — ПІСЛЯ дроселя, тобто напруга вже згладжена (і додатково
//  зафіксована самим пакетом). Прямокутника тут немає — на відміну від
//  простого ключа, де на клемі стрибала б напруга живлення.
//  Але під струмом до напруги пакета додається падіння на дротах і на його
//  внутрішньому опорі, тож для ЧЕСНОЇ напруги ключ усе одно коротко
//  закривається (CHARGE_VSENSE_SETTLE_MS) — так вимір лишається однаковим від
//  початку до кінця заряду.
//
//  ⚑ ПРО ЗАПАС ПОДІЛЬНИКА. Номінали — 20к зверху / 10к знизу, коефіцієнт 1:3.
//  У штатній роботі на клемі стоїть напруга ПАКЕТА, і вона лягає з великим
//  запасом: 8.25 В -> 2.75 В на піні при робочій стелі АЦП 3.1 В. Крок АЦП на
//  боці пакета — 2.4 мВ, точність надлишкова.
//
//  ⚠️ Є один НЕШТАТНИЙ випадок: якщо пакет від'єднати посеред заряду, на
//  клемі лишиться напруга ЖИВЛЕННЯ (дроселю нікуди віддавати струм), і
//  подільник дасть 14/3 ≈ 4.67 В — вище абсолютної межі входу 3.6 В.
//  Пін це переживає: вузол подільника має власний опір (20к∥10к = 6.7 кОм)
//  плюс послідовний 1 кОм, тож струм у захисний діод входу — лише ~139 мкА.
//  Саме тому послідовний резистор тут не косметика. Перевірка наприкінці
//  блока рахує цей струм за ВАШИМИ номіналами й не пропустить подільник із
//  замалим власним опором, де той самий випадок дав би вже міліампери.
//
//  ⚑ Раніше тут стояла порада «зменште нижнє плече до 2.7к». Вона була
//  ПОМИЛКОВОЮ: я виходив із того, що зверху 10к (тоді коефіцієнт був би 1:2,
//  і пакет 8.4 В дав би 4.2 В на піні). З реальними 20к зверху міняти нічого
//  не треба — 20к/10к і точніші, і безпечні.
//
//  Заряд ВИМКНЕНО, доки не задано всі три піни нижче.
// ---------------------------------------------------------------------------
// ⚠️ СПАДОК ПОПЕРЕДНЬОЇ СХЕМИ ЗАРЯДУ. До переробки на GPIO32 сидів
//  CHARGE_PIN — enable силового каскаду готової TL494-плати, і скетч
//  найпершим рядком setup() опускав його в LOW («вимкнено, безпечно»).
//  Переробка цей пін прибрала — і разом із ним прибрала й те, що його хтось
//  узагалі налаштовує. Тепер він просто ВИСИТЬ входом, а на платі до нього
//  цілком може лишатись припаяним той самий ланцюг: невизначений рівень на
//  вході чужої схеми — це саме той клас несправності, що з'являється «після
//  переробки» й виглядає як щось стороннє.
//  Тому пін і далі опускається в LOW при старті: якщо на платі до нього нічого
//  не припаяно — дія безкоштовна; якщо припаяно — відновлюється рівно той
//  стан, що був до переробки. Закоментуйте, коли переконаєтесь, що доріжка
//  зрізана.
// ═══ ЯКА САМЕ СИЛОВА ЧАСТИНА ЗАРЯДУ ══════════════════════════════════════
//  Пристроїв два, і зарядне залізо в них РІЗНЕ — не номіналами, а способом
//  керувати й вимірювати:
//
//   • CHARGE_TOP_BUCK  — понижувач, зібраний тут: ШІМ на власний силовий
//     ключ, ВЛАСНИЙ шунт струму, ВЛАСНИЙ подільник напруги, контроль +14 В.
//     Регулятор керує ШПАРУВАТІСТЮ.
//   • CHARGE_TOP_TL494 — готова плата DC/DC на TL494 (попередній пристрій):
//     цифровий enable + аналогова уставка (ШІМ+RC), яка задає ВИХІДНУ
//     НАПРУГУ. Свого шунта немає — струм і напругу бере з ТОГО САМОГО
//     DS2438, що стоїть усередині пакета.
//
//  ⚑ ЯК ЦІ ДВА СВІТИ ЗВЕДЕНІ ДО ОДНОГО РЕГУЛЯТОРА. Увесь верхній рівень
//  (профілі, фази, аварійні відсічки, ETA) написаний у термінах «шпаруватості»
//  — числа, яке регулятор підкручує вгору-вниз, женучись за струмом. Для
//  понижувача це справді відліки ШІМ. Для TL494 «шпаруватість» — це ЦІЛЬОВА
//  ВИХІДНА НАПРУГА В МІЛІВОЛЬТАХ, а перекладом мВ -> напруга керування
//  займається калібрувальна таблиця в найнижчій точці.
//
//  Так зроблено не заради краси. Крива керування TL494 різко нелінійна (20 мВ
//  керування дають 4 В на виході внизу діапазону), і крок регулятора в
//  «сирих» одиницях керування мав би зовсім різний ЕФЕКТ на різних ділянках.
//  У міліволтах виходу крок означає одне й те саме скрізь — а верхній рівень
//  узагалі не мусить знати, яке залізо під ним.
#define CHARGE_TOP_BUCK    0        // власний понижувач: ШІМ + свій шунт
#define CHARGE_TOP_TL494   1        // готова плата DC/DC: enable + уставка

//  ⚑ ЗАЛІЗО ВИБИРАЄ DEVICE_VARIANT (найперший блок файлу) — тут лише
//  наслідок. Окремо перевизначити CHARGE_TOPOLOGY все одно можна (#ifndef
//  нижче це дозволяє), і хостові тести саме так і роблять, щоб прогнати
//  обидві топології. Але для ЗБІРКИ ПРИСТРОЮ правильний шлях один —
//  DEVICE_VARIANT: інакше легко зібрати неіснуючу химеру на кшталт «екран
//  240×280 з власним понижувачем».
#ifndef CHARGE_TOPOLOGY
  #if DEVICE_IS_TL494
    #define CHARGE_TOPOLOGY CHARGE_TOP_TL494
  #else
    #define CHARGE_TOPOLOGY CHARGE_TOP_BUCK
  #endif
#endif

//  Прапорці визначені ОДРАЗУ за вибором — до будь-якого #if, який їх читає:
//  невідомий ідентифікатор у #if препроцесор вважає нулем мовчки.
#define CHARGE_IS_BUCK   ((CHARGE_TOPOLOGY) == (CHARGE_TOP_BUCK))
#define CHARGE_IS_TL494  ((CHARGE_TOPOLOGY) == (CHARGE_TOP_TL494))

#if !(CHARGE_IS_BUCK) && !(CHARGE_IS_TL494)
  #error "CHARGE_TOPOLOGY мусить бути CHARGE_TOP_BUCK або CHARGE_TOP_TL494."
#endif

// ── СИЛОВА ЧАСТИНА, варіант 2: ГОТОВА ПЛАТА DC/DC НА TL494 ───────────────
//  Це залізо ПОПЕРЕДНЬОГО пристрою. Читайте цей блок, лише якщо вибрано
//  CHARGE_TOPOLOGY = CHARGE_TOP_TL494; для власного понижувача він увесь
//  недійсний.
//
//   • CHARGE_TL_EN_PIN  — ЦИФРОВИЙ enable силового каскаду. LOW = безпечно
//     (виходу немає), і саме це виставляється НАЙПЕРШИМ рядком chargeInit().
//   • CHARGE_TL_CTRL_PIN — АНАЛОГОВА напруга керування (ШІМ + RC на платі),
//     що задає РЕГУЛЬОВАНУ вихідну напругу перетворювача.
//
//  ⚑ СВОГО ШУНТА В ЦІЄЇ ПЛАТИ НЕМАЄ, І ЦЕ НЕ ПРОГАЛИНА. Той самий
//  струмовимірювальний резистор DS2438 стоїть УСЕРЕДИНІ пакета послідовно з
//  банками — зарядний струм видно в його регістрі струму. Плата міряти його
//  не мусить: вимірювач уже є, і він точніший за будь-який зовнішній, бо
//  стоїть саме там, де тече струм у банки.
//
//  ⚠️ ЗВІДСИ ЖОРСТКЕ ОБМЕЖЕННЯ ТЕМПУ. Регістр DS2438 читається по 1-Wire, а не
//  з АЦП: це десятки мілісекунд і не частіше разу на секунду. Тому регулятор
//  на цьому залізі ПОВІЛЬНИЙ за побудовою — маленький крок вихідної напруги
//  щоопитування. Швидкий контур, як у понижувача, тут неможливий фізично.
#if CHARGE_IS_TL494
  #define CHARGE_TL_EN_PIN    32   // enable силового каскаду, LOW = вимкнено
  #define CHARGE_TL_CTRL_PIN  26   // аналогове керування вихідною напругою

  // Калібрування: напруга керування (мВ, після RC) -> вихідна напруга (мВ).
  // Виміряно мультиметром на РЕАЛЬНІЙ платі, без АКБ. Точки НЕ рівномірні
  // навмисно: густіше там, де крива крутіша (низ діапазону). Перекалібруйте
  // під СВОЮ плату, якщо міняли компоненти в обв'язці TL494.
  #define CHARGE_CAL_CTRL_MV  {1760, 1770, 1780, 1800, 1860, 1880, 1930}
  #define CHARGE_CAL_OUT_MV   {   0, 2500, 4100, 5200, 7200, 7600, 8600}
  #define CHARGE_CAL_POINTS   7
  #define CHARGE_CAL_OUT_MAX  8600

  // ШІМ, яким робиться аналогова уставка (далі RC-фільтр на платі).
  #define CHARGE_TL_PWM_FREQ  20000
  #define CHARGE_TL_PWM_BITS  11

  // ⚑ ТУТ «ШПАРУВАТІСТЬ» — ЦЕ МІЛІВОЛЬТИ ВИХОДУ. Верхній рівень регулятора
  //  спільний на обидві топології й міряє все у відліках; для цієї плати
  //  один відлік = один мілівольт цільової вихідної напруги. Саму шкалу
  //  задає charge.h (CHARGE_DUTY_FULL/MAX) — вона там і живе для обох
  //  топологій, тож переоголошувати її тут означало б завести другу правду.

  #if (CHARGE_CAL_POINTS) < 2
    #error "CHARGE_CAL_POINTS < 2: за однією точкою інтерполювати нічого."
  #endif
#endif

// ⚑ УСІ П'ЯТЬ ПІНІВ НИЖЧЕ НАЛЕЖАТЬ ВЛАСНОМУ ПОНИЖУВАЧУ, і саме тому вони
//  оголошені під умовою. На платі TL494 їх фізично немає — ні шунта, ні
//  подільників, ні ШІМ на ключ, — а «оголосити про всяк випадок» тут не
//  безкоштовно: за кожним із цих імен стоїть #ifdef, який вмикає цілий
//  шматок логіки (контроль +14 В, свідок насичення, стартова оцінка
//  шпаруватості) та десятки перевірок на компіляції, розрахованих на дросель
//  і шунт. Визначені без заліза, вони не «нічого не робили б» — вони брехали
//  б, причому з виглядом справних перевірок.
//  Дзеркальний бік: GPIO32 у топології TL494 — це РОБОЧИЙ enable силового
//  каскаду (CHARGE_TL_EN_PIN), а не спадок, який тримають у LOW. Двох правд
//  про один пін бути не може, тож перевірка нижче стежить, щоб вони не
//  перетнулись.
#if CHARGE_IS_BUCK
#define CHARGE_LEGACY_EN_PIN 32

#define CHARGE_PWM_PIN    26   // ШІМ на базу NPN (той відкриває PNP-ключ)
#define CHARGE_ISENSE_PIN 35   // АЦП: спад на шунті 0.5 Ом у мінусовому проводі
#define CHARGE_VSENSE_PIN 34   // АЦП: напруга плюсової клеми через подільник
// ⚠️ ЦЕ НОВИЙ ВУЗОЛ. Подільник 68к/10к на GPIO39 треба спершу ЗІБРАТИ. Поки
//  його немає, пін висить у повітрі, читається як ~0 В, і заряд відхиляється з
//  «немає живлення» — тобто перевірка блокує те, що до неї працювало.
//  Розрізнити «давача немає» і «живлення немає» прошивка НЕ МОЖЕ: GPIO34..39
//  не мають внутрішніх підтяжок, тож розгойдати вільний пін і побачити різницю
//  ніяк.
//  ЗАКОМЕНТУЙТЕ цей рядок, доки подільник не зібрано: контроль живлення
//  вимкнеться, розрахунок піде на номінальних CHARGE_SUPPLY_MV, і заряд
//  працюватиме як до появи цієї перевірки.
#define CHARGE_PSU_PIN    39   // АЦП: напруга ЖИВЛЕННЯ (+14 В) через подільник
#endif  // CHARGE_IS_BUCK

// ⚑ ЧОМУ САМЕ ЦІ ПІНИ.
//  35, 34 і 39 — ВХІД-ТІЛЬКИ (input-only) і належать до ADC1. Обидві
//  властивості тут доречні: вихідного драйвера в них немає взагалі, тож
//  вимірювальну лінію фізично неможливо випадково «продавити» назовні; а ADC1,
//  на відміну від ADC2 (GPIO 0,2,4,12-15,25-27), працює при УВІМКНЕНОМУ Wi-Fi —
//  а точка доступу в цьому проєкті активна завжди. На ADC2 вимірювання заряду
//  просто не читалися б.
//  26 звільнився від колишнього аналогового керування TL494-платою — його й
//  узяв ШІМ. Другий ЦАП-пін, GPIO25, зайнятий ЗВУКОМ (BUZZER_DAC_PIN, блок
//  буззера вище): він ніколи не належав заряду, хоч коментар у блоці буззера
//  довго це стверджував. Вільних ЦАП-пінів після цього не лишилось.
//
//  ⚑ ЩО ЩЕ ЛИШИЛОСЬ ВІЛЬНОГО з ADC1 (GPIO32..39) — на майбутнє:
//    • GPIO32 — ADC1_CH4, повноцінний пін (вхід/вихід). ⚠️ ЗАЙНЯТИЙ УМОВНО:
//      це колишній enable силового каскаду, і прошивка утримує його в LOW
//      (CHARGE_LEGACY_EN_PIN) — доки не переконаєтесь, що доріжку зрізано;
//    • GPIO36 (VP) — ADC1_CH0, теж вхід-тільки, повний аналог 39;
//    • GPIO37/38 фізично існують, але на переважній більшості модулів
//      ESP32-WROOM НЕ ВИВЕДЕНІ на гребінку — на них розраховувати не можна.
//  Зайняті з ADC1: 33 (драбинка кнопок), 34, 35 і тепер 39.
//  Для контролю живлення обрано саме 39, а не 32: 39 годиться ВИКЛЮЧНО як
//  аналоговий вхід, тоді як 32 уміє ще й бути виходом — витрачати його на
//  вимір означало б віддати єдиний універсальний пін, що лишився.

// ── КОНТРОЛЬ ЖИВЛЕННЯ +14 В ───────────────────────────────────────────────
//  Навіщо окремий вимір, якщо напруга живлення й так записана константою.
//  Саме тому й потрібен: CHARGE_SUPPLY_MV — це ПРИПУЩЕННЯ, на якому тримається
//  весь розрахунок (стартова шпаруватість D ≈ Uпак/Uживл, розмах пульсацій,
//  струм бази ключа, стеля шпаруватості). Якщо припущення не збігається з
//  дійсністю, прошивка про це не дізнається — вона просто мовчки регулюватиме
//  не туди:
//    • блока живлення немає взагалі -> заряд «іде» зі шпаруватістю в стелю й
//      нульовим струмом, і виглядає це як несправність пакета;
//    • стоїть 12-вольтовий блок -> струму бази ключа менше, стелі D може не
//      вистачити, щоб дотягнутись до цілі, і заряд упреться в стелю часу;
//    • стоїть 19-вольтовий від ноутбука -> ключ і пакет отримують помітно
//      більше, ніж закладено в усі перевірки вище.
//  Тому напруга живлення тепер ВИМІРЮЄТЬСЯ, а константа лишається запасним
//  значенням на випадок, коли пін не заданий.
//
//  Подільник — того ж стилю, що й на плюсовій клемі: верхнє плече, нижнє на
//  землю, і 1 кОм у сам пін як струмообмеження.
//    68к/10к: 14 В -> 1.79 В на піні, 20 В -> 2.56 В (усе ще в лінійній зоні).
//  Верхню межу взято з запасом саме для того, щоб ПОМИЛКОВИЙ блок на 19 В
//  читався числом, а не «залипав» на 4095.
#define CHARGE_PSU_R_TOP        68000
#define CHARGE_PSU_R_BOT        10000
#define CHARGE_PSU_R_SERIES     1000
// Найвища напруга живлення, яку прошивка мусить ЧИТАТИ ТОЧНО, мВ (вище —
// показання можуть залипати, але то вже однозначна аварія).
#define CHARGE_PSU_MAX_READ_MV  20000

//  ── КАЛІБРУВАННЯ КАНАЛУ ЖИВЛЕННЯ, тисячні (1000 = без правки) ─────────────
//  ⚠️ ЦЕ НЕ НОМІНАЛ І НЕ ФІЗИЧНА ВЕЛИЧИНА. Це поправка на систематичну
//  похибку ВСЬОГО тракту «дільник -> АЦП -> мілівольти» на КОНКРЕТНОМУ
//  екземплярі плати. Номінали вище лишаються справжніми — на них тримаються
//  розрахунки діапазону й струму в захисний діод, і брехати в них не можна.
//
//  ЗВІДКИ ВЗЯЛОСЬ ЧИСЛО. Заміри власника на живій платі:
//    • блок живлення 14.3 В -> прошивка показувала 12.4 В;
//    • на самому GPIO39 мультиметр показав 1.81 В при блоці 14.4 В,
//      тобто дільник справний (ідеал 1.85 В — розбіжність у межах допуску
//      резисторів), і 1 кОм нічого не роняє: напруга доходить до ноги цілою.
//  Отже губиться воно ВЖЕ ВСЕРЕДИНІ АЦП: прошивка «побачила» 1.59 В там, де
//  на нозі було 1.80. Причина відома й не є несправністю — пряма модель
//  «0..CHARGE_ADC_FULL_MV лінійно» не описує АЦП ESP32 на аттенюації 11 дБ:
//  у неї і власна нелінійність, і розкид опорної напруги між чипами (саме
//  заради нього існує калібрування в eFuse, якого тут свідомо не беруть —
//  див. коментар над chargeAdcMv()). Кінцевий множник 14300/12400 = 1.153
//  вбирає обидві похибки — і АЦП, і допуск резисторів.
//
//  ⚠️ ЧОГО ЦЕ НЕ ЛІКУЄ. Похибка АЦП майже напевно спільна для всіх трьох
//  каналів, а виправлено тут ЛИШЕ живлення — на прохання власника й тому, що
//  для інших каналів вимірів поки немає. Канал напруги пакета працює в іншій
//  точці шкали (2.75 В проти 1.8 В), а крива АЦП гнеться, тож переносити цей
//  самий множник на нього НАВМАННЯ не можна: ціль заряду й аварійна відсічка
//  за перенапругою тримаються саме на ньому. Коли з'являться заміри клем
//  мультиметром проти показань — з'явиться й окрема поправка для нього.
//
//  ЯК ПЕРЕРАХУВАТИ ПІД СВОЮ ПЛАТУ: подайте відомий блок живлення, подивіться
//  psuMv у http://<адреса>/api/charge (там мілівольти, без округлення) і
//  візьміть CAL = 1000 × справжня_напруга / psuMv. Значення 1000 вимикає
//  поправку повністю.
#define CHARGE_PSU_CAL_X1000    1153

//  ── ПОРОГИ ────────────────────────────────────────────────────────────────
//  Нижче цього вважаємо, що блока живлення НЕМАЄ взагалі.
//  ⚠️ Нуля тут може й не бути. Якщо пакет під'єднано, а блок вимкнено, пакет
//  підживлює шину живлення ЧЕРЕЗ ПЕРЕХІД БАЗА-КОЛЕКТОР силового PNP (база
//  притягнута до емітера запираючим резистором, а на колекторі стоїть напруга
//  пакета через дросель) — на шині опиняється Uпак мінус діодне падіння.
//  Тому поріг «немає живлення» піднято до 6 В: усе, що нижче найнижчого
//  розрядженого пакета, живленням бути не може.
#define CHARGE_PSU_ABSENT_MV    6000
//  Робочий діапазон. Нижче мінімуму — «не той блок живлення / напруга
//  занижена»: заряд не стартує, а той, що йде, зупиняється.
#define CHARGE_PSU_MIN_MV       12500
//  Вище максимуму — теж не той блок (типово 19 В від ноутбука).
//  ⚑ Обидва пороги ПІДТВЕРДЖЕНІ ВЛАСНИКОМ, це не оцінка «на око». Верхній
//  впливає не лише на діагностику: саме він задає CHARGE_NPN_BASE_OHM, бо
//  струм драйвера росте разом із живленням (при 16 В — 124 мА, звідси 390 Ом;
//  при 15 В вистачило б і 470). Опустите поріг — перевірка внизу блока
//  дозволить і більший номінал, але допуск за живленням стане вужчим.
#define CHARGE_PSU_MAX_MV       16000
//  ГІСТЕРЕЗИС порогів, мВ. Потрібен саме тому, що пороги — це стіна, а вимір
//  має і шум АЦП (на ESP32 це десятки мВ у перерахунку на живлення), і крок
//  квантування (~6 мВ тут). Блок живлення, що стоїть рівно на 12.5 В, без
//  гістерезису блимав би «помилка / норма / помилка» кожні дві секунди — і
//  виглядало б це як дефект прошивки, а не як межовий блок.
//  Знімається ознака несправності лише коли напруга повернулась у діапазон
//  ІЗ ЗАПАСОМ; піднімається — за чистим порогом, без пом'якшення.
#define CHARGE_PSU_HYST_MV      200
//  Скільки відліків усереднювати за один вимір живлення. Шина живлення —
//  найшумніше місце в пристрої (на ній сидить ключ, що комутує ампери), тож
//  одиничний відлік тут не показник.
#define CHARGE_PSU_SAMPLES      16
//  Скільки опитувань поспіль напруга має бути поза діапазоном, щоб зупинити
//  заряд. Одиничний провал — це просадка на кидку струму, а не аварія.
#define CHARGE_PSU_BAD_POLLS    3
//  Період БЛИМАННЯ напису на сторінці помилки живлення, мс. Блимання тут не
//  прикраса: статичний червоний екран за хвилину перестає читатись як тривога
//  (око до нього звикає), а рухомий напис лишається помітним боковим зором —
//  саме тому аварійна індикація в техніці завжди рухома.
#define DISPLAY_PSU_BLINK_MS    500UL
//  Як часто перевіряти живлення В СПОКОЇ (коли заряд не йде), мс. Тут поспіху
//  немає — блок живлення не з'являється й не зникає щосекунди, — але й тягнути
//  не варто: користувач мусить побачити помилку, доки ще стоїть біля пристрою.
#define CHARGE_PSU_IDLE_MS      2000UL

// ── НОМІНАЛИ ВИМІРЮВАЛЬНОГО КОЛА ──────────────────────────────────────────
// Шунт струму, мОм. 0.5 Ом = 500 мОм.
#define CHARGE_SHUNT_MOHM       500
// Паспортна ПОТУЖНІСТЬ шунта, мВт. Досі це число жило лише в README («потрібен
// резистор від 2 Вт»), а перевірити його не могло ніщо. Тепер на нього
// спирається розрахунок теплового імпульсу в пробудженні (див. хостовий тест,
// розділ 24): найгірший стрибок струму в мить, коли контролер пакета замикає
// ключ, перевіряється саме проти цієї величини.
#define CHARGE_SHUNT_MW         2000
// Подільник напруги: верхнє плече (до плюсової клеми) і нижнє (на землю), Ом.
#define CHARGE_VSENSE_R_TOP     20000
#define CHARGE_VSENSE_R_BOT     10000
// Послідовний резистор перед піном — струмообмеження входу АЦП. На показання
// не впливає (вхід високоомний), але саме він рятує пін у нештатному випадку
// нижче, тож це робочий параметр, а не довідка.
#define CHARGE_VSENSE_R_SERIES  1000
// НОМІНАЛЬНА напруга живлення силової частини, мВ. Від неї залежить майже все:
// Uвих ≈ D × Uживл, від неї ж рахуються запас подільника, розмах пульсацій
// дроселя й струм бази ключа.
//  ⚑ У РОБОТІ це значення більше не використовується наосліп: напруга
//  живлення ВИМІРЮЄТЬСЯ на CHARGE_PSU_PIN, і регулятор бере живий вимір
//  (chargeSupplyMv() у charge.h). Константа лишається для двох речей:
//    • КОМПІЛЯЦІЙНИХ перевірок нижче — вони рахують найгірший випадок на
//      номіналі, бо жодного виміру на етапі збірки, звісно, немає;
//    • запасного значення, якщо CHARGE_PSU_PIN не заданий (плата без
//      подільника живлення).
//  Тобто це «яким живлення має бути», а не «яке воно є».
#define CHARGE_SUPPLY_MV        14000

// ── СИЛОВІ КОМПОНЕНТИ ПОНИЖУВАЧА ──────────────────────────────────────────
// Індуктивність дроселя, мкГн. Визначає розмах пульсацій струму:
//   ΔI = (Uживл − Uвих) × D / (L × f).
// Якщо точне значення невідоме — візьміть із маркування; від нього залежить
// перевірка «чи не завеликі пульсації» наприкінці блока.
#define CHARGE_L_UH             104

// ═══ ЯКИЙ САМЕ СИЛОВИЙ КЛЮЧ СТОЇТЬ ═══════════════════════════════════════
//  ⚠️ Стосується ЛИШЕ CHARGE_TOP_BUCK: у готової плати TL494 силовий ключ
//  свій, розпаяний виробником, і жоден із розрахунків нижче до нього не
//  застосовний.
//  Верхній ключ понижувача можна зібрати на двох різних приладах, і схема
//  обв'язки в них СПІЛЬНА (керуючий NPN тягне вниз, підтяжка на +14 В тримає
//  закритим), а фізика — цілком різна:
//
//   • БІПОЛЯРНИЙ PNP (B772M) керується СТРУМОМ. R_drive задає струм бази,
//     насичення тримається, поки Iб >= Iк/β. Провідні втрати — Uке_нас × Iк.
//     Драйвер постійно палить майже ват просто на відкривання ключа.
//   • P-канальний MOSFET (NTD2955G) керується НАПРУГОЮ. Затвор струму не
//     споживає, і R_drive разом із підтяжкою утворює звичайний ДІЛЬНИК, який
//     задає напругу на затворі. Провідні втрати — I²×RDS(on).
//
//  ⚠️ ЦЕ НЕ КОСМЕТИЧНА РІЗНИЦЯ. Для біполярника R_drive рахується з потрібного
//  СТРУМУ бази, для польового — з потрібної НАПРУГИ затвора. Ті самі 120 Ом
//  означають у двох випадках зовсім різні речі, і майже всі перевірки нижче
//  розгалужуються за цим макросом. Тому тип ключа — окрема константа, а не
//  «просто підправте номінали».
#define CHARGE_SW_BJT_PNP  0        // біполярний PNP (B772M)
#define CHARGE_SW_PMOS     1        // P-канальний MOSFET (NTD2955G)

#define CHARGE_SWITCH_TYPE CHARGE_SW_PMOS

//  Зручні прапорці. Визначені ОДРАЗУ за вибором — до будь-якого #if, який їх
//  читає: невідомий ідентифікатор у #if препроцесор вважає нулем мовчки, і
//  саме на цьому цей файл уже двічі горів.
#define CHARGE_SW_IS_BJT  ((CHARGE_SWITCH_TYPE) == (CHARGE_SW_BJT_PNP))
#define CHARGE_SW_IS_MOS  ((CHARGE_SWITCH_TYPE) == (CHARGE_SW_PMOS))

#if !(CHARGE_SW_IS_BJT) && !(CHARGE_SW_IS_MOS)
  #error "CHARGE_SWITCH_TYPE мусить бути CHARGE_SW_BJT_PNP або CHARGE_SW_PMOS."
#endif

// ── СИЛОВИЙ КЛЮЧ, варіант 2: P-канальний MOSFET (NTD2955G) ───────────────
//  Паспортні межі — з даташита. Як і в біполярника, вони не довідкові: за
//  ними рахуються перевірки наприкінці блока.
#define CHARGE_MOS_RDSON_MOHM    180    // RDS(on) max, мОм
//  ⚑ ПРИ ЯКІЙ НАПРУЗІ ЗАТВОРА паспорт дає цей опір. Число не менш важливе за
//  сам опір: NTD2955G — НЕ логічного рівня, його 0.18 Ом нормовані при
//  VGS = −10 В. Дасте на затвор менше — опір буде більший за паспортний, і
//  провідні втрати підуть угору. Перевірка нижче за цим стежить.
#define CHARGE_MOS_RDSON_VGS_MV  10000
#define CHARGE_MOS_VGSTH_MAX_MV  4000   // VGS(th) max — вище нього ще ЗАКРИТИЙ
#define CHARGE_MOS_VGS_MAX_MV    20000  // абсолютна межа затвор-витік
#define CHARGE_MOS_VDS_MAX_MV    60000  // абсолютна межа стік-витік
#define CHARGE_MOS_ID_MAX_MA     12000  // Id max, мА
#define CHARGE_MOS_PD_MW         55000  // Pd max, мВт (корпус при 25 °C)
#define CHARGE_MOS_QG_NC         15     // повний заряд затвора, нКл
#define CHARGE_MOS_COSS_PF       150    // вихідна ємність, пФ
#define CHARGE_MOS_TR_NS         45     // паспортний час наростання (довідково:
                                        // реальний час задає НАШ драйвер, а не він)

// ── СИЛОВИЙ КЛЮЧ, варіант 1: біполярний PNP (за замовчуванням B772M) ─────
//  Паспортні межі — з даташита. Вони НЕ довідкові: за ними рахуються
//  перевірки наприкінці блока, які не дадуть зібрати прошивку з профілем
//  струму, за якого ключ вигорить.
#define CHARGE_BJT_IC_MAX_MA    3000   // Ic max, мА (B772M: 3 А)
#define CHARGE_BJT_PC_MW        1250   // Pc max, мВт (B772M: 1.25 Вт)
// Напруга насичення колектор-емітер при робочому струмі, мВ. Саме вона, а не
// опір каналу, дає провідні втрати: P = Uке_нас × Iк × D.
#define CHARGE_BJT_VCE_SAT_MV   500
// Форсований коефіцієнт передачі: у скільки разів струм колектора більший за
// струм бази. Для НАДІЙНОГО насичення беруть 10…20 (а не паспортний hFE:
// той міряють у лінійному режимі й на межі насичення він не тримається).
#define CHARGE_BJT_HFE_FORCED   20
// Сумарний час перемикання (розсмоктування заряду бази + спад), нс.
//  ⚠️ Це головна відмінність від MOSFET. Біполярник у насиченні накопичує
//  заряд у базі, і з РЕЗИСТИВНИМ вимиканням розсмоктування триває
//  мікросекунди. 3000 нс — обережна оцінка для B772M без активного
//  запирання; із запираючим резистором база-емітер буде менше.
#define CHARGE_BJT_TSW_NS       3000

// Резистор, що ЗАДАЄ СТРУМ БАЗИ силового ключа (між колектором NPN і базою
// PNP), Ом. Насичення мусить триматись на ВЕРШИНІ ПУЛЬСАЦІЙ, а не на
// середньому струмі, інакше ключ виходить із насичення на кожному горбі.
//
// ⚠️⚠️ НА ПЛАТІ ЗАРАЗ СТОЇТЬ 1 кОм — ЦЕ ТРЕБА ЗАМІНИТИ НА 120 Ом.
//  Причина не в запасі, а в тому, що з 1 кОм заряд фізично не працює:
//    Iб = (14 − 0.9 − 0.2)/1000 − витік у підтяжку 0.9 мА = 12 мА.
//  При β_форс 20 це стеля колектора 240 мА, а з урахуванням пульсацій
//  дроселя (пік удвічі-втричі вищий за середнє) СЕРЕДНІЙ струм заряду вийшов
//  би ~22 мА. Пакет 2150 мА·год заряджався б ЧОТИРИ ДОБИ. А якщо всупереч
//  цьому виставити більший струм — ключ не насититься, лишиться в лінійному
//  режимі й згорить за секунди.
//
//  ⚑ ЧОМУ 120 Ом, А НЕ 150. Рахувати треба не на номінальні 14 В, а на НИЖНЮ
//  межу допуску живлення (CHARGE_PSU_MIN_MV = 12.5 В): струм бази падає разом
//  із живленням, а пік струму дроселя від нього майже не залежить.
//    150 Ом: 85 мА при 14 В, але лише 75 мА при 12.5 В — а на пік 1651 мА
//            потрібно 82 мА. Тобто просілий (та все ще ДОПУСТИМИЙ) блок
//            живлення виводив би ключ із насичення.
//    120 Ом: 94 мА при 12.5 В, 106 мА при 14 В, 123 мА при 16 В — насичення
//            тримається на всьому діапазоні, який прошивка приймає.
//  Перевірки наприкінці блока рахують ОБИДВІ межі діапазону, а не лише
//  номінал, і не дадуть зібрати прошивку, доки номінал не відповідає профілю.
//  Якщо 120 Ом дістати важко: 150 Ом лишається придатним, якщо знизити
//  CHARGE_MA_80 до 700 мА (пік 1351 мА -> потрібно 67 мА). Це на 40 % довший
//  заряд — вибір за власником, перевірки приймуть обидва варіанти.
//
//  ⚠️ Це ОДНА з ДВОХ замін; друга — 20 кОм -> 390 Ом у базі керуючого NPN
//  (див. CHARGE_NPN_BASE_OHM нижче). Поодинці жодна з них нічого не дає:
//  замінити тільки цей резистор означає попросити в NPN 106 мА, яких він при
//  20 кОм у базі віддати не може, і ключ однаково лишиться поза насиченням.
#define CHARGE_BASE_DRIVE_OHM   120
//  ⚠️ Розсіює Iб²×R×D — при 106 мА це ~0.83 Вт, тож резистор брати 2 Вт.
//  Майже ват, спалений просто на відкривання ключа, — це і є ціна БІПОЛЯРНОГО
//  верхнього ключа на такому струмі; з P-канальним MOSFET цієї статті витрат
//  не було б узагалі (затвор струму не споживає).
//  І NPN мусить пропускати ці 106 мА (при 16 В — 123 мА): BC547 (100 мА max)
//  не годиться, потрібен 2N2222 / BC337 / S8050.

// Падіння на переході база-емітер PNP і на насиченому NPN, мВ — для розрахунку
// струму бази.
#define CHARGE_BJT_VBE_MV       900
#define CHARGE_NPN_VCE_SAT_MV   200

// Запираючий резистор база-емітер PNP, Ом — тримає ключ закритим у спокої й
// прискорює розсмоктування заряду бази при вимиканні.
//  ⚑ Він же ВІДБИРАЄ частину струму драйвера: поки ключ відкритий, через
//  нього тече Uбе/R_підт (при 1 кОм — 0.9 мА), і ці міліампери до бази вже не
//  доходять. На 1 кОм це 1 % від 86 мА — дрібниця, але у формулі струму бази
//  нижче враховано, бо на дрібнішій підтяжці витік став би відчутним.
#define CHARGE_BASE_PULLUP_OHM  1000

// ── ДРАЙВЕРНИЙ КАСКАД: керуючий NPN між піном і базою силового PNP ────────
//  Резистор від піна до бази NPN.
//
//  ⚠️⚠️ НА ПЛАТІ ЗАРАЗ СТОЇТЬ 20 кОм — ЦЕ ТРЕБА ЗАМІНИТИ НА 390 Ом.
//  20 кОм — типовий номінал, коли NPN просто вмикає світлодіод чи реле; тут
//  через його колектор тече ВЕСЬ струм бази силового ключа, і арифметика
//  зовсім інша:
//     Iб(NPN) = (3.3 − 0.7)/20000 = 0.13 мА.
//  Це стеля колектора 2.6 мА при β_форс 20 — тобто керуючий каскад сам не
//  здатен віддати навіть тих 12.9 мА, які тече через нинішній базовий
//  резистор 1 кОм (β_форс вийшов би 99 — «як пощастить із партією»), не
//  кажучи вже про 106 мА після його заміни на 120 Ом.
//  Відмова КАСКАДНА і завжди в один бік: NPN не насичується -> на ньому
//  лишається вольт замість 0.2 В -> струм бази PNP просідає -> з насичення
//  виходить уже СИЛОВИЙ ключ -> B772M працює в лінійному режимі під 14 В і
//  згорає за секунди.
//
//  ⚑ ЧОМУ 390 Ом, А НЕ 470. Тут найгірший випадок — ВЕРХНЯ межа допуску
//  живлення (CHARGE_PSU_MAX_MV = 16 В): чим вище живлення, тим більший струм
//  драйвера мусить пропустити NPN (при 16 В і 120 Ом це 124 мА, тобто 6.2 мА
//  в базу при β_форс 20). 470 Ом дають 5.5 мА — вистачає рівно на номінальні
//  14 В і вже ні на що більше. 390 Ом дають 6.7 мА, і з піна це все ще лише
//  третина від дозволених 20 мА.
#define CHARGE_NPN_BASE_OHM     390
#define CHARGE_NPN_VBE_MV       700
// Форсований коефіцієнт для керуючого NPN. 20 — надійне насичення для
// сигнального транзистора з hFE >= 100 на цьому струмі.
#define CHARGE_NPN_HFE_FORCED   20
// Паспортний Ic max керуючого NPN, мА. За замовчуванням — 2N2222/BC337/S8050
// (усі 0.6…0.8 А). Поставите BC547 (100 мА) — перевірка нижче це зловить.
#define CHARGE_NPN_IC_MAX_MA    600

// ── ЩО САМЕ СТОЇТЬ НА ПЛАТІ ЗАРАЗ (для звіту при старті) ──────────────────
//  Два номінали вище — це те, що ПОТРІБНО, а не те, що є. Щоб різниця не
//  жила лише в коментарях, фактичні номінали записані окремими макросами:
//  прошивка друкує при старті обидві колонки, і в чому саме плата не
//  відповідає розрахунку, видно з журналу, а не з пам'яті.
//  Після перепайки поставте тут ті самі числа, що й вище, — рядок «ПЛАТА НЕ
//  ДООПРАЦЬОВАНА» зникне.
#define CHARGE_BASE_DRIVE_ASBUILT_OHM  1000
#define CHARGE_NPN_BASE_ASBUILT_OHM    20000
// Напруга логічної одиниці на піні, мВ, і безпечний струм із піна ESP32.
#define CHARGE_GPIO_MV          3300
#define CHARGE_GPIO_UA_MAX      20000
// Робоча стеля входу АЦП ESP32, мВ (атенюація 11 дБ). Вище — показання
// «залипають» на 4095.
#define CHARGE_ADC_MAX_MV       3100
// Абсолютна межа напруги на піні (VDD+0.3 В). Вище неї вмикаються захисні
// діоди входу; саме по собі це не вирок — питання в СТРУМІ через них.
#define CHARGE_ADC_ABS_MAX_MV   3600
// Скільки струму в захисний діод входу вважаємо безпечним, мкА.
#define CHARGE_ADC_CLAMP_UA_MAX 1000
// Найвища напруга на плюсовій клемі, яку прошивка мусить ЧИТАТИ ТОЧНО, мВ.
//  Це НЕ напруга живлення: у штатній роботі на клемі стоїть напруга ПАКЕТА, і
//  найвище, що треба розрізняти, — аварійна межа (ціль + запас) із запасом
//  зверху. Вище цього показання можуть «залипати» — то вже аварія, і вона
//  однаково спрацює.
#define CHARGE_VSENSE_MAX_READ_MV 9000
// Опорна шкала для перерахунку відліку в мілівольти. Свідомо analogRead() і
// проста пропорція, а НЕ analogReadMilliVolts(): остання спирається на
// апаратне калібрування в eFuse, якого на частині модулів немає, і там вона
// падає — на цьому вже горіли кнопки (див. блок MENU_BTN_ADC_* вище).
#define CHARGE_ADC_FULL_MV      3300
#define CHARGE_ADC_MAX_RAW      4095

// Скільки відліків усереднювати за один вимір. Через шунт тече струм ДРОСЕЛЯ
// з трикутними пульсаціями (а не «рубанина» 0/пік, як було б у простого
// ключа), тож серія усереднює саме пульсації й дає середній струм у пакет —
// те, що потрібно і регулятору, і обліку мА·год. При 25 кГц період — 40 мкс,
// а analogRead() коштує десятки мікросекунд, тож 128 відліків надійно
// перекривають кілька повних періодів. Заразом із серії беремо найбільший
// відлік — вершину пульсацій.
#define CHARGE_ADC_SAMPLES      128

// ── СТРУМ: профіль уставки за відсотком заряду (за напругою пакета, шкала
//    BATTERY_EMPTY_MV..BATTERY_FULL_MV = 0..100 %, impresPercentFromMv) ──────
//    Точки перегину задані для ЦІЛІ 100 %. Якщо користувач обирає ЦІЛЬ НИЖЧУ
//    (див. CHARGE_TARGET_PRESETS_PCT у charge.h) — ВСІ точки масштабуються
//    пропорційно (chargeSetpointMaForPct), тож форма профілю (розгін ->
//    крейсерський струм -> плавний спад перед самим кінцем) зберігається.
//    0 %      -> CHARGE_MA_START
//    0..10 %  -> лінійно до CHARGE_MA_10
//    10..50 % -> лінійно до CHARGE_MA_50
//    50..80 % -> лінійно до CHARGE_MA_80
//    80..90 % -> тримається на CHARGE_MA_80 (плато)
//    90 %     -> СТУПІНЧАСТО падає до CHARGE_MA_TAPER і тримається до цілі
//  ⚠️ СТЕЛЮ ПРОФІЛЮ ЗАДАЄ НЕ ПАКЕТ, А СИЛОВА ЧАСТИНА — і саме тому вона
//  РІЗНА у двох пристроїв.
//   • ВЛАСНИЙ ПОНИЖУВАЧ: стелю визначає ЙОГО ключ, і рахує її прошивка.
//     1500 мА на B772M — це 1.23 Вт при Pc max 1.25 Вт, тобто рівно на межі,
//     ще й на межі для корпусу при 25 °C. Тому там профіль опущено до 1000 мА
//     (0.82 Вт, 66 % від Pc), а перевірка наприкінці блока рахує розсіювання
//     за ВАШИМИ числами й не дасть зібрати прошивку з непосильним профілем.
//   • ПЛАТА TL494: силовий ключ розпаяв ВИРОБНИК, і жоден із тих розрахунків
//     до нього не застосовний. Профіль 500/1000/1500 мА — той, на якому
//     пристрій працює з самого початку; опустити його «за компанію» означало
//     б без причини зробити заряд повільнішим за вже перевірений на живих
//     пакетах.
#define CHARGE_MA_START   200
#if DEVICE_IS_TL494
  #define CHARGE_MA_10      500
  #define CHARGE_MA_50      1000
  #define CHARGE_MA_80      1500
#else
  #define CHARGE_MA_10      400
  #define CHARGE_MA_50      700
  #define CHARGE_MA_80      1000
#endif
#define CHARGE_MA_TAPER   100

// ── РУЧНЕ РЕГУЛЮВАННЯ СТРУМУ ЗАРЯДУ ───────────────────────────────────────
//  Профіль вище — це «як правильно за замовчуванням». Але бувають випадки, коли
//  струм треба задати руками: перевірка ключа на малому струмі, щадний режим
//  для пакета з підозрілими банками, повторюваний режим для порівняння двох
//  пакетів між собою.
//
//  ⚑ ВЕРХНЯ МЕЖА — НЕ ДОВІЛЬНЕ ЧИСЛО. Увесь тепловий розрахунок силової
//  частини в цьому файлі (розсіювання на ключі, запас шунта, вибір дроселя)
//  зроблено для CHARGE_MA_80 — найбільшого струму профілю. Дозволити руками
//  більше означало б тихо вивести залізо за межі, під які його рахували, і
//  жоден із тутешніх #error про це не дізнався б. Тому стеля ручного режиму
//  дорівнює стелі профілю, і перевірка нижче стежить, щоб так і лишалось.
//
//  Нижня межа — не «скільки завгодно мало»: під деяким струмом регулятор уже
//  не тримає уставку (шпаруватість упирається в підлогу), і заряд перетворюється
//  на імітацію. 50 мА — приблизно C/50 для цих пакетів, тобто ще осмислений
//  підтримувальний струм.
#define CHARGE_MANUAL_MA_MIN   50
#define CHARGE_MANUAL_MA_MAX   (CHARGE_MA_80)

// Мінімальна дозволена ЦІЛЬ заряду, % — нижче не пускаємо: занадто малий
// заряд не має сенсу, і на дуже малих цілях перерахунок точок перегину
// профілю (chargeSetpointMaForPct) вироджується (надто вузькі відрізки).
#define CHARGE_TARGET_PCT_MIN 50

// ── ПОРІГ ПЕРЕХОДУ НА ДОЗАРЯД МАЛИМ СТРУМОМ, % ────────────────────────────
//  Від цього відсотка уставка ступінчасто падає з CHARGE_MA_80 до
//  CHARGE_MA_TAPER і тримається такою до самої цілі.
//
//  ⚑ БУЛО 95 %, СТАЛО 90 % — на вимогу власника, і причина фізична, а не
//  «щоб довше». Останні відсотки ємності набираються при напрузі, близькій до
//  кінцевої, і саме там струм найшкідливіший: він піднімає напругу на
//  внутрішньому опорі пакета, тож банки бачать більше, ніж показує клема, і
//  заряд фактично заходить за межу. Що раніше перейти на малий струм, то
//  ближче виміряна напруга до справжньої напруги банок.
//
//  Ціна — час: відрізок 90…100 % тепер іде на 100 мА замість 1000, тобто
//  довше. Це свідомий обмін ресурсу пакета на тривалість заряду.
#define CHARGE_TAPER_PCT  90

// Наскільки нижче порога треба впасти, щоб ПОВЕРНУТИСЬ із дозаряду на
// крейсерський струм, відсотків.
//  ⚑ Без цього уставка брязкає. Відсоток рахується з напруги, а напруга на
//  межі природно гуляє на десятки мілівольт (пакет релаксує після закриття
//  ключа), тож 8046…8079 мВ дають то 89 %, то 91 %. У журналі з пристрою це
//  виглядало як стрибки уставки 1000 <-> 100 мА ЩОСЕКУНДИ — десятикратні
//  гойдалки струму на пакеті й на ключі.
//  Два відсотки — це ~30 мВ у верхній частині кривої 2S: помітно більше за шум виміру
//  й помітно менше за будь-яку осмислену ділянку профілю.
#define CHARGE_TAPER_HYST_PCT 2

// Поріг переходу індикатора на часте блимання (LED_CHARGE_TAPER), %.
//  Раніше він був НАВМИСНО нижчий за поріг профілю (90 проти 95), щоб
//  «майже готово» впадало в очі трохи раніше за сам спад струму. Тепер вони
//  збіглися — і це навіть чесніше: індикатор перемикається рівно тоді, коли
//  режим справді змінюється. Перевірка нижче не дасть їм розійтись у ІНШИЙ
//  бік (індикатор пізніше за спад), бо це означало б, що пристрій показує
//  «крейсерський заряд», уже дозаряджаючи малим струмом.
#define CHARGE_LED_TAPER_PCT 90

// ── ЦІЛЬ ЗАРЯДУ ЗА НАПРУГОЮ, мВ ───────────────────────────────────────────
//  Стеля, до якої заряджаємо при цілі «100 %».
//
//  ⚑ ЦЕ БІЛЬШЕ НЕ ДОРІВНЮЄ BATTERY_FULL_MV, і розчеплення тут навмисне.
//  BATTERY_FULL_MV (8400 = 4.20 В/банку) — це «100 %» ШКАЛИ ПАЛИВОМІРА: за нею рахуються
//  відсотки скрізь, від головного екрана до розряду й записів у пам'ять
//  пакета. CHARGE_TARGET_MV — це те, ДО ЧОГО МИ ЗАРЯДЖАЄМО, і власник просив
//  зупиняти повний заряд на 8.2 В.
//
//  ⚠️ НАСЛІДОК, ЯКИЙ ТРЕБА ЗНАТИ ЗАЗДАЛЕГІДЬ: наприкінці успішного заряду
//  паливомір покаже не 100 %, а рівно 90 %. Це НЕ збій і не недозаряд — це
//  просто правда: 8200 мВ на 2S це 4.10 В на банку, а 4.10 В за кривою літію
//  і є 90 % заряду. Тримати банки біля самої стелі 4.20 В — головна причина
//  прискореної деградації; недобрана десята частина ємності віддає помітно
//  більший ресурс.
//
//  (Раніше та сама зупинка показувала 97 % — але лише тому, що шкала була
//  лінійна й верх у неї стояв на 8.25 В. Число було приємніше, а правди в
//  ньому було менше.)
//
//  Якщо колись знадобиться, щоб наприкінці заряду було рівно 100 %, міняти
//  треба НЕ це число, а саму ціль: підняти CHARGE_TARGET_MV до 8400 мВ,
//  тобто заряджати до 4.20 В на банку — ціною ресурсу.
#define CHARGE_TARGET_MV    8200

// АВАРІЙНА стеля напруги ПОНАД ціль ЦЬОГО СЕАНСУ — запобіжник від «контур
// розігнався». Рахується в рантаймі як g_chg.targetMv + це значення.
#define CHARGE_HARD_MAX_HEADROOM_MV 100

// Відсічка за температурою пакета (DS2438), °C.
#define CHARGE_MAX_TEMP_C   45

// ===========================================================================
//  РОЗУМНИЙ (АВТОМАТИЧНИЙ) ПРОФІЛЬ ДЛЯ ЛІТІЙ-ІОННОГО 2S
// ===========================================================================
//  ЧИМ ВІН ВІДРІЗНЯЄТЬСЯ ВІД ЗАВОДСЬКОГО. Заводський профіль (CHARGE_MA_*)
//  задає струм ТАБЛИЦЕЮ у відсотках заряду, і ця таблиця однакова для будь-
//  якого пакета: і для 1300 мА·год, і для 2900. Для меншого пакета 1000 мА —
//  це вже 0.77C, для більшого — 0.34C; тобто той самий профіль для одних
//  пакетів завеликий, для інших занадто обережний.
//
//  Розумний профіль рахує струм від ПАСПОРТНОЇ ЄМНОСТІ САМОГО ПАКЕТА (її
//  прошивка й так знає з DS2433) у частках C, і веде класичний для літію
//  цикл CC/CV із трьома речами, яких у таблиці немає в принципі:
//
//   1. ПЕРЕДЗАРЯД. Нижче 3.00 В на банку глибоко розряджений літій не можна
//      бити повним струмом: на аноді росте металевий літій (plating), і це
//      незворотньо. Тому нижче CHARGE_SMART_PRE_MV струм падає до 0.1C, поки
//      пакет не підніметься.
//   2. СПРАВЖНЯ ФАЗА CV. Заводська таблиця в кінці просто тримає малий струм
//      до цілі. Правильний кінець заряду — тримати НАПРУГУ й дати струму
//      впасти самому; завершувати треба за струмом (0.05C), а не за тим, що
//      напруга торкнулась цілі. Різниця — реально залитa ємність.
//   3. ТЕМПЕРАТУРНЕ ВІКНО. Літій не заряджають нижче 0 °C взагалі (те саме
//      plating) і вище 45 °C (прискорена деградація). Між 0 і 10 °C струм
//      мусить бути зниженим. Заводський профіль знає лише аварійну відсічку
//      на 45 °C.
//
//  ⚠️ УСІ струми розумного профілю однаково затискаються тими самими
//  апаратними межами, що й ручні: не вище CHARGE_MA_80 (тепловий бюджет
//  ключа) і не нижче CHARGE_MA_TAPER. Частка C — це ПОБАЖАННЯ, а не дозвіл
//  перевищити залізо.

// Струм фази CC, % від паспортної ємності (0.5C — стандарт для літій-іону).
#define CHARGE_SMART_CC_PCT      50
// Струм передзаряду, % від ємності.
#define CHARGE_SMART_PRE_PCT     10
// Струм завершення фази CV, % від ємності. Нижче нього заряд ВВАЖАЄТЬСЯ
// закінченим — це і є правильний критерій «пакет повний».
#define CHARGE_SMART_END_PCT      5
// Нижче цієї напруги на клемах — лише передзаряд (3.00 В на банку).
#define CHARGE_SMART_PRE_MV    6000
// Ширина зони CV під ціллю, мВ: усередині неї уставка лінійно спадає від
// струму CC до струму завершення. Це й дає «постійну напругу» на регуляторі,
// який фізично керує СТРУМОМ.
#define CHARGE_SMART_CV_BAND_MV 250
// Температурне вікно заряду, °C.
#define CHARGE_SMART_T_MIN_C      0
#define CHARGE_SMART_T_MAX_C     (CHARGE_MAX_TEMP_C)
// Нижче цієї температури струм зменшується до CHARGE_SMART_COOL_PCT відсотків.
#define CHARGE_SMART_T_COOL_C    10
#define CHARGE_SMART_COOL_PCT    50
// Скільки опитувань поспіль струм має бути нижчим за поріг завершення.
//  ⚑ Не одне: у кінці заряду ключ раз на секунду закривається на вимір, і
//  поодинокий низький відлік — це нормальний перехідний процес, а не «пакет
//  повний».
#define CHARGE_SMART_END_POLLS    5
// Найменша уставка розумного профілю, мА.
//
//  ⚑ ЦЕ ОДНЕ Й ТЕ САМЕ ЧИСЛО ДЛЯ ДВОХ РЕЧЕЙ, І ЦЕ НАВМИСНО: воно й підлога
//  уставки у фазі CV, і поріг завершення. Якби вони розійшлися, режим міг би
//  не завершитись НІКОЛИ: регулятор тримав би підлогу уставки (скажімо,
//  100 мА), а завершення чекало б струму нижче 65 мА — і чекало б до стелі
//  часу. Тримаючи їх рівними, отримуємо просте твердження: «струм упав до
//  найменшої уставки на цільовій напрузі» = «пакет повний».
//
//  Чому 40, а не менше: регулятор не розрізняє струм точніше за свою мертву
//  зону (CHARGE_DEADBAND_MA = 30 мА), тож нижче цього уставка стає фікцією.
//  Чому не більше: 0.05C пакета на 1300 мА·год — це 65 мА, і підлога має бути
//  нижчою за неї, інакше маленькі пакети завершували б заряд передчасно.
#define CHARGE_SMART_MA_MIN      40

// ── РУЧНА ЦІЛЬ ЗАРЯДУ В МІЛІВОЛЬТАХ ───────────────────────────────────────
//  Ціль у ВІДСОТКАХ зручна щодня, але вона проходить через криву SoC, тобто
//  «85 %» — це стільки, скільки крива вважає за 85 %. Для ремонту й для
//  зберігання потрібна саме НАПРУГА: 7.4 В (3.70 В/банку) — класичне
//  зберігання, 8.4 В — повний заряд «як у даташиті».
//  0 = ціль береться з відсотка, як і було.
#define CHARGE_MANUAL_MV_MIN   6000
//  ⚠️ Стеля — НЕ 8.4 В, а ціль заводського профілю. Вище неї цей пристрій не
//  заряджає взагалі: на 8.25 В пакет закривається сам (див. CHGR_PACKFULL), а
//  аварійна межа сеансу рахується як ціль + CHARGE_HARD_MAX_HEADROOM_MV.
#define CHARGE_MANUAL_MV_MAX   (CHARGE_TARGET_MV)

// ── РОЗУМНИЙ РОЗРЯД ───────────────────────────────────────────────────────
//  Той самий принцип: струм від паспортної ємності. 0.2C — стандартна ставка
//  для ВИМІРУ ємності: більший струм занижує результат через просадку на
//  внутрішньому опорі, менший розтягує цикл на півдня.
#define DISCHARGE_SMART_C_PCT    20
// Ширина зони плавного спаду перед ціллю, мВ.
#define DISCHARGE_SMART_BAND_MV 300
// Температурне вікно розряду, °C (розряджати холодний літій можна, заряджати —
// ні; тому нижня межа інша, ніж у заряді).
#define DISCHARGE_SMART_T_MIN_C -10
#define DISCHARGE_SMART_T_MAX_C (DISCHARGE_MAX_TEMP_C)

// ── РУЧНИЙ СТРУМ РОЗРЯДУ ──────────────────────────────────────────────────
//  0 = автомат (лінійка за напругою). Межі — ті самі, що в лінійки: нижче
//  DISCHARGE_MA_LO вимір ємності розтягується без користі, вище
//  DISCHARGE_MA_HI не дозволяє резистор навантаження.
#define DISCHARGE_MANUAL_MA_MIN (DISCHARGE_MA_LO)
#define DISCHARGE_MANUAL_MA_MAX (DISCHARGE_MA_HI)

// Період опитування, мс.
#define CHARGE_POLL_MS       1000UL

// Скільки тримати ключ ЗАКРИТИМ перед виміром напруги пакета, мс.
//
//  Напруга на клемі й так згладжена дроселем (на відміну від простого ключа,
//  де там стрибала б напруга живлення), але ПІД СТРУМОМ до неї додається
//  падіння на дротах і на внутрішньому опорі пакета. Тому ключ коротко
//  закривається: струм дроселя стікає через діод за одиниці мікросекунд,
//  омічна просадка зникає, і вимір лишається ОДНАКОВИМ від початку до кінця
//  заряду. 10 мс — з великим запасом на це й на власне АЦП.
#define CHARGE_VSENSE_SETTLE_MS  10

// Як часто читати DS2438 (температуру пакета), у періодах опитування.
//
//  ⚑ Чому НЕ щоразу. Транзакція 1-Wire коштує сотні мілісекунд (два
//  перетворення по ~10 мс плюс вісім сторінок), і весь цей час ключ мусить
//  бути ЗАКРИТИЙ: шунт у мінусовому проводі піднімає «мінус» пакета над
//  землею ESP32, і по зсунутій землі чип не відповідає. Читати щосекунди —
//  це втрачати 20 % часу заряду й щоразу перезапускати струм дроселя з нуля.
//  Температура ж міняється хвилинами, тож раз на 10 с достатньо навіть для
//  аварійної відсічки. Напругу й струм міряємо своїми давачами щосекунди —
//  вони швидкі.
#define CHARGE_TEMP_EVERY_N      10

// ── РЕГУЛЯТОР ШПАРУВАТОСТІ ────────────────────────────────────────────────
// Частота й роздільність ШІМ.
//
// ⚑ 25 кГц — вимога САМОГО ПОНИЖУВАЧА, а не смаку. Розмах пульсацій струму
// ΔI = (Uживл − Uвих) × D / (L × f): на 1 кГц зі 104 мкГн вийшли б десятки
// ампер, тобто глибоко переривчастий режим. На 25 кГц при 14 В -> 8.4 В,
// D≈0.6 і L=104 мкГн це ΔI ≈ 1.30 А — прийнятно на крейсерському струмі
// 1.5 А. Потрібні менші пульсації — піднімайте частоту або індуктивність;
// перевірка наприкінці блока рахує ΔI за ВАШИМИ числами й попереджає.
//
// ⚠️ Знизу частоту обмежує дросель, зверху — ЗАТВОРНЕ КОЛО (τ = R_pullup ×
// Ciss) і роздільність LEDC (макс. частота = 80 МГц / 2^bits). Обидві межі
// перевіряються на компіляції: проєкт уже горів на тому, що 20 кГц
// недосяжні на 12 бітах (80 МГц/4096 = 19.5 кГц). На 11 бітах максимум
// ≈39 кГц, тож 25 кГц проходять із запасом, а 2048 кроків шпаруватості
// дають крок струму ~11 мА (при 14 В і сумарних 0.6 Ом).
#define CHARGE_PWM_FREQ  25000
#define CHARGE_PWM_BITS  11

// ── КРОК РЕГУЛЯТОРА: пропорційний, із двома межами ────────────────────────
//  Один відлік шпаруватості коштує приблизно Uживл/(Rсумарне × 2047) ≈
//  14/(0.6 × 2047) ≈ 11 мА (у неперервному режимі, де I = (D×Uживл −
//  Uпакета)/R). Звідси й перерахунок похибки в кроки.
//
//  ⚑ ЧОМУ КРОК НЕ ФІКСОВАНИЙ. Стартова оцінка шпаруватості спирається на
//  індуктивність і сумарний опір, а обидва відомі приблизно (дросель — «десь
//  104 мкГн», опір пакета взагалі плаває). Фіксований дрібний крок означав би,
//  що будь-яка похибка моделі коштує хвилини повзання: від 200 мА до 1000 мА
//  це ~600 відліків, тобто 5 хвилин при кроці 2. Тому крок пропорційний
//  похибці й затиснутий з обох боків: великий розрив закривається за кілька
//  опитувань, а біля уставки крок стає мінімальним, щоб контур не «сіпався».
//  Так контур лишається стійким навіть якщо CHARGE_L_UH задано неточно.
//
//  ⚑ ОБИДВІ ТОПОЛОГІЇ КРУТЯТЬ ОДИН І ТОЙ САМИЙ РЕГУЛЯТОР, але «відлік» у них
//  різний (див. блок про CHARGE_TOPOLOGY вище), тож і масштаб кроку різний.
//  Тримаємо обидва набори ТУТ, поруч: розкидані по файлу, вони неминуче
//  розійшлися б, і на одній із плат контур поводився б не так, як описано.
#if CHARGE_IS_TL494
  // ⚠️ ТУТ КРОК НАВМИСНО ФІКСОВАНИЙ — і це не недогляд, а прямий наслідок
  //  заліза. Обидві межі однакові, тож пропорційність вироджується: хай яка
  //  похибка струму, крок завжди рівно CHARGE_TL_STEP_MV мілівольт виходу.
  //
  //  Чому не можна швидше. Вихід цієї плати — ДЖЕРЕЛО НАПРУГИ на пакет із
  //  внутрішнім опором у десяті ома: 200 мВ стрибка це під ампер струму
  //  одним кроком, і виміряти наслідок ми зможемо аж через секунду (струм
  //  читається по 1-Wire, а не з АЦП). Контур із таким запізненням і таким
  //  підсиленням просто розгойдався б. У понижувача обидва числа інші:
  //  свій АЦП дає вимір за мілісекунди, а дросель обмежує наростання струму.
  //
  //  ⚑ CHARGE_DUTY_MA_PER_STEP тут ні на що не впливає (крок затиснуто з
  //  обох боків однаковим числом) — але визначити його ТРЕБА: він стоїть у
  //  спільному коді як дільник, і нуль там дав би ділення на нуль. Одиниця —
  //  найбезпечніше нейтральне значення.
  #define CHARGE_TL_STEP_MV        20   // крок цільової вихідної напруги, мВ
  #define CHARGE_DUTY_MA_PER_STEP   1   // не діє: крок затиснуто з обох боків
  #define CHARGE_DUTY_STEP         (CHARGE_TL_STEP_MV)
  #define CHARGE_DUTY_STEP_MAX     (CHARGE_TL_STEP_MV)
#else
  #define CHARGE_DUTY_MA_PER_STEP  11   // скільки мА коштує один відлік ШІМ
  #define CHARGE_DUTY_STEP          2   // мінімальний крок (точне доведення)
  #define CHARGE_DUTY_STEP_MAX     64   // стеля кроку (швидкий вихід на режим)
#endif

// Сумарний послідовний опір кола заряду, мОм: шунт + дроти + внутрішній опір
// пакета. Потрібен лише для СТАРТОВОЇ оцінки шпаруватості у неперервному
// режимі; далі все веде замкнутий контур за реальним струмом, тож похибка тут
// не критична. Шунт (CHARGE_SHUNT_MOHM) домінує, решта — оцінка.
#define CHARGE_SERIES_MOHM      600

// Стеля шпаруватості, % — ключ НІКОЛИ не відкривається повністю.
//
// ⚑ Для понижувача це ще й обмеження ВИХІДНОЇ НАПРУГИ: Uвих ≈ D × Uживл.
// Рахуємо потрібний мінімум: ціль 8.25 В + падіння на шунті (0.5 Ом × 1.5 А
// = 0.75 В) + діод/дросель/дроти/ключ (~0.5 В) ≈ 9.5 В, тобто D ≈ 9.5/14 ≈
// 0.68. Беремо 85 % — є запас на просілий блок живлення й на гірший випадок
// за струмом, але 100 % не досягається ніколи: на повністю відкритому ключі
// понижувач вироджується у пряме з'єднання живлення з пакетом.
// ⚠️ Ставите ІНШЕ живлення — перерахуйте: замала стеля означає, що заряд не
// дотягне до цілі й упреться в стелю часу.
#define CHARGE_DUTY_MAX_PCT  85

// Мертва зона навколо уставки, мА — щоб контур не «сіпав» шпаруватість на
// шумі вимірювання ±1 крок туди-сюди.
#define CHARGE_DEADBAND_MA   30

// АВАРІЙНА відсічка за ПІКОВИМ струмом, мА (найбільший відлік за час виміру).
//
// ⚑ У понижувача пік — це ВЕРШИНА ПУЛЬСАЦІЙ (Iсер + ΔI/2), а не кидок:
// дросель не дає струму стрибнути. Тож ця відсічка стереже НЕ штатну роботу,
// а поломки, за яких дроселя фактично немає в колі: обрив або насичення
// дроселя, пробитий ключ, замкнений діод. Поріг мусить бути помітно вищим за
// (найбільша уставка + півпульсації), інакше ловитиме штатний режим.
#define CHARGE_PEAK_MA_MAX   3000
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
