roman885-85/moto_battery_reader/web_server.h

#ifndef WEB_SERVER_H
#define WEB_SERVER_H

#include <WebServer.h>
#include <FS.h>
#include <SPIFFS.h>
#include <ArduinoJson.h>
#include "battery_reader.h"
#include "settings.h"
#include "impres_format.h"     // структура прошивки IMPRES (єдине джерело правди)
#include "impres_bms.h"        // штатний декодер Motorola (лічильники, знос, дати)
#include "operations.h"        // єдиний каталог операцій для всіх поверхонь
#include "restore_plan.h"      // правки еталона під конкретний пакет перед записом
#include "edit_plan.h"        // ручне редагування всіх значень пакета одним списком
#include "snapshot_diff.h"   // знімок «до станції» і побайтова різниця з ним
// ⚑ bt_link.h — САМЕ ТУТ, А НЕ «ВІН І ТАК ПРИЙДЕ ЗІ СКЕТЧА». Ім'я приладу в
//  ефірі (btName) віддає й ця відповідь теж, а сам заголовок доти включав лише
//  serial_api.h — і той стоїть у скетчі ПІСЛЯ web_server.h. Тобто складалось
//  усе рівно доти, доки звідси ніхто по btName() не звертався; щойно
//  звернувся — «btName was not declared in this scope» просто в Arduino IDE.
//  Заголовок захищений #pragma once, тож зайвим включенням нічого не коштує.
#include "bt_link.h"          // btName(): ім'я, під яким прилад видно в ефірі
#include "device_clock.h"     // системна дата пристрою (джерело «сьогодні»)
#include "impres_audit.h"     // аудит змісту: шифрування й узгодженість даних
#include "impres_clone.h"     // крайній засіб: відновлення за зразком копії
#include "mirror_plan.h"      // синхронізація дзеркала DS2438 -> DS2433 з правкою
#include "discharge.h"         // керований розряд навантаженням (MOSFET)
#include "charge.h"            // керований заряд понижувачем на власному ключі (PNP B772M)
#include "leds.h"
#include "display.h"
#include "templates.h"
#include "page_index.h"    // веб-сторінка, вшита в прошивку (tools/mk_page_header.py)

// ⚑ Визначене у скетчі НИЖЧЕ за цей include, тож потрібне оголошення.
//  Без нього збірка падає на «resetReasonText was not declared» — і причина
//  була б неочевидна: функція ж «є», просто ще не видима в цій точці.
const char *resetReasonText(esp_reset_reason_t r);

extern WebServer server;
extern BatteryReader battery;
extern uint8_t batteryDump[DUMP_SIZE];
extern bool hasDump;
extern uint8_t batteryDump2438[DS2438_MEM_SIZE];
extern bool hasDump2438;
extern uint8_t chipSN2438[8];
extern bool hasSN2438;
extern uint8_t chipSN2433[8];
extern bool hasSN2433;

// Збереження дампа в SPIFFS (перезапис файлу).
static void saveDump(const char *path, const uint8_t *data, size_t size) {
    SPIFFS.remove(path);
    delay(50);
    File f = SPIFFS.open(path, "w");
    if (f) {
        size_t written = f.write(data, size);
        f.flush();
        f.close();
        delay(50);
        Serial.printf("Saved %s: %d bytes\n", path, written);
    } else {
        Serial.printf("ERROR: cannot open %s for writing\n", path);
    }
}

// HEX-превью перших n байт в JSON-рядок ("AA BB CC ...").
static String hexPreview(const uint8_t *data, size_t n) {
    String s;
    for (size_t i = 0; i < n; i++) {
        char hex[4];
        sprintf(hex, "%02X", data[i]);
        s += hex;
        if (i + 1 < n) s += " ";
    }
    return s;
}

// ---------------------------------------------------------------------------
// Цілісність прошивки IMPRES (з’ясовано аналізом дампів, див. README):
//   * Заголовок DS2433: сума байт 0x00..0x1F ≡ 0x41; байт 0x1F — контрольний.
//   * TLV-записи: сума усіх байт записи (разом з її контрольним байтом) ≡ 0x5A.
//   * Блок калібрування дзеркалиться: DS2438[24:50] == DS2433[1:27]. Він однаковий для
//     усіх батарей однієї моделі (4488A і 4493A збігаються; 4409A відрізняється) —
//     тобто прив'язки до серійному номеру чипа Немає, прошивка прив'язана до Моделі.
// Звідси механізм ремонту: перерахувати контрольну суму заголовка і
// синхронізувати дзеркало з уцілілого DS2438 у DS2433 (або навпаки).
// ---------------------------------------------------------------------------

// контрольна сума заголовка DS2433 (0x00..0x1F ≡ 0x41).
static void fixHeaderChecksum(uint8_t *d) {
    int s = 0;
    for (int i = 0; i < 0x1F; i++) s += d[i];
    d[0x1F] = (0x41 - s) & 0xFF;
}
static bool headerChecksumOk(const uint8_t *d) {
    int s = 0;
    for (int i = 0; i <= 0x1F; i++) s += d[i];
    return (s & 0xFF) == 0x41;
}

// Синхронізація дзеркала калібрування: DS2438[24:50] -> DS2433[1:27] (+ контр. сума
// заголовка). DS2438 переживає стирання DS2433, тому це основний шлях ремонту.
static void syncMirrorFrom2438(uint8_t *d33, const uint8_t *d38) {
    for (int i = 0; i < 26; i++) d33[1 + i] = d38[24 + i];
    fixHeaderChecksum(d33);
}
static bool mirrorOk(const uint8_t *d33, const uint8_t *d38) {
    for (int i = 0; i < 26; i++) if (d33[1 + i] != d38[24 + i]) return false;
    return true;
}
// Чи придатне дзеркало DS2438[24:50] як ДЖЕРЕЛО для відновлення DS2433[1:27]:
// лише якщо це реальні дані (не суцільні 0x00 чи 0xFF). У R7 (PMNN4809A/APLI4810C,
// формат 2021) дзеркала в DS2438 може не бути — тоді синхронізація НЕ виконується,
// інакше вона затерла б заголовок DS2433 нулями і зіпсувала ідентичність.
static bool mirrorSourceValid(const uint8_t *d38) {
    bool allZero = true, allFF = true;
    for (int i = 24; i < 50; i++) { if (d38[i] != 0x00) allZero = false; if (d38[i] != 0xFF) allFF = false; }
    return !allZero && !allFF;
}

// ---------------------------------------------------------------------------
// Перевірка пароля адміністратора. РАНІШЕ: `if (hasArg && arg != PW)` —
// якщо клієнт просто НЕ надсилав аргумент password, перевірка проходила і
// запис виконувався БЕЗ пароля (діра в безпеці). Тепер пароль ОБОВ'ЯЗКОВИЙ:
// має бути присутній І збігатися. Усі веб-обробники запису викликають
// requireAdmin() першим рядком.
// Пароль адміністратора ВИМКНЕНО: пристрій працює без нього (фізичний доступ до
// АКБ/пристрою вже є дозволом). requireAdmin() лишено як no-op, щоб не чіпати
// десятки місць виклику; воно завжди дозволяє.
static bool requireAdmin() { return true; }

// Логотип: віддаємо /logo.png з SPIFFS, якщо він завантажений (інакше 404 -> в вебі
// показується вбудований SVG-тризуб). Дозволяє використати точний логотип НГУ.
void handleLogo() {
    if (SPIFFS.exists("/logo.png")) {
        File f = SPIFFS.open("/logo.png", "r");
        server.streamFile(f, "image/png");
        f.close();
    } else {
        server.send(404, "text/plain", "no logo");
    }
}

// обробник головної сторінки
//
//  ⚑ СПЕРШУ СТИСНУТА КОПІЯ. Сторінка виросла до чверті мегабайта, і кожне її
//  відкриття — це стільки ж по радіо. Причому відкривається вона не лише
//  руками: наш captive-portal (DNS «усі домени -> 192.168.4.1» + редирект)
//  змушує телефон САМ показати її одразу після під'єднання до точки доступу.
//  gzip зменшує передачу утричі й нічого не змінює для браузера —
//  розпаковування вбудоване в HTTP.
//
//  ⚑ ВІДДАЄМО САМЕ server.streamFile(), А НЕ СВОЇМ ЦИКЛОМ. Тут була спроба
//  слати сторінку шматками (щоб годувати сторожа) — і вона коштувала білого
//  екрана. Причина в тому, чого не видно з боку виклику: _streamFileCore()
//  наприкінці РОЗБИРАЄ за собою стан — setContentLength(CONTENT_LENGTH_NOT_SET).
//  Свій цикл цього не робив, тож після першої ж сторінки _contentLength
//  лишався рівним її розміру, і КОЖНА наступна відповідь (усі /api/*) ішла з
//  чужим Content-Length у заголовку. Браузер чекав на дані, яких не буде, —
//  сторінка лишалась порожньою. Той самий streamFile ще й сам додає
//  Content-Encoding: gzip, коли ім'я файла закінчується на «.gz», — тому
//  вручну цей заголовок ставити НЕ МОЖНА: два однакові заголовки браузер
//  читає як подвійне стиснення.
//
//  Годування сторожа лишилось до й після передачі: 89 КБ по радіо — це частка
//  секунди, а поріг Task WDT під час заряду — 10 с (wdt.h).
// ⚑ ЧОМУ ВШИТУ СТОРІНКУ НЕ МОЖНА ВІДДАВАТИ ОДНИМ send_P.
//  У ядрі ESP32 великий буфер і файл ідуть РІЗНИМИ шляхами:
//
//    NetworkClient::write(buf, size)  — один цикл select/send на всю передачу;
//        запас повторів (WIFI_CLIENT_MAX_WRITE_RETRY = 10) ділиться на неї
//        цілком, і на слабкому каналі 90 КБ його вичерпують. Функція повертає,
//        СКІЛЬКИ встигла, а send_P цього не перевіряє — браузер отримує
//        обрізане тіло при чесному Content-Length і показує порожню сторінку;
//    NetworkClient::write(Stream&)    — ріже на шматки по 1360 Б, і КОЖЕН
//        шматок дістає повний запас повторів. Саме цим шляхом завжди йшли
//        файли зі SPIFFS — тому вони й доїжджали.
//
//  Спостереження власника це й показало: /lite (1.7 КБ) відкривається, а
//  сторінка на 90 КБ — ні. Тому загортаємо масив у Stream і віддаємо його тим
//  самим streamFile(), що й файл: ім'я з «.gz» ядро само перетворює на
//  заголовок Content-Encoding.
class PgmPageStream : public Stream {
  public:
    PgmPageStream(const uint8_t *p, size_t n) : _p(p), _n(n), _i(0) {}
    size_t size() const { return _n; }
    String name() const { return String("/index.html.gz"); }   // ← звідси й gzip
    int available() override { return (int)(_n - _i); }
    int read() override     { return (_i < _n) ? _p[_i++] : -1; }
    int peek() override     { return (_i < _n) ? _p[_i] : -1; }
    size_t write(uint8_t) override { return 0; }               // тільки читання
    size_t readBytes(char *buf, size_t len) override {
        size_t left = _n - _i;
        if (len > left) len = left;
        memcpy(buf, _p + _i, len);
        _i += len;
        return len;
    }
  private:
    const uint8_t *_p;
    size_t _n, _i;
};

void handleRoot() {
    // 1) Файл у SPIFFS — якщо його туди свідомо поклали. Це шлях для розробки:
    //    правити сторінку, не перепрошиваючи 1.3 МБ. Що саме лежить у файловій
    //    системі, видно через /api/fs.
    File file = SPIFFS.open("/index.html.gz", "r");
    if (!file || !file.size()) file = SPIFFS.open("/index.html", "r");
    // ⚑ І РОЗМІР ТЕЖ. Порожній (або нульовий) файл у файловій системі не сміє
    //  перекривати вшиту сторінку: це рівно той білий екран, від якого ми
    //  тікали, лише з іншого боку.
    if (file && file.size()) {
        wdtFeed();
        server.streamFile(file, "text/html");   // .gz -> Content-Encoding додасть сам
        file.close();
        wdtFeed();
        return;
    }
    // 2) Інакше — ВШИТА копія. Вона є завжди, і саме вона працює одразу після
    //    прошивки: заливати щось окремо не треба.
    //    Ідемо тим самим streamFile(), що й файл, — див. пояснення вище.
    wdtFeed();
    PgmPageStream page(PAGE_INDEX_GZ, PAGE_INDEX_GZ_LEN);
    server.streamFile(page, "text/html");
    wdtFeed();
}

// ⚑ ПЕРЕВІРКА «ВЕЛИКИЙ ОБСЯГ БЕЗ СТИСНЕННЯ».
//  Коли мала сторінка відкривається, а велика ні, змінних рівно дві: РОЗМІР і
//  СТИСНЕННЯ. Розділити їх можна лише дослідом, і ось він: цей потік віддає
//  скільки завгодно звичайного тексту, без gzip і без жодного байта у флеші.
//  Якщо він проходить, а сторінка ні — винне стиснення; якщо не проходить і
//  він — винен розмір.
class FillStream : public Stream {
  public:
    explicit FillStream(size_t n) : _n(n), _i(0) {}
    size_t size() const { return _n; }
    String name() const { return String("/bigtest.txt"); }
    int available() override { return (int)(_n - _i); }
    int read() override { return (_i < _n) ? (int)_byteAt(_i++) : -1; }
    int peek() override { return (_i < _n) ? (int)_byteAt(_i) : -1; }
    size_t write(uint8_t) override { return 0; }
    size_t readBytes(char *buf, size_t len) override {
        size_t left = _n - _i;
        if (len > left) len = left;
        for (size_t k = 0; k < len; k++) buf[k] = (char)_byteAt(_i + k);
        _i += len;
        return len;
    }
  private:
    // Рядки по 64 символи: у потоці видно, де саме він обірвався.
    static uint8_t _byteAt(size_t i) { return (i % 64 == 63) ? '\n' : (uint8_t)('0' + (i / 64) % 10); }
    size_t _n, _i;
};

void handleBigTest() {
    long n = server.hasArg("n") ? server.arg("n").toInt() : 120000;
    if (n < 1000)   n = 1000;
    if (n > 400000) n = 400000;
    wdtFeed();
    FillStream f((size_t)n);
    server.streamFile(f, "text/plain");
    wdtFeed();
}

// GET /lite — АВАРІЙНА СТОРІНКА НА КІЛЬКА КІЛОБАЙТ.
//
//  ⚑ Навіщо вона. Основна сторінка — це 90 КБ по радіо, і коли вона не
//  доходить, у браузері порожньо: сказати, ЩО саме не спрацювало, нема кому.
//  А маленька сторінка доходить майже завжди — і сама показує відбиток
//  збірки, стан файлової системи й головні показники. Тобто відповідає на
//  «чи та прошивка», «чи працює сервер» і «чи бачить пристрій АКБ» одразу, без
//  послідовного порту. Заразом нею можна користуватись, поки велика не їде.
//
//  Тримається в коді рядком, а не файлом: у неї одне завдання — бути там, де
//  все інше вже не працює.
static const char PAGE_LITE[] PROGMEM =
"<!doctype html><meta charset=utf-8><meta name=viewport content='width=device-width,initial-scale=1'>"
"<title>Moto battery — lite</title>"
"<style>body{font:14px system-ui;margin:12px;background:#12160f;color:#cfd6c4}"
"b{color:#e8eddc}button{font:14px system-ui;padding:8px 14px;margin:4px 4px 4px 0;"
"border:0;border-radius:8px;background:#3c5a2a;color:#fff}pre{white-space:pre-wrap;"
"background:#1b2116;padding:8px;border-radius:8px;overflow-x:auto}a{color:#9fd07a}</style>"
"<h2>Легка сторінка</h2>"
"<p>Основна: <a href=/>/</a> &middot; дані: <a href=/api/info>/api/info</a> &middot; "
"файли: <a href=/api/fs>/api/fs</a></p>"
"<button onclick=\"go('/api/read')\">Зчитати АКБ</button>"
"<button onclick=\"load()\">Оновити</button>"
"<button onclick=\"probe('/')\">Перевірити основну</button>"
"<button onclick=\"probe('/bigtest')\">Перевірити великий обсяг</button>"
"<pre id=o>завантаження…</pre>"
"<script>"
"async function j(u){const r=await fetch(u);return await r.json();}"
"async function load(){const o=document.getElementById('o');try{"
"const f=await j('/api/fs');let t='збірка: '+(f.build||'—')"
"+'\\nсторінка в прошивці: '+(f.page?f.page.embedded:'—')+' Б'"
"+(f.gzCrcOk===false?' ⚠ БЛОК ПОБИТИЙ':'')"
"+(f.page&&f.page.override?' (перекрита файлом зі SPIFFS)':'')"
"+'\\nSPIFFS: '+f.used+' з '+f.total+' Б, файлів '+f.files.length;"
"try{const d=await j('/api/info');t+='\\n\\nмодель: '+(d.model||'—')+'\\nзаряд: '+(d.capacity!=null?d.capacity+' %':'—')"
"+'\\nоригінал: '+(d.genuine?'так':'ні')+(d.authReason?(' ('+d.authReason+')'):'');}"
"catch(e){t+='\\n\\n/api/info: '+e.message;}"
"o.textContent=t;}catch(e){o.textContent='помилка: '+e.message;}}"
"async function go(u){const o=document.getElementById('o');o.textContent='…';"
"try{await j(u);}catch(e){}load();}"
// ⚑ Дослід, який відповідає замість здогадів: скільки байтів РЕАЛЬНО дійшло
//  проти того, що обіцяв заголовок. Для стиснутої відповіді content-length —
//  це стиснутий розмір, а blob.size — розпакований; обидва числа корисні.
"async function probe(u){const o=document.getElementById('o');o.textContent='перевіряю '+u+' …';"
"const t=Date.now();try{const r=await fetch(u,{cache:'no-store'});"
"const cl=r.headers.get('content-length'),ce=r.headers.get('content-encoding');"
"const b=await r.blob();"
"o.textContent=u+': HTTP '+r.status+'\\nобіцяно (content-length): '+(cl||'—')"
"+'\\nотримано насправді: '+b.size+' Б'+'\\nкодування: '+(ce||'без стиснення')"
"+'\\nчас: '+(Date.now()-t)+' мс';"
"}catch(e){o.textContent=u+': ПОМИЛКА — '+e.message+'\\nчас: '+(Date.now()-t)+' мс';}}"
"load();"
"</script>";

void handleLite() {
    server.send_P(200, "text/html", PAGE_LITE, strlen_P(PAGE_LITE));
}

// GET /api/fs — що насправді лежить у SPIFFS.
//  Дрібниця, але саме її бракувало, коли сторінка не відкривалась: без
//  послідовного порту не було як побачити, чи доїхала тека data/ у пристрій.
void handleFsList() {
    // ⚑ ВІДБИТОК ЗБІРКИ — ПЕРШИМ. Без нього неможливо відповісти на найперше
    //  питання будь-якого розбору: а чи та прошивка взагалі в пристрої? Дата
    //  й час компіляції підставляє компілятор, тож збігтися випадково вони не
    //  можуть. Поруч — звідки береться сторінка й скільки її.
    String j = "{\"build\":\"" __DATE__ " " __TIME__ "\"";
    // ⚑ САМОПЕРЕВІРКА ВШИТОЇ СТОРІНКИ. Рахуємо CRC32 масиву прямо у флеші й
    //  порівнюємо з числом, яке поклав генератор. Якщо сторінка не
    //  відкривається, це одразу розділяє два зовсім різні випадки: «блок у
    //  флеші побитий» і «блок цілий, але не доїжджає по мережі».
    uint32_t c = 0xFFFFFFFFu;
    for (size_t i = 0; i < PAGE_INDEX_GZ_LEN; i++) {
        c ^= pgm_read_byte(PAGE_INDEX_GZ + i);
        for (int k = 0; k < 8; k++) c = (c >> 1) ^ (0xEDB88320u & (-(int32_t)(c & 1)));
    }
    c ^= 0xFFFFFFFFu;
    j += ",\"gzCrcOk\":"; j += (c == PAGE_INDEX_GZ_CRC) ? "true" : "false";
    j += ",\"page\":{\"embedded\":"; j += (uint32_t)PAGE_INDEX_GZ_LEN;
    j += ",\"override\":";
    j += (SPIFFS.exists("/index.html.gz") || SPIFFS.exists("/index.html")) ? "true" : "false";
    j += "}";
    j += ",\"total\":";      j += (uint32_t)SPIFFS.totalBytes();
    j += ",\"used\":";        j += (uint32_t)SPIFFS.usedBytes();
    j += ",\"files\":[";
    File dir = SPIFFS.open("/");
    bool first = true;
    for (File f = dir.openNextFile(); f; f = dir.openNextFile()) {
        if (!first) j += ",";
        first = false;
        j += "{\"name\":\""; j += f.name();
        j += "\",\"size\":";  j += (uint32_t)f.size(); j += "}";
    }
    j += "]}";
    server.send(200, "application/json", j);
}

// Читання обох мікросхем (DS2433 + DS2438) з збереженням в SPIFFS і на дисплей.
// Повертає true, якщо зчитана хоча б одна мікросхема.
bool readAllChips(bool &ok2433, bool &ok2438) {
    ledSet(LED_READ);
    displayShow("ЗЧИТУВАННЯ...");

    // Читаємо в ТИМЧАСОВІ буфери й застосовуємо лише при УСПІХУ: невдале читання
    // (напр. АКБ від'єднано) не повинно затирати попередній добрий дамп у пам'яті.
    static uint8_t tmp33[DUMP_SIZE];
    static uint8_t tmp38[DS2438_MEM_SIZE];
    memset(tmp33, 0, DUMP_SIZE);
    memset(tmp38, 0, DS2438_MEM_SIZE);

    // DS2433 — основний дамп (512 байт).
    ok2433 = battery.readBattery(tmp33, DUMP_SIZE);
    if (ok2433) {
        memcpy(batteryDump, tmp33, DUMP_SIZE);
        hasDump = true;
        saveDump("/dump.bin", batteryDump, DUMP_SIZE);
    }

    // DS2438 — монітор батареї (64 байта).
    ok2438 = battery.readDS2438(tmp38, DS2438_MEM_SIZE);
    if (ok2438) {
        memcpy(batteryDump2438, tmp38, DS2438_MEM_SIZE);
        hasDump2438 = true;
        saveDump("/dump2438.bin", batteryDump2438, DS2438_MEM_SIZE);
    }

    // Серійні номери чипів (лазерні ROM-ID). ROM DS2433 — це ще й ключ до
    // зашифрованих лічильників і дат у прошивці АКБ (див. impres_bms.h).
    // ⚑ Дзеркалимо стан драйвера ОБОМА гілками. Раніше «else» не було, і
    // серійник лишався від ПОПЕРЕДНЬОГО пакета, якщо цей не визначився. Для
    // показу це дрібниця, а для шифрування — ні: ROM DS2433 і є ключем, і
    // старий ROM означав би, що дані цього пакета зашифровано чужим.
    if (battery.hasRom2438()) {
        memcpy(chipSN2438, battery.rom2438(), 8);
        hasSN2438 = true;
    } else {
        hasSN2438 = false;
        memset(chipSN2438, 0, sizeof(chipSN2438));
    }
    if (battery.hasRom2433()) {
        memcpy(chipSN2433, battery.rom2433(), 8);
        hasSN2433 = true;
    } else {
        hasSN2433 = false;
        memset(chipSN2433, 0, sizeof(chipSN2433));
    }

    char st[40];
    if (ok2433 || ok2438) {
        snprintf(st, sizeof(st), "ЧИТ 2433:%s 2438:%s", ok2433 ? "OK" : "-", ok2438 ? "OK" : "-");
    } else {
        // ⚑ «Нема чіпа» — це ВИСНОВОК ПРО ПАКЕТ, і робити його, не перевіривши
        // власну обв'язку, не можна: коротке на землю в лінії enable/підтяжки
        // дає рівно ту саму картину. Перевіряємо лінію й називаємо винного.
        // ⚑ «Нема чіпа» — це висновок ПРО ПАКЕТ, і робити його, не перевіривши
        // власну обв'язку, не можна: відсутня підтяжка, коротке на землю чи
        // відсутня спільна земля дають рівно ту саму картину. Спершу питаємо
        // залізо, і лише якщо воно справне — звинувачуємо пакет.
        uint8_t enl = battery.enableLineCheck();
        uint8_t bus = battery.busLineCheck();
        if (bus == BatteryReader::BUS_NO_EXT_PULLUP) {
            snprintf(st, sizeof(st), "ПОМИЛКА: нема підтяжки 4.7к");
        } else if (bus == BatteryReader::BUS_NO_PULLUP) {
            snprintf(st, sizeof(st), "ПОМИЛКА: лінія даних (GPIO%d)", (int)DS_PIN);
        } else if (enl != BatteryReader::ENL_OK) {
            snprintf(st, sizeof(st), "ПОМИЛКА: enable (GPIO%d)", (int)PULLUP_PIN);
        } else {
            snprintf(st, sizeof(st), "ПОМИЛКА: нема чіпа");
        }
        if (enl != BatteryReader::ENL_OK)
            Serial.printf("ЧИТАННЯ: %s\n", BatteryReader::enableLineText(enl));
        if (bus != BatteryReader::BUS_OK)
            Serial.printf("ЧИТАННЯ: %s\n", BatteryReader::busLineText(bus));
    }
    displayShow(st);

    ledSet((ok2433 || ok2438) ? LED_OK : LED_ERROR);
    // Прогрес читання оновлював лише футер (без блимання). Тепер ОДИН повний
    // перемальовок — показати оновлені дані АКБ (%, напруга тощо) на дисплеї.
    displayRender();
    return ok2433 || ok2438;
}

// Обробник читання дампа: зчитуємо обидві мікросхеми (DS2433 + DS2438).
void handleReadDump() {
    Serial.println("Starting battery read...");

    bool ok2433, ok2438;
    readAllChips(ok2433, ok2438);

    if (ok2433 || ok2438) {
        String json = String("{\"status\":\"success\",\"ds2433\":") + (ok2433 ? "true" : "false") +
                      ",\"ds2438\":" + (ok2438 ? "true" : "false") + "}";
        server.send(200, "application/json", json);
    } else {
        server.send(500, "application/json", "{\"status\":\"error\",\"message\":\"Failed to read battery\"}");
    }
}

// Обробник завантаження дампа
void handleDownloadDump() {
    if (!hasDump) {
        server.send(404, "text/plain", "No dump available");
        return;
    }
    
    File file = SPIFFS.open("/dump.bin", "r");
    if (!file) {
        server.send(500, "text/plain", "Failed to open file");
        return;
    }
    
    server.sendHeader("Content-Disposition", "attachment; filename=battery_dump.bin");
    server.streamFile(file, "application/octet-stream");
    file.close();
}

// Обробник завантаження дампа DS2438
void handleDownloadDump2438() {
    if (!hasDump2438) {
        server.send(404, "text/plain", "No DS2438 dump available");
        return;
    }

    File file = SPIFFS.open("/dump2438.bin", "r");
    if (!file) {
        server.send(500, "text/plain", "Failed to open file");
        return;
    }

    server.sendHeader("Content-Disposition", "attachment; filename=ds2438_dump.bin");
    server.streamFile(file, "application/octet-stream");
    file.close();
}

// Upload-колбек (ufn) для файлу DS2438 -> /upload2438.bin
void handleUploadDump2438() {
    static File uploadFile;

    HTTPUpload &upload = server.upload();

    if (upload.status == UPLOAD_FILE_START) {
        Serial.printf("\n=== DS2438 upload started: %s ===\n", upload.filename.c_str());
        if (uploadFile) { uploadFile.close(); delay(20); }
        if (SPIFFS.exists("/upload2438.bin")) { SPIFFS.remove("/upload2438.bin"); delay(20); }
        uploadFile = SPIFFS.open("/upload2438.bin", "w");
        if (!uploadFile) Serial.println("CRITICAL ERROR: Cannot create /upload2438.bin!");

    } else if (upload.status == UPLOAD_FILE_WRITE) {
        if (uploadFile) uploadFile.write(upload.buf, upload.currentSize);

    } else if (upload.status == UPLOAD_FILE_END) {
        if (uploadFile) {
            uploadFile.flush();
            uploadFile.close();
            delay(50);
            Serial.printf("DS2438 upload finished (%d bytes)\n", upload.totalSize);
        }

    } else if (upload.status == UPLOAD_FILE_ABORTED) {
        if (uploadFile) uploadFile.close();
        Serial.println("DS2438 upload aborted!");
    }
}

#ifdef DISPLAY_SPLASH_SPIFFS
#ifdef DISPLAY_SPLASH_JPEG
#include <TJpg_Decoder.h>   // приймальник сам питає розміри JPEG (getFsJpgSize),
                            // тож залежність його власна, а не успадкована
#endif
#include "splash.h"   // явно, а не транзитом через display.h: приймальник
                      // мусить розбирати заголовок ТИМ САМИМ кодом, що й
                      // дисплей, і залежати тут від чужого include не варто
// ── ЗАВАНТАЖЕННЯ КОЛЬОРОВОЇ ЗАСТАВКИ У SPIFFS ─────────────────────────────
//  Формат і перевірка — у splash.h (той самий код, що читає її дисплей і
//  ганяє хостовий тест). Тут — приймання й запис.
static bool     g_splashUpOpen = false;
static uint32_t g_splashUpBytes = 0;
static bool     g_splashUpOverflow = false;

void handleUploadSplash() {
    static File up;
    HTTPUpload &u = server.upload();

    if (u.status == UPLOAD_FILE_START) {
        Serial.printf("\n=== Splash upload started: %s ===\n", u.filename.c_str());
        if (up) { up.close(); delay(20); }
        // ⚑ ПИШЕМО У ТИМЧАСОВИЙ ФАЙЛ, а не одразу в бойовий. Приймання може
        //  обірватись посеред передачі, і затерти робочу заставку недописаним
        //  шматком означало б зламати те, що працювало, — при спробі, яка
        //  навіть не дійшла до кінця. Перейменуємо лише після перевірки.
        if (SPIFFS.exists(DISPLAY_SPLASH_PATH ".tmp")) SPIFFS.remove(DISPLAY_SPLASH_PATH ".tmp");
        up = SPIFFS.open(DISPLAY_SPLASH_PATH ".tmp", "w");
        g_splashUpOpen = (bool)up;
        g_splashUpBytes = 0;
        g_splashUpOverflow = false;
        if (!up) Serial.println("Splash: не вдалося створити тимчасовий файл");

    } else if (u.status == UPLOAD_FILE_WRITE) {
        // Стелю перевіряємо НА ХОДУ, а не наприкінці: інакше надто великий
        // файл спершу заповнив би SPIFFS (витіснивши index.html), і лише
        // потім був би відхилений.
        if (up && !g_splashUpOverflow) {
            if (g_splashUpBytes + u.currentSize > (uint32_t)DISPLAY_SPLASH_MAX_BYTES) {
                // (стеля сирого формату; для JPEG діє менша — перевіряється
                //  після приймання, коли вже відомий тип файла)
                g_splashUpOverflow = true;
                up.close(); up = File();
                SPIFFS.remove(DISPLAY_SPLASH_PATH ".tmp");
                Serial.println("Splash: файл більший за стелю — приймання припинено");
            } else {
                up.write(u.buf, u.currentSize);
                g_splashUpBytes += u.currentSize;
            }
        }

    } else if (u.status == UPLOAD_FILE_END) {
        if (up) { up.flush(); up.close(); delay(30); }
        Serial.printf("Splash upload finished (%lu bytes)\n", (unsigned long)g_splashUpBytes);

    } else if (u.status == UPLOAD_FILE_ABORTED) {
        if (up) up.close();
        SPIFFS.remove(DISPLAY_SPLASH_PATH ".tmp");
        Serial.println("Splash upload aborted!");
    }
}

void handleUploadSplashDone() {
    if (g_splashUpOverflow) {
        char m[160];
        snprintf(m, sizeof(m),
                 "{\"status\":\"error\",\"message\":\"Файл більший за стелю %lu байтів\"}",
                 (unsigned long)DISPLAY_SPLASH_MAX_BYTES);
        server.send(400, "application/json", m);
        return;
    }
    if (!SPIFFS.exists(DISPLAY_SPLASH_PATH ".tmp")) {
        server.send(400, "application/json",
                    "{\"status\":\"error\",\"message\":\"Файл не прийнято\"}");
        return;
    }

    // Перевіряємо ТИМЧАСОВИЙ файл тим самим розбором, що й дисплей. Один код
    // на приймання й на показ — інакше рано чи пізно приймальник почне
    // пропускати те, чого дисплей не покаже.
    File f = SPIFFS.open(DISPLAY_SPLASH_PATH ".tmp", "r");
    uint8_t hdr[SPLASH_HDR_BYTES];
    size_t  nHdr = f ? f.read(hdr, sizeof(hdr)) : 0;
    size_t  sz   = f ? f.size() : 0;
    uint16_t w = 0, h = 0;
    // ⚑ ТИП — ЗА МАГІЄЮ, а не за розширенням чи полем форми: розширення
    //  бреше, перші байти — ні.
    int kind = splashSniff(hdr, nHdr);
    if (f) f.close();

#ifdef DISPLAY_SPLASH_JPEG
    if (kind == SPLASH_KIND_JPEG) {
        // Для JPEG діє власна, менша стеля: сенс формату — саме економія
        // місця, і файл на сотні кілобайтів означає або фотографію в повній
        // роздільності, або взагалі не те, що мали на увазі.
        if (sz > (size_t)DISPLAY_SPLASH_JPG_MAX_BYTES) {
            SPIFFS.remove(DISPLAY_SPLASH_PATH ".tmp");
            char m[180];
            snprintf(m, sizeof(m),
                     "{\"status\":\"error\",\"message\":\"JPEG більший за %lu КБ — стисніть сильніше\"}",
                     (unsigned long)DISPLAY_SPLASH_JPG_MAX_BYTES / 1024UL);
            server.send(400, "application/json", m);
            return;
        }
        // Розміри питаємо в декодера, не декодуючи кадр цілком. Це ще й
        // перевірка «а чи це справді JPEG»: магія збігтись може випадково,
        // а розібрати заголовок сміття декодер не зможе.
        uint16_t jw = 0, jh = 0;
        if (TJpgDec.getFsJpgSize(&jw, &jh, DISPLAY_SPLASH_PATH ".tmp", SPIFFS) != JDR_OK) {
            SPIFFS.remove(DISPLAY_SPLASH_PATH ".tmp");
            server.send(400, "application/json",
                        "{\"status\":\"error\",\"message\":\"Файл починається як JPEG, але декодер його не розібрав\"}");
            return;
        }
        // ⚑ ЗАВЕЛИКЕ НЕ ВІДХИЛЯЄМО — пристрій зменшить сам, кратно 2, зі
        //  збереженням пропорцій (splashJpegScaleFor у splash.h). Відмова
        //  лишається тільки там, де не рятує навіть /8.
        uint8_t sc = splashJpegScaleFor(jw, jh, TFT_W, TFT_H);
        if (!sc) {
            SPIFFS.remove(DISPLAY_SPLASH_PATH ".tmp");
            char m[240];
            snprintf(m, sizeof(m),
                     "{\"status\":\"error\",\"message\":\"JPEG %ux%u більший за екран %dx%d понад увосьмеро — "
                     "зменшити кратно 2 вже не вийде. Зменште зображення заздалегідь\"}",
                     jw, jh, (int)TFT_W, (int)TFT_H);
            server.send(400, "application/json", m);
            return;
        }
        // Приймаємо. Інший формат прибираємо: два файли поруч означали б, що
        // «поточна заставка» — питання порядку перевірок, а не вибору людини.
        if (SPIFFS.exists(DISPLAY_SPLASH_JPG_PATH)) SPIFFS.remove(DISPLAY_SPLASH_JPG_PATH);
        if (!SPIFFS.rename(DISPLAY_SPLASH_PATH ".tmp", DISPLAY_SPLASH_JPG_PATH)) {
            SPIFFS.remove(DISPLAY_SPLASH_PATH ".tmp");
            server.send(500, "application/json",
                        "{\"status\":\"error\",\"message\":\"Не вдалося зберегти у SPIFFS\"}");
            return;
        }
        if (SPIFFS.exists(DISPLAY_SPLASH_PATH)) SPIFFS.remove(DISPLAY_SPLASH_PATH);
        uint16_t dw = splashScaled(jw, sc), dh = splashScaled(jh, sc);
        Serial.printf("Splash JPEG збережено: %ux%u, %u байтів%s\n", jw, jh, (unsigned)sz,
                      sc == 1 ? "" : " (буде зменшено при показі)");
        char m[300];
        snprintf(m, sizeof(m),
                 "{\"status\":\"success\",\"kind\":\"jpeg\",\"w\":%u,\"h\":%u,\"scale\":%u,\"bytes\":%u,"
                 "\"message\":\"JPEG %ux%u збережено%s — буде видно при наступному запуску\"}",
                 dw, dh, sc, (unsigned)sz, jw, jh,
                 sc == 1 ? "" : " і буде зменшено до розміру екрана (пропорції збережено)");
        server.send(200, "application/json", m);
        return;
    }
#else
    if (kind == SPLASH_KIND_JPEG) {
        SPIFFS.remove(DISPLAY_SPLASH_PATH ".tmp");
        server.send(400, "application/json",
                    "{\"status\":\"error\",\"message\":\"Ця прошивка зібрана без підтримки JPEG "
                    "(DISPLAY_SPLASH_JPEG). Надішліть підготовлений .bin\"}");
        return;
    }
#endif

    int rc = splashParse(hdr, nHdr, sz, TFT_W, TFT_H, &w, &h);
    if (rc != SPLASH_OK) {
        SPIFFS.remove(DISPLAY_SPLASH_PATH ".tmp");
        char m[220];
        snprintf(m, sizeof(m),
                 "{\"status\":\"error\",\"message\":\"%s (екран %dx%d)\"}",
                 splashErrText(rc), (int)TFT_W, (int)TFT_H);
        Serial.printf("Splash ВІДХИЛЕНО: %s (%u байтів)\n", splashErrText(rc), (unsigned)sz);
        server.send(400, "application/json", m);
        return;
    }

    // Аж тепер підміняємо бойовий файл — і прибираємо інший формат, щоб
    // «поточна заставка» не залежала від порядку перевірок при показі.
    if (SPIFFS.exists(DISPLAY_SPLASH_PATH)) SPIFFS.remove(DISPLAY_SPLASH_PATH);
#ifdef DISPLAY_SPLASH_JPEG
    if (SPIFFS.exists(DISPLAY_SPLASH_JPG_PATH)) SPIFFS.remove(DISPLAY_SPLASH_JPG_PATH);
#endif
    if (!SPIFFS.rename(DISPLAY_SPLASH_PATH ".tmp", DISPLAY_SPLASH_PATH)) {
        SPIFFS.remove(DISPLAY_SPLASH_PATH ".tmp");
        server.send(500, "application/json",
                    "{\"status\":\"error\",\"message\":\"Не вдалося зберегти у SPIFFS\"}");
        return;
    }

    Serial.printf("Splash збережено: %ux%u, %u байтів\n", w, h, (unsigned)sz);
    char m[200];
    snprintf(m, sizeof(m),
             "{\"status\":\"success\",\"w\":%u,\"h\":%u,\"bytes\":%u,"
             "\"message\":\"Заставку збережено — буде видно при наступному запуску\"}",
             w, h, (unsigned)sz);
    server.send(200, "application/json", m);
}

// Стан заставки: чи є файл, які розміри, скільки місця лишилось.
void handleSplashInfo() {
    uint16_t w = 0, h = 0; size_t sz = 0; int rc = SPLASH_ERR_SHORT;
    const char *kind = "none";
    bool present = false;
#ifdef DISPLAY_SPLASH_JPEG
    if (SPIFFS.exists(DISPLAY_SPLASH_JPG_PATH)) {
        present = true; kind = "jpeg";
        File jf = SPIFFS.open(DISPLAY_SPLASH_JPG_PATH, "r");
        if (jf) { sz = jf.size(); jf.close(); }
        uint16_t jw = 0, jh = 0;
        uint8_t sc = 0;
        if (TJpgDec.getFsJpgSize(&jw, &jh, DISPLAY_SPLASH_JPG_PATH, SPIFFS) == JDR_OK &&
            (sc = splashJpegScaleFor(jw, jh, TFT_W, TFT_H)) != 0) {
            w = splashScaled(jw, sc); h = splashScaled(jh, sc); rc = SPLASH_OK;
        } else rc = SPLASH_ERR_MAGIC;
    } else
#endif
    if (SPIFFS.exists(DISPLAY_SPLASH_PATH)) {
        present = true; kind = "raw";
        File f = SPIFFS.open(DISPLAY_SPLASH_PATH, "r");
        if (f) {
            uint8_t hdr[SPLASH_HDR_BYTES];
            size_t n = f.read(hdr, sizeof(hdr));
            sz = f.size();
            rc = splashParse(hdr, n, sz, TFT_W, TFT_H, &w, &h);
            f.close();
        }
    }
    size_t total = SPIFFS.totalBytes(), used = SPIFFS.usedBytes();
#ifdef DISPLAY_SPLASH_JPEG
    const bool jpegOk = true;
    const unsigned long jpgMax = (unsigned long)DISPLAY_SPLASH_JPG_MAX_BYTES;
#else
    const bool jpegOk = false;
    const unsigned long jpgMax = 0;
#endif
    char j[420];
    snprintf(j, sizeof(j),
             "{\"present\":%s,\"ok\":%s,\"kind\":\"%s\",\"jpeg\":%s,"
             "\"w\":%u,\"h\":%u,\"bytes\":%u,"
             "\"panelW\":%d,\"panelH\":%d,\"maxBytes\":%lu,\"jpgMaxBytes\":%lu,"
             "\"fsFree\":%lu,\"err\":\"%s\"}",
             present ? "true" : "false",
             rc == SPLASH_OK ? "true" : "false",
             kind, jpegOk ? "true" : "false",
             w, h, (unsigned)sz, (int)TFT_W, (int)TFT_H,
             (unsigned long)DISPLAY_SPLASH_MAX_BYTES, jpgMax,
             (unsigned long)(total > used ? total - used : 0),
             rc == SPLASH_OK ? "" : splashErrText(rc));
    server.send(200, "application/json", j);
}

// Прибрати завантажену заставку — повернутись до типової.
void handleSplashDelete() {
    bool had = SPIFFS.exists(DISPLAY_SPLASH_PATH);
    if (had) SPIFFS.remove(DISPLAY_SPLASH_PATH);
#ifdef DISPLAY_SPLASH_JPEG
    if (SPIFFS.exists(DISPLAY_SPLASH_JPG_PATH)) { SPIFFS.remove(DISPLAY_SPLASH_JPG_PATH); had = true; }
#endif
    SPIFFS.remove(DISPLAY_SPLASH_PATH ".tmp");
    server.send(200, "application/json",
                had ? "{\"status\":\"success\",\"message\":\"Заставку прибрано — буде типова\"}"
                    : "{\"status\":\"success\",\"message\":\"Завантаженої заставки не було\"}");
}
#endif  // DISPLAY_SPLASH_SPIFFS

// обробник запиту /upload2438 (fn): надсилає відповідь після приймання файлу.
void handleUploadDone2438() {
    if (SPIFFS.exists("/upload2438.bin")) {
        File file = SPIFFS.open("/upload2438.bin", "r");
        size_t size = file ? file.size() : 0;
        if (file) file.close();

        if (size == DS2438_MEM_SIZE) {
            server.send(200, "application/json", "{\"status\":\"success\",\"message\":\"File uploaded\"}");
            return;
        }
        Serial.printf("DS2438 upload size mismatch: %d bytes (expected %d)\n", size, DS2438_MEM_SIZE);
        server.send(400, "application/json", "{\"status\":\"error\",\"message\":\"Invalid file size\"}");
        return;
    }
    server.send(500, "application/json", "{\"status\":\"error\",\"message\":\"Upload failed\"}");
}

// Обробник записи дампа в DS2438
void handleWriteDump2438() {
    if (!requireAdmin()) return;

    Serial.println("\n=== DS2438 write request received ===");

    if (!SPIFFS.exists("/upload2438.bin")) {
        server.send(400, "application/json", "{\"status\":\"error\",\"message\":\"No file uploaded\"}");
        return;
    }

    File file = SPIFFS.open("/upload2438.bin", "r");
    if (!file) {
        server.send(400, "application/json", "{\"status\":\"error\",\"message\":\"No file uploaded\"}");
        return;
    }

    size_t fileSize = file.size();
    if (fileSize != DS2438_MEM_SIZE) {
        file.close();
        Serial.printf("DS2438 invalid file size: %d (expected %d)\n", fileSize, DS2438_MEM_SIZE);
        server.send(400, "application/json", "{\"status\":\"error\",\"message\":\"Invalid file size\"}");
        return;
    }

    uint8_t buffer[DS2438_MEM_SIZE];
    memset(buffer, 0, DS2438_MEM_SIZE);
    file.seek(0);
    size_t bytesRead = file.read(buffer, DS2438_MEM_SIZE);
    file.close();

    if (bytesRead != DS2438_MEM_SIZE) {
        server.send(400, "application/json", "{\"status\":\"error\",\"message\":\"Failed to read uploaded file\"}");
        return;
    }

    Serial.println("Writing to DS2438 chip...");
    ledSet(LED_WRITE);
    displayShow("ЗАПИС 2438...");
    if (battery.writeDS2438(buffer, DS2438_MEM_SIZE)) {
        memcpy(batteryDump2438, buffer, DS2438_MEM_SIZE);
        hasDump2438 = true;
        saveDump("/dump2438.bin", buffer, DS2438_MEM_SIZE);

        Serial.println("✓✓✓ DS2438 WRITE SUCCESSFUL ✓✓✓");
        displayShow("2438 ЗАПИС OK");
        server.send(200, "application/json", "{\"status\":\"success\",\"message\":\"DS2438 written successfully\"}");

        ledSet(LED_OK);
    } else {
        Serial.println("✗✗✗ DS2438 WRITE FAILED ✗✗✗");
        displayShow("2438 ЗАПИС ЗБІЙ");
        server.send(500, "application/json", "{\"status\":\"error\",\"message\":\"Failed to write DS2438\"}");
        ledSet(LED_ERROR);
    }
    Serial.println("=== DS2438 write request completed ===\n");
}

// Інформація о DS2438: превью + розшифровані напруга/температура (стр. 0).
void handleDumpInfo2438() {
    if (!hasDump2438) {
        server.send(404, "application/json", "{\"status\":\"error\",\"message\":\"No dump available\"}");
        return;
    }

    // Сторінка 0: [1]=Temp LSB, [2]=Temp MSB, [3]=V LSB, [4]=V MSB, [5]=I LSB, [6]=I MSB
    uint16_t vraw = ((uint16_t)batteryDump2438[4] << 8) | batteryDump2438[3];
    float voltage = vraw * 0.01f; // 10 мВ/LSb

    int16_t traw = ((int16_t)((batteryDump2438[2] << 8) | batteryDump2438[1])) >> 3; // 13-біт
    float temperature = traw * 0.03125f; // °C/LSb

    int16_t current = (int16_t)((batteryDump2438[6] << 8) | batteryDump2438[5]); // сире значення

    // ⚑ Шунт беремо З ЧИПА (DS2438[56..57]), а не з константи. У пакетів
    // PMNN4409A/B він ~45.2..46.1 мОм, у 4488A/4493A/4809A ~24.9..25.6 мОм —
    // тобто єдина константа 0.025 Ом занижувала опір і завищувала струм і
    // мА·год майже вдвічі на всій родині 4409. Перевірено проти показань
    // фірмового ПЗ Motorola (див. impres_bms.h).
    const ImpresBms &bms = impresBmsOf(hasDump ? batteryDump : nullptr,
                                       batteryDump2438,
                                       hasSN2433 ? chipSN2433 : nullptr,
                                       DS2438_RSENSE_OHM);
    float rs = bms.rsense > 0.0f ? bms.rsense : DS2438_RSENSE_OHM;

    float    i_mA = (float)current / (4096.0f * rs) * 1000.0f;
    uint8_t  ica  = batteryDump2438[12];
    uint16_t cca  = ((uint16_t)batteryDump2438[61] << 8) | batteryDump2438[60];
    uint16_t dca  = ((uint16_t)batteryDump2438[63] << 8) | batteryDump2438[62];

    const char *csrc;
    int charge = batteryPercent(&csrc);

    String serial = "";
    if (hasSN2438) {
        char b[3];
        for (int i = 0; i < 8; i++) { sprintf(b, "%02X", chipSN2438[i]); serial += b; }
    }

    String json = "{\"size\":64,\"hasData\":true";
    json += ",\"voltage\":" + String(voltage, 2);
    json += ",\"temperature\":" + String(temperature, 1);
    json += ",\"currentRaw\":" + String(current);
    json += ",\"currentMa\":" + String(i_mA, 0);
    json += ",\"ica\":" + String(ica);
    json += ",\"cca\":" + String(cca);
    json += ",\"dca\":" + String(dca);
    // Паспортна ємність — ЗА МОДЕЛЛЮ (таблиця IMPRES_RATED в impres_format.h),
    // а не одна константа на всі АКБ. Через єдину BATTERY_RATED_MAH=2500 цикли
    // й залишок у мА·год не збігалися з тим, що показує станція, на всіх
    // моделях, крім однієї.
    char rmModel[16] = "";
    decodeModel(rmModel, sizeof(rmModel));
    int ratedMah = impresRatedMahFor(hasDump ? batteryDump : nullptr, rmModel);
    json += ",\"icaMah\":" + String(impresIcaToMahRs((uint8_t)ica, ratedMah, rs));
    // Ціна розряду CCA/DCA — 15.625 мВ·год, а НЕ 0.4882 як у ICA (даташит
    // DS2438). Раніше тут стояла константа ICA, і накопичений заряд виходив
    // у 32 рази меншим за дійсний.
    json += ",\"ccaMah\":" + String(bms.ccaMah);
    json += ",\"dcaMah\":" + String(bms.dcaMah);
    json += ",\"ccaCycles\":" + String((int)(bms.ccaMah / ratedMah));
    json += ",\"dcaCycles\":" + String((int)(bms.dcaMah / ratedMah));
    json += ",\"rsense\":" + String(rs, 5);
    json += ",\"rsenseChip\":" + String(bms.rsenseFromChip ? 1 : 0);
    json += ",\"ratedMah\":" + String(ratedMah);
    json += ",\"charge\":" + String(charge);
    json += ",\"chargeSrc\":\"" + String(csrc) + "\"";
    // Шкала «заряд за напругою» — з пристрою, щоб клієнти не тримали власних
    // копій чисел і не брехали в підписах після зміни BATTERY_EMPTY_MV.
    json += ",\"emptyMv\":" + String(BATTERY_EMPTY_MV);
    json += ",\"fullMv\":"  + String(BATTERY_FULL_MV);
    json += ",\"scaleTxt\":\"" BATTERY_SCALE_TXT "\"";
    // ⚑ Ім'я силової частини теж віддає ПРИСТРІЙ. Клієнти тримали його
    //  рядком у себе («PNP B772M»), і після заміни на P-MOSFET усі троє
    //  почали називати чуже залізо. Тепер назва одна — з settings.h.
    //  А з появою другої топології туди ж переїхав і ВЕСЬ опис: на платі
    //  TL494 в клієнтському абзаці про дросель і шунт неправдою є кожне
    //  слово, тож писати його в клієнті стало неможливо в принципі.
    json += ",\"swName\":\"" CHARGE_STAGE_NAME "\"";
    json += ",\"chgHwTxt\":\"" CHARGE_STAGE_TXT "\"";
    // Яким радіо прилад зараз розмовляє. Клієнт, який це бачить, не буде
    // шукати причину, чому пристрій зник із Wi-Fi після перемикання.
    json += ",\"radio\":\""; json += radioModeName(radioMode()); json += "\"";
    json += ",\"radioSwitchable\":"; json += radioSwitchable() ? "true" : "false";
    // ⚑ ІМ'Я В ЕФІРІ — ТЕЖ ІЗ ПРИЛАДУ. Windows підписує послідовний порт
    //  Bluetooth однаково для всіх — «Standard Serial over Bluetooth link», —
    //  і в списку портів наш прилад нічим не відрізняється від будь-якого
    //  іншого спареного пристрою. Ім'я знає лише сам прилад, тож він його й
    //  каже; клієнт запам'ятовує його за адресою і підписує порт наступного разу.
    #ifdef BT_ENABLED
    json += ",\"btName\":\""; json += btName(); json += "\"";
    #else
    json += ",\"btName\":\"\"";
    #endif
    // ETM (DS2438[8..11], сек наробітку). Рація показує «дату першого користування»
    // як (свій поточний час − ETM) — перевірено діффом до/після калібрування.
    uint32_t etm = ((uint32_t)batteryDump2438[11] << 24) | ((uint32_t)batteryDump2438[10] << 16) |
                   ((uint32_t)batteryDump2438[9] << 8) | batteryDump2438[8];
    json += ",\"etmSec\":" + String(etm);
    json += ",\"serial\":\"" + serial + "\"";
    if (hasSN2433) {
        char b[3]; String s33 = "";
        for (int i = 0; i < 8; i++) { sprintf(b, "%02X", chipSN2433[i]); s33 += b; }
        json += ",\"serial33\":\"" + s33 + "\"";
    }
    // ── штатні поля Motorola (impres_bms.h) ────────────────────────────────
    //  cycles     — цикли заряду IMPRES; рахуються з гістограми і ключа НЕ
    //               потребують: саме це число показує фірмове ПЗ.
    //  решта      — зашифровані; ключ або з ROM DS2433, або підібраний.
    if (bms.ok) {
        json += ",\"bms\":{\"kit\":\"" + String(bms.kit) + "\"";
        json += ",\"cycles\":" + String(bms.cycles);
        json += ",\"nonImpresCycles\":" + String(bms.nonImpresCycles);
        // ⚑ НАРОБІТОК, ЗАПИСАНИЙ У САМОМУ ПАКЕТІ. Ці два числа лежать у DS2433
        //  (блок NONSMART, зсуви +3 і +5) у тих самих сирих одиницях, що й
        //  монітор, — і саме звідти зарядна станція відновлює лічильники
        //  DS2438 після кожного сеансу. Доти їх не було видно НІДЕ, і питання
        //  «чому після скидання цикли повернулись» доводилось з'ясовувати за
        //  hex-дампом. Тепер видно очима: після скидання тут мусять бути нулі,
        //  а якщо після зарядки знову з'явились числа — станція взяла їх тут.
        {
            uint16_t hC = 0, hD = 0;
            if (impresBmsHistCounters(batteryDump, &hC, &hD)) {
                json += ",\"histCca\":" + String(hC);
                json += ",\"histDca\":" + String(hD);
            }
        }
        json += ",\"haveKey\":" + String(bms.haveKey ? 1 : 0);
        json += ",\"keyGuessed\":" + String(bms.keyGuessed ? 1 : 0);
        if (bms.haveKey) {
            json += ",\"health\":" + String(bms.health);
            json += ",\"potentialMah\":" + String(bms.potentialMah);
            json += ",\"firstUseMah\":" + String(bms.firstUseMah);
            json += ",\"cyclesEnc\":" + String(bms.cyclesEnc);
            json += ",\"calCycles\":" + String(bms.calCycles);
            json += ",\"reverts\":" + String(bms.reverts);
            json += ",\"topOffCycles\":" + String(bms.topOffCycles);
            // ⚑ НЕПРАВДОПОДІБНУ ДАТУ НЕ ВІДДАЄМО ЯК ДАТУ. Блок DATE
            //  розшифровується ключем із ROM, і коли він побитий (або чип
            //  прошито чужим інструментом), звідти виходить, приміром,
            //  «2072-14-22» — місяць 14, день 22. Показати таке значенням
            //  означає видати сміття за факт: людина побачить дату й почне з
            //  неї міркувати. Клієнту йде окремий прапорець, а сама дата — ні.
            bool mfgOk = impresBmsDateSane(bms.mfgY, bms.mfgM, bms.mfgD);
            json += ",\"mfgDateOk\":" + String(mfgOk ? 1 : 0);
            char d[12];
            if (mfgOk) {
                snprintf(d, sizeof(d), "%04d-%02d-%02d", bms.mfgY, bms.mfgM, bms.mfgD);
                json += ",\"mfgDate\":\"" + String(d) + "\"";
            }
            // ⚑ І ДРУГА ПОЛОВИНА ТІЄЇ Ж БІДИ. Дата першого користування
            //  рахується ВІД дати виготовлення, тож при побитій даті вона
            //  просто не рахується. Клієнт показував тоді «пакет ще не
            //  вмикався» — а це зовсім інше твердження, і хибне: пакет із
            //  1421 циклом вмикали, і не раз. Розрізняємо явно.
            json += ",\"firstUseKnown\":" + String(bms.useY ? 1 : 0);
            if (bms.useY) {
                snprintf(d, sizeof(d), "%04d-%02d-%02d", bms.useY, bms.useM, bms.useD);
                json += ",\"firstUseDate\":\"" + String(d) + "\"";
            }
        }
        json += "}";
    }
    json += ",\"preview\":\"" + hexPreview(batteryDump2438, 16) + "\"";
    json += ",\"hex\":\"" + hexPreview(batteryDump2438, 64) + "\"";
    json += "}";

    server.send(200, "application/json", json);
}

// обробник завантаження файлу - перероблений для коректної роботи з ESP32 WebServer
void handleUploadDump() {
    static File uploadFile;
    static size_t uploadedBytes = 0;
    
    HTTPUpload &upload = server.upload();
    
    if (upload.status == UPLOAD_FILE_START) {
        Serial.printf("\n=== Upload started: %s ===\n", upload.filename.c_str());
        
        // Перевіряємо вільне місце
        size_t totalBytes = SPIFFS.totalBytes();
        size_t usedBytes = SPIFFS.usedBytes();
        size_t freeBytes = totalBytes - usedBytes;
        
        Serial.printf("SPIFFS Status: Total=%d, Used=%d, Free=%d\n", totalBytes, usedBytes, freeBytes);
        
        // Закриваємо старий файл якщо він еще відкритий
        if (uploadFile) {
            uploadFile.close();
            delay(50);
        }
        
        // Видаляємо старий файл
        if (SPIFFS.exists("/upload.bin")) {
            SPIFFS.remove("/upload.bin");
            delay(100);
        }
        
        // Відкриваємо новий файл
        uploadFile = SPIFFS.open("/upload.bin", "w");
        if (!uploadFile) {
            Serial.println("CRITICAL ERROR: Cannot create /upload.bin!");
            return;
        }
        
        uploadedBytes = 0;
        Serial.println("Upload file opened");
        
    } else if (upload.status == UPLOAD_FILE_WRITE) {
        if (!uploadFile) {
            Serial.println("ERROR: Upload file not open!");
            return;
        }
        
        // Пишемо дані в файл
        size_t written = uploadFile.write(upload.buf, upload.currentSize);
        uploadedBytes += written;
        
        Serial.printf("Chunk received: %d bytes, written: %d bytes (total: %d)\n", 
                     upload.currentSize, written, uploadedBytes);
        
        if (written != upload.currentSize) {
            Serial.printf("ERROR: Write mismatch! Expected %d, wrote %d\n", 
                         upload.currentSize, written);
        }
        
    } else if (upload.status == UPLOAD_FILE_END) {
        if (uploadFile) {
            uploadFile.flush();
            uploadFile.close();
            delay(200);  // Критична затримка для синхронізації SPIFFS
            
            Serial.printf("Upload finished: %s (%d bytes total)\n", 
                         upload.filename.c_str(), uploadedBytes);
            
            // Перевіряємо результат
            delay(100);
            if (SPIFFS.exists("/upload.bin")) {
                File file = SPIFFS.open("/upload.bin", "r");
                if (file) {
                    size_t size = file.size();
                    Serial.printf("✓ File created: %d bytes\n", size);
                    
                    // Перевіряємо перші байти
                    uint8_t header[16];
                    file.seek(0);
                    size_t read = file.read(header, 16);
                    Serial.printf("Header (%d bytes): ", read);
                    for (int i = 0; i < read; i++) {
                        Serial.printf("%02X ", header[i]);
                    }
                    Serial.println();
                    
                    file.close();
                } else {
                    Serial.println("✗ Cannot open /upload.bin for verification");
                }
            } else {
                Serial.println("✗ CRITICAL: File not found in SPIFFS!");
            }
            
            Serial.println("=== Upload completed ===\n");
        }
        // Відповідь надсилає handleUploadDone() (обробник запиту), а не upload-колбек.

    } else if (upload.status == UPLOAD_FILE_ABORTED) {
        if (uploadFile) {
            uploadFile.close();
        }
        Serial.println("Upload aborted!");
    }
}

// обробник запиту /upload (fn): викликається після того, як upload-колбек
// (ufn) повністю прийняв тело multipart-форми. Надсилає HTTP-відповідь.
void handleUploadDone() {
    if (SPIFFS.exists("/upload.bin")) {
        File file = SPIFFS.open("/upload.bin", "r");
        size_t size = file ? file.size() : 0;
        if (file) file.close();

        if (size == DUMP_SIZE) {
            server.send(200, "application/json", "{\"status\":\"success\",\"message\":\"File uploaded\"}");
            return;
        }
        Serial.printf("Upload size mismatch: %d bytes (expected %d)\n", size, DUMP_SIZE);
        server.send(400, "application/json", "{\"status\":\"error\",\"message\":\"Invalid file size\"}");
        return;
    }
    server.send(500, "application/json", "{\"status\":\"error\",\"message\":\"Upload failed\"}");
}

// Обробник записи дампа
void handleWriteDump() {
    // Перевіряємо пароль
    if (!requireAdmin()) return;
    
    Serial.println("\n=== Write request received ===");
    
    // Перевіряємо наявність файлу
    if (!SPIFFS.exists("/upload.bin")) {
        Serial.println("✗ /upload.bin does not exist - upload a file first");
        server.send(400, "application/json", "{\"status\":\"error\",\"message\":\"No file uploaded\"}");
        return;
    }
    
    // Відкриваємо і перевіряємо розмір
    File file = SPIFFS.open("/upload.bin", "r");
    if (!file) {
        Serial.println("✗ Cannot open /upload.bin");
        server.send(400, "application/json", "{\"status\":\"error\",\"message\":\"No file uploaded\"}");
        return;
    }
    
    size_t fileSize = file.size();
    Serial.printf("File size: %d bytes (expected: %d bytes)\n", fileSize, DUMP_SIZE);
    
    if (fileSize != DUMP_SIZE) {
        file.close();
        Serial.printf("✗ Invalid file size\n");
        server.send(400, "application/json", "{\"status\":\"error\",\"message\":\"Invalid file size\"}");
        return;
    }
    
    // Читаємо весь файл в буфер
    uint8_t buffer[DUMP_SIZE];
    memset(buffer, 0, DUMP_SIZE);
    
    file.seek(0);
    size_t bytesRead = file.read(buffer, DUMP_SIZE);
    file.close();
    
    Serial.printf("Bytes read: %d\n", bytesRead);
    
    if (bytesRead != DUMP_SIZE) {
        Serial.printf("✗ Read mismatch! Expected %d, got %d\n", DUMP_SIZE, bytesRead);
        server.send(400, "application/json", "{\"status\":\"error\",\"message\":\"Failed to read uploaded file\"}");
        return;
    }
    
    // Виводимо перші байти
    Serial.printf("Data: ");
    for (int i = 0; i < 16; i++) {
        Serial.printf("%02X ", buffer[i]);
    }
    Serial.println();
    
    // Пишемо в батарею
    Serial.println("Writing to battery chip...");
    ledSet(LED_WRITE);
    displayShow("ЗАПИС 2433...");
    if (battery.writeBattery(buffer, DUMP_SIZE)) {
        memcpy(batteryDump, buffer, DUMP_SIZE);
        hasDump = true;
        
        // Зберігаємо як поточний дамп
        SPIFFS.remove("/dump.bin");
        delay(50);
        File dumpFile = SPIFFS.open("/dump.bin", "w");
        if (dumpFile) {
            size_t written = dumpFile.write(buffer, DUMP_SIZE);
            dumpFile.flush();
            dumpFile.close();
            delay(50);
            Serial.printf("Current dump saved: %d bytes\n", written);
        }
        
        Serial.println("✓✓✓ WRITE SUCCESSFUL ✓✓✓");
        displayShow("2433 ЗАПИС OK");
        server.send(200, "application/json", "{\"status\":\"success\",\"message\":\"Firmware written successfully\"}");
        
        // Індикація успіху
        ledSet(LED_OK);
    } else {
        Serial.println("✗✗✗ WRITE FAILED ✗✗✗");
        displayShow("2433 ЗАПИС ЗБІЙ");
        server.send(500, "application/json", "{\"status\":\"error\",\"message\":\"Failed to write battery\"}");
        ledSet(LED_ERROR);
    }
    Serial.println("=== Write request completed ===\n");
}

// Обробник інформації о дампі
void handleDumpInfo() {
    if (!hasDump) {
        server.send(404, "application/json", "{\"status\":\"error\",\"message\":\"No dump available\"}");
        return;
    }
    
    char model[24];
    String modelStr = decodeModel(model, sizeof(model)) ? String(model) : String("");
    int cap = -1, wear = -1;
    decodeCapacity(&cap, &wear);

    const char *reason;
    bool genuine = batteryGenuine(&reason);

    bool hdrOk = headerChecksumOk(batteryDump);
    bool mirOk = hasDump2438 ? mirrorOk(batteryDump, batteryDump2438) : true;

    String json = "{\"size\":512,\"hasData\":true";
    json += ",\"model\":\"" + modelStr + "\"";
    json += ",\"capacity\":" + String(cap);
    json += ",\"wear\":" + String(wear);
    json += ",\"genuine\":" + String(genuine ? "true" : "false");
    json += ",\"authReason\":\"" + String(reason) + "\"";
    json += ",\"headerOk\":" + String(hdrOk ? "true" : "false");
    json += ",\"mirrorOk\":" + String(mirOk ? "true" : "false");
    // Друга 32-байтна сума (блок профілю моделі) і запис COPYRIGHT — раніше не
    // перевірялись узагалі. copyright: "ok" / "broken" / "none" (немає — це
    // норма для 4409A та APLI4810C, вони його штатно не мають).
    json += ",\"profileOk\":" + String(impresProfileOk(batteryDump) ? "true" : "false");
    json += ",\"copyright\":\"" + String(!impresHasCopyright(batteryDump) ? "none"
                                       : impresRecordOk(batteryDump, IMPRES_COPYRIGHT) ? "ok"
                                       : "broken") + "\"";
    // Стан навченого калібрувального хвоста 0x18A..0x1FF — ключове поле для
    // ремонту після заміни елементів (див. impres_format.h).
    { int t = impresTailState(batteryDump);
      json += ",\"tail\":\"" + String(t == IMPRES_TAIL_BLANK ? "blank"
                                    : t == IMPRES_TAIL_FRESH ? "fresh"
                                    : t == IMPRES_TAIL_VALID ? "learned" : "broken") + "\""; }
    json += ",\"preview\":\"";
    
    json += hexPreview(batteryDump, 16);
    json += "\",\"hex\":\"" + hexPreview(batteryDump, DUMP_SIZE) + "\"}";

    server.send(200, "application/json", json);
}

// Скидання лічильників використання / зносу для рекалібрування на оригінальної ЗУ.
// Обнуляє РЕАЛЬНІ лічильники використання: CCA/DCA/ETM у DS2438 і скидає
// відображувану ємність (0x17) на 100% (знос 0). Контрольні суми зачеплених
// записів перераховуються (Σ==0x5A).
//
// ⚠️ ВАЖЛИВО: запис 0x0D у DS2433 НЕ чіпаємо. Раніше тут обнулялись байти
// [+4..+7] запису 0x0D як «дзеркало CCA/DCA» — це була ПОМИЛКА: звірка з
// еталоном PMNN4409A показала, що там лежить КАЛІБРУВАННЯ ЄМНОСТІ
// (напр. 0x09B7=2487 ≈ мА·год), а не лічильники (у відкаліброваного дампа з
// CCA=2310 там було 6, тобто це не CCA). Обнуління ламало калібрування —
// рація казала «невідома», а зарядка бачила «заряджений» і не заряджала.
//
// ⚑ І ГОЛОВНЕ — СКИДАННЯ ТЕПЕР УЗГОДЖЕНЕ МІЖ ДВОМА ЧИПАМИ.
//  Скарга власника: «повністю робочий акумулятор після обнулення лічильників,
//  напрацювання, вироблення перестає бачитись як оригінальний». Причина була
//  саме тут. Ми обнуляли лічильники ЛИШЕ в DS2438, а DS2433 лишався як був —
//  із датою першого користування, з гістограмою на сотні циклів, із
//  лічильником калібрувань. Пакет після цього розповідав про себе дві
//  несумісні речі одночасно:
//
//      DS2433: «мене вмикали тоді-то, я пройшов 1097 циклів»
//      DS2438: «я не пропрацював жодної секунди й не прийняв жодного мА·год»
//
//  Такого пакета не буває. У корпусі dumps/ з 52 цілих фірмових ETM дорівнює
//  нулю рівно у ДВОХ — обидва з 08-nova-batareya, тобто саме з того випадку,
//  коли рація сказала «невідомий акумулятор»; у решти 50 напрацювання — сотні
//  мільйонів секунд. Провал 08 списували на чужий навчений хвіст, і це теж
//  правда, але дефекту там два, і другий — оцей.
//
//  Тепер обнуляємо ОБИДВА боки або жоден: історію в DS2433 скидає
//  impresHistoryZero() під ключем ЦЬОГО чипа (impres_crypt.h), зберігаючи дату
//  виготовлення — вона справжня й одна-єдина, затирати її нема за що.
//
//  ⚠️ Без ROM-ID чипа зашифровану історію переписати нічим. Тоді не чіпаємо
//  НІЧОГО: пакет із просто старими лічильниками нікому не шкодить, а пакет із
//  розсинхронізованими чипами рація відкидає. Повертає false — викликач мусить
//  сказати про це користувачеві, а не вдавати успіх.
bool resetBatteryData() {
    // Спершу з'ясовуємо, чи зможемо привести до ладу DS2433: якщо ні, монітор
    // теж лишається недоторканим. Порядок саме такий, щоб не було стану
    // «монітор уже обнулили, а на DS2433 не вистачило ключа».
    bool can33 = hasDump && hasSN2433;
    if (hasDump && !can33) {
        Serial.println("RESET: ROM-ID DS2433 невідомий — історію в DS2433 переписати "
                       "нічим. Лічильники НЕ чіпаємо: обнулений монітор проти повного "
                       "історії DS2433 — це стан, який рація читає як «невідомий АКБ».");
        return false;
    }
    // Відмова тут означає, що гістограму циклів обнулити не вдалось (блок не
    // тієї довжини). Монітор у такому разі теж не чіпаємо — інакше вийде та
    // сама суперечність, лише з іншого боку.
    if (can33 && !impresHistoryZero(batteryDump, chipSN2433)) {
        Serial.println("RESET: історію в DS2433 обнулити не вдалось (блок гістограми "
                       "не тієї довжини). Монітор НЕ чіпаємо — розсинхронізований "
                       "пакет гірший за пакет зі старими лічильниками.");
        return false;
    }
    if (hasDump2438) {
        // ETM разом із мітками подій: без них станція повертає старий
        // наробіток із мітки (доказ — dumps/13, див. impresSetEtm).
        impresSetEtm(batteryDump2438, 0);
        batteryDump2438[60] = batteryDump2438[61] = 0;         // CCA
        batteryDump2438[62] = batteryDump2438[63] = 0;         // DCA
    }
    return true;
    // ⚠️ Раніше тут «ставили здоров'я 100%»: у першому записі довжини 0x17
    // байту +21 присвоювали 0x64 і перераховували суму. Це було двічі хибно.
    // По-перше, запис шукали як «тег 0x17 + 0x00», хоча перший байт — довжина.
    // По-друге, запис @0x129 — ЗАВОДСЬКА таблиця: у всіх 19 екземплярів
    // PMNN4409A і всіх 8 екземплярів PMNN4409B у dumps/ вона побайтово
    // ОДНАКОВА, тобто це не поточне здоров'я АКБ, а константа моделі, і
    // правити її не можна й немає сенсу. Реальне «здоров'я/строк служби»
    // у прошивці не зберігається — його рахує рація (див. impres_format.h).
}

// Ядро скидання: редагує дампи, пише в обидві мікросхеми, зберігає. Без HTTP —
// викликається і з веб-обробника, і з меню на дисплеї (по кнопкам).
// ── ПОЛАГОДИТИ ПОБИТИЙ ЛІЧИЛЬНИК РОЗРЯДУ МОНІТОРА ─────────────────────────
//  Уся арифметика й усі умови — в impres_bms.h (їх ганяє хостовий тест); тут
//  лишається те, чого на хості немає: сам чіп і запис у нього.
//
//  ⚑ ПИШЕМО РІВНО ДВА БАЙТИ ЗМІСТУ. Скидання лічильників (performReset)
//  обнуляє ETM, CCA, DCA й паливомір — на пакеті з 191 законним циклом заряду
//  це втрата історії заради однієї зіпсованої комірки. Тут правиться саме та
//  комірка, решта монітора лишається як була.
// План правок складає функція, визначена нижче: оголошуємо наперед, щоб не
// тягти сюди весь її блок — крок Майстра живе поруч із рештою правок пакета.
static bool buildRestorePlanFor(const char *model, RestorePlan &p, bool refresh);

// ── УЗГОДИТИ НАРОБІТОК МОНІТОРА З ДАТОЮ, ЗАПИСАНОЮ В ПАКЕТІ ───────────────
//  Вирок і арифметика — у restore_plan.h (їх ганяє хостовий тест); тут лише
//  те, чого на хості немає: буфери, чип і запис у нього.
//
//  ⚑ РАЗОМ ІЗ МІТКАМИ ПОДІЙ. Наробіток лежить не лише в самому лічильнику: у
//  сторінці 2 монітора є мітки «відключення» й «кінець заряду», і станція
//  вміє відновити старе число з них. Тому пишемо через impresSetEtm(), який
//  знає про всі три місця, а не в один регістр.
bool performEtmFix(String *note) {
    auto say = [&](const char *m) { if (note) *note = m; };
    if (!hasDump2438) { say("Немає читання монітора DS2438"); return false; }
    if (!hasDump)     { say("Потрібен DS2433: дата першого запуску записана в ньому"); return false; }
    char model[16] = "";
    if (!impresModelName(batteryDump, model, sizeof(model))) {
        say("Модель пакета не читається — плану не скласти"); return false;
    }
    RestorePlan p;
    if (!buildRestorePlanFor(model, p, false)) {
        say("Для цієї моделі немає вшитого еталона — плану не скласти"); return false;
    }
    restorePlanSetEtmSource(p, true);          // рахувати з дати першого запуску
    uint32_t etm = 0; char why[176] = "";
    if (!restoreEtmFixPlan(p, &etm, why, sizeof(why))) {
        // Мовчазна відмова тут була б найгіршою: натиснув крок, нічого не
        // сталось, і незрозуміло — полагодилось чи ні. Текст уже несе числа,
        // з яких складено вирок, тож розбір не потребує другого заходу.
        say(why[0] ? why : "Узгоджувати наробіток нема з чим");
        Serial.printf("=== ETM fix SKIPPED: %s ===\n", why);
        return false;
    }
    uint32_t before = impresEtm(batteryDump2438);
    ledSet(LED_WRITE);
    displayShow("ПРАВКА ETM...");
    Serial.printf("\n=== ETM fix: %lu -> %lu c (з дати першого запуску) ===\n",
                  (unsigned long)before, (unsigned long)etm);
    impresSetEtm(batteryDump2438, etm);
    if (!battery.writeDS2438(batteryDump2438, DS2438_MEM_SIZE)) {
        // Дамп у пам'яті вже змінено, а чіп — ні. Повертаємо як було, інакше
        // інтерфейс показував би узгоджене там, де запис не пройшов.
        impresSetEtm(batteryDump2438, before);
        say("Запис у монітор не пройшов — значення повернуто як було");
        ledSet(LED_ERROR);
        return false;
    }
    saveDump("/dump2438.bin", batteryDump2438, DS2438_MEM_SIZE);
    char m[80];
    snprintf(m, sizeof(m), "Наробіток узгоджено: %lu -> %lu діб",
             (unsigned long)(before / 86400UL), (unsigned long)(etm / 86400UL));
    say(m);
    displayShow("ETM OK");
    ledSet(LED_OK);
    return true;
}

bool performDcaFix(String *note) {
    auto say = [&](const char *m) { if (note) *note = m; };
    if (!hasDump2438) { say("Немає читання монітора DS2438"); return false; }
    if (!hasDump)     { say("Потрібен DS2433: значення береться з історії пакета"); return false; }

    uint16_t before = (uint16_t)batteryDump2438[62] | ((uint16_t)batteryDump2438[63] << 8);
    uint16_t wrote  = 0;
    if (!impresBmsFixDcaFromHist(batteryDump, batteryDump2438, &wrote)) {
        // Мовчазна відмова тут була б найгіршою: користувач натиснув крок,
        // нічого не сталося, і незрозуміло — полагодилось чи ні.
        say("Немає надійного джерела: історія пакета порожня, неправдоподібна "
            "або попереду монітора (монітор обнулили навмисно). Нічого не записано");
        Serial.println("=== DCA fix SKIPPED: історія пакета непридатна як джерело ===");
        return false;
    }

    ledSet(LED_WRITE);
    displayShow("ПРАВКА DCA...");
    Serial.printf("\n=== DCA fix: монітор %u -> %u (з історії DS2433) ===\n", before, wrote);
    if (!battery.writeDS2438(batteryDump2438, DS2438_MEM_SIZE)) {
        // Дамп у пам'яті вже змінено, а чіп — ні. Повертаємо як було, інакше
        // інтерфейс показував би полагоджене там, де запис не пройшов.
        batteryDump2438[62] = (uint8_t)(before & 0xFF);
        batteryDump2438[63] = (uint8_t)(before >> 8);
        displayShow("ПОМИЛКА DCA");
        ledSet(LED_ERROR);
        say("Запис у DS2438 не пройшов — лічильник лишився як був");
        return false;
    }
    saveDump("/dump2438.bin", batteryDump2438, DS2438_MEM_SIZE);
    displayShow("DCA OK");
    ledSet(LED_OK);
    if (note) *note = String("Лічильник розряду виправлено: ") + before + " -> " + wrote +
                      " (з історії пакета). Решту лічильників не чіпали";
    return true;
}

bool performReset() {
    if (!hasDump && !hasDump2438) { displayShow("СПОЧАТКУ ЧИТАЙ"); return false; }

    Serial.println("\n=== Battery reset (recalibration) ===");
    ledSet(LED_WRITE);
    displayShow("СКИДАННЯ...");
    // Відмова тут — НЕ дрібниця, яку можна проковтнути: скидання без ключа
    // лишило б чипи розсинхронізованими, а це рівно те, через що пакет
    // перестає впізнаватись. Краще нічого не записати й сказати чому.
    if (!resetBatteryData()) {
        displayShow("НЕМА ROM 2433");
        ledSet(LED_ERROR);
        Serial.println("=== Reset ABORTED: ROM-ID DS2433 невідомий ===\n");
        return false;
    }

    bool ok = true;
    if (hasDump)     ok &= battery.writeBattery(batteryDump, DUMP_SIZE);
    if (hasDump2438) ok &= battery.writeDS2438(batteryDump2438, DS2438_MEM_SIZE);

    if (ok) {
        if (hasDump)     saveDump("/dump.bin", batteryDump, DUMP_SIZE);
        if (hasDump2438) saveDump("/dump2438.bin", batteryDump2438, DS2438_MEM_SIZE);
        displayShow("СКИД. OK");
    } else {
        displayShow("СКИД. ЗБІЙ");
    }
    ledSet(ok ? LED_OK : LED_ERROR);
    Serial.println("=== Reset completed ===\n");
    return ok;
}

// ------------------- Очистка (крім критичних даних) -------------------

// Очистка "до заводського": скидає лічильники використання (CCA/DCA/ETM) і
// здоров'я на 100%, зберігаючи КРИТИЧНЕ (модель, ID, криву калібрування, блок
// автент., дзеркало DS2438↔DS2433, заголовок).
//
// ⚠️ ВАЖЛИВО: записи 0x16 більше НЕ обнуляємо. Звірка з еталоном PMNN4409A
// показала, що перший запис 0x16 (тег "16 00") містить КАЛІБРУВАЛЬНУ таблицю
// (86 00 6C 00 56 00 …), а не «статистику». Її обнуління ламало АКБ (рація
// «невідома»). Тепер очистка = безпечне скидання лічильників, без правки
// калібрувальних записів.
bool factoryCleanData() {
    // Лічильники в ОБОХ чипах або в жодному (див. resetBatteryData).
    bool ok = resetBatteryData();
    if (hasDump) fixHeaderChecksum(batteryDump);
    return ok;
}

// Стерти НАВЧЕНИЙ калібрувальний хвіст DS2433 (0x18A..0x1FF) — донорські/старі
// дані про РЕАЛЬНІ банки, які після заміни елементів суперечать новому пакету.
//
// ⚠️ ЩО БУЛО НЕ ТАК РАНІШЕ. Тут шукали «записи 0x0A»: байт 0x0A, після якого
// 10 байт дають суму 0x5A. Це помилка на двох рівнях:
//   • перший байт запису — це ДОВЖИНА, а не тег, тож «0x0A» = будь-який запис
//     довжини 10, а не якийсь особливий «learned»-запис;
//   • на 500 зсувах випадкове вікно дає суму 0x5A приблизно двічі на дамп, тож
//     функція стирала по 10 байт у ВИПАДКОВИХ місцях (у т.ч. у журналі та в
//     заводських таблицях), псуючи прошивку замість ремонту.
// Плюс зона стирання (0x180..кінець) не збігалася з реальною межею навчених
// даних, а другий прохід (0x68..0x140) заходив на заводські таблиці.
//
// Тепер стираємо РІВНО регіон 0x18A..0x1FF — межу визначено побайтовим
// порівнянням 49 дампів (нижче 0x18A лежать ідентичність, крива, copyright,
// заводська таблиця й запис моделі; вище — тільки навчене калібрування).
// Повертає к-сть змінених байт.
// Знайти «чистий» хвіст для моделі, зчитаної з АКБ. nullptr — вибірки дампів
// для цієї моделі бракує, робити ремонт наосліп не можна.
static const uint8_t *freshTailForDump(char *modelOut, size_t n) {
    if (modelOut && n) modelOut[0] = '\0';
    if (!hasDump) return nullptr;
    char m[16] = "";
    if (!impresModelName(batteryDump, m, sizeof(m))) return nullptr;
    if (modelOut && n) { strncpy(modelOut, m, n - 1); modelOut[n - 1] = '\0'; }
    int t = findTemplate(m);
    return (t < 0) ? nullptr : BATTERY_TEMPLATES[t].fresh;
}

// Записати ЧИСТИЙ хвіст у буфер дампа. -1 — немає перевіреного шаблону.
static int applyFreshTail(const uint8_t *fresh) {
    if (!fresh) return -1;
    static uint8_t buf[IMPRES_FRESH_TAIL_LEN];
    memcpy_P(buf, fresh, IMPRES_FRESH_TAIL_LEN);
    return impresResetTailFrom(batteryDump, buf);
}

// ПОВНЕ стирання DS2433 (КРАЙНІЙ ВИПАДОК). Заповнює всі 512 байт 0xFF (стан
// стертого EEPROM) — чіп стає "чистим". Стирає ВСЕ, включно з моделлю/ID/
// калібруванням DS2433! Після цього АКБ не працюватиме, доки не запишете
// еталонний дамп тієї ж моделі. DS2438 (його калібрування/дзеркало) НЕ чіпаємо
// — з нього потім можна відновити калібрувальний блок ("Ремонт").
bool performWipe2433() {
    static uint8_t blank[DUMP_SIZE];
    memset(blank, 0xFF, DUMP_SIZE);
    Serial.println("\n=== FULL WIPE DS2433 ===");
    ledSet(LED_WRITE); displayShow("СТИРАННЯ 2433..");
    bool ok = battery.writeBattery(blank, DUMP_SIZE);
    if (ok) {
        memcpy(batteryDump, blank, DUMP_SIZE); hasDump = true;
        saveDump("/dump.bin", blank, DUMP_SIZE);
        displayShow("2433 СТЕРТО");
    } else displayShow("СТИР. ЗБІЙ");
    ledSet(ok ? LED_OK : LED_ERROR);
    Serial.println("=== Wipe completed ===\n");
    return ok;
}

// ПОВНЕ стирання DS2438 (64 Б -> 0xFF). Крайній випадок: чіп-монітор у
// незрозумілому стані. Після цього дзеркало калібрування (DS2438[24:50]) теж
// стерте, тож АКБ треба відновити («Новий АКБ» або запис еталона).
bool performWipe2438() {
    static uint8_t blank[DS2438_MEM_SIZE];
    memset(blank, 0xFF, DS2438_MEM_SIZE);
    Serial.println("\n=== FULL WIPE DS2438 ===");
    ledSet(LED_WRITE); displayShow("СТИРАННЯ 2438..");
    bool ok = battery.writeDS2438(blank, DS2438_MEM_SIZE);
    if (ok) {
        memcpy(batteryDump2438, blank, DS2438_MEM_SIZE); hasDump2438 = true;
        saveDump("/dump2438.bin", blank, DS2438_MEM_SIZE);
        displayShow("2438 СТЕРТО");
    } else displayShow("СТИР. ЗБІЙ");
    ledSet(ok ? LED_OK : LED_ERROR);
    Serial.println("=== Wipe 2438 completed ===\n");
    return ok;
}

bool performFactoryClean() {
    if (!hasDump && !hasDump2438) { displayShow("СПОЧАТКУ ЧИТАЙ"); return false; }
    Serial.println("\n=== Factory clean (keep identity) ===");
    ledSet(LED_WRITE); displayShow("ОЧИСТКА...");
    // Те саме, що й у скиданні: без ключа DS2433 узгодженої очистки не вийде,
    // а неузгоджена — це і є «пакет перестав впізнаватись».
    if (!factoryCleanData()) {
        displayShow("НЕМА ROM 2433");
        ledSet(LED_ERROR);
        Serial.println("=== Clean ABORTED: ROM-ID DS2433 невідомий ===\n");
        return false;
    }
    bool ok = true;
    if (hasDump)     ok &= battery.writeBattery(batteryDump, DUMP_SIZE);
    if (hasDump2438) ok &= battery.writeDS2438(batteryDump2438, DS2438_MEM_SIZE);
    if (ok) {
        if (hasDump)     saveDump("/dump.bin", batteryDump, DUMP_SIZE);
        if (hasDump2438) saveDump("/dump2438.bin", batteryDump2438, DS2438_MEM_SIZE);
        displayShow("ОЧИСТКА OK");
    } else displayShow("ОЧИСТКА ЗБІЙ");
    ledSet(ok ? LED_OK : LED_ERROR);
    Serial.println("=== Clean completed ===\n");
    return ok;
}

// Підготовка до РЕКАЛІБРУВАННЯ (після заміни елементів). Не чіпає ідентичність/
// модель/криву — лише прибирає СТАРЕ learned-калібрування і обнуляє лічильники,
// щоб пакет став «валідним, але не відкаліброваним»: рація приймає («потребує
// відновлення»), а IMPRES-ЗП запускає цикл калібрування нових банок.
//   1) DS2433: стерти НАВЧЕНИЙ ХВІСТ 0x18A..0x1FF (→0xFF);
//   2) DS2438: обнулити лічильники (ETM/CCA/DCA), зберігши конфіг, апаратний
//      OFFSET АЦП і дзеркало; паливомір виставити за фактичною напругою.
//
// Межа 0x18A і сам механізм підтверджені дампами з dumps/:
//   • 13-dozaryadka-na-stantsii/01 — хвіст стерто до кінця чипа: рація показала
//     «IMPRES(tm)», рівень заряду вірний, ЗП і заряджає, і калібрує;
//   • 11-chastkove-stirannya, 09-4409a-z-proshyvkoyu-4809a — хвіст побитий:
//     ЗП теж приймає АКБ і йде в калібрування;
//   • 08-nova-batareya — записано ПОВНИЙ еталон разом із ЧУЖИМ хвостом:
//     «невідомий акумулятор», ЗП лише світить зеленим.
// Тобто рація/ЗП відкидають не «зіпсовану», а САМЕ ЧУЖУ навчену калібровку;
// порожній хвіст читається як «пакет фірмовий, але не калібрований».
//
// ⚠️ Фізичну калібровку це НЕ замінює — далі АКБ обов'язково калібрувати на ЗП.
// deep = true — додатково стерти навчені записи ЄМНОСТІ (0x153..0x189) і
// кільцевий журнал використання. Потрібно, коли після звичайної підготовки ЗП
// усе ще тримається за стару ємність. Модель, крива й copyright не чіпаються
// НІКОЛИ (інакше рація каже «нема моделі» — саме це сталося в експерименті
// власника зі стиранням від 0x130).
bool performRecalPrepare(bool deep) {
    if (!hasDump && !hasDump2438) { displayShow("СПОЧАТКУ ЧИТАЙ"); return false; }
    Serial.println("\n=== Prepare for recalibration ===");
    ledSet(LED_WRITE); displayShow("ПІД КАЛІБР...");
    bool ok = true;

    if (hasDump) {
        // 1) Записати ЧИСТИЙ хвіст: скелет записів і сталі моделі лишаються,
        //    навчені значення обнулені, суми правильні.
        //
        //    ⚠️ Раніше тут хвіст СТИРАВСЯ у 0xFF. Рація такий пакет приймала,
        //    але калібрування щоразу падало в помилку: ЗП пише навчені значення
        //    за фіксованими адресами й НЕ створює структуру записів заново.
        //    У dumps/13-dozaryadka-na-stantsii після повного циклу на стертому
        //    хвості з'явилися рівно два байти (0x1E1, 0x1E2), а байт довжини
        //    0x1E0 лишився 0xFF — навчений блок не міг стати валідним ніколи.
        char mdl[16];
        const uint8_t *fresh = freshTailForDump(mdl, sizeof(mdl));
        int changed = applyFreshTail(fresh);
        if (changed < 0) {
            Serial.printf("no verified fresh tail for model '%s'\n", mdl[0] ? mdl : "?");
            displayShow("НЕМА ШАБЛОНУ");
            ledSet(LED_ERROR);
            return false;                          // краще нічого, ніж наосліп
        }
        int deepCleared = 0;
        if (deep) {
            deepCleared += impresEraseLearnedCapacity(batteryDump);
            deepCleared += impresEraseUsageLog(batteryDump);
        }
        Serial.printf("fresh tail written for %s: %d B changed, deep: %d B\n",
                      mdl, changed, deepCleared);
        impresFixHeader(batteryDump);               // заголовок поза хвостом — узгоджуємо про запас
        ok &= battery.writeBattery(batteryDump, DUMP_SIZE);
        if (ok) saveDump("/dump.bin", batteryDump, DUMP_SIZE);
    }

    // 2) DS2438: обнулити ЛІЧИЛЬНИКИ, не стираючи монітор.
    //
    // ⚠️ Раніше сюди заливали суцільний 0xFF. Це не «скидання», а псування
    // монітора: байт статусу/конфігу отримував 0xFF замість 0x0F (виставлені
    // зарезервовані біти), поріг — 0xFF замість 0x40, і затиралися апаратний
    // OFFSET АЦП струму та дзеркало ідентичності. Симптом збігається з тим, що
    // описував власник: ЗП бачить АКБ, світить зеленим і не заряджає.
    if (hasDump2438) {
        // Паливомір ставимо за фактичною напругою — щоб ЗП стартувала з
        // осмисленого рівня, а не з нуля на зарядженому пакеті.
        int pct = impresPercentFromMv(impresVoltageMv(batteryDump2438));
        char rcM[16] = ""; decodeModel(rcM, sizeof(rcM));
        impresResetMonitor(batteryDump2438, hasDump ? batteryDump : nullptr,
                           impresIcaFromPercentRs(pct,
                               impresRatedMahFor(hasDump ? batteryDump : nullptr, rcM),
                               impresBmsRsense(batteryDump2438)));
        Serial.printf("monitor reset, ICA from %d%% (U=%u mV)\n",
                      pct, (unsigned)impresVoltageMv(batteryDump2438));
        bool o38 = battery.writeDS2438(batteryDump2438, DS2438_MEM_SIZE);
        if (o38) saveDump("/dump2438.bin", batteryDump2438, DS2438_MEM_SIZE);
        ok &= o38;
    }

    displayShow(ok ? "ГОТ. ДО КАЛІБР" : "КАЛІБР ЗБІЙ");
    ledSet(ok ? LED_OK : LED_ERROR);
    Serial.println("=== Recal-prepare completed ===\n");
    return ok;
}
inline bool performRecalPrepare() { return performRecalPrepare(false); }

// ===========================================================================
//  КЕРОВАНИЙ РОЗРЯД — опитування й запобіжники (тут, бо потрібен battery/дампи)
// ===========================================================================

// Витримка на встановлення режиму ключа перед зняттям показань. Замість
// delay(): у циклі крутимо ledTask(), щоб індикація не залежала від того, скільки
// триває цикл вимірювання. Головну роботу тут робить апаратне згасання (див.
// leds.h) — воно взагалі не потребує процесора, — але перевертання півхвилі
// все одно має статися вчасно, інакше на краю хвилі з'явиться зайва пауза.
// Веб-сервер тут НЕ опитуємо свідомо: обробник міг би запустити ще одну
// операцію просто посеред циклу вимірювання.
static void dischargeSettle(unsigned long ms) {
    unsigned long t0 = millis();
    // ⚑ ГОДУЄМО ОБИДВА СТОРОЖІ. Функцію кличе не лише розряд: chargeTask()
    //  бере її ж на витримку перед виміром напруги. dischargeWatchdogFeed()
    //  мовчки нічого не робить, коли розряд не йде, — тобто під час ЗАРЯДУ ця
    //  пауза лишалась негодованою. Зараз вона коротка (10 мс) і до порога
    //  сторожа не дотягує, але це збіг обставин, а не властивість коду:
    //  варто комусь підняти CHARGE_VSENSE_SETTLE_MS — і пристрій почав би
    //  перезавантажуватись саме на вимірі, тобто в найменш очікуваному місці.
    while (millis() - t0 < ms) {
        ledTask();
        dischargeWatchdogFeed();
        chargeWatchdogFeed();
        delay(1);
    }
}

// Зняти показання монітора під навантаженням. true — читання вдалось.
static bool dischargeSample(uint16_t *mv, int16_t *ma, int16_t *tC10) {
    static uint8_t buf[DS2438_MEM_SIZE];
    if (!battery.readDS2438(buf, DS2438_MEM_SIZE)) return false;
    memcpy(batteryDump2438, buf, DS2438_MEM_SIZE);
    hasDump2438 = true;
    *mv = impresVoltageMv(buf);
    // Струм зі знаком; при розряді від'ємний. Формула та сама, що в /api/info2438.
    // ⚑ Шунт — із самого чипа (DS2438[56..57]). Це не косметика: уставка ШІМ
    // тримає САМЕ виміряний струм, і з чужою константою (0.025 Ом на пакеті,
    // де шунт 0.046 Ом) реальний струм був би вдвічі меншим за задану уставку.
    int16_t raw = (int16_t)((buf[6] << 8) | buf[5]);
    float rs = impresBmsRsense(buf);
    if (rs <= 0.0f) rs = DS2438_RSENSE_OHM;
    *ma  = (int16_t)((float)raw / (4096.0f * rs) * 1000.0f);
    *tC10 = (int16_t)((((int16_t)((buf[2] << 8) | buf[1])) >> 3) * 0.3125f);  // 0.03125*10
    return true;
}

// Старт розряду. targetMv — до якої напруги (0 = DISCHARGE_TARGET_MV).
// Повертає nullptr при успіху, інакше — текст причини відмови.
const char *dischargeStart(uint16_t targetMv) {
    if (!dischargeAvailable()) return "Розряд не налаштовано: задайте LOAD_PIN у settings.h";
    if (dischargeRunning())    return "Розряд уже виконується";
    if (chargeRunning())       return "Спочатку зупиніть заряд";
    if (!targetMv) targetMv = DISCHARGE_TARGET_MV;

    // Ціль обирає користувач, тож затискаємо її в межі, де розряд узагалі має
    // сенс: нижче — гарантована аварійна відсічка, вище — пакет і так там.
    if (targetMv < DISCHARGE_TARGET_MIN_MV) return "Цільова напруга нижча за допустиму (6.80 В)";
    if (targetMv > DISCHARGE_TARGET_MAX_MV) return "Цільова напруга вища за допустиму (8.00 В)";
    if (targetMv < DISCHARGE_HARD_MIN_MV + 200) return "Цільова напруга нижча за аварійну межу";

    uint16_t mv; int16_t ma, t;
    if (!dischargeSample(&mv, &ma, &t)) {
        loadOff();
        return "DS2438 не читається — розряд наосліп заборонено";
    }
    if (mv <= targetMv)                     return "Пакет уже розряджений до цілі";
    if (mv <= DISCHARGE_HARD_MIN_MV)        return "Напруга нижче аварійної межі";
    if (t >= DISCHARGE_MAX_TEMP_C * 10)     return "Пакет гарячий — дайте охолонути";

    memset(&g_dis, 0, sizeof(g_dis));
    g_dis.state    = DIS_RUN;
    g_dis.reason   = DISR_NONE;
    g_dis.targetMv = targetMv;
    g_dis.startMv  = g_dis.lastMv = mv;
    g_dis.lastMa   = ma;
    g_dis.lastTempC10 = t;
    g_dis.startMs  = g_dis.lastPollMs = millis();
    g_dis.startDca = g_dis.lastDca = impresDca(batteryDump2438);
    g_dis.startIca = g_dis.lastIca = batteryDump2438[12];   // паливомір на старті

    // ⚑ ENABLE — ПЕРШИМ, ще до навантаження. Пін PULLUP_PIN активує сам АКБ, і в
    // штатному режимі піднімається лише на час транзакції 1-Wire. Без утримання
    // пакет між читаннями неактивний: струм тече тільки в моменти опитування, і
    // розряд фактично не йде (саме це й спостерігалось).
    battery.holdEnable(true);
    // Шунт саме цього пакета — від нього залежить і струм, і облік мА·год.
    g_dis.rsense = impresBmsRsense(batteryDump2438);
    // Те саме, що в заряді: розумний профіль веде струм у частках C.
    dischargeSetRatedMah((uint16_t)(hasDump ? impresRatedFromDump(batteryDump) : 0));
    dischargeWatchdog(true);            // сторож — лише на час розряду

    // Початкова шпаруватість — З РОЗРАХУНКУ, не 100 %. Інакше перші 5 секунд
    // (до першого виміру піка) пакет тягнув би повні 1.4..1.7 А, тобто рівно те,
    // від чого ми йдемо. Оцінка піка за законом Ома завищена, тож розрахована
    // шпаруватість свідомо занижена — стартуємо м'якше, ніж треба, а перший
    // вимір це виправить.
    // Уставку бере ОДНА функція — профіль (заводський/розумний) плюс ручна
    // поправка. На старті температури ще немає (її дає перше опитування), тож
    // tempFresh=false: розумний профіль поводиться як за нормальної
    // температури, а вікно перевіриться першим же проходом.
    g_dis.setMa   = dischargeSetpointFor(mv, g_dis.targetMv, 0, false, &g_dis.phase);
    g_dis.peakMa  = (uint16_t)dischargeExpectedMa(mv);
    g_dis.dutyPct = dischargeDutyFor(g_dis.peakMa, g_dis.setMa);
    loadDuty(g_dis.dutyPct);

    ledSet(LED_DISCHARGE);
    // ⚑ Прибрати ПІДСУМОК попереднього заряду, якщо його ще не зняли кнопкою.
    // Дисплей і обробник кнопок покладаються на те, що активний екран рівно
    // один («заряд і розряд не можуть іти одночасно» — так і написано в
    // displayRender()). Але «екран активний» — це не «операція йде»: підсумок
    // висить, доки користувач його не прибере. Незнятий підсумок заряду
    // перекривав щойно запущений розряд: сторінка розряду не з'являлась, а
    // перше натискання з'їдалось на прибирання чужого підсумку.
    chargeDismiss();                       // не діє, якщо заряд справді йде
    dischargeMarkDirty(2);                 // увійшли в режим -> повна перемальовка
    Serial.printf("\n=== Discharge started: %u -> %u mV, setpoint %u mA, "
                  "duty %u%% (peak est. %u mA%s) ===\n",
                  mv, targetMv, g_dis.setMa, g_dis.dutyPct, g_dis.peakMa,
                  dischargePwmOk() ? "" : ", PWM UNAVAILABLE");
    return nullptr;
}

// Викликати часто з loop(). Реальна робота — раз на DISCHARGE_POLL_MS.
inline void dischargeTask() {
    if (g_dis.state != DIS_RUN) return;
    unsigned long now = millis();

    // Стеля тривалості: якщо розряд «не йде» (обрив навантаження, залиплий
    // MOSFET, поганий контакт) — зупиняємось, а не крутимось нескінченно.
    if ((now - g_dis.startMs) / 60000UL >= (unsigned long)DISCHARGE_MAX_MIN) {
        dischargeStop(DISR_TIMEOUT);
        Serial.println("=== Discharge ABORT: timeout ===");
        return;
    }
    dischargeWatchdogFeed();          // цикл живий — сторож спокійний
    if (now - g_dis.lastPollMs < DISCHARGE_POLL_MS) return;

    unsigned long dtMs = now - g_dis.lastPollMs;
    g_dis.lastPollMs = now;

    // ── СТОРОЖ (програмна половина) ────────────────────────────────────────
    //  Ми тут, отже цикл живий. Але якщо від попереднього опитування минуло
    //  надто багато, десь була довга затримка, під час якої ключ лишався
    //  відкритим БЕЗ НАГЛЯДУ. Це стан, коли розряд треба припинити, а не
    //  «надолужити»: скільки пакет віддав за цей час, ми не бачили, і скільки
    //  ще протримається — теж. Ключ і enable знімає dischargeStop().
    if (dtMs > DISCHARGE_STALL_MS) {
        dischargeStop(DISR_STALL);
        Serial.printf("=== Discharge ABORT: main loop stalled for %lu ms ===\n", dtMs);
        return;
    }
    g_dis.elapsedS   = (now - g_dis.startMs) / 1000UL;

    // Інтеграл ємності за інтервал, що ЩОЙНО минув. Рахуємо ДО оновлення стану:
    // весь цей час діяли попередні пік і шпаруватість, тобто тік середній струм
    // pick*duty, а не той, який ми зараз виміряємо.
    g_dis.mahX1000 += ((uint32_t)dischargeAvgMa(g_dis) * dtMs) / 3600UL;

    // --- крок 1: НАПРУГА і температура при ЗНЯТОМУ навантаженні --------------
    //  Міряти напругу під струмом не можна: просадка на внутрішньому опорі тим
    //  більша, чим розрядженіший пакет, і саме вона передчасно «продавлювала» б
    //  напругу до цілі — розряд обривався б, не добравши ємності. Тому на час
    //  виміру ключ закривається. 80 мс, звісно, не дають повної релаксації, але
    //  прибирають миттєву омічну просадку — головну складову — і, головне,
    //  роблять вимір однаковим від початку до кінця розряду.
    uint16_t mv = 0; int16_t ma = 0, t = 0;
    loadOff();
    dischargeSettle(DISCHARGE_PEAK_SETTLE_MS);
    bool okV = dischargeSample(&mv, &ma, &t);

    // --- крок 2: ПІК струму при повністю відкритому ключі --------------------
    //  DS2438 віддає струм останнього перетворення (~27 мс) і нічого не знає про
    //  ШІМ: під шпаруватістю невідомо, у яку фазу те перетворення попало. Тому
    //  міряємо в однозначній точці — на 100 % — і отримуємо ПІК, з якого вже
    //  однозначно рахується все інше.
    uint16_t mvLoaded = 0; int16_t peakRaw = 0, tLoaded = 0;
    loadFull();
    dischargeSettle(DISCHARGE_PEAK_SETTLE_MS);
    bool okI = dischargeSample(&mvLoaded, &peakRaw, &tLoaded);
    // Ключ НЕГАЙНО назад у робочу шпаруватість — повністю відкритим його не
    // лишаємо ні на мить довше, ніж триває вимір.
    loadDuty(g_dis.dutyPct);

    if (!okV || !okI) {
        // Кілька невдач поспіль — зупинка. Продовжувати розряд, не бачачи
        // напруги, не можна: так пакет саджається в нуль.
        if (++g_dis.readFails >= DISCHARGE_MAX_READ_FAILS) {
            dischargeStop(DISR_NOREAD);
            Serial.println("=== Discharge ABORT: DS2438 unreadable ===");
        }
        return;
    }
    g_dis.readFails = 0;
    g_dis.polls++;

    // --- крок 3: перерахунок уставки і шпаруватості --------------------------
    uint16_t peak = (uint16_t)(peakRaw < 0 ? -peakRaw : peakRaw);
    int      est  = dischargeExpectedMa(mv);
    // Захист від «датчик мовчить» (облік струму в DS2438 вимкнено, IAD=0 —
    // тоді регістр струму завжди 0). Повірити нулю означало б виставити 100 %
    // шпаруватості й розряджати повним струмом саме тоді, коли ми його не
    // бачимо. Тому неправдоподібно малий пік замінюємо оцінкою за законом Ома:
    // вона завищена, отже шпаруватість вийде занижена — помиляємось у безпечний бік.
    if (peak < (uint16_t)(est / 4)) peak = (uint16_t)est;

    g_dis.peakMa  = peak;
    g_dis.setMa   = dischargeSetpointFor(mv, g_dis.targetMv, t, okV, &g_dis.phase);
    g_dis.dutyPct = dischargeDutyFor(peak, g_dis.setMa);
    loadDuty(g_dis.dutyPct);

    g_dis.lastMv = mv;
    // lastMa — СЕРЕДНІЙ струм навантаження (пік * шпаруватість), зі знаком «-»
    // як у розряду. Саме він тече між вимірами, саме він потрібен для потужності
    // й для ємності; сам пік показуємо окремо.
    g_dis.lastMa = (int16_t)(-(int32_t)dischargeAvgMa(g_dis));
    g_dis.lastTempC10 = t;
    // Лічильники ВБУДОВАНОГО датчика струму: DCA інтегрує розряд апаратно,
    // ICA — поточний паливомір. Обидва читаються з того ж кадру DS2438.
    g_dis.lastDca = impresDca(batteryDump2438);
    g_dis.lastIca = batteryDump2438[12];

    // sag — просадка напруги під ПОВНИМ струмом (різниця між кроками 1 і 2).
    // Це фактично внутрішній опір пакета: sag/peak. Різке зростання за час
    // розряду — ознака поганої пайки або слабкої банки, тож у журнал воно варте
    // більше, ніж здається. (Струм і температура кроку 1 нам не потрібні:
    // під знятим навантаженням струм ~0, а температуру беремо з того ж кроку.)
    (void)ma; (void)tLoaded;
    int sag = (int)mv - (int)mvLoaded;
    // Слід у чорний ящик і тренд пам'яті — так само, як у заряду (postmortem.h).
    pmStep(PM_STEP_REPORT);
    pmNote(PM_MODE_DISCHARGE, g_dis.polls, g_dis.dutyPct, g_dis.lastMa, mv);

    Serial.printf("discharge: %u mV (sag %d mV), avg %d mA (peak %u, set %u, duty %u%%), "
                  "%.1f W, %.1f C, %lu mAh (DCA %lu), ICA %u, %lus, "
                  "купа %lu/%lu, стек %lu\n",
                  mv, sag, g_dis.lastMa, g_dis.peakMa, g_dis.setMa, g_dis.dutyPct,
                  dischargeWattsX10(mv, g_dis.lastMa) / 10.0f, t / 10.0f,
                  (unsigned long)dischargeMah(), (unsigned long)dischargeDcaMah(),
                  g_dis.lastIca, (unsigned long)g_dis.elapsedS,
                  (unsigned long)ESP.getFreeHeap(), (unsigned long)ESP.getMaxAllocHeap(),
                  (unsigned long)uxTaskGetStackHighWaterMark(NULL));
    dischargeMarkDirty(1);                 // нові показання -> оновити екран

    if (mv <= DISCHARGE_HARD_MIN_MV) {
        dischargeStop(DISR_HARD_MIN);
        Serial.println("=== Discharge ABORT: below hard minimum ===");
    } else if (t >= DISCHARGE_MAX_TEMP_C * 10) {
        dischargeStop(DISR_TEMP);
        Serial.println("=== Discharge ABORT: overheat ===");
    } else if (mv <= g_dis.targetMv) {
        dischargeStop(DISR_TARGET);
        Serial.printf("=== Discharge DONE: %lu mAh in %lus ===\n",
                      (unsigned long)dischargeMah(), (unsigned long)g_dis.elapsedS);
    }
}

// Стан розряду у JSON — для веб-моніторингу й USB-клієнта.
static String dischargeJson() {
    // ⚑ ОДНА ВИДІЛЕНА ДІЛЯНКА ЗАМІСТЬ СОТЕНЬ ПЕРЕВИДІЛЕНЬ. Цей відповідач
    //  кличеться КОЖНУ СЕКУНДУ, поки клієнт дивиться на заряд/розряд, а нижче
    //  йдуть десятки `j += ...`. Рядок Arduino росте блоками по 16 байтів, тож
    //  без reserve() кожна відповідь — це десятки realloc (malloc+memcpy+free)
    //  плюс тимчасовий String на КОЖНЕ число.
    //
    //  Само по собі це не помилка, але за години заряду виходять СОТНІ ТИСЯЧ
    //  розподілів різного розміру — а це фрагментація купи. Вільної пам'яті
    //  начебто вистачає, а суцільного шматка під буфер Wi-Fi/TCP уже немає, і
    //  черговий розподіл падає. Виглядає це як «під час заряду пристрій
    //  періодично перезавантажується» — тобто рівно як скарга.
    //
    //  reserve() робить із цього ОДИН розподіл. Розмір узято з запасом над
    //  реальною довжиною відповіді; якщо не влізе, String просто дорощується
    //  як і раніше, тобто гірше не стане.
    String j; j.reserve(1024);
    j = "{\"available\":" + String(dischargeAvailable() ? "true" : "false");
    j += ",\"state\":\"" + String(g_dis.state == DIS_RUN ? "run"
                               : g_dis.state == DIS_DONE ? "done"
                               : g_dis.state == DIS_ABORT ? "abort" : "idle") + "\"";
    j += ",\"reason\":\""; j += dischargeReasonText(g_dis.reason); j += "\"";
    j += ",\"targetMv\":" + String(g_dis.targetMv);
    j += ",\"startMv\":"  + String(g_dis.startMv);
    j += ",\"mv\":"       + String(g_dis.lastMv);
    j += ",\"ma\":"       + String(g_dis.lastMa);
    j += ",\"tempC\":"    + String(g_dis.lastTempC10 / 10.0f, 1);
    j += ",\"mah\":"      + String((unsigned long)dischargeMah());
    // Дані вбудованого датчика струму DS2438
    j += ",\"watts\":"    + String(dischargeWattsX10(g_dis.lastMv, g_dis.lastMa) / 10.0f, 1);
    j += ",\"dcaMah\":"   + String((unsigned long)dischargeDcaMah());
    j += ",\"dcaDelta\":" + String((int)(uint16_t)(g_dis.lastDca - g_dis.startDca));
    j += ",\"ica\":"      + String(g_dis.lastIca);
    j += ",\"icaStart\":" + String(g_dis.startIca);
    j += ",\"elapsedS\":" + String((unsigned long)g_dis.elapsedS);
    j += ",\"polls\":"    + String(g_dis.polls);
    j += ",\"expectedMa\":" + String(dischargeExpectedMa(g_dis.lastMv));
    j += ",\"loadOhm\":"  + String(LOAD_OHM, 1);
    // Обмеження струму ШІМом: уставка за напругою, виміряний пік, шпаруватість.
    j += ",\"setMa\":"    + String(g_dis.setMa);
    j += ",\"peakMa\":"   + String(g_dis.peakMa);
    j += ",\"duty\":"     + String(g_dis.dutyPct);
    j += ",\"inBand\":"   + String(dischargeInBand(g_dis) ? "true" : "false");
    j += ",\"bandLoMa\":" + String((uint32_t)g_dis.setMa * DISCHARGE_BAND_LO_PCT / 100u);
    j += ",\"bandHiMa\":" + String((uint32_t)g_dis.setMa * DISCHARGE_BAND_HI_PCT / 100u);
    j += ",\"pwm\":"      + String(dischargePwmOk() ? "true" : "false");
    // ── профіль, ручний струм, залишок часу ──────────────────────────────
    j += ",\"profile\":"  + String(dischargeProfile());
    j += ",\"profileText\":\""; j += dischargeProfileText(dischargeProfile()); j += "\"";
    j += ",\"phase\":"    + String(g_dis.phase);
    j += ",\"phaseText\":\"";   j += dischargePhaseText(g_dis.phase); j += "\"";
    j += ",\"manualMa\":" + String(dischargeManualMa());
    j += ",\"manMinMa\":" + String((unsigned)DISCHARGE_MANUAL_MA_MIN);
    j += ",\"manMaxMa\":" + String((unsigned)DISCHARGE_MANUAL_MA_MAX);
    j += ",\"ratedMah\":" + String(dischargeRatedMah());
    j += ",\"etaS\":"     + String((unsigned long)dischargeEtaS(
                                  impresPercentFromMv(g_dis.lastMv),
                                  impresPercentFromMv(g_dis.targetMv),
                                  dischargeRatedMah(),
                                  (uint16_t)(g_dis.lastMa < 0 ? -g_dis.lastMa : g_dis.lastMa)));
    // Межі лінійки струму — щоб інтерфейси описували її, а не зашивали числа.
    j += ",\"rampHiMv\":" + String(DISCHARGE_RAMP_HI_MV);
    j += ",\"maHi\":"     + String(DISCHARGE_MA_HI);
    j += ",\"maLo\":"     + String(DISCHARGE_MA_LO);
    j += ",\"tgtMinMv\":" + String(DISCHARGE_TARGET_MIN_MV);
    j += ",\"tgtMaxMv\":" + String(DISCHARGE_TARGET_MAX_MV);
    j += ",\"tgtDefMv\":" + String(DISCHARGE_TARGET_MV);
    j += "}";
    return j;
}

// ===========================================================================
//  КЕРОВАНИЙ ЗАРЯД — опитування й запобіжники (тут, бо потрібен battery/дампи;
//  сам регулятор і стан машини — у charge.h, детальний опис різниці з
//  розрядом — на початку того файлу).
// ===========================================================================

// ===========================================================================
//  ВЕРСІЯ ПРИСТРОЮ БЕЗ ЗАРЯДУ — зберігається між увімкненнями
// ===========================================================================
//  Це властивість ЗАЛІЗА, а не налаштування настрою: у цьому екземплярі
//  силової частини немає й не з'явиться. Гасити її щоразу після ввімкнення
//  чотирма натисканнями означало б, що пристрій при кожному старті кілька
//  секунд скаржиться на блок живлення, якого в ньому не передбачено.
//
//  Файл окремий від /sound.cfg навмисно: звук — смак, а це — комплектація.
//  Один рядок «ключ=значення», щоб можна було прочитати очима. Сам формат і
//  його розбір живуть у radio_mode.h — там їх дістає хостовий тест, а тут
//  лишається тільки робота з файлом.
//
//  ⚑ У ФАЙЛІ ТЕПЕР ДВА ЗНАЧЕННЯ, І ПИШУТЬСЯ ВОНИ РАЗОМ. Писати «своє» поле,
//  не читаючи сусіднього, означало б, що перемикач радіо мовчки вмикає заряд
//  назад на приладі, де силової частини немає, — а це рівно той клас дефекту,
//  за яким тут стежать окремо: одне місце відповідає на два питання.
inline bool chargeModeSave() {
    File f = SPIFFS.open(DEVICE_CFG_PATH, "w");
    if (!f) { Serial.println("DEVICE: cannot write " DEVICE_CFG_PATH); return false; }
    char line[64];
    radioCfgFormat(line, sizeof(line), radioMode(), chargeOffByUser());
    f.print(line);
    f.close();
    Serial.printf("DEVICE: заряд %s, зв'язок %s (збережено)\n",
                  chargeOffByUser() ? "ВИМКНЕНО" : "увімкнено", radioModeName(radioMode()));
    return true;
}

// Відсутній або побитий файл — не помилка: заряд лишається увімкненим, тобто
// пристрій поводиться як повна комплектація. Це правильний бік замовчування:
// зайвий вимикач у меню нікому не шкодить, а мовчазно вимкнений заряд на
// повній платі виглядав би як поломка.
inline void chargeModeLoad() {
    if (!SPIFFS.exists(DEVICE_CFG_PATH)) return;
    File f = SPIFFS.open(DEVICE_CFG_PATH, "r");
    if (!f) return;
    String line = f.readStringUntil('\n');
    f.close();
    bool off = false;
    uint8_t mode = RADIO_MODE_DEFAULT;
    if (!radioCfgParse(line.c_str(), &mode, &off)) {
        Serial.println("DEVICE: bad cfg, заряд лишається увімкненим, зв'язок — Wi-Fi");
        return;
    }
    // ⚑ ПРОПУЩЕНО ЧЕРЕЗ SANITIZE ЩЕ РАЗ, ХОЧ РОЗБІР ЦЕ ВЖЕ ЗРОБИВ. Умова тут
    //  та сама, але відповідає вона на інше питання: розбір питає «чи можна
    //  так записати», а це — «чи можна це підняти ЗАРАЗ». Прошивку могли
    //  перезібрати без Bluetooth між записом файла й цим читанням, і повірити
    //  збереженому числу означало б не підняти ЖОДНОГО радіо.
    radioModeSet(mode);
    if (radioMode() != mode)
        Serial.printf("DEVICE: у файлі зв'язок %u, але ця збірка його не піднімає — Wi-Fi\n",
                      (unsigned)mode);
    if (off) {
        chargeSetOffByUser(true);
        chargeConsumeModeSave();     // це читання, а не правка — писати назад нічого
        Serial.println("DEVICE: ця збірка без заряду (з " DEVICE_CFG_PATH ")");
    }
    radioConsumeSave();              // прочитали, а не змінили — писати назад нічого
}

// Одні двері для всіх кінцевих точок заряду. Повертає true, якщо запит уже
// відхилено й відповідь надіслано.
//
//  ⚑ ЧОМУ ГЕЙТ ПОТРІБЕН, ХОЧ МЕНЮ Й СХОВАНЕ. Меню — лише один зі входів.
//  Веб, USB-клієнт і збережений сценарій Майстра шлють КОД операції напряму,
//  і «сховати кнопку» не означає «вимкнути функцію».
inline bool chargeGateClosed() {
    if (chargeAvailable()) return false;
    // ⚑ ОЗНАКА «nocharge» — ЩОБ КЛІЄНТ НЕ ВПІЗНАВАВ ВІДМОВУ ЗА ТЕКСТОМ.
    //  Цю відмову треба показувати не миготливою плашкою, а вікном із «ОК»:
    //  вона пояснює, чому зникла ціла група меню, і зникнути сама через три
    //  секунди не має права. Розрізняти її за рядком означало б, що перша ж
    //  правка формулювання тихо поверне миготливу плашку.
    String j = "{\"status\":\"error\",\"code\":\"nocharge\",\"message\":\"";
    j += chargeUnavailText();
    j += "\"}";
    server.send(409, "application/json", j);
    return true;
}

// Старт заряду до обраного ВІДСОТКА (0 -> типово 100 %, повний заряд).
// Повертає nullptr при успіху, інакше — текст причини відмови.
const char *chargeStart(uint8_t targetPct) {
    if (!chargeAvailable()) return chargeUnavailText();
    if (chargeRunning())    return "Заряд уже виконується";
    if (dischargeRunning()) return "Спочатку зупиніть розряд";
    // Без ШІМ заряд заборонено взагалі. На відміну від розряду (де відмова
    // ШІМ безпечно відкочується на digitalWrite: ключ відкритий повністю,
    // струм лише ЗРОСТАЄ понад задане, але резистор його жорстко обмежує),
    // тут відкочуватись нема куди: обмежувача струму в схемі немає, і
    // «постійно відкритий» ключ означав би (Uживл − Uпакета)/R_шунт —
    // десяток ампер через шунт і банки.
    if (!chargePwmOk())     return "Керування недоступне: ШІМ не прикріпився. "
                                   "Найімовірніше CHARGE_LEDC_CH ділить ТАЙМЕР з "
                                   "іншим каналом (вони йдуть попарно: 0-1, 2-3, "
                                   "4-5, 6-7), а частоти різні. Дивіться рядок "
                                   "CHARGE: у журналі — там номер таймера";

    if (!targetPct) targetPct = 100;
    if (targetPct < CHARGE_TARGET_PCT_MIN) targetPct = CHARGE_TARGET_PCT_MIN;
    if (targetPct > 100) targetPct = 100;
    // Ціль завжди в межах [BATTERY_EMPTY_MV..CHARGE_TARGET_MV] — вище
    // CHARGE_TARGET_MV (=100 % на шкалі) заряджати не можна ХАЙ ЯКИЙ
    // targetPct прийшов ззовні (клієнт міг надіслати щось дивне).
    uint16_t targetMv = (uint16_t)impresMvFromPercent(targetPct);
    if (targetMv > CHARGE_TARGET_MV) targetMv = CHARGE_TARGET_MV;
    // ⚑ РУЧНА ЦІЛЬ У ВОЛЬТАХ ПЕРЕБИВАЄ ВІДСОТОК. Відсоток проходить через
    //  криву SoC, тобто «85 %» — це стільки, скільки крива вважає за 85 %.
    //  Для зберігання (7.4 В) і для ремонтних сценаріїв потрібні саме вольти.
    //  Затиск уже зроблено в chargeSetManualMv(), але повторюємо його й тут:
    //  значення могло прийти з інших часів, а стеля тут одна для всіх шляхів.
    if (chargeManualMv()) {
        targetMv = chargeManualMvClamp(chargeManualMv());
        if (targetMv > CHARGE_TARGET_MV) targetMv = CHARGE_TARGET_MV;
    }
    // ⚑ ПІСЛЯ ЗАТИСКУ ЦІЛЬ У ВІДСОТКАХ ТРЕБА ПЕРЕРАХУВАТИ — інакше профіль
    //  струму масштабується під ціль, якої не буде.
    //
    //  Раніше цього не було видно, бо шкала була лінійна й 100 % збігались із
    //  CHARGE_TARGET_MV. З правильною кривою 2S 100 % — це 8.40 В, а
    //  заряджаємо ми до 8.20 В, тобто до 90 %. Якби targetPct лишився 100,
    //  поріг дозаряду рахувався б як 90 % від 100 = 90 % — а це РІВНО та
    //  напруга, на якій заряд і закінчується. Дозаряд малим струмом просто
    //  зник би: пакет добивався б повним струмом до самого кінця.
    //
    //  Тепер targetPct = відсоток тієї напруги, на якій ми справді зупинимось,
    //  і всі точки перегину профілю (10/50/80/дозаряд) стискаються під неї.
    targetPct = (uint8_t)impresPercentFromMv(targetMv);
    if (targetPct < CHARGE_TARGET_PCT_MIN) targetPct = CHARGE_TARGET_PCT_MIN;
    uint16_t hardMaxMv = (uint16_t)(targetMv + CHARGE_HARD_MAX_HEADROOM_MV);

    // ⚑ ENABLE — НАЙПЕРШИМ, І ЛИШЕ ПОТІМ УСЕ ІНШЕ.
    //  Пакет IMPRES під'єднує свої клеми до зовнішнього кола не сам по собі, а
    //  за сигналом enable. Поки він не піднятий, на клемі немає напруги
    //  ПАКЕТА — там або нічого, або напруга нашого ж живлення через ключ. Отже
    //  будь-який вимір, зроблений до enable, стосується не пакета, а
    //  розімкненого кола: саме так і виходить те «9.9 В» (стеля подільника),
    //  через яке заряд оголошував хибну перенапругу.
    //
    //  Раніше enable піднімався в самому КІНЦІ chargeStart() — уже після того,
    //  як зміряно напругу, струм і температуру, і навіть після chargeSetDuty(),
    //  тобто струм подавався РАНІШЕ за під'єднання пакета. Коментар поруч при
    //  цьому стверджував «ще ДО подачі струму»; насправді порядок був
    //  зворотний.
    //
    //  CHARGE_ENABLE_LEAD_MS — пауза на те, щоб пакет справді замкнув клеми й
    //  напруга встоялась. Без неї перший же вимір потрапляв би у перехідний
    //  процес.
    battery.holdEnable(true);
    delay(CHARGE_ENABLE_LEAD_MS);

    //  Далі — усе, що може відмовити. Тіло винесене в лямбду НЕ для краси: у
    //  нього сім різних виходів «не можна почати», і при кожному enable треба
    //  зняти назад. Сім однакових рядків перед сімома return — це шість шансів
    //  забути один і лишити пакет під'єднаним після невдалого старту.
    const char *startErr = [&]() -> const char * {

    // ⚑ ДВА РІЗНІ ДЖЕРЕЛА, КОЖНЕ ЗА СВОЇМ ПРИЗНАЧЕННЯМ.
    //  • НАПРУГА — з нашого подільника (chargePackMv). Вона й керує зупинкою за
    //    ціллю, тож мусить бути тим самим числом, яке далі щосекунди міряє
    //    chargeTask(): міряти старт монітором, а хід — подільником означало б
    //    порівнювати різні шкали й ловити стрибок на першому ж опитуванні.
    //  • ТЕМПЕРАТУРА — з DS2438: свого датчика в пристрою немає, а без контролю
    //    нагріву заряд заборонено. Ключ зараз закритий, тож 1-Wire читається
    //    без зсуву землі (див. коментар про шунт у мінусовому проводі).
    chargeOff();                        // гарантовано закритий ключ на час вимірів
    // Стеля шпаруватості — заводська. Її міг опустити попередній сеанс
    // пробудження; лишити її опущеною означало б заряджати крізь чужу межу й
    // спинитись за «ключ не тягне» на штатному струмі.
    chargeResetDutyCap();

    // ⚑ ЖИВЛЕННЯ — ПЕРШИМ, ще до всіх інших перевірок. Без нього решта вимірів
    //  не має сенсу: заряд «іде» зі шпаруватістю в стелю й нульовим струмом, і
    //  виглядає це як несправність пакета, а не як забутий блок живлення.
    //  Міряємо саме зараз, на закритому ключі, — під струмом на шині живлення
    //  є просадка, і поріг довелося б розмазувати.
    //  ⚑ ⚠️ ПРО «PSU_UNKNOWN» У ЦІЙ УМОВІ. Це не поблажка, а єдина чесна
    //  відповідь там, де подільника немає: на платі TL494 його немає ніколи, у
    //  збірці понижувача — доки CHARGE_PSU_PIN закоментований. Пропускати старт
    //  при «не знаю» правильно саме тому, що інакше нова перевірка блокувала б
    //  функцію, яка до неї працювала.
    uint8_t psu = chargePsuPoll();
    if (psu != PSU_OK && psu != PSU_UNKNOWN) {
#ifdef CHARGE_PSU_PIN
        ledSet(LED_FAULT);
        // ⚑ ПОВІДОМЛЕННЯ МУСИТЬ ВЕСТИ ДО ВИХОДУ, а не лише називати біду.
        //  Контроль живлення — НОВИЙ вузол (подільник 68к/10к на GPIO39), і
        //  поки його фізично не зібрано, пін висить, читається ~0 В, і заряд
        //  відхиляється з «немає живлення» — тобто щойно додана перевірка
        //  блокує функцію, яка до неї працювала. Розрізнити «давача немає» і
        //  «живлення немає» вимірюванням НЕМОЖЛИВО: GPIO34..39 не мають
        //  внутрішніх підтяжок, тож розгойдати вільний пін і побачити різницю
        //  ніяк. Тому виходом мусить бути текст: називаємо виміряне число й
        //  прямо кажемо, що робити, якщо подільника ще немає.
        static char msg[190];
        snprintf(msg, sizeof(msg),
                 "%s. Виміряно %u.%02u В на GPIO%d (треба %d.%d…%d.%d). "
                 "Якщо подільник живлення ще НЕ ЗІБРАНО — закоментуйте "
                 "CHARGE_PSU_PIN у settings.h, і заряд працюватиме як раніше.",
                 chargePsuText(psu), chargePsuMv() / 1000, (chargePsuMv() % 1000) / 10,
                 (int)CHARGE_PSU_PIN,
                 CHARGE_PSU_MIN_MV / 1000, (CHARGE_PSU_MIN_MV % 1000) / 100,
                 CHARGE_PSU_MAX_MV / 1000, (CHARGE_PSU_MAX_MV % 1000) / 100);
        Serial.printf("=== Charge NOSTART: %s ===\n", msg);
        return msg;
#else
        // Без подільника сюди не потрапити: chargePsuPoll() віддає PSU_UNKNOWN,
        // а він умову не проходить. Гілка існує лише для того, щоб текст вище
        // не посилався на пін, якого в цій збірці немає.
        return "Живлення поза допуском";
#endif
    }

#if CHARGE_IS_TL494
    // ── ПЛАТА TL494: ОБИДВА ЧИСЛА З ОДНОГО ЧИТАННЯ ───────────────────────
    //  Свого подільника й шунта тут немає, тож «два різні джерела» вище
    //  зводяться до одного: DS2438 усередині пакета дає і напругу, і струм, і
    //  температуру за одну транзакцію. Порядок від цього не міняється —
    //  спершу переконатись, що монітор говорить, і лише потім щось вирішувати.
    uint16_t mv = 0; int16_t ma = 0, t = 0;
    if (!dischargeSample(&mv, &ma, &t)) {
        chargeOff();
        return "DS2438 не читається — заряд наосліп заборонено (без температури "
               "пакет можна перегріти). Спершу домогтися читання: сторінка "
               "стану скаже, чого бракує — підтяжки 4.7к, лінії даних чи enable";
    }
    // Показання одразу віддаємо в спільний шар: далі і старт, і опитування
    // читають напругу через ті самі chargePackMv()/chargeMeasureMa(), що й на
    // понижувачі. Двох шляхів до одного числа не заводимо.
    chargeFeedPackReading(mv, ma);
    uint16_t maIdle = 0;         // шунта немає — «струм на закритому ключі» не питання
    uint16_t dummyMv = mv;       // на цій платі клема й монітор — це одне й те саме
#else
    uint16_t mv = chargePackMv();
    uint16_t mvPeak; uint16_t maIdle = chargeMeasureMa(&mvPeak);

    uint16_t dummyMv; int16_t ma, t;
    if (!dischargeSample(&dummyMv, &ma, &t)) {   // те саме читання DS2438: потрібна ТЕМПЕРАТУРА
        chargeOff();
        return "DS2438 не читається — заряд наосліп заборонено (без температури "
               "пакет можна перегріти). Спершу домогтися читання: сторінка "
               "стану скаже, чого бракує — підтяжки 4.7к, лінії даних чи enable";
    }
#endif
    // Правдоподібність власного вимірювального кола: заряджати, не бачачи
    // напруги, не можна.
    //
    // ⚑ АЛЕ ПРИЧИН У НУЛЯ ДВІ, І ДРУГА — НЕ ПОЛОМКА. Сюди ми доходимо вже
    //  ПІСЛЯ dischargeSample(), тобто монітор напевно відповів. Отже пакет на
    //  місці, 1-Wire цілий, enable піднято — а на клемі нуль. Найімовірніше це
    //  спрацював захист самого пакета: він розмикає СИЛОВИЙ ключ, а DS2438
    //  сидить до нього й говорить далі. Відрізнити це вимірюванням від обриву
    //  лінії CHARGE_VSENSE_PIN неможливо — картина однакова, — але дія в обох
    //  випадках та сама й безпечна: подати обмежений струмом і енергією
    //  імпульс і подивитись, чи з'явиться напруга. Це й робить пробудження.
    //  Тому тут не «перевірте пін», а конкретні числа й шлях далі.
    if (!chargeRailAlive(mv)) {
#if CHARGE_IS_TL494
        // ⚑ ТУТ ЦЕ ІНШЕ ПИТАННЯ, І ВІДПОВІДЬ НА НЬОГО ІНША. На понижувачі
        //  нижче цього порога опинявся НАШ подільник, тобто мовчала КЛЕМА, а
        //  монітор при цьому говорив — і різниця між двома числами й була
        //  діагнозом. На цій платі число одне: його дає сам монітор. Отже
        //  низька напруга тут означає не «клеми розімкнуті», а те, що пакет
        //  справді порожній до небезпечного. Радити пробудження було б
        //  подвійною неправдою: воно і не по адресі, і на цьому залізі його
        //  немає взагалі.
        static char msg[220];
        snprintf(msg, sizeof(msg),
                 "Монітор усередині пакета показує %u мВ — це нижче за половину "
                 "порожнього (%d мВ). Такий пакет заряджати звичайним струмом "
                 "небезпечно: спершу з'ясуйте, чи не глибокий це розряд і чи "
                 "цілі банки.",
                 mv, (int)(BATTERY_EMPTY_MV / 2));
        Serial.printf("=== Charge NOSTART: монітор %u мВ — глибокий розряд ===\n", mv);
        return msg;
#else
        static char msg[260];
        snprintf(msg, sizeof(msg),
                 "На клемі %u мВ, а монітор УСЕРЕДИНІ пакета бачить %u мВ. Пакет "
                 "живий, але його клеми розімкнуті — найімовірніше спрацював "
                 "захист. Заряджати наосліп не можна; запустіть ПРОБУДЖЕННЯ — "
                 "воно обмеженим імпульсом просить захист відпустити клеми, а "
                 "якщо не відпустить, скаже про це прямо. Друга можлива причина "
                 "тієї ж картини — обірвана лінія CHARGE_VSENSE_PIN.",
                 mv, dummyMv);
        Serial.printf("=== Charge NOSTART: клема %u мВ, чип %u мВ — захист пакета "
                      "або обрив VSENSE ===\n", mv, dummyMv);
        return msg;
#endif
    }
    if (maIdle > CHARGE_DEADBAND_MA)
        return "На закритому ключі шунт бачить струм — перевірте ключ (можливо, пробитий MOSFET)";
    if (mv >= targetMv)                 return "Пакет уже заряджений до обраної цілі";
    if (mv >= hardMaxMv)                return "Напруга вже вище аварійної межі — заряд не почато";
    if (t >= CHARGE_MAX_TEMP_C * 10)    return "Пакет гарячий — дайте охолонути";

    memset(&g_chg, 0, sizeof(g_chg));
    g_chg.state    = CHG_RUN;
    g_chg.mode     = CHG_MODE_CHARGE;    // явно, хоч memset і дав би те саме
    g_chg.reason   = CHGR_NONE;
    g_chg.startMv  = g_chg.lastMv = mv;
    g_chg.targetMv  = targetMv;
    g_chg.targetPct = targetPct;
    g_chg.lastMa   = 0;              // ключ ще закритий — струму немає
    g_chg.lastTempC10 = t;
    g_chg.startMs  = g_chg.lastPollMs = millis();
    g_chg.startCca = g_chg.lastCca = impresCca(batteryDump2438);
    g_chg.startIca = g_chg.lastIca = batteryDump2438[12];
    g_chg.lastPct  = (uint8_t)impresPercentFromMv(mv);
    g_chg.rsense   = impresBmsRsense(batteryDump2438);   // шунт ПАКЕТА — лише для CCA
    // Паспортна ємність САМОГО пакета — з чипа. Розумний профіль рахує від неї
    // струм у частках C; 0 (чипа не читали) означає «беремо номінал».
    chargeSetRatedMah((uint16_t)(hasDump ? impresRatedFromDump(batteryDump) : 0));
#if CHARGE_IS_BUCK
    (void)ma;                        // струм DS2438 тут не потрібен: міряємо своїм шунтом
#endif                               // на платі TL494 він, навпаки, ЄДИНИЙ — його вже згодовано

    // ⚑ СТАРТ ІЗ РОЗРАХОВАНОЇ ТОЧКИ НУЛЬОВОГО СТРУМУ, а не з нуля.
    //  Шлях від нуля до робочої точки — сотні відліків ШІМ, тобто хвилини
    //  повзання. chargeStartDuty() цілиться одразу в ПОТРІБНИЙ струм (уставку
    //  профілю), рахуючи по тій гілці, у якій перетворювач зараз працює:
    //  переривчастій (струм ~D²) чи неперервній (струм ~D).
    //  Оцінка спирається на приблизні L і R — і це нормально: далі все веде
    //  замкнутий контур за реальним струмом, а крок регулятора пропорційний
    //  похибці, тож промах моделі закривається за кілька опитувань.
    // ⚑ Ручну уставку враховуємо ВЖЕ НА СТАРТІ, а не з другого опитування.
    //  Інакше chargeStartDuty() цілився б у автоматичний струм, і перший
    //  прохід ішов би з чужою шпаруватістю — рівно та «сходинка» на початку,
    //  задля усунення якої розрахунок стартової точки й робився.
    //  inTaper на старті ще false, тож тут це просто «ручне замість профілю».
    // Уставку бере ОДНА функція — профіль (заводський/розумний) плюс ручна
    // поправка. На старті температури ще немає (перший вимір буде на першому
    // опитуванні), тож tempFresh=false.
    g_chg.inTaper = false;
    g_chg.setMa = chargeSetpointFor(g_chg.lastPct, targetPct, mv, targetMv,
                                    0, false, &g_chg.inTaper, &g_chg.phase);
    g_chg.duty  = chargeStartDuty(mv, g_chg.setMa);
    chargeSetDuty(g_chg.duty);

    // enable вже піднято на самому початку chargeStart() — до всіх вимірів.
    chargeWatchdog(true);

    ledSet(g_chg.lastPct >= CHARGE_LED_TAPER_PCT ? LED_CHARGE_TAPER : LED_CHARGE);
    // Дзеркально до dischargeStart(): зняти незакритий підсумок розряду, інакше
    // він перекриє сторінку заряду (докладніше — коментар там).
    dischargeDismiss();                    // не діє, якщо розряд справді йде
    chargeMarkDirty(2);
#if CHARGE_IS_TL494
    // ⚑ ПІДПИС ОДИНИЦЬ — ЧЕСНИЙ. Друкувати «duty 0 з 8600 (стеля 85 %)» тут
    //  означало б назвати мілівольти відліками ШІМ і приписати платі відсоток,
    //  якого в неї немає.
    Serial.printf("\n=== Charge started: %u mV (%u%%) -> ціль %u mV (%u%%), setpoint %u mA, "
                  "старт з %u мВ виходу (стеля %u мВ, крок %d мВ)%s ===\n",
                  mv, g_chg.lastPct, targetMv, targetPct, g_chg.setMa,
                  g_chg.duty, (unsigned)CHARGE_DUTY_MAX, (int)CHARGE_TL_STEP_MV,
                  chargePwmOk() ? "" : ", PWM UNAVAILABLE");
#else
    Serial.printf("\n=== Charge started: %u mV (%u%%) -> ціль %u mV (%u%%), setpoint %u mA, "
                  "старт duty %u з %u (стеля %u = %d%%)%s ===\n",
                  mv, g_chg.lastPct, targetMv, targetPct, g_chg.setMa,
                  g_chg.duty, (unsigned)CHARGE_DUTY_FULL,
                  (unsigned)CHARGE_DUTY_MAX,
                  (int)CHARGE_DUTY_MAX_PCT, chargePwmOk() ? "" : ", PWM UNAVAILABLE");
#endif
    return nullptr;
    }();

    //  Єдине місце, де знімається enable після невдалого старту. Ключ гасимо
    //  теж: частина виходів трапляється вже після chargeOff(), частина — ні.
    if (startErr) {
        chargeOff();
        battery.holdEnable(false);
    }
    return startErr;
}

// ===========================================================================
//  ПРИМУСОВЕ ПРОБУДЖЕННЯ — старт і опитування.
//  Уся арифметика й усі рішення — у charge.h (їх ганяє хостовий тест); тут
//  лишається те, чого на хості немає: сам пакет, 1-Wire і АЦП.
// ===========================================================================
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
