roman885-85/moto_battery_reader/(commit log)

2026-07-01 Fix SPIFFS file system issues with dump writing
    [web_server.h]
2026-07-01 Add detailed logging for file size issues during upload and write operations
    [web_server.h]
2026-07-01 Fix SPIFFS file upload issue - add space check and proper write modes
    [web_server.h]
2026-07-01 Fix SPIFFS file upload - keep file handle open during upload and add flush()
    [web_server.h]
2026-07-01 Fix upload - use static file handle and add critical 200ms sync delay
    [web_server.h]
2026-07-01 Rewrite upload handler with proper static file handle and ESP32 WebServer compatibility
2026-07-03 USB/веб: пароль на запис, надійний запис моделі, коректне скидання, REBOOT
    USB-клієнт / Serial-протокол:
    - Додано авторизацію: команда AUTH <пароль> і поле «Пароль адміністратора»
    у client_usb.html. Будь-який запис (WRITE33/38, RESET, REPAIR, CLEAN,
    WIPE33, SETCAP/MAH, SETMODEL, REBOOT) виконується лише після AUTH.
    Раніше USB писав узагалі без пароля.
    Веб-API:
    - Пароль тепер ОБОВ'ЯЗКОВИЙ для всіх операцій запису (requireAdmin).
    Раніше запит без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
    [serial_api.h, web_server.h]
2026-07-03 Запис моделі: точна діагностика + ширший пошук запису 0x0B
    Причина помилки «Model must be 3..9 chars … and a model record/header
    must exist»: applyModel() не знаходив у поточному дампі ані запису 0x0B,
    ані ASCII-заголовка — тобто чіп порожній/стертий/невідомий. Повідомлення
    було нечітким (плутало «невірне ім'я» і «нема куди писати»).
    - Винесено modelNameValid(): валідація імені окремо від наявності запису.
    - handleSetModel / serial SETMODEL: рі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
2026-07-03 Функція «Новий акумулятор»: ініціалізація порожнього чипа з еталона + mAh
    Для порожнього/стертого/невідомого чипа: обираєш модель зі списку вшитих
    genuine-еталонів і вводиш ємність у мА·год — прошивка пише повний робочий
    дамп тієї ж моделі й робить АКБ «як новий».
    - templates.h: вшиті genuine-еталони PMNN4488A і PMNN4493A (DS2433 512 Б +
    DS2438 64 Б). Витягнуто з підтверджено робочих батарей; перевірено:
    заголов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
2026-07-03 templates.h: додано genuine-еталон PMNN4409B
    Наданий дамп PMNN4409B — genuine (є COPYRIGHT2014MOTOROLASOLUTIONS і
    калібрування 0x1B-0x1E). Перевірено: заголовок Σ≡0x41, дзеркало
    DS2438[24:50]==DS2433[1:27], запис моделі 0x0B Σ≡0x5A. Тепер доступний
    у списку моделей для «Новий акумулятор» (веб/USB/Serial) — усього 3
    шаблони: PMNN4488A, PMNN4493A, PMNN4409B.
    Claude-Session: https://claude.ai/code/session_013cmyomm8dp7jUBxwDbnVsL
2026-07-03 USB-запис без пароля, шаблон PMNN4409A, дії дисплея (REBOOT + Новий АКБ)
    USB/Serial запис більше не блокується паролем:
    - По USB пароль ОПЦІЙНИЙ (фізичний доступ до кабелю = дозвіл). Прибрано
    жорсткий гейт AUTH у serial_api.h; писати можна й з порожнім полем.
    ensureAuth() у client_usb.html більше не блокує — надсилає AUTH лише
    якщо пароль введено (для підсвітки статусу). Веб-API пароль вимагає.
    Це усуває "запис не відбуваєт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
    [display.h, motorola-battery-reader-web.ino, serial_api.h]
2026-07-03 batteryGenuine: модельно-залежна перевірка (не лаяти 4409A як підробку)
    Стара евристика вважала будь-який чіп без блоку "MOTOROLA" підробкою і
    позначала РОБОЧІ PMNN4409A (формат 2014, у якому MOTOROLA/підпис 0x1B-0x1E
    штатно відсутні) як «РИЗИК: нема автент.». Перевірено на робочому 4409A,
    який рація приймає.
    Нова логіка (перевірка цілісності ПРОШИВКИ, не «чи живі елементи»):
    - Червоні прапори для будь-якої моделі: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
2026-07-03 Полагоджено USB-запис: RX-буфер ESP32 + повний перепис client_usb.html
    Корінь «половина функцій запису не працює»: типовий UART RX-буфер ESP32 =
    256 Б переповнювався великими командами (WRITE33/WRITEFIX33 = 512 Б -> ~1 КБ
    hex), тому вони приходили побитими і запис не відбувався (короткі команди —
    RESET/SETMODEL/SETMAH — працювали).
    Прошивка:
    - Serial.setRxBufferSize(4096) до Serial.begin() — великі команди тепер
    влазять цілком.
    client_usb.html (повний п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
    [motorola-battery-reader-web.ino]
2026-07-03 usb_client/: standalone .exe міст (pyserial) — USB-клієнт без Web Serial
    Відповідь на «чи можна зробити exe для клієнта»: так. Тека usb_client/:
    - moto_bridge.py — відкриває COM-порт напряму через pyserial і показує той
    самий client_usb.html у БУДЬ-ЯКОМУ браузері через локальний веб-сервер
    (127.0.0.1:8765). Транспорт cmd() підмінюється з Web Serial на /cmd —
    сам інтерфейс не дублюється. Строго послідовний обмін #R#{json},
    ігнорує відладкові рядки, п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
2026-07-03 usb_client: прибрати __pycache__ з репозиторію, додати .gitignore
    Видалено випадково закомічений __pycache__ (артефакт py_compile-тесту),
    додано .gitignore для build/dist/pyc/spec.
    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
2026-07-03 usb_client: нативний GUI-клієнт (Tkinter) — .exe без браузера
    Додано moto_gui.py — самодостатній графічний клієнт на Tkinter (у стандартній
    бібліотеці, тож пакується в один .exe без зайвих залежностей). Власне вікно,
    браузер не потрібен.
    - Вкладки Огляд / Дані / Прошивка / Редактор / Журнал; усі операції протоколу
    serial_api.h: READ/INFO, копії .bin, RESET/REPAIR/CLEAN/WIPE33, SETMODEL,
    INITBAT (+TEMPLATES у списку), SETMAH/SETCAP, WRITE33/38 з файлу, редак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
    [moto_gui.py]
2026-07-03 Прибрано Serial.setRxBufferSize() — єдина зміна в boot-шляху; чанкінг у клієнтах
    Скарга: після прошивки читання АКБ падає скрізь («аккумулятор не найден»).
    Низькорівневий код 1-Wire (battery_reader.cpp) я НЕ чіпав — git це підтверджує,
    тож логіка читання байт-у-байт оригінальна. Єдина зміна в шляху ініціалізації —
    Serial.setRxBufferSize(4096) перед Serial.begin(). Прибираю її як єдиного
    підозрюваного (вона й зайва).
    Щоб великі к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
2026-07-03 GUI: HxD-подібний редактор hex + іконка застосунку (акумулятор)
    Редактор байтів (moto_gui.py) — тепер як у HxD: три синхронні панелі —
    Offset(h) | HEX (16 байт, розбито по 8) | декодований ASCII-текст.
    - Колонка зсувів (00000000, 00000010, …) і ASCII перераховуються наживо
    при редагуванні; спільне вертикальне прокручування (смуга + колесо).
    - Заголовок колонок як у HxD; моноширинний шрифт.
    Іконка:
    - make_icon.py генерує icon.ico (аку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
2026-07-03 README: повне оновлення під усі зміни гілки
    - USB-клієнт: три варіанти (браузер / нативний .exe GUI / веб-міст), розділ 5
    переструктуровано; протокол доповнено AUTH/TEMPLATES/INITBAT/REBOOT.
    - Пароль: обов'язковий у вебі, опційний по USB; примітка про чанкінг записів.
    - «Новий акумулятор» (ініціалізація з еталона + мА·год), 4 вшиті моделі.
    - Модельно-залежна перевірка справжності (формати 2017 і 2014/4409A).
    - Редактор б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
2026-07-04 README: спростовано прив'язку до серійника + аналіз блокування після заміни
    Розділ 10 доповнено перевіреними по дампах фактами:
    - Прошивка НЕ прив'язана до серійника (ROM DS2438). Три тести: калібр-блок
    однаковий при різних серійниках; байтів серійника немає в пам'яті; стирання
    + ремонт зберігає опізнання моделі. Прив'язка — до МОДЕЛІ.
    - Механізм блокування «невідома» після заміни елементі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
2026-07-05 Ремонт після заміни елементів: стирання learned-калібрування (0x0A)
    Аналіз дампа однієї й тієї ж PMNN4409B ДО/ПІСЛЯ калібрування на IMPRES-ЗП
    (суми зійшлися) показав: ЗП під час навчання записує у DS2433 TLV-запис 0x0A
    (learned-калібрування, Σ≡0x5A — виміряні ємність/імпеданс реальних банок) +
    статус 0x0D, оновлює кінець кривої, лічильники 0x0D та кінцеву телеметрію.
    Тому після заміни банок старий 0x0A суперечить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
2026-07-05 Додано R7-акумулятори у шаблони: PMNN4809A, APLI4810C (+ захист дзеркала)
    Наданий у дампах R7 (формат 2021) не був у списку. Додано (перевірено:
    заголовок Σ≡0x41, запис моделі Σ≡0x5A):
    - PMNN4809A (монітор DS2438 із даними),
    - APLI4810C (дамп DS2438 знято «порожнім» — після запису калібрувати на R7-ЗП).
    Тепер у «Новий акумулятор» / TEMPLATES 6 моделей.
    R7 не використовує дзеркало DS2438[24:50]==DS2433[1:27]. Щоб Ремонт/RecalPrep/
    autofix не затерли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
2026-07-05 Дата першого користування = ETM (наробіток DS2438): показ + редагування
    Аналіз: дата НЕ зберігається в АКБ. Дифф однієї PMNN4409B до/після калібрування
    показав — дата у рації не змінилась, а ETM (DS2438[8..11], сек наробітку) виріс
    рівно на тривалість циклу (~7 год). Пошук по дампу будь-якого хранимого поля
    дати — нічого. Висновок: рація рахує «перше користування» = її поточний час − ETM.
    ETM=5.16 р для АКБ 2018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
2026-07-05 tools/make_splash.py: конвертер зображення -> заставка XBM 64x64
    Дозволяє замінити стартову заставку (ngu_xbm у display.h) на власне зображення
    (на яке є права): вписує у 64x64, переводить у 1 біт (поріг або дизеринг),
    друкує готовий C-масив у форматі ngu_xbm[]. Потрібен Pillow.
    Не відтворюємо захищені авторським правом персонажі/лого.
    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
2026-07-23 Fix ETM/first-use display: detect baked-in Unix timestamp
    When the ETM register holds a value implausible as operating time
    (>34 years), it is almost certainly a Unix timestamp baked into the
    DS2438 (e.g. 0x5DECC526 = 08.12.2019) rather than an elapsed-time
    counter. The radio computes first-use = its_clock - ETM, so such a
    value makes it show an absurd date (~1976). All three clients now
    flag this case with a warning and reveal the underlying Unix date,
    instead of silently printing the wrong 1976 date.
    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
    [moto_gui.py]
2026-07-23 RecalPrepare: seed ICA fuel gauge to full rated capacity
    After cell replacement, RecalPrepare already zeroes CCA/DCA/ETM and the
    0x0D mirror, but the ICA remaining-capacity register (DS2438[12]) kept a
    stale reading that no longer matches the new cells and can confuse the
    charger. Seed ICA to the full rated capacity so counting starts from a
    clean, sane state. Also corrected the doc-comment (ICA was never zeroed
    by resetBatteryData).
    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
    [web_server.h]
2026-07-23 Add color TFT support (ST7789VW 240x240 / ST7789V3 240x280)
    New display_color.h implements the full display interface for color
    ST7789 panels using Adafruit_ST7789 + U8g2_for_Adafruit_GFX, keeping
    all Cyrillic text. Color menu with charge-level coloring (green/yellow/
    red), red danger actions, and a blue-yellow NGU splash. display.h now
    dispatches to either the color module or the untouched monochrome u8g2
    path via the DISPLAY_ST7789_SPI macro (mutually exclusive, so the mono
    build is byte-for-byte unchanged). settings.h gains the ST7789 options
    (size, rotation, invert, optional backlight pin); README/INSTRUCTION
    document the required Adafruit + U8g2_for_Adafruit_GFX libraries.
    Co-Authored-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
    [display.h, display_color.h, settings.h]
2026-07-23 Color TFT: corner-safe layout for rounded ST7789V3 240x280
    The 1.69" 240x280 ST7789V3 module usually has rounded corners that clip
    text placed in the corners. Add opt-in DISPLAY_ST7789_ROUND (radius via
    DISPLAY_ST7789_CORNER, default 22px): header title, page indicator,
    status line, hex rows and page content are inset by a corner-safe margin
    (EDGE/CX) so nothing is cut by the arc. Full-width header/footer bars
    still bleed to the edges (their clipped corners read as a rounded bar).
    Square panels are unaffected (EDGE defaults to 6).
    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
2026-07-23 Fix reset/clean corrupting calibration (radio 'unknown battery')
    Diffing a reset battery against the genuine PMNN4409A template revealed
    that resetBatteryData was zeroing the 0x0D record's [+4..+7] bytes and
    factoryCleanData was zeroing the 0x16 record - but these hold CALIBRATION
    data, not usage counters:
    - 0x0D[+4,+5] = capacity (~0x09B7 = 2487 mAh), NOT CCA. Proof: a
    post-calibration dump with DS2438 CCA=2310 had 6 there, unrelated.
    - first 0x16 record ('16 00 86 00 6C 00 ...') is a calibration table.
    Zeroing them made the radio report 'unknown battery' and blocked
    readings, and the charger read a broken capacity (showed green / would
    not charge). Now reset/clean only touch the real DS2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
    [web_server.h]
2026-07-24 display: auto-enable color path from ST7789 size preset; default I2C addr
    Two robustness fixes for the reported build error:
    - A DISPLAY_ST7789_* size preset now activates the color path even if the
    master DISPLAY_ST7789_SPI switch was left commented (previously it silently
    fell back to the monochrome SSD1306 path).
    - DISPLAY_I2C_ADDR defaults to 0x3C in the monochrome branch if the user
    commented it out, so the build no longer fails with
    'DISPLAY_I2C_ADDR was not declared in this scope'.
    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
    [display.h]
2026-07-24 Fix color build: use only fonts bundled in U8g2_for_Adafruit_GFX
    The color module referenced u8g2_font_9x18_t_cyrillic and fub* fonts,
    which U8g2_for_Adafruit_GFX does not bundle (it ships a subset of u8g2
    fonts). Compilation failed with 'u8g2_font_9x18_t_cyrillic was not
    declared'. Switched all text to fonts confirmed present in the library
    (5x8/6x12/7x13/8x13/9x15/10x20 *_t_cyrillic) and draw the big charge %
    with Adafruit_GFX's built-in scaled font (setTextSize) so it has no
    font dependency at all.
    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
    [display_color.h]
2026-07-24 Color display: remove black halos around text on colored bars
    Text was drawn in transparent font mode; where it lands on the colored
    header/footer bars the glyph background rendered as black, producing dark
    halos. Switch to solid font mode and set each glyph's background to match
    the region it's drawn on (C_HDRBG for the header, C_CARD for the footer/
    action hint, C_BG elsewhere). tSet() gained an optional bg parameter
    defaulting to C_BG. The big charge % (Adafruit_GFX built-in font) stays
    transparent over the multi-colour battery bar.
    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
2026-07-24 Color display: keep text clear of the bottom status bar (portrait)
    On portrait panels the bottom detail line on the main page and the last
    hex-dump row could sit right at (or under) the footer bar. Main-page
    detail rows now use a step that fits even the shortest portrait height
    (240) with a clamp, and the hex loop checks each row fits above the
    footer BEFORE drawing (>=10px margin) instead of after. Nothing crawls
    under the status bar now on 240/280/320.
    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
    [display_color.h]
2026-07-24 Add DS2438 full-erase; fix exe editor large-write reliability
    - New DS2438 erase (fills 0xFF): performWipe2438 + /api/wipe2438 (web),
    WIPE38 (serial), buttons in index.html/client_usb.html/GUI, and a
    'СТЕРТИ 2438' item in the on-device menu (NUM_BASE_ACTIONS 6->7, both
    mono and color menus; .ino dispatch act==6, templates shift to >=7).
    - exe hex editor 'write error': the ~1 KB WRITE33 over serial was
    overflowing the ESP32's 256-byte UART FIFO (web worked because HTTP
    delivers it intact). Send in smaller 96-byte chunks with 15 ms gaps so
    loop() drains the FIFO between chunks.
    Claude-Session: https://claude.ai/code/ses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
    [display.h, display_color.h, moto_gui.py, motorola-battery-reader-web.ino, serial_api.h, web_server.h]
2026-07-24 GUI: model-based hex editor; color display: less flicker
    Hex editor rebuilt around a byte-array model instead of a free-text
    field. Only hex nibbles and the ASCII column are editable; the address
    gutter and the separator spaces can no longer be altered, and the byte
    count is always exactly 512/64. This also removes a cause of the exe
    'write error': a misaligned free-text edit produced the wrong length,
    which the firmware rejected. The ASCII column is now editable too
    (printable char -> byte).
    Color display: full-screen clear (fillScreen) now happens only on a page
    change; same-page data/status updates clear just the body, so the header
    and status bar no longer flash on every refresh.
    Co-Au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
    [display_color.h, moto_gui.py]
2026-07-24 Fix DS2438 writes failing on page 7 (CCA/DCA accumulators)
    writeDS2438 strict-verified page 7, but bytes 56-63 hold the CCA/DCA
    charge/discharge accumulators, which the chip auto-updates. The
    scratchpad readback there differs from what was written, so memcmp
    failed and the whole write returned false. This broke SETETM (date ->
    'write failed') and WIPE38 (-> 'wipe failed'); a plain reset happened to
    pass only because it writes 0 there. Treat page 7 as volatile (CRC-only,
    like pages 0-2); pages 3-6 (calibration mirror EEPROM) stay strictly
    verified. Per the DS2438 datasheet, page 0 temp/voltage/current are
    read-only measurements and cannot be erased - that is expected, not a
    failure.
    Co-Autho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
    [battery_reader.cpp]
2026-07-24 DS2438 write: verify by memory read-back of calibration pages only
    The per-page scratchpad verify kept producing false 'write failed' on the
    live/counter pages (0-2 measurements, page 7 CCA/DCA), which blocked
    SETETM (date) and WIPE38 entirely. Rewrote: write every page (Write+Copy
    Scratchpad), then read the memory back and verify ONLY pages 3-6 (the
    calibration mirror EEPROM). Live/counter pages are not verified (the chip
    rewrites them). This fixes SETETM and WIPE38, and when a real EEPROM
    write fails it now logs exactly which page and want-vs-got over Serial.
    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
    [battery_reader.cpp]
2026-07-24 Fix DS2438 'not found' on write (cached-ROM fallback); no-flash paging
    Serial log showed DS2433 wipe OK but every DS2438 write -> 'DS2438 not
    found for writing', while reads find it. The 1-Wire Search for the
    DS2438 is intermittently unreliable on the write path. findDevices now
    falls back to the cached ROM (from a prior successful read) and
    addresses the chip via Match ROM, which is more reliable than Search.
    This unblocks SETETM (date) and WIPE38.
    Display: never fillScreen — always clear only the body between header and
    footer, so page flips no longer flash the whole screen; header/status bar
    repaint over themselves in place.
    Clau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
    [battery_reader.cpp, display_color.h]
2026-07-24 INITBAT: keep factory calibration for 2021-format templates
    Diffing the user's 4809A clone against the template showed INITBAT's
    eraseLearnedCalib had wiped the 0x0A record at 0x160 (present only in the
    2021/IMPRES2 4809A template). In the 2021 format that record is factory
    calibration data, not donor 'learned' data, and erasing it is a likely
    cause of the calibration aborting a few minutes into the discharge on the
    IMPRES 2 charger. INITBAT now detects the 2021 format (COPYRIGHT2021
    marker) and writes the template exactly, without erasing; older 2014-
    format templates keep the previous erase behavior. This is independent of
    the battery-capacity hypothesis.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
2026-07-25 Fix model write on empty chip; add set-charge-from-voltage
    - SETMODEL now works on a wiped/empty chip: applyModel creates the 0x0B
    model record at the standard offset (0x148) when none exists, instead
    of erroring 'empty/unknown chip'. That is exactly the case the manual
    model write is meant for.
    - New set-charge feature: write the ICA (state-of-charge) either
    automatically from the measured voltage (7.0 V = 0%, 8.4 V = 100%) or
    manually as a percent. Fixes the 'shows 14% at 8.1 V' wrong reading;
    the charger/radio refine it later. Exposed via /api/setcharge (web),
    SETCHG (serial), and buttons in the GUI, index.html and client_usb.html.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
    [moto_gui.py, serial_api.h, web_server.h]
2026-07-25 Web hex editors: model-based editing; GUI address alignment
    Rewrite the index.html and client_usb.html byte editors to be model-based,
    mirroring the desktop GUI: a single hxBytes array is the source of truth and
    both the hex and ASCII panels only render it. Keystrokes are intercepted so
    that only hex nibbles (hex panel) and printable chars (ASCII panel) mutate the
    model; separators, the offset gutter and column alignment can no longer be
    edited or corrupted, and the written byte count is always exact. The decoded
    text column is now editable, and paste/cut/drop are blocked to prevent
    desync. Scroll position is preserved across re-renders.
    Also align the GUI hex tab: match padx/bd/highlightth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
    [moto_gui.py]
2026-07-25 tools: add decode_dump.py (annotated dump decode + genuine-vs-clone diff)
    Standalone analyzer for IMPRES chip dumps. Decodes the DS2433 header with its
    Sigma=0x41 checksum, ASCII/copyright markers and firmware-format detection,
    the model record, the 0x0D/0x16/0x17 TLV records (each verified against the
    Sigma=0x5A invariant), the capacity/health byte, and the DS2438 fields
    (ETM, ICA, CCA, DCA) plus the DS2438<->DS2433 mirror check.
    --template extracts a bundled reference from templates.h to .bin, and --diff
    compares a clone byte-by-byte against a reference, classifying each difference
    as identity/calibration (must match) vs counter/live-measurement (expected to
    differ after a reset). Reuses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
    [decode_dump.py]
2026-07-25 Add verbatim template restore (from-scratch repair for blank/damaged chips)
    New performRestoreTemplate() writes a bundled genuine reference (DS2433+DS2438)
    byte-for-byte: no factory-clean, no learned-calib erase, no ICA override, no
    checksum recompute (the template is already valid). The result is a bit-exact
    copy of a working pack with its full learned calibration (0x17 histogram, 0x16
    curve, CCA/DCA/ETM/ICA) intact -- the most reliable from-scratch repair, and
    the strongest path to a working, calibratable 4409B.
    Works on a blank (all-0xFF) or corrupted chip: the overwrite replaces all
    content and the ROM is located by 1-Wire Search/Match, so no prior read is
    needed. Each chip is written i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
    [display.h, display_color.h, moto_gui.py, motorola-battery-reader-web.ino, serial_api.h, web_server.h]
2026-07-25 Recovery Wizard phase 1: engine + rules database + shared API
    Add recovery.h -- the shared 'brain' of one-button automated recovery for all
    surfaces (device menu, WiFi web, USB web, desktop GUI). Flow: analyze chip
    state -> issue bitmask -> human diagnosis + proposed fixes (rules table) ->
    ordered recovery plan -> per-step execution reusing the existing perform*
    functions.
    RECOVERY_RULES is the extensible logic 'database': each row maps a detected
    problem to its severity, a human-readable diagnosis, a proposed fix and a wizard
    action. wizAnalyze() detects blank/corrupt header, missing model, mirror
    mismatch, CCA overflow, missing DS2438, low health and needs-calibration.
    wizBuildPlan() turn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
    [recovery.h, serial_api.h, web_server.h]
2026-07-25 Recovery Wizard phase 2: wizard UI on web + USB + desktop; stable plan
    Add a Wizard tab/screen to all three external apps that consumes the shared
    wizard JSON: WiFi web (index.html), USB/bridge web (client_usb.html) and the
    desktop GUI (moto_gui.py). Each shows the analysis verdict, the detected
    problems (severity-coloured), and the recovery plan as a step list with a
    progress bar. One button runs the next step; the current step animates while
    executing; problems/fixes come straight from the rules table. A model picker
    appears only when a restore step needs one, and the charge-station step shows
    a 'return from charger' banner that polls for the before/after change.
    Engine: make the plan STA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
    [moto_gui.py, recovery.h]
2026-07-25 Phase 3: military NGU restyle across web + desktop; menu ordering
    Apply a cohesive military theme (olive/khaki field + maroon 'krapovy' accent)
    as the new default look for all external apps:
    - index.html and client_usb.html: repoint the CSS palette variables so every
    reference adopts the theme; olive/maroon field texture on the body, a
    maroon top-stripe on the header, and blue info tones swapped for olive/khaki
    (notes, hex-editor accents included).
    - moto_gui.py: an apply_military_theme() that styles the ttk 'clam' theme
    (frames, labels, buttons, notebook tabs, entries, combobox, progressbar,
    scrollbars) plus dark field colours for the tk hex-editor panels, dump
    v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
    [moto_gui.py]
2026-07-25 Phase 4a: smooth splash fade + brightness API (mono + color)
    Startup now fades the splash in and out with no init artifacts, then fades the
    main menu in — the screen stays black until the splash appears.
    - Colour TFT (display_color.h): backlight is driven by PWM (analogWrite on
    DISPLAY_BLK_PIN). displayInit turns the backlight OFF before tft.init and the
    first fillScreen, so all initialisation happens unseen; displayIntro ramps the
    backlight up, holds, ramps down; displayFadeInMain draws the main page dark and
    ramps up. Without a BLK pin it degrades to an instant show.
    - Mono OLED (display.h): same flow via u8g2 setContrast (0 -> DISP_BRIGHT). init
    starts at contrast 0 with a cl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
2026-07-25 Fix: read with no battery falsely 'succeeds' with blank chips
    Root cause: the cached-ROM fallback in findDevices() was used unconditionally.
    After any prior successful read the ROM IDs stay cached, so with the battery
    DISCONNECTED the search finds nothing but the fallback still addressed the
    absent chip by its old ROM. Reading an empty bus returns all-0xFF, which
    readBattery reported as a successful read of a blank chip -- the UI pretended
    the read worked and showed 'all chips clean'.
    Fix: only use the cached ROM when a 1-Wire presence pulse confirms a device is
    physically on the bus (_ow->reset() != 0). A present-but-blank chip still
    answers the presence pulse (so restore-from-scratch keep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
    [battery_reader.cpp, web_server.h]
2026-07-25 Phase 4b: on-device Recovery Wizard screen + smooth menu transitions
    Add a Wizard page to the device menu (page 8) on both display drivers, sharing
    the same engine and rules as the external apps:
    - display.h / display_color.h: g_wiz* render globals, drawPageWizard() (verdict,
    problem count + top problem, next step + progress, charge-station wait), a
    WIZARD_PAGE button branch (BTN2 short = analyze, BTN2 long = run next step),
    and displayConsumeWizRequest().
    - recovery.h: wizDeviceRefresh() fills the render globals from the current
    analysis + stable plan; wizDeviceRunNext() executes the next step (using the
    detected model for restore). Kept out of the render path via sh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
    [display.h, display_color.h, motorola-battery-reader-web.ino, recovery.h]
2026-07-25 Wizard: per-battery recovery journals with view/delete management
    Recovery continuation state is now stored per battery: each pending recovery
    lives in its own SPIFFS file keyed by the DS2438 serial (/wj_<serial>.jrn),
    so several batteries can be mid-recovery at once (e.g. one on the charger while
    you work on another). wizJournalLoad/Save/Clear operate on the current battery's
    file only and no longer wipe another battery's journal on serial mismatch.
    Add management:
    - recovery.h: wizJournalParse() (shared parser), wizJournalDelete(serial),
    wizJournalListJson() enumerating all /wj_*.jrn with serial, model, progress
    and the remaining PLANNED step titles.
    - web: GET /api/wizard/jou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
    [moto_gui.py, recovery.h, serial_api.h, web_server.h]
2026-07-25 Device UX: optional third 'OK/Action' button (backward-compatible)
    Add support for an optional third physical button (MENU_BTN3_PIN, commented out
    in settings.h -> the existing two-button behaviour is unchanged). When a GPIO is
    assigned it gives direct, convenient control on both display drivers:
    - short press: context action -- execute the selected op on the Actions page,
    run the next step on the Wizard page, or jump straight to the Wizard page
    from anywhere (quick access to recovery);
    - long press (0.8 s): jump home to the main page.
    All new code is guarded by #ifdef MENU_BTN3_PIN, so builds without the define are
    byte-identical to before. Documented in settings.h and README.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
    [display.h, display_color.h, settings.h]
2026-07-25 Fix: 3rd-button example pin 27 clashed with LED_RED_PIN; add conflict guard
    The MENU_BTN3_PIN example used GPIO 27, which is already LED_RED_PIN. Change the
    example to a free pin (33) and list the occupied GPIOs in the comment.
    Add a compile-time guard: if MENU_BTN3_PIN is set to a pin already used by the
    LEDs, 1-Wire, I2C, the other buttons or the display SPI control lines, the build
    fails with a clear #error instead of misbehaving on the device. Verified with the
    preprocessor: pin 27 -> error, pin 33 -> clean, undefined (default) -> clean.
    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
    [settings.h]
2026-07-25 Fix RESTORE serial-cmd compile error; charge falls back to voltage when ICA stuck
    serial_api.h: the RESTORE handler had one extra ')' in the sResp(...) expression
    ('expected ; before )' at build). Rewrite the response assembly into plain
    statements (String r = ...; r += ...; sResp(r);) so it is unambiguous and
    balanced.
    Charge display: the fuel gauge (DS2438 ICA) can read near-empty while the pack
    is actually full -- e.g. after cell replacement / a wiped chip, before the
    charger completes calibration. batteryPercent() now computes a voltage-based %
    first and, when ICA is used but reads >=25 points below the voltage estimate,
    returns the voltage value with source 'U!' instead of a misleading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
    [display.h, display_color.h, moto_gui.py, serial_api.h]
2026-07-25 Remove admin password; fix recal-prep/calibration; buzzer; 3-btn dedup; scrollable GUI tabs
    Password: disabled entirely -- requireAdmin() is now a no-op that always allows,
    so the WiFi web works without a password (USB/GUI were already password-optional).
    index.html: drop all client-side 'enter password' gates and hide the password
    fields.
    Calibration / recal-prep: eraseLearnedCalib() scanned 0x68..0x180, which (a)
    overlapped the model/capacity records (0x140..0x17F) and could corrupt them ->
    'no model' after prepare-for-calibration, and (b) MISSED the real IMPRES learned
    calibration record (0x0A) that for 4409B lives at ~0x1D2/0x1F0. Now it scans two
    safe zones -- 0x68..0x140 and 0x180..en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
    [display.h, display_color.h, leds.h, moto_gui.py, settings.h, web_server.h]
2026-07-25 Add battery charge animation on the main page (both display drivers)
    A 'charging shine' sweeps across the battery fill on the main page, driven by a
    ~9 fps tick in loop() that only touches the battery region.
    - Colour TFT: a thin highlight band sweeps the top strip of the fill (kept
    strictly above the big % digits so restoring the previous band never erases
    text); only a few drawFastVLine columns are written per frame -- cheap over SPI.
    - Mono OLED: drawBatteryIcon draws a 2px dark sweep column through the fill;
    displayAnimTick redraws just the battery icon into the buffer and pushes ONLY
    its tiles via updateDisplayArea -- important for the slow SSD1327 (a full
    sendBuffer every fr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
2026-07-25 Recal-prep: implement the validated post-cell-replacement recipe
    The user empirically confirmed that a rebuilt 4409B is accepted by the charger
    for calibration only after removing the DONOR learned-calibration from BOTH
    chips: clearing the DS2433 tail block (~0x1B0-0x1FF) AND fully wiping the
    DS2438. Decoding the 4409B template confirmed 0x1B0-0x1FF is a solid donor
    learned-calibration block (per-cell table 3C0F0C64.., cell voltages/impedances,
    the 0x0A record at 0x1D2, and a trailing checksum) that contradicts new cells.
    performRecalPrepare() now does exactly that:
    - DS2433: eraseLearnedCalib() (0x0A records) + clear 0x1B0..0x1FF to 0xFF for
    non-2021 formats (model/capacity/curve bef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
    [moto_gui.py, web_server.h]
2026-07-25 Battery anim -> pulsing fill; 3-button: BACK is now pure navigation
    Animation: replace the moving 'shine' with a pulsating fill (as requested).
    - Colour: the top strip of the fill (kept strictly above the % digits)
    breathes between the charge colour and a lighter shade via a triangle wave
    (new lighten565 helper); only that strip is repainted.
    - Mono: the charge-level edge breathes +/-2 px; displayAnimTick redraws just
    the battery icon and pushes only its tiles via updateDisplayArea.
    Third button: in 3-button mode BTN2 (Back) is now PURE previous-page navigation
    on every page -- it no longer does select/analyze (that was 'Back still does the
    third button's job'). All action c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
    [display.h, display_color.h]
2026-07-25 Buzzer: non-blocking single tones; warn passive-piezo-only (speaker brownout)
    A user reported the ST7789 display 'stopped working' right after enabling
    BUZZER_PIN. The most likely cause is an electrical brownout: a speaker coil
    (4-8 ohm) driven directly from a GPIO by tone() pulls ~0.4 A while the pin
    sources ~20-40 mA, so the first beep (ledSet(LED_OK) at boot) sags the rail and
    resets the ESP32 -> boot/splash/beep/reset loop -> the display never reaches the
    main screen.
    Make the buzzer non-blocking (single short tone() per event, no delay() calls)
    so it never stalls the loop/web and draws current for less time, and document
    loudly in buzzer.h and settings.h that ONLY a passive piezo buzze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
    [settings.h]
2026-07-25 Add DISABLE_BATTERY_ANIM toggle to isolate a display issue
    A user reports the ST7789 worked (with the speaker) until the battery animation
    was added. The animation only writes a valid, on-screen region every 110 ms, so
    the cause isn't obvious from the code. Add a settings switch so the animation
    can be turned off without touching anything else, to isolate whether it is the
    cause and restore the display immediately: define DISABLE_BATTERY_ANIM in
    settings.h and the loop() no longer calls displayAnimTick().
    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
    [motorola-battery-reader-web.ino, settings.h]
2026-07-25 Battery animation is now opt-in (off by default) to keep the display reliable
    The main-page fill pulsation drove periodic partial redraws from loop(); on
    some ST7789 panels that correlated with the display misbehaving, while a clean
    boot log (reaches READY, AP up, no reset) rules out a crash/brownout. Since the
    animation is purely cosmetic, make it opt-in: gate the loop() tick behind
    ENABLE_BATTERY_ANIM (previously the always-on default with a DISABLE_ escape
    hatch). Out of the box the display now renders exactly as it did before the
    animation was added; users who want the pulsation can enable it in settings.h.
    Claude-Session: https://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
    [motorola-battery-reader-web.ino, settings.h]
2026-07-25 Fix splash double-flash, make fill pulsation visible, fix silent buzzer
    Three issues reported after enabling the animation (with backlight on):
    1. Splash 'lit up twice': displayIntro() faded the backlight up, then back
    down to black, and displayFadeInMain() faded up again -> two visible
    brightenings. Now the splash fades in once and stays lit as a boot logo
    through init; the menu appears via a single brightness dip (crossfade),
    with no full-black gap and no second flash.
    2. Battery animation invisible: the tick only faintly tinted a thin 8px top
    strip. Now the WHOLE fill breathes (charge colour <-> lighter, ~3.5s
    period) via fillRectExcept(), which repaints the fill minus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
    [display_color.h, leds.h]
2026-07-25 Fix silent buzzer (LEDC timer clash), restore animation default, lengthen splash
    Three follow-up symptoms: no animation, no sound, splash too short.
    - Sound: root cause was an LEDC timer conflict. Backlight (analogWrite on BLK)
    and the buzzer (tone) were auto-assigned adjacent LEDC channels 0 and 1,
    which SHARE one timer; the constant backlight analogWrite calls (fades, dips)
    kept re-setting that timer's frequency and muted the tone. Now the buzzer is
    pinned to its own LEDC channel/timer (channel 5) via ledcAttachChannel +
    ledcWriteTone on Arduino core 3.x (tone()/noTone() fallback for older cores),
    so backlight PWM can no longer silence it. Slightly longer audible durations.
    -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
    [display_color.h, motorola-battery-reader-web.ino, settings.h]
2026-07-25 3-button read moved to BTN3, stronger fill pulse, buzzer boot self-test + diagnostics
    Issue 3 (read triggered by wrong button): in 3-button mode BTN1 long-press
    still set g_readRequested, so the read fired on BTN1 instead of the third
    button. Now in 3-button mode BTN1 is pure forward navigation (longMs=0, no long
    event at all) and the battery read is BTN3 short-press on the main page (BTN3
    long = jump to Wizard). Applied to both colour and mono drivers. 2-button mode
    unchanged (BTN1 long = read).
    Animation: increased the fill-breath amplitude (up to ~176/255 toward white)
    so the pulsation is clearly visible; removed a stale comment.
    Buzzer (still silent on some setups): added a one-shot bo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
    [display.h, display_color.h, motorola-battery-reader-web.ino]
2026-07-25 Fix on-screen control hints for 3-button layout; buzzer BLK-pin guard; anim diagnostics
    Buttons: the 3-button behaviour was already left/right = paging only, third =
    all actions (since the previous change), but the on-screen hints still showed
    the old 2-button scheme ([>] hold = read, [<] select, etc). Rewrote every hint
    in both drivers to reflect the 3-button layout when MENU_BTN3_PIN is set
    ([<][>] page, [OK] action); 2-button hints unchanged.
    Sound: boot log shows 'BUZZER: ... attach=OK' and the self-test chirp ran, so
    the firmware drives GPIO32 correctly -- the silence is hardware/wiring. Added
    DISPLAY_BLK_PIN to the BUZZER_PIN conflict guard: if the buzzer shares the
    backlight pin, ana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
    [display.h, display_color.h, motorola-battery-reader-web.ino, settings.h]
2026-07-25 Reject input-only pins for buzzer; make battery pulse dramatic
    Root causes found from the user's boot log:
    - Sound: log showed 'E ledc: gpio_num argument is invalid' with BUZZER: pin=35.
    GPIO34/35/36/39 are input-only on the ESP32 (no output driver), so tone()/LEDC
    cannot emit on them -- the IDF rejects the channel while ledcAttachChannel
    still returns true (misleading attach=OK). Added a compile guard that fails the
    build with a clear message when BUZZER_PIN is 34/35/36/39, pointing to an
    output-capable pin (32). The fix for the user is BUZZER_PIN 32.
    - Animation: diagnostic confirmed it draws (page=0 battW=232 pct=78 fillw=176
    anim=on) -- the lighten-toward-white breath was j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
    [display_color.h, settings.h]
2026-07-25 Menu paging makes a mechanical click; button backlight as work indicator
    - Click, not beep: buzzClick now produces a real mechanical click instead of a
    35ms tone (which read as a squeak). During the click the pin is briefly
    detached from LEDC and driven with a few short direct GPIO impulses (a
    broadband tick, ~1.8ms), then LEDC is restored for the start/ok/err tones.
    - Button backlight LED as a status indicator (new optional BTN_LED_PIN): it no
    longer just glows -- it reflects state. Idle/ready = steady glow (find the
    buttons in the dark), read = blink in step with the read, write = fast blink
    ('attention, do not disconnect'), ok = steady, error = alarm blink. Driven in
    ledTas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
    [leds.h, settings.h]
2026-07-25 Battery animation: flowing gradient instead of brightness pulse
    A global brightness pulse over the fill wasn't eye-catching (the diagnostic
    confirmed it was drawing: page=0 pct=78 fillw=176 anim=on). Replaced it with a
    moving gradient: the fill is drawn as 4px vertical bands whose brightness
    follows a sine of position+phase, so bright/dark bands travel along the bar and
    the pattern drifts over time -- a spatial motion that reads clearly, unlike a
    uniform brightness change. Bands over the % digit box are split top/bottom so
    the number never flickers; geometry verified by simulation (no over-digit,
    off-fill, or double-drawn pixels). Uses an integer sine LUT (no float).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
    [display_color.h]
2026-07-25 Error notification: red 'light filter' over the whole screen (no blinking)
    On error the entire display now takes on a red tint for the duration of the
    notification, instead of the display drawing attention by other means. Done at
    the palette level: every C_* colour macro is routed through TC(), which, while
    g_errTint is set, maps the colour to a red shade of the same brightness
    (redFilter) -- so an ordinary page re-render produces a red-filtered screen with
    no per-page code and no framebuffer readback (ST7789 doesn't return it over SPI).
    Driven from the LED_ERROR lifecycle: the .ino loop watches g_ledMode and calls
    displaySetErrorTint(true) when it enters LED_ERROR, false when it leaves, so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
    [display.h, display_color.h, motorola-battery-reader-web.ino]
2026-07-25 Main page: move % text out to the left of a shorter battery; drop anim diagnostic
    Layout change (colour driver): the big percentage now sits to the LEFT and the
    battery bar to the RIGHT, shortened so the two never overlap. The % is
    right-aligned in a fixed-width zone (sized for '100%') so its right edge stays
    put as the digit count changes, with a 10px gap before the bar; the bar width is
    computed from the remaining space and its '+' terminal ends exactly at the safe
    margin. Since the digits are no longer inside the bar, g_pct* is zeroed so the
    flowing gradient now fills the whole battery (the tick's digit-box split becomes
    inert). Source/details lines re-anchored to the left margin.
    Also r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
    [display.h, display_color.h, motorola-battery-reader-web.ino]
2026-07-25 Gradient animation: configurable speed and smoothness
    Exposed the flowing-gradient parameters as settings.h knobs so the effect can be
    tuned without editing the driver:
    ANIM_GRADIENT_SPEED - flow speed (phase step per frame)
    ANIM_GRADIENT_MS - frame period (motion smoothness / frame rate)
    ANIM_GRADIENT_WAVELEN - wavelength in px (gradient gradualness/smoothness)
    ANIM_GRADIENT_MINLVL - min band brightness 0..255 (contrast)
    displayAnimTick now derives the sine index from WAVELEN and advances phase by
    SPEED; the loop() tick interval uses ANIM_GRADIENT_MS. All #ifndef-guarded with
    sensible defaults, so existing builds are unaffected.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
2026-07-25 Stop the display blinking during operations (footer-only status updates)
    displayRender() clears the whole page body to black (fillRect) before redrawing,
    so every displayShow() progress message during an operation flashed the body --
    read/write/repair/etc. showed 1-2 black blinks. The status text lives only in the
    footer, so displayShow() now redraws JUST the footer bar (drawFooterBar), leaving
    the body untouched: no blinking. readAllChips does one full displayRender() at the
    end so the refreshed battery data still appears after a read. Colour driver only
    (mono buffers a full frame before sending, so it doesn't exhibit this flash).
    Cla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
    [display_color.h, motorola-battery-reader-web.ino, web_server.h]
2026-07-25 docs: update README/INSTRUCTION/usb_client for this session's work
    Refreshed the reference documentation to match the current firmware:
    - Password removed everywhere (web + USB); AUTH now historical/no-op.
    - Recovery Wizard documented as complete (screen page 8, web tab, USB/GUI,
    per-serial journals + saved-recovery view/delete) instead of 'Phase 1'.
    - 3-button control scheme + read-on-BTN3, adaptive on-screen hints.
    - Indication section expanded: buzzer (menu click + operation tones,
    passive-piezo/input-only warnings) and button-backlight status LED.
    - Colour ST7789 effects: splash backlight fade, flowing battery gradient with
    its ANIM_GRADIENT_* tuning knobs, red error 'light filter'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
2026-07-25 Clean display at startup; ship user's default config
    - Boot is now clean: the last-read battery dump is no longer loaded from SPIFFS
    at startup, so the display/web/USB stay empty until a battery is actually read.
    SPIFFS is still mounted (wizard journals, in-session saving). The old
    load-on-boot behaviour is available via #define LOAD_SAVED_DUMPS_ON_BOOT.
    - settings.h now ships the maintainer's real hardware config as the repo default:
    colour ST7789 240x280 (ROUND, rot=1), BLK=4, 3rd button=33, buzzer=2,
    button-LED=15, and tuned gradient (MS=130, WAVELEN=120, MINLVL=150).
    - README notes the shipped default display and the clean-start behaviour.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
    [motorola-battery-reader-web.ino, settings.h]
2026-07-26 Stop the display blinking on error (recolor in place, footer-only execute)
    The red error tint was blinking the screen because displaySetErrorTint() called
    displayRender(), which clears the whole body to black before redrawing -- so
    entering AND leaving the tint each flashed black (the comment claiming otherwise
    was wrong). Fixes:
    - Split displayRender() into displayRenderBody(clearBody). The error tint now
    recolours the SAME page in place (clearBody=false): elements overdraw, the
    black background stays black, only the hue changes -> smooth red<->normal, no
    black flash.
    - Pause the flowing gradient while tinted (g_errTint) so the warning screen is
    fully static red, no motion.
    - Read/e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
    [display_color.h]
2026-07-26 No blinking during operations: steady button-LED + static screen while working
    The 'blinking during a command' is the work indicator, not the red alert:
    - Button backlight (BTN_LED_PIN) was set to BLINK during read/write ('work in
    progress'). During web/USB operations the loop runs between data chunks, so
    that backlight visibly blinked. Now it stays STEADY-lit during read/write;
    blinking is kept only for the error alert.
    - The flowing battery gradient now also pauses while a read/write is in progress
    (like it already pauses during the error tint), so the whole screen is static
    while a command executes -- no motion that could read as blinking.
    The discrete green/red status LEDs sti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
    [display_color.h, leds.h]
2026-07-26 Stop the TFT blinking when cycling operations on the Actions page
    The only repeated full-screen render in the device workflow was the action
    SELECT: each OK-short press to cycle through operations called displayRender(),
    which clears the whole body to black before redrawing -- so picking an operation
    flashed the screen on every press. Now the card updates in place:
    displayRenderBody(false) skips the full black clear, and drawPageActions clears
    only its own text lines (thin per-line rects) before drawing them, so there's no
    ghosting and no full-screen flash. Header/footer refill their own (unchanged)
    background so nothing there visibly flashes. Execution itself was already
    footer-only; this c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
    [display_color.h]
2026-07-27 Softer, smoother notification sounds (envelopes + volume control)
    The old tones were raw square waves at a fixed 50% duty -- the harshest a piezo
    can produce -- switched on and off abruptly, which is what made them sharp.
    - Volume is now set by PWM DUTY (BUZZER_VOLUME 0..255, default 150 -> ~23% duty
    vs the previous 50%), so a lower setting is not just quieter but mellower.
    - Every note has an ENVELOPE (quiet attack -> sustain -> quiet release), so
    there is no click at the start/end of a tone.
    - Signals are short musical phrases instead of a bare beep: operation start is a
    rising third E5->A5, success a major triad G5->B5->D6, error a gentle
    descending A4->E4 (low and unhurried -- c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
    [settings.h]
2026-07-27 Add dumps/ -- archive of 49 real battery dumps with the owner's descriptions
    Publishes the field data this project was built from: 49 batteries (98 files,
    DS2433 512B + DS2438 64B each), covering working originals the radio accepts as
    genuine IMPRES, ones reported as 'unknown battery' or dead, units after cell
    replacement, after reset/recalibration/partial-erase experiments, a battery
    reflashed with another model's firmware, and one suspected clone.
    Layout: one directory per observation, each with
    - notes.md -- the owner's own description, verbatim (radio/charger behaviour,
    what was done before the dump was taken); only the long hex blocks are
    replaced by links to the extracted files,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
2026-07-27 Повторний аналіз прошивок: причина «невідомого акумулятора» — чужа навчена калібровка
    Аналіз зроблено наново по всіх 49 АКБ із dumps/. Повний розбір із доказами —
    docs/FIRMWARE_ANALYSIS.md; перевіряється командою
    `python3 tools/decode_dump.py --survey dumps`.
    ГОЛОВНЕ
    Після заміни елементів рація каже «невідомий акумулятор» не через зіпсовану
    ідентичність (блок 0x000–0x065 у «непрацюючих» АКБ побайтово ідентичний р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
2026-07-27 Перебудова меню на всіх поверхнях під результати аналізу
    Списки операцій дублювалися в чотирьох місцях (екранне меню display.h і
    display_color.h, веб index.html, USB-клієнт client_usb.html + moto_gui.py) і
    розходилися складом, порядком, назвами й попередженнями. Номери дій у скетчі
    були зашиті числами 0..6 окремо від того, що малював екран, тож будь-яка зміна
    списку ламала відповідність «пункт -> обробник».
    operations.h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
2026-07-27 Виправлення: хвіст треба СКИДАТИ, а не стирати — інакше калібрування падає
    За зворотним зв'язком: після стирання хвоста рація АКБ приймає, але калібрування
    завершується помилкою і пакет не визначається повноцінно. Попередній висновок був
    неповним.
    ЩО ПОКАЗАЛИ ДАМПИ
    dumps/13-dozaryadka-na-stantsii: у дампі 01 хвіст стертий у 0xFF; далі АКБ пройшов
    на станції ПОВНИЙ цикл. У дампі 02 у всьому хвості з'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
2026-07-27 Керований розряд навантаженням (MOSFET) перед калібруванням
    НАВІЩО
    1. Зарядна станція не бере АКБ на калібрування, поки бачить його зарядженим:
    світить зеленим і просто тримає. Це той самий симптом, що ловився після
    ремонту. Розряд до 7.2 В знімає невизначеність — пакет свідомо не повний,
    станція йде в повний цикл. Підтверджує спостереження власника
    (dumps/12-eksperymentalnyi): «после небол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
2026-07-27 Виправлення збірки: FONT_BIG не існує -> FONT_MODEL
    На сторінці моніторингу розряду напруга малювалася шрифтом FONT_BIG, якого в
    display_color.h немає. Доступні: FONT_HDR, FONT_BODY, FONT_SMALL, FONT_MODEL.
    Найбільший — FONT_MODEL (10x20 на великих панелях, 8x13 на малих), його й беремо.
    Перевірено решту залежностей обох сторінок моніторингу: усі макрони й хелпери
    (drawHeader/drawHeaderBar, chargeColor, tSet/tPut, шрифти, геометрія) існують і
    оголошені Р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
2026-07-27 Розряд: авто-оновлення екрана, без накладання й без гортання меню у фоні
    Три вади режиму розряду, усі помічені на живому пристрої.
    1. ЕКРАН НЕ ОНОВЛЮВАВСЯ САМ
    Дисплей у цьому проєкті перемальовується ПО ПОДІЯХ (кнопка, читання, запис), а
    розряд — процес фоновий: dischargeTask() оновлював лише дані, тож картинка
    лишалася статичною до наступного натискання кнопки.
    Додано прапорець «екран з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
2026-07-27 Розряд: дані вбудованого датчика струму DS2438 і опитування раз на 5 с
    ОПИТУВАННЯ
    DISCHARGE_POLL_MS 10000 -> 5000. Частіше сенсу мало: DS2438 оновлює вимір
    приблизно раз на 27 мс, але шина 1-Wire й перемальовка екрана — теж робота, а
    процес триває десятки хвилин. Облік мА*год від періоду не залежить: інтеграл
    рахується з фактичного dt між опитуваннями.
    ДАНІ ВБУДОВАНОГО ДАТЧИКА СТРУМУ
    Вимірювальний резисто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
2026-07-27 Розряд: утримання сигналу enable і анімований показник заряду
    1. ENABLE ТРИМАЄТЬСЯ ПІДНЯТИМ УВЕСЬ РОЗРЯД
    Пін PULLUP_PIN (GPIO12) — це не лише підтяжка 1-Wire: ним АКТИВУЄТЬСЯ сам АКБ.
    У штатному режимі драйвер піднімав його на час транзакції й опускав одразу
    після неї (24 місця в battery_reader.cpp). Для розряду цього замало: між
    читаннями пакет неактивний, тож струм тік лише в моменти опитування і розряд
    факт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
2026-07-27 Головна сторінка: показ струму з вбудованого датчика DS2438, мА
    На головній сторінці був лише рядок «напруга + температура» — струму не було
    взагалі, хоча датчик його вимірює постійно. Тепер рядок містить усі три
    величини: напруга, СТРУМ у мА, температура.
    Струм береться з того самого регістра DS2438, що й на сторінці «Дані батареї» та
    в режимі розряду (формула ідентична), тож показання с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
2026-07-27 Обмеження струму розряду ШІМом із лінійною уставкою за напругою
    Розряд ішов «скільки дасть резистор»: на 5 Ом це 1.4–1.7 А. Тепер ключ
    керується ШІМом (LEDC на LOAD_PIN, 1 кГц/10 біт, явний канал 6), а уставка
    струму веде за напругою лінійно: 1000 мА на 8.40 В -> 300 мА на 7.20 В.
    Навіщо спадна уставка, а не одне значення: під великим струмом просадка на
    внутрішньому опорі передчасно продавлює напругу до ц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
2026-07-27 Живий монітор розряду у веб-версії та десктопному клієнті
    Розряд триває годинами, а стан у веб-інтерфейсі й у клієнтах був списком
    рядків, який у USB-клієнті та в .exe оновлювався ЛИШЕ по кнопці. Тепер у всіх
    трьох поверхнях однакова панель процесу, яка тягне дані сама.
    Автооновлення. Веб: раз на 2 с під час розряду, раз на 20 с у спокої.
    USB-клієнт і десктопний: 3 і 30 с (там кожне опитування йд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
2026-07-27 Дихання індикатора під час розряду веде ШІМ-контролер, а не loop()
    Симптом: плавне помаранчеве дихання «притормаживало» і скидалось саме в мить
    оновлення показань.
    Причина. Яскравість рахувалася з millis() і виставлялася ledcWrite() у кожному
    проході loop(), тобто анімація жила рівно доти, доки loop() крутиться. А цикл
    вимірювання розряду loop() не крутить: дві витримки по 80 мс на встановлення
    режиму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
2026-07-27 Масштабування вмісту в десктопному клієнті
    Вікно тягнулось і розгорталось, але вміст лишався тим самим: на великому екрані
    інтерфейс перетворювався на острівець дрібного тексту посеред порожнечі.
    Механізм — ІМЕНОВАНІ шрифти Tk. Віджет, якому дали такий шрифт, підхоплює зміну
    його розміру сам, тож масштаб застосовується без перебудови інтерфейсу. Усі 26
    місць із font=("Segoe UI", N) перев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
2026-07-27 Сторінка «Стан АКБ»: показувати реальні дані замість «Ємність: (зчитайте)»
    Після зчитування АКБ рядок «Ємність» на сторінці «Стан АКБ» писав «(зчитайте)»
    і НЕ змінювався скільки не читай. Причина не в читанні: decodeCapacity()
    принципово повертає false — строк служби в прошивці не зберігається, його
    рахує рація з навчених даних (перебір усіх зсувів по 7 АКБ із відомими
    показаннями збігу не д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
2026-07-27 Буфер обміну й контекстне меню в десктопному клієнті
    У hex-редакторі не працювало копіювання/вставка, контекстного меню не було
    взагалі. Причин дві, і кожна ламала все сама по собі.
    1. ПЕРЕХОПЛЕННЯ КЛАВІШ. Панелі hex/ASCII мають власний обробник <Key>, який
    блокує все, що не є шістнадцятковою цифрою. Ctrl+C приходить туди як символ
    \x03 — теж «не цифра», отже блокувався ще до вбудованого копі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
2026-07-30 Перевірка гіпотези про приховану CRC: третя сума й ремонт запису COPYRIGHT
    Перевірено на 49 реальних дампах із dumps/, а не на припущеннях.
    CRC у прошивці НЕМАЄ:
    • послідовність «… 4B CB», яку приймали за CRC-16 зі сталим старшим байтом,
    насправді звичайний запис [0x0D][дані][Σ≡0x5A] — перевірено на трьох
    моделях, 0x4B там рядовий байт даних;
    • прив'язки до ROM ID DS2438 немає: пряме входження ID (прямо, рев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
2026-07-30 Паспортна ємність — із самого чипа; три значення в таблиці були хибні
    Емулятор рації з node-dmr-lib гіпотезу CRC перевірити не може: це 59 рядків,
    які прикидаються РАЦІЄЮ перед ПК-програмою й віддають захардкоджений пакет. Він
    не читає акумулятор, не говорить по 1-Wire і не містить логіки «прийняти /
    відхилити» — вона всередині рації. Зате в текстах того проєкту знайшлося те, що
    пояснює давню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
2026-07-30 Штатний декодер Motorola: знос, цикли й дати таки лежать у чипі
    Звірка нашого декодування з еталонною вибіркою rick51231/node-dmr-lib
    (dev/BMS/images — сирі пакети в іменах файлів + знімки екрана фірмового ПЗ
    Motorola, і print.md тими ж числами таблицею). Декодер портовано і прогнано
    по 53 еталонних пакетах: поточна й потенційна ємність, паспортна ємність,
    здоров'я, три лічильники циклів і дата першого користува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
2026-07-30 Два робочих R7-пакети: дати збіглися точно, знайдено «чужий DS2438»
    Власник надіслав PMNN4807A і APLI4811C із правильними відповідями. Декодер
    відтворив обидві дати першого користування ТОЧНО — 2024-05-29 і 2024-06-20.
    Ключ у обох підібрався однозначно, а перевірка дати від ключа не залежить,
    тож два збіги поспіль випадковими бути не можуть.
    R7 розбирається тією ж таблицею векторів: заголовок Σ≡0x41, про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
2026-07-30 Шаблони відновлення: дві нові моделі R7 і «чистий хвіст» для всіх восьми
    Для PMNN4807A і APLI4811C шаблонів не було зовсім — відновити такий пакет було
    неможливо. Тепер вони є, з тих самих дампів, чиї дати власник підтвердив.
    «ЧИСТИЙ» ХВІСТ — ТЕПЕР ДЛЯ ВСІХ 8 МОДЕЛЕЙ
    Досі він виводився статистично: кілька екземплярів моделі, байт однаковий у
    всіх — стала, різниться — навчене. Тому для чотирь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
2026-07-30 Розряд під обрану ціль, сторож від зависання, шкали ICA й напруги, Майстер
    ЦІЛЬ РОЗРЯДУ Й ЛІНІЙКА СТРУМУ
    Ціль тепер обирається (пресети 7.80…7.00 В + поле в мВ, межі 6.80…8.00 В), і
    лінійка струму будується ПІД НЕЇ: 300 мА припадають рівно на обрану напругу,
    а не завжди на 7.20 В. Інакше при цілі 7.80 В розряд закінчувався б на 550 мА
    — саме на струмі, який і спотворює вимір ємності. Межі лінійки віддає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
2026-07-30 М'який звук із портаменто: ноти перетікають одна в одну
    Було: кожна нота — три сходинки гучності (тихо-гучно-тихо) і стрибок частоти
    на межі. Вухо чує саме сходинки й стрибки, тому сигнал виходив різким, а фраза
    розпадалась на кілька окремих писків.
    Стало: неперервний синтез. buzzTask() перераховує частоту й гучність кожні
    5 мс, і всі три джерела різкості прибрано:
    • Огинаюча ФРАЗИ (а не о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
2026-07-30 Догортання трьох пунктів: графік струму, мікросхеми в Майстрі, ціль на пристрої
    Із попереднього списку три речі були зроблені не до кінця.
    ГРАФІК СТРУМУ, ЩО ПЕРЕБУДОВУЄТЬСЯ ПІД ЦІЛЬ
    Просили «вибір цільової напруги З ВІДПОВІДНОЮ ПЕРЕБУДОВОЮ ГРАФІКА СТРУМУ», а
    зроблено було лише саму арифметику лінійки — побачити її не було де. Тепер під
    вибором цілі є графік уставки струму за нап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
2026-07-30 Налаштування звуку, що правляться на ходу
    Раніше характер сигналів був намертво вшитий у #define: щоб зробити тихіше,
    швидше чи вище, треба було перепрошивати. А це саме те, що доводиться
    підбирати на місці — у кожного п'єзо свій резонанс (звичайно 2–4 кГц), і те,
    що на одному екземплярі звучить м'яко, на іншому ледь чутно.
    buzzer.h: структура BuzzCfg (увімкнення, окремо блiп меню, гучність,
    швидкі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
    [moto_gui.py, motorola-battery-reader-web.ino, serial_api.h, settings.h, web_server.h]
2026-07-30 Правки еталона під конкретний пакет перед записом
    Шаблон у templates.h — побайтова копія ОДНОГО акумулятора. Разом із моделлю,
    кривою й заводською таблицею він несе числа ДОНОРА: рівень заряду, шунт
    вимірювача струму, апаратний OFFSET АЦП, наробіток. Записати їх у чужий пакет
    означає збрехати і рації, і зарядній станції.
    ЗНАЙДЕНА Й ВИПРАВЛЕНА ПОМИЛКА. performRestoreTemplate() рахував паливомір із
    impr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
2026-07-30 Ручне введення ємності нових банок у плані правок
    Паспортну ємність після заміни елементів взяти нізвідки: у моніторі її немає,
    а DS2433 при відновленні зазвичай саме той чип, що битий. Тому в рядку
    «Паспортна ємність» тепер є поле для ручного введення — поруч зі значеннями
    еталона й пакета, у тій самій таблиці.
    Ключове: за новою ємністю ОДРАЗУ перераховується паливомір. 77 % від
    3000 мА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
2026-07-30 Німий бліп, нечитабельні кнопки бріджа, Wi-Fi-дані на екрані
    БЛІП ПРИ ПЕРЕГОРТАННІ МЕНЮ не звучав узагалі. displayFlip() запускав фразу, а
    потім блокував loop() на весь час плавного переходу (12 × delay(5)) і
    displayRender() по SPI — разом близько 100 мс. Фразу веде buzzTask() із
    loop(), тож за цей час у LEDC не йшло ЖОДНОГО оновлення, і перший тік після
    повернення бачив, що 76-мілісекундна фраза скінчилась, і гасив вихід.
    cli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
    [display.h, display_color.h]
2026-07-30 0 % заряду = 6.85 В; текст шкали більше не може розійтися з числами
    BATTERY_EMPTY_MV: 7200 -> 6850 (просив власник).
    Але сама константа — це менша частина роботи. Точка «0 %» була продубльована
    ТЕКСТОМ у десятку місць: меню пристрою, підказки веба, USB- і ехе-клієнта,
    Майстер, план правок еталона, коментарі, README, docs. Два з них уже брехали:
    у діалозі ехе-клієнта й у коментарі web_server.h висіло «7.0 В = 0%, 8.4 В =
    100%» ві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
2026-07-30 Відновлення більше не віддає пакету чужий монітор; правки можна записати окремо
    РАЦІЯ НЕ БАЧИЛА АКБ ПІСЛЯ ВІДНОВЛЕННЯ — знайдено причину. Еталон DS2438 у
    templates.h це теж побайтова копія ОДНОГО пакета. Відновлення заміняло ним
    монітор робочого акумулятора цілком, а назад повертало лише шунт і OFFSET АЦП
    (keepMonitorCalibration). Усе інше ставало донорським — зокрема байти
    0x10..0x17, 0x32..0x35 і 0x3A..0x3B, значе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
2026-07-30 Шунт: доливання з еталона + ручний ввід і вибір із бібліотеки
    Дві частини одного сюжету — «у пакеті немає свого шунта».
    1. Перша спроба виправлення «рація не бачить АКБ» не спрацювала саме на тому
    пакеті, з якого почалась скарга (dumps/15-pislya-etalona-ne-vyznaietsya).
    «Свій монітор» визначався як «є заводський шунт», а в тому пакеті шунт був
    занулений → монітор вважався чужим і його знову замі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
2026-07-31 Знайдено третій механізм відмови: чужий ключ шифрування
    Власник уперше прислав дамп РАЗОМ з обома ROM — і це дозволило перевірити
    гіпотезу §4a.4 (ключі беруться з ROM чипа DS2433: key1=ROM[1], key2=ROM[6]).
    Пакет PMNN4409A, ROM DS2433 = A3427C17010050A6 -> key1=0x42.
    Вміст чипа вимагає key1=0x04 — підбір по даних дав РІВНО ОДИН варіант, і він
    чужий. Наслідок: рація розшифровує своїм ключем і бачить дату виготовлення
    2107-13-21, 3548 цик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
2026-07-31 Перешифрування дат і лічильників під ROM цього чипа; 0 % заряду = 6.35 В
    1. ПЕРЕШИФРУВАННЯ (третій механізм відмови після «заряд донора» й «чужий
    монітор», і єдиний, який досі ніяк не оброблявся).
    Частина полів DS2433 зашифрована ключем із ROM самого чипа (key1=ROM[1],
    key2=ROM[6]). Еталон знято з ЧУЖОГО пакета, тож рація розшифровує його поля
    СВОЇМ ключем і бачить сміття. На пакеті власника (dumps/16, RO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
2026-07-31 Режим навченого хвоста: ЗП світить зеленим — можна лишити хвіст стертим
    Скарга: «при любых действиях станция не заряжает, светится зеленым». Прогнав
    увесь корпус (52 дампи DS2433) за трьома зрізами й отримав три чіткі групи:
    оригінальні робочі (01,02,03,04,05,14) хвіст цілий ключ УЗГОДЖЕНИЙ заряджає
    після ремонту (06,07,08,15) хвіст цілий ключ НЕ знаходиться зелений
    після стирання (1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
2026-07-31 Правка шифрування не працювала саме на поламаних пакетах
    Скарга: «Дати й лічильники — під ROM цього чипа не читається і не змінюється».
    Відтворено й виправлено дві помилки, обидві — рівно в тому випадку, заради
    якого правку й робили.
    1. Колонка «що бачить рація» рахувалась УСЕРЕДИНІ гілки «ключ вмісту
    визначився». А для неї потрібен лише ROM чипа й більше нічого. На пакеті,
    вміст я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
2026-07-31 Запис зносу (здоров'я) — вручну, з перерахунком під шунт і ємність
    Знос лежить у тому ж зашифрованому блоці RECOND, що й дати, — це байт CTS,
    потенційна ємність пакета в одиницях ICA:
    мА·год = 0.48828125 * CTS / шунт
    знос % = 100 * мА·год / паспортна ємність
    Зворотне перетворення звірено на реальному пакеті: знос 34 %, ємність 2150,
    шунт 0.04517 -> CTS 68, і саме 68 лежало в чипі. Кругова перевірка 5..100 % —
    похибк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
2026-08-02 Розділ «Ремонт» розкладено на під-вкладки; налаштування — окрема сторінка
    Сторінка ремонту виросла до 18 карток в один скрол (6868 px у вікні 1000):
    знайти потрібну операцію можна було тільки прокруткою, і сусідство «зчитати
    копію» з «повним стиранням» нічому не допомагало.
    Тепер шість під-вкладок у тому самому порядку, що й хід роботи:
    🩹 Ремонт копія, ремонт після заміни елементі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
2026-08-03 Запис дати першого запуску, калібрувань і лічильників циклів
    Чотири поля, які просив власник, лежать у трьох різних місцях — два
    зашифровані, два ні.
    ЗАШИФРОВАНІ (правка crypt, поруч із датою виготовлення й зносом):
    * дата першого запуску — у чипі це НЕ дата, а скільки діб від виготовлення,
    тож рахується від тієї дати виготовлення, яка реально піде в чип; разом із
    нею пишеться й по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
2026-08-03 Поля правок можна заповнити з прочитаного акумулятора
    Вводити наосліп те, що прилад уже прочитав, немає сенсу. Під полями правок
    з'явилися дві кнопки:
    📥 Узяти з акумулятора — заповнює всі шість полів тим, що ЗАРАЗ у пакеті:
    дата виготовлення, дата першого запуску, знос, калібрування, цикли IMPRES
    і не-IMPRES; далі будь-яке можна виправити руками;
    ✖ Очистити поля — повертає всі по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
2026-08-03 Наробіток рахується з дати першого запуску
    Рація показує «дату першого користування» як «зараз мінус наробіток» —
    числа з DS2433 вона для цього рядка не читає. Тому вписана дата першого
    запуску не доходила до екрана рації: DS2433 казав одне, а рація рахувала
    своє зі старого ETM монітора, і два вікна суперечили одне одному.
    Тепер наробіток рахується сам: (сьогодні − дата першого запуску)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
2026-08-03 Поточну дату бере системний годинник пристрою
    Досі «сьогодні» існувало лише всередині запиту від клієнта: наробіток
    рахувався тільки там, куди клієнт передав today=. У меню самого приладу й у
    Майстрі, запущеному з екрана, рахувати було нема з чого.
    Тепер джерело одне — системний час ESP32 (device_clock.h). RTC тут немає, а
    NTP недосяжний за побудовою: пристрій сам є точкою доступу, інтернету за ни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
2026-08-04 Перше читання, наробіток після ЗП і знос окремою карткою
    1) З першого разу показувало не все. Після кожної операції підтяжка гасне,
    тож обидва чипи знеструмлюються і КОЖЕН пошук — холодний старт шини.
    findDevices() піднімав підтяжку й одразу йшов у Search ROM: чип, який
    прокидається повільніше (зазвичай DS2438 — у нього ще й аналогова частина),
    у пошук не потрапляв. З другого натискання працювало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
2026-08-05 Майстер перевіряє зміст прошивки, а не лише структуру
    Досі аналіз дивився на структуру: суми заголовка, запис моделі, дзеркало,
    навчений хвіст. Але найчастіша скарга — «невідомий акумулятор» — народжується
    зі ЗМІСТУ: поля зашифровані ключем чужого чипа, дати суперечать одна одній,
    монітор від іншого пакета. Структурно такий дамп бездоганний, і Майстер мовчав.
    Додано шість знахі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
2026-08-06 Відновлення за зразком китайської копії: ядро й перевірка
    Коли жодна спроба відновлення не вдалася, лишається шлях самих копій: уся
    потрібна рації інформація живе в DS2438, а DS2433 порожній.
    Розібрано, ЧОМУ це працює. Сторінки 3..6 монітора — дзеркало заголовка
    DS2433: DS2438[0x18..0x32] побайтово дорівнює DS2433[0x01..0x1B]. Звірено на
    рідній парі 4409B — 27 із 27 байт; останні п'ять байтів заголовка в дзеркало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
2026-08-06 Перевірка джерел: ключ шифрування — з ROM цільового чипа
    Дані, які потребують шифрування, мусять шифруватись ключем із серійного номера
    того акумулятора, у який їх пишуть. Усі три місця запису це вже роблять
    (restore_plan.h під p.haveRom, обидва impresIdentityWrite під hasSN2433), але
    impresCryptWrite() приймає ключ звичайними параметрами — сама сигнатура нічого
    не гарантує, і завтра туди можна передати що завгодно.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
2026-08-06 Режим копії на всіх рівнях: прошивка, веб, брідж, GUI
    Обв'язка до ядра, закладеного попереднім комітом.
    Прошивка: performCloneRestore() — монітор зі зразка копії, лічильники в нуль,
    паливомір із РЕАЛЬНОЇ напруги пакета, вписана ємність у дзеркало заголовка
    (саме звідти рація її й читає, коли DS2433 порожній), шунт із дампа або зі
    списку типових, DS2433 стирається.
    Запис ідентичності в DS2433 — окремий і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
2026-08-06 Режим копії: вбудований зразок, скидання лічильників, корекція заряду
    Три доповнення до режиму копії, усі на всіх рівнях.
    1) Вбудований зразок. Дамп монітора реальної копії вшито в прошивку
    (CLONE_SAMPLES у impres_clone.h) — 8.02 В, шунт 45.65 мОм, OFFSET 0x0018,
    дзеркало з ємністю 2150 мА·год. Свій файл або hex теж лишились. Віддається
    через GET /api/clone/samples і команду SAMPLES, у клієнтах — списком поруч із
    вибором файл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
2026-08-06 APLI4493C у бібліотеку еталонів; уточнено твердження про дзеркало
    Модель додано за дампом власника. Розбір: заголовок Σ=0x41, профіль Σ=0x00,
    ємність 3100 мА·год, запис моделі APLI4493C, KIT-рядок у заголовку PMNN4493A
    (та сама платформа), 23 блоки, 19 із Σ=0x5A.
    Шунт у неї СВІЙ — 22.12 мОм проти 24.90 у PMNN4493A. Тому брати еталон 4493A
    для цієї моделі не можна: струм, залишок і знос вийшли б неправильні. Саме
    заради цього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
2026-08-06 Добудова заголовка, коли станція сама почала ремонт стертого DS2433
    Скарга: «якщо вставити пакет зі стертим DS2433 у зарядний WPLN4226A —
    прописується невелика частина пам'яті». Розбір наданого дампа: DS2433[0x01..0x1A]
    (26 байт) точно дорівнює дзеркалу DS2438[0x18..0x31], байт 0x00 і сума
    заголовка не виправлені (Σ=0x00 замість 0x41), а решта чипа (0x020..0x1FF) —
    суцільні 0xFF.
    Станція сама виконує перший крок нашого власн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
2026-08-06 Постранкове читання DS2433 з ретраєм — фікс «читається не повністю» при розбалансировці банок
    DS2433 живиться паразитно від самого пакета (окремого Vcc немає). Стара
    readBattery() читала всі 512 байт однією безперервною транзакцією й
    безумовно повертала true — якщо пакет із сильно розбалансованими банками
    просідав під навантаженням посеред читання, чіп втрачав живлення, і read()
    після цього повер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
2026-08-06 Вбудований зразок копії не з'являвся у списку через USB-міст
    client_usb.html: clLoadSamples() кликала неіснуючу esc() (у цьому файлі
    екранування зветься wesc(); esc() є лише в index.html) — копіпаст без
    перейменування. ReferenceError усередині await clLoadSamples() обривав увесь
    ланцюжок після підключення (sndLoad/clLoadSamples/disTick), тож і власне
    скарга (список зразків порожній), і сигнали розряду/звуку одразу після
    конекту мовчки не пі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
2026-08-07 Виправлено білі («невидимі») кнопки без модифікатора кольору
    .btn у index.html/data/index.html не мав жодного background — лише
    color:#fff. Кнопка без btn-*-модифікатора (обидві «seed»-кнопки плану
    правок: 📥 Узяти з акумулятора / ✖ Очистити поля) лишалась білим написом
    на стандартному фоні кнопки браузера — фактично невидимою. Тепер у базового
    .btn є свій фон (var(--info)), а самим seed-кнопкам додано btn-info
    явно — про з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
2026-08-07 Керований заряд через саморобний DC/DC (P-канальний MOSFET) з профілем струму
    Новий charge.h — той самий рівень запобіжників, що й discharge.h (керований
    розряд), але регулятор принципово інший: розряд керує ключем НА РЕЗИСТОРІ, де
    100% шпаруватості — безпечний відомий максимум, тож можна раз на цикл зняти
    пік і порахувати шпаруватість алгебрично. Тут ключ керує ПОНИЖУЮЧИМ
    ПЕРЕТВОРЮВАЧЕМ (14В -> нап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
2026-08-07 Задокументовано підтверджену схему керування ключем заряду
    Власник описав реальну схему: два транзистори — Т1 у спокої провідний і
    тримає затвор P-канального MOSFET на +14 В (закритий стан), Т2 керується
    ШІМ і при відкритті гасить Т1, тягнучи затвор у мінус (MOSFET відкривається).
    На вході Т2 є підтяжка до GND — при скиданні ESP32 це гарантує ключ
    закритим, поки GPIO32 не налаштований.
    Це рівно та п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
2026-08-07 Фікс помилки компіляції: неповний ініціалізатор g_chg (реальний білд ESP32)
    ChargeState має 20 полів, ручний список ініціалізації давав лише 19 значень —
    0.0f з кінця зсувався в поле dutyPct (uint8_t) замість rsense (float), і
    компілятор ESP32 падав на звуженні float->uint8_t (Arduino IDE: -Wnarrowing
    як помилка). Хостовий tools/charge_logic_check.cpp цього не міг зловити: він
    перевіряє лише чисту логіку профілю струму й регулятора, без самої с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
2026-08-09 Три кнопки на одному ADC-піні + звук через ЦАП (синус) (#82)
    * Три кнопки меню на одному ADC-піні (аналогова драбинка) — звільняє GPIO25/26
    За описаною власником схемою: підтяжка 10 кОм GPIO33(ADC1)->3.3В, кнопки на
    землю — Ввід/OK напряму (0 Ом), Вліво через 5 кОм, Вправо через 10 кОм.
    Розрахункові рівні/пороги (MENU_BTN_ADC_TH_*) виводяться з цих трьох
    номіналів автоматично, з запасом 500+ мВ між сусідніми станами.
    GPIO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
2026-08-09 Фікс білда ESP32: buzzIsr() — inline замінено на static (dangerous relocation l32r) (#83)
    Реальний компілятор (Arduino-ESP32 3.3.11, Xtensa) падав на лінкуванні:
    "dangerous relocation: l32r: literal placed after use" у buzzIsr(). Причина —
    inline-функція з IRAM_ATTR потрапляє у vague-linkage/COMDAT-секцію
    (.gnu.linkonce), де авто-розміщення пулу літералів перед кодом (потрібне
    l32r) ламається. static прибирає vague linkage — секція звичайна, порядок
    "літерал перед використанням" знову г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
2026-08-09 Фікс кнопок: analogReadMilliVolts() падала без eFuse-калібровки + більший запас порогів (#84)
    Власник підтвердив реальним залізом: на його платі (клон/безіменна, без
    прошитої заводської ADC-калібровки в eFuse) analogReadMilliVolts() валила в
    Serial "adc_cali: adc_cali_create_scheme_line_fitting(): default vref didn't
    set" на КОЖНОМУ виклику (кожен прохід loop()) і повертала невалідні мВ —
    звідси самовільне перемикання на 8-му сторінку при старті (хибн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
    [display.h, display_color.h, settings.h]
2026-08-09 Звук: гучніший квазі-меандр на п'єзо (замість чистого синуса) + довше згасання (#85)
    Власник підтвердив залізом: кнопки запрацювали, але звук ледь чутний.
    Причина фізична — п'єзо збуджує швидка ЗМІНА напруги (dV/dt), а не сама
    напруга; чистий синус на звукових частотах змінюється значно повільніше
    меандра, тож при тій самій цифровій амплітуді звучить помітно тихіше.
    Замінено таблицю ISR-с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
2026-08-09 Заряд: перехід на готову TL494-плату — enable + аналогове керування замість ШІМ на затвор (#86)
    Власник перейшов із саморобного P-канального MOSFET-драйвера на готову
    плату DC/DC на TL494 із принципово іншим інтерфейсом керування — старий
    однопіновий ШІМ-на-затвор більше не застосовний, повний перехід:
    - CHARGE_PIN (32) — тепер простий цифровий enable силового каскаду
    (digitalWrite, без ШІМ). LOW=безпечно (виходу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
2026-08-09 Заряд: додано на всі поверхні — екран пристрою, USB-клієнт, .exe (щоб не забути й не плутатись) (#87)
    Функція «Заряд через DC/DC» досі була лише в веб-інтерфейсі (свідоме
    обмеження обсягу попереднього PR). За проханням власника додано скрізь,
    за тим самим шаблоном, що вже пройшов розряд:
    - operations.h: новий OP_CHARGE_DCDC (9-та базова операція) — з'являється
    в меню «Дії» на екрані пристрою, і автоматично в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
2026-08-09 Індикація заряду: плавне зелене дихання замість блимання, поріг «майже готово» 90% замість 95%, 2 Гц (#88)
    Власник уточнив бажаний малюнок індикатора під час заряду: плавна
    пульсація (як дихання розряду), а не дискретне блимання, і перехід на
    часте моргання раніше — на 90%, а не 95%, з конкретною частотою 2 Гц.
    - ledBreathLeg()/ledBreathe() (leds.h) отримали параметр withRed: розряд
    і далі дихає ПОМАРАНЧЕВИМ (зел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
2026-08-09 Заряд DC/DC: вибір цілі у відсотках з перерахунком профілю струму (#89)
    Раніше заряд через DC/DC завжди йшов до повного пакета (8.25 В), а
    профіль струму (200→500→1000→1500→100 мА) мав фіксовані точки
    перегину на 10/50/80/95 % ПОВНОГО заряду. Тепер ціль обирається у
    відсотках (50–100 %, крок 5) на кожному клієнті — веб, USB-екзешник,
    пункт меню на самому пристрої (по колу, як і ціль розряду).
    При цілі T < 100 % точки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
2026-08-09 Заряд DC/DC: відмова стартувати, якщо не піднявся канал LEDC (#90)
    chargeStart() ніколи не перевіряв chargePwmOk() перед стартом. Якщо
    ledcAttachChannel() не отримав вільний апаратний таймер (їх ділять
    підсвітка/світлодіоди/зумер/розряд — легко вичерпати на платах із
    меншою кількістю таймерів/каналів), заряд усе одно піднімав enable
    силового каскаду, а керуюча напруга на CHARGE_CTRL_PIN лишалась
    некерованою в некаліб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
2026-08-09 Заряд DC/DC: 20 кГц недосяжні на 12-бітному ШІМ — знижено до 11 біт (#91)
    Реальний лог із пристрою власника показав справжню причину відмови
    attach() (не нехватку таймерів, як я вважав раніше в діагностичному
    підказці): "ledc: requested frequency 20000 and duty resolution 12
    can not be achieved". Дільник LEDC не може бути меншим за 1, тож
    максимальна частота на N-бітному таймері = джерело_такту/2^N; на
    12 бітах (80 МГц/4096) це рівно ~19.5 кГц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
2026-08-09 Друкувати причину скидання ESP32 при старті (BROWNOUT/WDT/PANIC) (#92)
    Скарга власника: пристрій перезавантажується під час натискання
    «заряд» або в процесі заряду. Найімовірніша причина — BROWNOUT:
    просадка живлення ESP32 в момент, коли вмикається силовий каскад
    TL494-плати (enable) чи зростає струм заряду, якщо ESP32 і плата
    діляться недостатньо відфільтрованим джерелом. Але це лише гіпотеза
    без діагност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
    [motorola-battery-reader-web.ino]
2026-08-09 Заряд DC/DC: керування через апаратний ЦАП замість ШІМ+RC-фільтра (#93)
    За проханням власника — інший підхід до CHARGE_CTRL_PIN: замість ШІМ
    (LEDC) через зовнішній RC-фільтр на платі (резистор+конденсатор),
    тепер напряму dacWrite() на справжній апаратний ЦАП ESP32. GPIO26 —
    один із рівно двох GPIO зі справжнім ЦАП на ESP32 (другий, 25, вже
    займає буззер), тож жодних зовнішніх компонентів на платі більше не
    потрібно: d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
2026-08-09 Додати DACTEST — діагностика ЦАП заряду в обхід калібрувальної логіки (#94)
    Власник повідомив: на CHARGE_CTRL_PIN завжди 3.3 В незалежно від
    заданого коду ЦАП, навіть в ізоляції (провід до TL494 відключено,
    жодного зовнішнього навантаження). Формула й калібрувальна таблиця
    в charge.h перевірені построково — код математично коректний
    (dacWrite(26, 135) на холостому ході має давати ~1.75 В). Щоб
    відрізнити «баг у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
2026-08-09 Заряд DC/DC: повернення на ШІМ+RC — 8-бітний ЦАП недостатньо точний (#95)
    * Revert "Додати DACTEST — діагностика ЦАП заряду в обхід калібрувальної логіки (#94)"
    This reverts commit 1e871f39e93e57f5cce0c55cdc3e99d83af781b2.
    * Revert "Заряд DC/DC: керування через апаратний ЦАП замість ШІМ+RC-фільтра (#93)"
    This reverts commit ebdf61d86588e7ac9cdd5b2ea8ef04a25a0bb7a2.
    ---------
    [charge.h, moto_gui.py, serial_api.h, settings.h, web_server.h]
2026-08-10 Кнопки: діагностичний друк напруги ADC-драбинки на зміну класифікації (#96)
    Скарга власника: «кнопки вліво і вправо працюють лише вліво» — при
    трьох кнопках на одному ADC-піні (MENU_BTN_ADC_PIN) це майже завжди
    означає, що РЕАЛЬНИЙ номінал резистора кнопки «вправо» на платі не
    збігається із закодованим MENU_BTN_ADC_RIGHT_OHM (типово 20 кОм) у
    settings.h, тож її фактична напруга потрапляє в діапазон, який
    проши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
2026-08-10 Кнопки: калібрування ADC-драбинки під реальні резистори на платі (#97)
    BTN_ADC-лог із попереднього PR показав фактичні номінали: «вліво»
    ~1140 мВ (~5.3к), «вправо» після заміни резистора ~1680 мВ (~10.4к) —
    не заводські 5к/20к. Із заводськими порогами «вправо» (1680 мВ) мало
    лише ~30 мВ запасу до межі з «вліво» (поріг 1650 мВ) — на межі шуму
    ADC, могло промахуватись.
    MENU_BTN_ADC_LEFT_OHM/RIGHT_OHM тепер підставлені під ЦІ ви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
2026-08-10 Стабільність: прибрати надмірний Serial-трафік у гарячому шляху опитування (#98)
    Скарга власника: зависання й самовільні перезавантаження. Знайдено
    ймовірну причину: dischargeSample() (викликається ЩОСЕКУНДИ під час
    заряду/розряду, годинами) веде до readDS2438() -> findDevices() —
    findDevices() робить ПОВНИЙ пошук 1-Wire шини і друкує "DS2433/DS2438
    found!" НАВІТЬ КОЛИ адреси вже кешовані й не змінились; readDS2438()
    додатково др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
2026-08-12 DS2433: подвійне звірене читання сторінки замість довіри presence-pulse (#99)
    Скарга власника: нестабільне читання DS2433 — «якщо виходить прочитати
    з кількох спроб, показує сміття», і помилка при стиранні (WIPE33).
    Причина: readBattery() читає DS2433 постранично (Read Memory 0xF0),
    а ця команда, на відміну від запису (Read Scratchpad + CRC8), НЕ
    повертає CRC. Попередня перевірка спиралась лише на presence-pulse
    після Reset() — але шина мо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
    [battery_reader.cpp]
2026-08-12 WiFi.setSleep(false) + хостові тести на подвійне звірене читання (#100)
    Продовження скарги на нестабільне читання DS2433. WiFi modem-sleep
    на ESP32 циклічно вимикає/вмикає радіо — задокументована причина
    джиттеру в delayMicroseconds() під час активного WiFi-трафіку, що
    корумпує бітбенг-timing 1-Wire (arduino-esp32#755 та інші community
    звіти). WiFi.setSleep(false) тримає радіо постійно активним без цих
    циклів. Пристрій не живиться від батарейк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
2026-08-13 Виправлено 7 дефектів + робоча копія battery_reader_china_chr
    Опис проєкту описує задум, а не поведінку коду. Знайдені й виправлені
    розбіжності (перевірені хостовими тестами й корпусом dumps/):
    1. Заряд НІКОЛИ не оновлював екран: chargeMarkDirty() виставлявся, сторінка
    drawPageCharge() була намальована, але chargeConsumeDirty() не викликався
    ніде — у loop() стояв лише рядок для розряду.
    2. Зупинка однієї операції ламала і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
2026-08-13 Заряд: ШІМ на P-MOSFET через NPN + власні вимір струму/напруги
    Повна заміна схеми заряду: замість готової плати DC/DC на TL494 (цифровий
    enable + аналогове керування через ШІМ+RC із калібрувальною таблицею) —
    один ШІМ-пін на базу NPN, який притягує затвор P-канального MOSFET.
    Логіка не інвертована: два інвертування скасовуються, тож шпаруватість на
    піні = шпаруватість струму, 0 % = безпечно.
    Піни: CHARGE_PWM_PIN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
2026-08-13 Заряд: понижувач (buck) — дросель і діод змінюють фізику
    Уточнення схеми: після P-MOSFET стоїть діод на землю й дросель на вихід,
    тобто це класичний понижувач, а не простий ключ. Дросель змінює фізику
    настільки, що частину рішень попереднього коміту довелося переглянути.
    1. Uвих ≈ D × Uживл, тож струм з'являється лише вище D = Uпакета/Uживл
    (≈0.6 при 8.4 В від 14 В). Старт «із нуля крок за кроком» о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
2026-08-13 Заряд: L=104 мкГн + виправлено помилку про «точку нульового струму»
    Підставивши уточнену індуктивність, перевірив висновок попереднього коміту
    й знайшов у ньому помилку.
    БУЛО НАПИСАНО: D = Uпакета/Uживл — це «точка нульового струму», тож із неї
    безпечно стартувати. НАСПРАВДІ це МЕЖА РЕЖИМІВ: наростання струму у
    відкритій фазі там рівно дорівнює спаду в закритій, тобто середній струм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
2026-08-13 Заряд: ключ — біполярний PNP B772M, а не MOSFET
    Уточнення схеми. Це не заміна деталі в тій самій ролі, а інший принцип
    керування, і він переписує обмеження всієї схеми.
    1. КЕРУЄТЬСЯ СТРУМОМ БАЗИ. Резистор між колектором NPN і базою PNP більше
    не «налаштовує швидкодію», а задає струм бази. Насичення мусить
    триматись на ВЕРШИНІ пульсацій (1651 мА), тобто Iб >= 83 мА, звідси
    R_бази 150 Ом. Резистор роз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
2026-08-13 Документація: приведено у відповідність до поточної схеми й коду
    Текстова документація описувала стан, якого вже немає — після трьох
    уточнень схеми заряду вона місцями суперечила сама собі.
    ЗМІНИ.md переписано повністю. Було: три послідовні розділи про три різні
    версії заліза, з яких перші два лишились із застарілими схемами (P-MOSFET,
    R_pullup, CHARGE_GATE_*) — читач бачив три несумісні описи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
2026-08-14 Резистор 1 кОм перед вимірювальними пінами — у таблицях пінів і в коді
    Резистор був у трьох схемах (settings.h, README, ЗМІНИ.md), але його не
    було в ЖОДНІЙ із чотирьох зведених таблиць пінів. По таблиці людина
    підключила б шунт напряму на GPIO35, без струмообмеження входу АЦП.
    Додано в усі чотири таблиці (README ×2, INSTRUCTION, ЗМІНИ) плюс окрема
    примітка, ЧОМУ він не входить у перерахунок: вхід АЦП висок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
2026-08-14 Подільник напруги: реальні 20к/10к; хибну пораду про 2.7к скасовано
    Уточнення схеми: з плюсової клеми стоїть 20к, далі 10к на землю, і вже з
    вузла через 1к на пін. Тобто коефіцієнт 1:3, а не 1:2, як я припускав.
    ⚠️ ПОРАДА, ЯКУ Я ДАВ РАНІШЕ, БУЛА ХИБНОЮ. Я казав «подільник 10к/10к
    небезпечний, поставте знизу 2.7к» — виходячи з того, що зверху 10к. З
    реальними 20к зверху міняти нічого не треба: пакет 8.25 В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
2026-08-14 Драйверний каскад (керуючий NPN) — явні параметри й перевірка
    Пін ESP32 не керує силовим PNP напряму: між ними окремий керуючий NPN.
    У схемах це було намальовано, але сам каскад ніде не описано як ланку зі
    СВОЇМИ вимогами — а він теж біполярний, і відмова тут КАСКАДНА.
    ⚠️ РОЗРАХУНОК ПОКАЗАВ РЕАЛЬНУ ПРОБЛЕМУ. Резистор від піна до бази NPN я
    свого часу поставив «~1к» як власне припущення, і йо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
2026-08-14 Обв'язка бази PNP: враховано запираючу підтяжку; 1 кОм у базі — непридатний
    Уточнення номіналів: колектор NPN -> база PNP через 1 кОм, і база PNP
    підтягнута ще одним 1 кОм до плюса (закритий стан у спокої).
    ⚠️ ГОЛОВНЕ: 1 кОм У БАЗІ РОБИТЬ ЗАРЯД НЕПРАЦЕЗДАТНИМ, і це не питання
    запасу. Розрахунок:
    через резистор (14 − 0.9 − 0.2)/1000 = 12.9 мА
    відбирає підтяжка 0.9/1000 = 0.9 мА
    лишається базі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
2026-08-14 Контроль живлення +14 В і перерахунок обв'язки бази на межі допуску
    Резистор із піна на базу керуючого NPN — 20 кОм (за словами власника), а не
    470 Ом, які я до цього порахував і записав у документацію як факт. 20 кОм
    дають 0.13 мА в базу при потрібних 6.7: керуючий каскад не пропускає навіть
    тих 12.9 мА, що тече через нинішній 1 кОм у базі PNP. Обидва номінали плати
    тепер записані окремими константам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
2026-08-14 Верхній поріг живлення 16 В підтверджено власником
    Значення й так стояло 16000 — правки лише в описі, щоб «ЩО ВАРТО УТОЧНИТИ»
    лишалось чесним переліком: поріг більше не моя оцінка.
    Заразом записано, чому цей поріг не суто діагностичний: він задає
    CHARGE_NPN_BASE_OHM, бо струм драйвера росте разом із живленням (при 16 В —
    124 мА, звідси 390 Ом; при 15 В вистачило б і 470). Тобто обидві заміни
    резисторів н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
2026-08-14 CS дисплея став необов'язковим; конфігурацію перемкнуто на GMT130 240x240
    На модулях ST7789 240x240 (GMT130 і подібні 1.3"/1.54") виводу CS немає
    взагалі: на гребінку виходять лише GND/VCC/SCL/SDA/RES/DC/BLK, а CS припаяний
    до землі — контролер вибраний завжди. Проєкт же вважав DISPLAY_CS_PIN
    обов'язковим і смикав GPIO5 без потреби.
    Тепер константа необов'язкова: без неї в Adafruit_SPITFT іде -1, в U8g2 —
    U8X8_PIN_NONE. Обидва значення документ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
2026-08-14 Діагностика «чорний екран»: самоперевірка панелі й повний звіт про конфігурацію
    Скарга «зображення не з'явилось» не діагностується взагалі: згасла підсвітка
    й мовчазна шина SPI виглядають однаково. Тому два інструменти.
    DISPLAY_ST7789_SELFTEST (типово вимкнено) — після ініціалізації заливає екран
    чистими кольорами при повній підсвітці й дублює кроки в Serial. Відповідь
    читається очима: кольо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
2026-08-14 DISPLAY_CS_PIN 5 повернуто як типове значення
    За рішенням власника. Виводу CS на модулі 240x240 (GMT130) фізично немає —
    GPIO5 нікуди не підключений, — і саме тому смикати його безкоштовно: нічого
    до нього не припаяно. Протилежний варіант коштує дорожче: -1 покладається на
    внутрішню гілку Adafruit_SPITFT для випадку «CS немає», а вона у різних
    версіях реалізована по-різному (де через csPinMask=0, де через
    digitalWrite(-1)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
2026-08-14 Режим і частота SPI для ST7789 стали налаштовуваними; для GMT130-V1.0 — режим 3
    Причина чорного екрана шукалась не там. Перевіряли проводку й CS, а
    tft.init() увесь час кликався БЕЗ двох параметрів, які на панелях без CS і
    вирішують справу: режиму SPI і частоти. Бібліотека мовчки підставляла свої —
    режим 0 і десятки МГц.
    Режим. У GMT130-V1.0 виводу CS немає, він припаяний до землі: контролер
    вибраний ЗАВЖДИ і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
2026-08-14 Аварія живлення: сторінка помилки з блиманням на екрані й смуги в усіх клієнтах
    Раніше несправне живлення показувалось лише значком «!» у шапці й рядком на
    сторінці заряду — тобто побачити його можна було, тільки здогадавшись туди
    зайти. Тепер помилка сама виходить на перший план, і скрізь блимає.
    Екран пристрою (обидва, кольоровий і монохромний): окрема сторінка з червоним
    тлом,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
2026-08-14 Чорний екран вирішено: режим SPI 3 підтверджено на пристрої
    Гіпотеза виявилась правильною — власник перевірив на залізі. Причиною був
    саме режим SPI, а не проводка, не номінал CS і не пресет панелі.
    Документацію приведено у відповідність: усюди, де стояло «часто вимагають» і
    «спробуйте», тепер стоїть підтверджений факт. Проєкт послідовно розрізняє
    «моя оцінка» і «перевірено на заліз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
2026-08-14 Блимає ПЛАШКА з текстом, а не сам текст; помилка називає причину
    Помилка в моїй же реалізації, і варта того, щоб бути названою: блимав САМ
    НАПИС, тобто півперіоду на екрані висіла порожня червона смуга. Рівно тоді,
    коли користувач дивиться на екран, він міг побачити «щось червоне» без жодного
    слова про причину. Аварійне повідомлення, яке пів часу нічого не повідомляє,
    гірше за статич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
2026-08-14 У повідомленні про помилку живлення головним числом став НОМІНАЛ блока
    Було «потрібно 12.5…16.0 В» — це відповідь на питання «чому цей блок
    відхилено», а не на «який тоді під'єднати». Користувачеві потрібне друге.
    Стало «виміряно 19.20 В — треба 14 В (допуск 12.5…16.0)»: номінал попереду й
    тим самим шрифтом, межі — у дужках як пояснення.
    Номінал береться з CHARGE_SUPPLY_MV, а не зашитий у текст: помі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
2026-08-14 Перевірка лінії enable/підтяжки (GPIO12): несправність тепер названа
    Аудит коду GPIO12 дефекту не знайшов: begin() ставить пін у вихід,
    findDevices() піднімає його перед пошуком і витримує DS_BUS_SETTLE_MS,
    pullupOff() опускає лише за відсутності holdEnable, конфліктів пінів немає.
    Але перевірити САМУ ЛІНІЮ прошивка не вміла взагалі — піднімала пін і йшла
    далі, а чи піднялась при цьому лінія, не знала.
    Тепер уміє: enableLin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
2026-08-14 Регресія 1-Wire після переробки заряду: повернуто GPIO32 і додано перевірку лінії даних
    Власник: «з D12/D13 до переробок заряду все працювало». Отже це регресія, і
    шукати треба в тому, що переробка змінила ВЗАГАЛІ, а не лише у файлах 1-Wire.
    Сам код 1-Wire не змінювався — diff battery_reader.cpp/h проти дореформеної
    версії в корені порожній, окрім доданої вчора діагностики. Порядок setup()
    теж той самий. Але пере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
2026-08-14 Внутрішня підтяжка 1-Wire вмикається явно: без неї лінія висить у повітрі
    Власник: «лінії без підтяжок, використовують функціонал самого контролера»,
    і це стосується обох — D12 і D13. Зовнішніх резисторів на платі немає взагалі.
    Тоді підтяжку мусить давати ESP32 — а її не вмикав НІХТО. Пастка в тому, що
    внутрішня підтяжка це окреме налаштування піна, і його знімає будь-який
    pinMode(pin, INPUT): у ardu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
2026-08-17 Зовнішня підтяжка 1-Wire обов'язкова; перевірку лінії було перевернуто
    Звірка з ОРИГІНАЛОМ (коміт до всіх переробок, c98275d) щодо скарги «акумулятор
    не зчитується»:
    • battery_reader.cpp — читання й запис БАЙТ У БАЙТ ті самі, відрізняються
    лише мої діагностичні додатки;
    • readAllChips() — та сама послідовність, змінено лише текст помилки;
    • піни й константи 1-Wire (DS_PIN, PULLUP_PIN, DS_BUS_SETTLE_MS,
    DS_SEARCH_TRIES) —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
2026-08-17 Принципова схема пристрою — у репозиторії (СХЕМА.html)
    П'ять листів: загальна структура, каскад заряду (понижувач на PNP B772M),
    вимірювальні кола, 1-Wire з enable пакета, розряд. Плюс карта всіх пінів,
    робочі величини й перелік доопрацювань плати.
    Файл АВТОНОМНИЙ — відкривається просто з диска, без сервера. Через це в ньому
    свій doctype і, головне, <meta charset="utf-8">: без нього кирилиця при
    відкритті лока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
2026-08-17 Заряд не вмикався: канал LEDC ділив ТАЙМЕР із розрядом
    Головний дефект, і він мій. CHARGE_LEDC_CH стояв 7 — «щоб не перетинатися з
    розрядом на 6». Але канали LEDC діляться ТАЙМЕРАМИ ПОПАРНО (0-1 -> таймер 0,
    2-3 -> 1, 4-5 -> 2, 6-7 -> 3), тобто 7 це пара до 6, той самий таймер. А таймер
    має одну частоту й одну розрядність на двох:
    розряд — 1 кГц / 10 біт,
    заряд — 25 кГц / 11 біт.
    dischargeInit() іде першим і займає таймер 3; chargeIni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
2026-08-17 Резистор 4.7 кОм між enable (GPIO12) і +3.3 В — обов'язковий (#123)
    За словами власника: без нього некоректно працюють УСІ ЧОТИРИ функції —
    читання, запис, заряд і розряд. Причина зрозуміла: цією лінією активується сам
    пакет, і рівень на ній має бути визначеним навіть тоді, коли пін не веде її
    активно. Прошивка лише притискає лінію вниз, коли пакет має бути неактивним.
    Це прямо СКАСОВУЄ те, що я за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
2026-08-17 Перезавантаження під час заряду/розряду і хибна «перенапруга 9.9 В» (#124)
    Дві скарги з випробувань на залізі. Обидві виявились дефектами прошивки:
    у першому випадку вона сама створювала аварію, у другому — сама ставила
    неправильний діагноз.
    1. ПЕРЕЗАВАНТАЖУВАВ САМ СТОРОЖ.
    У налаштуванні Task WDT стояло idle_core_mask = (1 << portNUM_PROCESSORS) - 1,
    тобто «стежити за бездіяльними задачами ОБОХ ядер». Скетч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
2026-08-17 Вибір типу силового ключа (P-MOSFET / PNP) + дозаряд малим струмом від 90 % (#125)
    1. ЗАМІНА КЛЮЧА НА P-КАНАЛЬНИЙ MOSFET NTD2955G.
    Власник поставив замість B772M польовий ключ. Обв'язка спільна, а фізика
    різна, тож з'явився вибір типу — CHARGE_SWITCH_TYPE — і за ним розгалужується
    майже кожна перевірка силової частини.
    Головне: ті самі резистори означають тепер інше. У біполярника R_drive задавав
    СТРУМ бази. У польов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
2026-08-17 Заставка через SPIFFS (JPEG і RGB565); enable перед стартом заряду (#126)
    * Кольорова заставка через SPIFFS; enable перед стартом заряду
    1. ЗАСТАВКА ЗАВАНТАЖУЄТЬСЯ, А НЕ ВКОМПІЛЬОВУЄТЬСЯ (лише кольорові ST7789).
    Раніше кастомна заставка означала повний цикл: make_color_splash.py -> C-масив
    у custom_splash.h -> Arduino IDE -> компіляція -> прошивання. Тепер картинка
    просто вантажиться у SPIFFS через веб («Заставка екрана»), прошивка та с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
2026-08-17 Bluetooth-підключення клієнтів; автозменшення завеликої заставки (#127)
    1. BLUETOOTH: ТІ САМІ КЛІЄНТСЬКІ ПРОГРАМИ БЕЗ КАБЕЛЮ.
    Командний протокол (serial_api.h) віддається ще й по Bluetooth SPP.
    Вибір SPP, а не BLE, вирішує тут майже все: на комп'ютері SPP виглядає
    ЗВИЧАЙНИМ COM-портом, тож moto_gui.py (pyserial), moto_bridge.py і
    client_usb.html (Web Serial) працюють БЕЗ ЖОДНИХ ЗМІН — треба лише обрати
    інший порт зі списку. BLE довелося б обгорт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
2026-08-17 Збірка з Bluetooth на ядрі 3.x: setPin() змінив сигнатуру (#128)
    Перша збірка на залізі впала:
    error: no matching function for call to 'BluetoothSerial::setPin(const char [5])'
    note: candidate: 'bool BluetoothSerial::setPin(const char*, uint8_t)'
    У arduino-esp32 2.x метод був setPin(const char *pin), у 3.x став
    setPin(const char *pin, uint8_t pin_code_len).
    • Гілка за ESP_ARDUINO_VERSION_MAJOR — тим самим способом, що вже
    застосований у wdt.h.
    • Захисний #error, якщо макрос невідомий: інакше препроцесор мовчки п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
    [bt_link.h, session_guard_check.cpp, web_server.h]
2026-08-17 Bluetooth вимкнено: із ним пристрій не під'єднувався по Wi-Fi (#129)
    Скарга з випробувань: з увімкненим Bluetooth пристрій перестав під'єднуватись
    по Wi-Fi.
    Причина майже напевно в пам'яті: стек Bluedroid забирає десятки кілобайтів
    купи, а точці доступу разом із веб-сервером, SPIFFS і буферами дисплея й так
    лишалось небагато. Друга складова — спільне радіо: Wi-Fi і класичний BT
    діляться ефіром, і навіть коли о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
2026-08-17 Анімація шкали батареї не скидається на кожному опитуванні (#130)
    Скарга: під час заряду/розряду анімована шкала раз на секунду смикається —
    видно спалах рівного кольору замість плавного градієнта.
    ПРИЧИНА БУЛА НЕ В АНІМАЦІЇ, А В ТОМУ, ЩО ЇЇ ЩОРАЗУ СТИРАЛИ. Сторінка заряду на
    кожному опитуванні затирала смугу у фон і клала РІВНУ заливку, а
    displayAnimTick() (~9 к/с) знову клав градієнт поверх.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
2026-08-17 Перезавантаження під час заряду: чорний ящик і фрагментація купи (#131)
    Скарга повернулась після виправлення сторожа. Головна проблема була не в самій
    причині, а в тому, що ПІСЛЯ СКИДАННЯ ВІД ПОДІЇ НЕ ЛИШАЛОСЬ НІЧОГО — кожна
    спроба її закрити була здогадкою.
    1. ЧОРНИЙ ЯЩИК (postmortem.h).
    Раз на опитування пристрій пише кілька чисел у RTC-пам'ять, яка переживає
    скидання (RTC_NOINIT_ATTR). Після перез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
2026-08-17 Паніка на читанні DS2438: позначка етапу в чорному ящику (#132)
    * Позначка етапу в чорному ящику: паніка на читанні DS2438
    Журнал із пристрою прийшов і одразу спростував версію про фрагментацію:
    RESET REASON: ПАНІКА/виключення — крах прошивки (код 4)
    ПЕРЕД СКИДАННЯМ: ЗАРЯД, 127 с, опитування 10, duty 1387, 490 мА, 8043 мВ
    ПЕРЕД СКИДАННЯМ: купа 184192 Б (найбільший блок 110580 Б), стек 4304 Б
    Купа 184 КБ вільно, найб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
    [motorola-battery-reader-web.ino, postmortem.h, session_guard_check.cpp, web_server.h]
2026-08-17 ПРИЧИНА ПАНІКИ: відчеплення каналу LEDC посеред апаратного згасання (#133)
    Другий журнал містив блок паніки, і разом із попереднім він дає відповідь.
    Guru Meditation Error: Core 1 panic'ed (LoadProhibited)
    PC : 0x4008d029 EXCVADDR: 0x00000141 EXCCAUSE: 0x1c
    Backtrace: 0x4008d026:0x3ffc0b2c |<-CORRUPTED
    ТРИ ФАКТИ РАЗОМ:
    1. PC у IRAM, backtrace «CORRUPTED», EXCVADDR біля нуля — підпис падіння в
    ОБРОБНИКУ ПЕРЕРИВАННЯ, а не у звичайному коді.
    2. Відсоток у журнал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
    [charge.h, charge_logic_check.cpp, leds.h, session_guard_check.cpp, settings.h, wdt.h, web_server.h]
2026-08-17 Пакет закривається сам на 8.2 В — це кінець заряду, а не аварія (#134)
    Спостереження власника: дійшовши до 8.2 В, пакет розмикає власний захист,
    клема лишається без навантаження, подільник іде в стелю (ті самі «9.90 В»),
    і прошивка оголошує перенапругу.
    Три помилки в одному сценарії.
    1. Насичений відлік потрапляв на порівняння з напругою. Відсічка «пакета
    немає» стоїть першою, але вона з в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
2026-08-18 Індикатор поверх банера і скидання лічильників, що робило пакет «невідомим» (#135)
    Дві скарги власника, дві незалежні причини.
    1. «При помилці живлення поверх попередження малюється індикатор заряду».
    Сторінка помилки виводиться повз перемикач сторінок, а g_displayPage при
    цьому лишається нулем — «головна». Анімація шкали дивилась саме на нього і
    ~9 разів на секунду клала градієнт п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
2026-08-18 Ручне регулювання струму заряду; прокрутка й залиплий зразок у клієнті .exe (#136)
    РУЧНИЙ СТРУМ ЗАРЯДУ (побажання власника). 0 — автомат, як було; будь-яке інше
    значення — уставка користувача. Доступно з веб-інтерфейсу (/api/charge/ma),
    USB-клієнта і програми .exe (CHARGE MA=<мА>); межі клієнти беруть з відповіді
    пристрою, а не з власних констант.
    Три рішення, які тут важать:
    • дозаряд ручний режим НЕ ска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
2026-08-18 Відсоток заряду для 2S: таблична крива замість прямої (#137)
    Прохання власника — перерахувати показання заряду для 2S-пакета, не
    оглядаючись на початкові граничні значення, і взяти межі з заводських
    параметрів 2S li-ion.
    Було: пряма між 6350 і 8250 мВ. Для літію це неправильно принципово — крива
    напруги спокою це полога сходинка з довгим плато посередині:
    напруга В/банку було стало
    6.80 В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
2026-08-18 Синхронізація дзеркала DS2438 → DS2433 з правкою; липка шапка вкладок (#138)
    СИНХРОНІЗАЦІЯ. Рівно 26 байтів дублюються в двох чипах: DS2433[0x01-0x1A] і
    DS2438[0x18-0x31] — це ідентичність пакета. Синхронізація в проєкті була, але
    СЛІПА: копіювала всі 26 байтів і виправляла суму. Правильно це рівно тоді,
    коли монітор точно свій; а він буває чужий, і тоді сліпе копіювання не лікує,
    а закріплює чужу ідентичніст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
2026-08-18 «Sketch too big»: схема розділів — умова збірки, а не порада (#139)
    Повідомлення власника:
    Sketch uses 1313447 bytes (100%) of program storage space.
    Maximum is 1310720 bytes. Sketch too big.
    1310720 — це не розмір флеша, а розділ під програму у схемі «Default 4MB with
    spiffs». Перевищення мізерне: 2727 байтів, 0.21 %. Той самий скетч у схемі
    «Huge APP (3MB No OTA/1MB SPIFFS)» займає 41.8 % від 3 МБ.
    Помилку зробила НЕ установка користувача, а наша інструкція: у таблиці сх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
    [motorola-battery-reader-web.ino, session_guard_check.cpp, settings.h]
2026-08-18 Синхронізація: чи монітор від цього пакета, дата в плані, вибір байтів (#140)
    Прохання власника — поставити попередження «наробіток ETM більший за вік
    пакета» саме в пункт синхронізації. Місце обрано правильно: операція
    переносить ідентичність З МОНІТОРА в пам'ять пакета, тож із чужим монітором
    вона не лікує, а приписує пакету чужу особу — і робить це «за планом», з
    галочками, тобто вп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
2026-08-18 Синхронізація ЗНАЧЕНЬ між чипами; лічильники в DS2438 нарешті доїжджають (#141)
    Власник: «дані розходяться, потрібна можливість синхронізувати і ці
    розбіжності — саме через них синхронізація й задумувалась»; далі: «скинув
    наробіток, поставив у зарядку, і вона знову прописала дату й лічильники. Може,
    ми не туди пишемо і не звідти читаємо?»
    Розбір двох його дампів того самого пакета (до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
2026-08-19 Папка скетча стала ASCII-чистою: «invalid UTF-8» в Arduino IDE (#142)
    Скарга власника: збірка пройшла («Sketch uses 1277479 bytes (40%)», тобто
    схема розділів тепер правильна), а IDE одразу після цього показала
    grpc: error while marshaling: string field contains invalid UTF-8
    Compilation error: grpc: error while marshaling: string field contains invalid UTF-8
    Це не помилка коду: звіт про розмір друкується лише після УСПІШНОЇ збірки, а
    впало вже наступне — Arduino IDE 2.x отримує резу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
    [session_guard_check.cpp, settings.h]
2026-08-19 Наробіток більше не повертається зі старих міток; цикли пакета в плані (#143)
    Дві скарги власника: «виставляю дату, ставлю в зарядку — і вона прописує
    наробіток 17 років» та «немає синхронізації з кількістю по циклах зарядки
    IMPRES і не-IMPRES».
    ПРИЧИНА ЗНАЙДЕНА, і доказ лежав у нашому ж корпусі. Сторінка 2 монітора
    (DS2438[0x10..0x17]) — це два 32-бітні числа в одиницях наробітку, «коли
    востаннє щось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
2026-08-19 Веб-інтерфейс: сторінка стиснута й віддається шматками зі сторожем (#144)
    Скарга власника: «зависання при підключенні до точки доступу зі спробою
    відкрити внутрішній веб-інтерфейс».
    Виміряно: index.html виріс до 266 105 байтів і віддавався одним викликом
    server.streamFile(). Це блокуючий виклик — поки сторінка йде по радіо,
    головний цикл стоїть цілком: екран не оновлюється, кнопки не опитуються,
    за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
2026-08-19 Білий екран замість сторінки: моя помилка в ручній віддачі файла (#145)
    Скарга власника: «тепер замість веб-інтерфейсу білий екран». Так, пристрій
    уміє віддавати gz — проблема була не в форматі, а в тому, ЯК я його віддавав.
    У попередній правці я замінив штатний server.streamFile() власним циклом,
    який шле файл шматками й між ними годує сторожа. Виглядало акуратно, зібралось
    і пройшло всі переві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
2026-08-19 Сторінку вшито в прошивку: SPIFFS для неї більше не потрібен (#146)
    Скарга власника: білий екран лишився, а новий /api/fs відповів вичерпно:
    {"total":836081,"used":0,"files":[]}
    Файлової системи з даними в пристрої не було ЗОВСІМ. Тека data/ туди ніколи
    не доїжджала, і зрозуміло чому: заливають її окремим кроком Tools -> ESP32
    Sketch Data Upload, а в Arduino IDE 2.x такого пункту немає (власник саме на
    ній — це видно зі скарги про g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
2026-08-19 Легка сторінка /lite і відбиток збірки: «білий екран» тепер сам себе пояснює (#147)
    Питання власника: «якщо SPIFFS більше не потрібен, то куди й як закидати
    index?» — НІКУДИ. Сторінка компілюється всередину прошивки: mk_page_header.py
    робить із index.html файл page_index.h, і той збирається разом зі скетчем.
    Прошили — сторінка вже в пристрої.
    Але кілька кіл листування пішло на те, що з боку користувача «білий ек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
2026-08-19 Вшита сторінка йде шматками, як файл: одиночний send_P її обрізав (#148)
    Спостереження власника, яке все вирішило: /lite (1.7 КБ) відкривається, а
    основна (90 КБ) — ні. Прошивка та, сервер живий, малі відповіді ходять — не
    доходить саме велика.
    ПРИЧИНА. У ядрі ESP32 великий буфер і файл ідуть різними шляхами:
    NetworkClient::write(buf, size) один цикл select/send на всю передачу;
    запас повторів (WI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
2026-08-19 Дослід замість здогадів: /bigtest і самоперевірка доставки на /lite (#149)
    Питання власника: «чому не можна використовувати поточний Huge APP 1 МБ для
    веба?» — МОЖНА, і саме так воно тепер і працює. Сторінка живе в прошивці
    (розділ програми 3 МБ), від файлової системи не залежить узагалі. Зв'язок був
    лише історичний: доки сторінка лежала у SPIFFS, зміна схеми зробила старий
    образ немонтовним і він від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
2026-08-19 Примусове пробудження пакета, що не читається після заміни елементів (#150)
    Замкнене коло: щоб зарядити — треба прочитати (без DS2438 немає температури,
    а заряд наосліп заборонено), щоб прочитати — треба подати напругу. Контролер
    захисту всередині пакета після заміни банок лишається заблокованим і не
    відпускає клеми, доки не побачить зовнішню зарядну напругу; поки він мовчить,
    мовчат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
2026-08-20 Увімкнено звук на ЦАП (GPIO25) і полагоджено вартового піна звуку (#151)
    Власник спитав, чи є вільний ЦАП-пін під звук. Є рівно один: ЦАП на ESP32
    живе на GPIO25 і GPIO26, і 26-й давно зайнятий ШІМ заряду.
    Документація стверджувала протилежне. Поруч із закоментованим
    BUZZER_DAC_PIN у settings.h, README та INSTRUCTION стояло «пін віддано
    керованому заряду» — неправда: заряд на GPIO26, а 25-й лежав у резерві
    (що чесно написано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
    [moto_gui.py, session_guard_check.cpp, settings.h, web_server.h]
2026-08-20 Поправка тракту вимірювання живлення: 14.3 В більше не читаються як 12.4 (#152)
    Скарга власника: блок живлення 14.3 В показувався як 12.4 В і виводив
    «напруга занижена — блок не той», через що заряд не стартував.
    Ланцюг від ноги до числа лінійний, тож його можна обернути точно:
    прошивка «бачила» у вузлі подільника 1.590 В там, де мало бути 1.833.
    Замір мультиметром на живій платі зняв дві версії одр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
2026-08-20 Меню пристрою: список із групами замість плоского кільця дій (#153)
    Скарга власника: меню розкладене нелогічно, перемикання функцій незручне,
    хочеться список.
    Було: усі вісім сторінок в одному кільці, а сторінка «Дії» — ще одне
    кільце всередині нього, на 32 пункти й лише вперед. До останнього — 31
    натискання, назад ніяк. Поруч, в одному кільці, щоденний «Заряд ШІМ» і
    незворотнє «СТЕРТИ 2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
2026-08-21 Ручні уставки, розумний профіль CC/CV для 2S і залишок часу (#154)
    Ручний вибір струму заряду, цілі у вольтах і струму розряду — окремим шаром
    над автоматом. Нуль скрізь означає «віддати рішення автомату», а не
    затиснутий мінімум. У фазі дозаряду/спаду береться МЕНШЕ з двох (ручного й
    автоматичного): підняти струм там, де профіль його прибирає, не можна.
    Розумний профіль рахує струми від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
2026-08-21 Єдиний вигляд заряду, розряду й пробудження в усіх трьох клієнтах (#155)
    Три операції того самого пристрою читались як три різні програми. У заряду не
    було ні кривої напруги за сеанс, ні коридору уставки струму; на USB-сторінці
    «фаза» й «лишилось ≈» не мали плиток узагалі, хоча пристрій обидва числа
    віддавав; у пробудженні сусідні плитки ХОВАЛИСЬ, тож сітка перебудовувалась і
    те саме ч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
2026-08-21 Заблокований пакет, який читається: вихід із глухого кута між двома відмовами (#156)
    Скарга власника: заблокована батарея не заряджається («подільник напруги
    показує майже нуль»), а пробудження відмовляє, бо акумулятор зчитується.
    Причина: захист усередині пакета розмикає СИЛОВИЙ ключ, а DS2438 сидить до
    нього й говорить далі. Виходить стан, якого не передбачав жоден режим:
    монітор від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
2026-08-21 Дев'ять нових дампів у корпус — і п'ять місць, де брехала наша діагностика (#157)
    Власник надіслав дев'ять акумуляторів зі скаргами на рацію («в свойствах
    пишет восстановить», «неизвестный аккумулятор»), два з них знятими двічі — до
    і після зарядної станції. Партія лягла в dumps/20-vymahaie-vidnovlennya/.
    Скарги були на рацію, а знайшлися помилки в НАС.
    1. «Циклів не-IMPRES: 0» там, де їх 11 і 58. Лічильник ци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
2026-08-21 Майстер: автоматична правка лічильника розряду + ревізія правил і чистка (#158)
    Розділ 3.37 закінчився знахідкою «побитий лічильник розряду в моніторі»,
    яку Майстер називав, але лікувати не вмів. Тепер уміє — і заразом
    перевірено, чи всі функції роблять те, що обіцяють їхні назви.
    Автоправка (impresBmsFixDcaFromHist):
    * значення береться з блока NONSMART у DS2433 — там ті самі два лічильники
    в тих самих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
2026-08-21 Версія пристрою без заряду, комбінації кнопок і плавний колір шкали (#159)
    1. ВЕРСІЯ БЕЗ ЗАРЯДУ. Частину приладів зібрано без силової частини, і на
    непід'єднаному CHARGE_PSU_PIN АЦП ловить наводку — пристрій скаржився
    на несправний блок живлення, якого в ньому не передбачено. Тепер заряд
    вимикається на самому приладі: чотири швидкі короткі натискання кнопки
    зчитування. Ними ж і вмика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
2026-08-21 Скидання обнуляє й наробіток, записаний у самому пакеті (#160)
    Скарга власника з трьома дампами поспіль одного PMNN4409A — до скидання,
    після скидання, після зарядної станції. Скидання спрацювало: монітор і
    цикли обнулились. Пакет побував у зарядці — і в моніторі знову 4797/4659.
    ЗВІДКИ ЧИСЛА. Байт-у-байт із самого пакета: у блоці NONSMART у DS2433,
    поруч із лічильником не-IMPRES, за зсувами +3 і +5 лежить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
2026-08-21 Панель операції повертається в початковий стан; видиме оповіщення про недоступність (#161)
    Дві скарги власника, причина спільна: у клієнтів не було дороги «закрити
    підсумок». На пристрої його знімає будь-яка кнопка — так і задумано, щоб
    результат устиг прочитати живий чоловік. А у вебі, на USB-сторінці й у
    .exe такої дії не існувало взагалі, і панель назавжди лишалась у стані
    «завершено»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
2026-08-21 Темп комбінацій — 0.3 с на натискання (допуск 0.1 с) (#162)
    Власник задав темп: 0.3 с на натискання з допуском 0.1 с, тобто сусідні
    натискання ланцюжка не сміють розходитись більш ніж на 0.4 с (було 0.6).
    Число розкладено на дві сталі — бажаний темп і допуск: це два різні
    рішення. Пауза, що рве ланцюжок, їхня сума, і перевірки беруть її звідти:
    тест із власною копією темпу лишився б зеленим після йо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
2026-08-21 Заряд, розряд і пробудження — одне вікно з вибором режиму (#163)
    Три операції ніколи не йдуть разом: прошивка їх взаємно блокує, і кожен
    старт перевіряє стан іншої машини. Але в клієнтах вони жили трьома
    окремими картками поспіль, тож цей факт доводилось тримати в голові, а
    сторінку гортати, щоб знайти ту, що зараз працює.
    Тепер це одне вікно «Операція з пакетом», а режим обирається ви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
2026-08-21 Наробіток у самому пакеті видно в клієнтах; допуск комбінацій 0.4 с (#164)
    Скарга власника: «обнулив усе вручну, передернув у зарядку — цикли з
    датами повернулись». Числа, з яких станція їх відновлює, лежать у DS2433
    (блок NONSMART, зсуви +3 і +5) і доти не показувались НІДЕ: щоб
    перевірити, чи скидання до них дійшло, доводилось читати hex-дамп і
    рахувати зсуви руками.
    Тепер вони окремим рядком у кар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
2026-08-21 Лічильники повертав не зарядний пристрій, а еталон (#165)
    Власник описав кроки цілком: «Ремонт → Ремонт», усі значення в нуль,
    потім ЕТАЛОН і модель, дати поточні, лічильники в нуль — зберіг,
    передернув у зарядку, і все повернулось.
    Скидання тут ні до чого: воно відпрацювало, і в самого власника це видно
    в таблиці синхронізації — стовпчик «У пакеті» показував CCA 0 / DCA 0.
    Числа повернув н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
2026-08-21 Майстер сам узгоджує наробіток із датою пакета (#166)
    Повідомлення, з яким прийшов власник: «Напрацювання ETM (3859 діб) більше
    за вік пакета (1 діб)». Прошивка це бачила давно й пояснювала правильно,
    але нічого не пропонувала: ISS_ETM_FOREIGN свідомо стояв у переліку
    «кроку не буде» з причиною «що саме писати — вирішує людина». Власник
    попросив автоматизувати — і виявилось, що число тут виводит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
2026-08-21 Прилад називає дату своєї збірки в усіх трьох клієнтах (#167)
    Двічі за роботу правку шукали в приладі, куди її не залили, і робили
    висновок «не працює». Питання «а чи та прошивка взагалі в приладі?» —
    перше в будь-якому розборі, і відповісти на нього не міг жоден клієнт:
    дата збірки лежала в /api/fs, куди веб заглядає лише на вкладці
    діагностики, а USB-клієнти не ходять туди взагалі.
    Відбиток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
2026-08-21 Нуль діб — законний результат, а не «порахувати не вдалося» (#168)
    Скарга: у Майстрі крок «Узгодити наробіток із датою» відмовляється.
    Причина не в кроці, а в тому, що нуль діб у двох місцях читався як
    «не знаю».
    Під час ремонту дати ставлять поточні. Після цього вік пакета нуль діб
    і узгоджений наробіток нуль діб — обидва правильні, а в моніторі після
    станції тисячі. Це найгрубіше роз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
2026-08-24 Вимикач заряду — на утримання OK; драйвер екрана нарешті збирається (#169)
    Власник замінив жест: замість чотирьох швидких натискань — утримання
    «OK» п'ять секунд. Ланцюжок треба набрати в темпі й нічим при цьому не
    керуватись, а утримання — просто тримати й дивитись на екран.
    Головне тут не сам жест, а колізія. На «OK» уже висіло довге натискання
    = ВИКОНАТИ операцію (скидання, ремонт, оч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
2026-08-24 «Заряд недоступний» — вікном із «ОК», а не підказкою, що зникає сама (#170)
    Ця відмова пояснює, чому зникла ціла група меню, — а показувалась
    спливаючою підказкою, яка живе три секунди. Людина встигала прочитати
    «Помилка:» і лишалась із питанням «а що це було?».
    Пристрій позначає відмову КОДОМ (code=nocharge) в обох гейтах — веб і
    USB. Упізнавати її за рядком означало б, що перше ж переформулюв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
2026-08-24 Ручний редактор: усі значення пакета одним списком (#171)
    Кожне з цих значень уже мало свою кнопку, свій пароль і свою підказку —
    і жило в іншому місці: ємність в одній підвкладці, знос у другій, дата
    в третій, а цикли взагалі правились лише всередині планів
    синхронізації. Через це не було жодного місця, де видно ВЕСЬ стан
    пакета одразу, — а саме він і потрібен, коли розбираєш, чому паке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
2026-08-24 Помилку введення в редакторі виправляють, а не відхиляють (#172)
    У кожної тутешньої помилки є одна очевидна правильна відповідь, і
    відмова змушувала гадати, яка саме: вписали 6000 туди, де стеля 255, —
    малось на увазі 255; вписали дату наступного року — «сьогодні»;
    вписали 45-те число — останнє в місяці.
    Виправляється: число поза межами -> найближча межа; дата в майбутньому
    -> сьогодні; 13-й мі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
2026-08-25 Четверте місце, де пакет тримав наробіток: третя мітка, у добах (#173)
    Власник поставив рішучий дослід: при ЧИСТОМУ DS2433 обнулив наробіток
    монітора, поставив у зарядку — і дістав 4545. DS2433 чистий, ETM нуль,
    обидві 32-бітні мітки подій теж нулі (їх обнуляє impresSetEtm). Узятись
    числу не було звідки, отже ми чогось не знали.
    Знайшлось двобайтове поле за 0x32 DS2438 — та сама подія, що й мітка2,
    але записана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
2026-08-25 Знімок «до станції» і побайтова різниця: досить перебирати корпус (#174)
    Після 3.53 власник повторив дослід і дістав ІНШЕ число: 3844 замість
    4545. Це вже саме по собі корисно — якби число просто відновлювалось із
    одного місця, воно б повторилось. Але далі знову починався б той самий
    шлях.
    Чотири рази поспіль розбір «звідки повернулось число» йшов однаково:
    власник називає число — ми пере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
2026-08-25 Два пристрої — один код: топологія заряду стала опцією (#175)
    У сховищі жили дві прошивки: у корені — попередній пристрій на готовій платі
    DC/DC (TL494), у battery_reader_china_chr/ — новий, із власним понижувачем.
    Півсотні змін останніх місяців дісталися лише другому. Тепер відрізняється не
    код, а конфігурація: CHARGE_TOPOLOGY у settings.h.
    ЯК ЗВЕДЕНО ДВА СВІТИ ДО ОДНОГО РЕГУЛЯТОРА
    Верхній рівень (профілі, фази,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
2026-08-25 Порожній список еталонів у Майстрі: одна невдала відповідь — і на весь сеанс (#176)
    Скарга: «у клієнті exe при відновленні з еталона в Майстрі у випадному списку
    не показуються еталони». Причина була не в Майстрі.
    Список моделей клієнт питає командою TEMPLATES РІВНО ОДИН РАЗ — у мить
    під'єднання, — і оброблялась відповідь так:
    models = r.get("models", []) if r.get("ok") else []
    for cb in (self.cbInit, self.cbRest, self.cbWiz): cb["v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
2026-08-26 Дві теки — одна: різниця пристроїв виявилась у чотирьох рядках (#177)
    У сховищі лежали дві майже однакові теки: корінь (пристрій на платі TL494) і
    battery_reader_china_chr/ (з власним понижувачем). Код у них уже був спільний,
    але фізично продубльований — 265 файлів, кожну правку доводилось носити руками
    в обидві. Рівно в попередньому релізі правку клієнта довелось копіювати в
    чотири файли по обидва б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
2026-08-26 Тексти релізів v0.5 і v1.0; опис заряду в README — під дві топології (#178)
    Створити реліз чи запушити тег із цієї сесії неможливо: проксі віддає 403 на
    push тега й прямо відмовляє на POST /releases («Creating, editing, or deleting
    releases is not permitted for this session type»). Тому тексти обох релізів
    лежать у сховищі готовими до вставки:
    docs/RELEASE-v0.5.md — рання версія без зарядної частини, коміт bbec299
    docs/RELEASE-v1.0.md — поточна: два пристрої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
2026-08-26 Одна історія пакета — одне правило; Bluetooth як режим, а не доважок (#179)
    Дві правки одним злиттям.
    1. Станція повертала дату й цикли, бо ми правили одне число з шести.
    Другої копії дати в чипі немає (перевірено на 41 дампі) — станція її
    ПЕРЕРАХОВУЄ: дати живуть зміщенням у добах від виготовлення, а стелю їм
    задає наробіток монітора з іншого чипа. Цикли ж мають п'ять місць, і
    редактор п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
2026-08-26 Зникло зображення: Bluetooth вимкнено назад, поки причина не названа
    Скарга власника після 3.59: «Немає зображення. На релізі 1.0 все
    працювало» — підсвітка є, картинки немає.
    Підсвітку піднімає displayIntro(), і робить це ПІСЛЯ того, як заставка вже
    намальована: прилад доходить до ініціалізації панелі, код екрана
    виконується, а зображення на панель не потрапляє.
    Коду екрана правка не торкалась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
2026-08-26 Зникле зображення: винен був не Bluetooth, а типовий пристрій
    Діагноз у 3.60 був хибний. Причину знайшов власник, надіславши архів тієї
    збірки, яка в нього працює, — теку battery_reader_china_chr, зведену в
    корінь у 3.57.
    Доказ дав препроцесор, а не міркування. Повна звірка макросів робочої
    збірки власника з нинішнім коренем, зібраним із DEVICE_VARIANT=DEVICE_BUCK,
    дала РІВНО ОДИН рядок різниці — сам DEVICE_VARIANT. Решта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
2026-08-26 Пара створена, а під'єднатись нічим: два однакові рядки в списку портів
    Скарга: Bluetooth вмикається, пара створюється, у налаштуваннях «не
    підключено», під'єднатись через програму не виходить.
    Половина цього не несправність. «Не підключено» для послідовного профілю
    (SPP) у Windows — норма: з'єднання встановлюється в мить, коли програма
    ВІДКРИВАЄ порт, і рветься, коли закриває.
    Друга полови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
2026-08-26 Порт без назви: ім'я приладу знає лише сам прилад
    Зв'язок по Bluetooth запрацював, але в списку портів прилад лишався
    безіменним: Windows підписує ВСІ послідовні порти Bluetooth однаково —
    «Standard Serial over Bluetooth link», — і серед кількох спарених пристроїв
    наш нічим не вирізнявся.
    Скласти назву на боці клієнта було б просто: у прошивці вона складається як
    BT_NAME плюс чотири цифри з MAC, а адресу клієнт бач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
2026-08-26 btName was not declared in this scope — і чому це не ловилось нічим
    Збірка в Arduino IDE впала: web_server.h почав віддавати ім'я приладу (3.63),
    а bt_link.h включав ЛИШЕ serial_api.h — і той стоїть у скетчі нижче за
    web_server.h. Складалось усе рівно доти, доки звідти ніхто по цьому імені не
    звертався. Виправлення просте: web_server.h включає bt_link.h сам.
    Цікаве інше — чому цього не побачила жодна перевірка.
    Скетч не компілюється на хос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
2026-08-26 Куди підключатись: хай програма спитає прилад сама
    У системі десяток COM-портів, жоден не підписаний іменем приладу. Але
    свого транспорту вигадувати не треба: прилад УЖЕ представляється сам — у
    відповідь на PING каже імя в полі "dev". Правильне питання не «як
    підписати порт», а «спитати кожен порт, хто він».
    З'явилась кнопка «Знайти прилад»: програма обходить порти, шле PING і
    підключаєтьс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
2026-08-26 Текст релізу v2.0
    Дві великі зміни від v1.0 і один довгий розбір: Bluetooth став режимом
    роботи (одне радіо за раз, вибір у меню), редактор більше не лишає в пакеті
    прихованої історії, типовим пристроєм став DEVICE_BUCK.
    Текст складено так само, як для v0.5 і v1.0: у docs/, щоб реліз публікувався
    з готового джерела, а не переписувався щоразу заново.
    Claude-Session: https://claude.ai/code/session_019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
2026-08-26 Сирі одиниці — це не дані: лічильники в мА·год і пояснення до полів
    Чотири лічильники накопиченого заряду лежать у пам'яті в одиницях
    накопичувача: мА*год = 15.625 * сире / шунт. Шунт у кожного пакета СВІЙ,
    тож одна одиниця це від 339 до 790 мА*год залежно від екземпляра (виміряно
    на 62 моніторах корпусу з 65). Число «40» не каже ні про заряд, ні про знос,
    ні про цикли — редактор показував людині т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
2026-08-26 Кнопки не було, бо не було сторінки: сурогатна пара в рядку впорскування
    Емодзі в шарі, який міст впорскує у client_usb.html, було записане
    екранованою парою 🔍 в звичайному (не r"") рядку Python. Python
    розібрав escape сам — і в рядку опинились дві половинки символу, яких у UTF-8
    не існує. Сервер падав на .encode("utf-8") ще до першого байта відповіді:
    сторінка не віддавалась узагалі.
    Екранування прибране повн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
2026-08-27 Три способи вмерти до першого слова: міст більше не мовчить
    Скарга «сторінка мосту не відкривається» повторилась після 3.67 — отже причина
    була не одна. Відтворенням знайдено ще два незалежні способи, обидва вбивали
    міст МІЖ bind() і serve_forever():
    1. Привітання. Консоль Windows на нашій локалі — cp866, у ній немає ні довгого
    тире, ні лапок-ялинок. Коли вивід перенаправлено, print() кидає
    UnicodeEncodeError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
2026-08-28 Кнопки: найчастіше — коротким, найрідше — довгим
    На кільці показань «OK» працював навпаки: коротке відкривало меню, довге
    зчитувало пакет. Зчитування роблять десятки разів за сеанс, меню відкривають
    кілька — тепер коротке зчитує, довге відкриває меню. Підказка на порозі 0.8 с
    змінилась разом із дією.
    Прихований жест переїхав з утримання 10 с на послідовність клавіш
    «‹ › › ‹ OK» з ві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
2026-08-28 Довший ланцюжок вимагає розумнішого відкату
    Комбінацію замінено на дев'ять клавіш «‹ ‹ › › › › ‹ ‹ ›» без «OK». Сам
    ланцюжок — один рядок, але правило відкату після обмовки довелось переписати.
    У попереднього жесту жоден власний хвіст, крім однієї клавіші, не був його ж
    початком, тож вистачало «почати заново цією клавішею». У нового «‹ ‹»
    наприкінці є його початком: після восьм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
2026-09-10 Галерея відкривається списком, якого в сейві немає
    NTR Phone тримає в бекапі лише шляхи до вже відкритих файлів, а не повний
    перелік. Тому «відкрити все» — це не перемкнути прапорець, а знати, що саме
    там мало бути. Сторінка ntr_gallery/index.html робить це трьома шляхами:
    вбудований каталог складання 0.45.0 (690 записів, зібраний із повного
    проходження), точний список із оглавлення .pck/.exe/.apk самої гри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
2026-09-10 Прибрати ntr_gallery: чужий інструмент у репозиторії пристрою
    Сторінка розблокування галереї NTR Phone не має стосунку до зчитувача
    акумуляторів IMPRES — це окремий інструмент, якому не місце поруч із
    прошивкою та її тестами. Ветка повертається до стану main.
    Revert "Галерея відкривається списком, якого в сейві немає"
    This reverts commit 29bd8e79.
    Claude-Session: https://claude.ai/code/session_019CPAEdaphB9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
2026-09-20 Новий АКБ: ідентичність генерується з ROM самого чипа
    Вшитий еталон — побайтова копія ОДНОГО реального пакета, і його зашифровані
    блоки (дати, знос, калібрування) зашифровані ROM-ом ДОНОРА. Записати їх на
    порожній чип означає віддати новому пакету числа, які рація розшифрує СВОЇМ
    ключем і побачить безглуздя. Це рівно той збій, що в dumps/16: на еталоні
    4409A рація читала дату виготовлення 2107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
2026-09-20 Дата ставала прочерком після запису; кеш ROM переживав заміну пакета
    1) Скарга: у «Ремонті» записали знос 100 %, калібрувань 0, вигот. 2023-02-15,
    запуск 2026-07-27 — після перечитування картка правок показує прочерк, хоча на
    вкладці «Дані» все на місці. Відтворено; дві незалежні причини.
    Перша: ми писали внутрішньо неможливий стан. Пакет, який уже вмикали, не міг
    жодного разу заряджатися — dayLastChar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
